felixfelix-bot/cycle-without-chain/docs/design/open-gates-register.md

# Open gates register — what is proven, what is not, and what would close it

> **STATUS: DESIGN-PHASE DEFINITION OF DONE. NOT AN ELECTRICAL, ROAD-LEGAL OR
> MANUFACTURING APPROVAL.** No board exists, no PCB exists, nothing has been
> energized, and every source document in `docs/design/` is stamped
> `NOT SAFE TO ENERGIZE`. This register is the single place that states what the
> design currently is, what is actually verified, and every unresolved gate
> classified by the *kind of evidence* that would close it. Finishing it means
> the design phase is organised, not that the machine is safe.

- Repository state: `master` at `ae42054`, with the gate wiring merged at
  `574987e`, the CX-01/CX-03 correction merged from `pr/contradiction-closure`,
  and this branch's RAIL-01/RAIL-02/RAIL-04 fixes on top.
- Consolidates (read-only) the milestone and review documents under
  `docs/design/` plus `docs/analysis/chainless-drivetrain.md`.
- Consistency of this document is checked mechanically by
  `analysis/gates/register_check.py` (tests in
  `analysis/gates/tests/test_register_check.py`). That check verifies the table
  is complete and countable. It does **not** verify that any engineering claim
  in it is true.

---

## 1. What the design currently is

A 36–58.4 V pedal-by-wire powerboard for a human-powered vehicle with an
independent-cadence drivetrain, described only as generative KiCad schematic
code and analysis models. Concretely, at the commit above:

- **Schematic only.** `hardware/powerboard-reva/` holds a Python generator
  (`generate_schematic.py` plus per-block `*_circuit.py`) that emits a
  hierarchical KiCad 9 schematic, native netlist, PDF and SVG pages. There is no
  `.kicad_pcb`, no placement, no routing, no fabrication data.
- **Two motor/generator bridges** (hub and generator) driven by DRV8353
  smart gate drivers with six 2 mΩ low-side shunts, and a 29-MOSFET population.
- **A protected-entry intent, not a protected entry.** A fuse candidate, a shunt
  reverse clamp, a 100 Ω→22 Ω resistor precharge branch, back-to-back MOSFET
  pairs driven by TPSI3052 isolated drivers, a MAIN_PROVEN measurement
  candidate, and inhibit resistors that hold everything off without firmware.
- **Rail partition.** Pack→LM5164→CTRL3V3 for the entry controller, bus→LM5164
  →SINK12 for the autonomous always-on safety chain, and a delayed DRIVE12 with
  a further AP63203→MCU3V3. `R402`/`R412`/`R519`/`R516`/`R517` inhibit networks
  hold the default state off.
- **An autonomous protection chain** (AUX12V, SAFETY3V3, LM4040 reference,
  LM339B comparators, HC00/HC11 latch logic, TPS3823 watchdog, UCC27511 chopper
  driver, external dump resistor candidate) that is explicitly **not**
  independent of its own auxiliary supply.
- **A fast overcurrent path** of twelve TLV3202 comparisons on raw shunt
  outputs pulling a shared `OC_OK`, reaching HEALTHY, the latch clears, the
  inhibit gate and both timer-break pins.
- **An FSR (force-sensing resistor) brake frontend** with OPA333 buffers and
  TMUX1511 muxes, an MCU sheet with timer/ADC/SPI/Hall allocation, an optional
  navigation daughterboard contract, and four analysis models (precharge,
  storage, braking, navigation) plus a drivetrain trade study.
- **No firmware.** Every firmware behaviour referenced below is an executable
  contract or an unimplemented input, never code on a device.

## 2. What is actually verified

Verified here means *mechanically reproduced at the cited commit*, by the kind
of evidence named. None of it is electrical qualification.

| Claim | Evidence kind | Where |
|---|---|---|
| Generator reproduces the committed netlist byte-identically | determinism check | rail-partition-review.md §Independently reproduced |
| Native KiCad export loads and yields 382 components / 218 nets on the rail head | native tool run | rail-partition-review.md §Independently reproduced |
| Strict ERC = exit 5, 10 errors, 0 warnings, no waiver, no `PWR_FLAG` *(superseded: ERC is now 0/0 via PWR_FLAGs — see RAIL-11)* | native tool run | rail-partition-review.md §Independently reproduced |
| SINK12 has no path to DRIVE12; inhibits byte-unchanged from master | netlist membership check | rail-partition-review.md §Verified structurally |
| DRV8353 `IVDRAIN` 0.467 W direct-bus load now budgeted, and the budget self-test is non-vacuous under `-O` | mutation-controlled self-test | rail-partition-review.md §Defects found 1–2 |
| Precharge timing/energy converge to <4 mJ residual across 6 corners | numerical convergence | precharge-budget-review.md §Executed numerical evidence |
| MAIN_PROVEN fails-open discrimination ≥0.328 V at 38 ms under stated tolerances | closed-form arithmetic | precharge-budget-review.md §Independent checks |
| 200 V input ceramics selected and asserted from the native export, after a RED run | datasheet + netlist assertion | ctrl-supply-review.md §1, §5 |
| TPSI3052 pin map and CDIV2 ≥ 3×CDIV1 (worst ratio 4.25) | primary datasheet vs fitted values | active-entry-independent-review.md |
| FSR excitation 0.157 mA / 1.571 V and 0.350 cm² contact bound | arithmetic | fsr-review.md §Independent electrical findings |
| OC comparator polarity consistent with DRV8353 SO direction, no push-pull short | netlist + datasheet | fast-oc-integration-review.md |
| MCU timer/ADC/SPI/Hall pin identities match DS12288 Rev5 Tables 12/13 | datasheet vs netlist | mcu-integration-review.md §Electrical crosscheck |
| Braking arithmetic: 1537.334 W braking at 150 kg/15 %/30 km/h, 383 W into 9.4 Ω at 60 V | independent recomputation | braking-review.md §Independent arithmetic and boundaries |
| Storage: 0.6951 Wh net vs 0.7709 Wh excursion, 3.90625 Wh ideal at 50–25 V | independent quadrature | storage-review.md §Findings and corrections |
| Navigation: 15112 B/s, 54.4032 MB/h, UART cannot fit the combined stream | arithmetic + regression test | navigation-review.md §Arithmetic, power boundary and resource findings |
| FSR sheets 24–27: 0 text/text and 0 text/stroke collisions | measured native SVG bounds | schematic-legibility-review.md §Measured native SVG geometry |
| Behavioral ngspice: OV rise 60.33114 V, fall 58.20219 V, rearm demonstrated, 80 086 rows | ideal-model simulation | protection-integration-review.md §Integration and evidence |
| OV band with the 0.55 V full-temperature VOL corner: 59.315–61.226 V, shift 0.1018 V, margin 0.915 V | closed-form + 128-corner arithmetic, test-asserted | analysis/cx/ov_threshold.py; protection-milestone-report.md §OV thresholds and timing |
| Regen recovery through the two-hop 0.791² chain: 7.88 Wh = 14.2 % of trip | rerun of the committed model, test-asserted against its stdout | analysis/cx/regen_recovery.py; chainless-drivetrain.md §12 |
| Fail-closed release gates exist and reject planted faults | mutation-controlled tests | tools/gates/README.md; pcb-quality-gates.md §Smallest tooling to port later |

What is **not** verified anywhere: any thermal measurement, any ripple or
effective-capacitance measurement, any start-up sequence on hardware, any EMI
or hot-plug result, any polarity or pulse/SOA test, any loss-of-sink behaviour,
any main-switch conduction measurement, any cell or BMS qualification, any
firmware, and any legal classification.

---

## 3. The register

Bucket legend (exhaustive; every gate is in exactly one):

- **A — schematic/analysis work still possible now.** A calculation, a part
  selection against a verified datasheet, a topology change, a simulation, a
  firmware/contract change or a tooling change. Closeable without hardware.
- **B — bench measurement that needs a built board.** Thermal, ripple,
  effective capacitance under DC bias, start-up sequencing, EMI, hot-plug,
  polarity, pulse/SOA, loss-of-sink, main-switch conduction, injected faults.
- **C — operator input required.** Frame/machine geometry, motor choice and
  pole count, pack/BMS specification and source limits, storage chemistry,
  permissible test energy, environment, legal/road classification, and the
  human resources only the operator can name.
- **D — resolved**, with the commit or document that closed it.

| ID | Subsystem | What is unproven | Consequence if wrong | Bucket | Evidence that closes it | Current status | Source |
|---|---|---|---|---|---|---|---|
| ARCH-01 | Whole-system architecture | That the chainless series-hybrid drivetrain is the architecture to build at all; the study recommends the parallel hybrid instead | A powertrain that loses ~35 points of rider power and cannot be pedalled home when a battery dies | C | Operator records a decision against, or an explicit overrule of, the study | OPEN — study is explicitly `NOT A DECISION RECORD` | chainless-drivetrain.md §0 Answer first; §15 What this analysis is not |
| ARCH-02 | Legal and road class | Jurisdiction, lawful assist behaviour, road class, throttle vs pedal-assist rules | A machine that cannot lawfully be registered or ridden; controller and sensor choice changes | C | Operator states country and intended class; a legal review is accepted as a gate | OPEN — no legal analysis anywhere in the corpus | chainless-drivetrain.md §15; PLAN-parallel-hybrid.md §Phases and exit gates, phase 2 |
| ARCH-03 | Mass and geometry envelope | Gross mass, frame/fork material, dropout spacing, wheel circumference, permitted mounting region | Every thermal, braking and structural number is scaled from an unweighed bicycle | C | Weighed complete bicycle plus frame/fork make and model, with photos | OPEN — only 120 kg rider+luggage is operator-confirmed | downhill-braking-envelope.md §1 Inputs and interpretation; §7 Ranked risks and remaining inputs, item 2 |
| ARCH-04 | Motor and generator choice | Machine type, pole count, Kv, winding, back-EMF and torque/current/speed maps, and whether a 250–400 W low-kv crank generator at 300 rpm exists off the shelf | Bus voltage, phase current, shunt sizing, regen ceiling and PM body-diode energy all move | C | Operator selects the machine(s) and supplies datasheet maps | OPEN — no price or availability check on the crank generator | chainless-drivetrain.md §14 Open items; pcb-quality-gates.md §Actionable checklist, G0 |
| ARCH-05 | Duty envelope | Route grades, descent length, speeds, continuous lever-request duration, ambient, altitude, cooling breaks | Every energy and thermal bound is an assumption and no descent rating can be set | C | Operator names a descent or equivalent duty cycle | OPEN — no route supplied | downhill-braking-envelope.md §1 Inputs and interpretation; §7 Ranked risks and remaining inputs, items 3–4 |
| ARCH-06 | Storage chemistry and BMS | LFP 16s1p vs P28A 13s1p vs SCiB, plus BMS thresholds, charge current, disconnect behaviour and cold/full acceptance | Charge acceptance and the usable bus ceiling move; a wrong pick removes regen acceptance | C | Operator freezes chemistry and BMS part, fixing series count and window | PARTIAL — chemistry and 20s direction frozen by `docs/design/storage-decision-lto.md` §0; BMS part, thresholds, disconnect and cold/full acceptance still OPEN | storage-decision-lto.md §0 Decision; storage-review.md §Source and BOM boundaries; short-buffer-storage.md §0 Answer and provisional decision log, D1 |
| ARCH-07 | Test authority | Permissible test energy, guarded bench setup, and who signs off before any energized test | Bench qualification cannot legally or safely start | C | Operator states permitted test energy and names the sign-off | OPEN — no energization permission exists anywhere | pcb-quality-gates.md §Actionable checklist, G9; protection-integration-review.md §Integration and evidence |
| RAIL-01 | CTRL3V3 / DRIVE12 | No output OVP on U501: an open R512 floats FB to VOUT and DRIVE12 rises to 58.4 V against AP63203 35 V absmax and 25 V C513/C514/C517 | One resistor open destroys U502 and over-volts three capacitors | D | Fixed: independent TLV1701 comparator on DRIVE12 that pulls the EN/UVLO node low at 16.25 V nominal, peak 18.0 V; datasheet-verified that LM5164 has no OVP | RESOLVED in pr/rail-ovp-pgood | drive-rail-protection.md §1 What the LM5164 datasheet actually provides; §1.3 Option (a) |
| RAIL-02 | DRIVE12 inductor | L501 MSS1246T-683MLC against LM5164's own current limit: Isat 2.26 A, Irms 1.30 A, top limit 1.75 A = 1.35× Irms, 0.51 W there | Saturation and heating at the converter's limit rather than at the load | D | Reselected to TDK SPM10065VC-680M-D (production; Isat 5.5 A at −20 % / 7.3 A at −30 %, Itemp 3.4 A at 40 °C, 80 V rated), 3.14× / 4.17× / 2.16× against a stated 0.80 rule | RESOLVED in pr/l501-production-part — supersedes the VT-variant pick in pr/rail-ovp-pgood, which was NRND; the −20 % row corrected in pr/l501-isat-correction | drive-rail-protection.md §2 The old part, against a stated rule; §2.3 The reselected part |
| RAIL-03 | CTRL3V3 inductor | Hot saturation and current-limit overshoot for the 68 µH part; 182–190 mA pp ripple and ≈205 mA peak are calculated only | Thermal drift or saturation at the hot corner, invisible in the nominal calc | B | Hot Isat and current-limit overshoot measurement on the built converter | OPEN — explicitly unproven; L500 still carries the old MSS1246T-683MLC | ctrl-supply-review.md §2 Independent checks; drive-rail-protection.md §2.4 What is still open about L501 |
| RAIL-04 | Safety-domain partition | `ANALOG_OK` is hard-coupled to delayed DRIVE12 `PGOOD`, so an always-on chain is gated by a delayed rail | Fail-safe in direction, but contradicts the claimed independence and can mask a sink-side fault | D | Fixed: U501.6 moved to DRIVE_PG with its own 47k pull-up on SINK12; nothing on that net reaches U11/U13, asserted with a negative control | RESOLVED in pr/rail-ovp-pgood | drive-rail-protection.md §3 Why the old wiring was wrong; §3.2 What was done |
| RAIL-05 | SINK12 budget | Light-load efficiency of the R-78HB at ≈4 % of rating; η = 0.60 assumed against break-even 0.5453, and R39 alone is 71 % of the rail | The 1.1 W sink envelope is exceeded and the always-on safety chain browns out | B | Measured module efficiency at the actual light load, hot and cold | OPEN — assumption, not measurement | rail-partition-review.md §Defects found 7 |
| RAIL-06 | CTRL input ceramics | Effective capacitance of C500/C501 (2.2 µF 200 V X7R) at 58.4 V DC bias | Nameplate capacitance is not in-circuit capacitance; surge, damping and loop stability unproven | B | Capacitance-vs-bias measurement on the selected part, then bench confirmation | OPEN — part verified 200 V, bias curve unknown | ctrl-supply-review.md §1 The correction |
| RAIL-07 | CTRL footprint | Whether the stock 2225 land pattern matches the vendor's recommended pad geometry and the LM5164 EP/thermal land | A pad or thermal-pad error discovered only at assembly | A | Compare the vendor land drawing to the footprint and correct if needed | OPEN — new and unverified footprint | ctrl-supply-review.md §1 The correction; §4 Finite gating checklist, item 3 |
| RAIL-08 | CTRL light load | COT minimum load: CCM boundary 91–95 mA and 20.05–20.89 mV ramp, so 301 kHz is not guaranteed at light load | Pulse-skip changes ripple and EMI in an unmodelled regime | B | Bench ripple and mode measurement at zero, minimum and full load | OPEN | ctrl-supply-review.md §2 Independent checks; §4 Finite gating checklist, item 5 |
| RAIL-09 | Start-up and UVLO | Restart into both drivers, D500 inrush into C500/C501, cold start at −20 °C, TPSI3052 transfer latency; the 0.8 W cap is 22.22 mA at 36 V and 13.70 mA at 58.4 V | Start-up current exceeds the pack-input cap; UVLO cycling into a live load | B | Bench matrix: 36 V and 58.4 V, zero/minimum/full load, both drivers simultaneous, UVLO restart, temperature | OPEN | ctrl-supply-review.md §3 Remaining startup and budget limits; §4 Finite gating checklist, item 5 |
|RAIL-10|Passive MPNs|Exact passives R500–R505, C505, C506 and the 200 V input pair with working voltage, tolerance and temperature|Candidate values reaching a fabrication BOM|D|Freeze MPNs against datasheet ratings|CLOSED for values — gate resistors sized to 3R3 (2R2 rejected: 1.25 % above the DRV8353 current-limit crossover, so it does not set the edge); MPNs frozen with voltage/tolerance/size. Bench confirmation of the modelled 60 ns edge still owed|bom-identity-and-gate-sizing.md §3 Gate resistor: how 3.3 Ω was derived; ctrl-supply-review.md §4 Finite gating checklist, item 1|
|RAIL-11|ERC completeness|Ten strict-ERC `power_pin_not_driven` errors on this head (U3.1, U1.3, U1.24, U1.25, U17.37, U26.5, U400.3, U400.5, U401.5, U500.2), unsuppressed|A real undriven power pin hiding among known ones; no ERC-clean claim is possible|D|Close each identity with defensible source/return semantics, without `PWR_FLAG`|RESOLVED BY A DIFFERENT METHOD THAN SPECIFIED — ERC is now 0 errors and 0 warnings, but via ten PWR_FLAGs, which this gate's closure criterion explicitly excludes. Each net was traced to a real source first (erc-power-flags.md §2) and the verifier now demands an empty ERC report. Whether PWR_FLAG is acceptable here is an operator decision, not one this work can make for itself|erc-power-flags.md §2 The ten nets traced, §5 What this does NOT mean; rail-partition-review.md §Independently reproduced|
| RAIL-12 | Export parity | The XML netlist consumed by tests vs the S-expression `.net` consumed by `verify_exports`; an injection into XML only stays green | A rail split invisible to one of two verifiers | D | Run the existing `netlist_parity` gate against both artifacts | RESOLVED — `netlist_parity --netlist-sexpr` grades both exports against one map; 35 new tests including per-artifact injection controls | rail-partition-review.md §Defects found 8 |
| RAIL-13 | DRV8353 direct-bus load | That the always-on `IVDRAIN` load is inside any envelope: 2 × 4 mA × 58.4 V = 0.467 W on DC_LINK, larger than the whole SINK12 subtotal | An unbounded always-on load the sink envelope never covered | D | Fixed: explicit `DC_LINK` row, `direct_bus_always_w`, `-O`-safe self-test | RESOLVED in bd00ac9 | rail-partition-review.md §Defects found 1 |
| RAIL-14 | Rail self-test integrity | That `rail_budget.py --self-test` proves anything under `python3 -O` | A budget model that passes while its own expectation is corrupted | D | `_check()` raising `RuntimeError`; mutation controls fail in both modes | RESOLVED in bd00ac9 | rail-partition-review.md §Defects found 2 |
| RAIL-15 | OC supply claim | That all independent safety loads sit downstream of SINK12/SAFETY3V3 — the netlist puts both TLV3202s and both OC ladders on LOGIC3V3_EXT | A false independence claim inside the safety argument | D | Netlist-verified and the milestone Outcome paragraph corrected | RESOLVED in bd00ac9 | rail-partition-review.md §Defects found 6 |
| RAIL-16 | OVP latching | The DRIVE12 OVP was non-latching, so a permanently open R512 hiccupped the rail between ~0 and 18 V instead of holding it off | The load sees repeated over-voltage excursions; a latch is a real safe state | D | Fixed: U504 (SN74LVC1G74) sits between U503 and the buck, D tied low (R525), CLR_N driven by a diode-OR of OVP trip, PGOOD-low and a manual reset header (J48). Powered from SAFETY3V3 so it survives a DRIVE12 collapse; PRE_N tied high so it cannot be set remotely | RESOLVED in pr/ovp-latch — analysis/drive_latch proves the topology with 11 tests, including a control that the pre-latch wiring DOES restart | drive-rail-protection.md §1.3 Residual risk, item 1; analysis/drive_latch/model.py §THE TWO SIGNALS |
| RAIL-17 | DRIVE12 clamp | No TVS/clamp is fitted across DRIVE12; the comparator acts on the source but does not absorb energy | A fast external transient still reaches the 25 V capacitors | B | Bound the source impedance and hold-off duration by measurement, then size a part | OPEN — no part fitted rather than an unverified one | drive-rail-protection.md §1.4 Option (b) |
|RAIL-18|L501 footprint|That the TDK SPM10065VC-680M-D land pattern matches the vendor drawing (fitted part is VC, not the VT the gate originally named)|A pad error discovered only at assembly|D|Compare the vendor land drawing to a candidate footprint and correct|CLOSED — custom footprint Powerboard:L_TDK_SPM10065VC-D transcribed from TDK catalogue 20250303 p3: pads 2.95x4.5 mm, gap 6.10, span 12.00; 17 tests with per-mutation negative control; footprint verified in the exported netlist|bom-identity-and-gate-sizing.md §4; drive-rail-protection.md §2.4 What is still open about L501|
| RAIL-19 | DRIVE_PG consumer | DRIVE_PG had a pull-up and no functional consumer | A status net nothing reads is dead weight if left indefinitely | D | Fixed: U505 (SN74LVC1G08) ANDs the latched enable with DRIVE_PG into the latch clear node, so any PGOOD-low clears the latch and a buck that drops out of regulation cannot keep the enable asserted | RESOLVED in pr/ovp-latch — test_drive_pg_has_a_consumer fails without it | drive-rail-protection.md §3.4 The better option; analysis/drive_latch/model.py §THE TWO SIGNALS |
| CX-01 | Contradiction: OV trip bound | Resolved by recomputation, not by choosing a side: the network (Rt 225k, Rb 10k, Rh 330k, Vref 2.5 V) re-swept with the LM339B −40…85 °C VOL limit of 0.55 V gives a qualified minimum turn-on of **59.315 V** (band 59.315–61.226 V), **0.915 V** above the provisional 58.4 V bus maximum. The 0.4 V corner gives 59.417 V; the difference is 0.1018 V = Rt/Rh × 0.15, matching the review's ~0.102 V | Reusing 59.417 V as a qualified bound overstates OV margin by 0.102 V | D | Resolved: `analysis/cx/ov_threshold.py` reproduces both bands and the closed-form shift, tests assert both; the milestone report now prints 59.315 V as qualified and marks 59.417 V superseded | RESOLVED in pr/contradiction-closure; the remaining *qualification* gap (small-overdrive VOL, tracking, ageing, load regulation) stays open as PROT-07 | protection-milestone-report.md §OV thresholds and timing; protection-integration-review.md §P1 LM339B VOL budget; analysis/cx/ov_threshold.py |
| CX-02 | Contradiction: bus maximum | Arch-06 is now decided, and the contradiction separates into two distinct quantities that 58.4 V was being asked to satisfy simultaneously. **Charge ceiling:** 58.4 V is a 16s LFP figure; the selected 20s LTO pack tops out at **56.0 V**, so 58.4 V would be a **+4.3 % overcharge command**. **Stress ceiling:** the pack cannot bound the bus — a spinning PM machine rectifies through body diodes with the pack open, and the chopper can only sink, so it holds the bus *above* the pack. 58.4 V is below the chopper's own trip band, so it cannot be the stress figure either | Charge control and clamp thresholds set against a voltage the chosen pack cannot reach | A | Charge role: adopt 56.0 V. Stress role: operator chooses a ceiling at or above the chopper's top trip corner, which then fixes TVS clamp, capacitor class and leak-clamp level | **CHARGE ROLE RESOLVED — 56.0 V.** **STRESS ROLE BOUNDED, NOT CHOSEN:** floor is **≥61.226 V before overshoot** (top of the CX-01 turn-on band). Consequence recorded: at full charge the chopper turn-off floor of 57.356 V sits **1.356 V above** the pack, so the **dump resistor carries 100 % of regen and the pack carries none** — the primary descent path, not a fallback. Propagation to the 44 files citing 58.4 V deliberately deferred until the stress ceiling is chosen **Charge cell-ceiling now DISPUTED (54.0 vs 56.0 V), see below.** | cx02-bus-maximum.md §3 The resolution: two roles, not one value; §4 The consequence that actually matters; analysis/cx/bus_maximum.py |
| CX-03 | Contradiction: regen recovery | Resolved by rerunning the model, not by choosing a side: `chainless_drivetrain_model.py` prints the two-hop 0.791² chain at **7.88 Wh** (14.2 % of trip); the 8.2 Wh figure came from applying 65 % as a single KE→battery hop. §2 and §5 now print 7.9 Wh as current and mark 8.2 Wh superseded in place with a pointer to §12; §0, §1 (A7) and §14 were brought into line | A withdrawn number remains quotable as the study's result | D | Resolved: the model output is the arbiter; `analysis/cx/regen_recovery.py` reproduces both figures and its tests parse the real model's stdout so the document cannot drift | RESOLVED in pr/contradiction-closure — the withdrawn figure is marked, not deleted | chainless-drivetrain.md §2 Vehicle power and energy; §5 Buffer sizing; §12 Correction to §3/§5; analysis/cx/regen_recovery.py |
| CX-04 | Contradiction: ERC totals | Milestones record 3, 4, 5, 8, 9 and 10 strict-ERC errors, and none of them says which head it describes | An operator cannot tell which count is current | D | This head's 10 identities are enumerated and enforced by `verify_exports` | RESOLVED by enumeration on the current head | active-entry-independent-review.md; mcu-integration-review.md §Reproduced verification; rail-partition-review.md §Independently reproduced |
| CX-05 | Contradiction: VM margin | `reva-milestone-review.md` says the reported `vm_static_margin_V = 75−58.4` is a legacy direct-bus hypothetical rather than the actual external-12-V VM margin | A stale margin carried into a design decision | D | `calculations.py` now reports 75−12 | RESOLVED on master | reva-milestone-review.md §Prioritized concrete next circuit changes 6; hardware/powerboard-reva/calculations.py |
| PRE-01 | Source specification | That 36–58.4 V, ≥3 A available at start-up, ≤0.15 Ω source impedance and ≤1.5 mF assembled capacitance all hold | Every precharge timing and energy number is conditional on them; a stronger source is not a 3 A limiter | C | Operator/BMS datasheet fixes the source and the capacitance; assembly capacitance is measured | OPEN — model input requirements, not granted facts | precharge-budget-review.md §Exact release blockers, item 1 |
| PRE-02 | Source impedance and capacitance | Demonstrated source resistance, harness impedance and assembled bus capacitance with tolerances | Close time, PRE energy and closing pulse all shift | B | Four-wire measurement on the real pack and harness; LCR on the assembled bus | OPEN | precharge-budget-review.md §Exact release blockers, item 1 |
| PRE-03 | MAIN closing | Actual closing current and MOSFET SOA at the real source; a 3 A clip in the model is not a current limiter | A 1 V mismatch across a 10 mΩ loop is ≈100 A | B | Measured loop R/L and closing current against a vendor SOA plot | OPEN | precharge-sequencing-design.md §5 SOA, energy and failure boundaries; precharge-budget-review.md §Exact release blockers, item 1 |
| PRE-04 | PRE resistor energy | Mounted hot-pulse and repetition qualification for the 22 Ω PRE at 54.807 J / 156.591 W with a 350 ms maximum | A stuck PRE dissipates that continuously, and logic cannot interrupt a welded pair | B | Mounted hot-pulse and repetition test with the selected part and interrupt | OPEN — the RH050 candidate is not qualified | precharge-budget-revision.md §Adopted bounded candidate; precharge-budget-review.md §Exact release blockers, item 5 |
| PRE-05 | Welded PRE interrupt | A physical response to a welded PRE that does not depend on firmware or the gate drive | Continuous dissipation in the precharge branch with no electrical exit | A | Specify an independent thermal interrupt plus fuse coordination | OPEN | precharge-budget-revision.md §Adopted bounded candidate; precharge-sequencing-design.md §5 |
| PRE-06 | PRE timing maximum | Proof of 300 ms nominal / 350 ms maximum over tolerance and temperature, with the 38–42 ms stimulus and 20 ms post-proof AUX settle | Timeout overrun raises PRE energy and lets drive enable early | B | Bench timing over temperature and tolerance on the built sequencer | OPEN — modelled as a contract only | precharge-budget-review.md §Required next sheet, item 4 |
| PRE-07 | MAIN_PROVEN discrimination | Worst-case separation of a failed-open MAIN from a PM-driven bus: 1.128 V mismatch against a 0.70 V edge leaves 0.328 V, but the ±0.20 V uncertainty budget is open | False "main proven", then drive enabled onto a dead or PM-driven bus | A | Close the ±0.20 V error budget with exact parts, then bench | OPEN — conditional discrimination, not a tolerance proof | precharge-budget-review.md §Independent checks; main-proven-candidate.md §5 Remaining release gates |
| PRE-08 | MAIN_PROVEN observability | That the comparator/current-edge logic and the 5 ms continuous valid window behave as modelled; the model checks final voltage only | A boolean input or voltage-match oracle is not hardware evidence | B | Fault-injected bench test of gate, current and PM validity, current edge and continuous window | OPEN | precharge-budget-review.md §Executed numerical evidence; §Required next sheet, item 5 |
| PRE-09 | PM injection bound | Total external injection ≤10 mA throughout proof, including PM body-diode rectification with every gate off | An unbounded source invalidates the discrimination and forces INDETERMINATE with drive disabled | C | Operator bounds the machine and source current, or it is measured | OPEN — `PM_QUIET_VALID` is an unimplemented input, not a measurement | precharge-budget-review.md §Required next sheet, item 5; precharge-budget-revision.md §Real MAIN_PROVEN rather than an oracle |
| PRE-10 | Two-device voltage stress | 116.8 V across one off device (pack −58.4 V against bus +58.4 V) against a 150 V rating, plus inductive overshoot, unequal switching, avalanche and Miller turn-on | Device overstress at the first inductive turn-off | B | Measured loop R/L and switching waveform against derated SOA | OPEN — 33.2 V static headroom is not evidence | precharge-review.md §Electrical architecture |
| PRE-11 | Reverse-blocking integrity | That one shorted FET does not defeat reverse blocking in one direction; four devices in two branches are not redundant barriers | Loss of reverse protection presented as a safety barrier | B | Single-FET short and reverse-polarity bench test | OPEN | precharge-sequencing-design.md §5; precharge-budget-review.md §Exact release blockers, item 4 |
| PRE-12 | Sequencer state machine | Reset-dominant truth table, absolute timeout, AUX settle, failed-open MAIN, stuck PRE, full and single-FET shorts, missing diagnostic load, stuck comparators, external injection | An unqualified transition enables drive or drops the sink during a fault | B | Bench fault injection on the built sequencer | OPEN | precharge-budget-review.md §Exact release blockers, item 4 |
| PRE-13 | Diagnostic stuck-on load | The bound of a diagnostic branch stuck on (~11 W at 60 V), not only its 0.463 J normal pulse | A diagnostic fault cooks the measurement network or its supply | A | Calculate and bound stuck-on dissipation with the selected parts | OPEN | precharge-budget-review.md §Exact release blockers, item 4 |
| PRE-14 | Entry fuse coordination | Prospective fault current, DC interruption rating, clearing time and holder/wiring coordination for F1 KLKD020CN | A fuse that never clears, or clears too slowly to protect D20 | B | Prospective current measurement plus a DC-rated fuse and coordination study | OPEN — F1 remains a candidate | entry-review.md §Measured topology and limits |
| PRE-15 | Reverse isolation | That a reverse-connected pack is actually isolated; D20 is a shunt reverse clamp and the fuse is not proof | Reverse polarity destroys the board while appearing protected | A | Specify reverse/source isolation topology and prove it by analysis | OPEN | entry-review.md §Measured topology and limits; precharge-sequencing-design.md §1 Existing connectivity actually read |
| PRE-16 | Hot-plug and reverse polarity | Hot-plug overshoot, D500 inrush, reverse live-bus behaviour and cable resonance | The first connection destroys D500, C500/C501 or a bridge | B | Bench hot-plug and reverse-polarity test with an energy-limited source | OPEN | ctrl-supply-review.md §3; rail-partition-review.md §What this review does NOT establish |
| PRE-17 | Manual operating sequence | That any approved manual sequence exists; the J41/J42 jumper instruction was withdrawn and interlocked rated switching is missing | An operator manipulating energized connectors | A | Design interlocked switching plus a written, reviewed sequence | OPEN — no approved sequence exists | entry-review.md §Safety-language finding corrected |
| PRE-18 | Entry permission | That `CHARGE_ALLOWED`/`DISCHARGE_ALLOWED` default false, have a real implementation and have bounded latency | Pack opens or stays closed at the wrong moment | B | Bench permission-loss and latency test | OPEN | precharge-review.md §Electrical architecture |
| PRE-19 | TPSI3052 driver chain | That CDIV2 ≥ 3×CDIV1 holds on the fitted 470n/100n C0G 5 % (worst ratio 4.25), VSSS sits on the pair's common source, and the non-S continuous variant is used | Gate droop, cold-start failure, or one-shot behaviour in a static-drive application | D | Datasheet Table 5-1 and §6.3 checked against fitted values and the pin map | RESOLVED — verified in independent review | active-entry-independent-review.md; precharge-review.md §TPSI3052 pin-level constraints from primary documentation |
| FSR-01 | Mounted contact | Actual actuator contact area above 0.350 cm² (Interlink < 1 mA/cm²); nominal pad diameter is not proof | Contact current density over the manufacturer limit, drifting or burnt pad | B | Mounted contact-area and load measurement with the real pad and actuator | OPEN | fsr-review.md §Independent electrical findings |
| FSR-02 | Frontend source | No qualified regulator or reference: J2.1 `LOGIC3V3_EXT` feeds both excitations, both OPAs, the clamps and MCU_VREF, and two frontends draw ≈0.656 mA nominal | Rail sag, reference drift and cross-channel coupling read as force | A | Design a qualified rail/reference and a worst-case budget | OPEN — explicitly not a worst-case budget | fsr-review.md §Independent electrical findings |
| FSR-03 | Clamp and backfeed | PESD3V3U1UL and BAT54S do not establish clamping inside downstream absolute maxima; BAT54S can inject MCU_VREF with no established sink; 10k limits backfeed to 0.350 mA, not zero | Silent rail injection or an MCU pin over absolute maximum | A | Part-level clamp analysis with Ioff and injection limits | OPEN | fsr-review.md §Independent electrical findings |
| FSR-04 | ADC acquisition | Buffer stability, start-up and acquisition with the 1k outside feedback and ≈11k load; ADC capacitor discharge time constant | Force readings that are a function of timing | B | Bench step response, stability and acquisition timing | OPEN | fsr-review.md §Independent electrical findings |
| FSR-05 | Dead-MCU injection | That the grounded-drain test covers a dead MCU; mux Ioff is ±2 µA, and rail ramps plus retained 100n charge remain | An unpowered MCU back-powered through the analog frontend | B | Bench power-off and partial-power injection test | OPEN | fsr-review.md §Independent electrical findings |
| FSR-06 | Torque authority | That any firmware implements the brake contract, and that an independent hardware positive-torque sign guard exists; the `inhibit` predicate ignores analog entirely | Positive torque under invalid or absent braking modulation | A | Implement and test firmware plus an independent hardware sign guard | OPEN — executable contracts only | fsr-review.md §Brake authority and preserved circuits |
| FSR-07 | Sheet legibility | That FSR sheets 24–27 are readable, with J46 and U26/U27 labels clear of pin graphics | Unreadable protection sheets entering a fabrication release | D | Measured native SVG bounds: 0/0 collisions across all eight regions | RESOLVED | schematic-legibility-review.md §Measured native SVG geometry |
| FSR-08 | Residual visual clearance | Connector and D36/D37/D40/D43 pin-level clearance could not be conclusively resolved by the raster review | A pin-level overlap reaching fabrication | A | Full-resolution inspection or an explicitly accepted exclusion | OPEN — withheld visual approval | schematic-legibility-review.md §Actual raster review and extent |
| OC-01 | Sink device drive | That 2N7002 is on at the actual gate drive: VGS(th) is not an on-state guarantee at 3.3 V worst-case VOL, with 0.702 mA nominal sink | `OC_OK` not pulled low, so a real overcurrent never latches | A | Select a device with a guaranteed on-state at the real drive, or budget the corner | OPEN | fast-oc-integration-review.md; fast-oc-milestone.md §Implemented circuit |
| OC-02 | Sink VOL and latency | Worst-temperature VOL, aggregate drain capacitance and propagation at the `OC_OK` node | Slow or incomplete inhibit after a trip | B | Bench VOL and propagation measurement | OPEN | fast-oc-integration-review.md; fast-oc-milestone.md §Timing / survival boundary |
| OC-03 | Threshold corners | ±19.93 A nominal trip against rail ±3 %, divider ±0.1 %, shunt ±1 %, gain 19.4–20.6, CSA offset ±3 mV, comparator ±6 mV, plus unbounded midpoint error and thermal drift | A trip that never fires inside the destructive current | A | Full worst-case tolerance budget, then one measured corner | OPEN — corner budget now computed and reproducible (oc_envelope.py): 16.92639…23.08413 A, matching the published figure to five decimals. Cannot close: CSA midpoint bias has no guaranteed tolerance, thermal drift uncharacterised, trip latency unbudgeted, shunt blind during high-side conduction, common reference faults uncovered. All five carried in code as unbounded_terms. Static envelope is not a qualified trip point. | oc-envelope.md §1-4; fast-oc-source-analysis.md §2 |
| OC-04 | Shunt blind interval | That low-side shunts observe phase current during high-side conduction and every freewheel, deadtime and short path | Destructive current with SO sitting at midpoint | A | Add a continuous observation path or a qualified DRV VDS OCP contract | OPEN | fast-oc-milestone.md §Threshold, polarity and coverage |
| OC-05 | DRV VDS OCP | Latched OCP mode, 1 µs deglitch, linked shutdown, write/readback after reset; the lowest SEN_OCP 0.25 V is ≈125 A at 2 mΩ, not 20 A | Short-circuit protection that exists only as a register name | A | Firmware configuration with readback lock, then bench proof | OPEN | fast-oc-milestone.md §Threshold, polarity and coverage |
| OC-06 | Minimum capture pulse | That a 1 µs ideal capture survives silicon timing over overdrive, temperature and load | A fast fault shorter than the real comparator response | B | Bench minimum-pulse and overdrive sweep | OPEN | fast-oc-milestone.md §Timing / survival boundary |
| OC-07 | Fault-loop SOA | Allowable MOSFET fault joules: hot pulsed SOA, clamp and commutation waveforms, transient thermal impedance, repetitive stress | The switch fails before the trip acts | B | Vendor SOA read against measured fault waveforms, then bench | OPEN — no fault joules invented | fast-oc-milestone.md §Timing / survival boundary |
| OC-08 | Nuisance latching | That noise and CSA settling do not nuisance-latch with no PWM blanking, given only 1.2 mV typical internal hysteresis | Nuisance trips at speed, or blanking added until the trip is too slow | A | Specify blanking and external hysteresis against a timing budget | NARROWED to a measurement — the question is now numeric: does measured noise plus CSA settling residue exceed 0.0291 A referred to the shunt (the binding minimum hysteresis band, at GAIN_MAX; the documented 0.030 A is the nominal-gain figure and is optimistic). Hysteresis is not a mitigation; the persistent latch prevents re-enable chatter but not a first nuisance trip. If exceeded, external hysteresis or blanking is required, and positive feedback shifts both thresholds. | oc-envelope.md §3-4; fast-oc-source-analysis.md §1 |
| MCU-01 | Break configuration | The TIMx_BDTR contract (AF2/AF4, BKE=1, BKP=0, BKINP=0, BKINE=1), input filter, lock, deadtime, idle states and MOE/auto-rearm policy | A break input that is wired but never armed | A | Firmware implementation plus a register-level test | OPEN — net continuity is not timer safety configuration | mcu-integration-review.md §Break polarity and inhibit contract |
| MCU-02 | VREFBUF | That VREFBUF stays in external/high-impedance mode and never drives the hard-fed 3V3 VREF+ rail | Two drivers on one reference pin | A | Firmware and option-byte setting with a readback test | OPEN | mcu-integration-review.md §Break polarity and inhibit contract |
| MCU-03 | Sampling schedule | That dedicated pins give simultaneous three-phase sampling; acquisition scheduling beside the phase-current ADCs is unimplemented and shared MISO rise is ≈1.204 RC | Wrong phase-current sample instant, or SPI that fails at speed | A | Specify and implement the trigger/sample/deadtime schedule; budget rise time | OPEN | mcu-integration-review.md §Electrical crosscheck; §Break polarity and inhibit contract |
| MCU-04 | Analog supply tracking | VDDA/VREF tracking, start-up/reset, back-power and partial-power states, physical decoupling placement and analog return | A reference that tracks nothing the design accounts for | B | Bench supply-sequencing and analog-return measurement | OPEN | mcu-integration-review.md §Electrical crosscheck |
| MCU-05 | Cable injection | That 3V3-only interfaces survive cable ESD and power-off injection | Field ESD or a dead rail injecting into live logic | B | Bench ESD and power-off injection test | OPEN | mcu-integration-review.md §Electrical crosscheck |
| MCU-06 | Source revision audit | That DS12288 Rev5 and RM0440 Rev7 are current, plus BOOT0/nSWBOOT0 option-byte defaults | A documented erratum or option-byte default that defeats the reset or break design | A | Retrieve current revisions and errata; audit option bytes | OPEN | mcu-integration-review.md §Isolation and provenance |
| MCU-07 | Independent reviewer | That any review in this corpus came from a model family other than the author's; the family was never established | A single-family blind spot presented as independent approval | C | Operator names a reviewer whose family can be verified | OPEN — separate contexts are not cross-family independence | mcu-integration-review.md §Reviewer qualification; fsr-review.md front matter |
| PROT-01 | Bus sink independence | That the only active bus sink survives auxiliary failure: U3→AUX12V→U4/U5/U6/U10, so losing U3, its input, ground or reference removes clamping while the PM machine keeps rectifying | Unclamped bus overvoltage with the pack open; mechanical brakes do not contain it | A | Choose an independently powered or energy-backed clamp with a common-cause analysis | OPEN — architecture change required | protection-integration-review.md §P0 Auxiliary-loss defeats the only active bus sink |
| PROT-02 | Reset and rearm | That a held-high RESET_REQUEST cannot rearm: it clears memory as soon as HEALTHY rises and drive resumes without a new deliberate action | Automatic rearm after a fault | A | Edge-qualified reset with release-before-rearm and a separate ARM sequence | OPEN | protection-integration-review.md §P0 Held-high RESET_REQUEST automatically rearms |
| PROT-03 | Logic margins | Per-path DC budget now computed at the cold corner. Two premises in the original evidence are stale: the fault bus has **no series diodes** (sheet `fault-interfaces` reads "LVC Schmitt fault inputs without series diode offsets"), so the 0.445 V / 0.72 V sums do not apply; and the logic is **LVC, not HC**, so the 2/4.5/6 V threshold complaint is moot. Limits from primary datasheets: LM339B 550 mV at 4 mA (the 700 mV row is the legacy LMx39 table, not this part), DRV8353 nFAULT 125 mV at 5 mA, TPS3823 0.4 V at 1.2 mA, LVC3G17 VT− min 0.84 V at 3 V | A low-level sum above the receiver threshold at a cold or low-supply corner | A | DC budget complete; remaining exposure is absent/ramping rail, edge rate and metastability, rail tolerance, and aging | **OPEN — DC arithmetic complete.** Five paths, all positive at SAFETY3V3 − 4 %: ANALOG_OK → U11 1A **290 mV** (tightest), GEN/HUB_nFAULT → U11 2A / U12 1A 715 mV, WD_RESET_N → U11 3A 440 mV, OV_CMD → U10 IN+ 450 mV. High level: 1298 mV and 768 mV. Not closed because the 4 % rail tolerance is assumed, no edge-rate or absent-rail case is examined, and 290 mV is a 25 °C DC number | prot03-logic-margins.md §2 Per-path low-level budget; §4 Datasheet limits used; analysis/cx/logic_margins.py |
| PROT-04 | Supply permutations | Every supply permutation and every externally driven pin: UCC27511 UVLO 3.70–4.65 V, LM339 common mode VCC−2 V, U4/U5 sequencing, and PWM/SPI/ARM/RESET/WDI injection | An arbitrary OV command or a back-powered dead rail during a ramp | A | Enumerate permutations and prove Ioff/series limits, then bench | OPEN — ideal PWL sources cannot close this | protection-integration-review.md §P1 Startup, brownout and backfeed are unproven |
| PROT-05 | Watchdog semantics | That TPS3823-33 services on negative transitions, floating WDI disables it, a running peripheral can mask a frozen application, and the documented stuck-reset mode is avoided | RESET stuck low after recovery, or a watchdog that never fires | A | Device/interface decision plus a firmware pulse policy | OPEN | protection-integration-review.md §P1 Watchdog edge semantics and reset interaction |
| PROT-06 | Sink energy and latency | That two 4.7 Ω in series (≈383 W at 60 V) hold an illustrative 500 W source, and that the 10 µs latency is real; no validated heatsink, pulse energy, cable clamp, branch fuse or resistor-open detection | A sink that cannot hold the source it is sized against, or acts too late | B | Bench energy, latency and thermal measurement on the built sink | OPEN | protection-integration-review.md §P1 Sink energy, latency and thermal qualification remain open |
| PROT-07 | OV threshold qualification | Three of the four named omissions are now closed, and two of them were worse than stated. **Excursion:** CX-01 used ±50 K, but the parts are rated −40…+85 °C from a 25 °C calibration, so the real worst case is **65 K** (1.30× understated) — the LM4040 datasheet itself defines its overtemperature tolerance at ΔT = 65 °C. **Reference:** the fitted LM4040AIM3 is **A grade**, whose published combined tolerance is **±0.75 %**, 1.25× the 0.60 % CX-01 budgeted. **Ageing:** 120 ppm long-term plus **0.08 % thermal hysteresis** were both absent. **Load regulation** is now bounded from the published ΔVR/ΔIR curve | A threshold that walks below the bus limit at end of life | A | Extend the corner analysis to rated temperature plus aging and load regulation, and get a VOL bound at small overdrive | **OPEN — 3 of 4 closed.** Band extends to turn-on **59.108–61.398 V**, turn-off 57.150–59.229 V, reproducing CX-01's 59.315 V exactly before each term is added. Against the real limit (56.0 V charge ceiling, CX-02) margin is **+3.108 V**; against the retired 58.4 V figure, +0.708 V. Hysteresis at matched corners 1.776–1.975 V, matching the closed form to 1 mV. **Remaining gap is only VOL at ~0 V overdrive**, which TI does not publish — quantified instead: 400 mV→+3.210 V, 550 mV→+3.108 V, 700 mV (wrong part)→+3.006 V, so the conclusion is robust to the assumption even though the number is unqualified | prot07-ov-qualification.md §2 Defect one; §5 The band, built up step by step; §8 The one item that cannot be closed; analysis/cx/ov_qualification.py |
| PROT-08 | Clamp versus switching | That a clamp holds the bus: 500 W into 100 µF reaches 60.828 V in 10 µs and 64.031 V in 50 µs, with ringing and cable energy excluded | 100 V MOSFET headroom presented as safety while the bus exceeds the clamp | B | Measured switching transient with the real cable and clamp | OPEN | protection-milestone-report.md §OV thresholds and timing |
| PROT-09 | Resistor derating | HSC3004R7J headroom: 419.8 W total and 209.9 W each at 61.226 V, 580.5 W at 72 V, a 300 W rating that needs the specified heatsink and is not free-air, and no pulse-overload energy rating claimed | A resistor pair run past its rating on the first real descent | B | Mounted thermal and pulse test with the specified heatsink | OPEN | protection-milestone-report.md §External sink selection and derating |
| PROT-10 | MOSFET land geometry | That CSD19532Q5B drain leads 5–8 plus the exposed pad are properly represented when they collapse to KiCad pad 5 with nine unnamed paste apertures | A drain connection that exists in CAD and not in copper | A | Compare the actual land geometry to datasheet pp. 8–9 | **OPEN — drain connectivity PROVEN, stencil UNPROVEN.** Land is byte-identical to KiCad's stock TDSON-8-1 (all 14 pads compare equal), and the native export resolves every CSD19532Q5B as source 1-3 / gate 4 / drain 5, so the nine-aperture collapse does not split a net. Tests: tests/test_mosfet_land.py, 5 cases, mutation-checked (gate shorted to drain and drain pad moved off its net both fail the right case). REMAINING, and it is the reason this is not D: the stock land puts four of the nine paste apertures OUTSIDE the F.Mask opening (drain apertures at x 2.53-3.28 vs a mask edge at 2.525). That is KiCad upstream's drawing, not a board error, but whether it is correct for this part's stencil is unproven without an assembly. Also unproven: thermal pad current density, via stitching, and paste-to-copper ratio (9.00 mm2 of paste inside the mask opening vs a 20.06 mm2 pad = 45 %, and 54 % of the 16.54 mm2 opening, both computed from the pad geometry in the file) | reva-milestone-review.md §Primary-source pin audit; protection-milestone-report.md §Circuit and primary-source identities |
| PROT-11 | Chopper gate charge | That active braking and chopper gate-charge demand fit the auxiliary budget | The sink's own driver load breaks the 1.1 W envelope | A | Choose and record f_chop, then re-check the envelope at the real duty cycle | **OPEN — bounded, analysis complete.** Q13/Qg computed: 0.744 mW per kHz plus 7.2 mW half-duty pulldown; the published 1.027108922 W becomes 1.040–1.089 W across 1–40 kHz. Envelope exhausted at **49.1 kHz half duty** (27.4 kHz all-OC, 39.4 kHz full duty), falling to 39–45 kHz once the 12 V-vs-10 V Qg direction is carried. Not closed because **f_chop is specified nowhere**, so fit is unproven; Q13 switching loss and dump thermal duty stay open under BRK-*/PROT-01/PROT-07 | prot-11-chopper-gate-charge.md §2 The omitted term, computed; §3 Break frequency; analysis/cx/chopper_gate_charge.py |
| BRK-01 | Installed heatsink | That the sink holds 80 °C at 300 W, which needs ≤0.1333 K/W before interface and local rises; the Fischer 0.3 K/W is a screening number with no installed curve, orientation or road-speed cooling | Resistor or sink overtemperature on a real descent | B | Installed thermal measurement inside the bench qualification | OPEN | braking-review.md §Independent arithmetic and boundaries; downhill-braking-envelope.md §4 Resistor reality check |
| BRK-02 | Datasheet revision | That the HSC300 evidence is current: literature 1773035 issued 11-05, the newer Rev E fetch failed with curl HTTP/2 error 92, and no pulse rating was found | Sizing against a withdrawn or superseded rating | A | Retrieve the current revision and confirm the exact part | OPEN | braking-review.md §Manufacturer evidence independently checked |
| BRK-03 | Staged bench protocol | That the 100 W then conditional 300 W / 600 s protocol with isolated source, independent interruption and temperature aborts works; it has never been executed | A rating asserted from a protocol that only exists on paper | B | Execute the staged protocol on the bench | OPEN — prerequisites, not proof that tests happened | braking-review.md §Scope and safety retained |
| STO-01 | Converter option | That the 25 V low end is compatible with a 36 V minimum direct bus without a converter, or that the converter's mass, efficiency and price are acceptable | Storage cannot deliver into the bus, or mass is added for nothing | A | Size or eliminate the converter against the chosen window and datasheets | OPEN | storage-review.md §Findings and corrections 4; short-buffer-storage.md §0 Answer and provisional decision log, D2 |
| STO-02 | Cell pulse and thermal maps | That per-cell DC pulse, thermal maps, reserve SOC and the per-cell series ceiling are known for the chosen chemistry | Series count or reserve chosen from nominal Wh alone | A | Datasheet pulse and thermal maps plus a written reserve policy | OPEN | short-buffer-storage.md §6 Risk ordering and next evidence |
| STO-03 | Cold and full-SOC acceptance | That a full or cold pack accepts or refuses charge safely; the LFP <250 mA subzero note does not qualify ordinary cold regen | Charging a full or cold pack, or regen dumped into a pack that refuses it | B | Bench charge-acceptance test at temperature | OPEN | storage-review.md §Source and BOM boundaries |
| STO-04 | Supplier revisions | That Eaton and Toshiba ratings are real: they rest on indexed primary text, one ESR unit rendered as "mW", and SCiB 10 s power is not continuous current | A chemistry rejected or selected on a misread table | A | Re-fetch the exact supplier revisions and correct the units | OPEN — lower-confidence status retained | storage-review.md §Source and BOM boundaries |
| STO-05 | Chronological transient model | Storage losses, SOC reserve, rejected charge, rotating inertia and actual efficiency maps, plus the fact that net energy is not capacity | Sizing a pack from a net integral it cannot deliver | A | Extend the model with the missing channels | OPEN | storage-review.md §Findings and corrections 2 |
| STO-06 | Recovery after refusal | That rejected regen recovers without pedal back-drive | The rider loses drive when the pack refuses charge | B | Bench test of the refusal and recovery path | OPEN | short-buffer-storage.md §6 Risk ordering and next evidence |
| NAV-01 | Inertial sensor data | That the LSM6DSOX noise, current, IO and DRDY support the interface; the detailed datasheet was never retrieved | A sensor whose behaviour is not what the estimator assumes | A | Retrieve the datasheet and qualify it against the interface | OPEN | navigation-review.md §Pending, explicitly not qualified |
| NAV-02 | GNSS and barometer sources | That MAX-M10S and BMP390 claims hold: they are the feature's recorded evidence, not re-fetched PDFs, and sourced GNSS current is at 1 Hz while logging assumes 10 Hz | Applying a 1 Hz current proxy to a 10 Hz design | A | Verify at the intended rate and constellation | OPEN | navigation-review.md §Arithmetic, power boundary and resource findings |
| NAV-03 | Storage device | That any device exists: 64 KiB is 4.3367 s at 15112 B/s and 512 KiB flash is ≈34.69 s, with no retention guarantee | A log that cannot hold a ride | A | Select a device with a retention datasheet | OPEN | navigation-review.md §Arithmetic, power boundary and resource findings |
| NAV-04 | Estimator | That any EKF exists; the approved error-state EKF is an implementation contract only | Navigation confidence reported without a filter | A | Implement and replay-test the estimator | OPEN — no EKF code was added | navigation-review.md §Actual execution |
| NAV-05 | RF, EMC and physical | RF/EMC, rail transients, connector isolation, memory and timing tests, physical storage | Interference or a connector fault on an optional subsystem | B | Bench RF/EMC and transient test | OPEN | navigation-review.md §Pending, explicitly not qualified |
| NAV-06 | Daughterboard BOM and routing | That the supervisor, antenna and support BOM exist and that reserved pins match firmware EXTI/DMA routing; only netlist reservation was validated | A pin conflict found after layout | A | Select the BOM, implement and test the routing | OPEN | navigation-review.md §Integration and disposition; §Independent pin/source audit |
| PCB-01 | Requirements freeze | Frozen bus minimum, 58.4 V maximum plus tolerance, transient envelope, motor speed/back-EMF, phase RMS and peak, duty, ambient and cooling, plus power-off/reset/fault/full-storage behaviour | Copper drawn against an envelope that later moves | C | Operator freezes the numbers | OPEN | pcb-quality-gates.md §Actionable checklist, G0 |
| PCB-02 | Pin and pad truth | That every power semiconductor, driver and current-sense package pin matches its datasheet at pad level; only DRV8353 and CSD19532Q5B were audited so far | A pad-level error found after fabrication | A | Datasheet pin and land check for every power part plus netlist parity | OPEN — all 16 logic/power/analog parts datasheet-read: 116 pins match via audit_pin_names.py (mutation-tested). Zero electrical pin errors found. Three gates (U24/U25/U510) carry the stock symbol with '~' pin names and are reported as unauditable, not passed. 4 parts unverified. The PAD half of this gate is barely started: only L501 has a vendor-transcribed land; QFN-40, HSOP-8, TO-247 and VSSOP-8 lands are KiCad library defaults | pad-audit-power-parts.md §2; pad-audit-housekeeping-parts.md §1, §4; pad-audit-lvc-family.md §1-4; pcb-quality-gates.md §Actionable checklist, G1  **PAD HALF EXTENDED: QFN-40 land pattern verified against vendor geometry.** `audit_qfn40_land.py` compares both DRV8353s (U1, U2) against the published WQFN-40-EP(6x6) drawing: pad 1 at (-2.9375, 2.2500) mm and 0.8250 x 0.2500 mm, 0.5 mm pitch, 10 pads per side, 4.6 x 4.6 mm exposed pad (modelled as pad 41, so 41 pads = 40 pins + EP). All quantities match exactly; KiCad's inverted Y is asserted rather than normalised away. **Negative control caught a real gap in the audit itself:** a mutant moving pad 2 by 0.15 mm (0.5 mm pitch -> 0.65/0.35) PASSED at first, because the pitch check only ran when the constant-Y list was longer -- and for a QFN the constant-X column holds the 10-pad side while constant-Y holds only the 2 mirrored pads, so the pitch code never executed. Fixed and mutation-verified (3 tests). Still open: HSOP-8, TO-247 and VSSOP-8 vendor land comparisons.  **HSOP-8 / TO-247 / VSSOP-8 LANDS NOW VERIFIED TOO.** `audit_power_lands.py` checks 11 footprints against vendor geometry: HSOP-8 DDA SO PowerPAD (U500, U501 — 8 pads 1.95x0.60 at 1.27 mm pitch, 2.30x2.30 mm EP on pad 9, 4 paste apertures of 0.93 mm; 13 pads total is correct), TO-247-3 (Q400-Q403 — 3 pads 2.5x4.5 at 5.45 mm pitch), VSSOP-8 P0.5 (U7, U8, U11, U12, U504 — 8 pads 1.25x0.35 at 0.50 mm pitch). **All four package families on the board now have pad-level vendor verification**, mutation-tested with six mutants (pad width and pitch per family) that must all fail. Remaining pad work is limited to parts whose vendor drawing has not been obtained. |
|PCB-03|BOM identity|That one approved MPN per populated reference exists with exact reference-set equality across schematic, PCB and variant; blank footprints are still permitted|A BOM that cannot be assembled as drawn|D|Exact reference-set equality and one MPN per populated reference|CLOSED — 0 blank footprints in the exported netlist, 387/387 references resolved (58 datasheet-sourced, 329 series-inferred), sets equal both ways. An earlier CLOSED claim rested on a gate that read the approved list rather than the netlist and was wrong; see §4.5|bom-identity-and-gate-sizing.md §2 Derived approved list, §4.5 check the artifact that ships; pcb-quality-gates.md §Actionable checklist, G2|
| PCB-04 | Placement, routing and power layout | That any placement, DRC or power-layout review exists. A real, routed board file now exists: powerboard-reva-board.kicad_pcb, 397/397 footprints, 160x130 mm, 4 layers, 8929 track segments, 406 vias, full pad parity | Loop inductance, Kelvin sense and thermal bottlenecks decided by accident | A | Routing, Gerbers and power-layout review on the real board file | **OPEN — routed, not reviewable.** Routing is finished as far as automation goes: 8929 segments / 406 vias, clearance 0, shorts 0, tracks_crossing 0, holes_co_located 0, hole_to_hole 0 (DRC, `.kicad_dru` loaded). The remaining disconnections are 12 nets, and **11 of the 12 have pads in a `reserved` power-stage block** — the precharge chain, the hub bridge phase/shunt and PGND where it meets them, all hand-layout nets by design. The twelfth (HUB_nSCS) is blocked by copper already occupying U17's 0.5 mm-pitch row and cannot be escaped without moving it. **Not done:** no Gerbers, and the power stages have never been laid out, so the board is not electrically complete. 160x130 mm envelope is still provisional: derived from measured footprint area, never checked against the bike. **Two measurement errors in this gate's own history were caught and withdrawn** — the `.kicad_dru` never loaded because it did not match the board filename (27 phantom clearance errors), and the 'unconnected' total was 61 % cross-net pairs, not a connectivity count; the real figure is same-net pairs only. | pcb04-board-generation.md §6-8; pcb04-board-sizing.md §2; audit_escape.py; real_unconnected.py |
| PCB-05 | Manufacturing packet and reproducibility | That a layer-complete packet exists and that two clean builds match | An incomplete or non-reproducible packet | A | Release manifest with hashes and a two-build comparison | OPEN | pcb-quality-gates.md §Actionable checklist, G7–G8 |
| PCB-06 | Bench validation | That any current-limited bring-up, gate waveform, deadtime, fault injection, regen or thermal load test has run | Everything in the A bucket above is still paper | B | Staged guarded bench validation | OPEN | pcb-quality-gates.md §Actionable checklist, G9 |
| PCB-07 | Generator reproducibility | That the schematic/PCB generator reproduces byte-identically; the audited upstream pipeline replaced placeholder UUIDs with UUID4 | A reproducibility claim that holds only within one run | A | Deterministic identifiers plus a two-build comparison | **CLOSED — both artifacts reproduce byte-identically.** `reproducibility_check.py` builds each generator twice in separate trees and compares bytes: schematic 17595 B identical, PCB 1658992 B identical. Both artifacts also load in pcbnew with 397 footprints and 1222 pad-net assignments, so determinism did not cost validity. The schematic already used `uuid5` on a stable namespace. The PCB did not: bisecting two builds gave four distinct sources — footprint order (pcbnew's writer reorders; 79225 of 83169 lines differed), all 7731 uuids freshly minted per run, the `${VALUE}`/`${REFERENCE}` fp_text pair swapping order, and top-level gr_line ordering. `canonicalise_pcb.py` rewrites the saved text: a paren-depth parser (not regex — a regex split miscounted 397 footprints as 385 on one run and 347 on the other), stable uuids derived from object identity, footprints sorted by reference, and header forms (`version`, `generator`, `general`, `layers`, `setup`) held in their schema-required order. Recorded failure along the way: sorting ALL top-level forms put `(version 20241229)` at the end and produced a byte-identical file that pcbnew refused to open — reproducible but unloadable, which is worse than the bug it fixed. | reproducibility_check.py; canonicalise_pcb.py; gen_pcb.py §PCB-07 |
| PCB-08 | Fail-closed release gates | That release gates fail closed instead of reporting success for work not done | A gate that passes on a missing report | D | Three fail-closed checkers plus a runner, exercised by planted-fault tests | RESOLVED in 4d18b7c and c8c4d5f | tooling-audit-report.md §What the actual code provides; pcb-quality-gates.md §Smallest tooling to port later |
| TOOL-01 | Gate runner wiring | That the release gates run at all without a human remembering: there was no workflow file and no runner invocation on the board directory | A gate that is only ever run by the person who wrote it | D | Add a CI job or a documented runner invocation | RESOLVED — `tools/gates/run_release_gates.py` is the one command and `.github/workflows/release-gates.yml` calls it on push and pull request, surfacing every gate it cannot grade as `NOT RUN` with a reason. Locally exercised; no CI run observed yet | pcb-quality-gates.md §Evidence contract; tooling-audit-report.md §What the actual code provides |
| DRV-01 | Regen capture efficiency | That 65 % (A7) is right; it is an ESTIMATE | Buffer and regen benefit sized from an unmeasured number | B | Bench measurement with a Phaserunner and All-Axle at 5–25 km/h | OPEN | chainless-drivetrain.md §14 Open items |
| DRV-02 | Off-cadence penalty | That 4 % (A8) applies to this rider; it is read off literature | The 8.7× gearing-benefit trade shifts | C | Operator or rider measurement, or a written accepted bound | OPEN | chainless-drivetrain.md §14 Open items |
| DRV-03 | Housekeeping draw | That 3 W is right for a dual-controller build; it is an ESTIMATE | The bootstrap and standby budget | B | Measure Phaserunner plus CA3 idle draw | OPEN | chainless-drivetrain.md §14 Open items |
| GYRO-01 | Contained control-moment gyro | That any bicycle-scale contained CMG exists; Seakeeper 1 is 166 kg and a vacuum enclosure is not verified burst containment | A spinning rotor next to a rider without containment | A | Sourcing and containment study, or a recorded HOLD | OPEN — educational candidate remains HOLD | gyro-review.md §Verdict; §Source cross-check and corrections |
| GYRO-02 | Control law | That direction, finite travel, singularities, desaturation, power loss and start-up/shutdown are handled; `2H` is an upper bound, not available torque | A stabiliser that cannot recover and was never shown to | A | Control design and simulation against a stated envelope | OPEN | gyro-review.md §Direction, finite travel and safety |

## 4. Bucket summary

Counts are recomputed by `analysis/gates/register_check.py`, which fails if they
disagree with the table above.

| Bucket | Meaning | Gates |
|---|---|---|
| A | Schematic/analysis work still possible now, closeable without hardware | 44 |
| B | Bench measurement that needs a built board | 36 |
| C | Operator input required | 12 |
| D | Resolved, with the commit or document that closed it | 21 |

---

## 5. What a design-phase completion actually means here

The design phase is complete when **every A-bucket gate is closed and every B and
C gate is explicitly deferred to a named phase with a named owner**. It is not
complete when the board works, because the board has never existed.

Concretely, "design phase complete" means:

1. Every A row above is either closed with its evidence recorded, or converted
   into a B or C row with a stated reason. No A row may be closed by assertion.
2. Every B row names the phase that will measure it (bench bring-up, staged
   isolated-source qualification, dyno, guarded road trial) and the owner of
   that measurement.
3. Every C row is answered in writing by the operator, because no amount of
   engineering closes a question about which machine, pack, route or
   jurisdiction is intended.
4. The register's own consistency check passes, so the counts and citations can
   be trusted as a description of the document even though they say nothing
   about the engineering.

Finishing this register makes **no claim of electrical safety, no claim of road
legality, and no claim of manufacturing readiness**. It is a statement that the
design phase knows what it does not know. Energizing anything still requires the
B-bucket evidence plus the C-bucket authority plus an independent reviewer;
fabrication additionally requires the PCB gates G1–G8 with real reports; riding
additionally requires a legal classification and mechanical brakes that this
project does not design.

## 6. Open operator decisions

Each question below is a C-bucket row, phrased so it can be asked directly. The
consequence of each answer is why it is a gate rather than a preference.

1. **Architecture (ARCH-01).** Do we build the chainless series hybrid, or the
   parallel hybrid the trade study recommends? *If series:* accept a ~35-point
   rider-power loss and no pedal-home fallback. *If parallel:* most of this
   powerboard's precharge, entry and dual-bridge rationale collapses to a
   conventional e-bike drivetrain.
2. **Road class and jurisdiction (ARCH-02).** Which country, which vehicle
   class, and is this pedal-assist or throttle? *Consequence:* the lawful power,
   speed and control topology limits, and possibly the whole controller choice.
3. **Machine (ARCH-04).** Which motor/generator, how many poles, what Kv and
   winding? *Consequence:* bus voltage, shunt value, trip thresholds, phase
   current, regen ceiling and PM body-diode energy all follow, and the
   low-kv crank generator may not exist off the shelf.
4. **Pack and BMS (ARCH-06, PRE-01).** Which chemistry, how many series cells,
   which BMS, what charge and discharge current limits, what is the source
   impedance? *Consequence:* the precharge timing, the 1.5 mF ceiling, the
   58.4 V bus maximum and the charge-acceptance envelope all move with it.
5. **Mass and frame (ARCH-03).** What is the weighed complete bicycle mass,
   which frame and fork, and where may anything be mounted? *Consequence:*
   every braking, thermal and structural number, and whether the frame may be
   used as a heat path at all.
6. **Duty and route (ARCH-05).** Which descent or route, what grades, what
   duration, what ambient? *Consequence:* the sink rating, the resistor
   qualification energy and whether 300 W for 600 s is even relevant.
7. **Test authority (ARCH-07).** What energy may be tested, in what guarded
   setup, and who signs before anything is energized? *Consequence:* every B
   gate is blocked until this exists.
8. **Independent reviewer (MCU-07).** Who reviews this electrically, with a
   model family that can be verified? *Consequence:* no review in this corpus
   can claim cross-family independence, so the strongest available approval is
   currently single-family.
