felixfelix-bot/cycle-without-chain/docs/design/storage-review.md

# Storage study review — 2026-11-10

> **Provisional analysis accepted with corrections, not chemistry selection or hardware release.**
> Reviewed source `1927fbcfca3ba9dc1aeb753d6b43ab500df0272c` on latest fetched
> GitHub master `30560f6`. No schematic changes, purchases or pack qualification.

## Findings and corrections

1. **Launch arithmetic agrees.** Independent 100,000-step midpoint integration of
   `Pwheel=(ma+mg*Crr+rho*CdA*v²/2)*v`, followed by division by drive efficiency
   and subtraction of **250*0.9=225 W electrical generation**, confirms
   150 kg/25 km/h/10 s: net 0.6951 Wh and ramp-end deficit 778.1615 W.
   Multiplying the complete wheel demand by the 80% combined efficiency would
   wrongly apply generator losses to stored energy. Neither 10 s nor 778 W is an
   operator requirement; no power increase follows from this scenario.
2. **Net energy is not capacity.** Existing prose warned correctly, but the model
   only emitted clipped net `buffer_wh`. Added signed `net_bus_wh`, cumulative
   `excursion_wh`, initial energy and charge headroom. For the same case they are
   0.6951, 0.7709, 0.6951 and 0.0758 Wh respectively. Storage losses, SOC reserve,
   rejected charge, rotating inertia and actual efficiency maps remain unmodelled.
   The nonnegative-resistance domain is now explicit and invalid time/efficiency
   inputs fail with ValueError. A 30 s ramp has **negative net** -0.1753 Wh yet
   needs 0.5592 Wh ideal excursion: regression protects this distinction.
3. **Screen slower launch, not larger hardware.** Under the same assumptions,
   30 s to25 km/h gives 235.63 W residual storage peak, 455.63 W traction-bus
   demand and 460.63 W including auxiliaries. Thus this illustrative case is below
   500 W even when comparing total traction demand, not merely residual storage.
   This is not a selected launch profile or torque/thermal feasibility proof.
4. **Cap energy and voltage checks agree.** 20s means 20 series cells, not20 seconds:
   300 F/20=15 F; 20*4.5 mΩ=0.09 Ω; 50–25 V yields3.90625 Wh ideal.
   25 V is not compatible with a36 V minimum direct bus; DC/DC is required for
   that window. Direct500 W needs ≥37.25 V open circuit to deliver36 V, reducing
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
