felixfelix-bot/cycle-without-chain/docs/analysis/parallel-vs-series.png

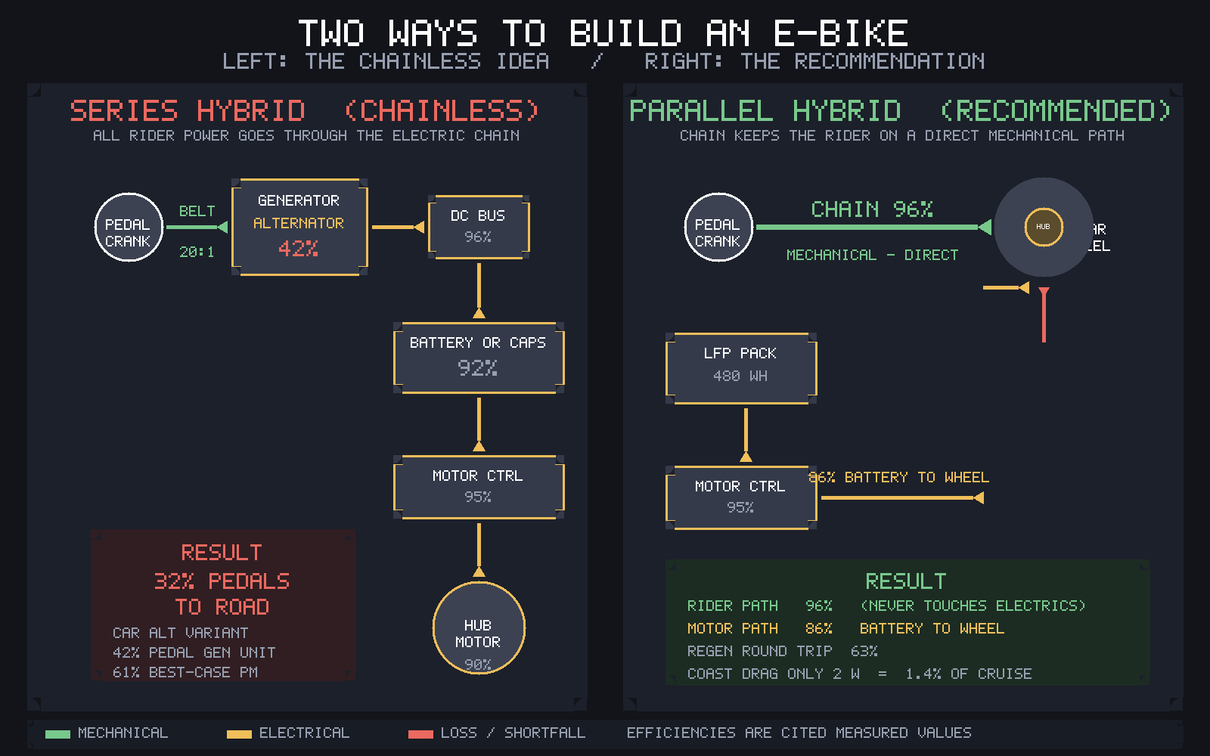
docs/analysis/parallel-vs-series.png
