felixfelix-bot/cycle-without-chain/hardware/powerboard-reva/exports/ctrl-supply-preview.png

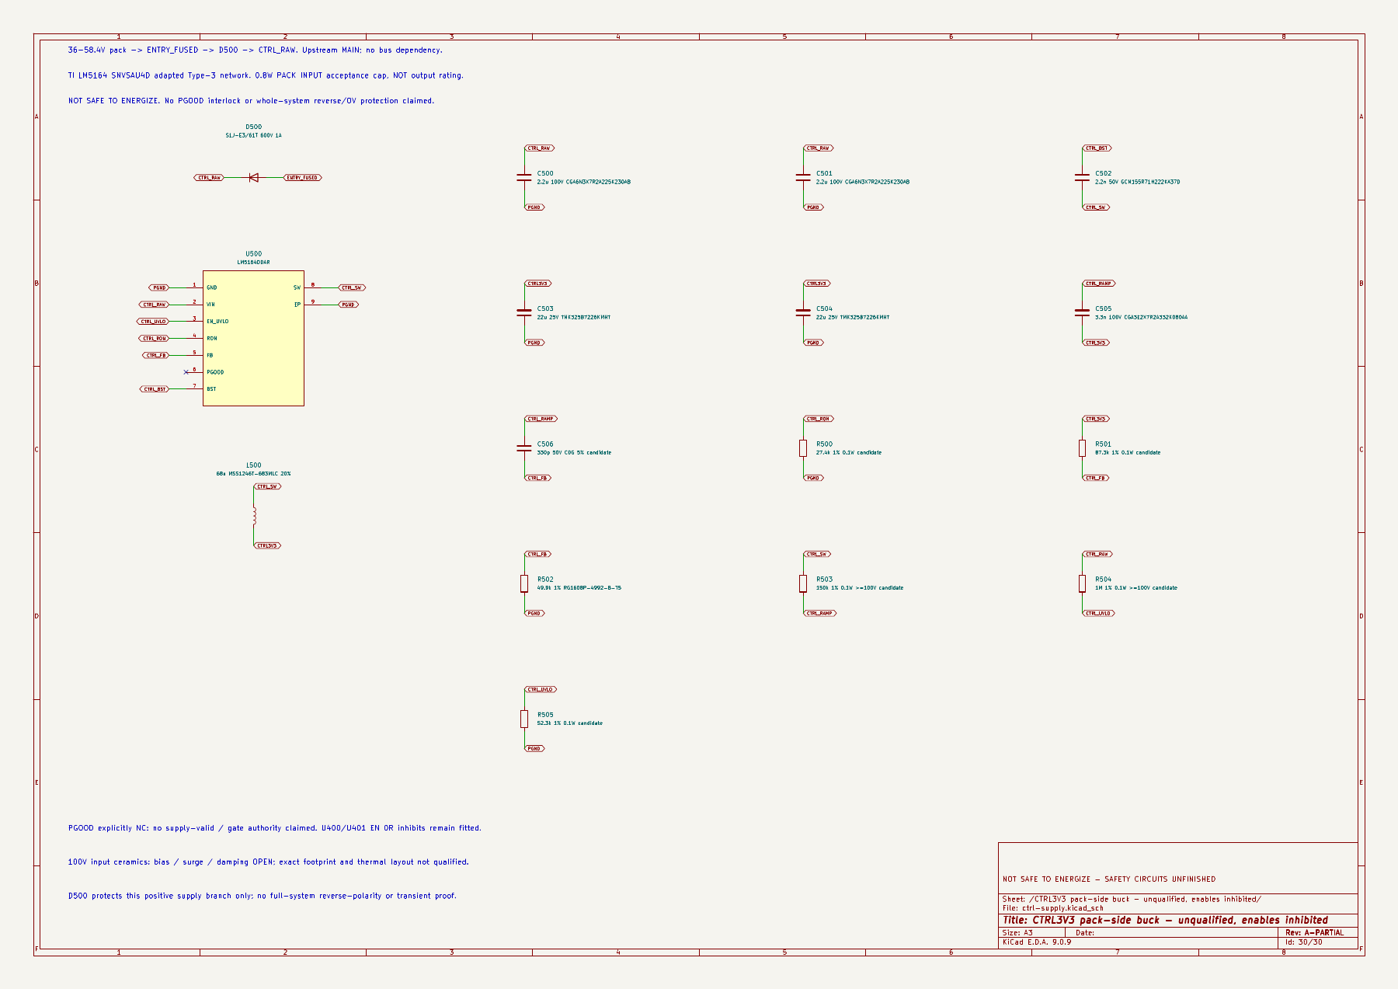
hardware/powerboard-reva/exports/ctrl-supply-preview.png
