felixfelix-bot/cycle-without-chain/docs/design/navigation-bom-candidates.csv

role | manufacturer | mpn | qty_per_addon | population | interface | supply_v | current_typ_ma | current_max_ma | current_conditions | unit_price | currency | price_qty | price_url | source_url | evidence_status | notes
GNSS | u-blox | MAX-M10S-00B | 1 | candidate | UART + TIMEPULSE PPS | VCC 1.76-3.6; V_IO 2.7-VCC with VIO_SEL open | 11.8 |  | Sum VCC+V_IO; 3.0 V typical; default constellations; tracking 1 Hz |  |  |  |  | https://content.u-blox.com/sites/default/files/MAX-M10S_DataSheet_UBX-20035208.pdf | CONFIRMED datasheet R08 table 15 | 100 mA startup supply requirement is not continuous max; needs antenna; 3.3 V current not measured
IMU high-range alternative | STMicroelectronics | LSM6DSO32TR | 1 | one-of IMU | SPI + intended DRDY | VDD 1.71-3.6; full VDDIO range unverified | 0.55 |  | Combo high-performance manufacturer HTML claim; conditions unverified |  |  |  |  | https://www.st.com/en/mems-and-sensors/lsm6dso32.html | PARTIAL primary HTML; PDF unavailable | 32 g candidate; exact DRDY IO and timing release gate
IMU primary | STMicroelectronics | LSM6DSOXTR | 1 | one-of IMU | SPI + intended DRDY | VDD 1.71-3.6; full VDDIO range unverified | 0.55 |  | Combo high-performance manufacturer HTML claim; conditions unverified | 6.11 | USD (confirm checkout) | 1-4 | https://estore.st.com/en/lsm6dsoxtr-cpn.html | https://www.st.com/en/mems-and-sensors/lsm6dsox.html | PARTIAL primary HTML; PDF unavailable | Quantity-table price; page also displays 5.99; tax freight DE delivery unverified; 16 g maximum
Barometer | Bosch Sensortec | BMP390 | 1 | optional DNP | SPI or I2C | VDD 1.65-3.6; VDDIO 1.2-3.6 | 0.0032 | 0.0074 | 1 Hz forced pressure x1 temperature x1; table 22 |  |  |  |  | https://www.bosch-sensortec.com/media/boschsensortec/downloads/datasheets/bst-bmp390-ds002.pdf | CONFIRMED datasheet rev1.7 | Peak pressure conversion 0.660 typ 0.730 max mA; requires ambient vent
GNSS passive antenna |  |  | 1 | required unresolved | L1 RF 50 ohm |  |  |  | Passive preferred; no amplifier current |  |  |  |  | https://content.u-blox.com/sites/default/files/MAX-M10S_DataSheet_UBX-20035208.pdf | TODO(unverified) exact MPN | Ground plane enclosure matching and RF connector unresolved
Decoupling and rail support |  |  |  | required unresolved |  | 3.3 |  |  |  |  |  |  |  |  | TODO(unverified) | Values quantities packages and optional power gating require schematic
Addon connector and protection |  |  |  | required unresolved | UART PPS SPI CS DRDY power ground | 3.3 |  |  |  |  |  |  |  |  | TODO(unverified) | Pin count depends on bus sharing; RF/ESD selection unresolved
