felixfelix-bot/cycle-without-chain/docs/design/gyro-candidate-bom.csv

id | role | vendor | model | disposition | voltage | speed | torque | angular_momentum | mass | containment_or_guard | availability | price | primary_urls | unknown_gaps | checked_date
G1 | Marine gyro comparator | Seakeeper | Seakeeper 1 | REJECT bicycle scale; commercial marine reference | 12 VDC | 9750 rpm maximum rated | Not verified | 1000 N m s at maximum rated rpm | 166 kg | Vendor describes vacuum encapsulation; rotor-burst containment rating not verified | Commercial product with dealer channel; stock and delivery unverified | Not evaluated | https://www.seakeeper.com/seakeeper-products/seakeeper-1/ | https://www.seakeeper.com/technology/ | Bicycle qualification; failure containment; gimbal authority and limits; external control interface; installed mass and cooling | 2026-11-10
G2 | Vehicle gyro technology lead | Lit Motors | AEV CMG system | UNQUALIFIED vehicle preorder lead; not a module selection | Unknown | Unknown | Unknown | Unknown | Unknown for CMG subsystem | No subsystem containment specification verified | Vehicle preorder advertised; standalone module ordering or delivery not established | Not evaluated | https://www.litmotors.com/ | All module specifications; standalone sale; production availability; bicycle applicability | 2026-11-10
S1 | Orientation sensor | Adafruit | BNO085 breakout product 4754 | Study shortlist; not a balance actuator | 3-5 VDC VIN | Mechanical speed N/A; report rates not verified | N/A | N/A | 2.5 g | No rotating mechanical energy store | Vendor page says In stock and Add to Cart at access; delivery unverified | Not evaluated | https://www.adafruit.com/product/4754 | https://learn.adafruit.com/adafruit-9-dof-orientation-imu-fusion-breakout-bno085/pinouts | Dynamic attitude errors; latency; timestamping; vibration and magnetic interference; host compatibility | 2026-11-10
C1 | Controller | PJRC | Teensy 4.1 | Study shortlist; not safety-rated balance controller | 5 V VIN or USB; 3.3 V GPIO not 5 V tolerant | 600 MHz CPU; mechanical speed N/A | N/A | N/A | Unknown | No rotating mechanical energy store | Manufacturer catalogue page accessible; current stock and delivery unverified | Not evaluated | https://www.pjrc.com/store/teensy41.html | Board mass; deterministic loop timing; watchdog architecture; interface electronics; fault handling | 2026-11-10
A1 | Low-speed study actuator | ROBOTIS | DYNAMIXEL XM430-W350-T/R | Study shortlist only; NOT qualified full bicycle or gyro gimbal actuator | 10.0-14.8 V; recommended 12 V | 46 rpm no-load at 12 V | 4.1 N m STALL at 12 V and 2.3 A; NOT continuous torque | N/A | 82 g | Actuator case is not a gyro rotor guard | Manufacturer documentation accessible; stock and delivery unverified | Not evaluated | https://emanual.robotis.com/docs/en/dxl/x/xm430-w350/ | Continuous torque and thermal duty; loaded speed; backlash; reaction loads; T versus R interface selection; loss-of-power behavior | 2026-11-10
E1 | Educational gyro lead | TEDCO | Gravitron Space Gyro PVC Box SKU 00020 | HOLD pending guarded LOW ENERGY qualification; educational only | N/A manual zip starter | Unknown | Unknown | Unknown | Unknown | Vendor calls gyro internal; guard coverage and energy containment rating not verified; PVC box is packaging not a containment claim | Manufacturer retail listing with quantity selector; stock count and delivery unverified | Not evaluated | https://tedcotoys.com/products/gravitron-space-gyro-pvc-box.html | Rotor inertia; maximum rated speed; stored energy; mass; guard integrity and access; supervision and manufacturer instructions | 2026-11-10
