felixfelix-bot/cycle-without-chain/docs/design/short-buffer-storage-bom.csv

variant | item | qty | unit_mass_kg | cell_subtotal_kg | unit_price | currency | price_status | source | qualification
cap20 | Eaton XV3550-2R7307-R | 20 | 0.062 | 1.24 |  |  | unverified quote required | https://www.eaton.com/us/en-us/skuPage.XV3550-2R7307-R.html | catalogued; stock not verified
cap22_direct | Eaton XV3550-2R7307-R | 22 | 0.062 | 1.364 |  |  | unverified quote required | https://www.eaton.com/us/en-us/skuPage.XV3550-2R7307-R.html | alternative not additive
cap_large | Eaton XL60-2R7308T-R | 20 | 0.515 | 10.3 |  |  | unverified quote required | https://www.eaton.com/us/en-us/skuPage.XL60-2R7308T-R.html | alternative not additive
liion | Molicel INR18650P28A | 13 | 0.046 | 0.598 |  |  | unverified quote required | https://www.molicel.com/wp-content/uploads/INR18650P28A-V2-80093.pdf | 13s1p; V2; no assembled pack
lfp | Lithium Werks ANR26650M1B 300832-001 | 16 | 0.076 | 1.216 |  |  | unverified quote required | https://lithiumwerksbatteries.com/content/26650%20Power%20Cell%20080625.pdf | 16s1p; rev3 Aug2025; no assembled pack
lto | Toshiba SCiB 2.9Ah high power | 20 | 0.15 | 3.0 |  |  | unverified quote required | https://global.toshiba/ww/products-solutions/battery/scib/product-next/product/cell/high-power.html | limits and exact order code required
battery | BMS with separate charge/discharge permissions | 1 |  |  |  |  | unverified quote required |  | unselected; mass unknown; not included in cell subtotal
cap | Per-cell monitoring and balancing | 1 |  |  |  |  | unverified quote required |  | unselected; mass unknown; not included in cell subtotal
converted or hybrid | Bidirectional DC/DC with cooling and control | 1 |  |  |  |  | unverified quote required |  | unselected; mass unknown; not included in cell subtotal
all | Fuse and DC-rated disconnect | 1 |  |  |  |  | unverified quote required |  | unselected; mass unknown; not included in cell subtotal
all | Precharge and reverse polarity protection | 1 |  |  |  |  | unverified quote required |  | unselected; mass unknown; not included in cell subtotal
all | Harness connectors busbars insulation | 1 |  |  |  |  | unverified quote required |  | unselected; mass unknown; not included in cell subtotal
all | Enclosure mount and thermal protection | 1 |  |  |  |  | unverified quote required |  | unselected; mass unknown; not included in cell subtotal
