felixfelix-bot/cycle-without-chain/docs/evaluation/custom-powerboard-bom.csv

role | candidate_mpn | quantity | rating_or_basis | source_url | availability_evidence | indicative_price | uncertainty
generator baseline | 500267 | 1 | 48 V; 0.964 Nm nominal continuous; 41.3 rpm/V | https://www.maxongroup.it/maxon/view/product/motor/ecmotor/ecflat/ecflat90/500267 | Manufacturer indexed shop add-to-cart; live stock unknown | EUR276.73 qty1-4 excl VAT/shipping; indexed manufacturer listing | Generator map and shaft loads unqualified
generator alternative | 500268 | 1 alternative not additive | 60 V; 33.4 rpm/V; 0.963 Nm nominal continuous | https://www.maxongroup.com/maxon/view/content/service_search?query=EC+90+flat | Manufacturer catalog listing; stock unknown |  | Full datasheet and maps pending
hub alternative | M-M2706RD | 1 | 135 mm OLD; 10.7 rpm/V; 36 holes | https://ebikes.ca/m2706rd.html | Clearance listing remaining hubs; quantity unverified |  | Fit and torque-speed operating map pending
hub preferred research family | UNSELECTED All-Axle winding+adapter | 1 alternative not additive | Original 4 kg direct drive; front 100 mm QR available | https://ebikes.ca/product-info/grin-products/all-axle-hub-motor.html | Manufacturer family currently listed; stock unverified |  | Exact winding/adapter SKU required; not orderable BOM row
three-phase driver | DRV8353SRTAT | 2 | VM recommended 9-75 V; VDrain up to100 V; integrated 3 shunt amplifiers | https://www.ti.com/lit/gpn/DRV8353 | Manufacturer product listing; stock not checked |  | Exact orderable/package and voltage pin audit at schematic review
bridge MOSFET | CSD19532Q5B | 12 | 100 V VDS; 4.9 mOhm max at10 V room conditions | https://www.ti.com/lit/gpn/CSD19532Q5B | Manufacturer active listing; stock unverified |  | Thermal and switching model pending; not100 A board rating
phase and bus shunts | WSLP25122L000FEB | 7 | 2 mOhm 1% 3 W; six phase plus one bus | https://www.vishay.com/docs/30122/wslp.pdf | Distributor listing https://digikey.in/en/products/detail/vishay-dale/WSLP25122L000FEB/9755524 indicates48-week lead time; primary PDF not fetched |  | Exact ordering suffix/derating needs primary PDF confirmation
bus current amplifier | INA240A1PWR | 1 | gain20; common mode -4 to80 V | https://www.ti.com/lit/gpn/INA240 | Manufacturer family listing; exact stock not checked |  | Inline phase alternatives would add6 and replace integrated sensing choice
MCU | STM32G474RET6 | 1 | 170 MHz; 3.3 V nominal logic; LQFP64 candidate | https://www.st.com/resource/en/datasheet/stm32g474re.pdf | Manufacturer production datasheet; stock unverified |  | Two-motor pin mux/ADC/timer allocation pending
auxiliary buck | LM5164DDAR | 1 | 6-100 V input;1 A family rating | https://www.ti.com/product/LM5164 | Manufacturer listing; stock unverified |  | Package suffix and full datasheet application review pending
chopper switch | CSD19532Q5B | 1 additional | 100 V; resistor energy not transistor headline governs | https://www.ti.com/lit/gpn/CSD19532Q5B | Manufacturer listing; stock unverified |  | Gate drive and independent comparator/latch unsized
mandatory release blockers | UNSELECTED | TBD | Fuse; contactor; precharge; TVS; DC-link capacitors; chopper resistor; comparators; latch; watchdog;3.3 V regulator; connectors; sensors; passives; enclosure |  | No parts selected |  | Incomplete engineering BOM intentionally not procurement-ready
optional storage converter | UNSELECTED | TBD optional | Bidirectional four-switch buck-boost;4 extra switches2 drivers+inductor+sensing |  | No parts selected |  | Only after storage voltage and power requirements frozen
