felixfelix-bot/cycle-without-chain/hardware/powerboard-reva/pin-net-map.csv

ref | pin | pin_name | net | sheet
U1 | 1 | CPL | GEN_CPL | gen-driver
U1 | 2 | CPH | GEN_CPH | gen-driver
U1 | 3 | VM | DRIVE12 | gen-driver
U1 | 4 | VDRAIN | DC_LINK | gen-driver
U1 | 5 | VCP | GEN_VCP | gen-driver
U1 | 6 | GHA | GEN_GHA | gen-driver
U1 | 7 | SHA | GEN_PHASE_A | gen-driver
U1 | 8 | GLA | GEN_GLA | gen-driver
U1 | 9 | SPA | GEN_SHUNT_A | gen-driver
U1 | 10 | SNA | PGND | gen-driver
U1 | 11 | SNB | PGND | gen-driver
U1 | 12 | SPB | GEN_SHUNT_B | gen-driver
U1 | 13 | GLB | GEN_GLB | gen-driver
U1 | 14 | SHB | GEN_PHASE_B | gen-driver
U1 | 15 | GHB | GEN_GHB | gen-driver
U1 | 16 | GHC | GEN_GHC | gen-driver
U1 | 17 | SHC | GEN_PHASE_C | gen-driver
U1 | 18 | GLC | GEN_GLC | gen-driver
U1 | 19 | SPC | GEN_SHUNT_C | gen-driver
U1 | 20 | SNC | PGND | gen-driver
U1 | 21 | SOC | GEN_SOC | gen-driver
U1 | 22 | SOB | GEN_SOB | gen-driver
U1 | 23 | SOA | GEN_SOA | gen-driver
U1 | 24 | VREF | LOGIC3V3_EXT | gen-driver
U1 | 25 | AGND | PGND | gen-driver
U1 | 26 | nFAULT | GEN_nFAULT | gen-driver
U1 | 27 | SDO | DRV_MISO | gen-driver
U1 | 28 | SDI | DRV_MOSI | gen-driver
U1 | 29 | SCLK | DRV_SCK | gen-driver
U1 | 30 | nSCS | GEN_nSCS | gen-driver
U1 | 31 | ENABLE | GEN_ENABLE | gen-driver
U1 | 32 | INHA | GEN_INHA | gen-driver
U1 | 33 | INLA | GEN_INLA | gen-driver
U1 | 34 | INHB | GEN_INHB | gen-driver
U1 | 35 | INLB | GEN_INLB | gen-driver
U1 | 36 | INHC | GEN_INHC | gen-driver
U1 | 37 | INLC | GEN_INLC | gen-driver
U1 | 38 | DVDD | GEN_DVDD | gen-driver
U1 | 39 | GND | PGND | gen-driver
U1 | 40 | VGLS | GEN_VGLS | gen-driver
U1 | 41 | EP | PGND | gen-driver
C1 | 1 | ~ | GEN_CPH | gen-driver
C1 | 2 | ~ | GEN_CPL | gen-driver
C2 | 1 | ~ | GEN_VCP | gen-driver
C2 | 2 | ~ | DC_LINK | gen-driver
C3 | 1 | ~ | GEN_VGLS | gen-driver
C3 | 2 | ~ | PGND | gen-driver
C4 | 1 | ~ | GEN_DVDD | gen-driver
C4 | 2 | ~ | PGND | gen-driver
C5 | 1 | ~ | DRIVE12 | gen-driver
C5 | 2 | ~ | PGND | gen-driver
C6 | 1 | ~ | DRIVE12 | gen-driver
C6 | 2 | ~ | PGND | gen-driver
C7 | 1 | ~ | LOGIC3V3_EXT | gen-driver
C7 | 2 | ~ | PGND | gen-driver
R1 | 1 | ~ | GEN_ENABLE | gen-driver
R1 | 2 | ~ | PGND | gen-driver
R2 | 1 | ~ | GEN_nFAULT | gen-driver
R2 | 2 | ~ | LOGIC3V3_EXT | gen-driver
R3 | 1 | ~ | DRV_MISO | gen-driver
R3 | 2 | ~ | LOGIC3V3_EXT | gen-driver
R4 | 1 | ~ | GEN_nSCS | gen-driver
R4 | 2 | ~ | LOGIC3V3_EXT | gen-driver
Q1 | 4 | G | GEN_GHA_FET | gen-bridge
Q1 | 5 | D | DC_LINK | gen-bridge
Q1 | 1 | S | GEN_PHASE_A | gen-bridge
Q1 | 2 | S | GEN_PHASE_A | gen-bridge
Q1 | 3 | S | GEN_PHASE_A | gen-bridge
R5 | 1 | ~ | GEN_GHA | gen-bridge
R5 | 2 | ~ | GEN_GHA_FET | gen-bridge
R6 | 1 | ~ | GEN_GHA_FET | gen-bridge
R6 | 2 | ~ | GEN_PHASE_A | gen-bridge
Q2 | 4 | G | GEN_GLA_FET | gen-bridge
Q2 | 5 | D | GEN_PHASE_A | gen-bridge
Q2 | 1 | S | GEN_SHUNT_A | gen-bridge
Q2 | 2 | S | GEN_SHUNT_A | gen-bridge
Q2 | 3 | S | GEN_SHUNT_A | gen-bridge
R7 | 1 | ~ | GEN_GLA | gen-bridge
R7 | 2 | ~ | GEN_GLA_FET | gen-bridge
R8 | 1 | ~ | GEN_GLA_FET | gen-bridge
R8 | 2 | ~ | GEN_SHUNT_A | gen-bridge
R9 | 1 | ~ | GEN_SHUNT_A | gen-bridge
R9 | 2 | ~ | PGND | gen-bridge
C8 | 1 | ~ | DC_LINK | gen-bridge
C8 | 2 | ~ | PGND | gen-bridge
Q3 | 4 | G | GEN_GHB_FET | gen-bridge
Q3 | 5 | D | DC_LINK | gen-bridge
Q3 | 1 | S | GEN_PHASE_B | gen-bridge
Q3 | 2 | S | GEN_PHASE_B | gen-bridge
Q3 | 3 | S | GEN_PHASE_B | gen-bridge
R10 | 1 | ~ | GEN_GHB | gen-bridge
R10 | 2 | ~ | GEN_GHB_FET | gen-bridge
R11 | 1 | ~ | GEN_GHB_FET | gen-bridge
R11 | 2 | ~ | GEN_PHASE_B | gen-bridge
Q4 | 4 | G | GEN_GLB_FET | gen-bridge
Q4 | 5 | D | GEN_PHASE_B | gen-bridge
Q4 | 1 | S | GEN_SHUNT_B | gen-bridge
Q4 | 2 | S | GEN_SHUNT_B | gen-bridge
Q4 | 3 | S | GEN_SHUNT_B | gen-bridge
R12 | 1 | ~ | GEN_GLB | gen-bridge
R12 | 2 | ~ | GEN_GLB_FET | gen-bridge
R13 | 1 | ~ | GEN_GLB_FET | gen-bridge
R13 | 2 | ~ | GEN_SHUNT_B | gen-bridge
R14 | 1 | ~ | GEN_SHUNT_B | gen-bridge
R14 | 2 | ~ | PGND | gen-bridge
C9 | 1 | ~ | DC_LINK | gen-bridge
C9 | 2 | ~ | PGND | gen-bridge
Q5 | 4 | G | GEN_GHC_FET | gen-bridge
Q5 | 5 | D | DC_LINK | gen-bridge
Q5 | 1 | S | GEN_PHASE_C | gen-bridge
Q5 | 2 | S | GEN_PHASE_C | gen-bridge
Q5 | 3 | S | GEN_PHASE_C | gen-bridge
R15 | 1 | ~ | GEN_GHC | gen-bridge
R15 | 2 | ~ | GEN_GHC_FET | gen-bridge
R16 | 1 | ~ | GEN_GHC_FET | gen-bridge
R16 | 2 | ~ | GEN_PHASE_C | gen-bridge
Q6 | 4 | G | GEN_GLC_FET | gen-bridge
Q6 | 5 | D | GEN_PHASE_C | gen-bridge
Q6 | 1 | S | GEN_SHUNT_C | gen-bridge
Q6 | 2 | S | GEN_SHUNT_C | gen-bridge
Q6 | 3 | S | GEN_SHUNT_C | gen-bridge
R17 | 1 | ~ | GEN_GLC | gen-bridge
R17 | 2 | ~ | GEN_GLC_FET | gen-bridge
R18 | 1 | ~ | GEN_GLC_FET | gen-bridge
R18 | 2 | ~ | GEN_SHUNT_C | gen-bridge
R19 | 1 | ~ | GEN_SHUNT_C | gen-bridge
R19 | 2 | ~ | PGND | gen-bridge
C10 | 1 | ~ | DC_LINK | gen-bridge
C10 | 2 | ~ | PGND | gen-bridge
U2 | 1 | CPL | HUB_CPL | hub-driver
U2 | 2 | CPH | HUB_CPH | hub-driver
U2 | 3 | VM | DRIVE12 | hub-driver
U2 | 4 | VDRAIN | DC_LINK | hub-driver
U2 | 5 | VCP | HUB_VCP | hub-driver
U2 | 6 | GHA | HUB_GHA | hub-driver
U2 | 7 | SHA | HUB_PHASE_A | hub-driver
U2 | 8 | GLA | HUB_GLA | hub-driver
U2 | 9 | SPA | HUB_SHUNT_A | hub-driver
U2 | 10 | SNA | PGND | hub-driver
U2 | 11 | SNB | PGND | hub-driver
U2 | 12 | SPB | HUB_SHUNT_B | hub-driver
U2 | 13 | GLB | HUB_GLB | hub-driver
U2 | 14 | SHB | HUB_PHASE_B | hub-driver
U2 | 15 | GHB | HUB_GHB | hub-driver
U2 | 16 | GHC | HUB_GHC | hub-driver
U2 | 17 | SHC | HUB_PHASE_C | hub-driver
U2 | 18 | GLC | HUB_GLC | hub-driver
U2 | 19 | SPC | HUB_SHUNT_C | hub-driver
U2 | 20 | SNC | PGND | hub-driver
U2 | 21 | SOC | HUB_SOC | hub-driver
U2 | 22 | SOB | HUB_SOB | hub-driver
U2 | 23 | SOA | HUB_SOA | hub-driver
U2 | 24 | VREF | LOGIC3V3_EXT | hub-driver
U2 | 25 | AGND | PGND | hub-driver
U2 | 26 | nFAULT | HUB_nFAULT | hub-driver
U2 | 27 | SDO | DRV_MISO | hub-driver
U2 | 28 | SDI | DRV_MOSI | hub-driver
U2 | 29 | SCLK | DRV_SCK | hub-driver
U2 | 30 | nSCS | HUB_nSCS | hub-driver
U2 | 31 | ENABLE | HUB_ENABLE | hub-driver
U2 | 32 | INHA | HUB_INHA | hub-driver
U2 | 33 | INLA | HUB_INLA | hub-driver
U2 | 34 | INHB | HUB_INHB | hub-driver
U2 | 35 | INLB | HUB_INLB | hub-driver
U2 | 36 | INHC | HUB_INHC | hub-driver
U2 | 37 | INLC | HUB_INLC | hub-driver
U2 | 38 | DVDD | HUB_DVDD | hub-driver
U2 | 39 | GND | PGND | hub-driver
U2 | 40 | VGLS | HUB_VGLS | hub-driver
U2 | 41 | EP | PGND | hub-driver
C11 | 1 | ~ | HUB_CPH | hub-driver
C11 | 2 | ~ | HUB_CPL | hub-driver
C12 | 1 | ~ | HUB_VCP | hub-driver
C12 | 2 | ~ | DC_LINK | hub-driver
C13 | 1 | ~ | HUB_VGLS | hub-driver
C13 | 2 | ~ | PGND | hub-driver
C14 | 1 | ~ | HUB_DVDD | hub-driver
C14 | 2 | ~ | PGND | hub-driver
C15 | 1 | ~ | DRIVE12 | hub-driver
C15 | 2 | ~ | PGND | hub-driver
C16 | 1 | ~ | DRIVE12 | hub-driver
C16 | 2 | ~ | PGND | hub-driver
C17 | 1 | ~ | LOGIC3V3_EXT | hub-driver
C17 | 2 | ~ | PGND | hub-driver
R20 | 1 | ~ | HUB_ENABLE | hub-driver
R20 | 2 | ~ | PGND | hub-driver
R21 | 1 | ~ | HUB_nFAULT | hub-driver
R21 | 2 | ~ | LOGIC3V3_EXT | hub-driver
R22 | 1 | ~ | DRV_MISO | hub-driver
R22 | 2 | ~ | LOGIC3V3_EXT | hub-driver
R23 | 1 | ~ | HUB_nSCS | hub-driver
R23 | 2 | ~ | LOGIC3V3_EXT | hub-driver
Q7 | 4 | G | HUB_GHA_FET | hub-bridge
Q7 | 5 | D | DC_LINK | hub-bridge
Q7 | 1 | S | HUB_PHASE_A | hub-bridge
Q7 | 2 | S | HUB_PHASE_A | hub-bridge
Q7 | 3 | S | HUB_PHASE_A | hub-bridge
R24 | 1 | ~ | HUB_GHA | hub-bridge
R24 | 2 | ~ | HUB_GHA_FET | hub-bridge
R25 | 1 | ~ | HUB_GHA_FET | hub-bridge
R25 | 2 | ~ | HUB_PHASE_A | hub-bridge
Q8 | 4 | G | HUB_GLA_FET | hub-bridge
Q8 | 5 | D | HUB_PHASE_A | hub-bridge
Q8 | 1 | S | HUB_SHUNT_A | hub-bridge
Q8 | 2 | S | HUB_SHUNT_A | hub-bridge
Q8 | 3 | S | HUB_SHUNT_A | hub-bridge
R26 | 1 | ~ | HUB_GLA | hub-bridge
R26 | 2 | ~ | HUB_GLA_FET | hub-bridge
R27 | 1 | ~ | HUB_GLA_FET | hub-bridge
R27 | 2 | ~ | HUB_SHUNT_A | hub-bridge
R28 | 1 | ~ | HUB_SHUNT_A | hub-bridge
R28 | 2 | ~ | PGND | hub-bridge
C18 | 1 | ~ | DC_LINK | hub-bridge
C18 | 2 | ~ | PGND | hub-bridge
Q9 | 4 | G | HUB_GHB_FET | hub-bridge
Q9 | 5 | D | DC_LINK | hub-bridge
Q9 | 1 | S | HUB_PHASE_B | hub-bridge
Q9 | 2 | S | HUB_PHASE_B | hub-bridge
Q9 | 3 | S | HUB_PHASE_B | hub-bridge
R29 | 1 | ~ | HUB_GHB | hub-bridge
R29 | 2 | ~ | HUB_GHB_FET | hub-bridge
R30 | 1 | ~ | HUB_GHB_FET | hub-bridge
R30 | 2 | ~ | HUB_PHASE_B | hub-bridge
Q10 | 4 | G | HUB_GLB_FET | hub-bridge
Q10 | 5 | D | HUB_PHASE_B | hub-bridge
Q10 | 1 | S | HUB_SHUNT_B | hub-bridge
Q10 | 2 | S | HUB_SHUNT_B | hub-bridge
Q10 | 3 | S | HUB_SHUNT_B | hub-bridge
R31 | 1 | ~ | HUB_GLB | hub-bridge
R31 | 2 | ~ | HUB_GLB_FET | hub-bridge
R32 | 1 | ~ | HUB_GLB_FET | hub-bridge
R32 | 2 | ~ | HUB_SHUNT_B | hub-bridge
R33 | 1 | ~ | HUB_SHUNT_B | hub-bridge
R33 | 2 | ~ | PGND | hub-bridge
C19 | 1 | ~ | DC_LINK | hub-bridge
C19 | 2 | ~ | PGND | hub-bridge
Q11 | 4 | G | HUB_GHC_FET | hub-bridge
Q11 | 5 | D | DC_LINK | hub-bridge
Q11 | 1 | S | HUB_PHASE_C | hub-bridge
Q11 | 2 | S | HUB_PHASE_C | hub-bridge
Q11 | 3 | S | HUB_PHASE_C | hub-bridge
R34 | 1 | ~ | HUB_GHC | hub-bridge
R34 | 2 | ~ | HUB_GHC_FET | hub-bridge
R35 | 1 | ~ | HUB_GHC_FET | hub-bridge
R35 | 2 | ~ | HUB_PHASE_C | hub-bridge
Q12 | 4 | G | HUB_GLC_FET | hub-bridge
Q12 | 5 | D | HUB_PHASE_C | hub-bridge
Q12 | 1 | S | HUB_SHUNT_C | hub-bridge
Q12 | 2 | S | HUB_SHUNT_C | hub-bridge
Q12 | 3 | S | HUB_SHUNT_C | hub-bridge
R36 | 1 | ~ | HUB_GLC | hub-bridge
R36 | 2 | ~ | HUB_GLC_FET | hub-bridge
R37 | 1 | ~ | HUB_GLC_FET | hub-bridge
R37 | 2 | ~ | HUB_SHUNT_C | hub-bridge
R38 | 1 | ~ | HUB_SHUNT_C | hub-bridge
R38 | 2 | ~ | PGND | hub-bridge
C20 | 1 | ~ | DC_LINK | hub-bridge
C20 | 2 | ~ | PGND | hub-bridge
J1 | 1 | Pin_1 | DC_LINK | external-boundaries
J1 | 2 | Pin_2 | PGND | external-boundaries
J2 | 1 | Pin_1 | LOGIC3V3_EXT | external-boundaries
J2 | 2 | Pin_2 | PGND | external-boundaries
J3 | 1 | Pin_1 | GEN_PHASE_A | external-boundaries
J3 | 2 | Pin_2 | GEN_PHASE_B | external-boundaries
J3 | 3 | Pin_3 | GEN_PHASE_C | external-boundaries
J4 | 1 | Pin_1 | HUB_PHASE_A | external-boundaries
J4 | 2 | Pin_2 | HUB_PHASE_B | external-boundaries
J4 | 3 | Pin_3 | HUB_PHASE_C | external-boundaries
J5 | 1 | Pin_1 | SAFETY3V3 | external-boundaries
J5 | 2 | Pin_2 | FAULT_CHAIN | external-boundaries
C21 | 1 | ~ | DC_LINK | external-boundaries
C21 | 2 | ~ | PGND | external-boundaries
U3 | 1 | IN | DC_LINK | aux-supply
U3 | 2 | GND | PGND | aux-supply
U3 | 3 | OUT | SINK12 | aux-supply
U4 | 1 | OUT | SAFETY3V3 | aux-supply
U4 | 2 | IN | SINK12 | aux-supply
U4 | 3 | GND | PGND | aux-supply
C22 | 1 | ~ | DC_LINK | aux-supply
C22 | 2 | ~ | PGND | aux-supply
C23 | 1 | ~ | SINK12 | aux-supply
C23 | 2 | ~ | PGND | aux-supply
C24 | 1 | ~ | SAFETY3V3 | aux-supply
C24 | 2 | ~ | PGND | aux-supply
R39 | 1 | ~ | SINK12 | aux-supply
R39 | 2 | ~ | PGND | aux-supply
U5 | 1 | K | REF2V5 | aux-supply
U5 | 2 | A | PGND | aux-supply
U5 | 3 | NC | PGND | aux-supply
R40 | 1 | ~ | SINK12 | aux-supply
R40 | 2 | ~ | REF2V5 | aux-supply
C25 | 1 | ~ | REF2V5 | aux-supply
C25 | 2 | ~ | PGND | aux-supply
U6 | 1 | OUT1 | ANALOG_OK | protection-comparators
U6 | 2 | OUT2 | OV_CMD | protection-comparators
U6 | 3 | VCC | SINK12 | protection-comparators
U6 | 4 | IN2- | REF2V5 | protection-comparators
U6 | 5 | IN2+ | OV_SENSE | protection-comparators
U6 | 6 | IN1- | REF2V5 | protection-comparators
U6 | 7 | IN1+ | AUX_SENSE | protection-comparators
U6 | 8 | IN3- | REF2V5 | protection-comparators
U6 | 9 | IN3+ | MCU_SENSE | protection-comparators
U6 | 10 | IN4- | REF2V5 | protection-comparators
U6 | 11 | IN4+ | FAULT_CHAIN | protection-comparators
U6 | 12 | GND | PGND | protection-comparators
U6 | 13 | OUT4 | ANALOG_OK | protection-comparators
U6 | 14 | OUT3 | ANALOG_OK | protection-comparators
R41 | 1 | ~ | DC_LINK | protection-comparators
R41 | 2 | ~ | OV_MID | protection-comparators
R42 | 1 | ~ | OV_MID | protection-comparators
R42 | 2 | ~ | OV_SENSE | protection-comparators
R43 | 1 | ~ | OV_SENSE | protection-comparators
R43 | 2 | ~ | PGND | protection-comparators
R44 | 1 | ~ | OV_CMD | protection-comparators
R44 | 2 | ~ | OV_SENSE | protection-comparators
R45 | 1 | ~ | SAFETY3V3 | protection-comparators
R45 | 2 | ~ | OV_CMD | protection-comparators
R46 | 1 | ~ | SINK12 | protection-comparators
R46 | 2 | ~ | AUX_SENSE | protection-comparators
R47 | 1 | ~ | AUX_SENSE | protection-comparators
R47 | 2 | ~ | PGND | protection-comparators
R48 | 1 | ~ | LOGIC3V3_EXT | protection-comparators
R48 | 2 | ~ | MCU_SENSE | protection-comparators
R49 | 1 | ~ | MCU_SENSE | protection-comparators
R49 | 2 | ~ | PGND | protection-comparators
R50 | 1 | ~ | FAULT_CHAIN | protection-comparators
R50 | 2 | ~ | PGND | protection-comparators
R51 | 1 | ~ | SAFETY3V3 | protection-comparators
R51 | 2 | ~ | ANALOG_OK | protection-comparators
C26 | 1 | ~ | OV_SENSE | protection-comparators
C26 | 2 | ~ | PGND | protection-comparators
C27 | 1 | ~ | SINK12 | protection-comparators
C27 | 2 | ~ | PGND | protection-comparators
U7 | 1 | CLK | RESET_INV | fault-latch
U7 | 2 | D | SAFETY3V3 | fault-latch
U7 | 3 | Q_N | RELEASE_N | fault-latch
U7 | 4 | GND | PGND | fault-latch
U7 | 5 | Q | RELEASE_SEEN | fault-latch
U7 | 6 | CLR_N | HEALTHY | fault-latch
U7 | 7 | PRE_N | SAFETY3V3 | fault-latch
U7 | 8 | VCC | SAFETY3V3 | fault-latch
U8 | 1 | CLK | RESET_CLEAN | fault-latch
U8 | 2 | D | RELEASE_SEEN | fault-latch
U8 | 3 | Q_N | FAULT_LATCH | fault-latch
U8 | 4 | GND | PGND | fault-latch
U8 | 5 | Q | PERMIT | fault-latch
U8 | 6 | CLR_N | HEALTHY | fault-latch
U8 | 7 | PRE_N | SAFETY3V3 | fault-latch
U8 | 8 | VCC | SAFETY3V3 | fault-latch
U9 | 1 | RESET_N | WD_RESET_N | fault-latch
U9 | 2 | GND | PGND | fault-latch
U9 | 3 | MR_N | SAFETY3V3 | fault-latch
U9 | 4 | WDI | WDI | fault-latch
U9 | 5 | VDD | SAFETY3V3 | fault-latch
R52 | 1 | ~ | RESET_REQUEST | fault-latch
R52 | 2 | ~ | PGND | fault-latch
R53 | 1 | ~ | MCU_ARM | fault-latch
R53 | 2 | ~ | PGND | fault-latch
R54 | 1 | ~ | WDI | fault-latch
R54 | 2 | ~ | PGND | fault-latch
R55 | 1 | ~ | RESET_REQUEST | fault-latch
R55 | 2 | ~ | RESET_RC | fault-latch
C28 | 1 | ~ | RESET_RC | fault-latch
C28 | 2 | ~ | PGND | fault-latch
R56 | 1 | ~ | SAFETY3V3 | fault-latch
R56 | 2 | ~ | GEN_nFAULT | fault-latch
R57 | 1 | ~ | SAFETY3V3 | fault-latch
R57 | 2 | ~ | HUB_nFAULT | fault-latch
R58 | 1 | ~ | RELEASE_N | fault-latch
R58 | 2 | ~ | PGND | fault-latch
R59 | 1 | ~ | FAULT_LATCH | fault-latch
R59 | 2 | ~ | PGND | fault-latch
R60 | 1 | ~ | TIMER_BREAK_OK | fault-latch
R60 | 2 | ~ | GEN_ENABLE | fault-latch
R61 | 1 | ~ | TIMER_BREAK_OK | fault-latch
R61 | 2 | ~ | HUB_ENABLE | fault-latch
C29 | 1 | ~ | SAFETY3V3 | fault-latch
C29 | 2 | ~ | PGND | fault-latch
C30 | 1 | ~ | SAFETY3V3 | fault-latch
C30 | 2 | ~ | PGND | fault-latch
C31 | 1 | ~ | SAFETY3V3 | fault-latch
C31 | 2 | ~ | PGND | fault-latch
U11 | 1 | 1A | ANALOG_OK | fault-interfaces
U11 | 2 | 3Y | WD_OK | fault-interfaces
U11 | 3 | 2A | GEN_nFAULT | fault-interfaces
U11 | 4 | GND | PGND | fault-interfaces
U11 | 5 | 2Y | GEN_OK | fault-interfaces
U11 | 6 | 3A | WD_RESET_N | fault-interfaces
U11 | 7 | 1Y | ANALOG_CLEAN | fault-interfaces
U11 | 8 | VCC | SAFETY3V3 | fault-interfaces
U12 | 1 | 1A | HUB_nFAULT | fault-interfaces
U12 | 2 | 3Y | ARM_CLEAN | fault-interfaces
U12 | 3 | 2A | RESET_RC | fault-interfaces
U12 | 4 | GND | PGND | fault-interfaces
U12 | 5 | 2Y | RESET_CLEAN | fault-interfaces
U12 | 6 | 3A | MCU_ARM | fault-interfaces
U12 | 7 | 1Y | HUB_OK | fault-interfaces
U12 | 8 | VCC | SAFETY3V3 | fault-interfaces
U13 | 1 | A | ANALOG_CLEAN | fault-interfaces
U13 | 2 | GND | PGND | fault-interfaces
U13 | 3 | B | GEN_OK | fault-interfaces
U13 | 4 | Y | FAULTS_OK | fault-interfaces
U13 | 5 | VCC | SAFETY3V3 | fault-interfaces
U13 | 6 | C | HUB_OK | fault-interfaces
U14 | 1 | A | FAULTS_OK | fault-interfaces
U14 | 2 | GND | PGND | fault-interfaces
U14 | 3 | B | WD_OK | fault-interfaces
U14 | 4 | Y | HEALTHY | fault-interfaces
U14 | 5 | VCC | SAFETY3V3 | fault-interfaces
U14 | 6 | C | OC_OK | fault-interfaces
U15 | 1 | NC | PGND | fault-interfaces
U15 | 2 | A | RESET_CLEAN | fault-interfaces
U15 | 3 | GND | PGND | fault-interfaces
U15 | 4 | Y | RESET_INV | fault-interfaces
U15 | 5 | VCC | SAFETY3V3 | fault-interfaces
U16 | 1 | A | HEALTHY | fault-interfaces
U16 | 2 | GND | PGND | fault-interfaces
U16 | 3 | B | PERMIT | fault-interfaces
U16 | 4 | Y | TIMER_BREAK_OK | fault-interfaces
U16 | 5 | VCC | SAFETY3V3 | fault-interfaces
U16 | 6 | C | ARM_CLEAN | fault-interfaces
C32 | 1 | ~ | SAFETY3V3 | fault-interfaces
C32 | 2 | ~ | PGND | fault-interfaces
C33 | 1 | ~ | SAFETY3V3 | fault-interfaces
C33 | 2 | ~ | PGND | fault-interfaces
C34 | 1 | ~ | SAFETY3V3 | fault-interfaces
C34 | 2 | ~ | PGND | fault-interfaces
C35 | 1 | ~ | SAFETY3V3 | fault-interfaces
C35 | 2 | ~ | PGND | fault-interfaces
C36 | 1 | ~ | SAFETY3V3 | fault-interfaces
C36 | 2 | ~ | PGND | fault-interfaces
C37 | 1 | ~ | SAFETY3V3 | fault-interfaces
C37 | 2 | ~ | PGND | fault-interfaces
U10 | 1 | VDD | SINK12 | brake-chopper
U10 | 2 | OUTH | CHOP_SOURCE | brake-chopper
U10 | 3 | OUTL | CHOP_SINK | brake-chopper
U10 | 4 | GND | PGND | brake-chopper
U10 | 5 | IN- | PGND | brake-chopper
U10 | 6 | IN+ | CHOP_CMD | brake-chopper
Q13 | 4 | G | CHOP_GATE | brake-chopper
Q13 | 5 | D | DUMP_LOW | brake-chopper
Q13 | 1 | S | PGND | brake-chopper
Q13 | 2 | S | PGND | brake-chopper
Q13 | 3 | S | PGND | brake-chopper
R62 | 1 | ~ | CHOP_SOURCE | brake-chopper
R62 | 2 | ~ | CHOP_GATE | brake-chopper
R63 | 1 | ~ | CHOP_SINK | brake-chopper
R63 | 2 | ~ | CHOP_GATE | brake-chopper
R64 | 1 | ~ | CHOP_GATE | brake-chopper
R64 | 2 | ~ | PGND | brake-chopper
C38 | 1 | ~ | SINK12 | brake-chopper
C38 | 2 | ~ | PGND | brake-chopper
C39 | 1 | ~ | SINK12 | brake-chopper
C39 | 2 | ~ | PGND | brake-chopper
J6 | 1 | Pin_1 | DC_LINK | brake-chopper
J6 | 2 | Pin_2 | DUMP_LOW | brake-chopper
U17 | 36 | VREF+ | MCU_VREF | mcu-core
U17 | 14 | PG10 | MCU_NRST | mcu-core
U17 | 1 | PE2 | MCU_ARM | mcu-core
U17 | 2 | PE3 | WDI | mcu-core
U17 | 3 | PE4 | RESET_REQUEST | mcu-core
U17 | 4 | PE5 | FSR_SAMPLE_ENABLE | mcu-core
U17 | 39 | PE8 | GEN_INLA | mcu-core
U17 | 40 | PE9 | GEN_INHA | mcu-core
U17 | 41 | PE10 | GEN_INLB | mcu-core
U17 | 42 | PE11 | GEN_INHB | mcu-core
U17 | 43 | PE12 | GEN_INLC | mcu-core
U17 | 44 | PE13 | GEN_INHC | mcu-core
U17 | 45 | PE14 | HUB_nSCS | mcu-core
U17 | 46 | PE15 | TIMER_BREAK_OK | mcu-core
U17 | 84 | PD2 | TIMER_BREAK_OK | mcu-core
U17 | 55 | PD8 | GEN_HALL_1 | mcu-core
U17 | 56 | PD9 | GEN_HALL_2 | mcu-core
U17 | 57 | PD10 | GEN_HALL_3 | mcu-core
U17 | 58 | PD11 | HUB_HALL_1 | mcu-core
U17 | 59 | PD12 | HUB_HALL_2 | mcu-core
U17 | 60 | PD13 | HUB_HALL_3 | mcu-core
U17 | 61 | PD14 | FAULT_CHAIN_SENSE | mcu-core
U17 | 62 | PD15 | GEN_nSCS | mcu-core
U17 | 6 | VBAT | LOGIC3V3_EXT | mcu-core
U17 | 24 | VDD | LOGIC3V3_EXT | mcu-core
U17 | 49 | VDD | LOGIC3V3_EXT | mcu-core
U17 | 64 | VDD | LOGIC3V3_EXT | mcu-core
U17 | 23 | VSS | PGND | mcu-core
U17 | 48 | VSS | PGND | mcu-core
U17 | 63 | VSS | PGND | mcu-core
U17 | 74 | VSS | PGND | mcu-core
U17 | 99 | VSS | PGND | mcu-core
U17 | 75 | VDD | LOGIC3V3_EXT | mcu-core
U17 | 35 | VSSA | PGND | mcu-core
U17 | 100 | VDD | LOGIC3V3_EXT | mcu-core
U17 | 37 | VDDA | MCU_VDDA | mcu-core
U17 | 20 | PA0 | GEN_SOA_ADC | mcu-core
U17 | 21 | PA1 | GEN_SOB_ADC | mcu-core
U17 | 22 | PA2 | GEN_SOC_ADC | mcu-core
U17 | 25 | PA3 | RIGHT_FSR_ADC | mcu-core
U17 | 26 | PA4 | LEFT_SWITCH_ADC | mcu-core
U17 | 27 | PA5 | DRV_SCK | mcu-core
U17 | 28 | PA6 | DRV_MISO | mcu-core
U17 | 29 | PA7 | HUB_INLA | mcu-core
U17 | 76 | PA13 | SWDIO | mcu-core
U17 | 77 | PA14 | SWCLK | mcu-core
U17 | 32 | PB0 | HUB_INLB | mcu-core
U17 | 33 | PB1 | HUB_INLC | mcu-core
U17 | 34 | PB2 | RIGHT_SWITCH_ADC | mcu-core
U17 | 92 | PB5 | DRV_MOSI | mcu-core
U17 | 93 | PB6 | ENC_A | mcu-core
U17 | 94 | PB7 | ENC_B | mcu-core
U17 | 95 | PB8 | MCU_BOOT0 | mcu-core
U17 | 50 | PB11 | BRAKE_DUMP_PWM | mcu-core
U17 | 15 | PC0 | HUB_SOA_ADC | mcu-core
U17 | 16 | PC1 | HUB_SOB_ADC | mcu-core
U17 | 17 | PC2 | HUB_SOC_ADC | mcu-core
U17 | 18 | PC3 | LEFT_FSR_ADC | mcu-core
U17 | 65 | PC6 | HUB_INHA | mcu-core
U17 | 66 | PC7 | HUB_INHB | mcu-core
U17 | 67 | PC8 | HUB_INHC | mcu-core
J7 | 1 | Pin_1 | LOGIC3V3_EXT | mcu-core
J7 | 2 | Pin_2 | SWDIO | mcu-core
J7 | 3 | Pin_3 | SWCLK | mcu-core
J7 | 4 | Pin_4 | MCU_NRST | mcu-core
J7 | 5 | Pin_5 | PGND | mcu-core
R65 | 1 | ~ | MCU_NRST | mcu-core
R65 | 2 | ~ | LOGIC3V3_EXT | mcu-core
C40 | 1 | ~ | MCU_NRST | mcu-core
C40 | 2 | ~ | PGND | mcu-core
R66 | 1 | ~ | MCU_BOOT0 | mcu-core
R66 | 2 | ~ | PGND | mcu-core
J8 | 1 | Pin_1 | MCU_NRST | mcu-core
J8 | 2 | Pin_2 | PGND | mcu-core
C41 | 1 | ~ | LOGIC3V3_EXT | mcu-power
C41 | 2 | ~ | PGND | mcu-power
C42 | 1 | ~ | LOGIC3V3_EXT | mcu-power
C42 | 2 | ~ | PGND | mcu-power
C43 | 1 | ~ | LOGIC3V3_EXT | mcu-power
C43 | 2 | ~ | PGND | mcu-power
C44 | 1 | ~ | LOGIC3V3_EXT | mcu-power
C44 | 2 | ~ | PGND | mcu-power
C45 | 1 | ~ | LOGIC3V3_EXT | mcu-power
C45 | 2 | ~ | PGND | mcu-power
C46 | 1 | ~ | LOGIC3V3_EXT | mcu-power
C46 | 2 | ~ | PGND | mcu-power
C47 | 1 | ~ | LOGIC3V3_EXT | mcu-power
C47 | 2 | ~ | PGND | mcu-power
R67 | 1 | ~ | LOGIC3V3_EXT | mcu-power
R67 | 2 | ~ | MCU_VDDA | mcu-power
C48 | 1 | ~ | MCU_VDDA | mcu-power
C48 | 2 | ~ | PGND | mcu-power
C49 | 1 | ~ | MCU_VDDA | mcu-power
C49 | 2 | ~ | PGND | mcu-power
R68 | 1 | ~ | LOGIC3V3_EXT | mcu-power
R68 | 2 | ~ | MCU_VREF | mcu-power
C50 | 1 | ~ | MCU_VREF | mcu-power
C50 | 2 | ~ | PGND | mcu-power
C51 | 1 | ~ | MCU_VREF | mcu-power
C51 | 2 | ~ | PGND | mcu-power
R69 | 1 | ~ | GEN_SOA | mcu-analog
R69 | 2 | ~ | GEN_SOA_ADC | mcu-analog
C52 | 1 | ~ | GEN_SOA_ADC | mcu-analog
C52 | 2 | ~ | PGND | mcu-analog
R70 | 1 | ~ | GEN_SOB | mcu-analog
R70 | 2 | ~ | GEN_SOB_ADC | mcu-analog
C53 | 1 | ~ | GEN_SOB_ADC | mcu-analog
C53 | 2 | ~ | PGND | mcu-analog
R71 | 1 | ~ | GEN_SOC | mcu-analog
R71 | 2 | ~ | GEN_SOC_ADC | mcu-analog
C54 | 1 | ~ | GEN_SOC_ADC | mcu-analog
C54 | 2 | ~ | PGND | mcu-analog
R72 | 1 | ~ | HUB_SOA | mcu-analog
R72 | 2 | ~ | HUB_SOA_ADC | mcu-analog
C55 | 1 | ~ | HUB_SOA_ADC | mcu-analog
C55 | 2 | ~ | PGND | mcu-analog
R73 | 1 | ~ | HUB_SOB | mcu-analog
R73 | 2 | ~ | HUB_SOB_ADC | mcu-analog
C56 | 1 | ~ | HUB_SOB_ADC | mcu-analog
C56 | 2 | ~ | PGND | mcu-analog
R74 | 1 | ~ | HUB_SOC | mcu-analog
R74 | 2 | ~ | HUB_SOC_ADC | mcu-analog
C57 | 1 | ~ | HUB_SOC_ADC | mcu-analog
C57 | 2 | ~ | PGND | mcu-analog
R75 | 1 | ~ | FAULT_CHAIN | mcu-analog
R75 | 2 | ~ | FAULT_CHAIN_SENSE | mcu-analog
R76 | 1 | ~ | FAULT_CHAIN_SENSE | mcu-analog
R76 | 2 | ~ | PGND | mcu-analog
C58 | 1 | ~ | FAULT_CHAIN_SENSE | mcu-analog
C58 | 2 | ~ | PGND | mcu-analog
J9 | 1 | Pin_1 | LOGIC3V3_EXT | mcu-sensors
J9 | 2 | Pin_2 | PGND | mcu-sensors
J9 | 3 | Pin_3 | GEN_HALL_1_EXT | mcu-sensors
J9 | 4 | Pin_4 | GEN_HALL_2_EXT | mcu-sensors
J9 | 5 | Pin_5 | GEN_HALL_3_EXT | mcu-sensors
R77 | 1 | ~ | GEN_HALL_1_EXT | mcu-sensors
R77 | 2 | ~ | LOGIC3V3_EXT | mcu-sensors
R78 | 1 | ~ | GEN_HALL_1_EXT | mcu-sensors
R78 | 2 | ~ | GEN_HALL_1 | mcu-sensors
C59 | 1 | ~ | GEN_HALL_1 | mcu-sensors
C59 | 2 | ~ | PGND | mcu-sensors
R79 | 1 | ~ | GEN_HALL_2_EXT | mcu-sensors
R79 | 2 | ~ | LOGIC3V3_EXT | mcu-sensors
R80 | 1 | ~ | GEN_HALL_2_EXT | mcu-sensors
R80 | 2 | ~ | GEN_HALL_2 | mcu-sensors
C60 | 1 | ~ | GEN_HALL_2 | mcu-sensors
C60 | 2 | ~ | PGND | mcu-sensors
R81 | 1 | ~ | GEN_HALL_3_EXT | mcu-sensors
R81 | 2 | ~ | LOGIC3V3_EXT | mcu-sensors
R82 | 1 | ~ | GEN_HALL_3_EXT | mcu-sensors
R82 | 2 | ~ | GEN_HALL_3 | mcu-sensors
C61 | 1 | ~ | GEN_HALL_3 | mcu-sensors
C61 | 2 | ~ | PGND | mcu-sensors
J10 | 1 | Pin_1 | LOGIC3V3_EXT | mcu-sensors
J10 | 2 | Pin_2 | PGND | mcu-sensors
J10 | 3 | Pin_3 | HUB_HALL_1_EXT | mcu-sensors
J10 | 4 | Pin_4 | HUB_HALL_2_EXT | mcu-sensors
J10 | 5 | Pin_5 | HUB_HALL_3_EXT | mcu-sensors
R83 | 1 | ~ | HUB_HALL_1_EXT | mcu-sensors
R83 | 2 | ~ | LOGIC3V3_EXT | mcu-sensors
R84 | 1 | ~ | HUB_HALL_1_EXT | mcu-sensors
R84 | 2 | ~ | HUB_HALL_1 | mcu-sensors
C62 | 1 | ~ | HUB_HALL_1 | mcu-sensors
C62 | 2 | ~ | PGND | mcu-sensors
R85 | 1 | ~ | HUB_HALL_2_EXT | mcu-sensors
R85 | 2 | ~ | LOGIC3V3_EXT | mcu-sensors
R86 | 1 | ~ | HUB_HALL_2_EXT | mcu-sensors
R86 | 2 | ~ | HUB_HALL_2 | mcu-sensors
C63 | 1 | ~ | HUB_HALL_2 | mcu-sensors
C63 | 2 | ~ | PGND | mcu-sensors
R87 | 1 | ~ | HUB_HALL_3_EXT | mcu-sensors
R87 | 2 | ~ | LOGIC3V3_EXT | mcu-sensors
R88 | 1 | ~ | HUB_HALL_3_EXT | mcu-sensors
R88 | 2 | ~ | HUB_HALL_3 | mcu-sensors
C64 | 1 | ~ | HUB_HALL_3 | mcu-sensors
C64 | 2 | ~ | PGND | mcu-sensors
J11 | 1 | Pin_1 | LOGIC3V3_EXT | mcu-sensors
J11 | 2 | Pin_2 | PGND | mcu-sensors
J11 | 3 | Pin_3 | ENC_A_EXT | mcu-sensors
J11 | 4 | Pin_4 | ENC_B_EXT | mcu-sensors
R89 | 1 | ~ | ENC_A_EXT | mcu-sensors
R89 | 2 | ~ | LOGIC3V3_EXT | mcu-sensors
R90 | 1 | ~ | ENC_A_EXT | mcu-sensors
R90 | 2 | ~ | ENC_A | mcu-sensors
C65 | 1 | ~ | ENC_A | mcu-sensors
C65 | 2 | ~ | PGND | mcu-sensors
R91 | 1 | ~ | ENC_B_EXT | mcu-sensors
R91 | 2 | ~ | LOGIC3V3_EXT | mcu-sensors
R92 | 1 | ~ | ENC_B_EXT | mcu-sensors
R92 | 2 | ~ | ENC_B | mcu-sensors
C66 | 1 | ~ | ENC_B | mcu-sensors
C66 | 2 | ~ | PGND | mcu-sensors
U18 | 1 | OUT1 | GEN_SOA_LO | gen-fast-oc
U18 | 2 | IN1- | GEN_SOA | gen-fast-oc
U18 | 3 | IN1+ | OC_LOW_REF | gen-fast-oc
U18 | 4 | GND | PGND | gen-fast-oc
U18 | 5 | IN2+ | GEN_SOA | gen-fast-oc
U18 | 6 | IN2- | OC_HIGH_REF | gen-fast-oc
U18 | 7 | OUT2 | GEN_SOA_HI | gen-fast-oc
U18 | 8 | VCC | LOGIC3V3_EXT | gen-fast-oc
C67 | 1 | ~ | LOGIC3V3_EXT | gen-fast-oc
C67 | 2 | ~ | PGND | gen-fast-oc
R93 | 1 | ~ | GEN_SOA | gen-fast-oc
R93 | 2 | ~ | PGND | gen-fast-oc
Q14 | 1 | G | GEN_SOA_LO | gen-fast-oc
Q14 | 3 | D | OC_OK | gen-fast-oc
Q14 | 2 | S | PGND | gen-fast-oc
R94 | 1 | ~ | GEN_SOA_LO | gen-fast-oc
R94 | 2 | ~ | PGND | gen-fast-oc
Q15 | 1 | G | GEN_SOA_HI | gen-fast-oc
Q15 | 3 | D | OC_OK | gen-fast-oc
Q15 | 2 | S | PGND | gen-fast-oc
R95 | 1 | ~ | GEN_SOA_HI | gen-fast-oc
R95 | 2 | ~ | PGND | gen-fast-oc
U19 | 1 | OUT1 | GEN_SOB_LO | gen-fast-oc
U19 | 2 | IN1- | GEN_SOB | gen-fast-oc
U19 | 3 | IN1+ | OC_LOW_REF | gen-fast-oc
U19 | 4 | GND | PGND | gen-fast-oc
U19 | 5 | IN2+ | GEN_SOB | gen-fast-oc
U19 | 6 | IN2- | OC_HIGH_REF | gen-fast-oc
U19 | 7 | OUT2 | GEN_SOB_HI | gen-fast-oc
U19 | 8 | VCC | LOGIC3V3_EXT | gen-fast-oc
C68 | 1 | ~ | LOGIC3V3_EXT | gen-fast-oc
C68 | 2 | ~ | PGND | gen-fast-oc
R96 | 1 | ~ | GEN_SOB | gen-fast-oc
R96 | 2 | ~ | PGND | gen-fast-oc
Q16 | 1 | G | GEN_SOB_LO | gen-fast-oc
Q16 | 3 | D | OC_OK | gen-fast-oc
Q16 | 2 | S | PGND | gen-fast-oc
R97 | 1 | ~ | GEN_SOB_LO | gen-fast-oc
R97 | 2 | ~ | PGND | gen-fast-oc
Q17 | 1 | G | GEN_SOB_HI | gen-fast-oc
Q17 | 3 | D | OC_OK | gen-fast-oc
Q17 | 2 | S | PGND | gen-fast-oc
R98 | 1 | ~ | GEN_SOB_HI | gen-fast-oc
R98 | 2 | ~ | PGND | gen-fast-oc
U20 | 1 | OUT1 | GEN_SOC_LO | gen-fast-oc
U20 | 2 | IN1- | GEN_SOC | gen-fast-oc
U20 | 3 | IN1+ | OC_LOW_REF | gen-fast-oc
U20 | 4 | GND | PGND | gen-fast-oc
U20 | 5 | IN2+ | GEN_SOC | gen-fast-oc
U20 | 6 | IN2- | OC_HIGH_REF | gen-fast-oc
U20 | 7 | OUT2 | GEN_SOC_HI | gen-fast-oc
U20 | 8 | VCC | LOGIC3V3_EXT | gen-fast-oc
C69 | 1 | ~ | LOGIC3V3_EXT | gen-fast-oc
C69 | 2 | ~ | PGND | gen-fast-oc
R99 | 1 | ~ | GEN_SOC | gen-fast-oc
R99 | 2 | ~ | PGND | gen-fast-oc
Q18 | 1 | G | GEN_SOC_LO | gen-fast-oc
Q18 | 3 | D | OC_OK | gen-fast-oc
Q18 | 2 | S | PGND | gen-fast-oc
R100 | 1 | ~ | GEN_SOC_LO | gen-fast-oc
R100 | 2 | ~ | PGND | gen-fast-oc
Q19 | 1 | G | GEN_SOC_HI | gen-fast-oc
Q19 | 3 | D | OC_OK | gen-fast-oc
Q19 | 2 | S | PGND | gen-fast-oc
R101 | 1 | ~ | GEN_SOC_HI | gen-fast-oc
R101 | 2 | ~ | PGND | gen-fast-oc
U21 | 1 | OUT1 | HUB_SOA_LO | hub-fast-oc
U21 | 2 | IN1- | HUB_SOA | hub-fast-oc
U21 | 3 | IN1+ | OC_LOW_REF | hub-fast-oc
U21 | 4 | GND | PGND | hub-fast-oc
U21 | 5 | IN2+ | HUB_SOA | hub-fast-oc
U21 | 6 | IN2- | OC_HIGH_REF | hub-fast-oc
U21 | 7 | OUT2 | HUB_SOA_HI | hub-fast-oc
U21 | 8 | VCC | LOGIC3V3_EXT | hub-fast-oc
C70 | 1 | ~ | LOGIC3V3_EXT | hub-fast-oc
C70 | 2 | ~ | PGND | hub-fast-oc
R102 | 1 | ~ | HUB_SOA | hub-fast-oc
R102 | 2 | ~ | PGND | hub-fast-oc
Q20 | 1 | G | HUB_SOA_LO | hub-fast-oc
Q20 | 3 | D | OC_OK | hub-fast-oc
Q20 | 2 | S | PGND | hub-fast-oc
R103 | 1 | ~ | HUB_SOA_LO | hub-fast-oc
R103 | 2 | ~ | PGND | hub-fast-oc
Q21 | 1 | G | HUB_SOA_HI | hub-fast-oc
Q21 | 3 | D | OC_OK | hub-fast-oc
Q21 | 2 | S | PGND | hub-fast-oc
R104 | 1 | ~ | HUB_SOA_HI | hub-fast-oc
R104 | 2 | ~ | PGND | hub-fast-oc
U22 | 1 | OUT1 | HUB_SOB_LO | hub-fast-oc
U22 | 2 | IN1- | HUB_SOB | hub-fast-oc
U22 | 3 | IN1+ | OC_LOW_REF | hub-fast-oc
U22 | 4 | GND | PGND | hub-fast-oc
U22 | 5 | IN2+ | HUB_SOB | hub-fast-oc
U22 | 6 | IN2- | OC_HIGH_REF | hub-fast-oc
U22 | 7 | OUT2 | HUB_SOB_HI | hub-fast-oc
U22 | 8 | VCC | LOGIC3V3_EXT | hub-fast-oc
C71 | 1 | ~ | LOGIC3V3_EXT | hub-fast-oc
C71 | 2 | ~ | PGND | hub-fast-oc
R105 | 1 | ~ | HUB_SOB | hub-fast-oc
R105 | 2 | ~ | PGND | hub-fast-oc
Q22 | 1 | G | HUB_SOB_LO | hub-fast-oc
Q22 | 3 | D | OC_OK | hub-fast-oc
Q22 | 2 | S | PGND | hub-fast-oc
R106 | 1 | ~ | HUB_SOB_LO | hub-fast-oc
R106 | 2 | ~ | PGND | hub-fast-oc
Q23 | 1 | G | HUB_SOB_HI | hub-fast-oc
Q23 | 3 | D | OC_OK | hub-fast-oc
Q23 | 2 | S | PGND | hub-fast-oc
R107 | 1 | ~ | HUB_SOB_HI | hub-fast-oc
R107 | 2 | ~ | PGND | hub-fast-oc
U23 | 1 | OUT1 | HUB_SOC_LO | hub-fast-oc
U23 | 2 | IN1- | HUB_SOC | hub-fast-oc
U23 | 3 | IN1+ | OC_LOW_REF | hub-fast-oc
U23 | 4 | GND | PGND | hub-fast-oc
U23 | 5 | IN2+ | HUB_SOC | hub-fast-oc
U23 | 6 | IN2- | OC_HIGH_REF | hub-fast-oc
U23 | 7 | OUT2 | HUB_SOC_HI | hub-fast-oc
U23 | 8 | VCC | LOGIC3V3_EXT | hub-fast-oc
C72 | 1 | ~ | LOGIC3V3_EXT | hub-fast-oc
C72 | 2 | ~ | PGND | hub-fast-oc
R108 | 1 | ~ | HUB_SOC | hub-fast-oc
R108 | 2 | ~ | PGND | hub-fast-oc
Q24 | 1 | G | HUB_SOC_LO | hub-fast-oc
Q24 | 3 | D | OC_OK | hub-fast-oc
Q24 | 2 | S | PGND | hub-fast-oc
R109 | 1 | ~ | HUB_SOC_LO | hub-fast-oc
R109 | 2 | ~ | PGND | hub-fast-oc
Q25 | 1 | G | HUB_SOC_HI | hub-fast-oc
Q25 | 3 | D | OC_OK | hub-fast-oc
Q25 | 2 | S | PGND | hub-fast-oc
R110 | 1 | ~ | HUB_SOC_HI | hub-fast-oc
R110 | 2 | ~ | PGND | hub-fast-oc
R111 | 1 | ~ | LOGIC3V3_EXT | fast-oc-reference
R111 | 2 | ~ | OC_LOW_REF | fast-oc-reference
R112 | 1 | ~ | OC_LOW_REF | fast-oc-reference
R112 | 2 | ~ | PGND | fast-oc-reference
R113 | 1 | ~ | LOGIC3V3_EXT | fast-oc-reference
R113 | 2 | ~ | OC_HIGH_REF | fast-oc-reference
R114 | 1 | ~ | OC_HIGH_REF | fast-oc-reference
R114 | 2 | ~ | PGND | fast-oc-reference
R115 | 1 | ~ | SAFETY3V3 | fast-oc-reference
R115 | 2 | ~ | OC_OK | fast-oc-reference
J40 | 1 | Pin_1 | SOURCE_POS | dc-entry
J40 | 2 | Pin_2 | PGND | dc-entry
F1 | 1 | ~ | SOURCE_POS | dc-entry
F1 | 2 | ~ | ENTRY_FUSED | dc-entry
R116 | 1 | ~ | PRECHARGE_R | dc-entry
R116 | 2 | ~ | BUS_SHUNT_HI | dc-entry
R117 | 1 | ~ | BUS_SHUNT_HI | dc-entry
R117 | 2 | ~ | DC_LINK | dc-entry
D20 | 1 | K | DC_LINK | dc-entry
D20 | 2 | A | PGND | dc-entry
C73 | 1 | ~ | DC_LINK | dc-entry
C73 | 2 | ~ | PGND | dc-entry
C74 | 1 | ~ | DC_LINK | dc-entry
C74 | 2 | ~ | PGND | dc-entry
R118 | 1 | ~ | DC_LINK | dc-entry
R118 | 2 | ~ | PGND | dc-entry
J43 | 1 | Pin_1 | BUS_SHUNT_HI | dc-entry
J43 | 2 | Pin_2 | DC_LINK | dc-entry
J43 | 3 | Pin_3 | DC_LINK | dc-entry
J43 | 4 | Pin_4 | PGND | dc-entry
J44 | 1 | Pin_1 | PGND | brake-intent-left
J44 | 2 | Pin_2 | LEFT_SWITCH_EXT | brake-intent-left
R119 | 1 | ~ | LEFT_SWITCH_EXT | brake-intent-left
R119 | 2 | ~ | LEFT_SWITCH_ADC | brake-intent-left
R120 | 1 | ~ | LEFT_SWITCH_EXT | brake-intent-left
R120 | 2 | ~ | LOGIC3V3_EXT | brake-intent-left
C75 | 1 | ~ | LEFT_SWITCH_ADC | brake-intent-left
C75 | 2 | ~ | PGND | brake-intent-left
D32 | 1 | A1 | LEFT_SWITCH_EXT | brake-intent-left
D32 | 2 | A2 | PGND | brake-intent-left
D36 | 1 | A | PGND | brake-intent-left
D36 | 3 | COM | LEFT_SWITCH_ADC | brake-intent-left
D36 | 2 | K | LOGIC3V3_EXT | brake-intent-left
J45 | 1 | Pin_1 | PGND | brake-intent-right
J45 | 2 | Pin_2 | RIGHT_SWITCH_EXT | brake-intent-right
R121 | 1 | ~ | RIGHT_SWITCH_EXT | brake-intent-right
R121 | 2 | ~ | RIGHT_SWITCH_ADC | brake-intent-right
R122 | 1 | ~ | RIGHT_SWITCH_EXT | brake-intent-right
R122 | 2 | ~ | LOGIC3V3_EXT | brake-intent-right
C76 | 1 | ~ | RIGHT_SWITCH_ADC | brake-intent-right
C76 | 2 | ~ | PGND | brake-intent-right
D33 | 1 | A1 | RIGHT_SWITCH_EXT | brake-intent-right
D33 | 2 | A2 | PGND | brake-intent-right
D37 | 1 | A | PGND | brake-intent-right
D37 | 3 | COM | RIGHT_SWITCH_ADC | brake-intent-right
D37 | 2 | K | LOGIC3V3_EXT | brake-intent-right
U24 | 1 | ~ | OV_CMD | brake-dump-command
U24 | 2 | ~ | BRAKE_DUMP_PERMITTED | brake-dump-command
U24 | 5 | VCC | SAFETY3V3 | brake-dump-command
U24 | 3 | GND | PGND | brake-dump-command
U24 | 4 | ~ | CHOP_CMD | brake-dump-command
U25 | 1 | ~ | BRAKE_DUMP_PWM | brake-dump-command
U25 | 2 | ~ | TIMER_BREAK_OK | brake-dump-command
U25 | 5 | VCC | SAFETY3V3 | brake-dump-command
U25 | 3 | GND | PGND | brake-dump-command
U25 | 4 | ~ | BRAKE_DUMP_PERMITTED | brake-dump-command
C77 | 1 | ~ | SAFETY3V3 | brake-dump-command
C77 | 2 | ~ | PGND | brake-dump-command
R123 | 1 | ~ | BRAKE_DUMP_PWM | brake-dump-command
R123 | 2 | ~ | PGND | brake-dump-command
C78 | 1 | ~ | SAFETY3V3 | brake-dump-command
C78 | 2 | ~ | PGND | brake-dump-command
R124 | 1 | ~ | LEFT_SWITCH_EXT | brake-switch-harness
R124 | 2 | ~ | LEFT_SWITCH_EOL | brake-switch-harness
R125 | 1 | ~ | LEFT_SWITCH_EOL | brake-switch-harness
R125 | 2 | ~ | PGND | brake-switch-harness
SW1 | 1 | A | LEFT_SWITCH_EOL | brake-switch-harness
SW1 | 2 | B | PGND | brake-switch-harness
R126 | 1 | ~ | RIGHT_SWITCH_EXT | brake-switch-harness
R126 | 2 | ~ | RIGHT_SWITCH_EOL | brake-switch-harness
R127 | 1 | ~ | RIGHT_SWITCH_EOL | brake-switch-harness
R127 | 2 | ~ | PGND | brake-switch-harness
SW2 | 1 | A | RIGHT_SWITCH_EOL | brake-switch-harness
SW2 | 2 | B | PGND | brake-switch-harness
J46 | 1 | Pin_1 | LEFT_FSR_EXC_CABLE | fsr-left
J46 | 2 | Pin_2 | LEFT_FSR_RETURN_CABLE | fsr-left
R128 | 1 | ~ | MCU_VREF | fsr-left
R128 | 2 | ~ | LEFT_FSR_EXC_CABLE | fsr-left
R129 | 1 | ~ | LEFT_FSR_RETURN_CABLE | fsr-left
R129 | 2 | ~ | LEFT_FSR_SENSE | fsr-left
R130 | 1 | ~ | LEFT_FSR_SENSE | fsr-left
R130 | 2 | ~ | PGND | fsr-left
C79 | 1 | ~ | LEFT_FSR_SENSE | fsr-left
C79 | 2 | ~ | PGND | fsr-left
R131 | 1 | ~ | LEFT_FSR_SENSE | fsr-left
R131 | 2 | ~ | LEFT_FSR_OP_IN | fsr-left
C80 | 1 | ~ | MCU_VREF | fsr-left
C80 | 2 | ~ | PGND | fsr-left
U26 | 1 | OUT | LEFT_FSR_BUF | fsr-left
U26 | 2 | V- | PGND | fsr-left
U26 | 3 | +IN | LEFT_FSR_OP_IN | fsr-left
U26 | 4 | -IN | LEFT_FSR_BUF | fsr-left
U26 | 5 | V+ | MCU_VREF | fsr-left
U27 | 1 | SEL1 | FSR_SAMPLE_ENABLE | fsr-left
U27 | 2 | S1 | LEFT_FSR_BUF | fsr-left
U27 | 3 | D1 | LEFT_FSR_ISO_OUT | fsr-left
U27 | 4 | SEL2 | PGND | fsr-left
U27 | 7 | GND | PGND | fsr-left
U27 | 10 | SEL3 | PGND | fsr-left
U27 | 13 | SEL4 | PGND | fsr-left
U27 | 14 | VDD | LOGIC3V3_EXT | fsr-left
R132 | 1 | ~ | LEFT_FSR_ISO_OUT | fsr-left
R132 | 2 | ~ | LEFT_FSR_ADC | fsr-left
R133 | 1 | ~ | LEFT_FSR_ADC | fsr-left
R133 | 2 | ~ | PGND | fsr-left
C81 | 1 | ~ | LEFT_FSR_ADC | fsr-left
C81 | 2 | ~ | PGND | fsr-left
R134 | 1 | ~ | FSR_SAMPLE_ENABLE | fsr-left
R134 | 2 | ~ | PGND | fsr-left
C82 | 1 | ~ | LOGIC3V3_EXT | fsr-left
C82 | 2 | ~ | PGND | fsr-left
D38 | 1 | A1 | LEFT_FSR_EXC_CABLE | fsr-protection-left
D38 | 2 | A2 | PGND | fsr-protection-left
D39 | 1 | A1 | LEFT_FSR_RETURN_CABLE | fsr-protection-left
D39 | 2 | A2 | PGND | fsr-protection-left
D40 | 1 | A | PGND | fsr-protection-left
D40 | 3 | COM | LEFT_FSR_SENSE | fsr-protection-left
D40 | 2 | K | MCU_VREF | fsr-protection-left
J47 | 1 | Pin_1 | RIGHT_FSR_EXC_CABLE | fsr-right
J47 | 2 | Pin_2 | RIGHT_FSR_RETURN_CABLE | fsr-right
R135 | 1 | ~ | MCU_VREF | fsr-right
R135 | 2 | ~ | RIGHT_FSR_EXC_CABLE | fsr-right
R136 | 1 | ~ | RIGHT_FSR_RETURN_CABLE | fsr-right
R136 | 2 | ~ | RIGHT_FSR_SENSE | fsr-right
R137 | 1 | ~ | RIGHT_FSR_SENSE | fsr-right
R137 | 2 | ~ | PGND | fsr-right
C83 | 1 | ~ | RIGHT_FSR_SENSE | fsr-right
C83 | 2 | ~ | PGND | fsr-right
R138 | 1 | ~ | RIGHT_FSR_SENSE | fsr-right
R138 | 2 | ~ | RIGHT_FSR_OP_IN | fsr-right
C84 | 1 | ~ | MCU_VREF | fsr-right
C84 | 2 | ~ | PGND | fsr-right
U28 | 1 | OUT | RIGHT_FSR_BUF | fsr-right
U28 | 2 | V- | PGND | fsr-right
U28 | 3 | +IN | RIGHT_FSR_OP_IN | fsr-right
U28 | 4 | -IN | RIGHT_FSR_BUF | fsr-right
U28 | 5 | V+ | MCU_VREF | fsr-right
U29 | 1 | SEL1 | FSR_SAMPLE_ENABLE | fsr-right
U29 | 2 | S1 | RIGHT_FSR_BUF | fsr-right
U29 | 3 | D1 | RIGHT_FSR_ISO_OUT | fsr-right
U29 | 4 | SEL2 | PGND | fsr-right
U29 | 7 | GND | PGND | fsr-right
U29 | 10 | SEL3 | PGND | fsr-right
U29 | 13 | SEL4 | PGND | fsr-right
U29 | 14 | VDD | LOGIC3V3_EXT | fsr-right
R139 | 1 | ~ | RIGHT_FSR_ISO_OUT | fsr-right
R139 | 2 | ~ | RIGHT_FSR_ADC | fsr-right
R140 | 1 | ~ | RIGHT_FSR_ADC | fsr-right
R140 | 2 | ~ | PGND | fsr-right
C85 | 1 | ~ | RIGHT_FSR_ADC | fsr-right
C85 | 2 | ~ | PGND | fsr-right
R141 | 1 | ~ | FSR_SAMPLE_ENABLE | fsr-right
R141 | 2 | ~ | PGND | fsr-right
C86 | 1 | ~ | LOGIC3V3_EXT | fsr-right
C86 | 2 | ~ | PGND | fsr-right
D41 | 1 | A1 | RIGHT_FSR_EXC_CABLE | fsr-protection-right
D41 | 2 | A2 | PGND | fsr-protection-right
D42 | 1 | A1 | RIGHT_FSR_RETURN_CABLE | fsr-protection-right
D42 | 2 | A2 | PGND | fsr-protection-right
D43 | 1 | A | PGND | fsr-protection-right
D43 | 3 | COM | RIGHT_FSR_SENSE | fsr-protection-right
D43 | 2 | K | MCU_VREF | fsr-protection-right
U400 | 1 | EN | MAIN_EN | entry-main
U400 | 2 | PXFR | MAIN_PXFR | entry-main
U400 | 3 | VDDP | CTRL3V3 | entry-main
U400 | 4 | VSSP | PGND | entry-main
U400 | 5 | VSSS | MAIN_SOURCE | entry-main
U400 | 6 | VDDM | MAIN_VDDM | entry-main
U400 | 7 | VDDH | MAIN_VDDH | entry-main
U400 | 8 | VDRV | MAIN_VDRV | entry-main
R400 | 1 | ~ | MAIN_PXFR | entry-main
R400 | 2 | ~ | PGND | entry-main
R401 | 1 | ~ | MAIN_EN | entry-main
R401 | 2 | ~ | PGND | entry-main
R402 | 1 | ~ | MAIN_EN | entry-main
R402 | 2 | ~ | PGND | entry-main
C400 | 1 | ~ | CTRL3V3 | entry-main
C400 | 2 | ~ | PGND | entry-main
C401 | 1 | ~ | MAIN_VDDH | entry-main
C401 | 2 | ~ | MAIN_VDDM | entry-main
C402 | 1 | ~ | MAIN_VDDM | entry-main
C402 | 2 | ~ | MAIN_SOURCE | entry-main
Q400 | 1 | G | Q400_GATE | entry-main
Q400 | 2 | D | ENTRY_FUSED | entry-main
Q400 | 3 | S | MAIN_SOURCE | entry-main
R403 | 1 | ~ | MAIN_VDRV | entry-main
R403 | 2 | ~ | Q400_GATE | entry-main
R404 | 1 | ~ | Q400_GATE | entry-main
R404 | 2 | ~ | MAIN_SOURCE | entry-main
Q401 | 1 | G | Q401_GATE | entry-main
Q401 | 2 | D | BUS_SHUNT_HI | entry-main
Q401 | 3 | S | MAIN_SOURCE | entry-main
R405 | 1 | ~ | MAIN_VDRV | entry-main
R405 | 2 | ~ | Q401_GATE | entry-main
R406 | 1 | ~ | Q401_GATE | entry-main
R406 | 2 | ~ | MAIN_SOURCE | entry-main
U401 | 1 | EN | PRE_EN | entry-pre
U401 | 2 | PXFR | PRE_PXFR | entry-pre
U401 | 3 | VDDP | CTRL3V3 | entry-pre
U401 | 4 | VSSP | PGND | entry-pre
U401 | 5 | VSSS | PRE_SOURCE | entry-pre
U401 | 6 | VDDM | PRE_VDDM | entry-pre
U401 | 7 | VDDH | PRE_VDDH | entry-pre
U401 | 8 | VDRV | PRE_VDRV | entry-pre
R410 | 1 | ~ | PRE_PXFR | entry-pre
R410 | 2 | ~ | PGND | entry-pre
R411 | 1 | ~ | PRE_EN | entry-pre
R411 | 2 | ~ | PGND | entry-pre
R412 | 1 | ~ | PRE_EN | entry-pre
R412 | 2 | ~ | PGND | entry-pre
C410 | 1 | ~ | CTRL3V3 | entry-pre
C410 | 2 | ~ | PGND | entry-pre
C411 | 1 | ~ | PRE_VDDH | entry-pre
C411 | 2 | ~ | PRE_VDDM | entry-pre
C412 | 1 | ~ | PRE_VDDM | entry-pre
C412 | 2 | ~ | PRE_SOURCE | entry-pre
Q402 | 1 | G | Q402_GATE | entry-pre
Q402 | 2 | D | ENTRY_FUSED | entry-pre
Q402 | 3 | S | PRE_SOURCE | entry-pre
R413 | 1 | ~ | PRE_VDRV | entry-pre
R413 | 2 | ~ | Q402_GATE | entry-pre
R414 | 1 | ~ | Q402_GATE | entry-pre
R414 | 2 | ~ | PRE_SOURCE | entry-pre
Q403 | 1 | G | Q403_GATE | entry-pre
Q403 | 2 | D | PRECHARGE_R | entry-pre
Q403 | 3 | S | PRE_SOURCE | entry-pre
R415 | 1 | ~ | PRE_VDRV | entry-pre
R415 | 2 | ~ | Q403_GATE | entry-pre
R416 | 1 | ~ | Q403_GATE | entry-pre
R416 | 2 | ~ | PRE_SOURCE | entry-pre
U500 | 1 | GND | PGND | ctrl-supply
U500 | 2 | VIN | CTRL_RAW | ctrl-supply
U500 | 3 | EN_UVLO | CTRL_UVLO | ctrl-supply
U500 | 4 | RON | CTRL_RON | ctrl-supply
U500 | 5 | FB | CTRL_FB | ctrl-supply
U500 | 6 | PGOOD | CTRL_PG | ctrl-supply
U500 | 7 | BST | CTRL_BST | ctrl-supply
U500 | 8 | SW | CTRL_SW | ctrl-supply
U500 | 9 | EP | PGND | ctrl-supply
D500 | 1 | K | CTRL_RAW | ctrl-supply
D500 | 2 | A | ENTRY_FUSED | ctrl-supply
L500 | 1 | 1 | CTRL_SW | ctrl-supply
L500 | 2 | 2 | CTRL3V3 | ctrl-supply
C500 | 1 | ~ | CTRL_RAW | ctrl-supply
C500 | 2 | ~ | PGND | ctrl-supply
C501 | 1 | ~ | CTRL_RAW | ctrl-supply
C501 | 2 | ~ | PGND | ctrl-supply
C502 | 1 | ~ | CTRL_BST | ctrl-supply
C502 | 2 | ~ | CTRL_SW | ctrl-supply
C503 | 1 | ~ | CTRL3V3 | ctrl-supply
C503 | 2 | ~ | PGND | ctrl-supply
C504 | 1 | ~ | CTRL3V3 | ctrl-supply
C504 | 2 | ~ | PGND | ctrl-supply
C505 | 1 | ~ | CTRL_RAMP | ctrl-supply
C505 | 2 | ~ | CTRL3V3 | ctrl-supply
C506 | 1 | ~ | CTRL_RAMP | ctrl-supply
C506 | 2 | ~ | CTRL_FB | ctrl-supply
R500 | 1 | ~ | CTRL_RON | ctrl-supply
R500 | 2 | ~ | PGND | ctrl-supply
R501 | 1 | ~ | CTRL3V3 | ctrl-supply
R501 | 2 | ~ | CTRL_FB | ctrl-supply
R502 | 1 | ~ | CTRL_FB | ctrl-supply
R502 | 2 | ~ | PGND | ctrl-supply
R503 | 1 | ~ | CTRL_SW | ctrl-supply
R503 | 2 | ~ | CTRL_RAMP | ctrl-supply
R504 | 1 | ~ | CTRL_RAW | ctrl-supply
R504 | 2 | ~ | CTRL_UVLO | ctrl-supply
R505 | 1 | ~ | CTRL_UVLO | ctrl-supply
R505 | 2 | ~ | PGND | ctrl-supply
U510 | 1 | ~ | CTRL_PG | rail-partition
U510 | 2 | ~ | MAIN_PROVEN_IN | rail-partition
U510 | 5 | VCC | SAFETY3V3 | rail-partition
U510 | 3 | GND | PGND | rail-partition
U510 | 4 | ~ | DRIVE_EN | rail-partition
U501 | 1 | GND | PGND | rail-partition
U501 | 2 | VIN | DC_LINK | rail-partition
U501 | 3 | EN_UVLO | DRIVE_UVLO | rail-partition
U501 | 4 | RON | DRIVE_RON | rail-partition
U501 | 5 | FB | DRIVE_FB | rail-partition
U501 | 6 | PGOOD | DRIVE_PG | rail-partition
U501 | 7 | BST | DRIVE_BST | rail-partition
U501 | 8 | SW | DRIVE_SW | rail-partition
U501 | 9 | EP | PGND | rail-partition
U503 | 1 | IN+ | REF2V5 | rail-partition
U503 | 2 | V- | PGND | rail-partition
U503 | 3 | IN- | DRIVE_OV_SENSE | rail-partition
U503 | 4 | OUT | DRIVE_OV_TRIP | rail-partition
U503 | 5 | V+ | SINK12 | rail-partition
U504 | 1 | CLK | DRIVE_EN | rail-partition
U504 | 2 | D | DRIVE_LATCH_D | rail-partition
U504 | 3 | Q_N | DRIVE_NQ | rail-partition
U504 | 4 | GND | PGND | rail-partition
U504 | 5 | Q | DRIVE_EN_GATED | rail-partition
U504 | 6 | CLR_N | DRIVE_FAULT | rail-partition
U504 | 7 | PRE_N | SAFETY3V3 | rail-partition
U504 | 8 | VCC | SAFETY3V3 | rail-partition
U505 | 1 | ~ | DRIVE_EN_GATED | rail-partition
U505 | 2 | ~ | DRIVE_PG | rail-partition
U505 | 5 | VCC | SAFETY3V3 | rail-partition
U505 | 3 | GND | PGND | rail-partition
U505 | 4 | ~ | DRIVE_FAULT | rail-partition
U502 | 1 | FB | LOGIC3V3_EXT | rail-partition
U502 | 2 | EN | MCU3V3_EN | rail-partition
U502 | 3 | VIN | DRIVE12 | rail-partition
U502 | 4 | GND | PGND | rail-partition
U502 | 5 | SW | MCU_SW | rail-partition
U502 | 6 | BST | MCU_BST | rail-partition
L501 | 1 | 1 | DRIVE_SW | rail-passives
L501 | 2 | 2 | DRIVE12 | rail-passives
L502 | 1 | 1 | MCU_SW | rail-passives
L502 | 2 | 2 | LOGIC3V3_EXT | rail-passives
C510 | 1 | ~ | DC_LINK | rail-passives
C510 | 2 | ~ | PGND | rail-passives
C511 | 1 | ~ | DC_LINK | rail-passives
C511 | 2 | ~ | PGND | rail-passives
C512 | 1 | ~ | DRIVE_BST | rail-passives
C512 | 2 | ~ | DRIVE_SW | rail-passives
C513 | 1 | ~ | DRIVE12 | rail-passives
C513 | 2 | ~ | PGND | rail-passives
C514 | 1 | ~ | DRIVE12 | rail-passives
C514 | 2 | ~ | PGND | rail-passives
C515 | 1 | ~ | DRIVE_RAMP | rail-passives
C515 | 2 | ~ | DRIVE12 | rail-passives
C516 | 1 | ~ | DRIVE_RAMP | rail-passives
C516 | 2 | ~ | DRIVE_FB | rail-passives
C517 | 1 | ~ | DRIVE12 | rail-passives
C517 | 2 | ~ | PGND | rail-passives
C518 | 1 | ~ | LOGIC3V3_EXT | rail-passives
C518 | 2 | ~ | PGND | rail-passives
C519 | 1 | ~ | LOGIC3V3_EXT | rail-passives
C519 | 2 | ~ | PGND | rail-passives
C520 | 1 | ~ | MCU_BST | rail-passives
C520 | 2 | ~ | MCU_SW | rail-passives
C521 | 1 | ~ | SAFETY3V3 | rail-passives
C521 | 2 | ~ | PGND | rail-passives
R510 | 1 | ~ | DRIVE_RON | rail-passives
R510 | 2 | ~ | PGND | rail-passives
R511 | 1 | ~ | DRIVE12 | rail-passives
R511 | 2 | ~ | DRIVE_FB | rail-passives
R512 | 1 | ~ | DRIVE_FB | rail-passives
R512 | 2 | ~ | PGND | rail-passives
R513 | 1 | ~ | DRIVE_SW | rail-passives
R513 | 2 | ~ | DRIVE_RAMP | rail-passives
R514 | 1 | ~ | DRIVE_EN_GATED | rail-passives
R514 | 2 | ~ | DRIVE_UVLO | rail-passives
R515 | 1 | ~ | DRIVE_UVLO | rail-passives
R515 | 2 | ~ | PGND | rail-passives
R516 | 1 | ~ | DRIVE_EN | rail-passives
R516 | 2 | ~ | MCU3V3_EN | rail-passives
R517 | 1 | ~ | MCU3V3_EN | rail-passives
R517 | 2 | ~ | PGND | rail-passives
R518 | 1 | ~ | MAIN_PROVEN_IN | rail-passives
R518 | 2 | ~ | PGND | rail-passives
R519 | 1 | ~ | MAIN_PROVEN_IN | rail-passives
R519 | 2 | ~ | PGND | rail-passives
R520 | 1 | ~ | CTRL3V3 | rail-passives
R520 | 2 | ~ | CTRL_PG | rail-passives
R521 | 1 | ~ | SINK12 | rail-passives
R521 | 2 | ~ | DRIVE_PG | rail-passives
R523 | 1 | ~ | DRIVE12 | rail-passives
R523 | 2 | ~ | DRIVE_OV_SENSE | rail-passives
R524 | 1 | ~ | DRIVE_OV_SENSE | rail-passives
R524 | 2 | ~ | PGND | rail-passives
C523 | 1 | ~ | DRIVE_OV_SENSE | rail-passives
C523 | 2 | ~ | PGND | rail-passives
R525 | 1 | ~ | DRIVE_LATCH_D | rail-passives
R525 | 2 | ~ | PGND | rail-passives
R526 | 1 | ~ | SAFETY3V3 | rail-passives
R526 | 2 | ~ | DRIVE_FAULT | rail-passives
R527 | 1 | ~ | DRIVE_FAULT | rail-passives
R527 | 2 | ~ | DRIVE_RESET_SW | rail-passives
R528 | 1 | ~ | DRIVE_NQ | rail-passives
R528 | 2 | ~ | PGND | rail-passives
D520 | 1 | K | DRIVE_OV_TRIP | rail-passives
D520 | 2 | A | DRIVE_FAULT | rail-passives
D521 | 1 | K | DRIVE_PG | rail-passives
D521 | 2 | A | DRIVE_FAULT | rail-passives
D522 | 1 | K | DRIVE_RESET_SW | rail-passives
D522 | 2 | A | DRIVE_FAULT | rail-passives
J48 | 1 | Pin_1 | DRIVE_RESET_SW | rail-passives
J48 | 2 | Pin_2 | PGND | rail-passives
