felixfelix-bot/cycle-without-chain/hardware/powerboard-reva/exports/powerboard-reva.pdf

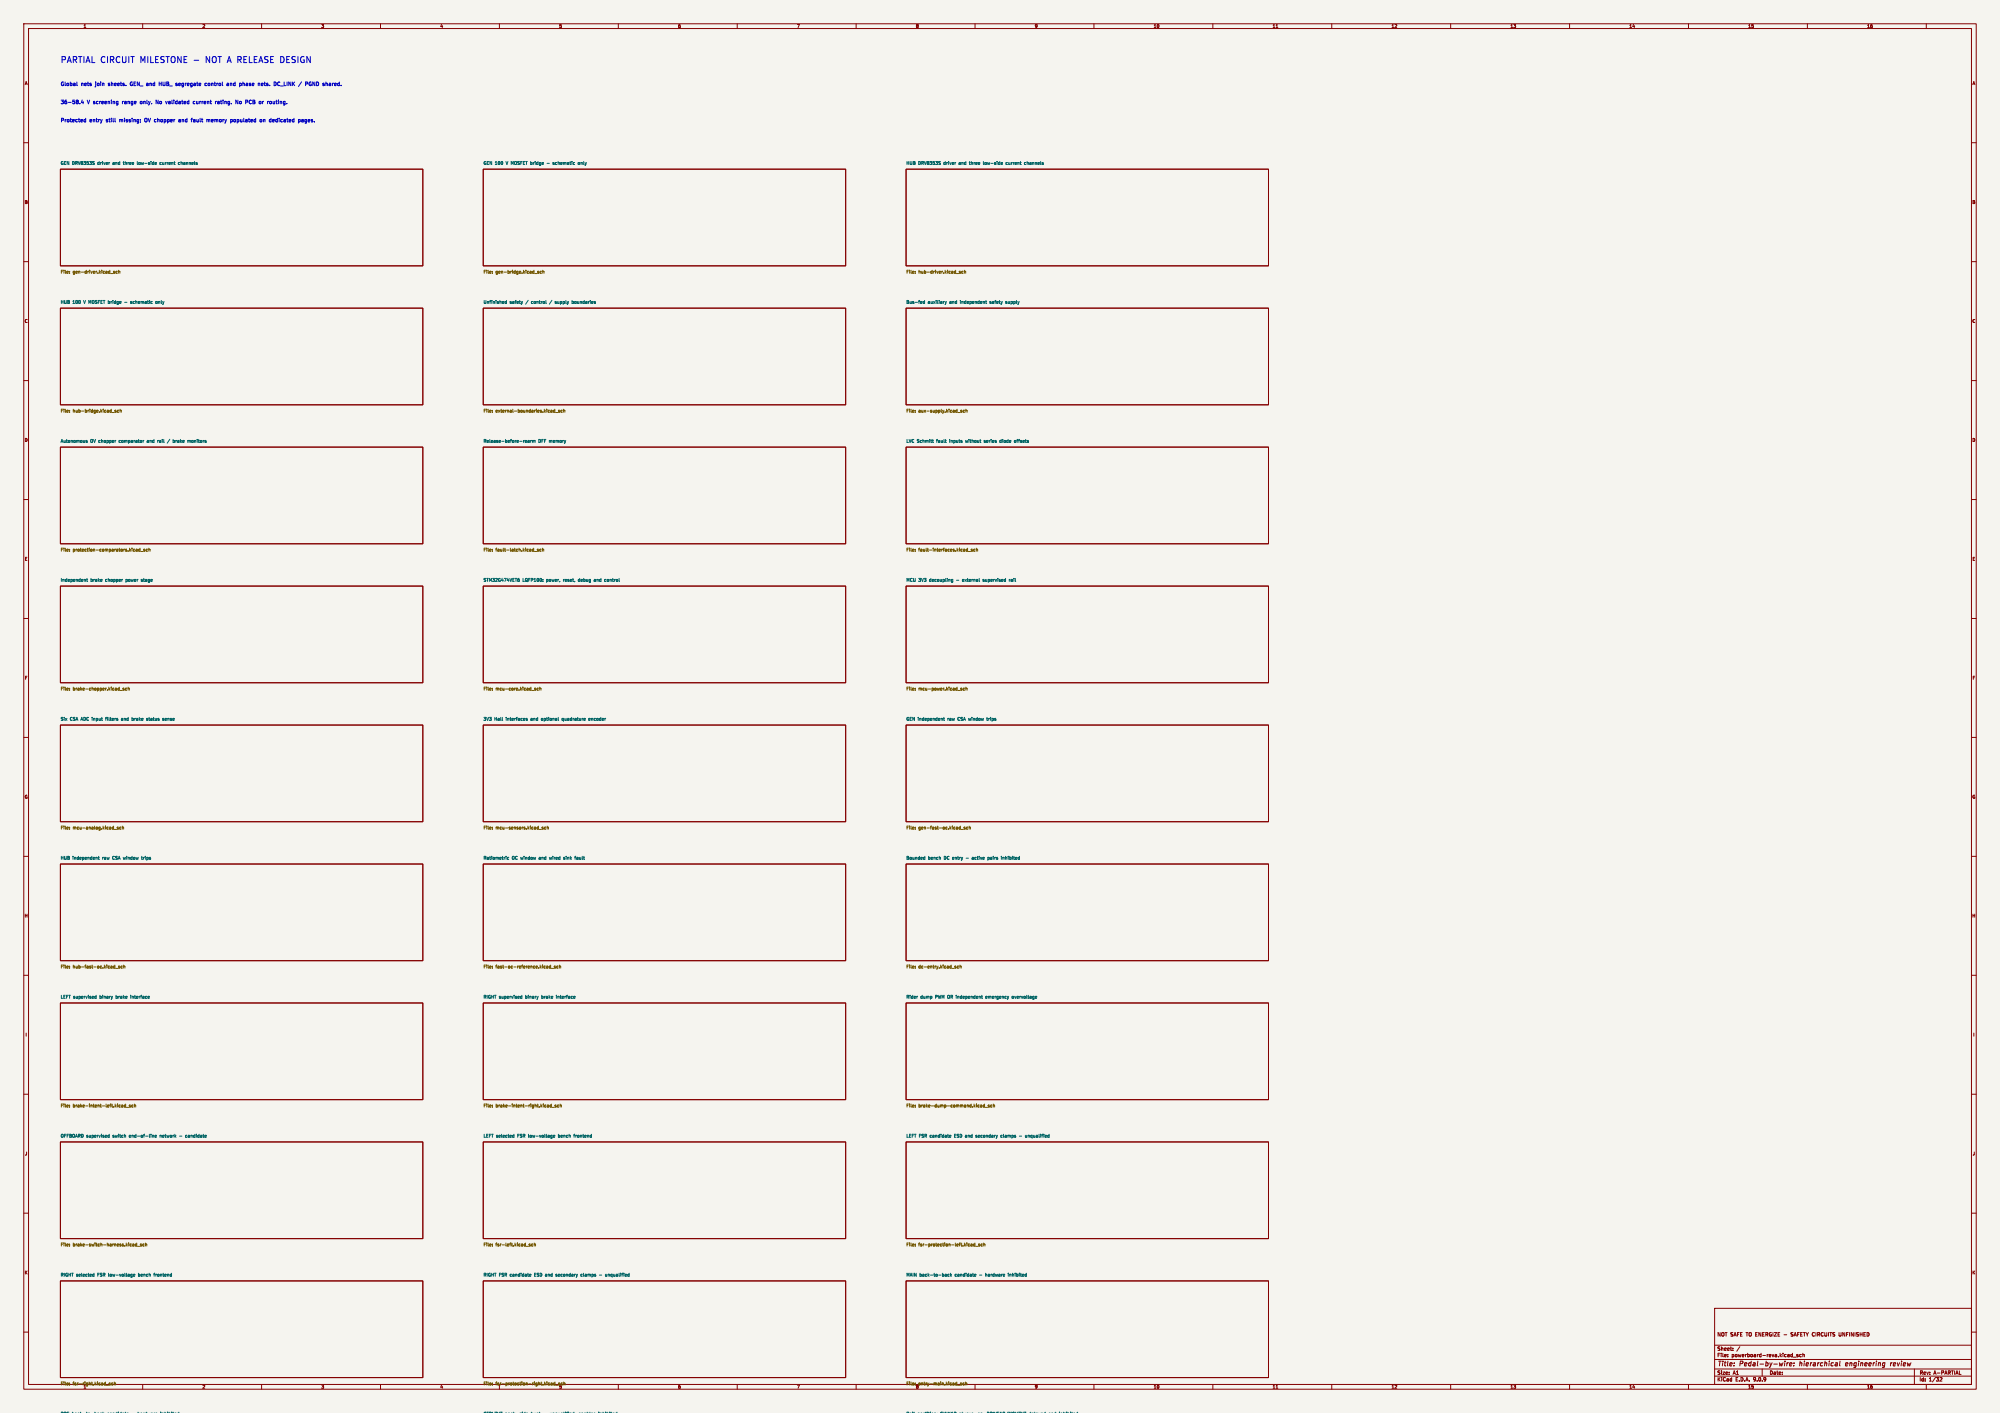
[picture p5: page 1]

PARTIAL CIRCUIT MILESTONE - NOT A RELEASE DESIGN

STM32G474VET6 LQFP100: power, reset, debug and control File: mcu-core.kicad_sch

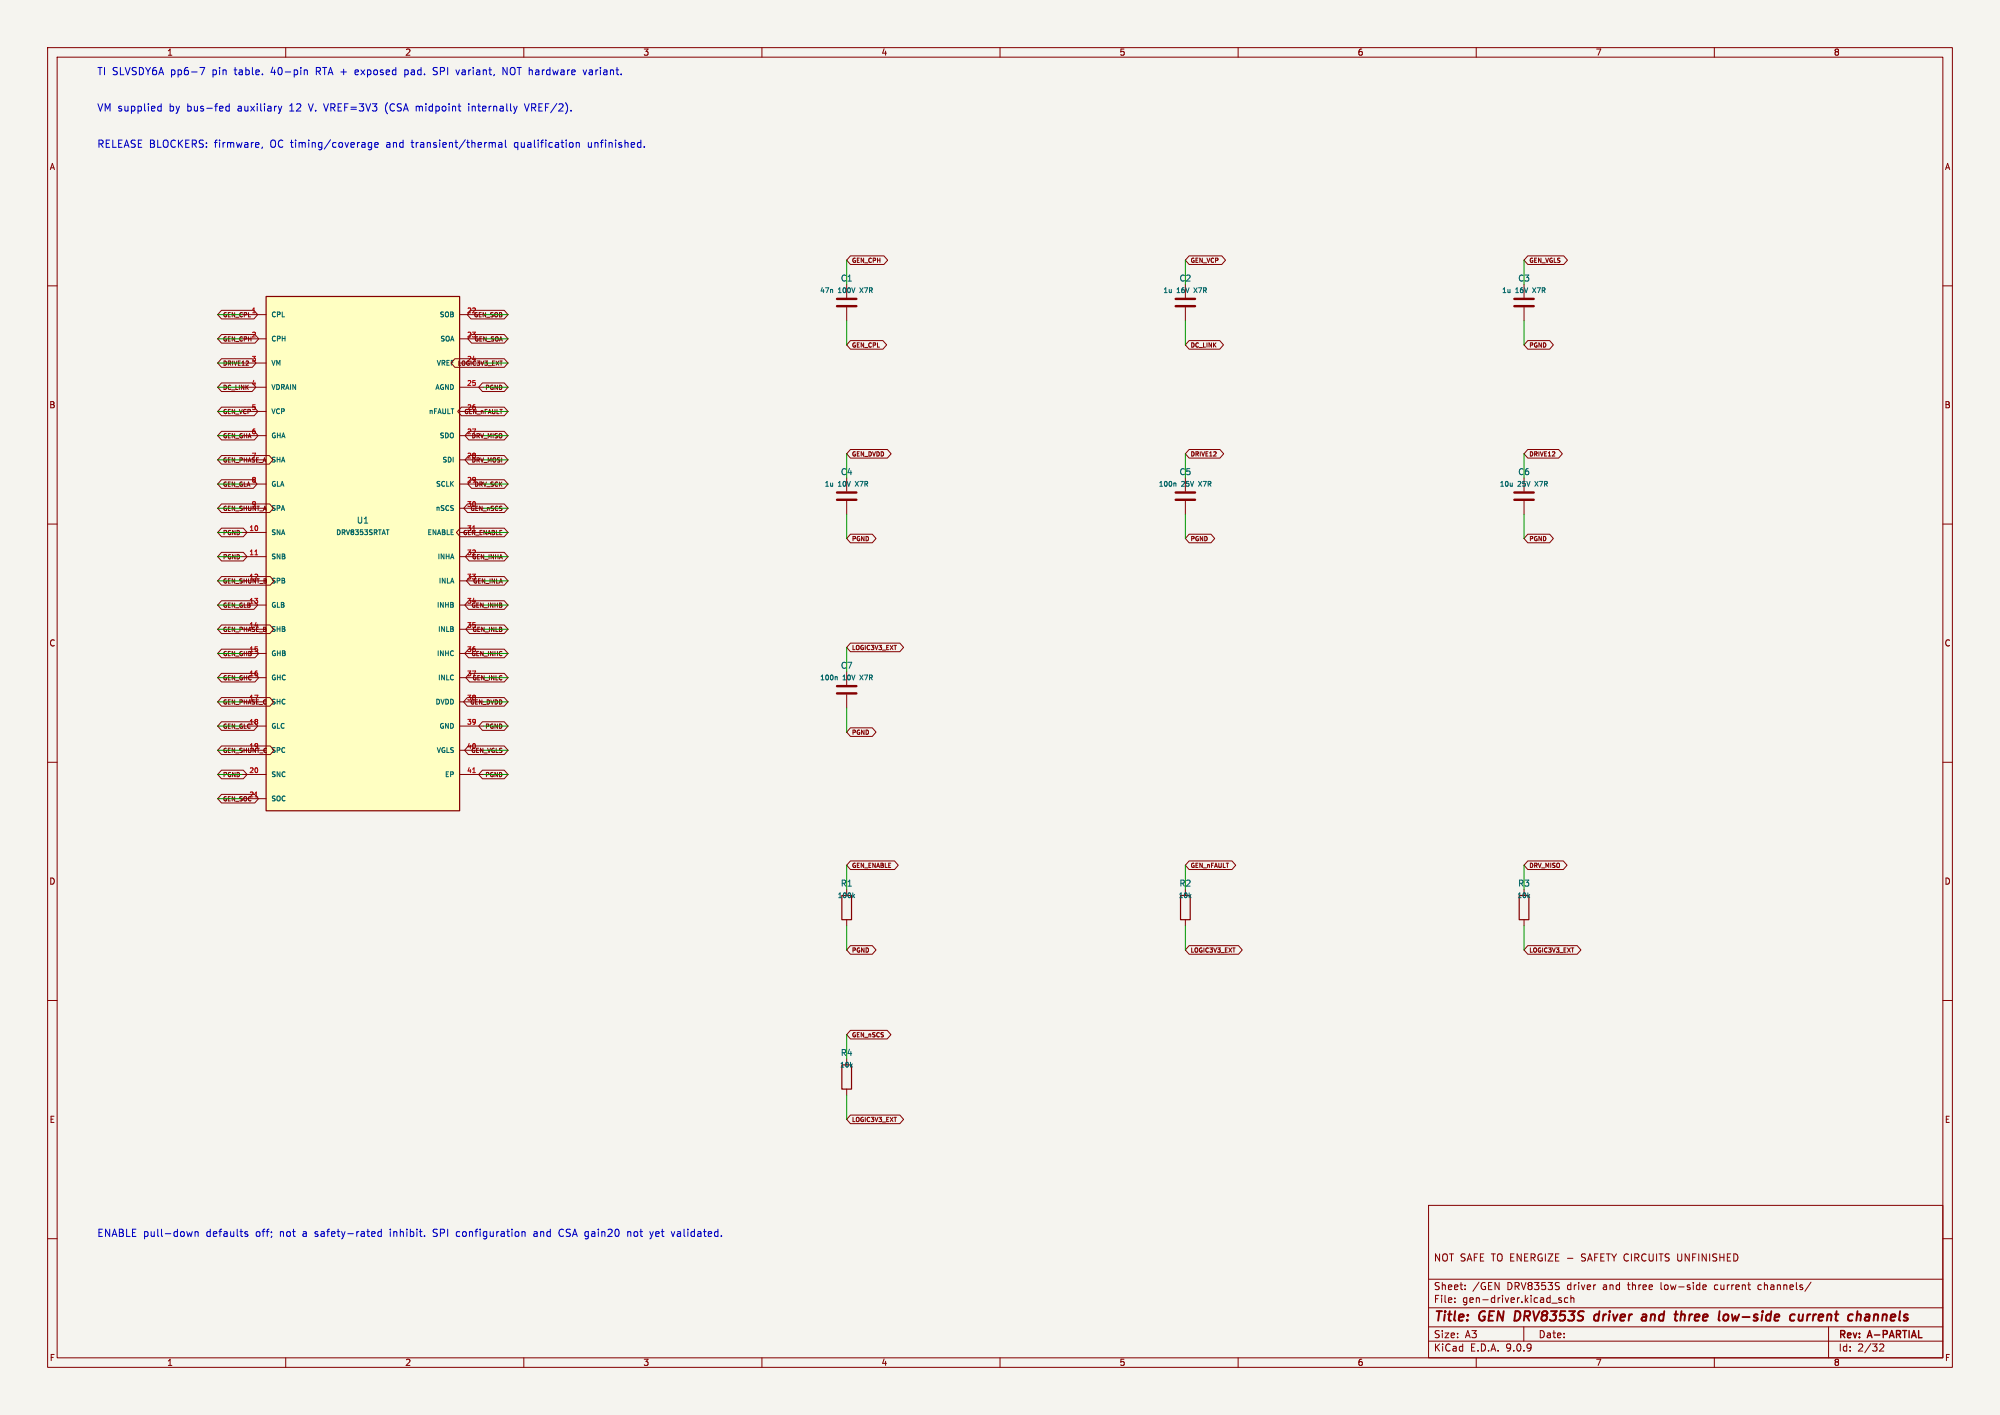
[picture p6: page 2]

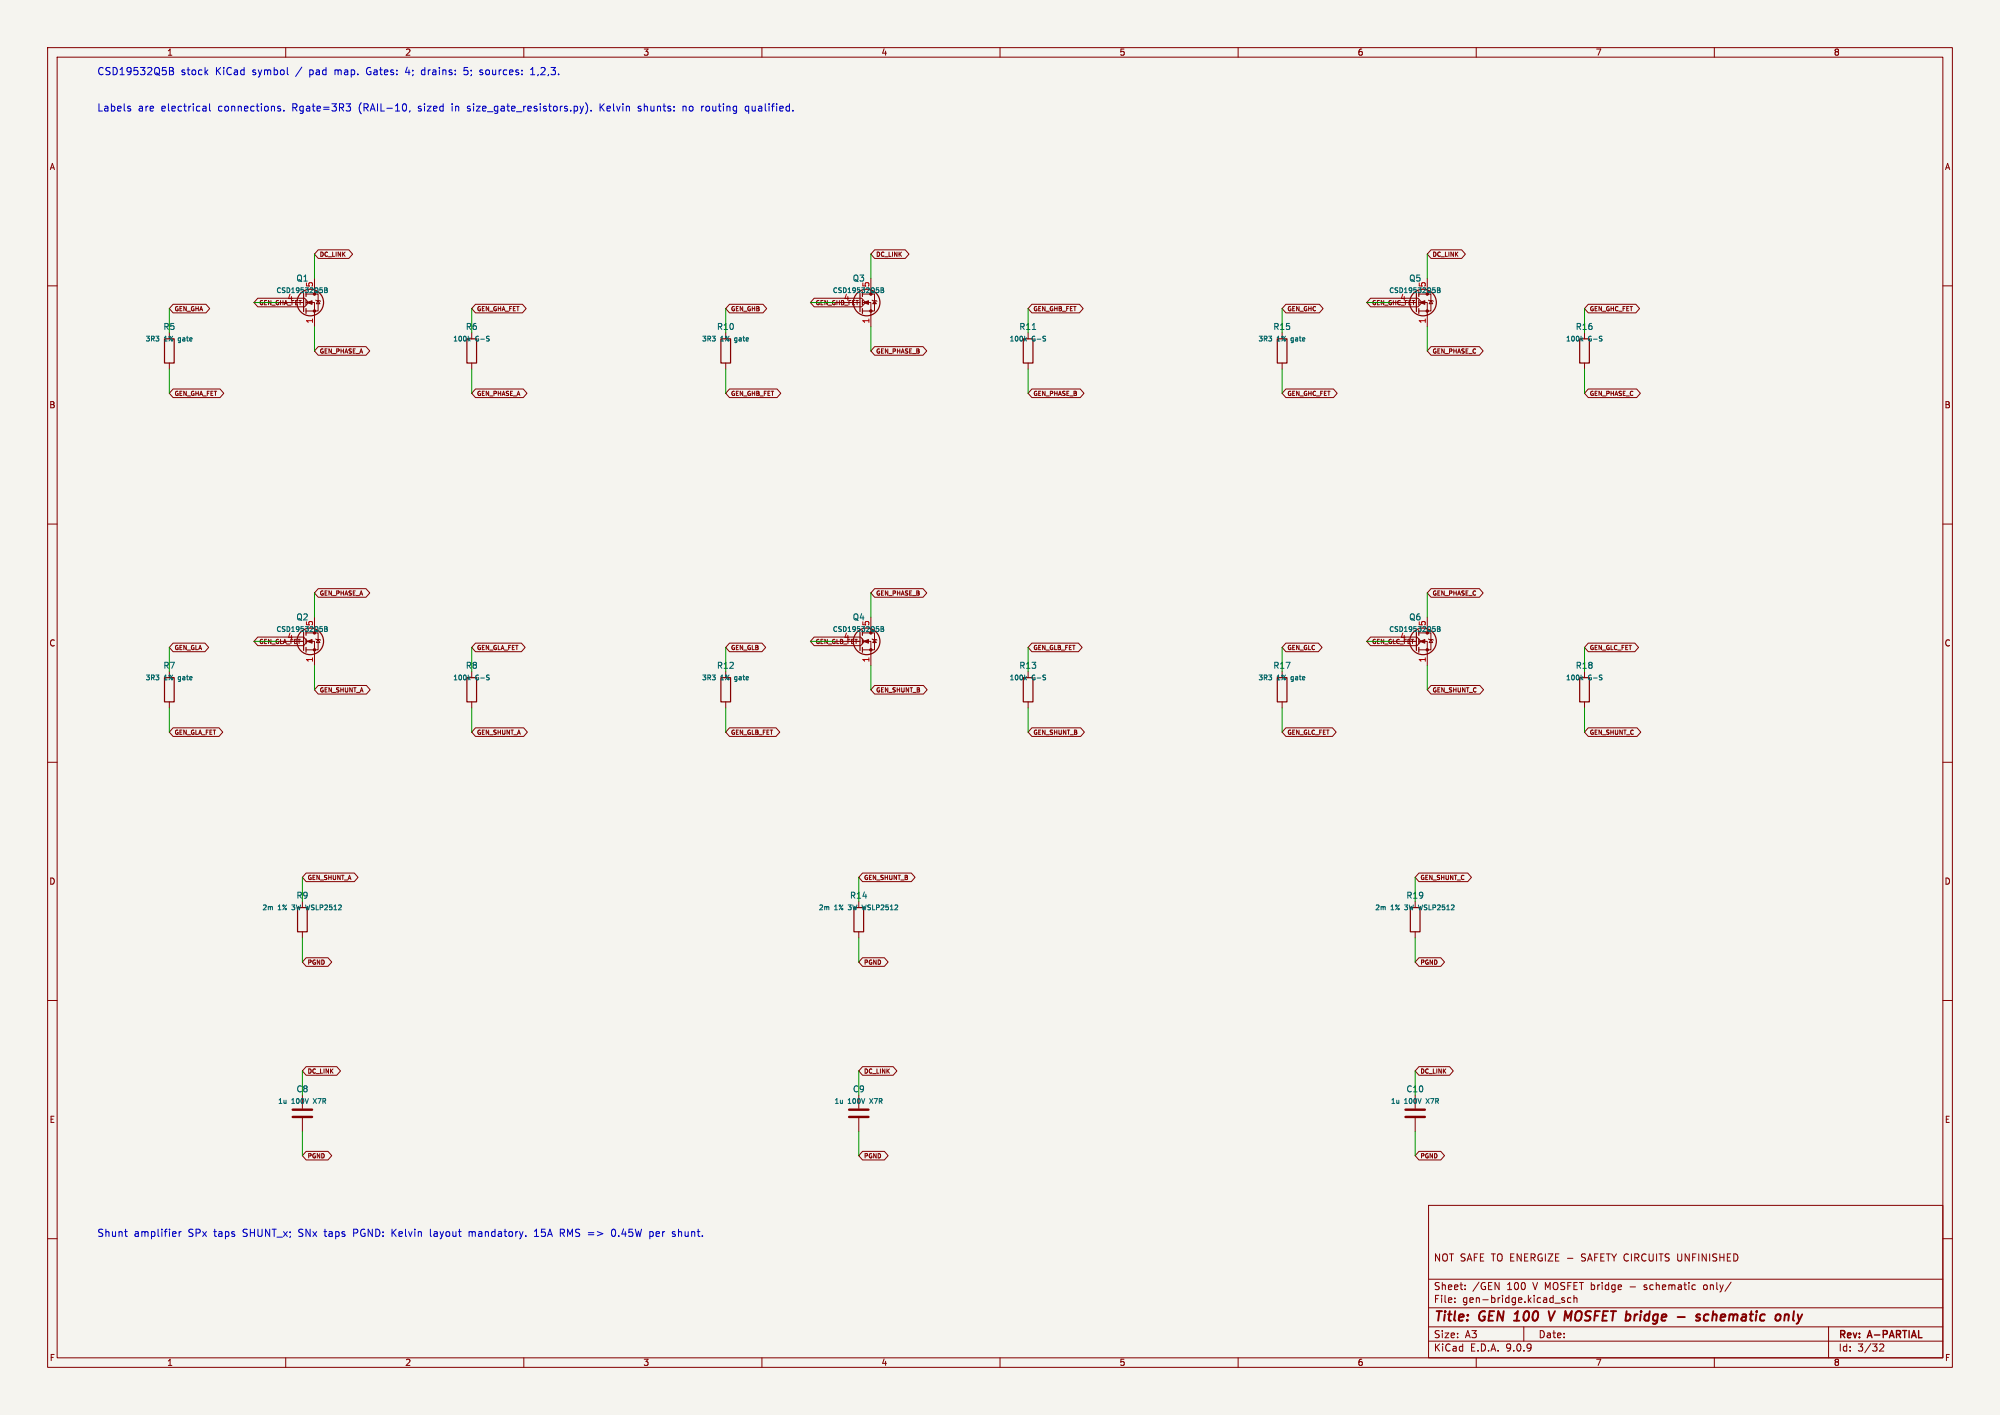
[picture p7: page 3]

Id: 3/32 Title: GEN 100 V MOSFET bridge - schematic only

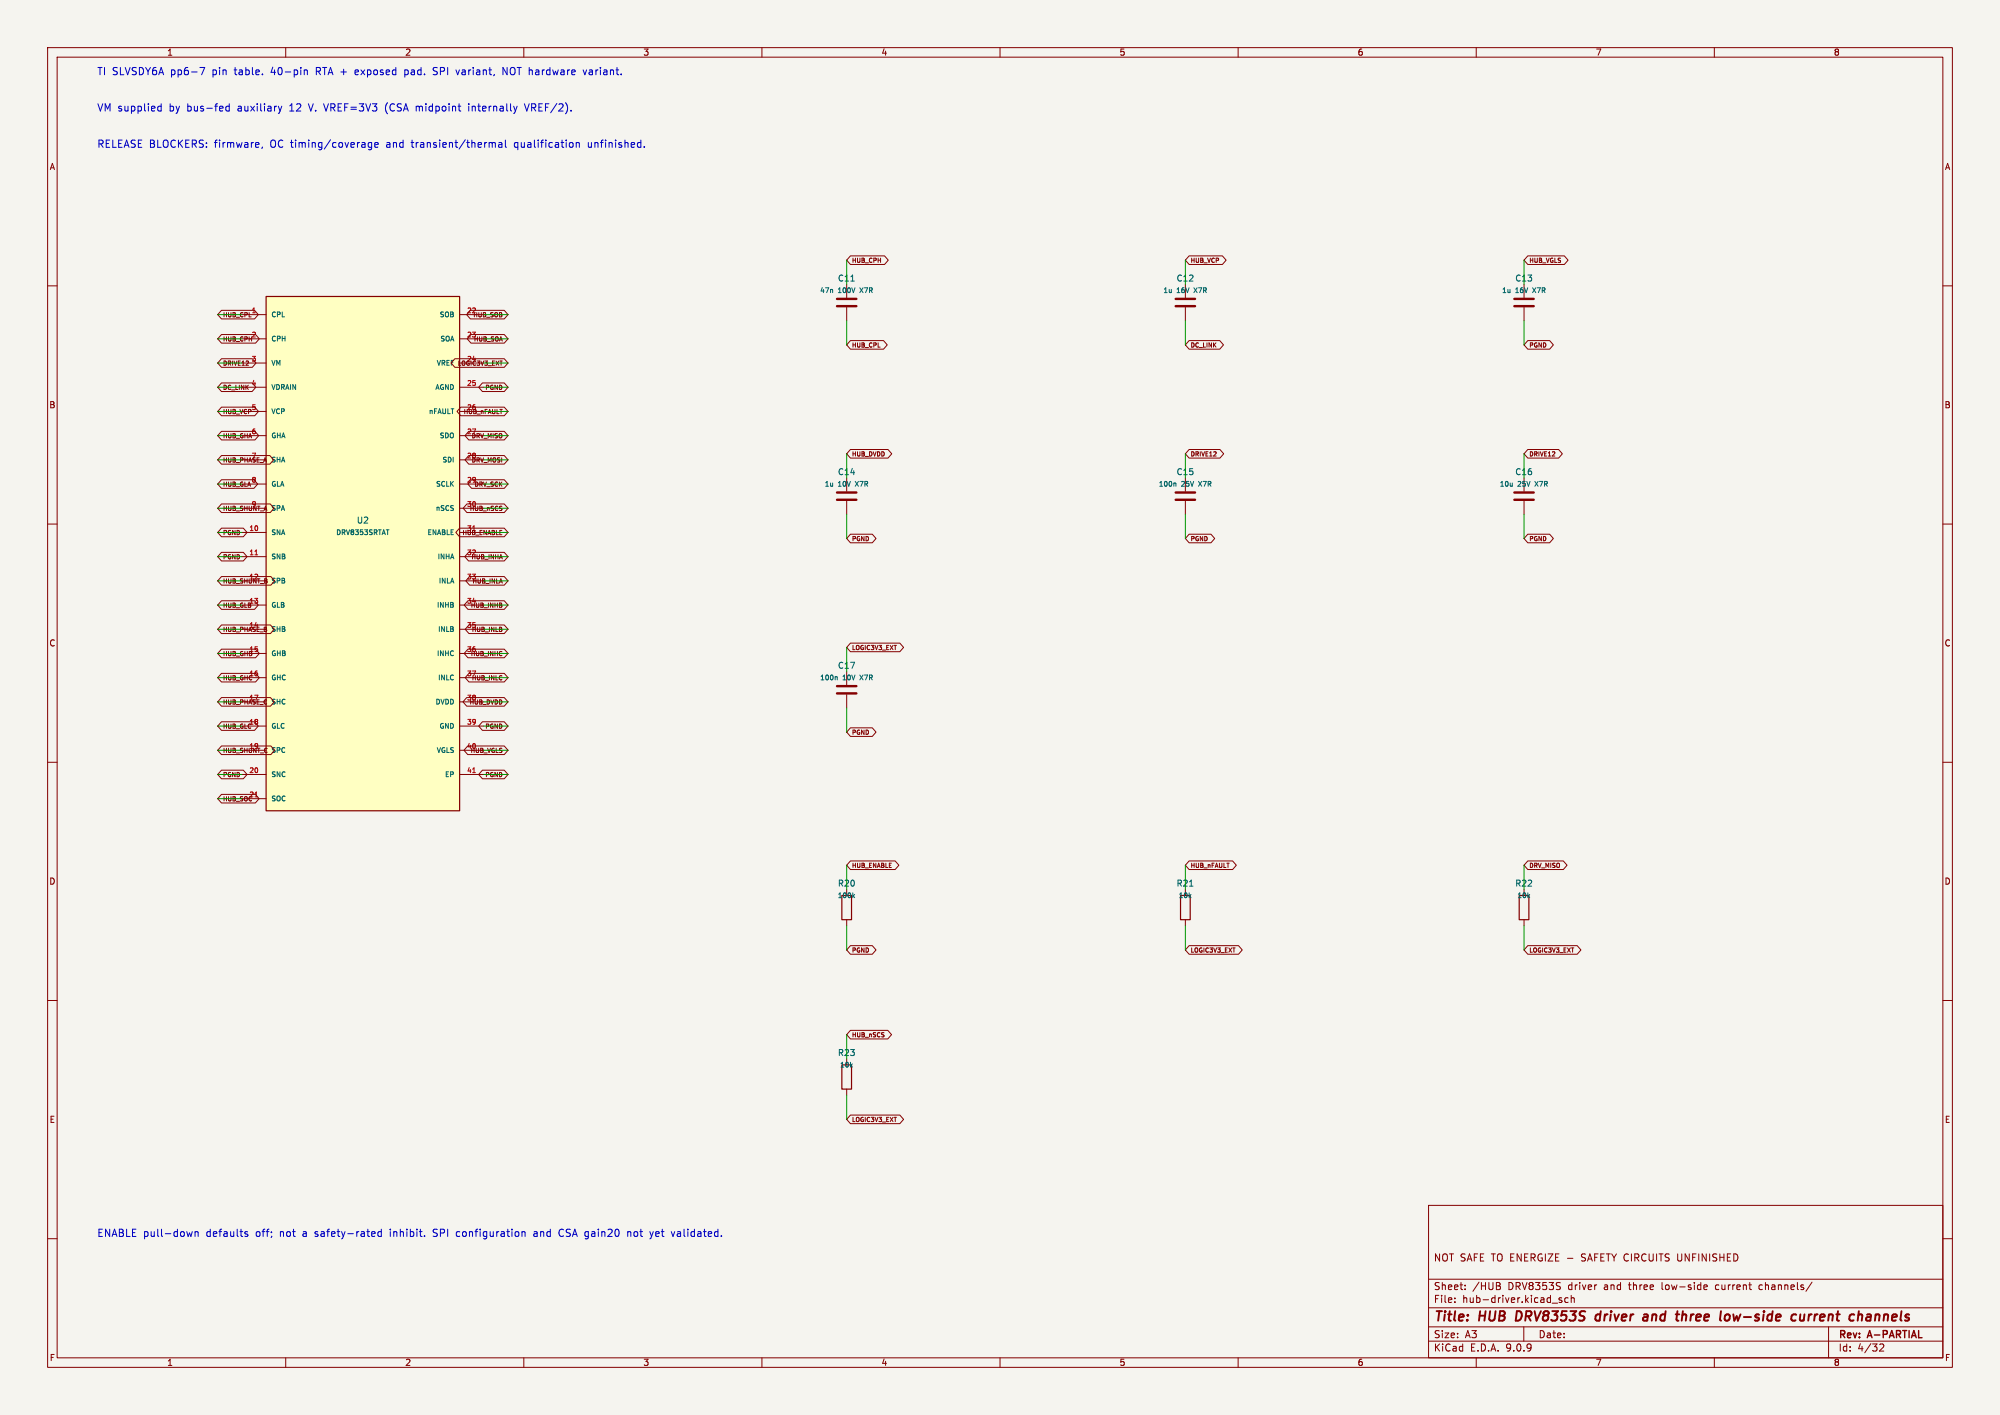
[picture p8: page 4]

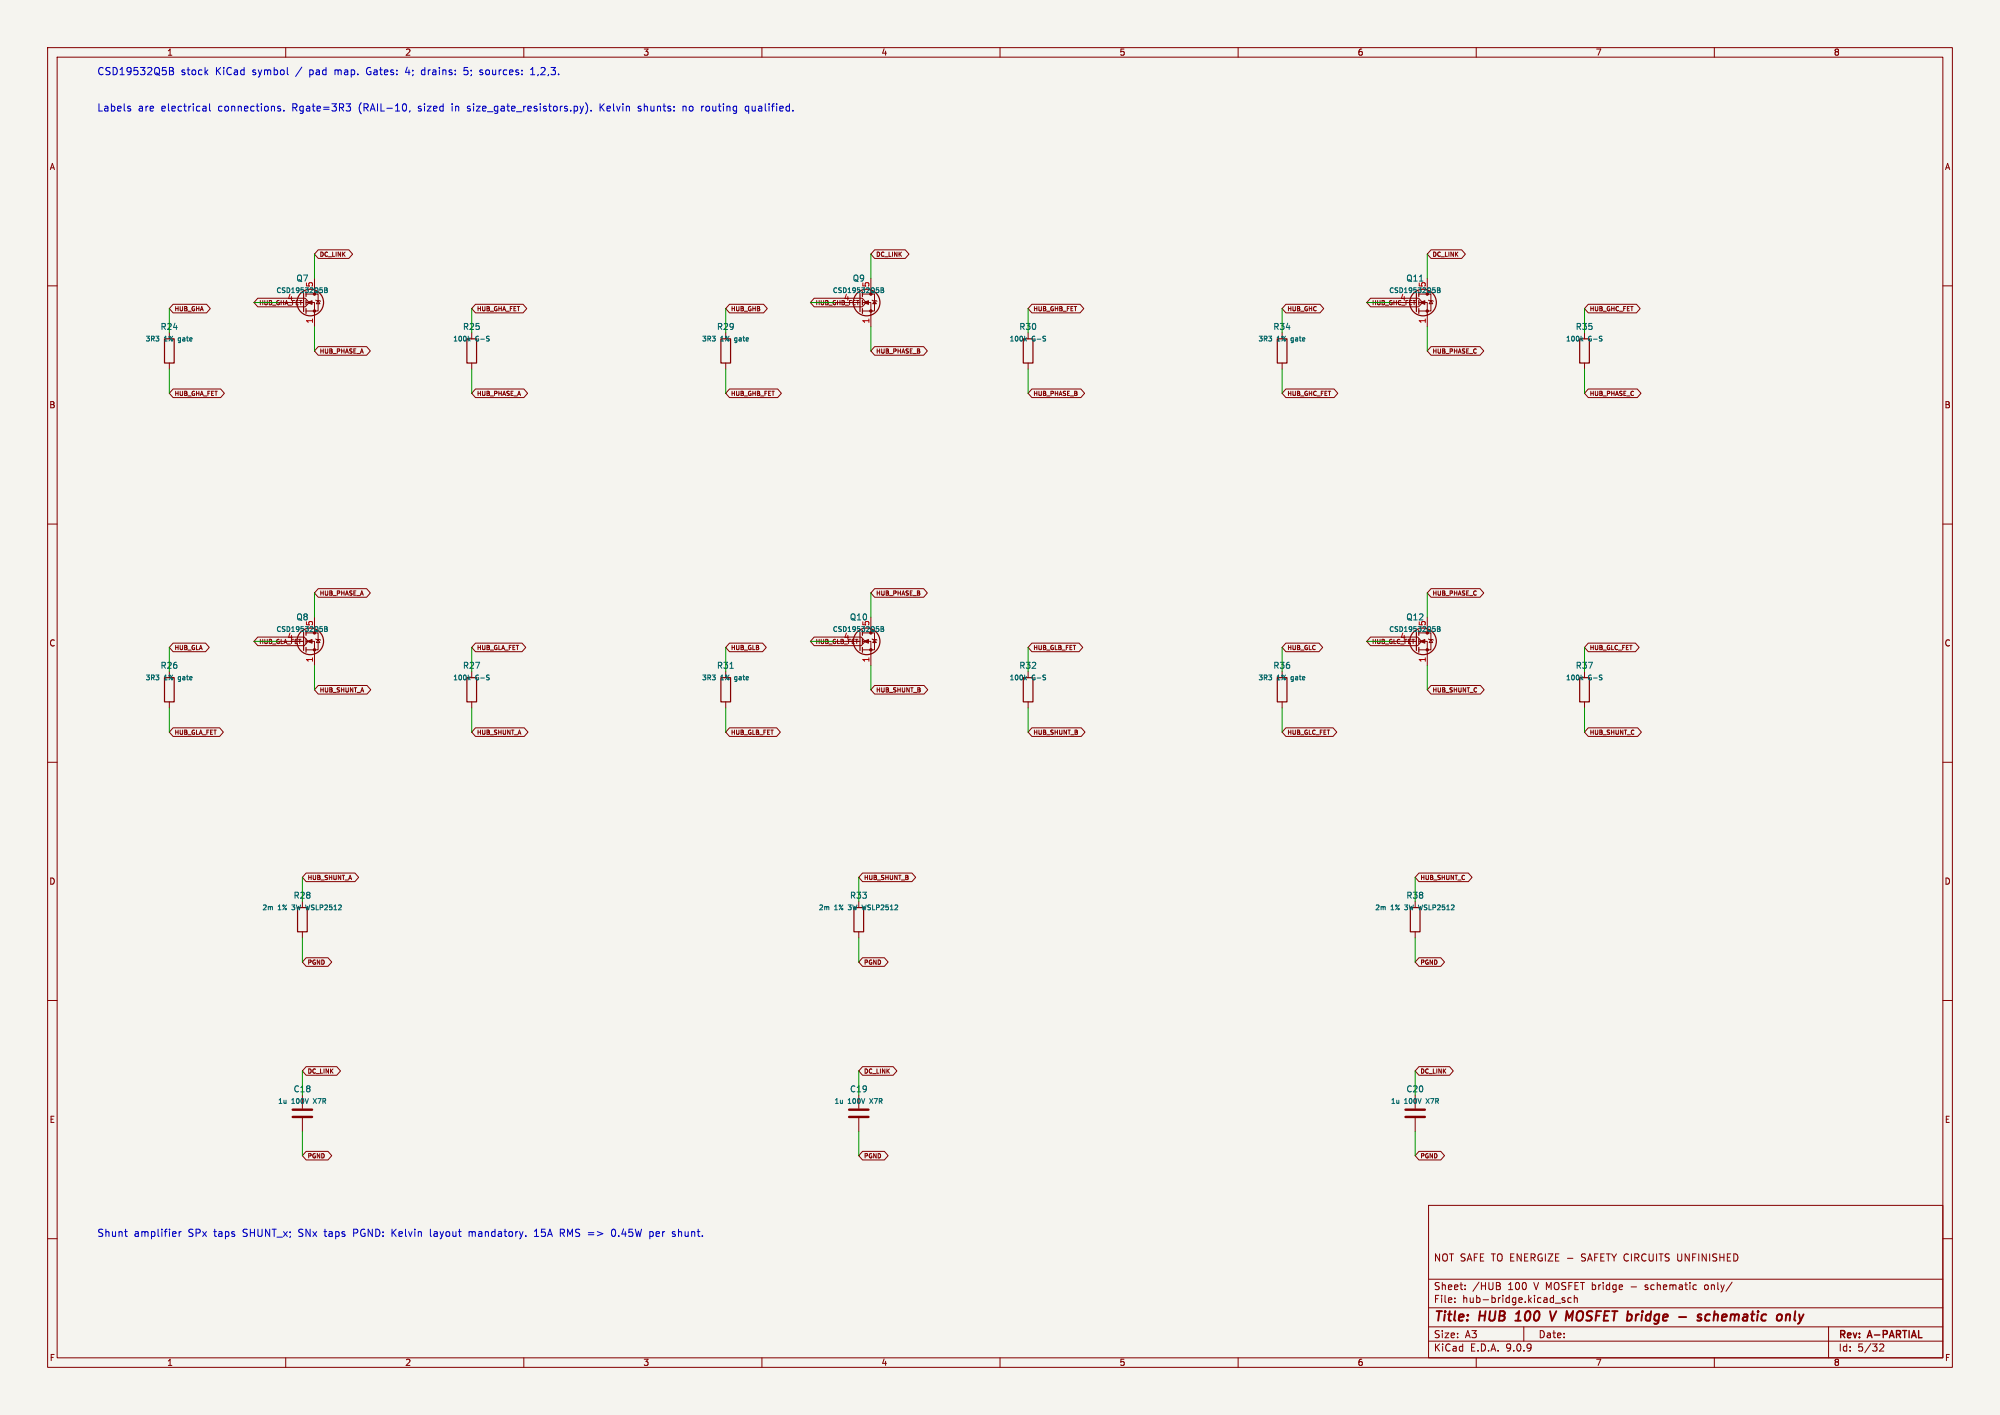
[picture p9: page 5]

Id: 5/32 Title: HUB 100 V MOSFET bridge - schematic only

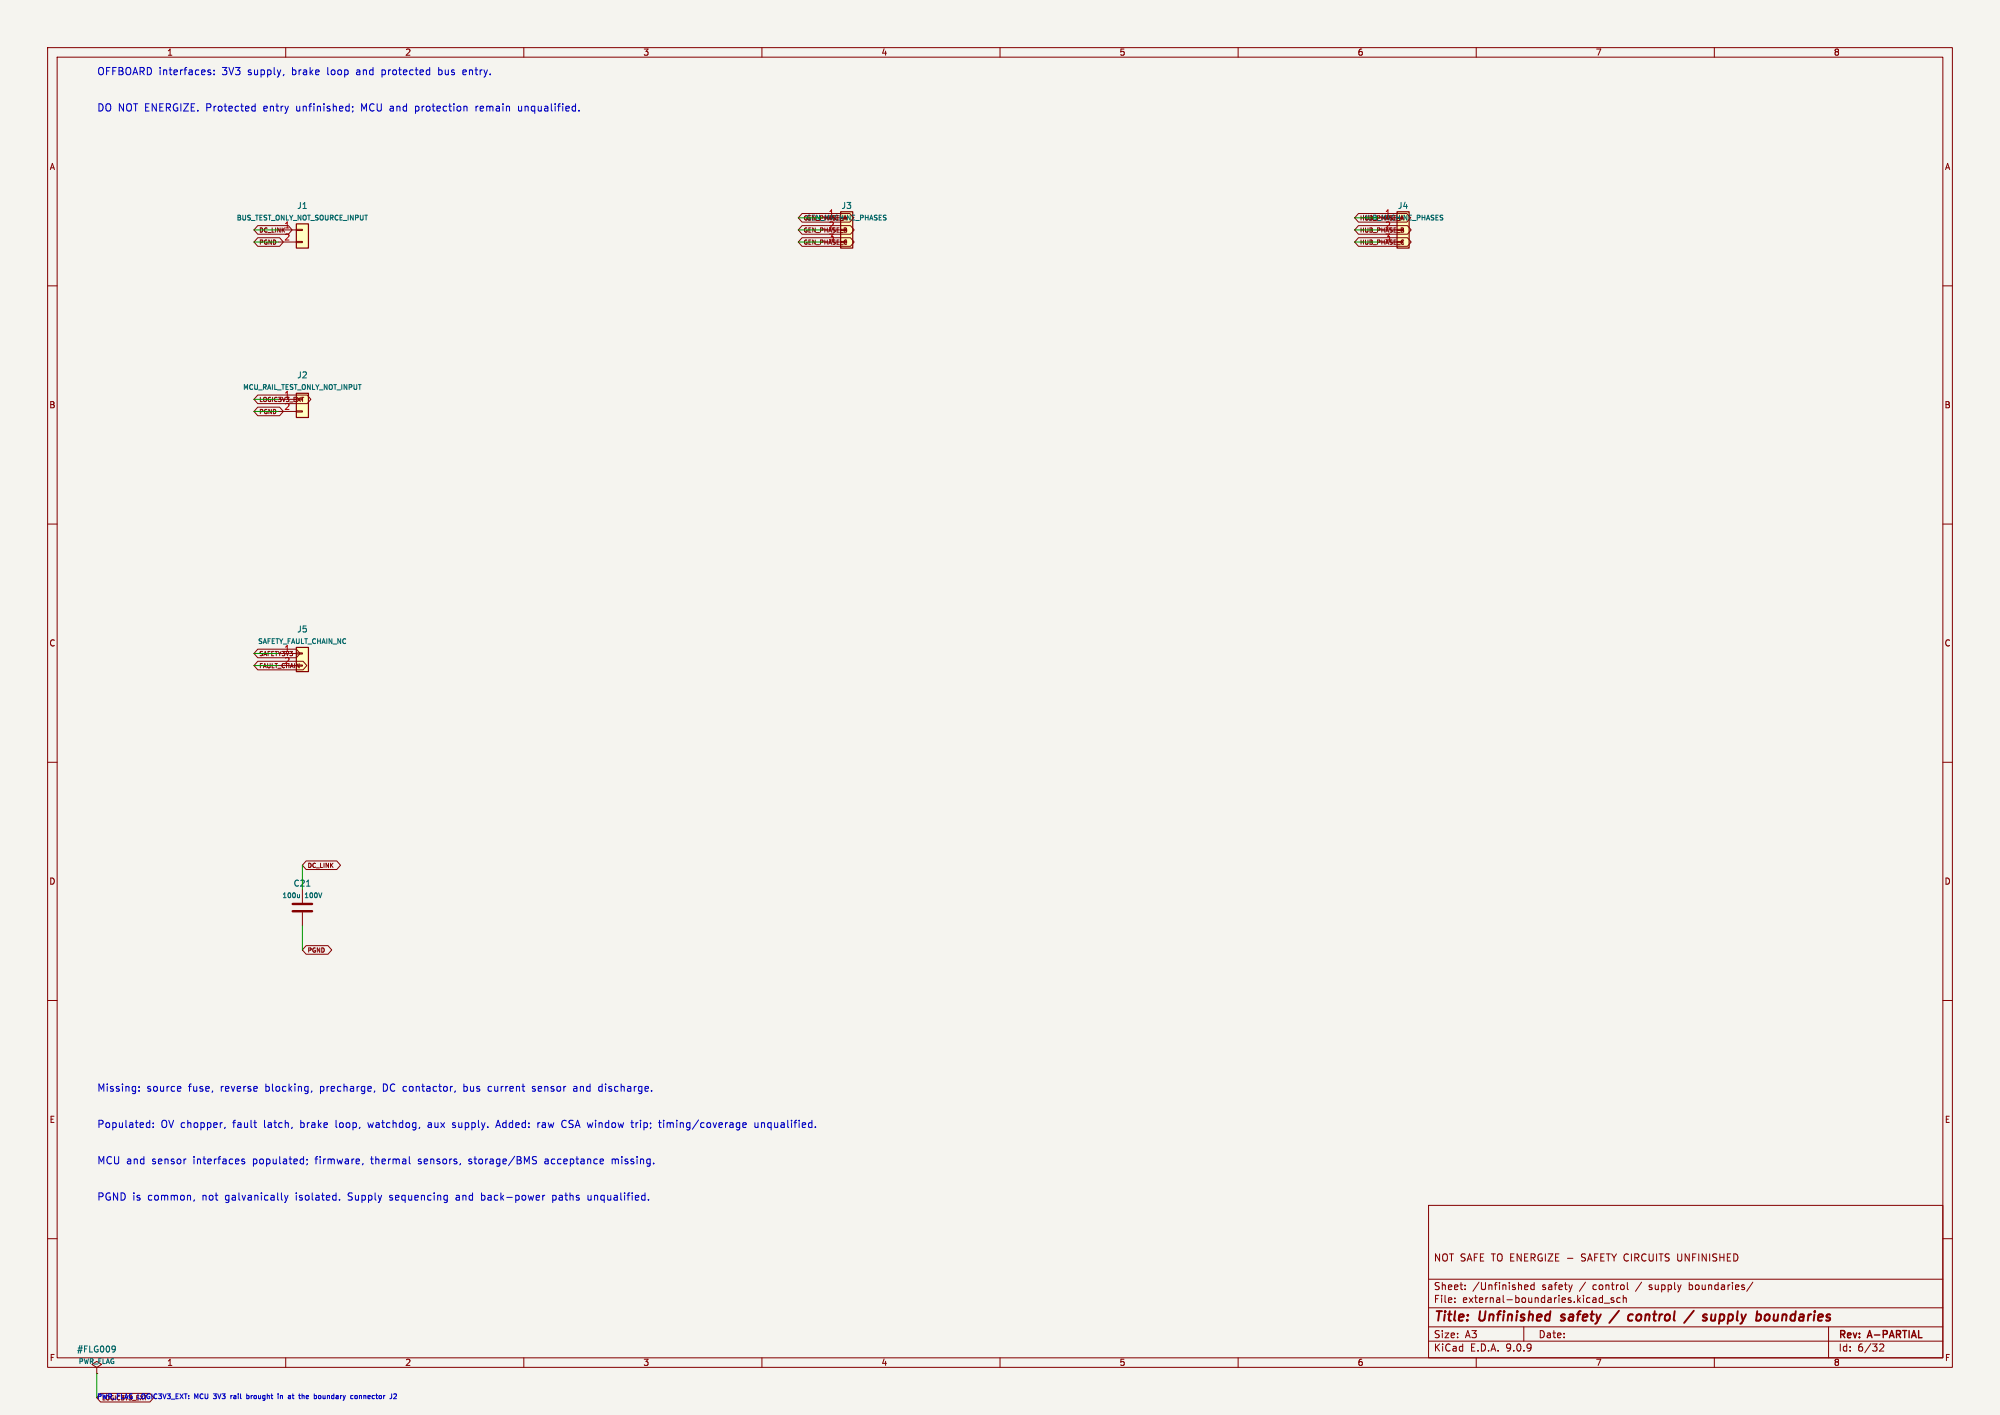
[picture p10: page 6]

Id: 6/32 Title: Unfinished safety / control / supply boundaries

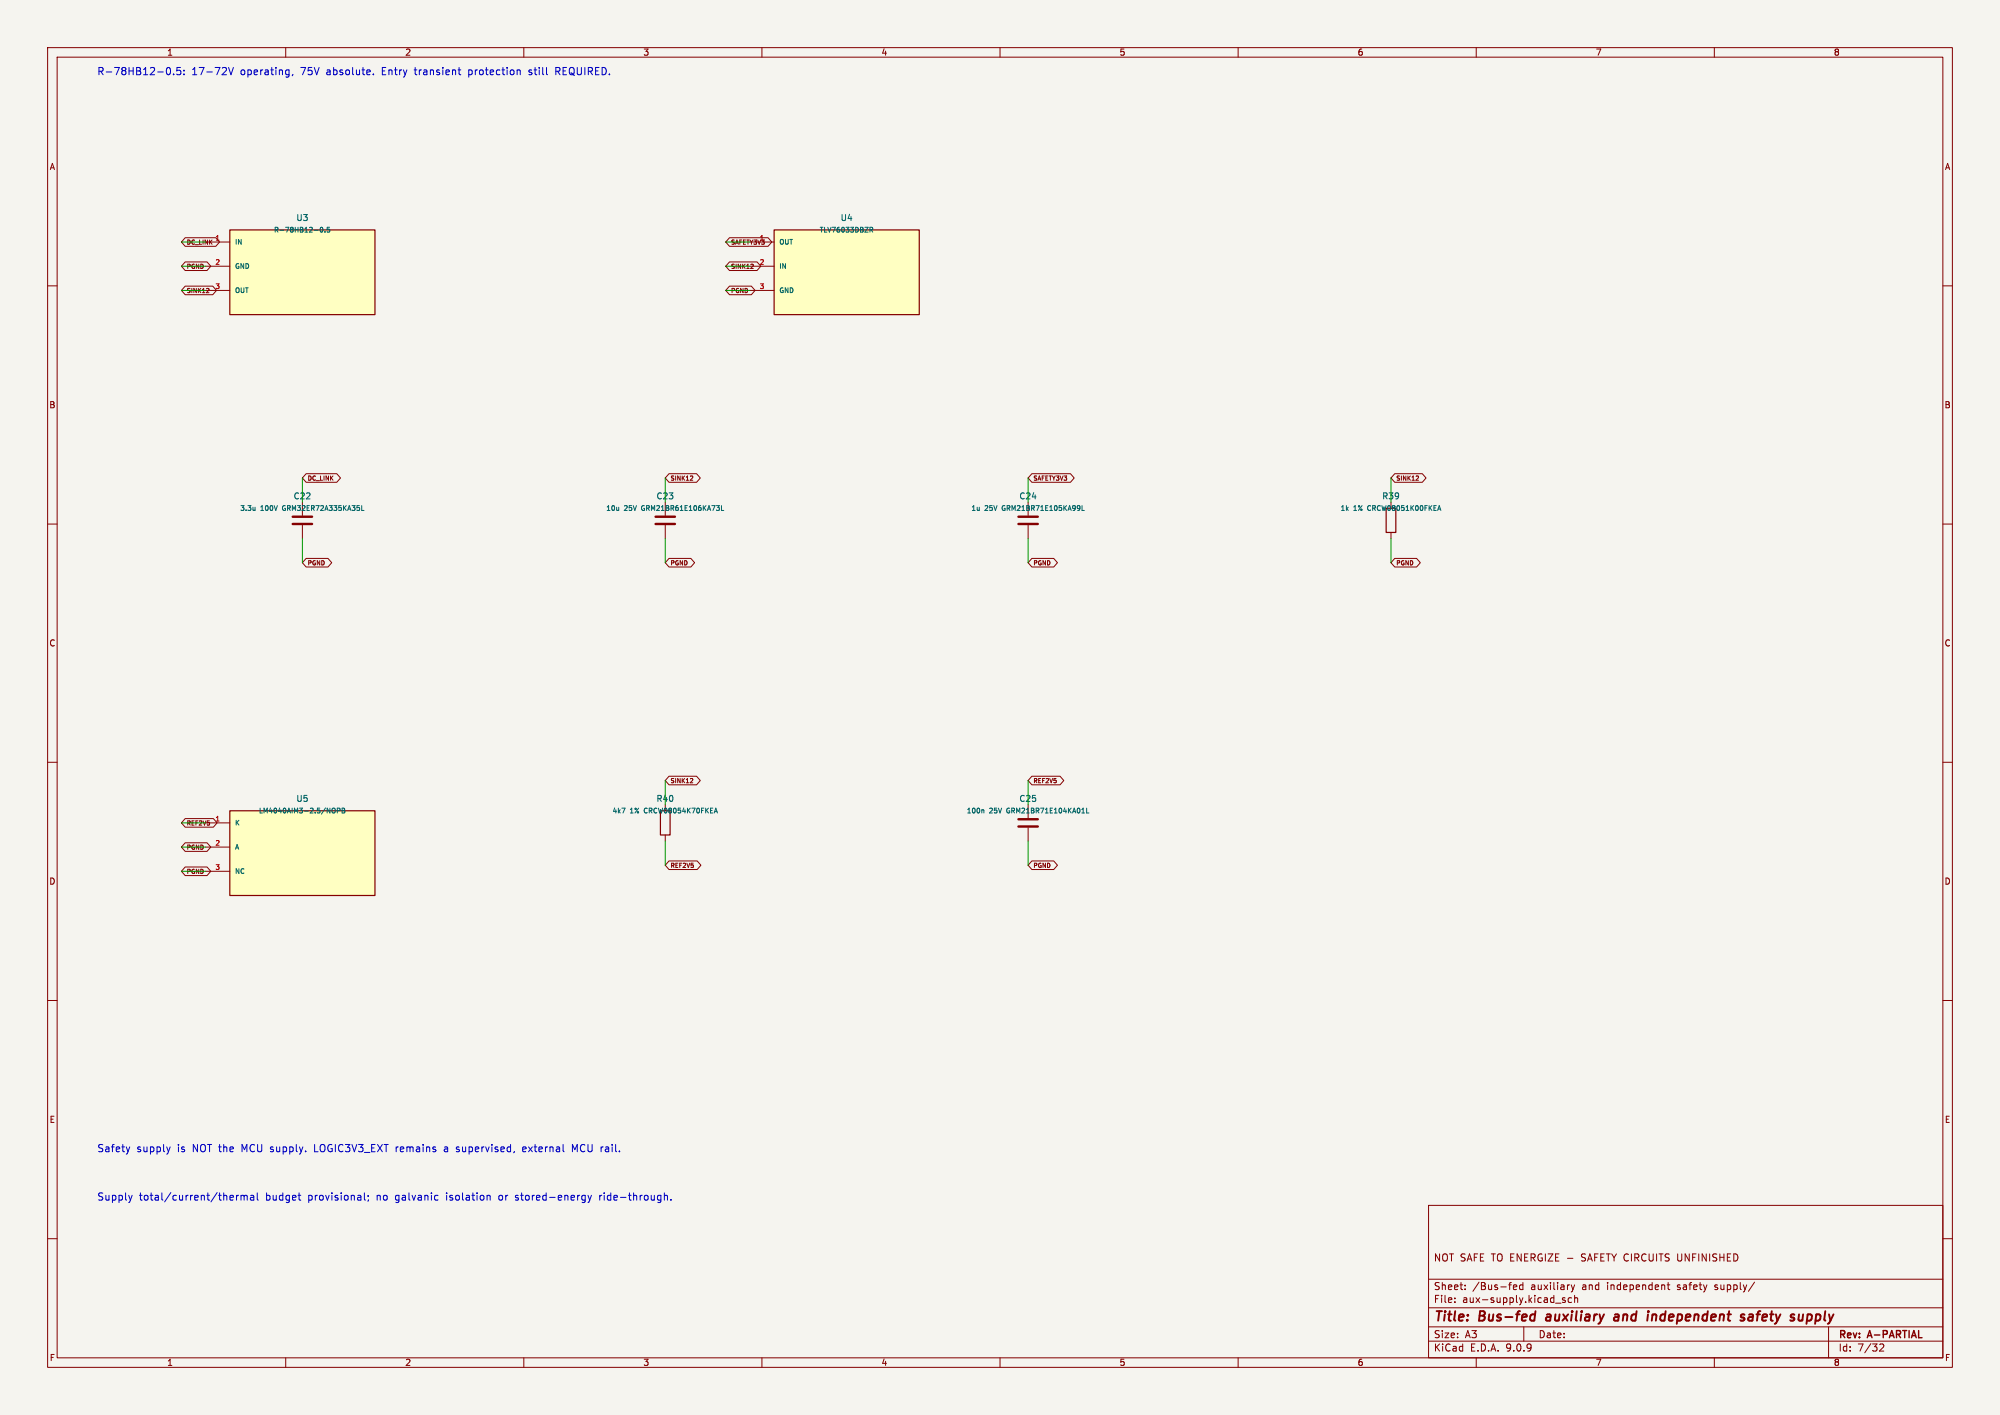
[picture p11: page 7]

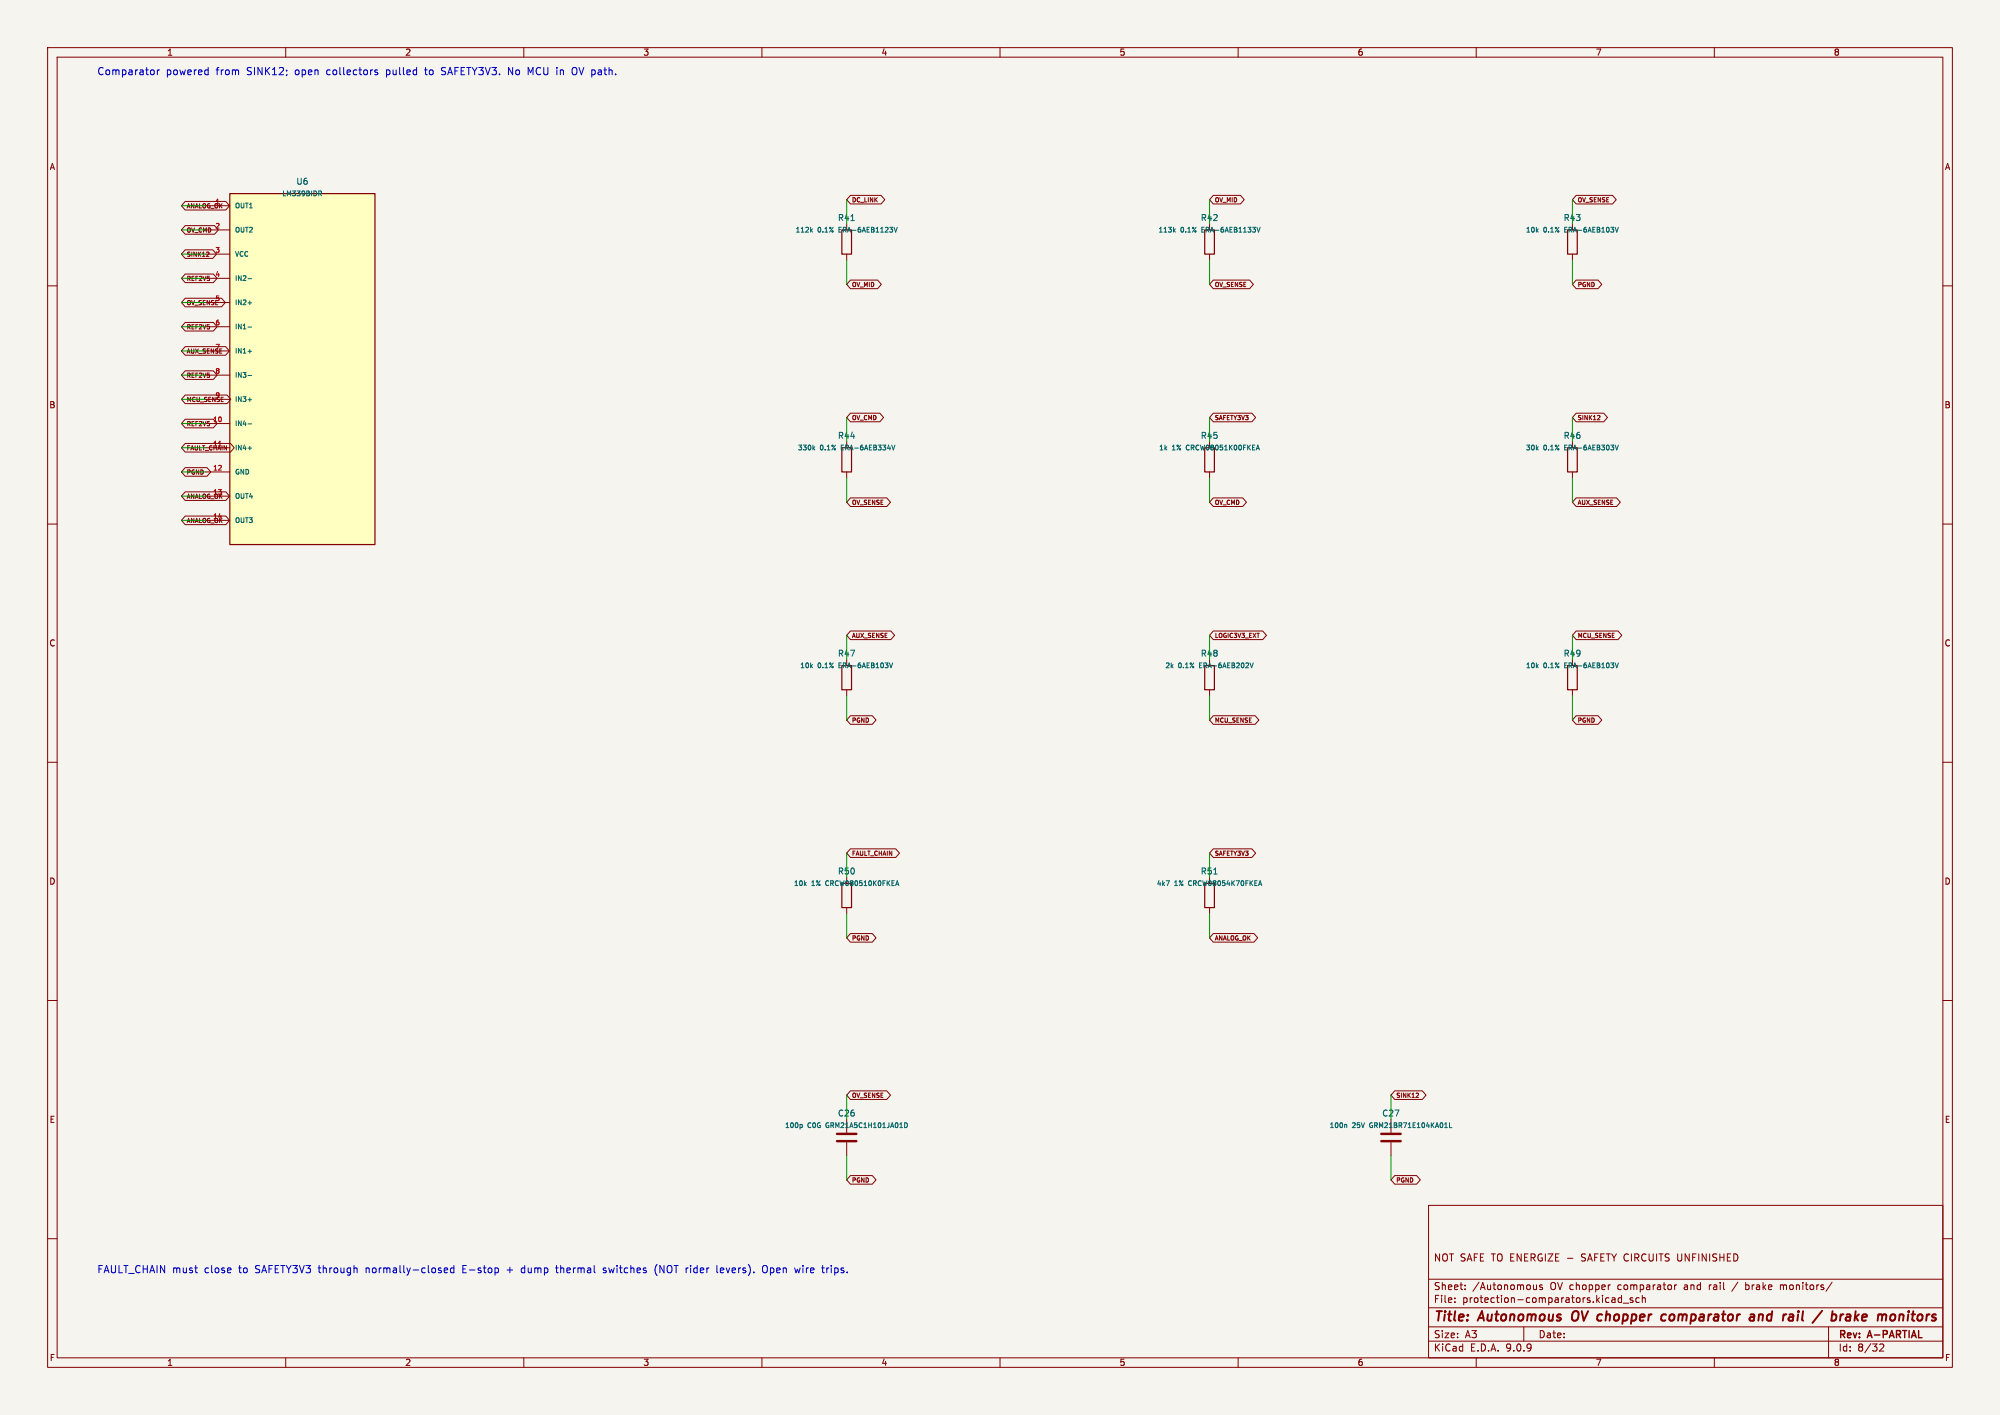
[picture p12: page 8]

Id: 8/32 Title: Autonomous OV chopper comparator and rail / brake monitors

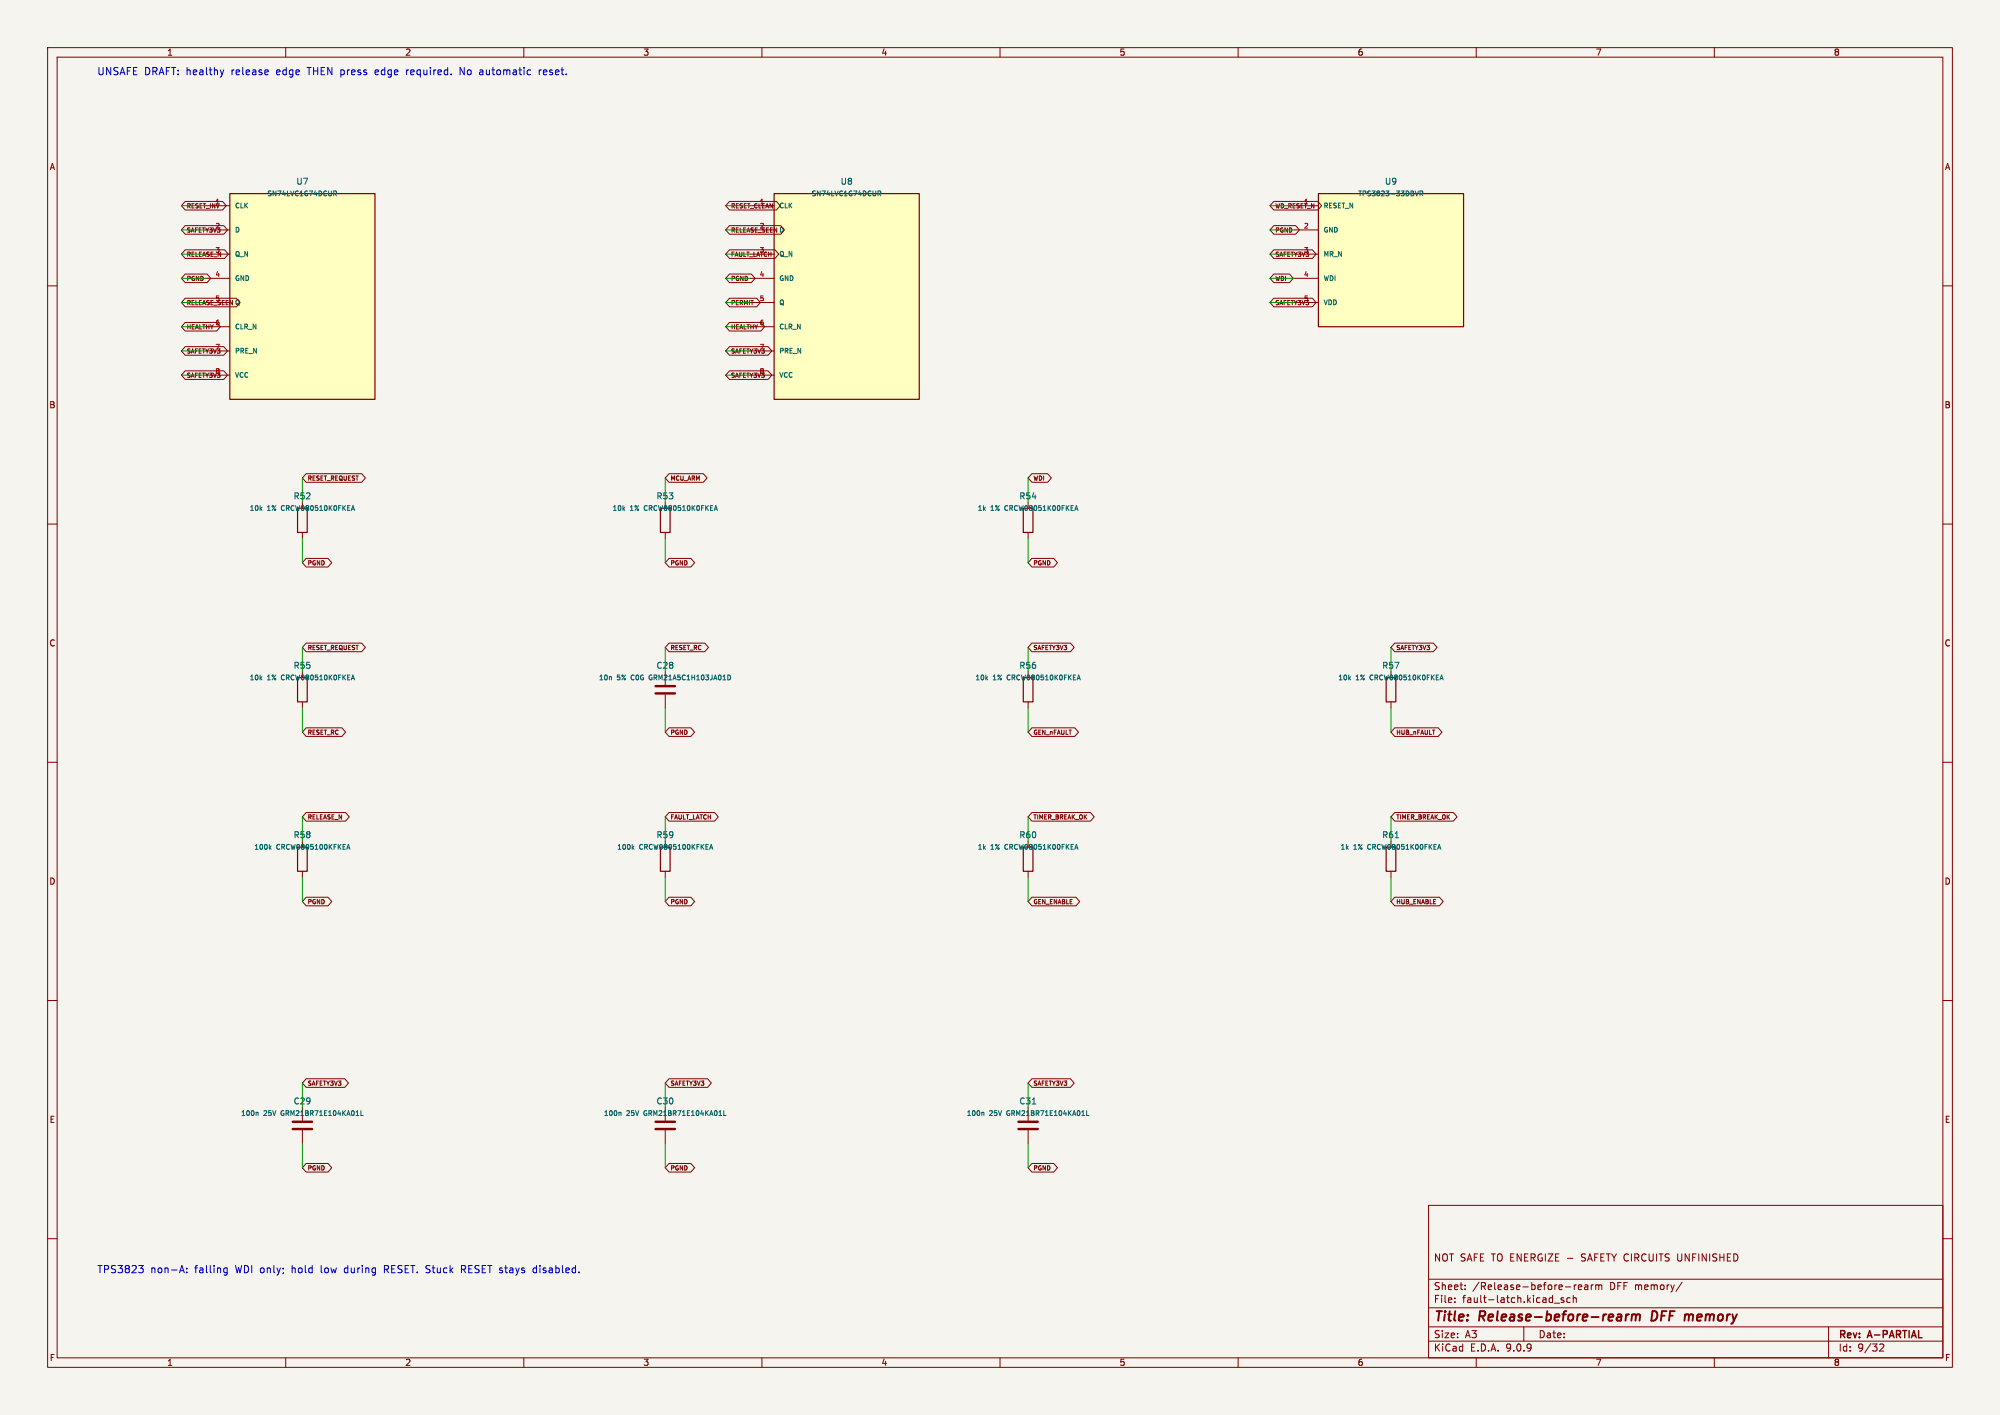
[picture p13: page 9]

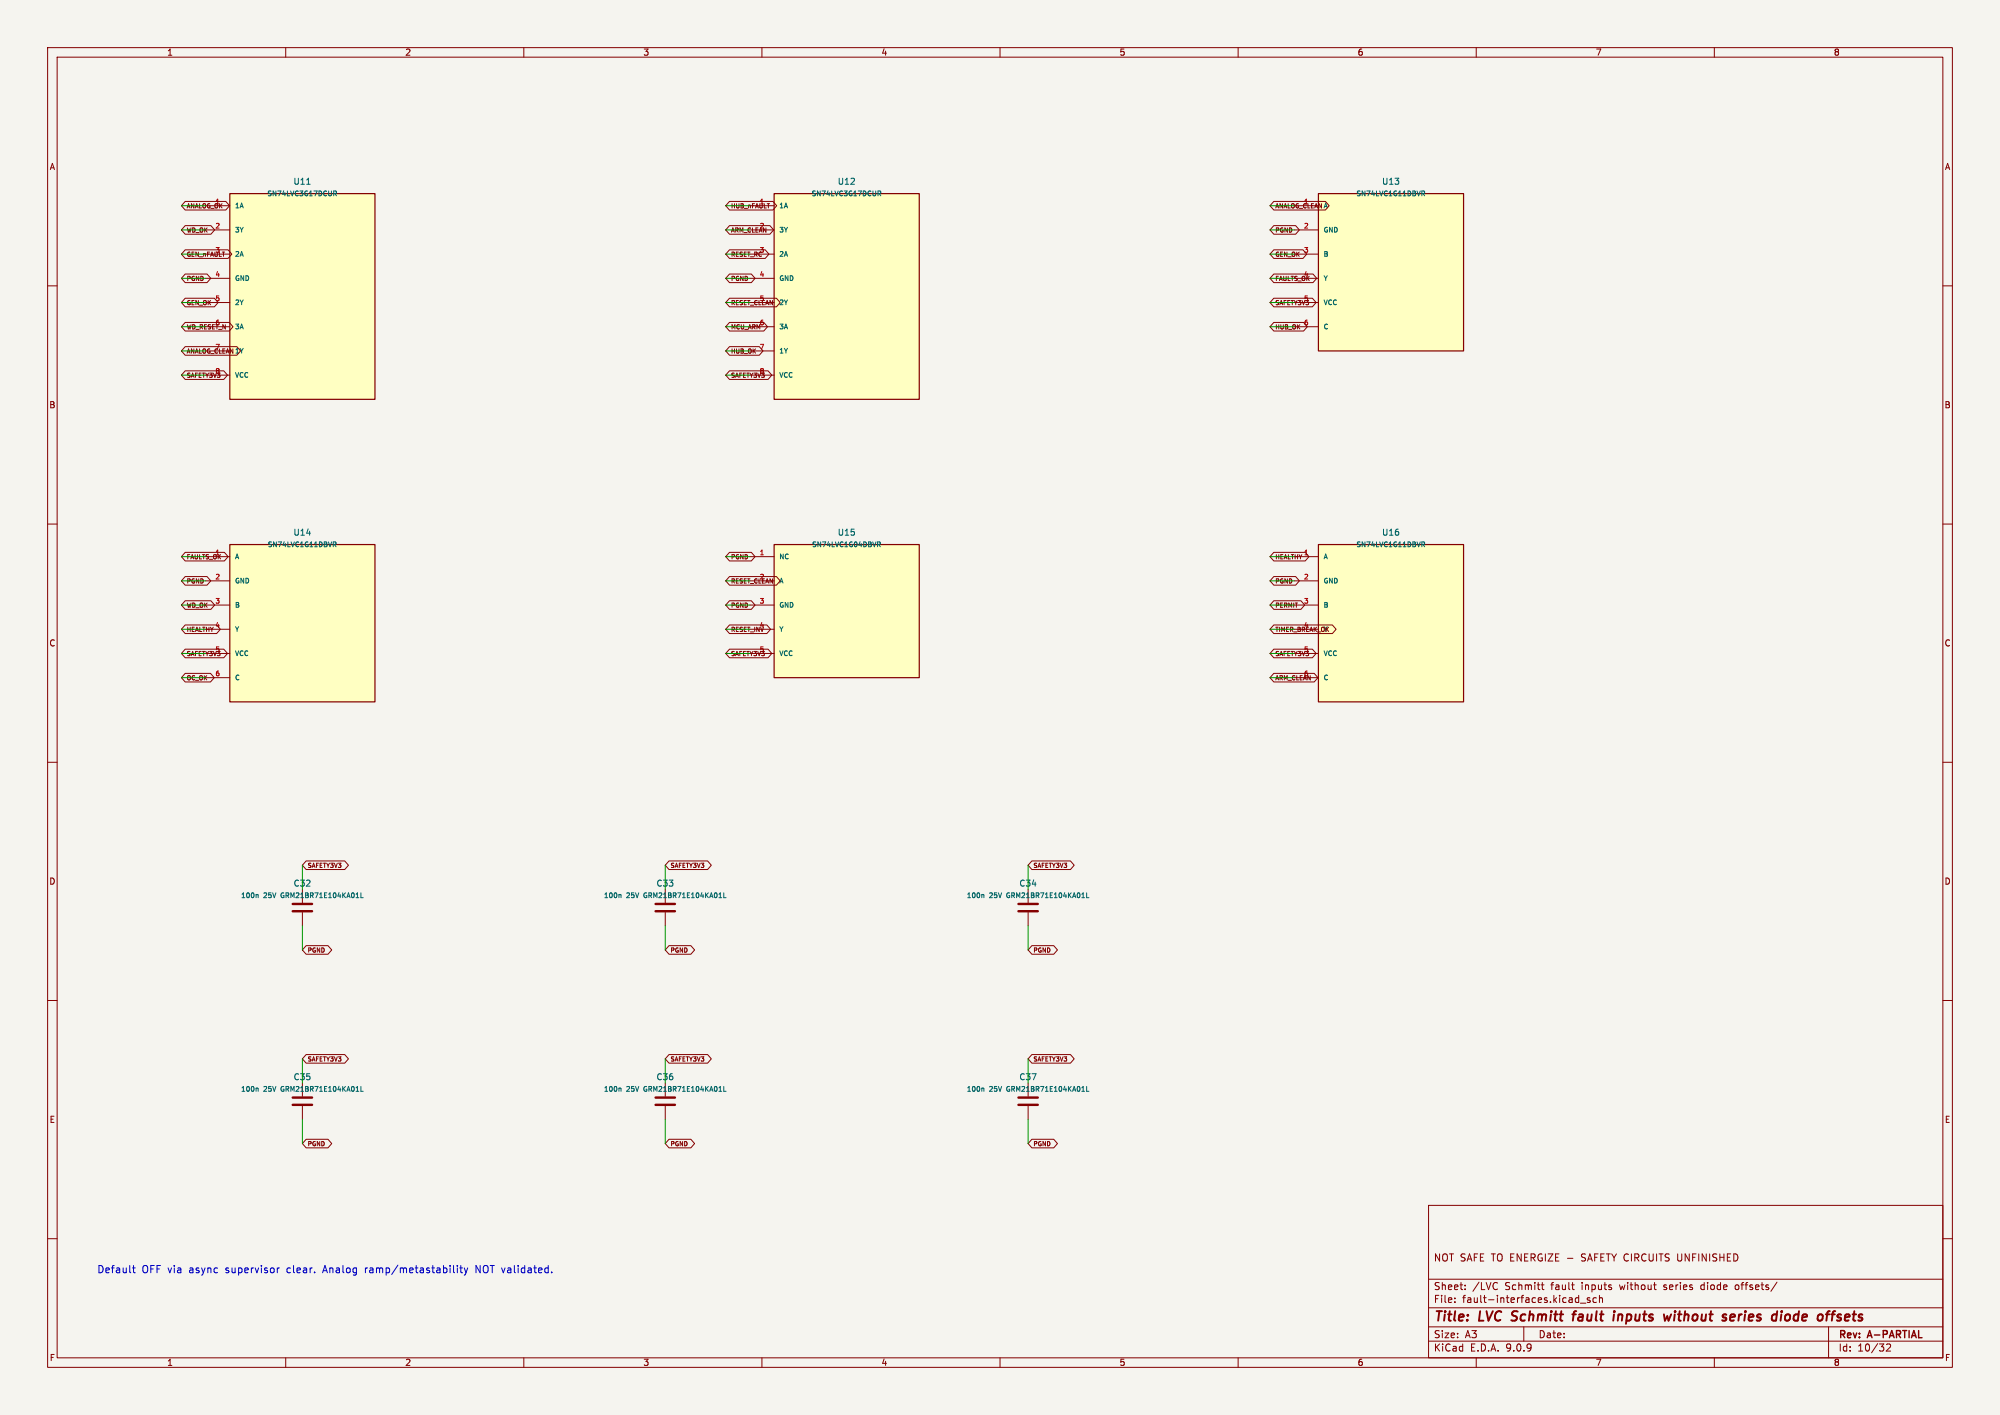
[picture p14: page 10]

Id: 10/32 Title: LVC Schmitt fault inputs without series diode offsets

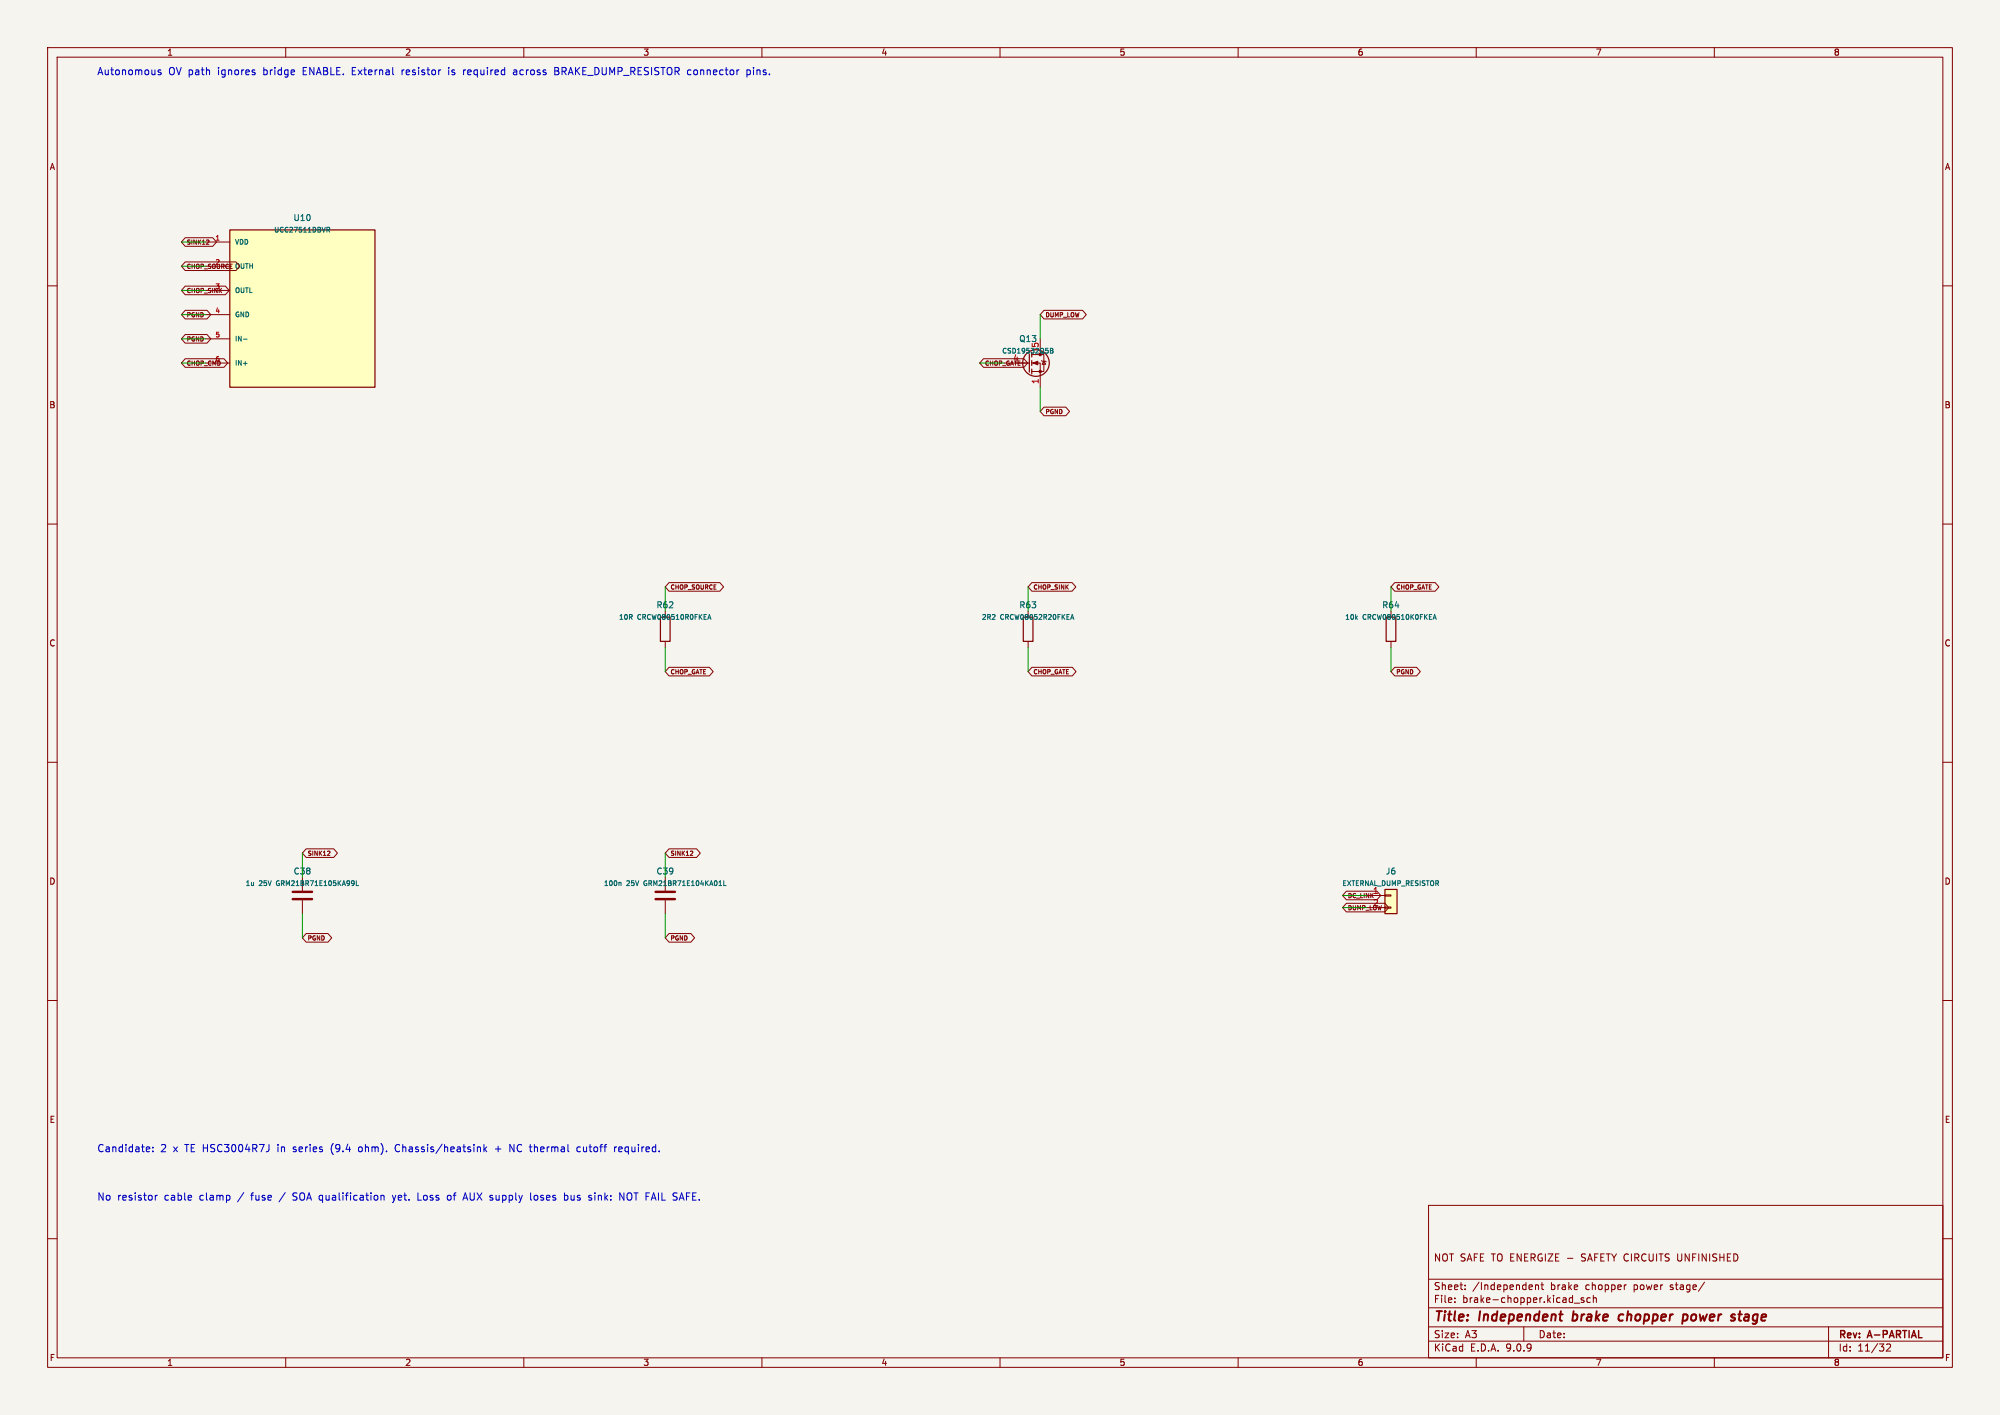
[picture p15: page 11]

Id: 11/32 Title: Independent brake chopper power stage

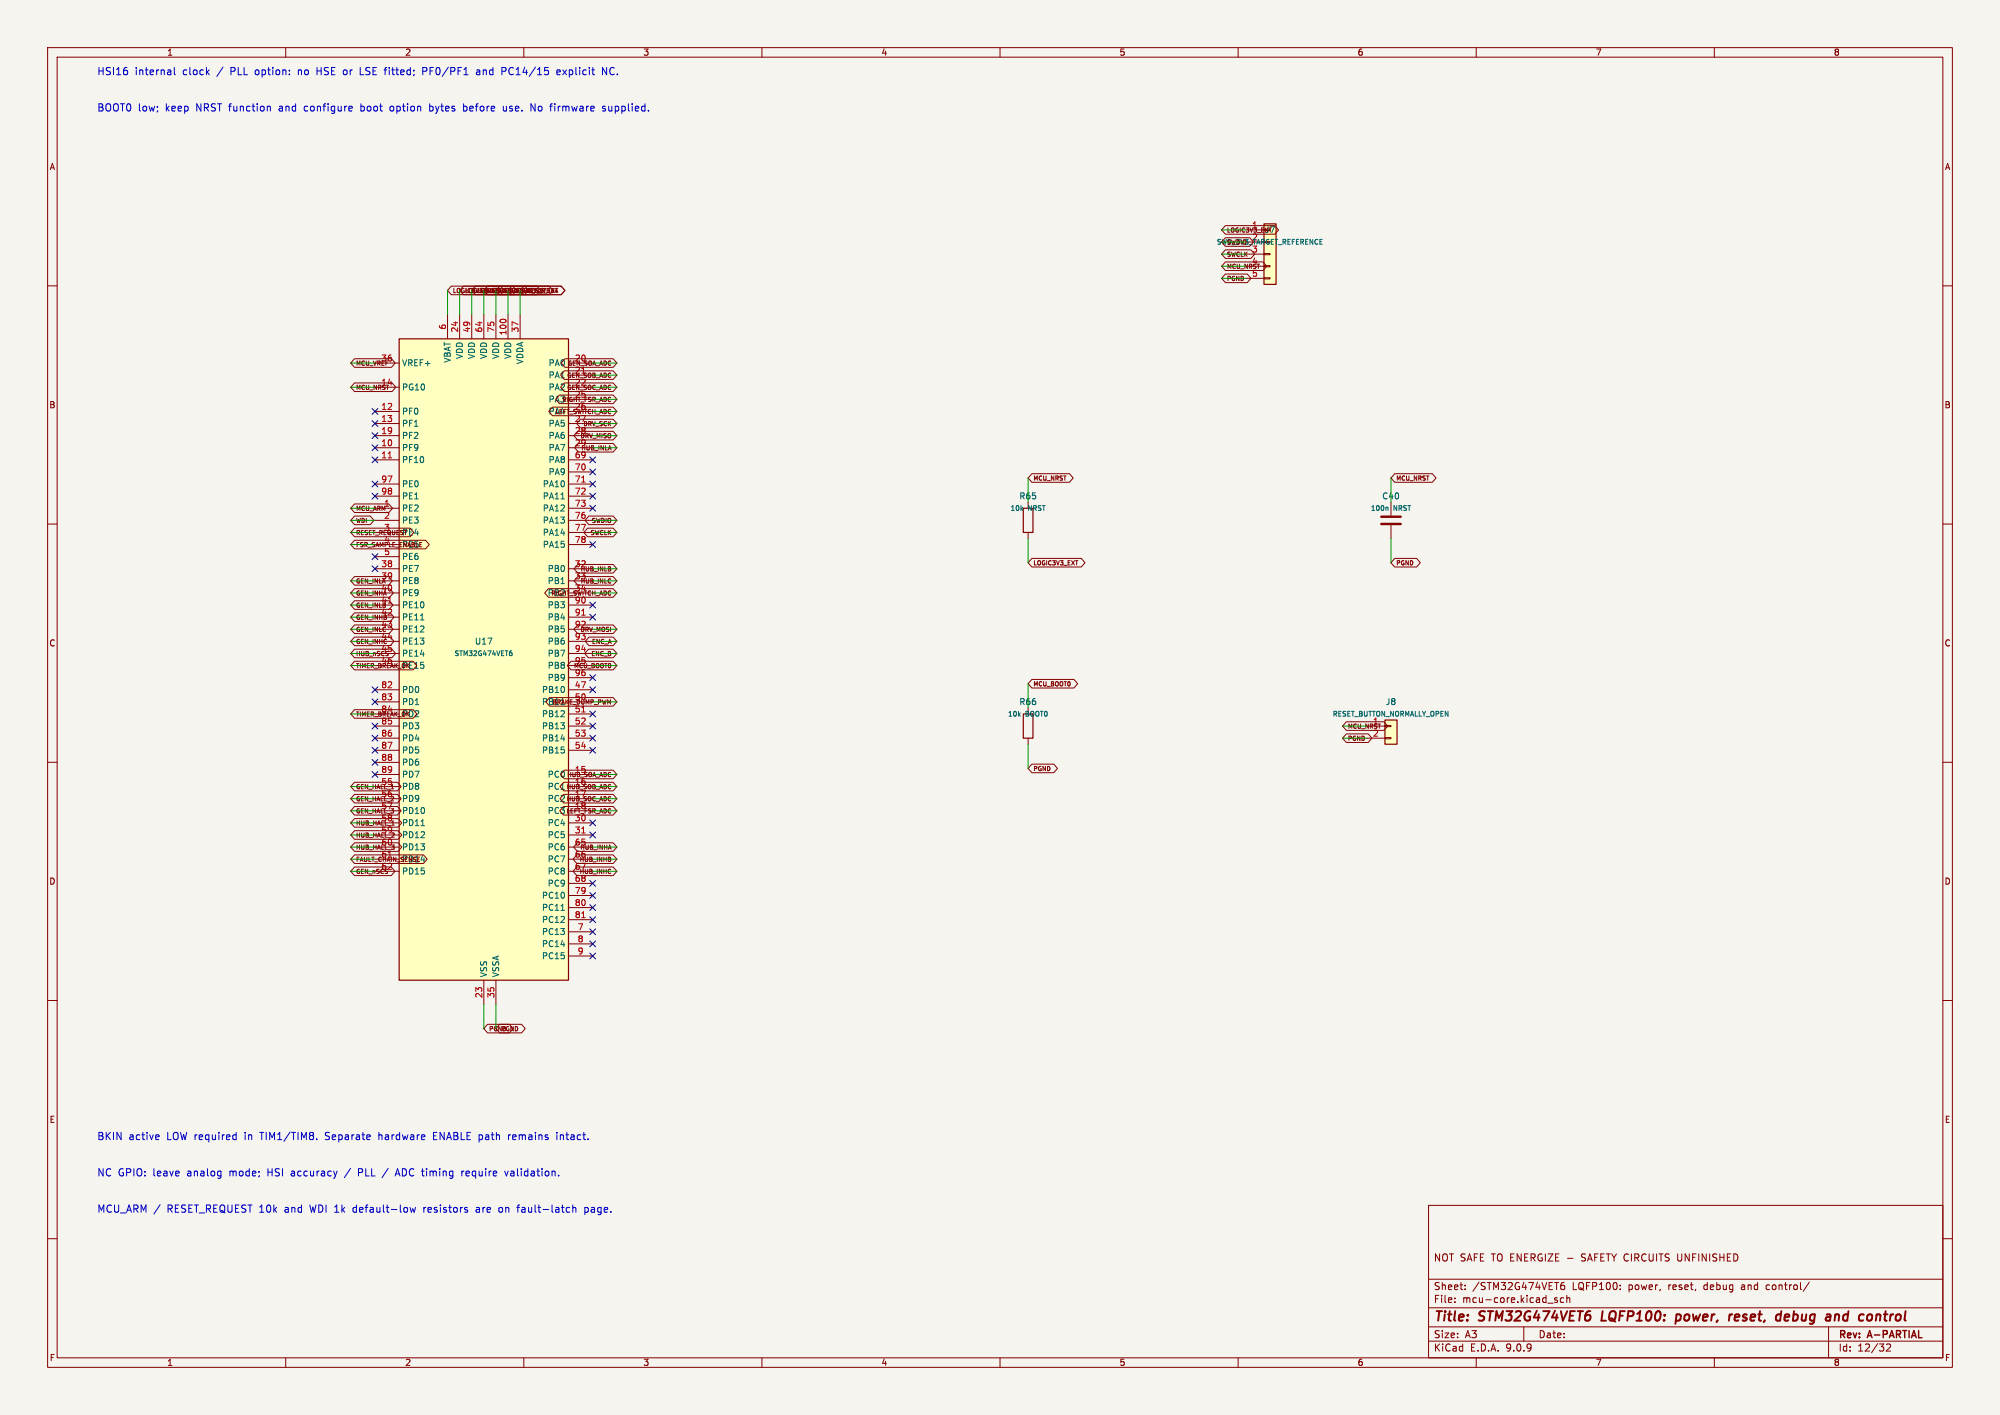
[picture p16: page 12]

6 VDD 24 VDD 49 VDD 64 VSS 23 VDD 75 VSSA 35 VDD 100 VDDA 37 PA0 20 PA1 21 PA2 22 PA3 25 PA4 26 PA5 27 PA6 28 PA7 29 PA8 69 PA9 70 PA10 71 PA11 72 PA12 73 PA13 76 PA14 77 PA15 78 PB0 32 PB1 33 PB2 34 PB3 90 PB4 91 PB5 92 PB6 93 PB7 94 PB8 95 PB9 96 PB10 47 PB11 50 PB12 51 PB13 52 PB14 53 PB15 54 PC0 15 PC1 16 PC2 17 PC3 18 PC4 30 PC5 31 PC6 65 PC7 66 PC8 67 PC9 68 PC10 79 PC11 80 PC12 81 PC13 7 PC14 8 PC15 9 U17

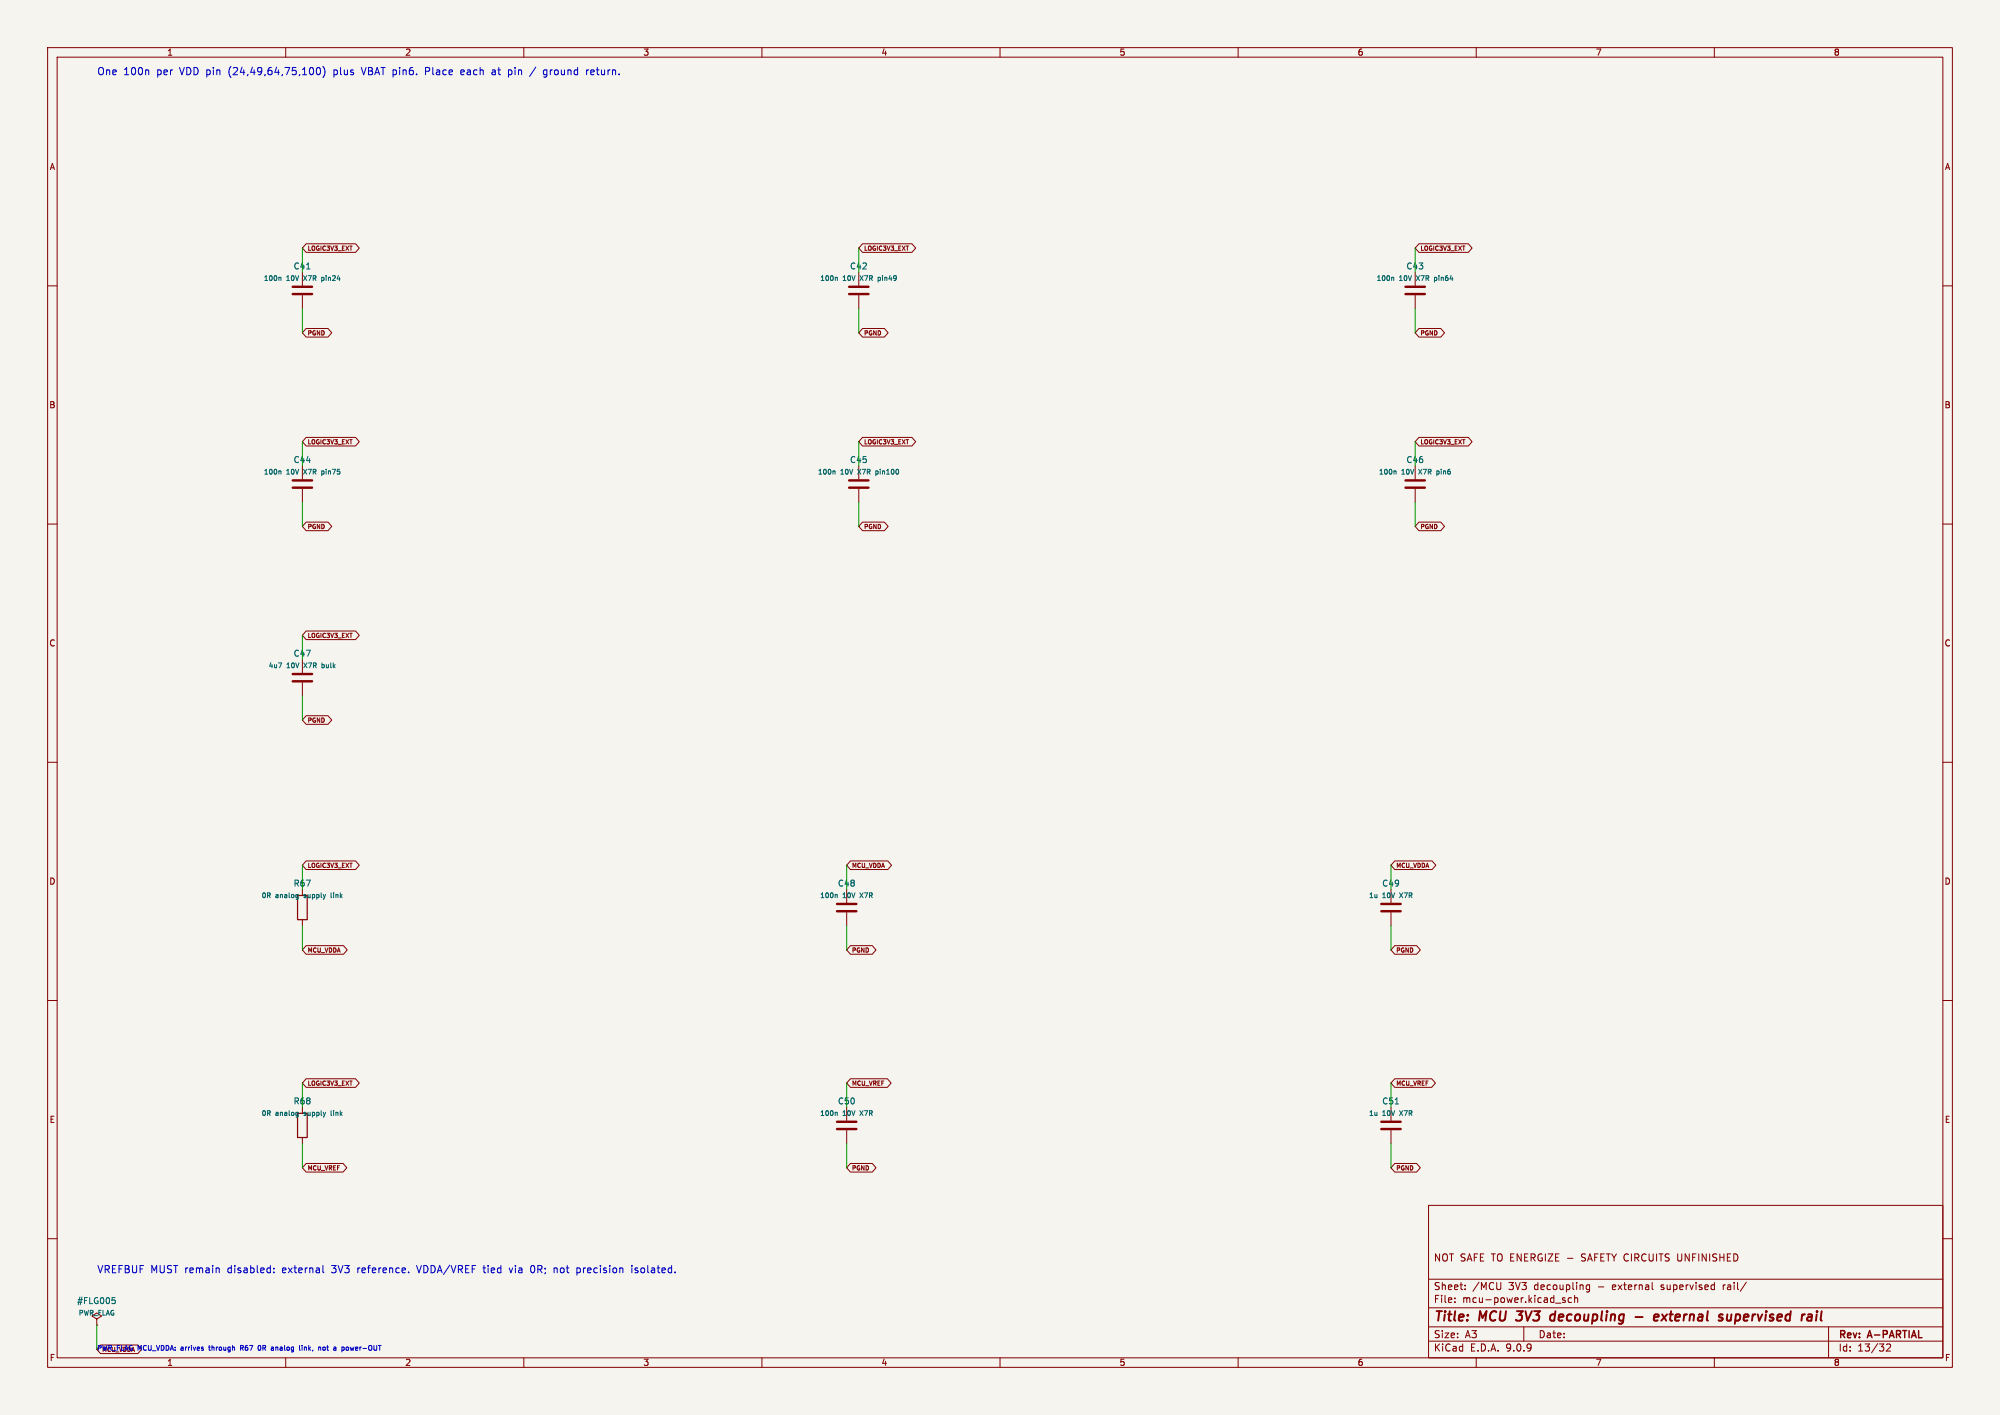
[picture p17: page 13]

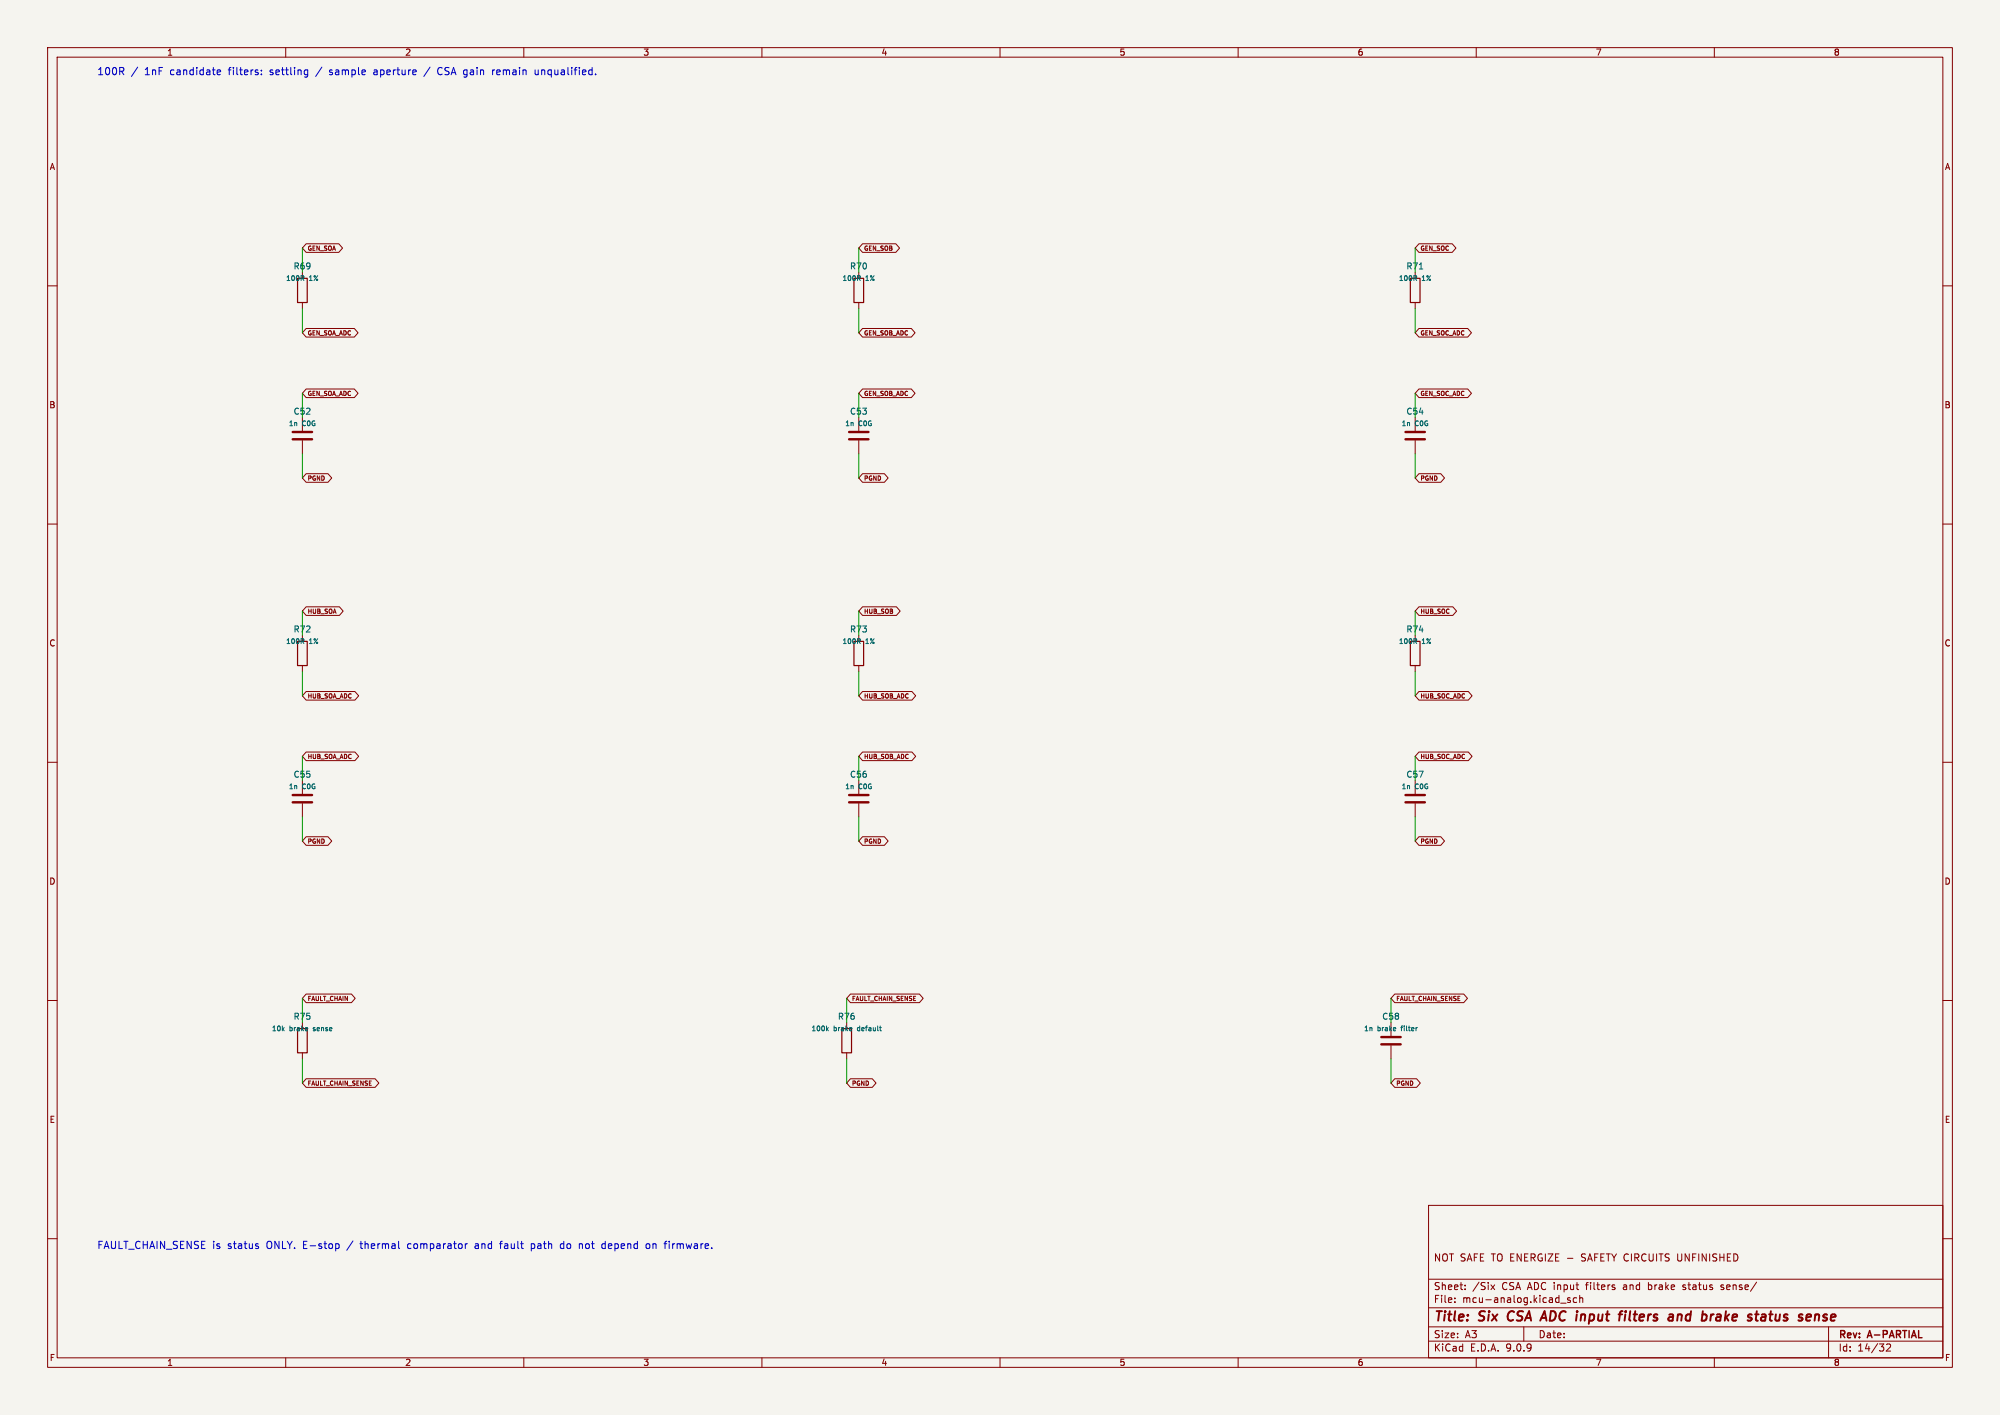
[picture p18: page 14]

Id: 14/32 Title: Six CSA ADC input filters and brake status sense

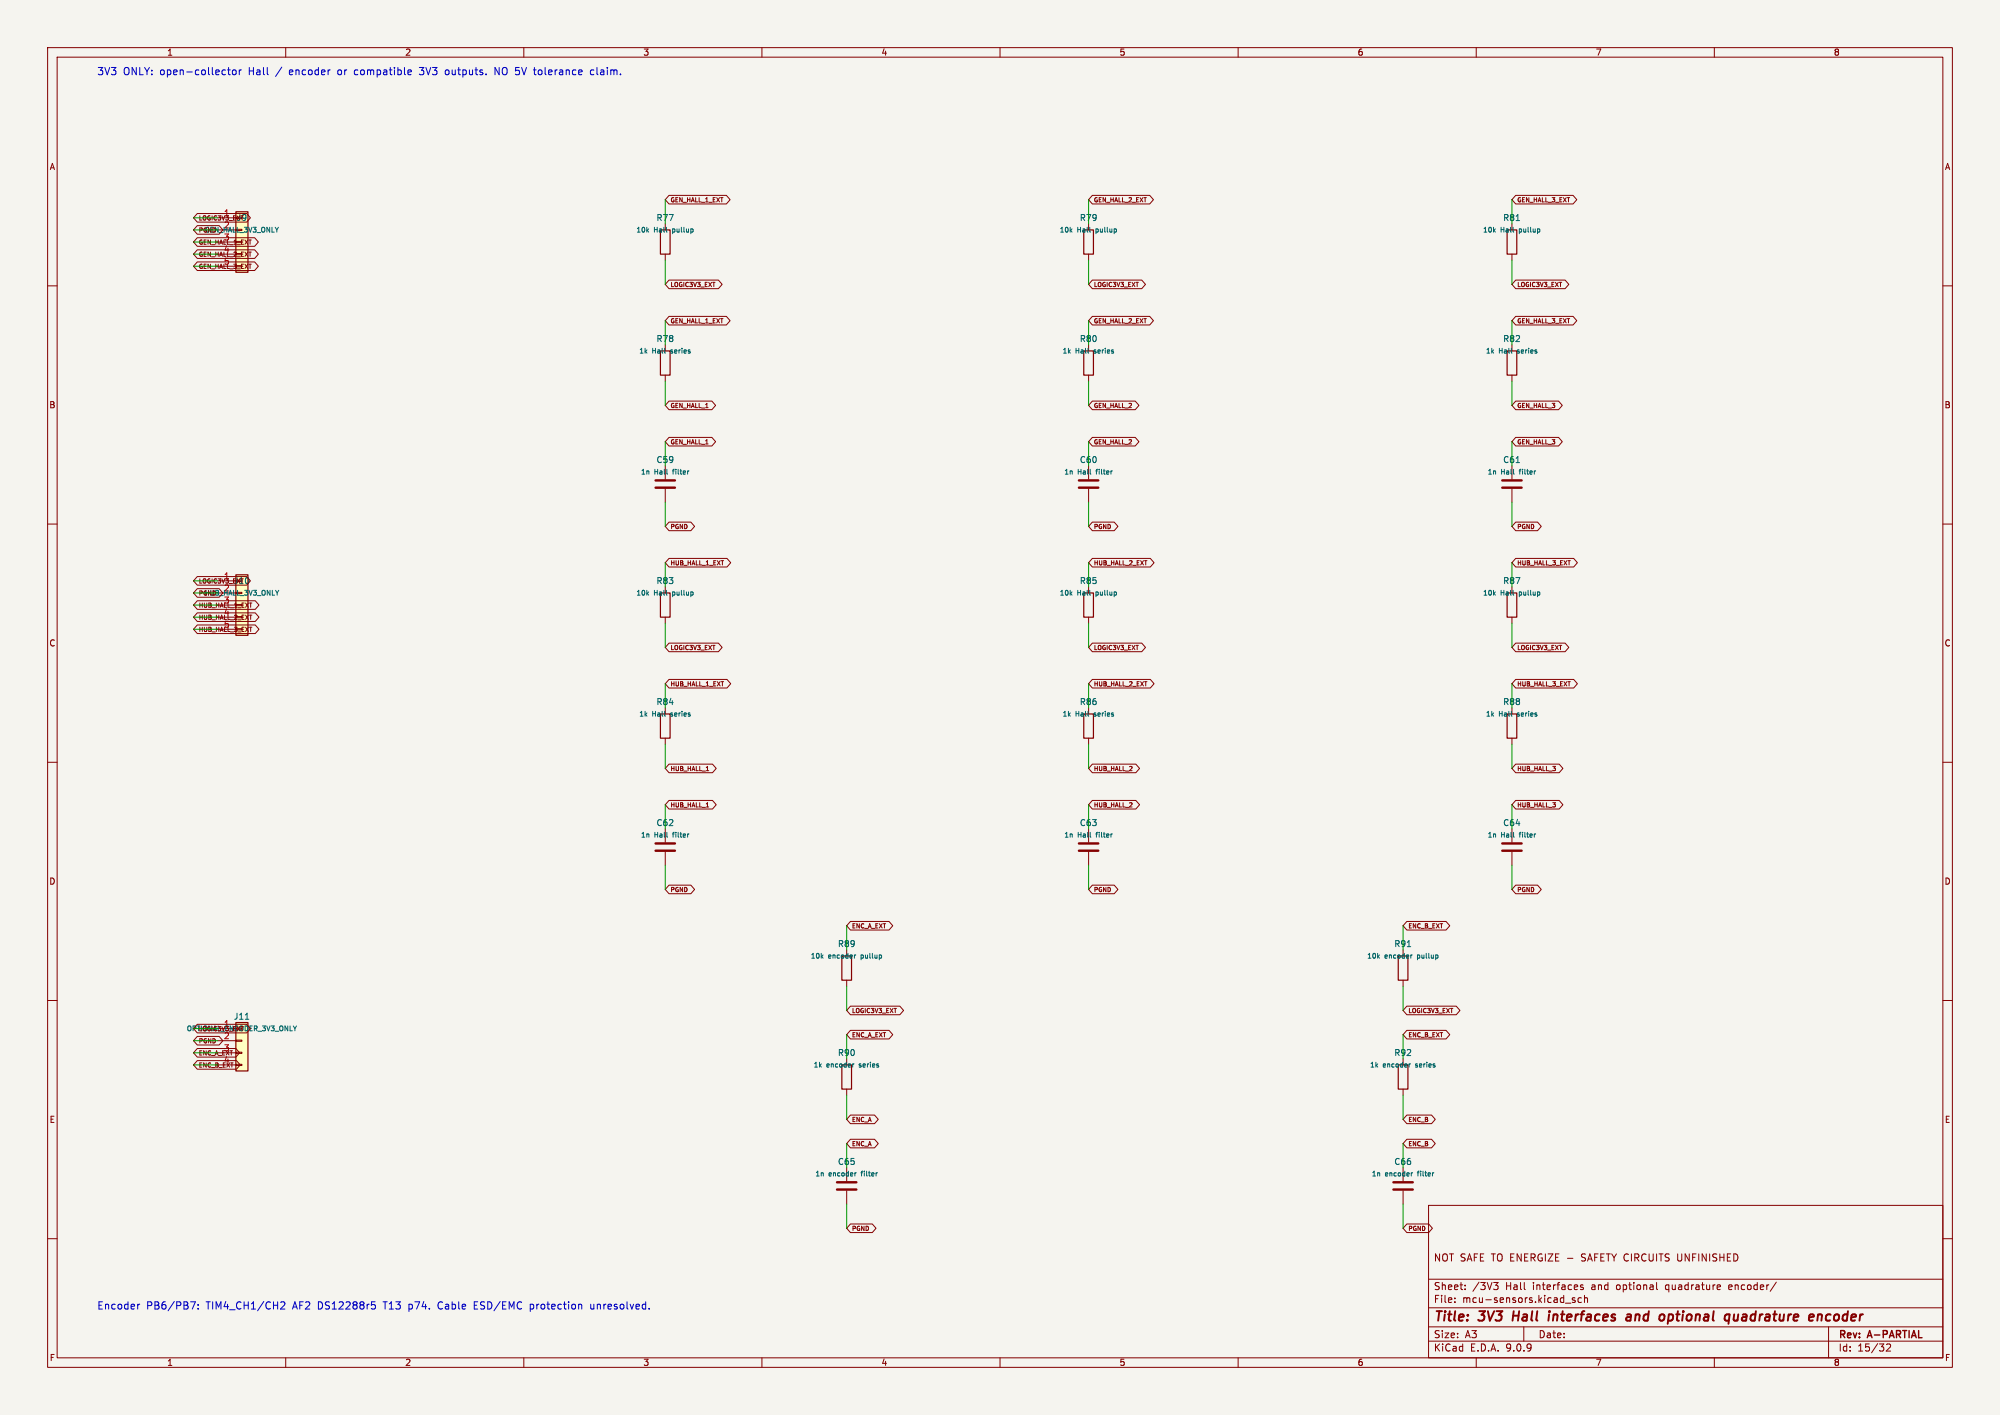
[picture p19: page 15]

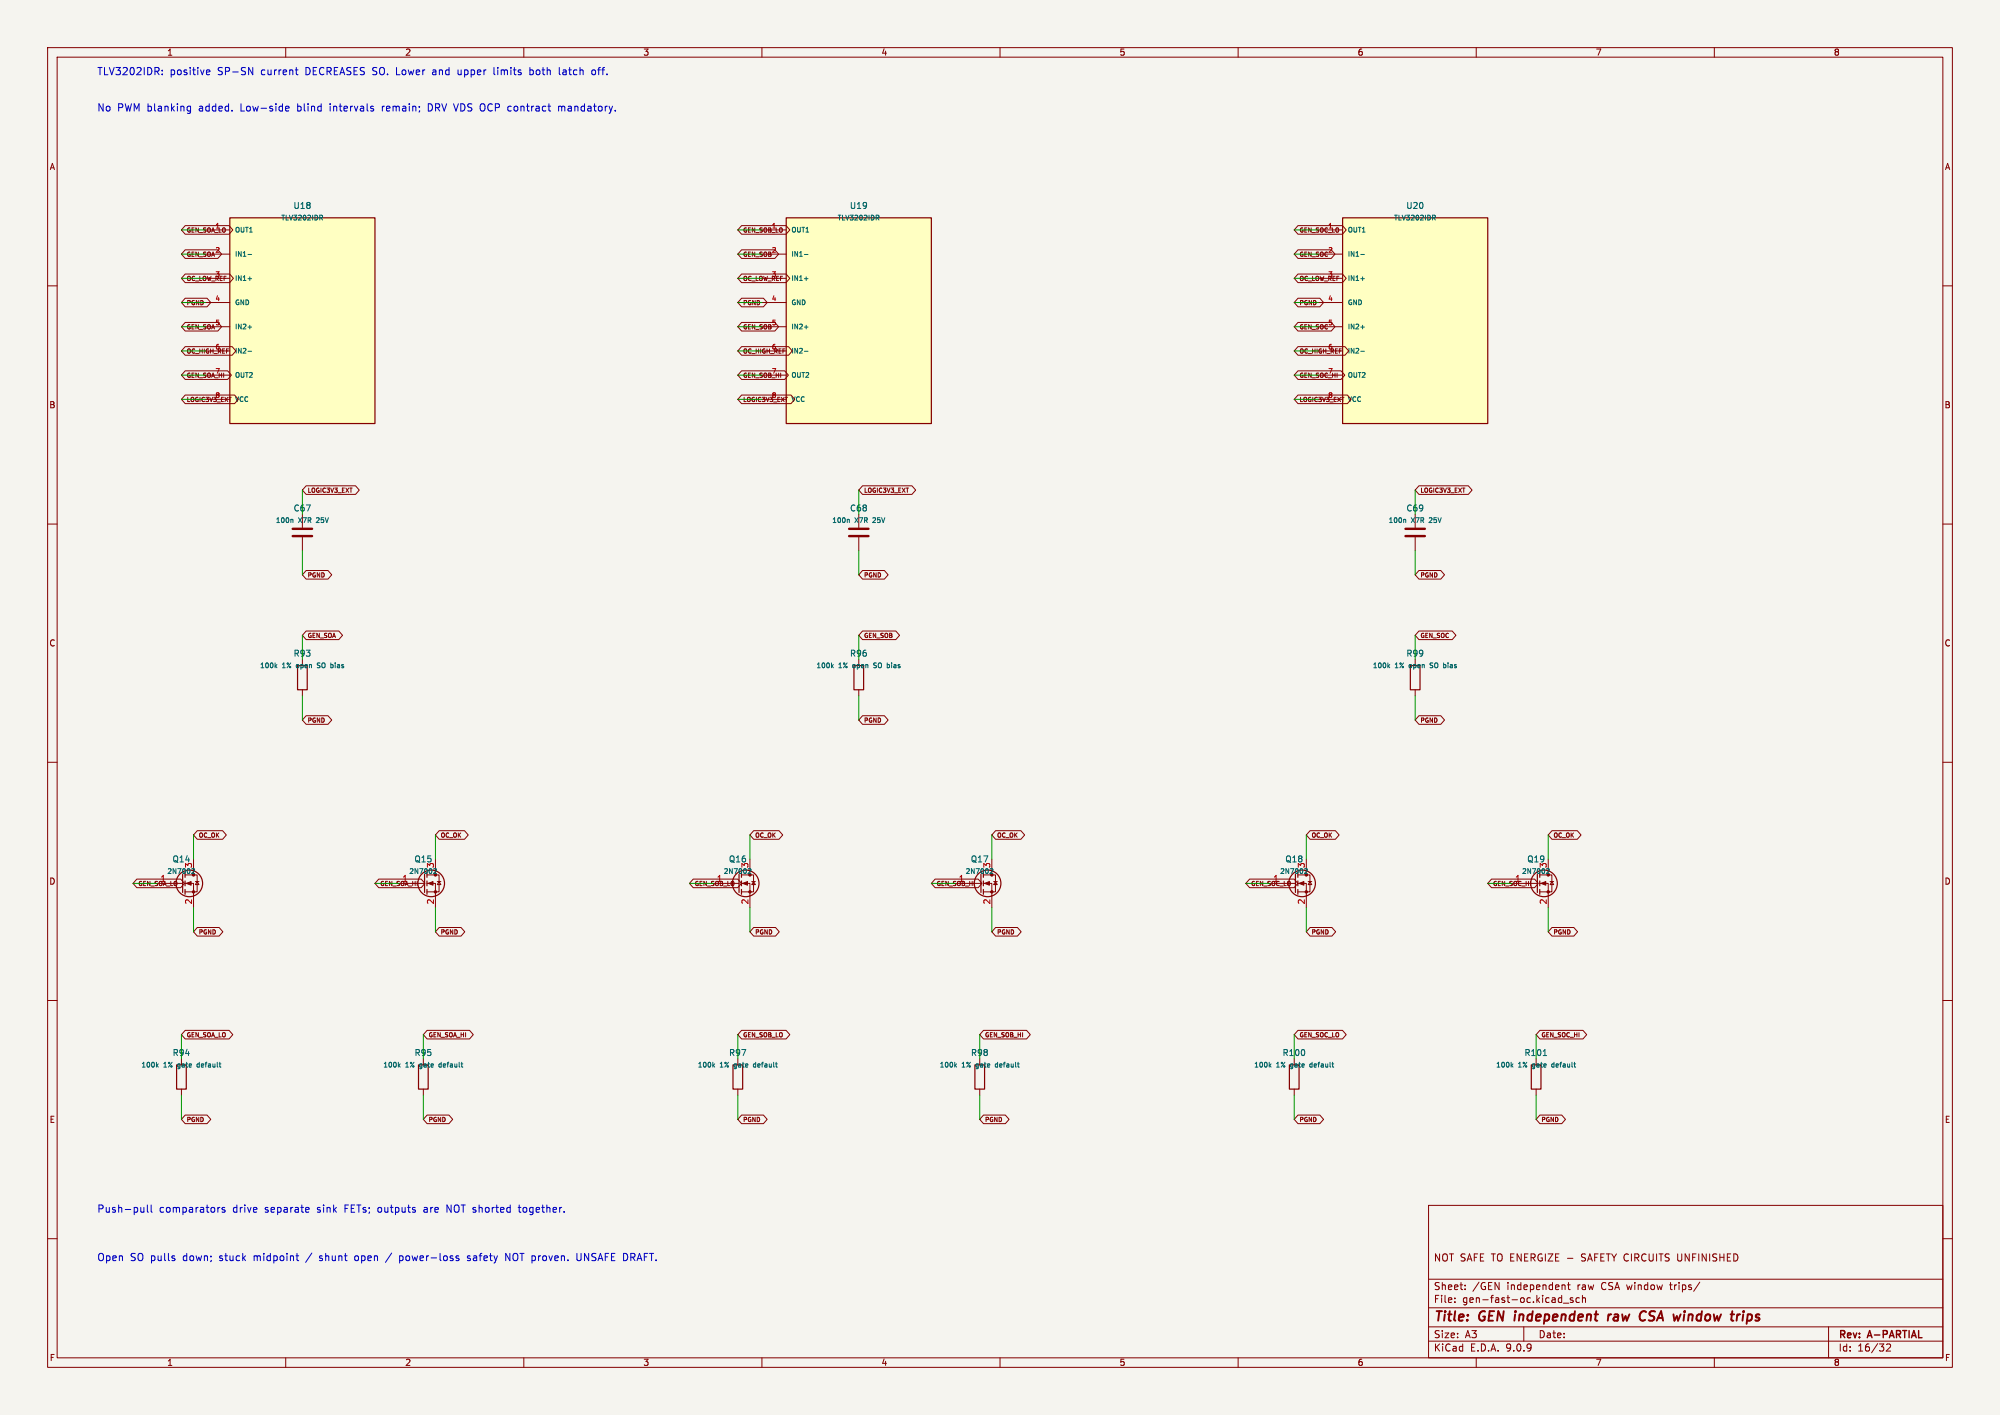
[picture p20: page 16]

TLV3202IDR: positive SP-SN current DECREASES SO. Lower and upper limits both latch off.
PGND OC_LOW_REF GEN_SOA

Id: 16/32 Title: GEN independent raw CSA window trips

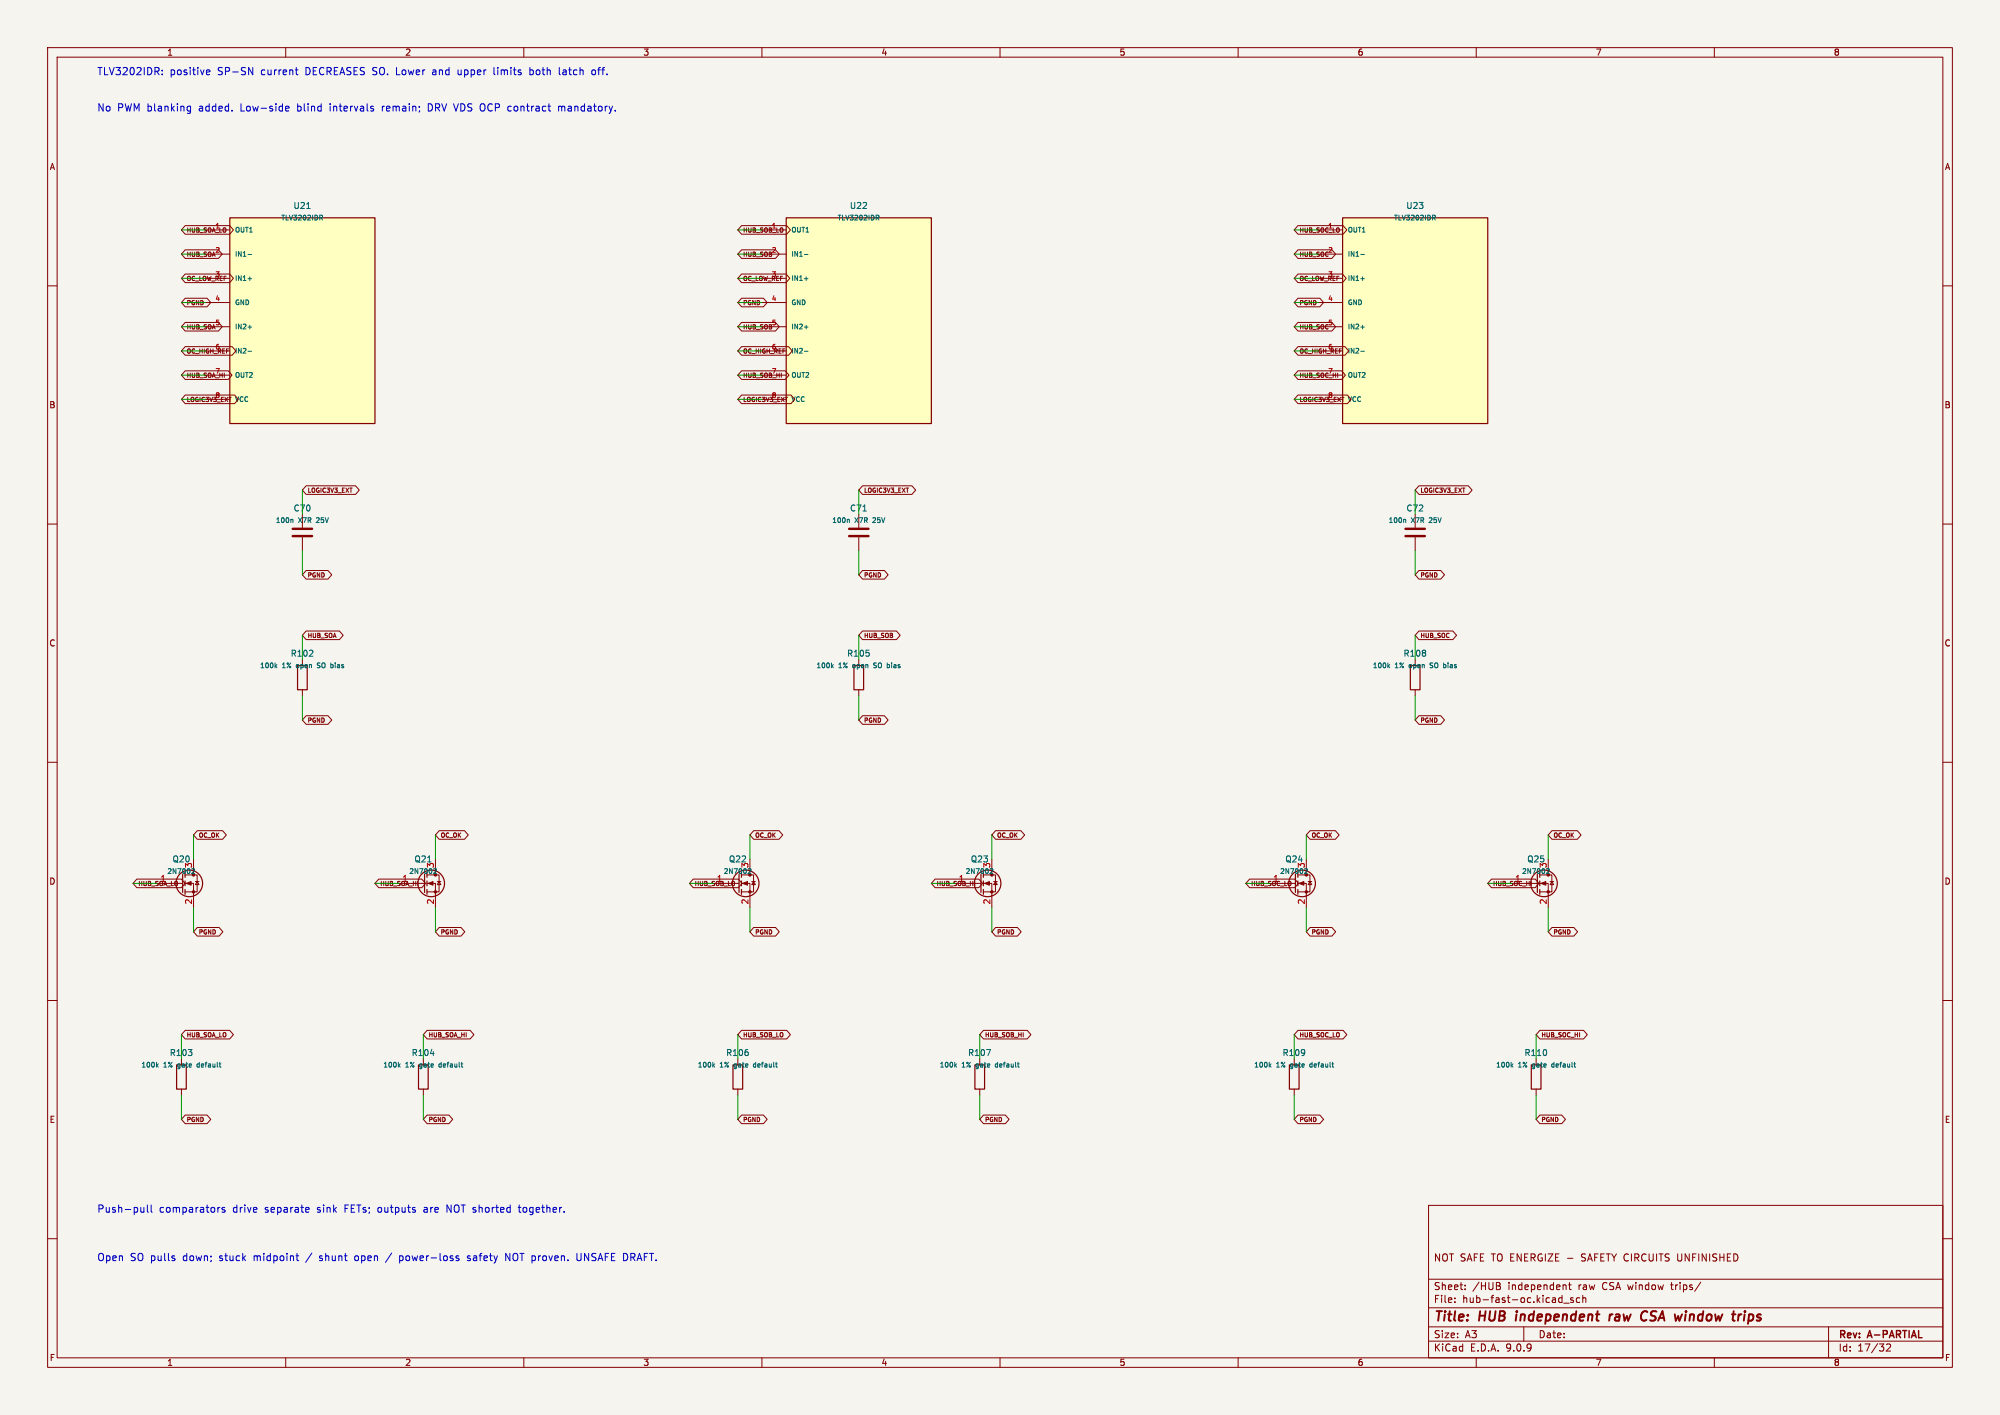
[picture p21: page 17]

TLV3202IDR: positive SP-SN current DECREASES SO. Lower and upper limits both latch off.
PGND OC_LOW_REF HUB_SOA

Id: 17/32 Title: HUB independent raw CSA window trips

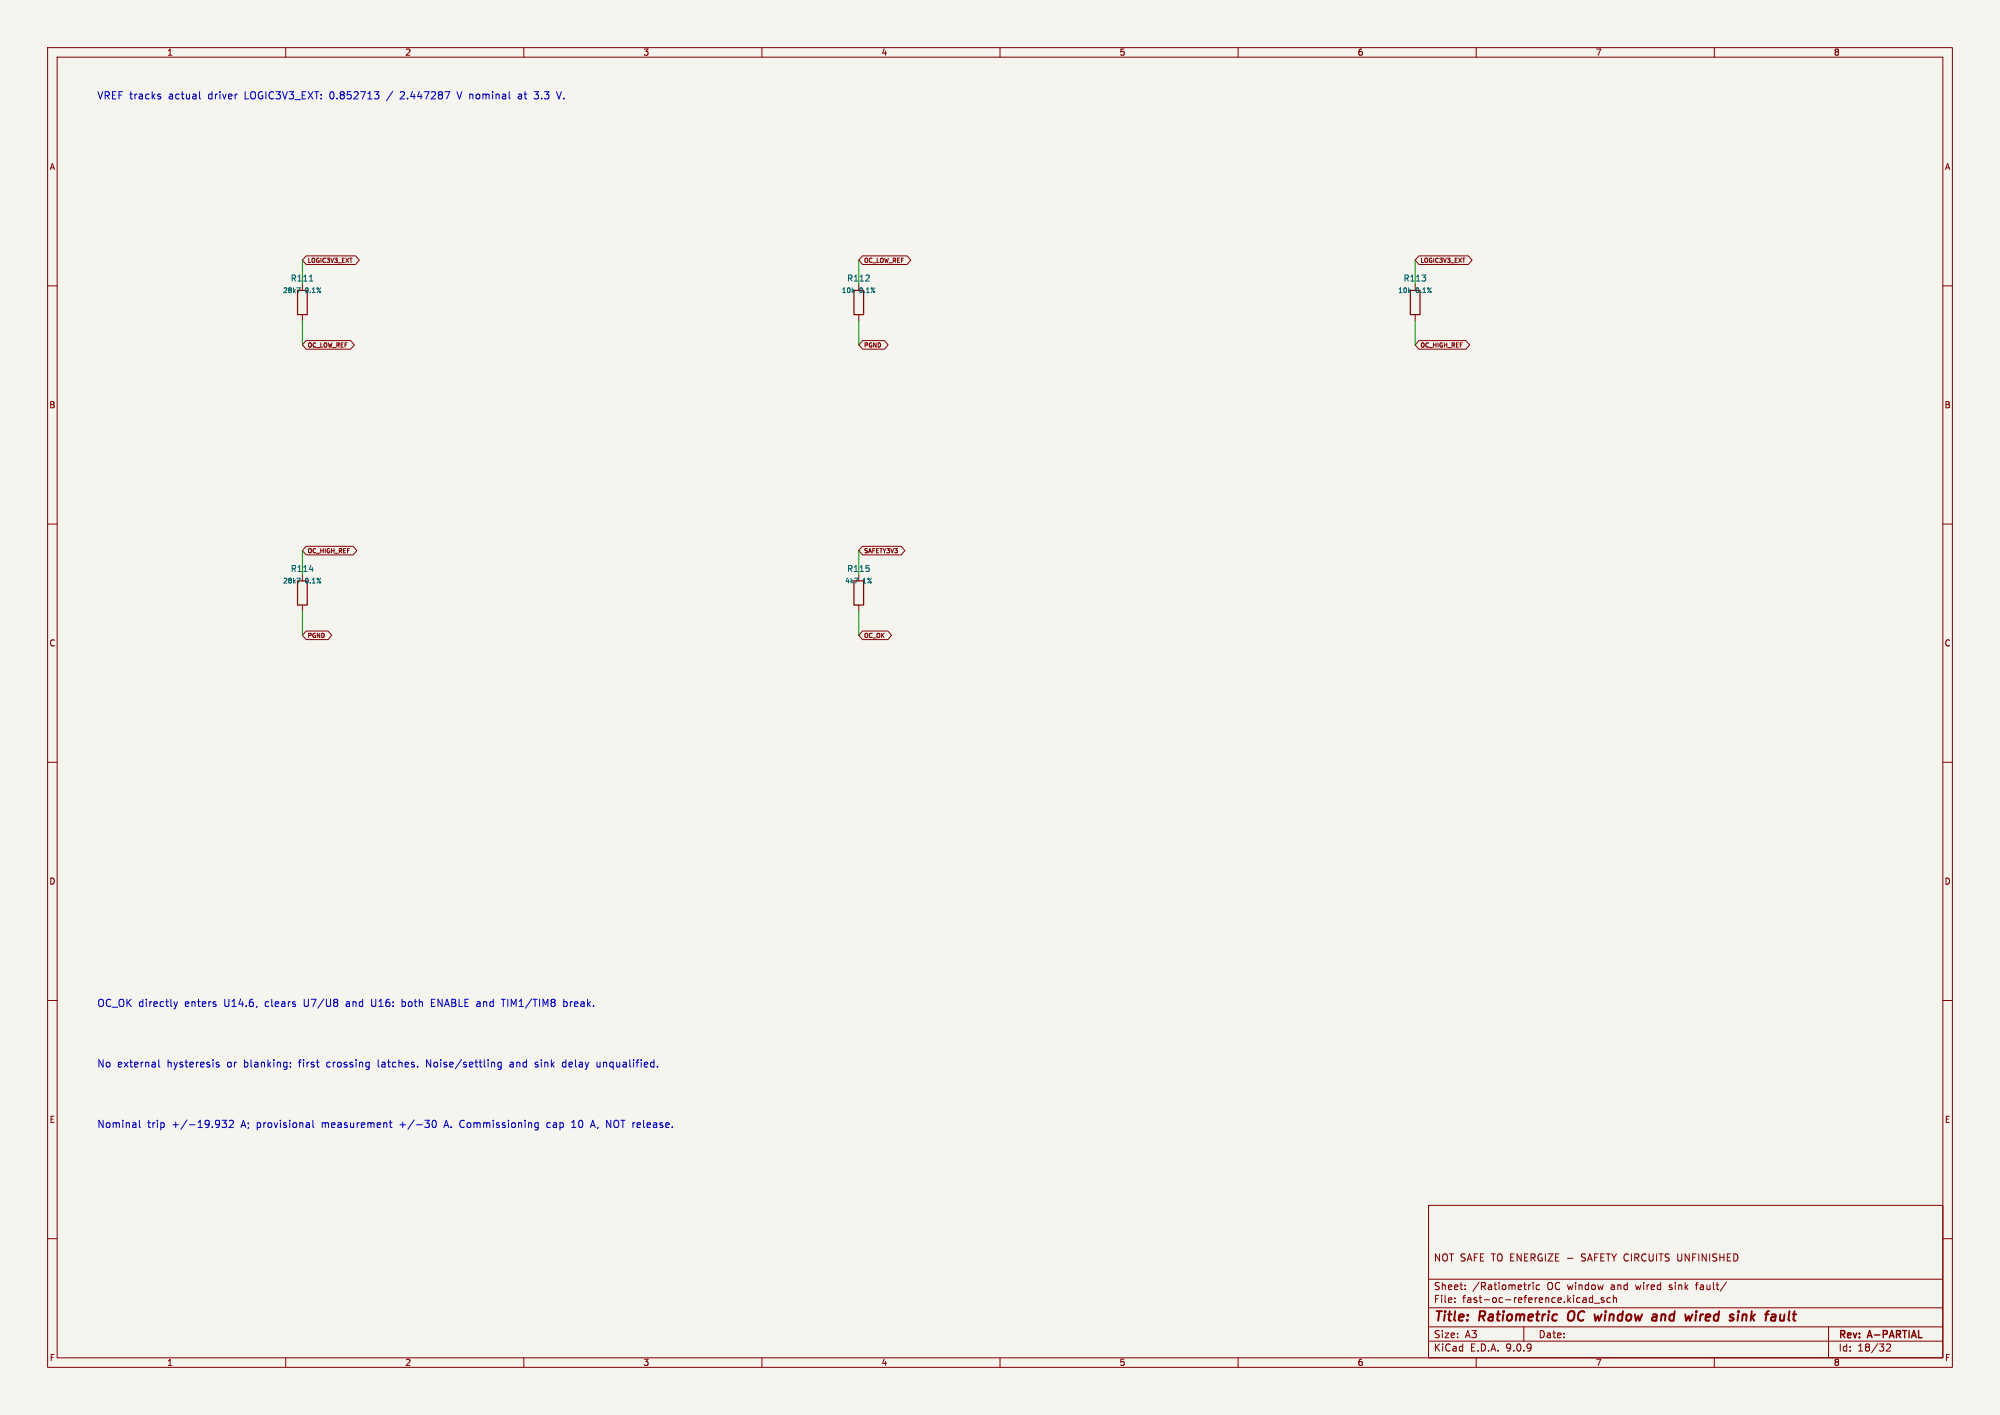
[picture p22: page 18]

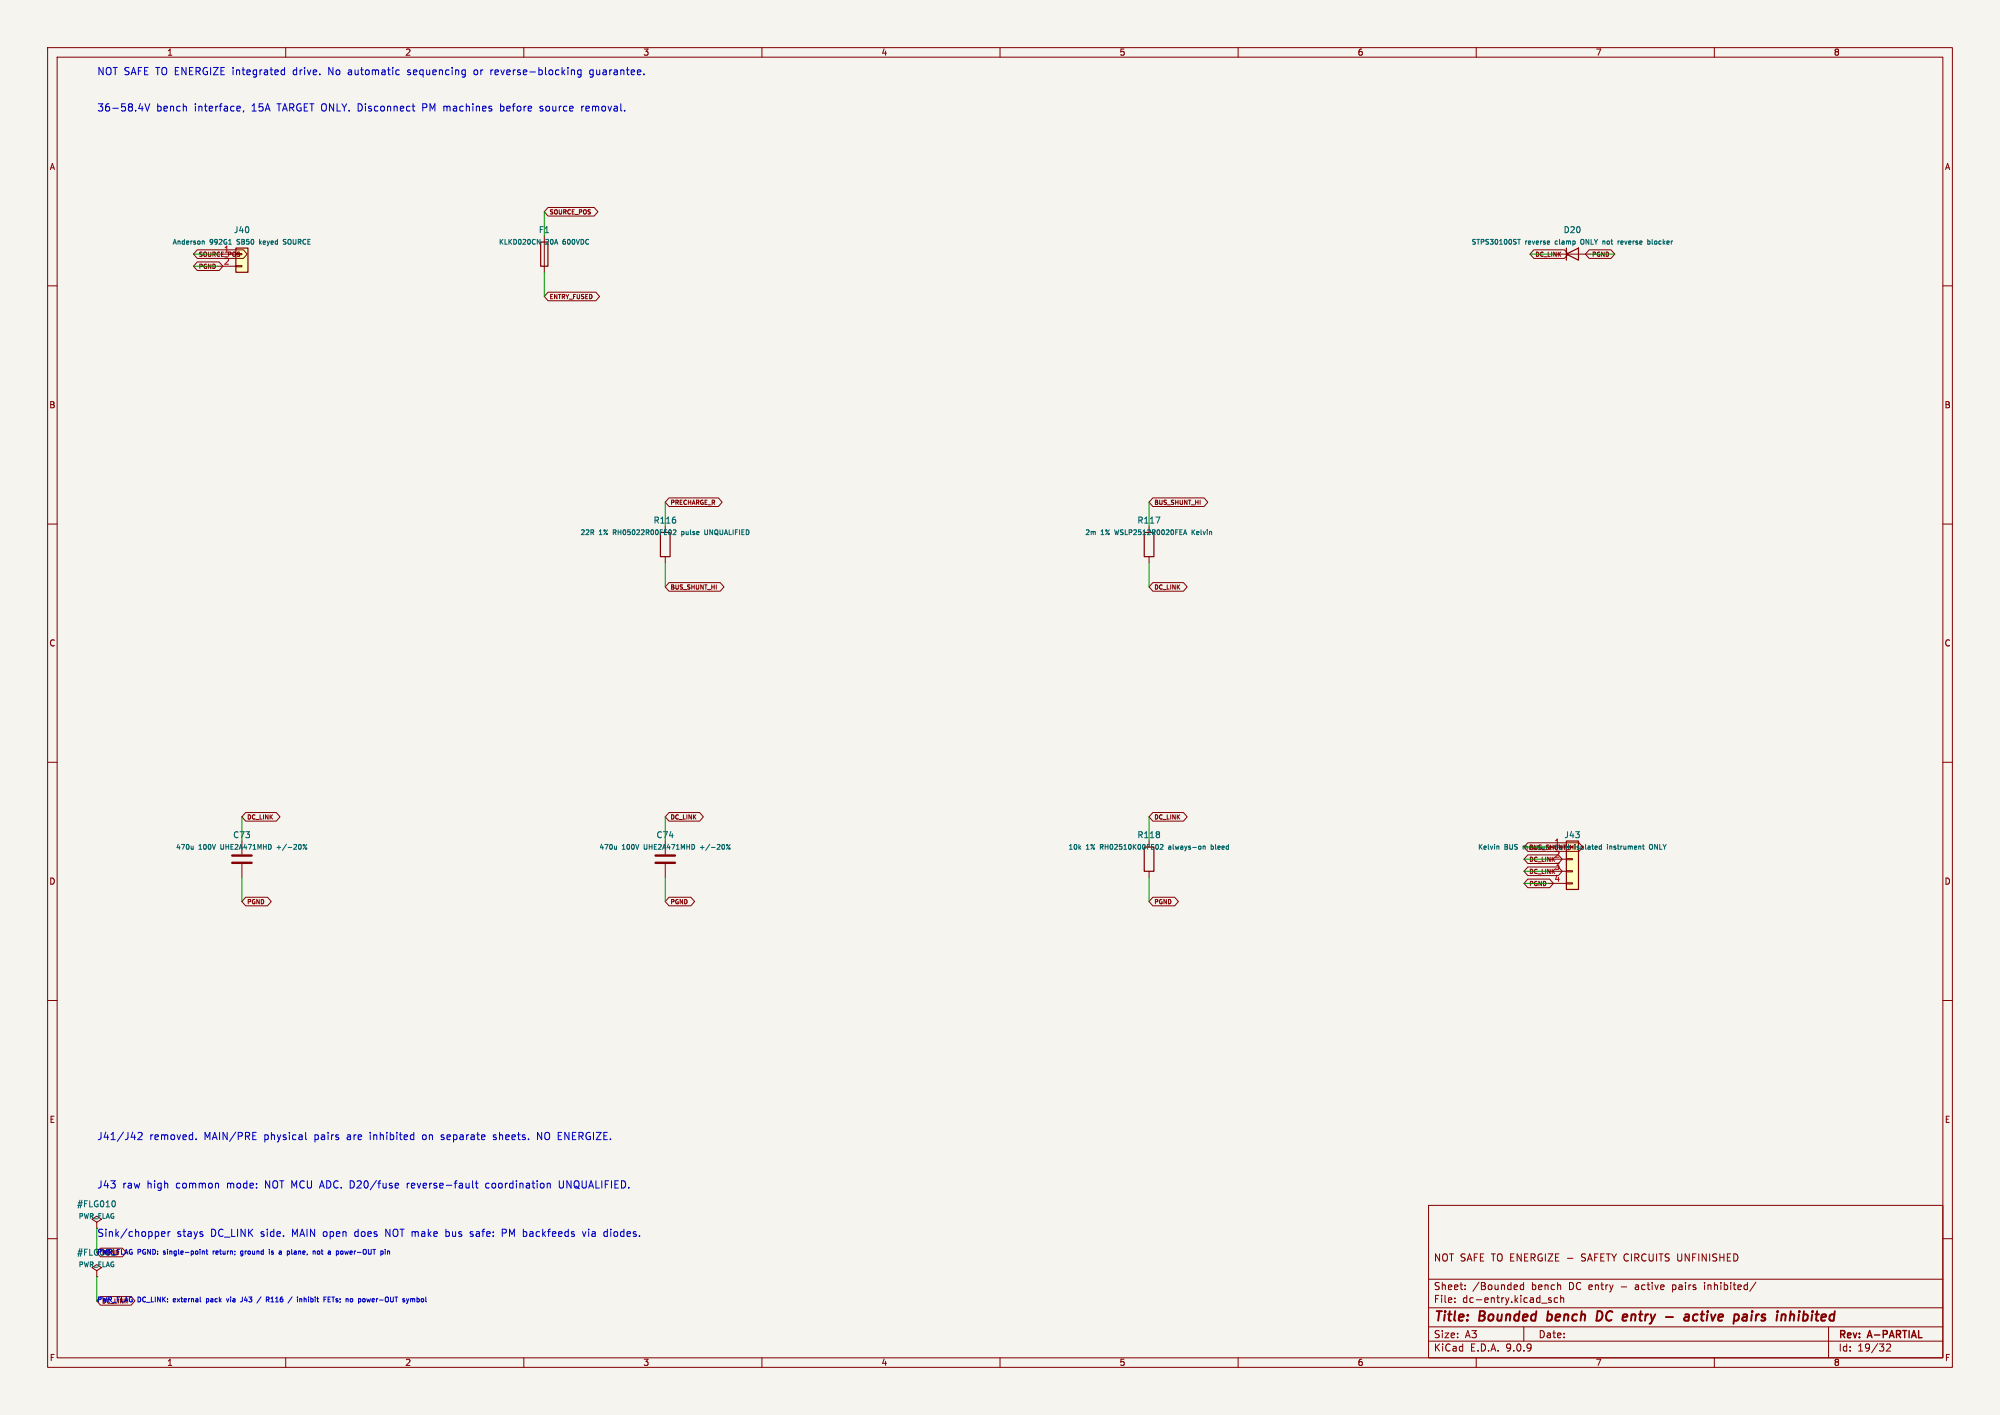
[picture p23: page 19]

STPS30100ST reverse clamp ONLY not reverse blocker C74

Id: 19/32 Title: Bounded bench DC entry - active pairs inhibited

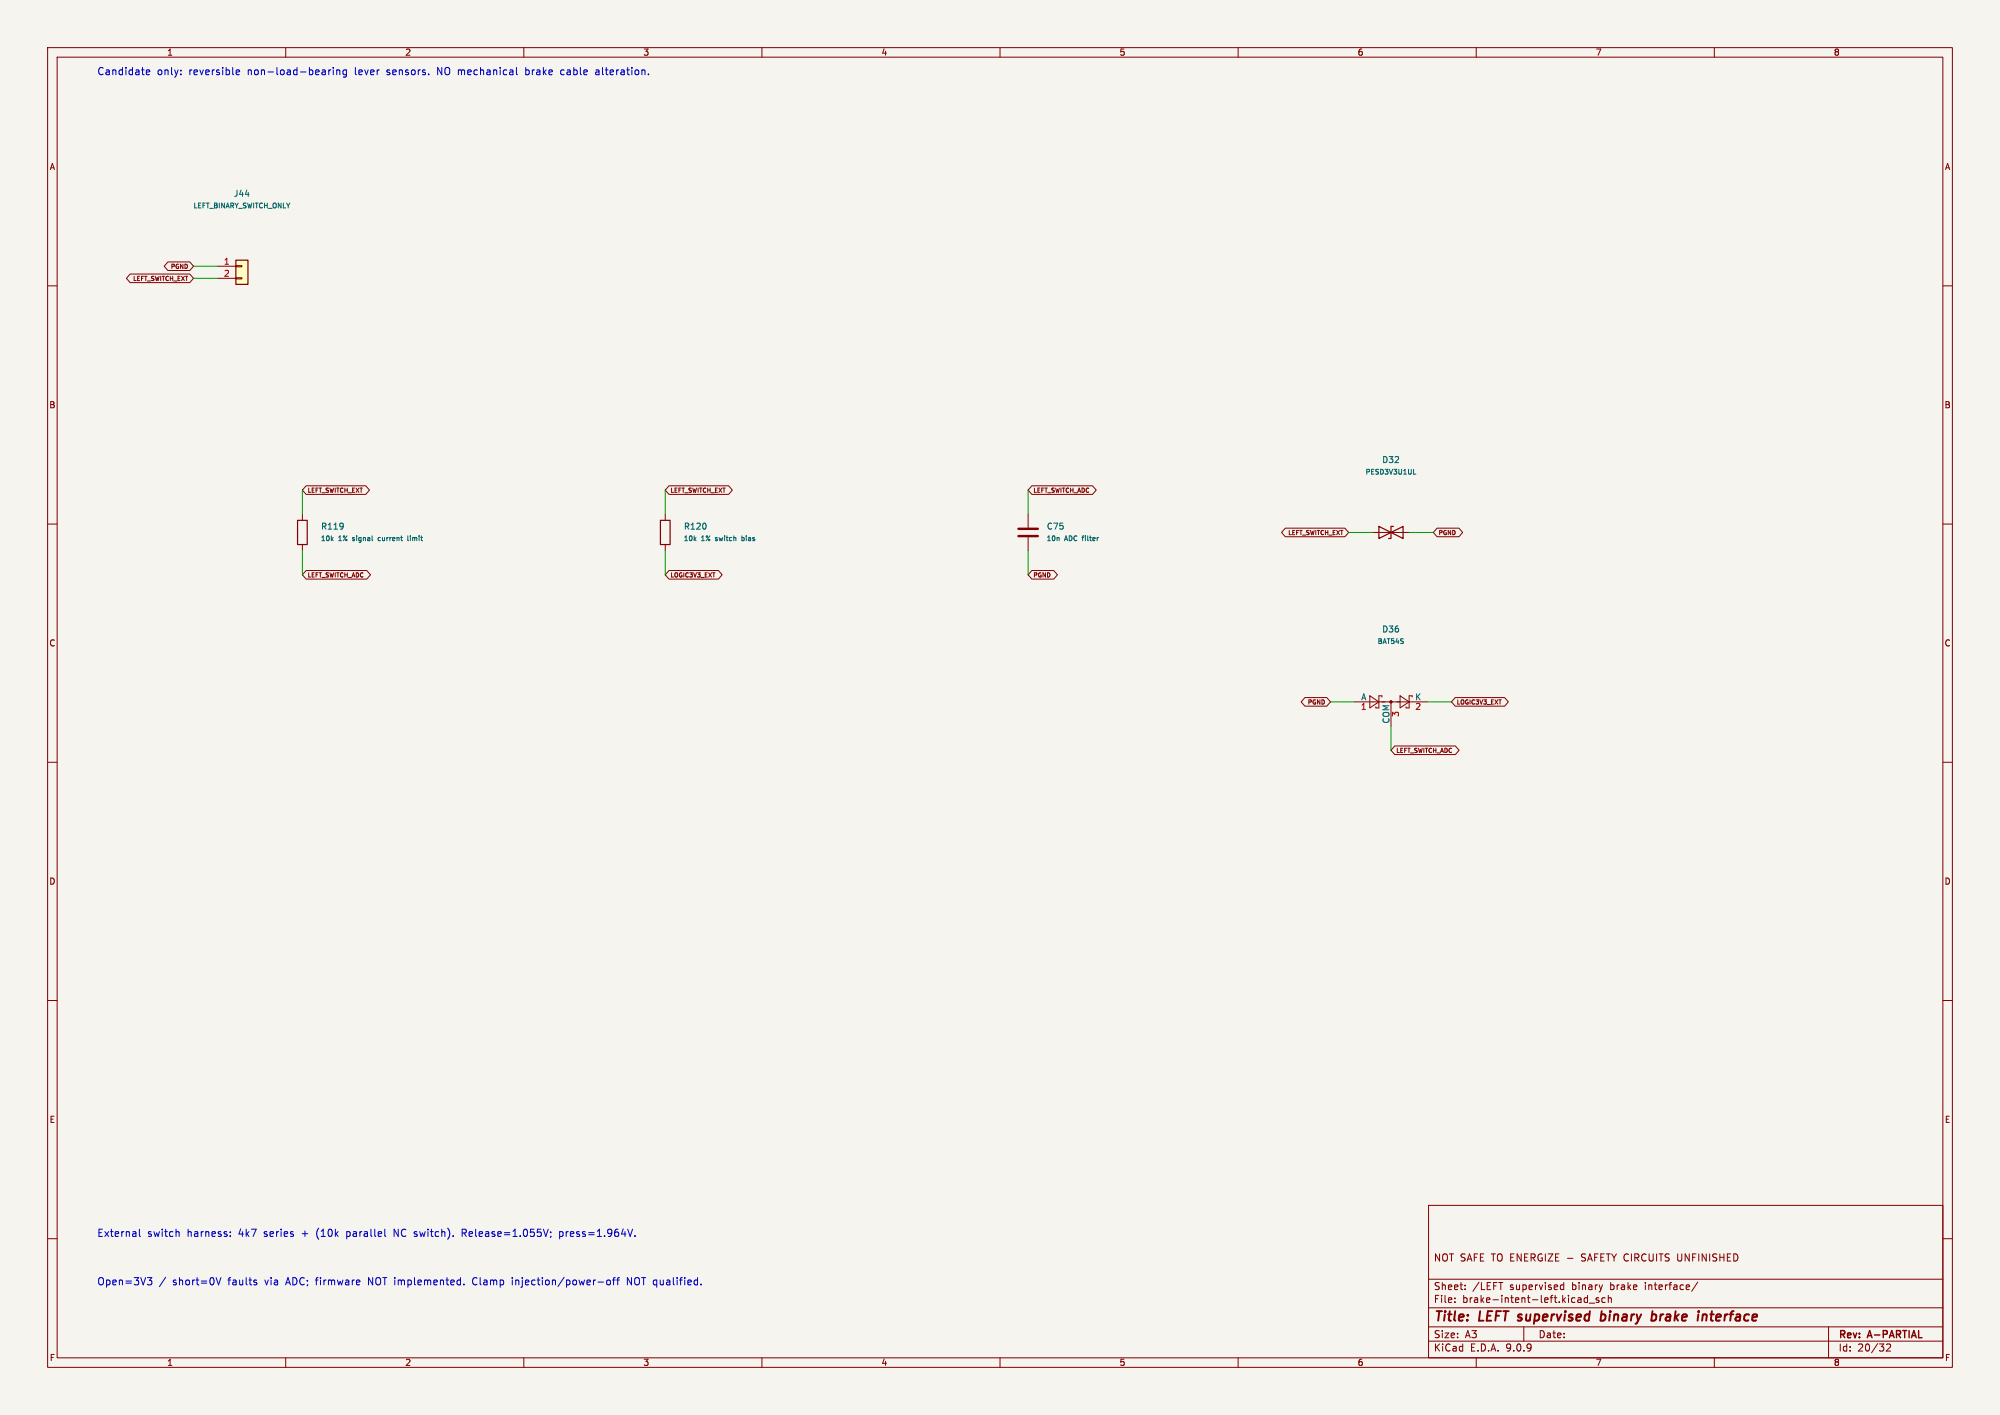
[picture p24: page 20]

Id: 20/32 Title: LEFT supervised binary brake interface

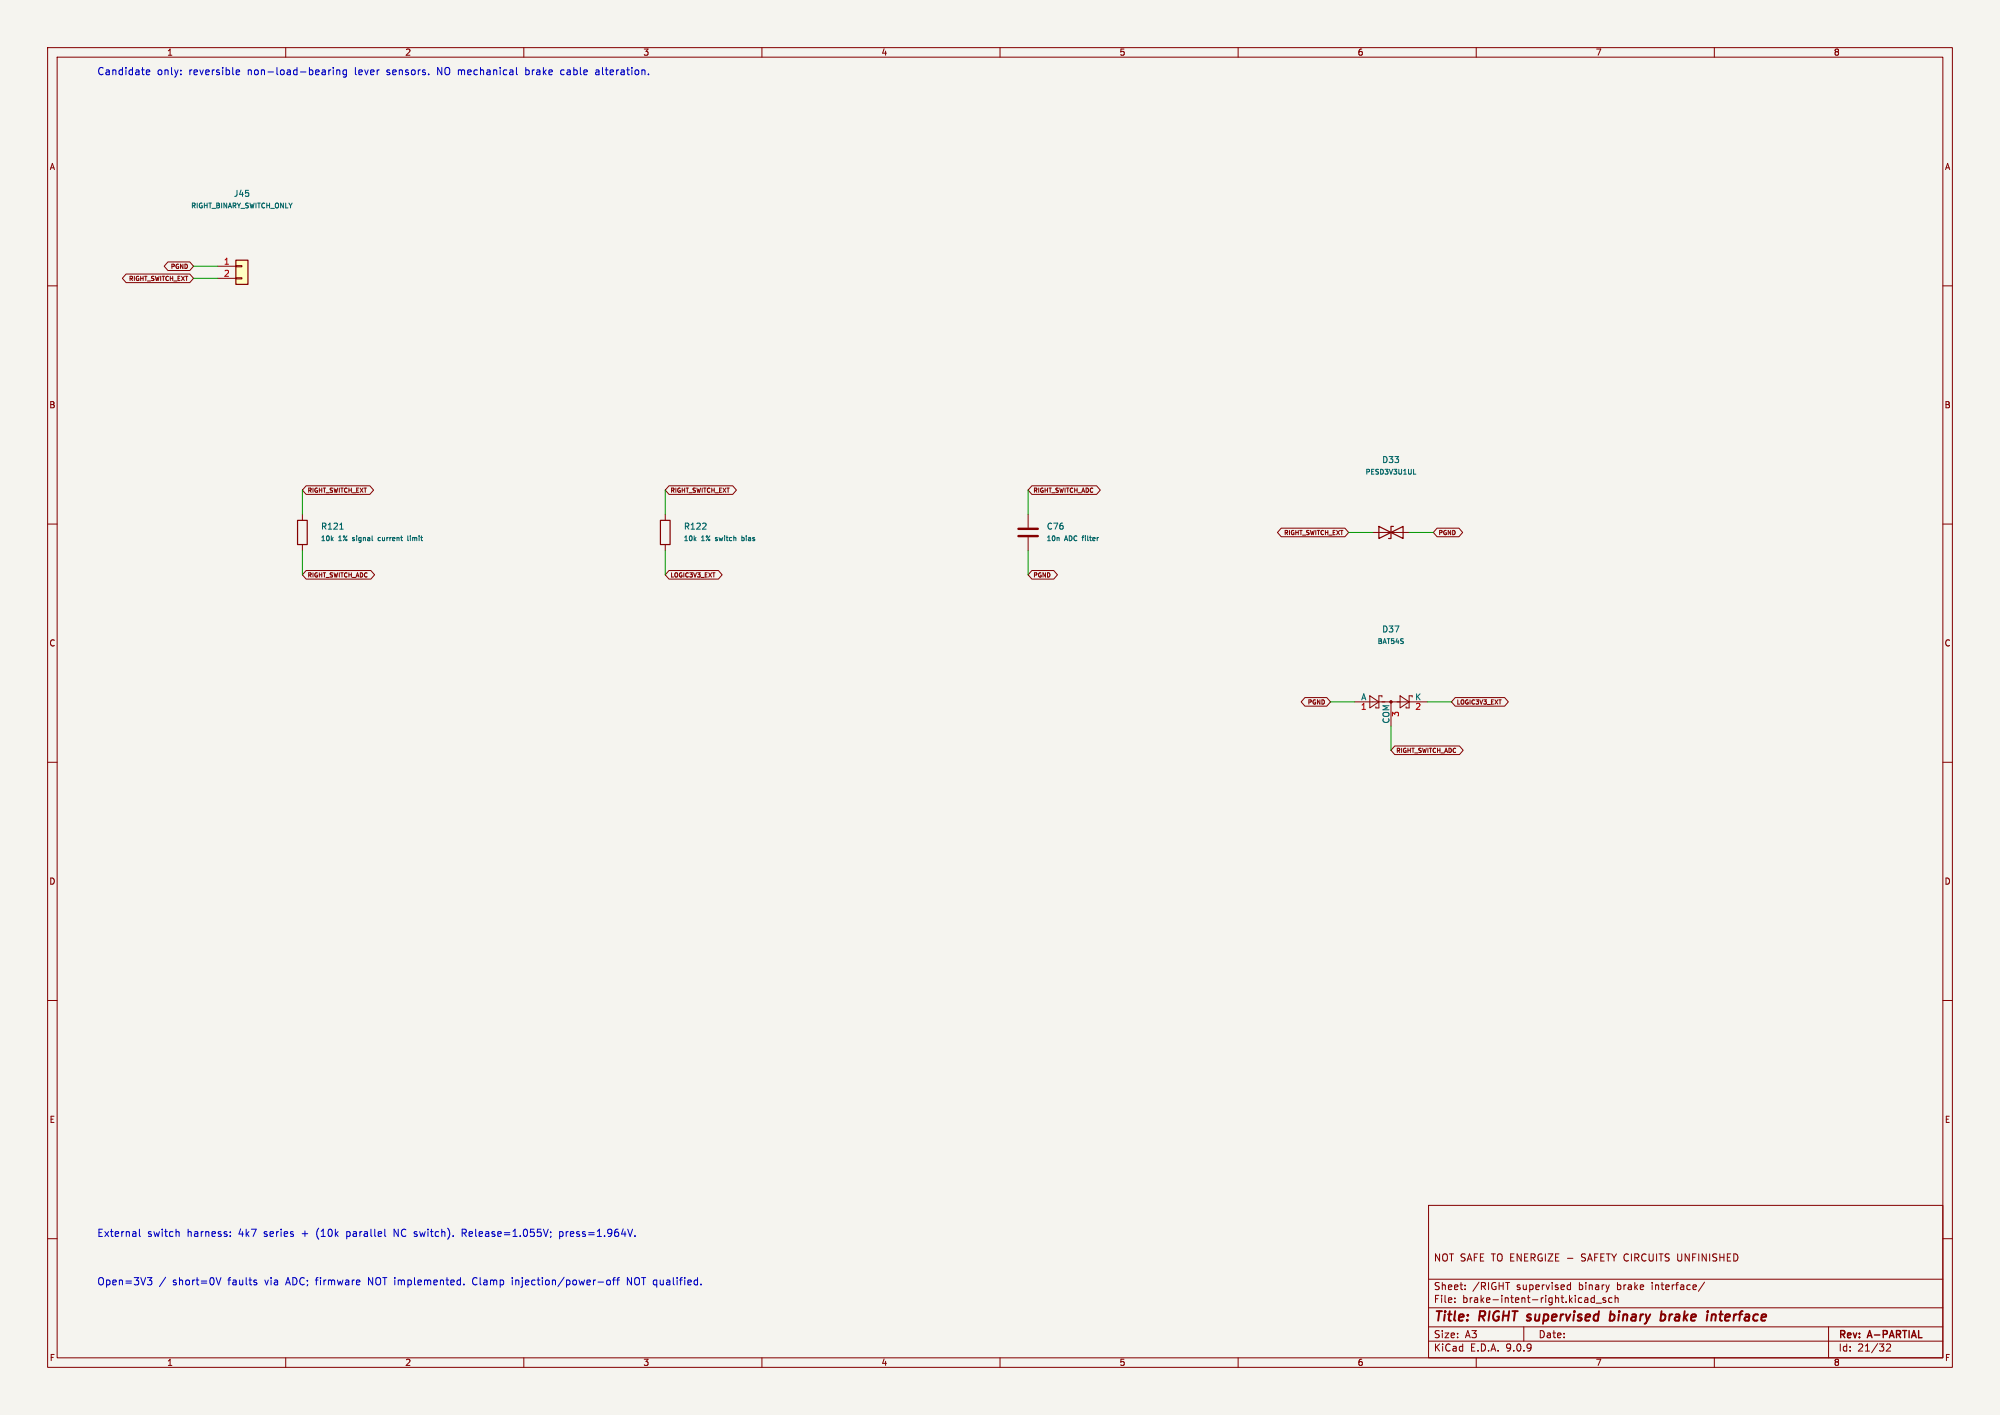
[picture p25: page 21]

Id: 21/32 Title: RIGHT supervised binary brake interface

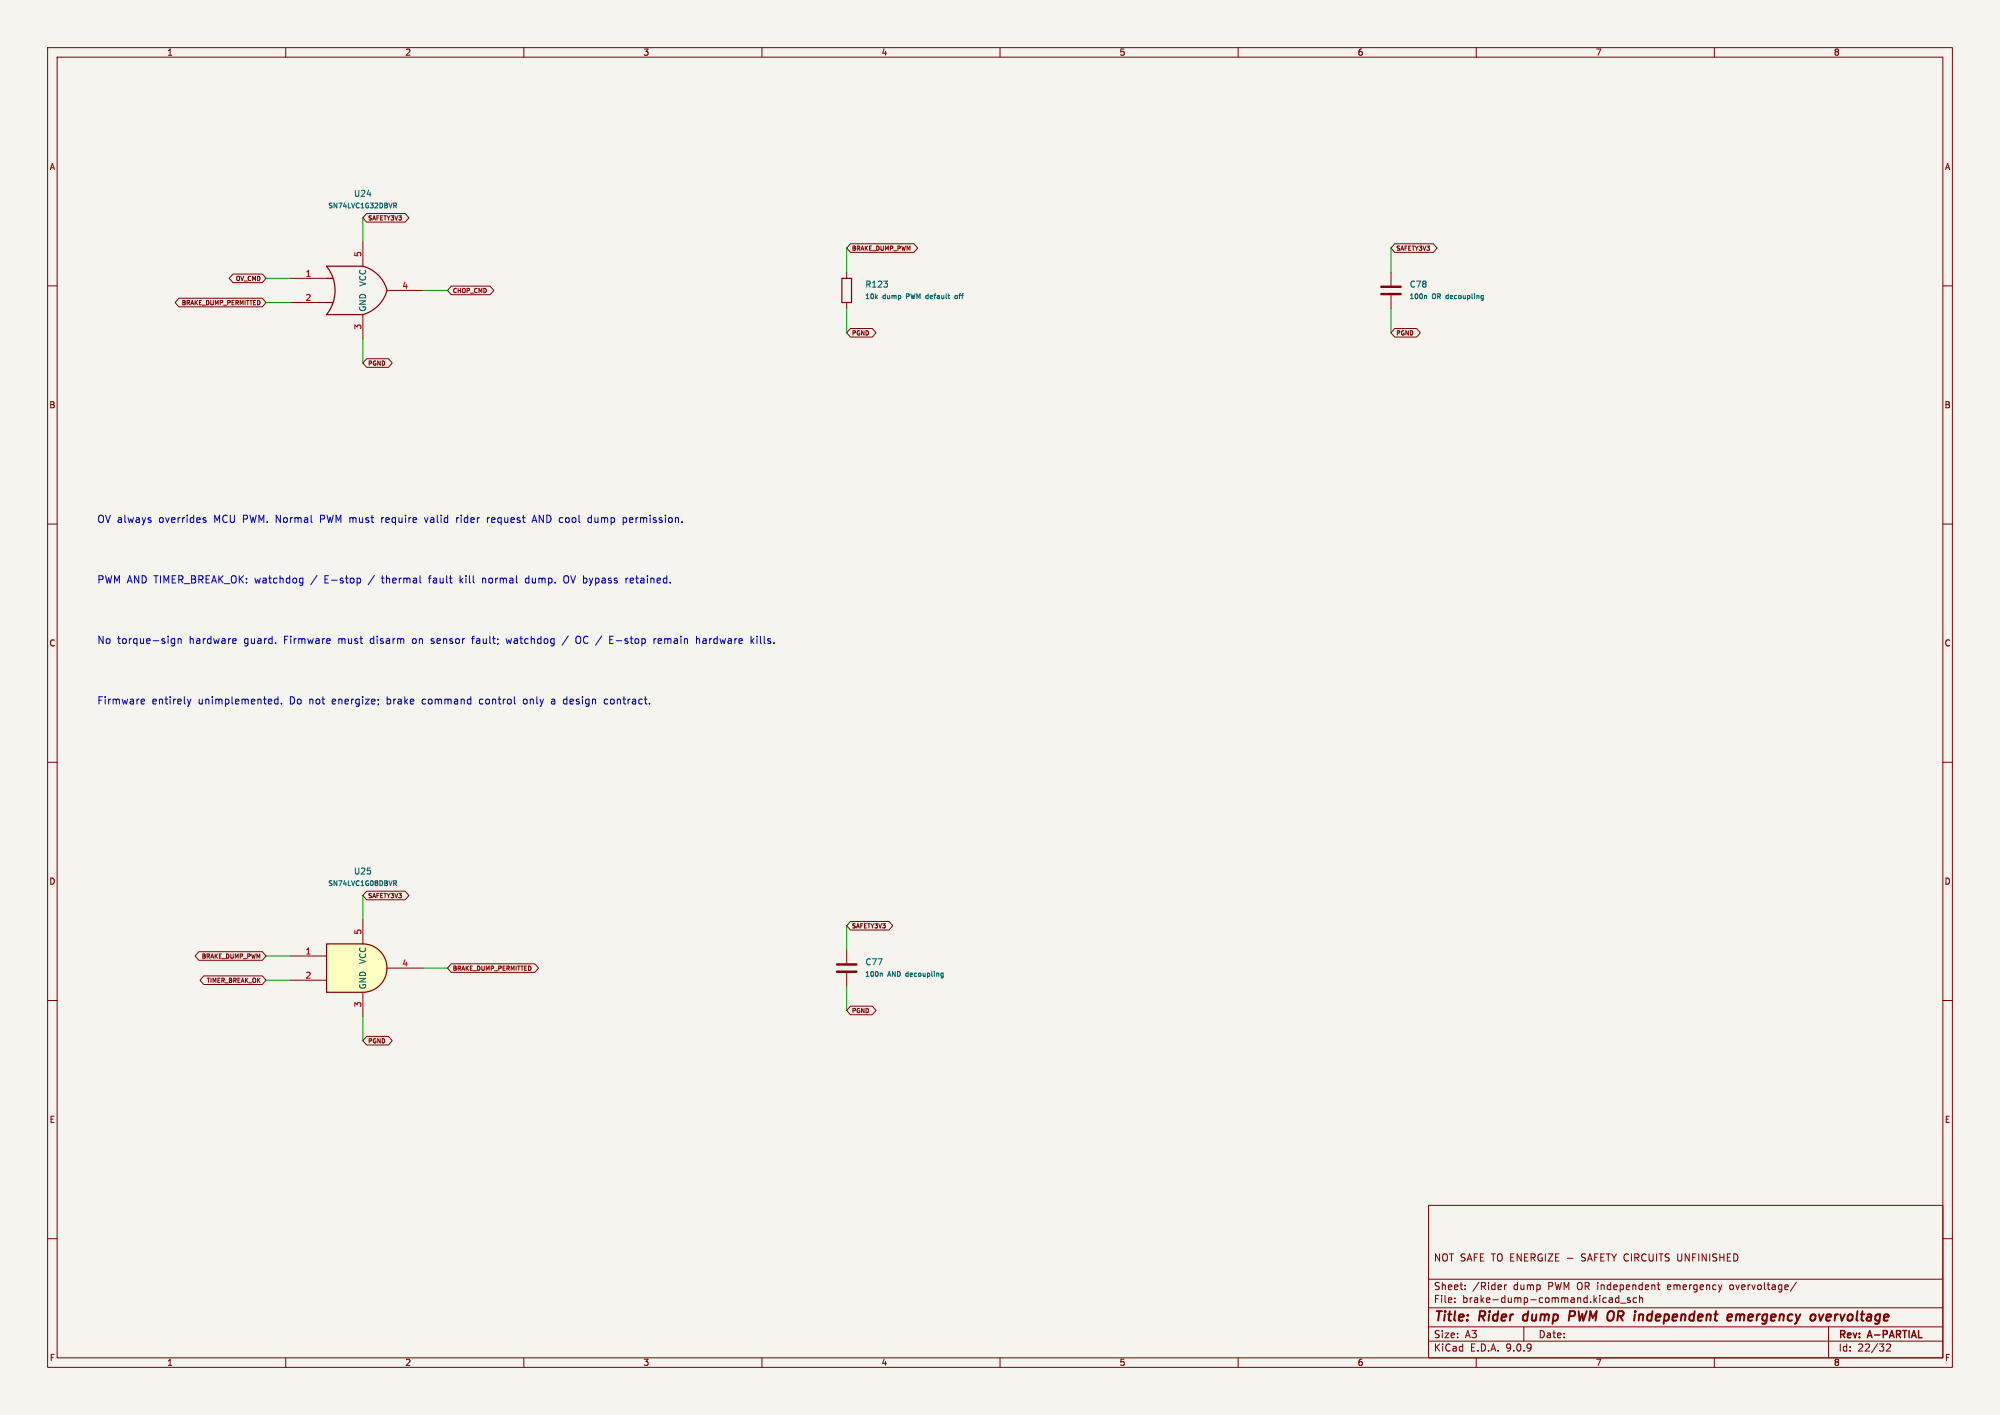
[picture p26: page 22]

Id: 22/32 Title: Rider dump PWM OR independent emergency overvoltage

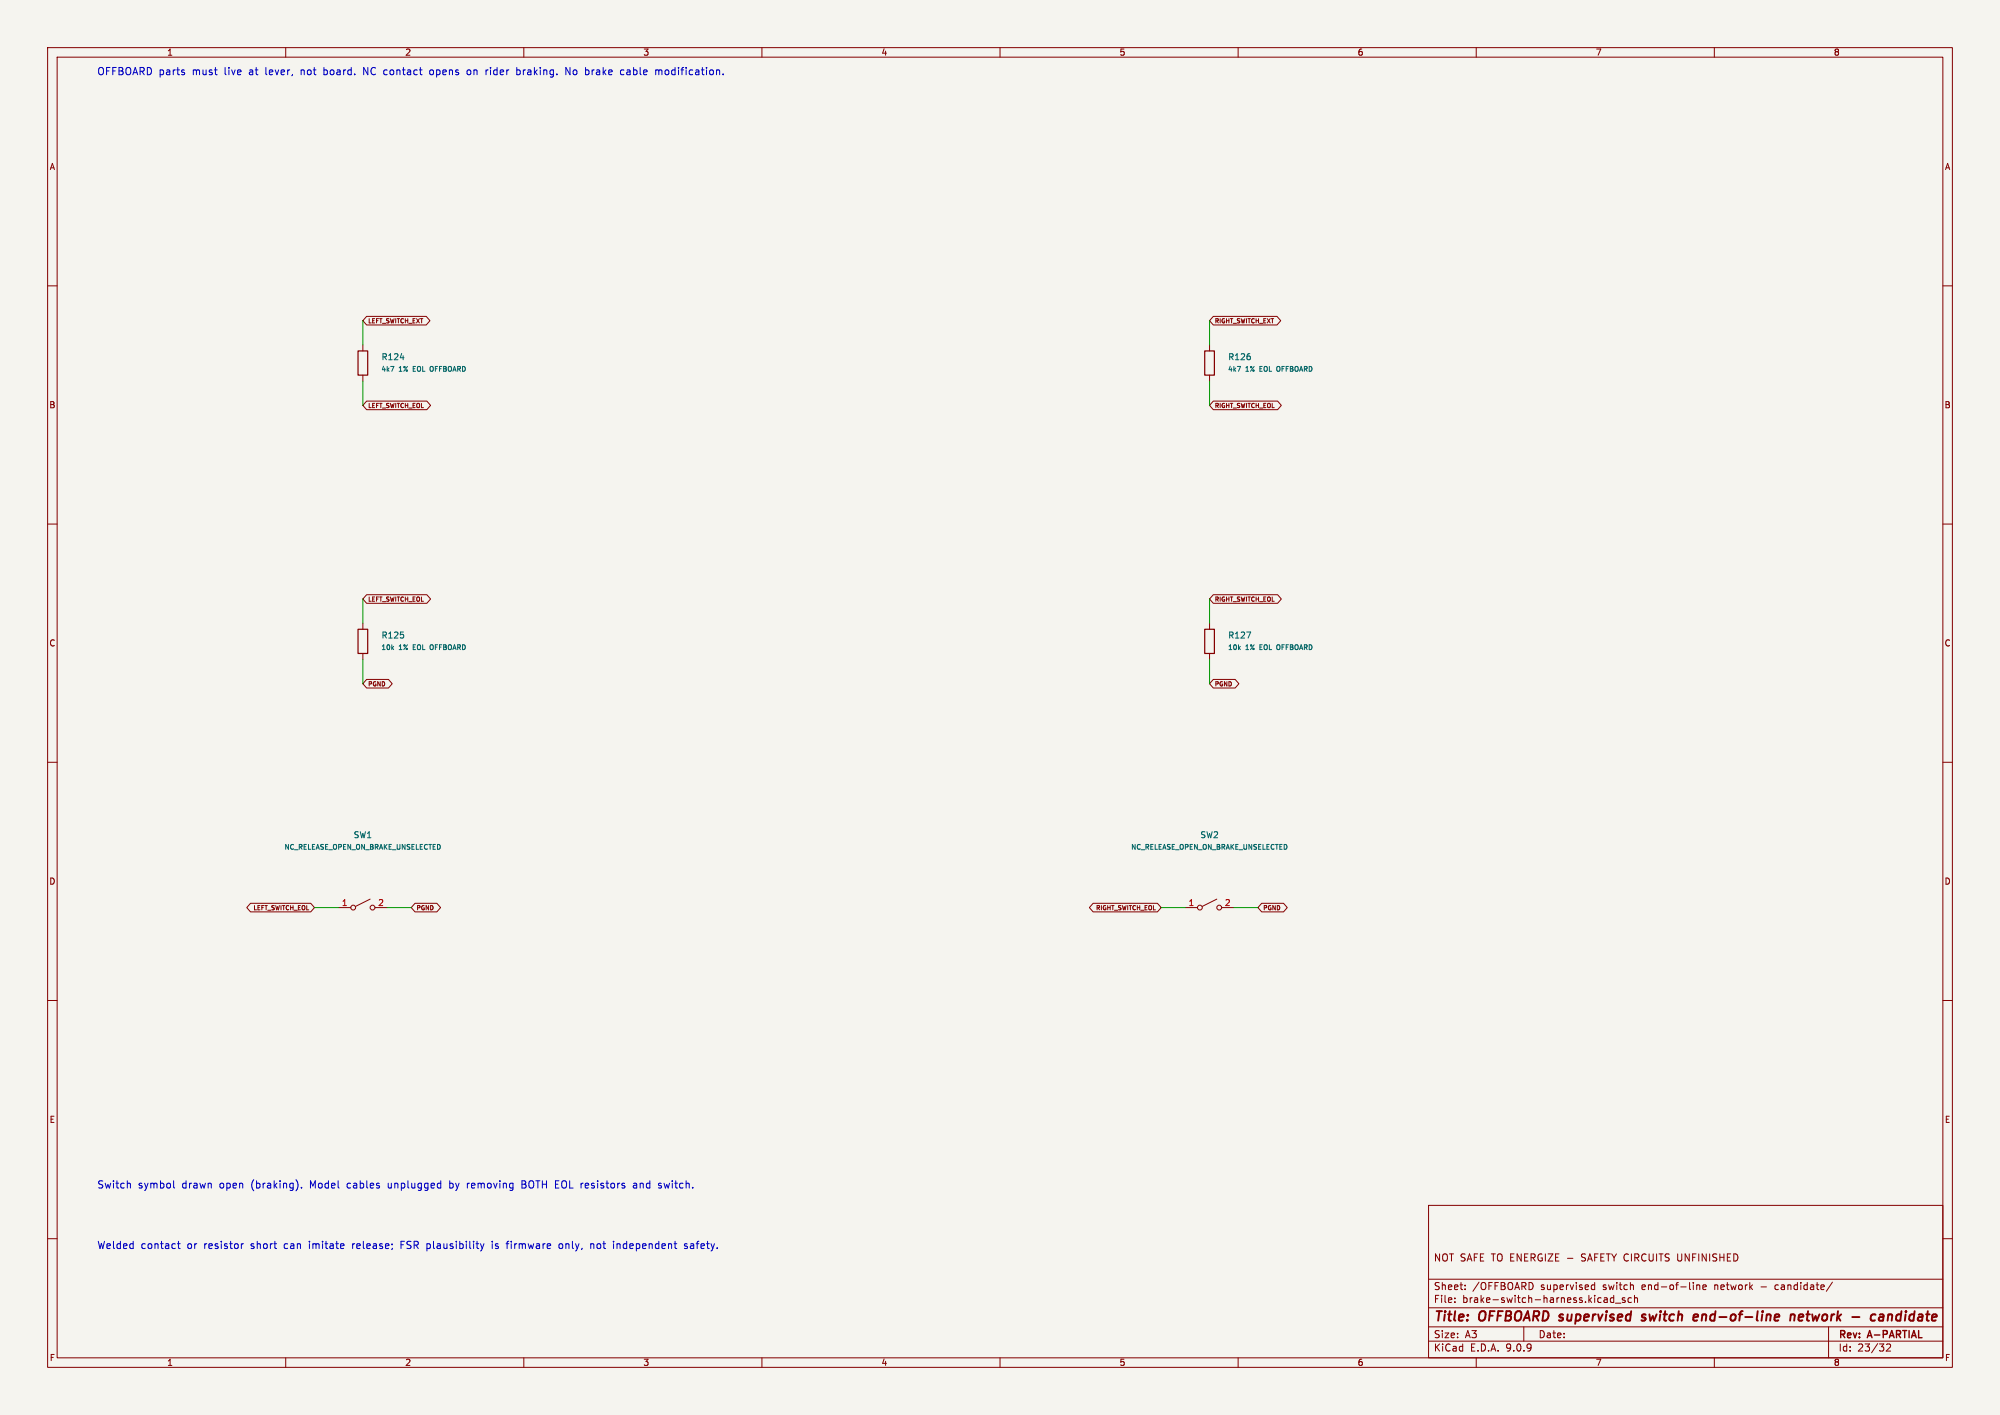
[picture p27: page 23]

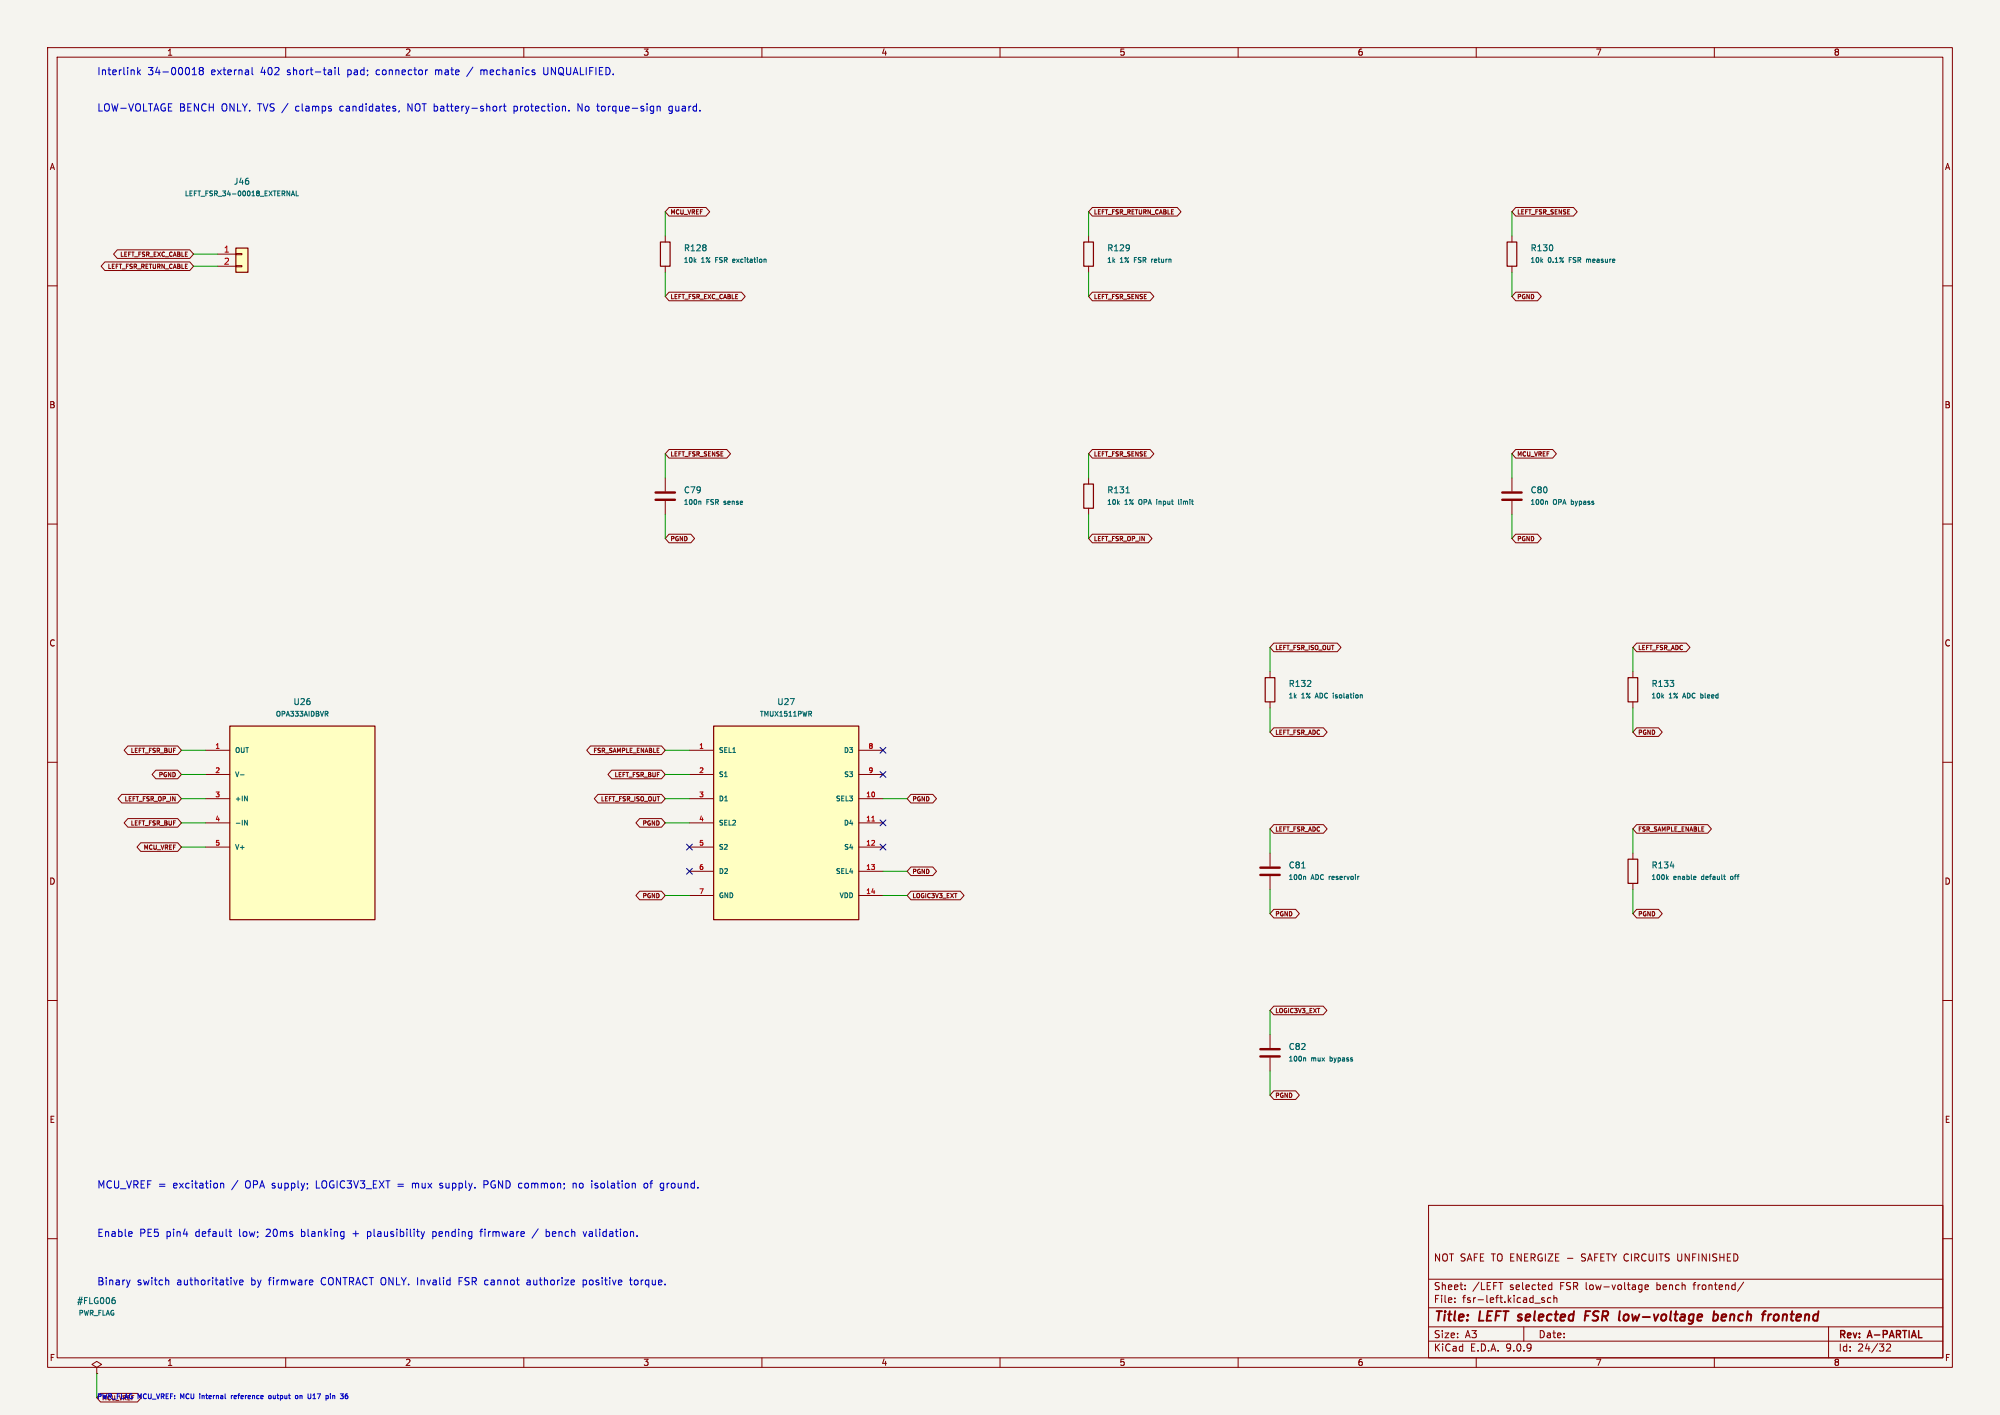
[picture p28: page 24]

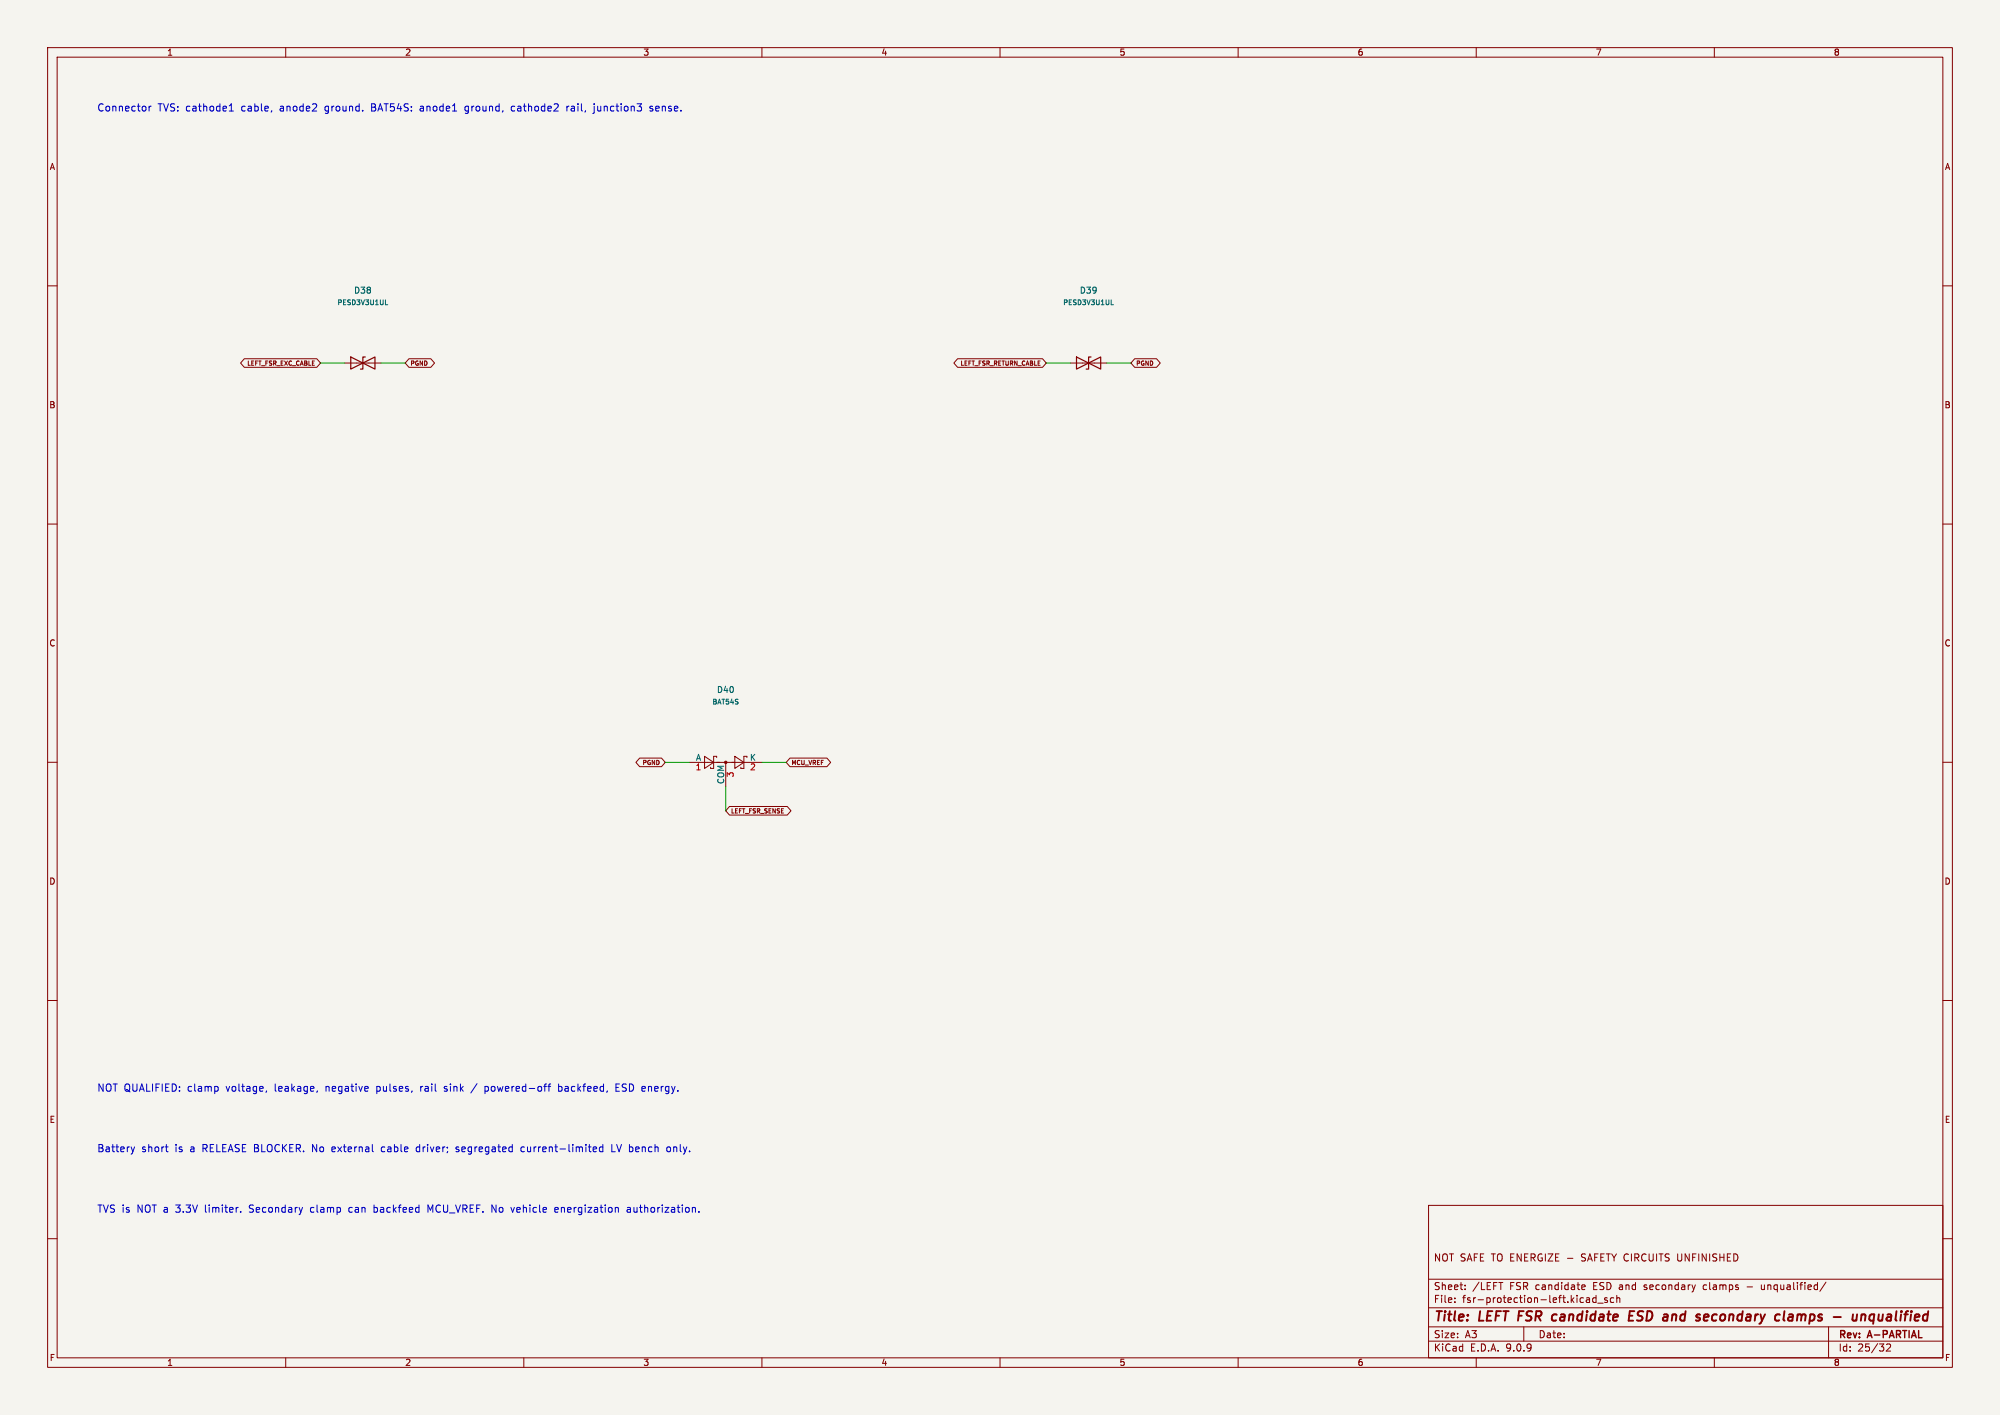
[picture p29: page 25]

Id: 25/32 Title: LEFT FSR candidate ESD and secondary clamps - unqualified

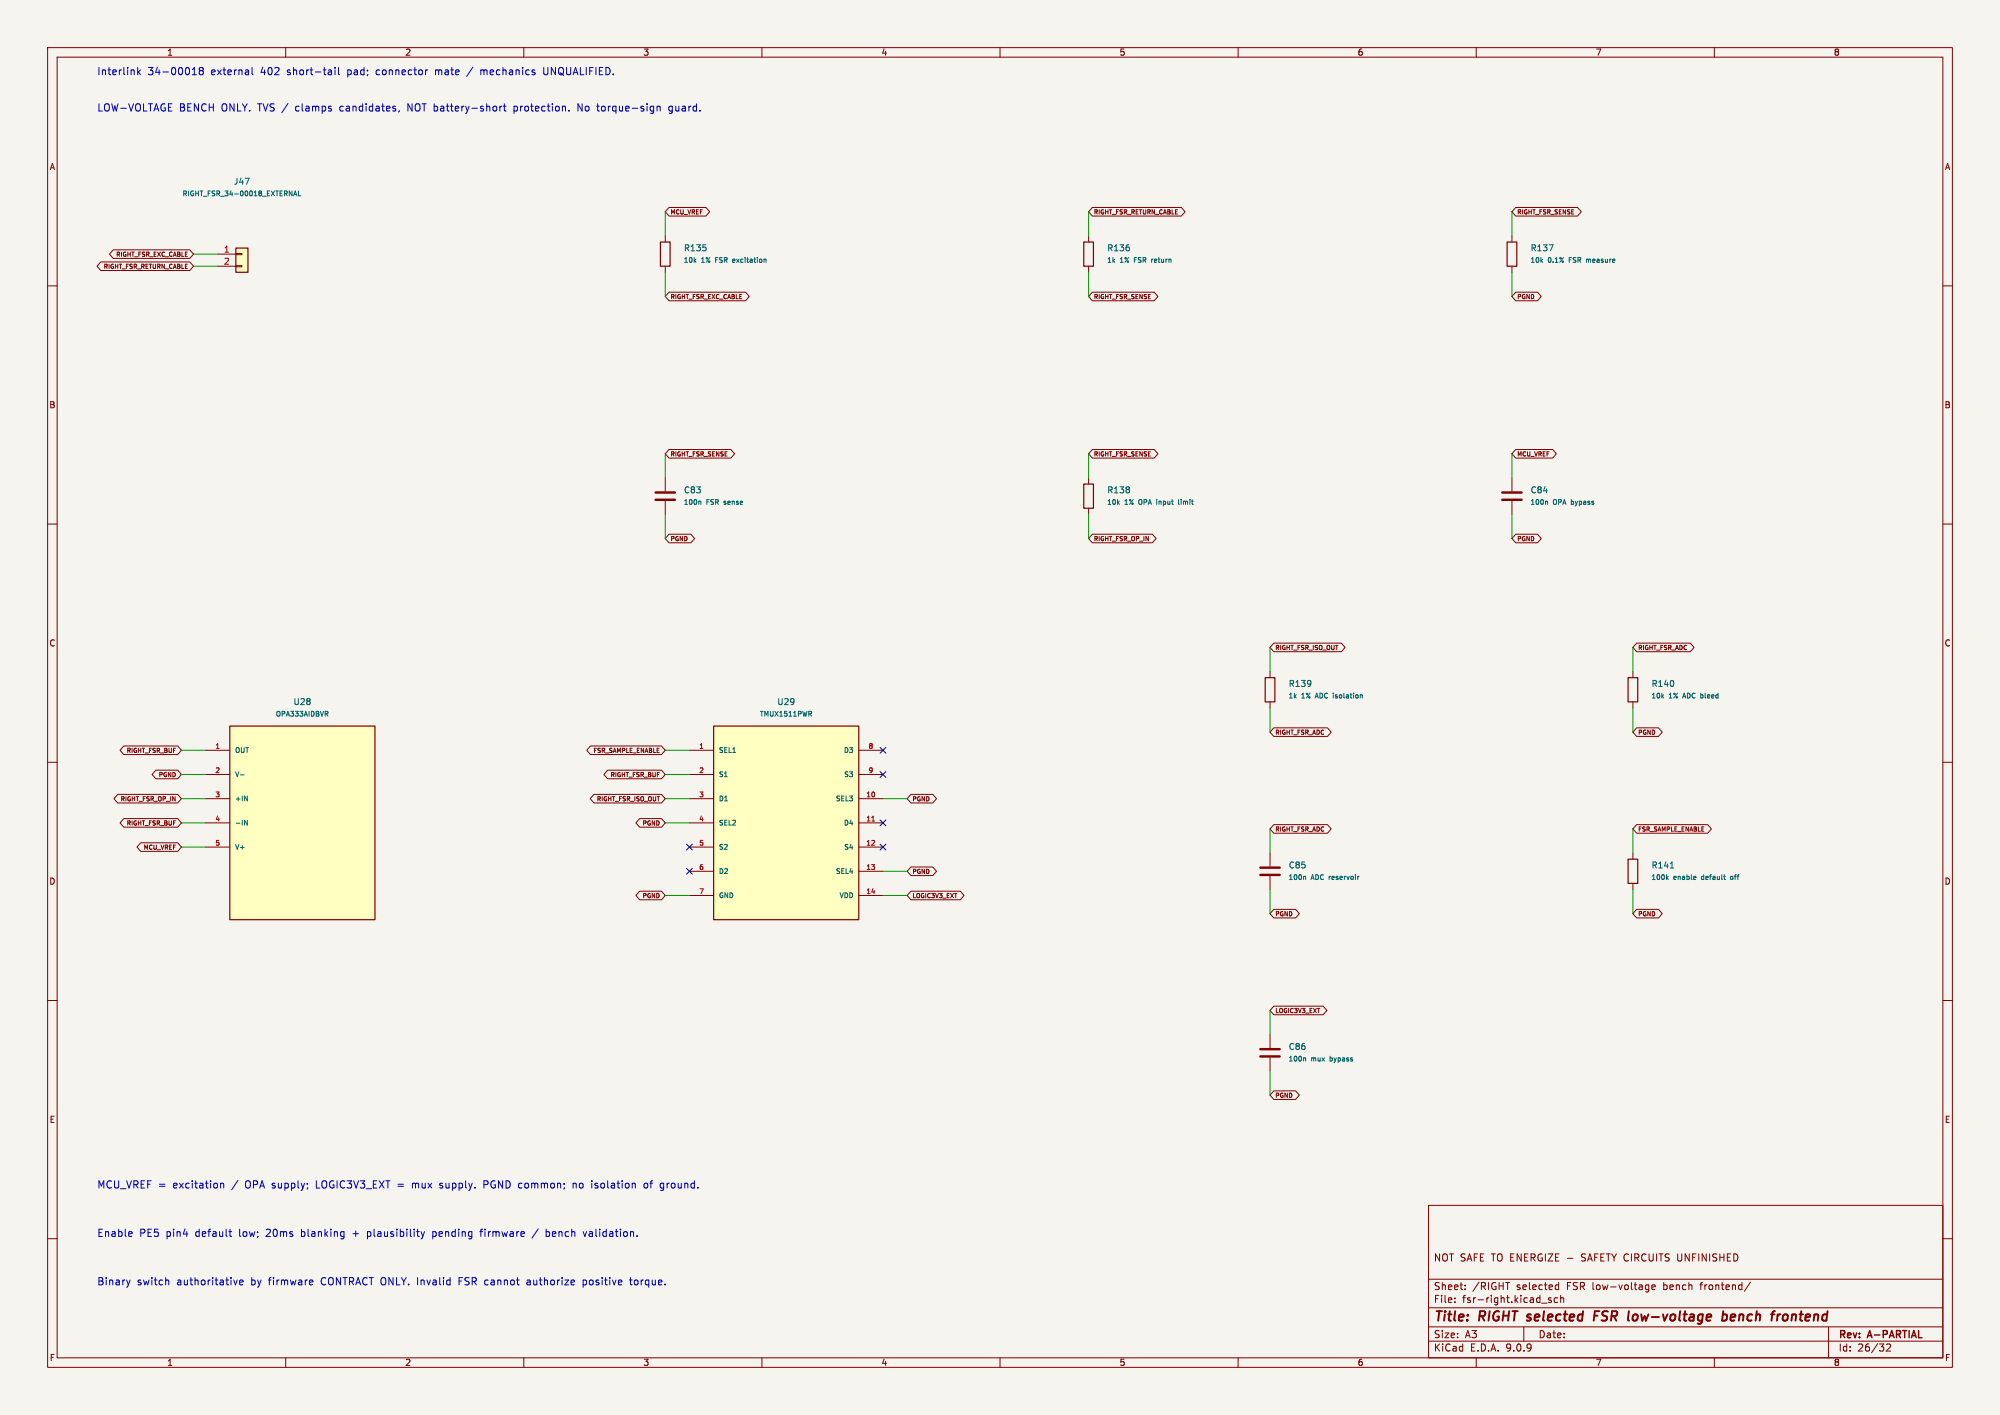
[picture p30: page 26]

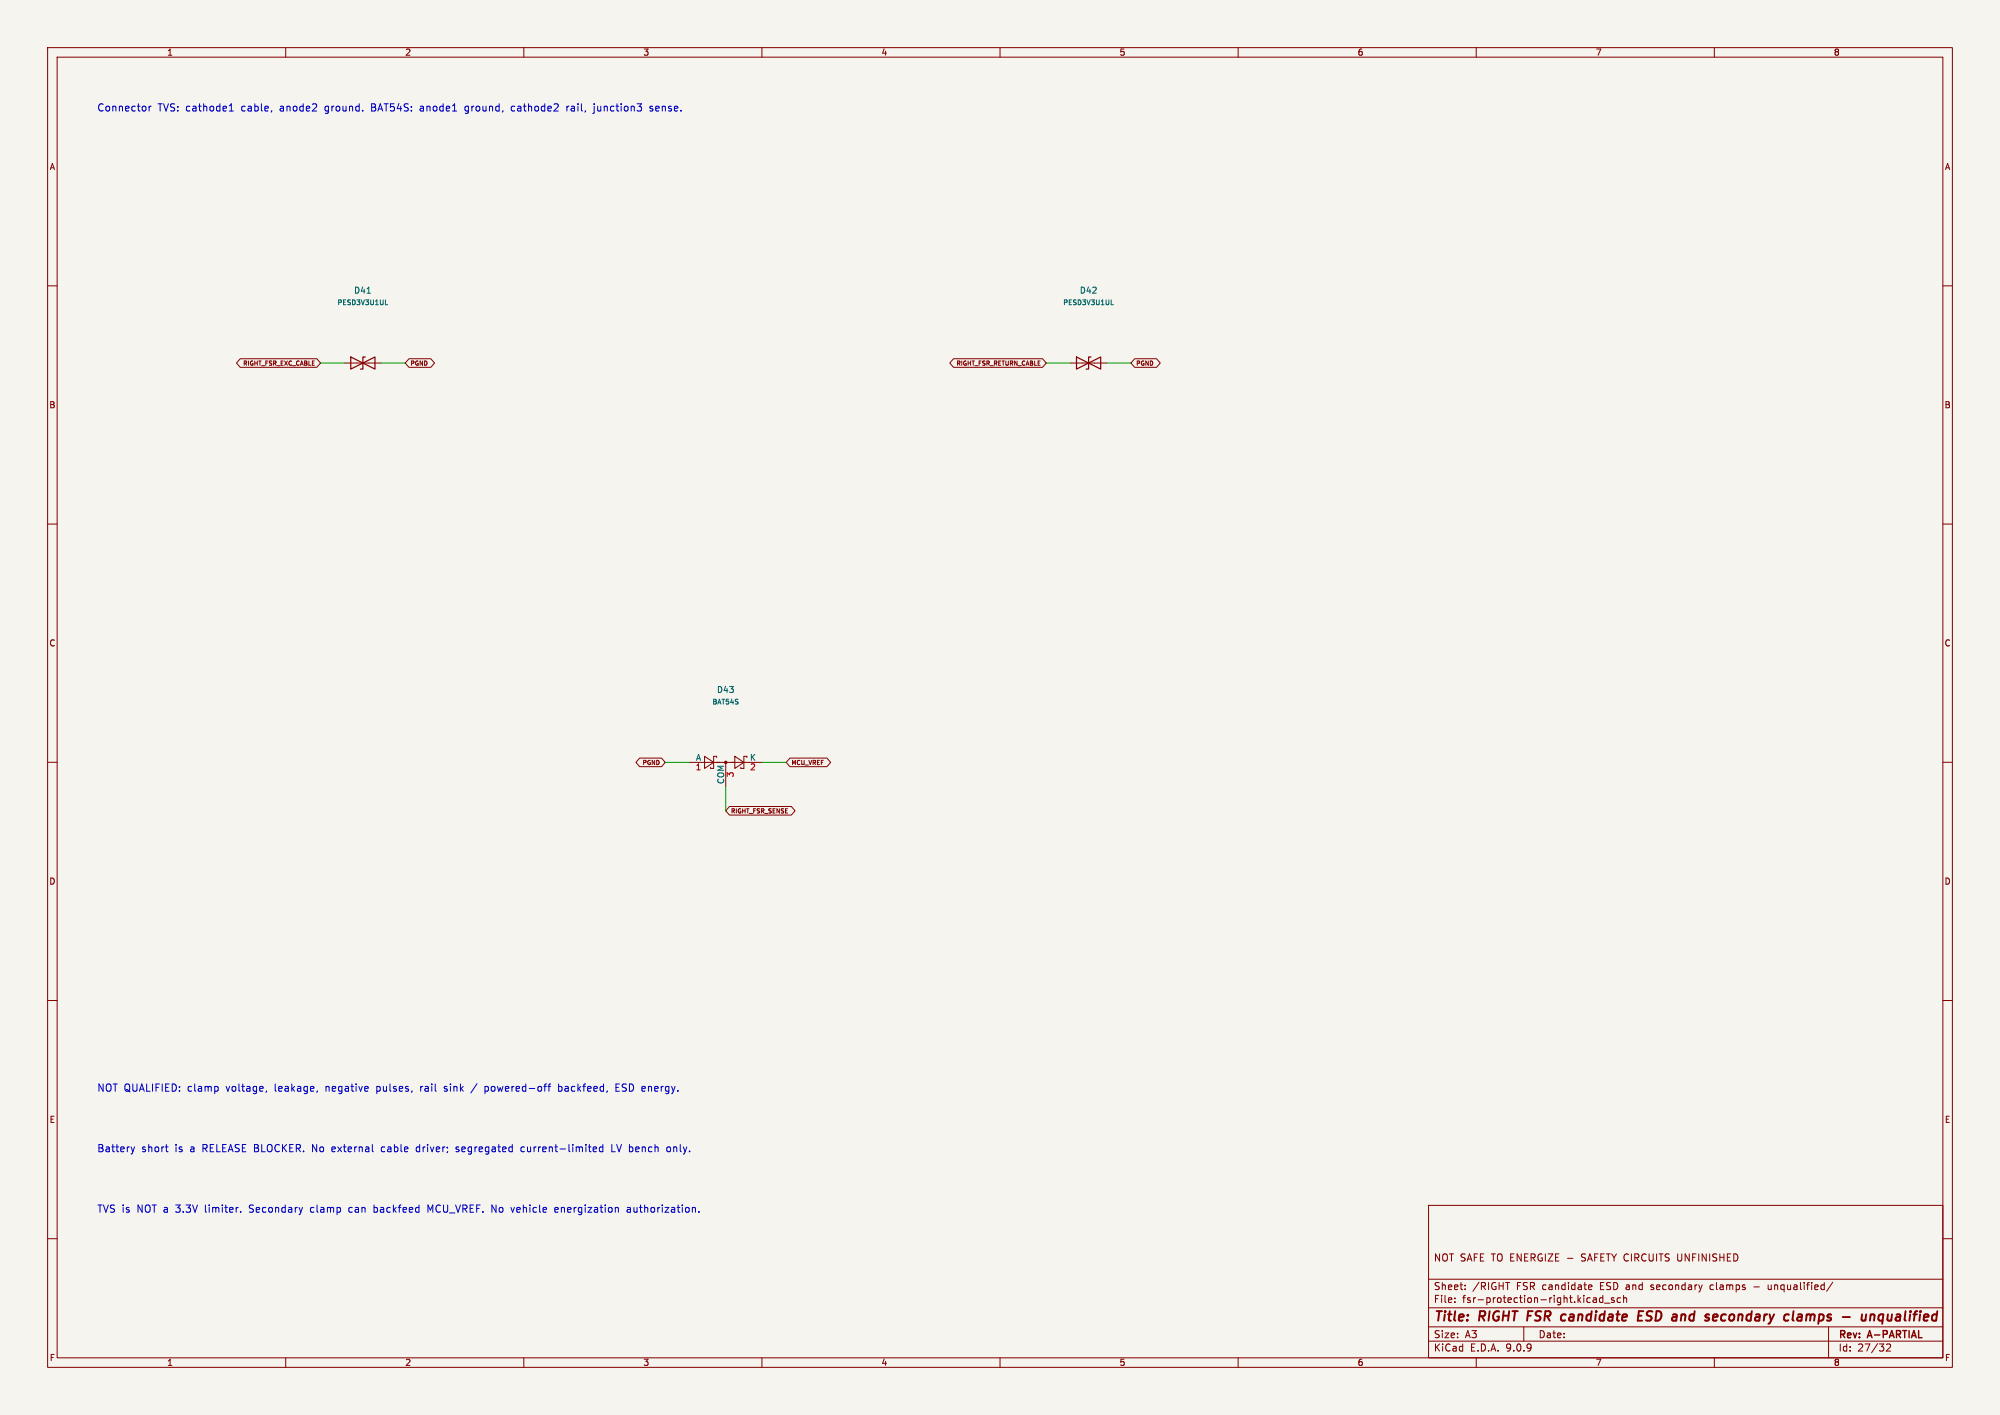
[picture p31: page 27]

Id: 27/32 Title: RIGHT FSR candidate ESD and secondary clamps - unqualified

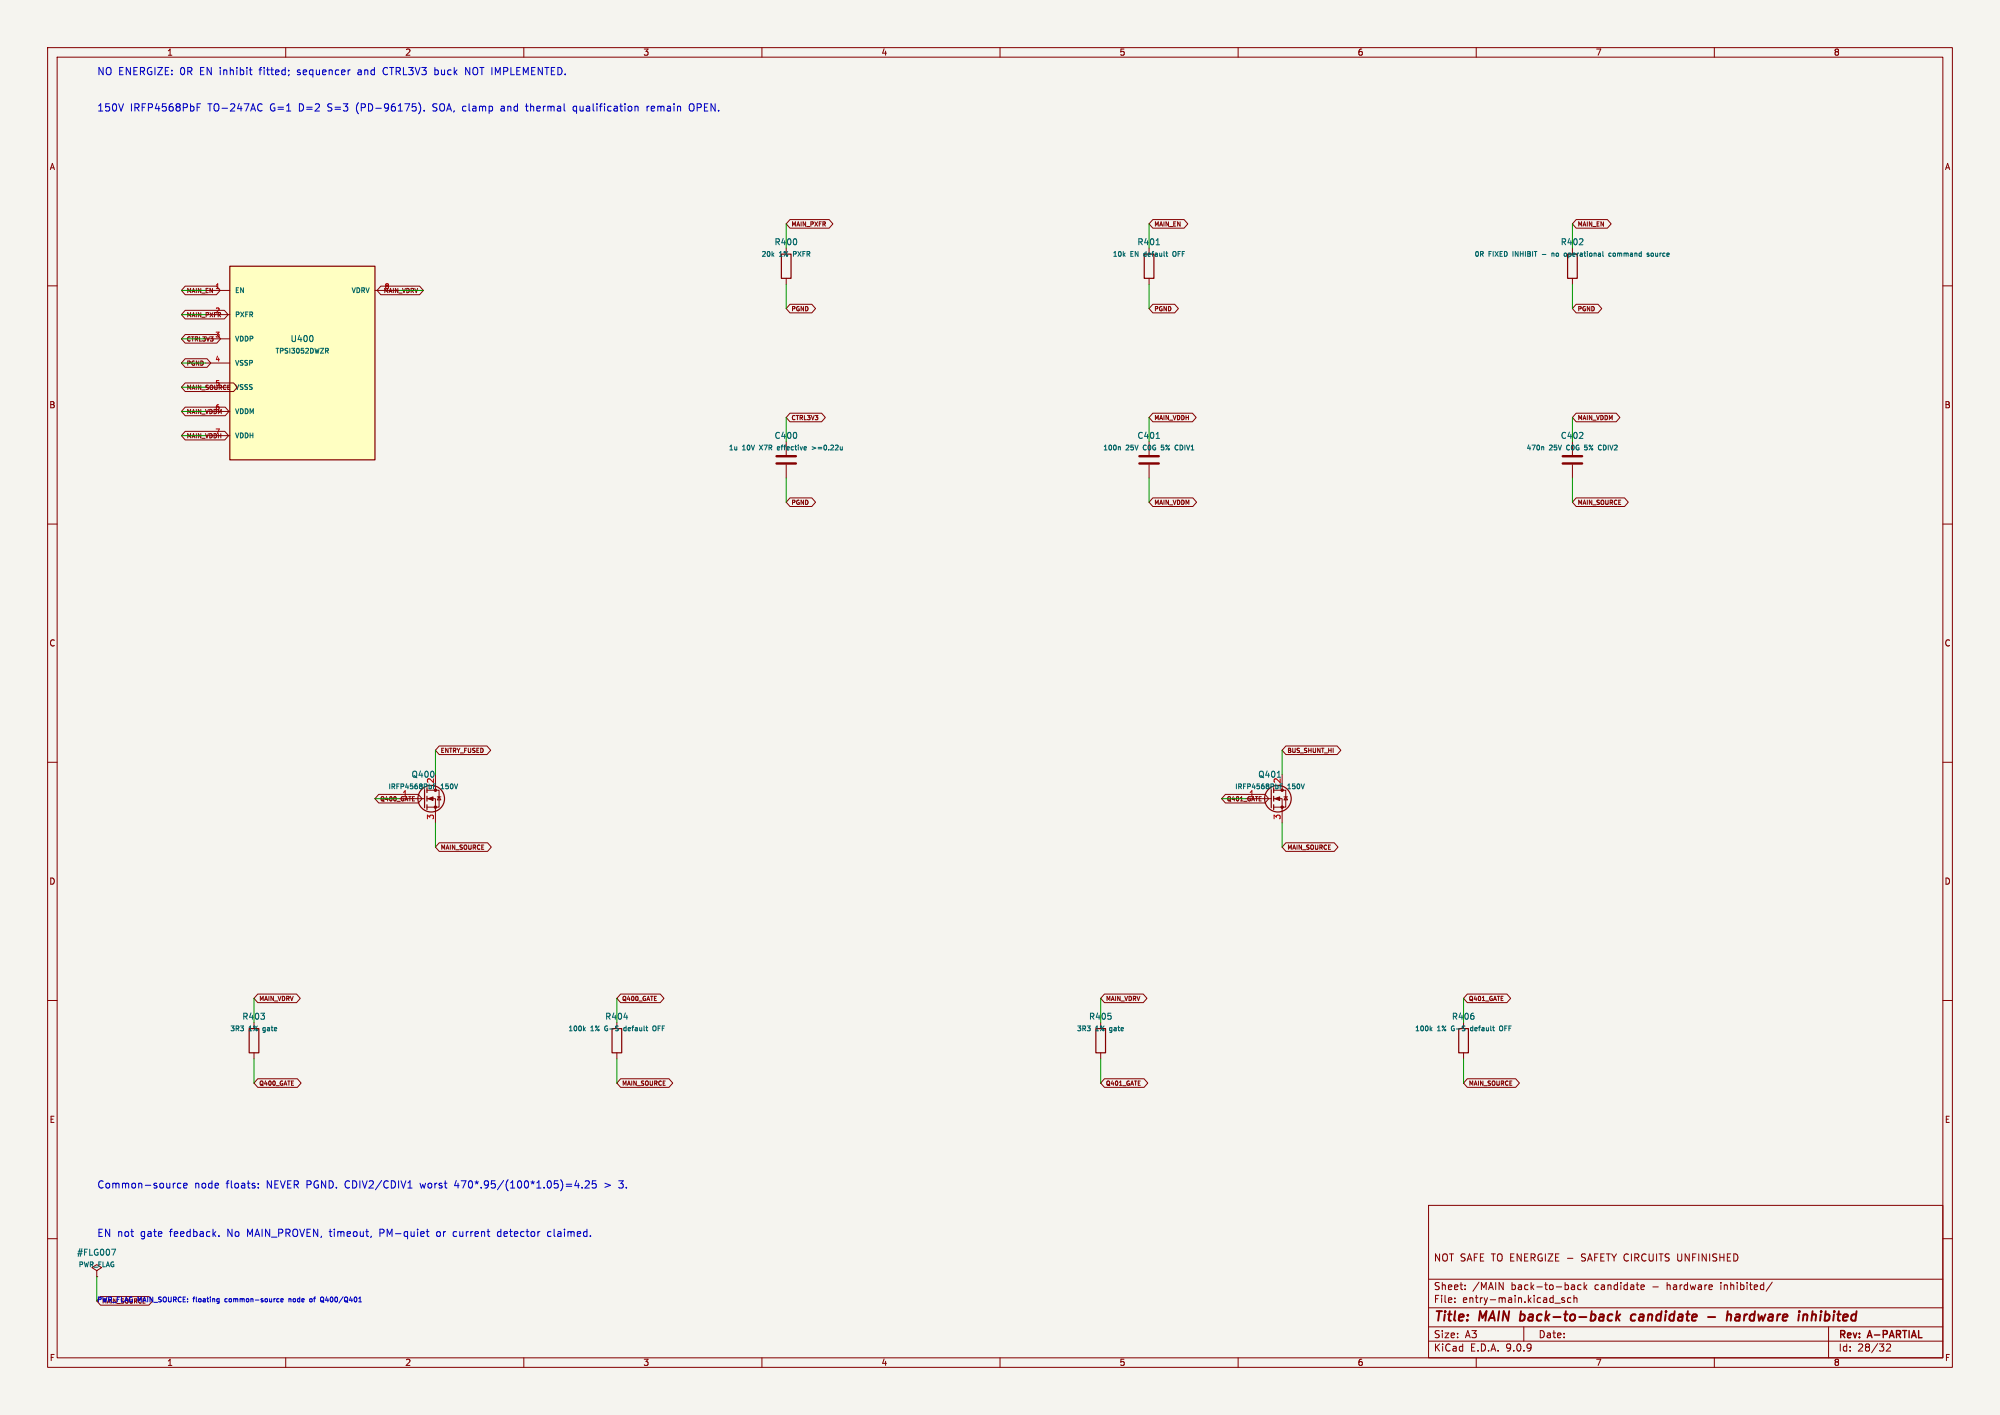
[picture p32: page 28]

NO ENERGIZE: 0R EN inhibit fitted; sequencer and CTRL3V3 buck NOT IMPLEMENTED.

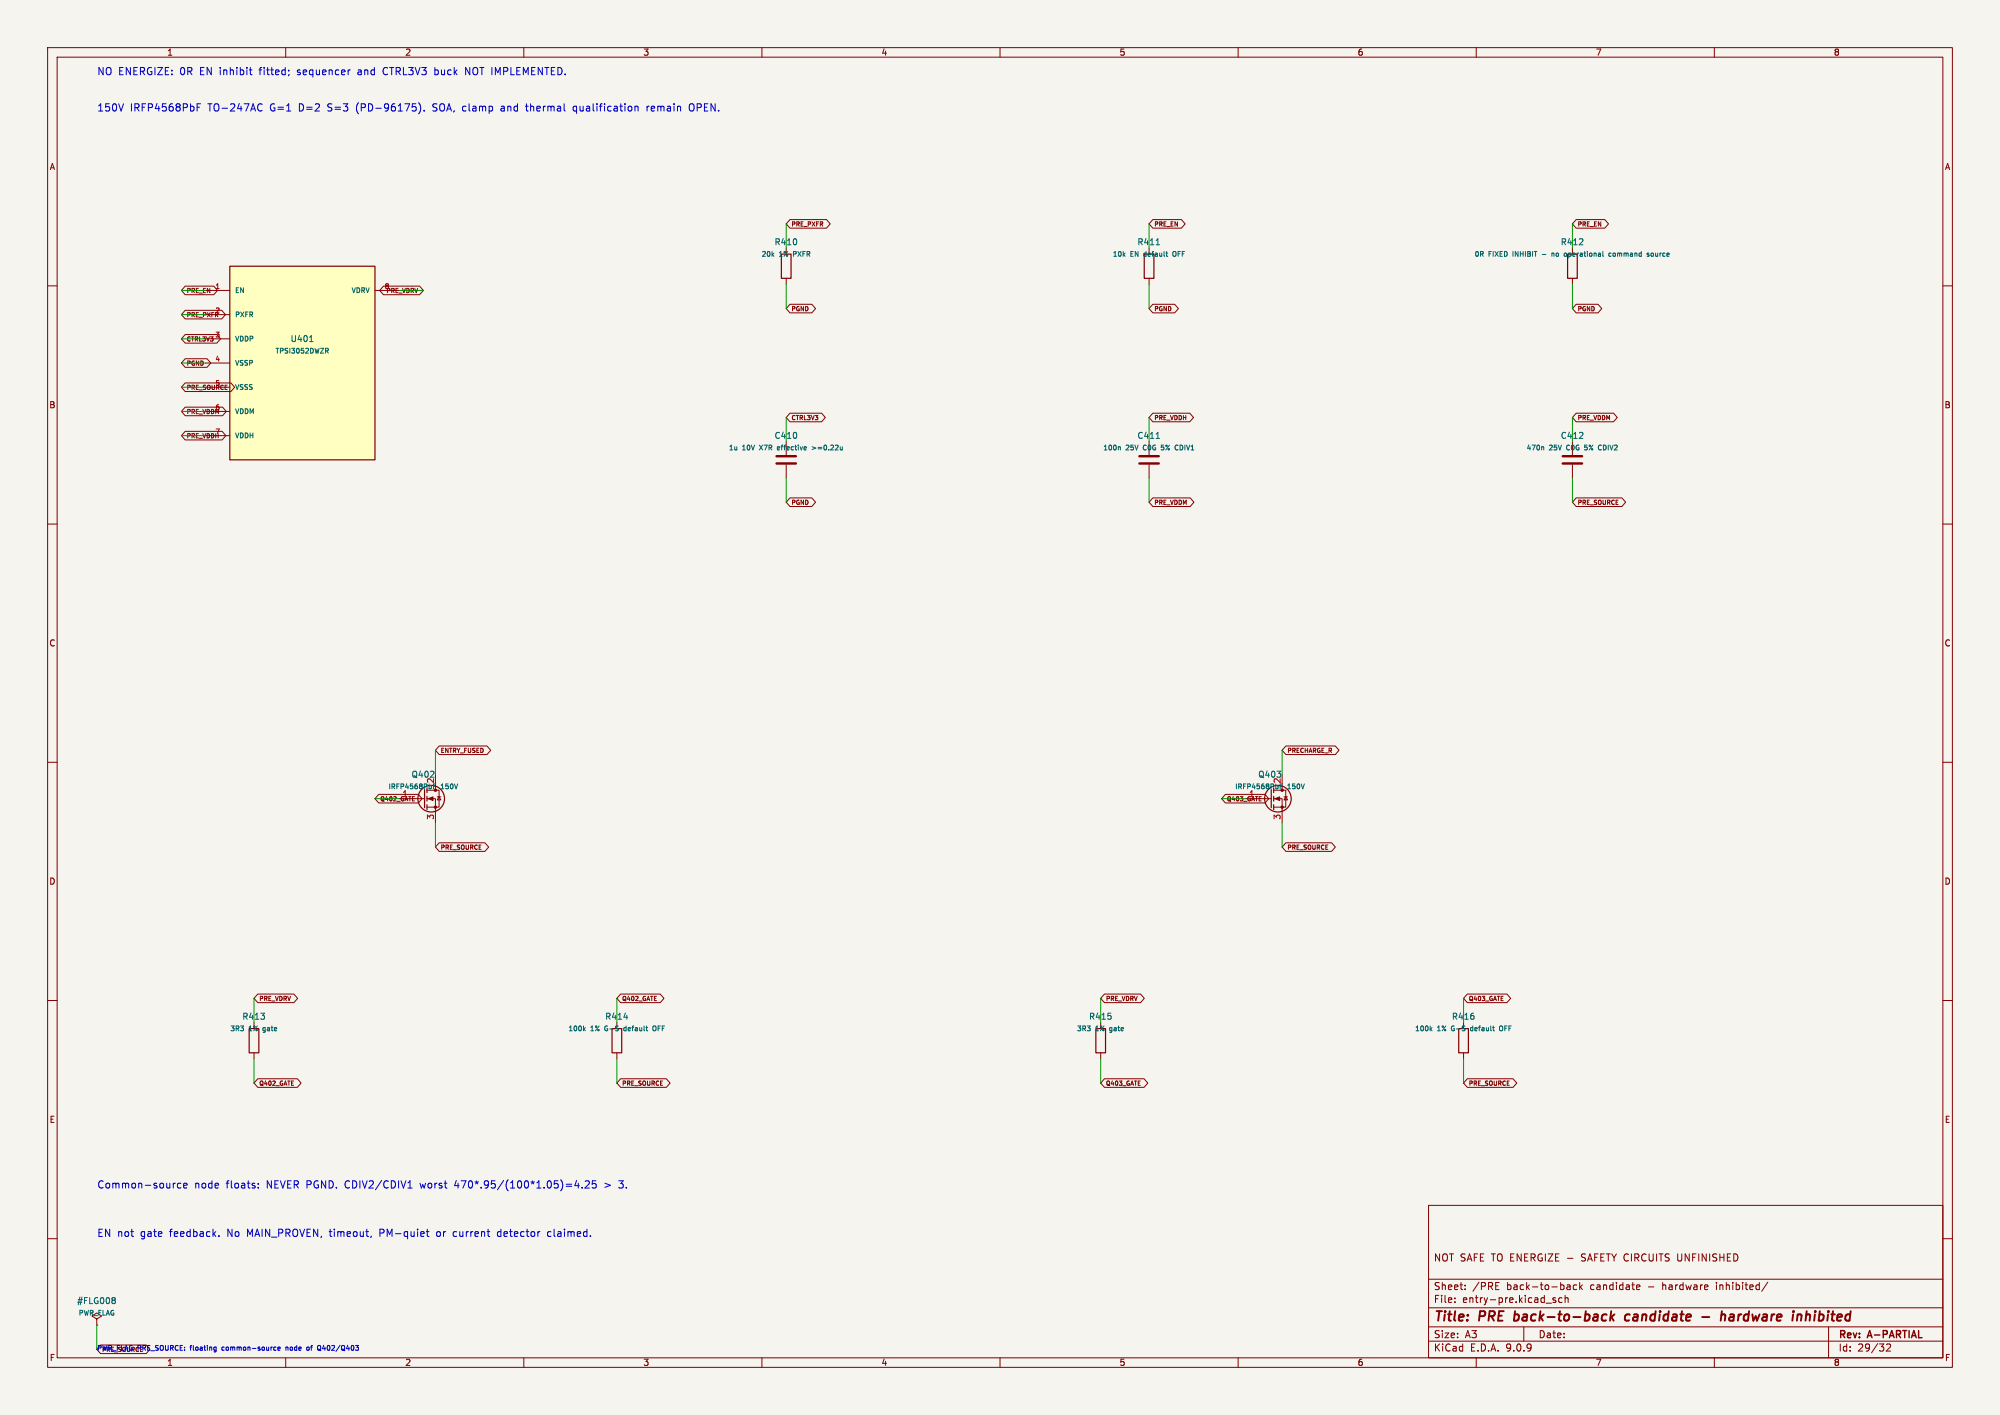
[picture p33: page 29]

NO ENERGIZE: 0R EN inhibit fitted; sequencer and CTRL3V3 buck NOT IMPLEMENTED.

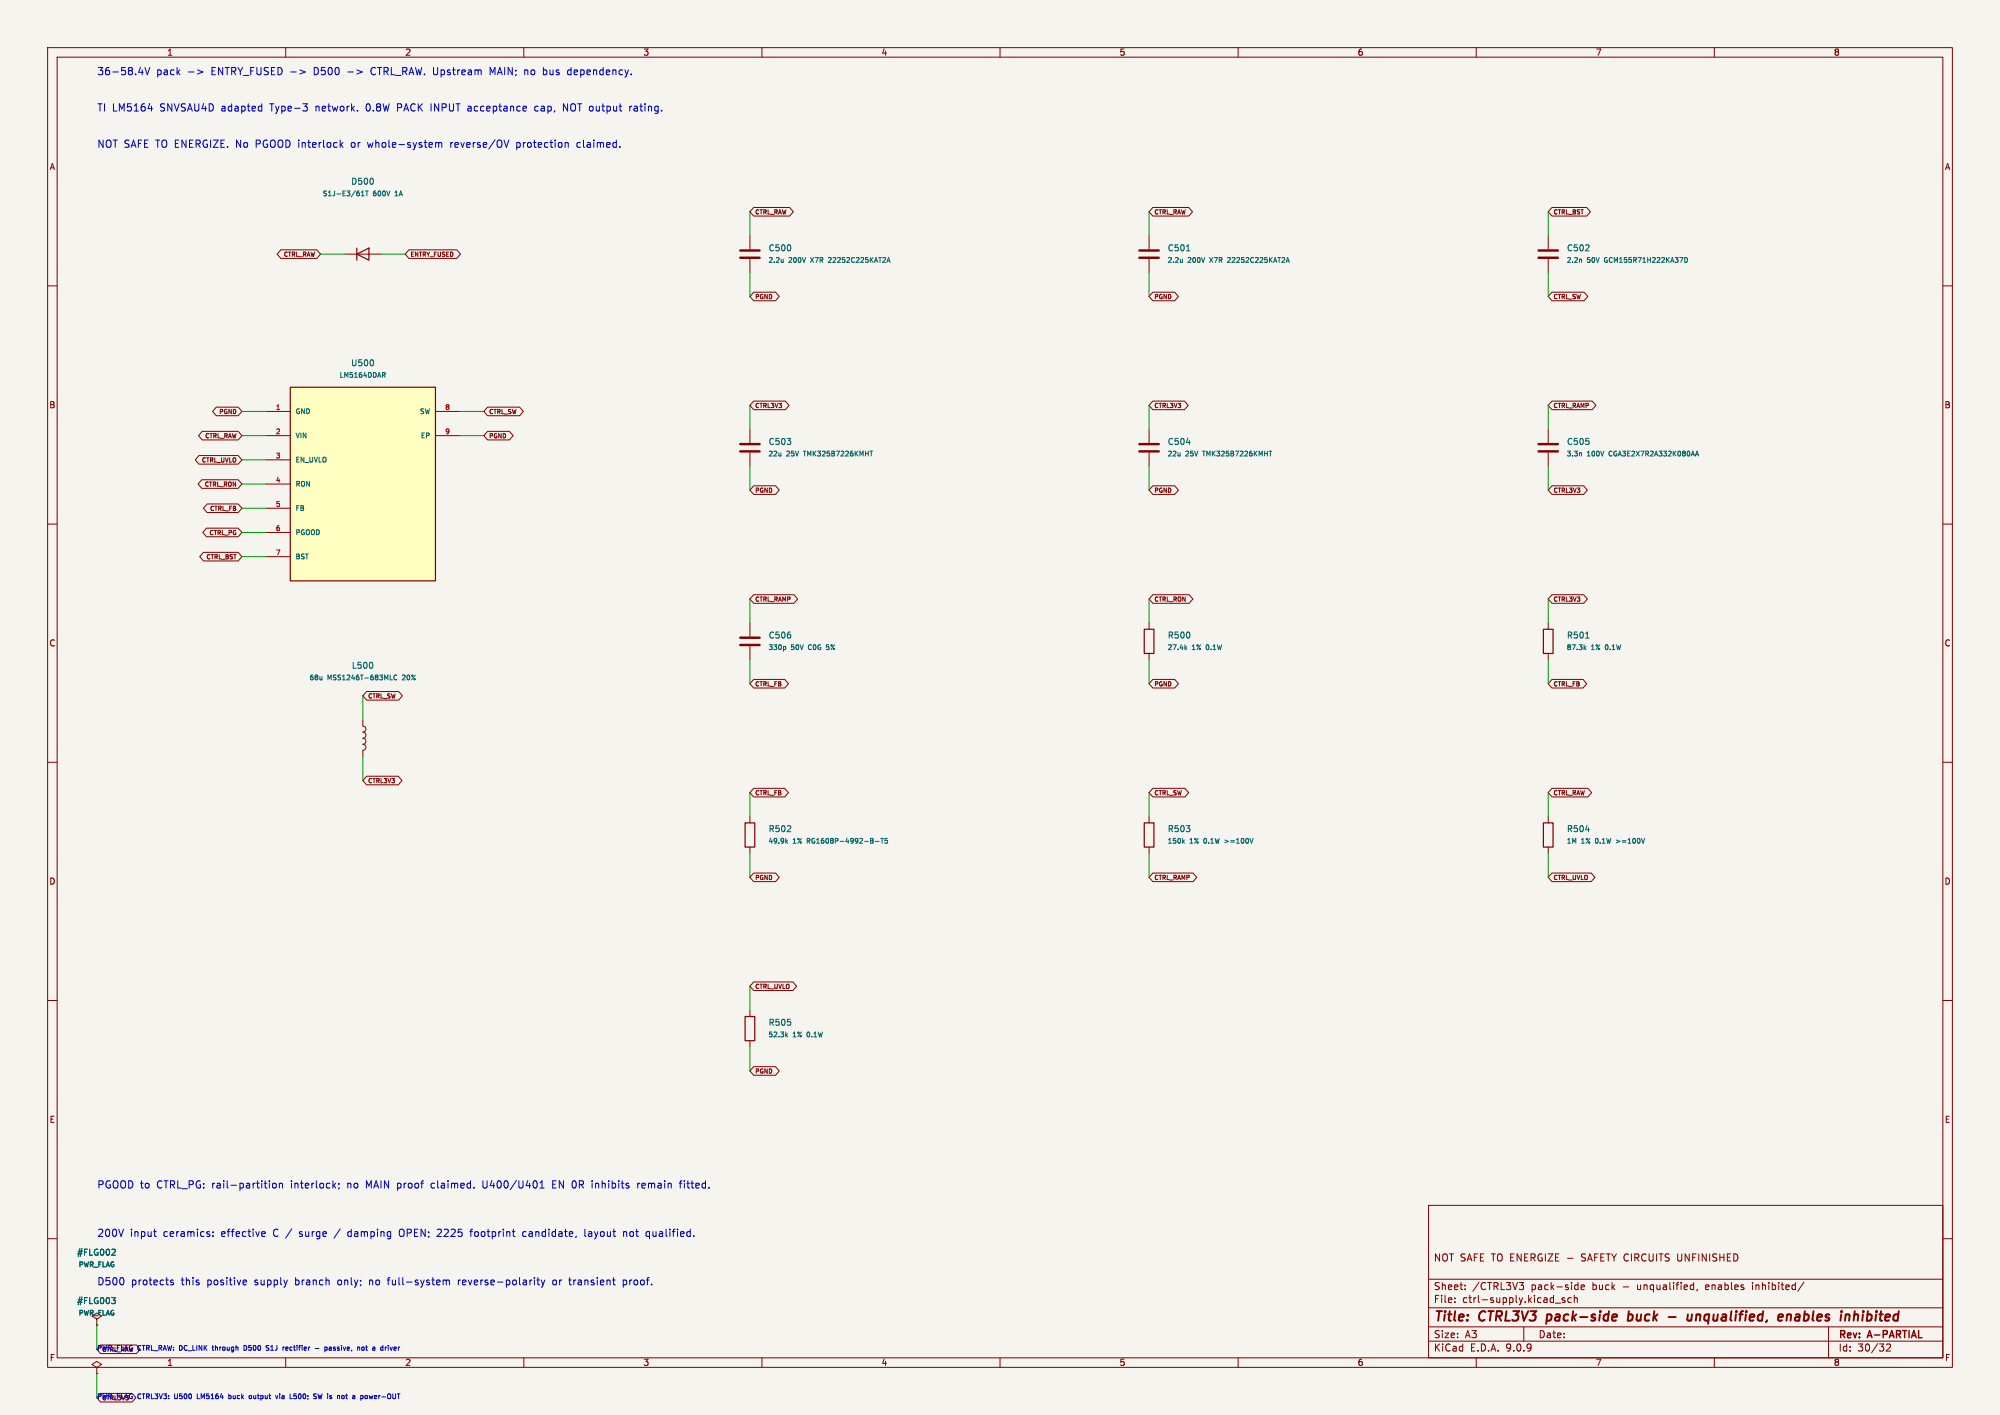
[picture p34: page 30]

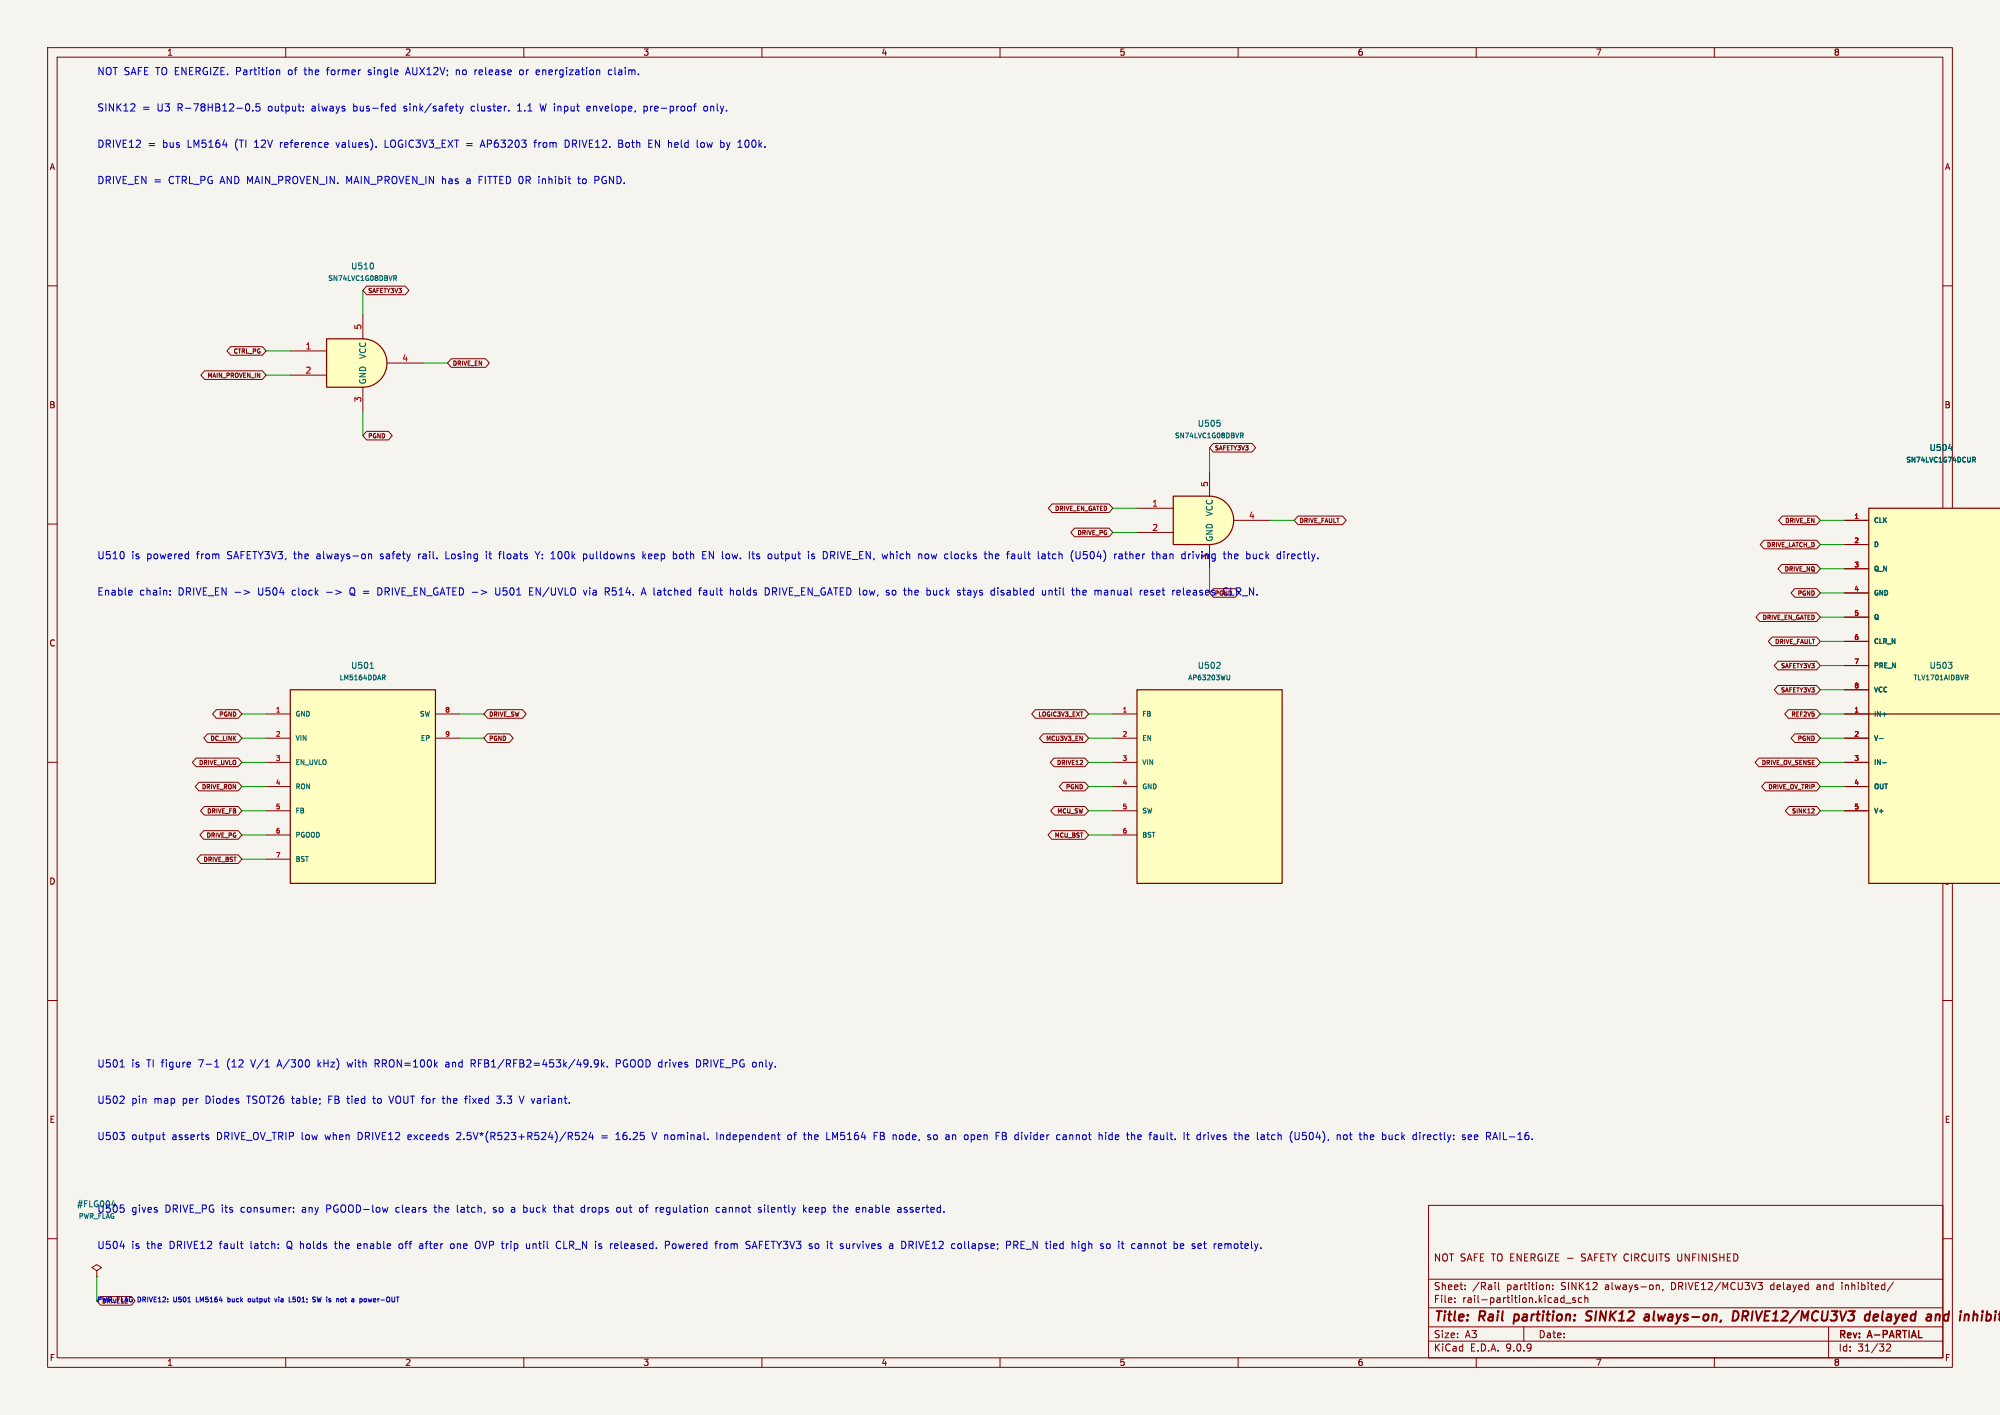
[picture p35: page 31]

DRIVE_EN = CTRL_PG AND MAIN_PROVEN_IN. MAIN_PROVEN_IN has a FITTED 0R inhibit to PGND.

PWR_FLAG DRIVE12: U501 LM5164 buck output via L501; SW is not a power-OUT U502 pin map per Diodes TSOT26 table; FB tied to VOUT for the fixed 3.3 V variant.

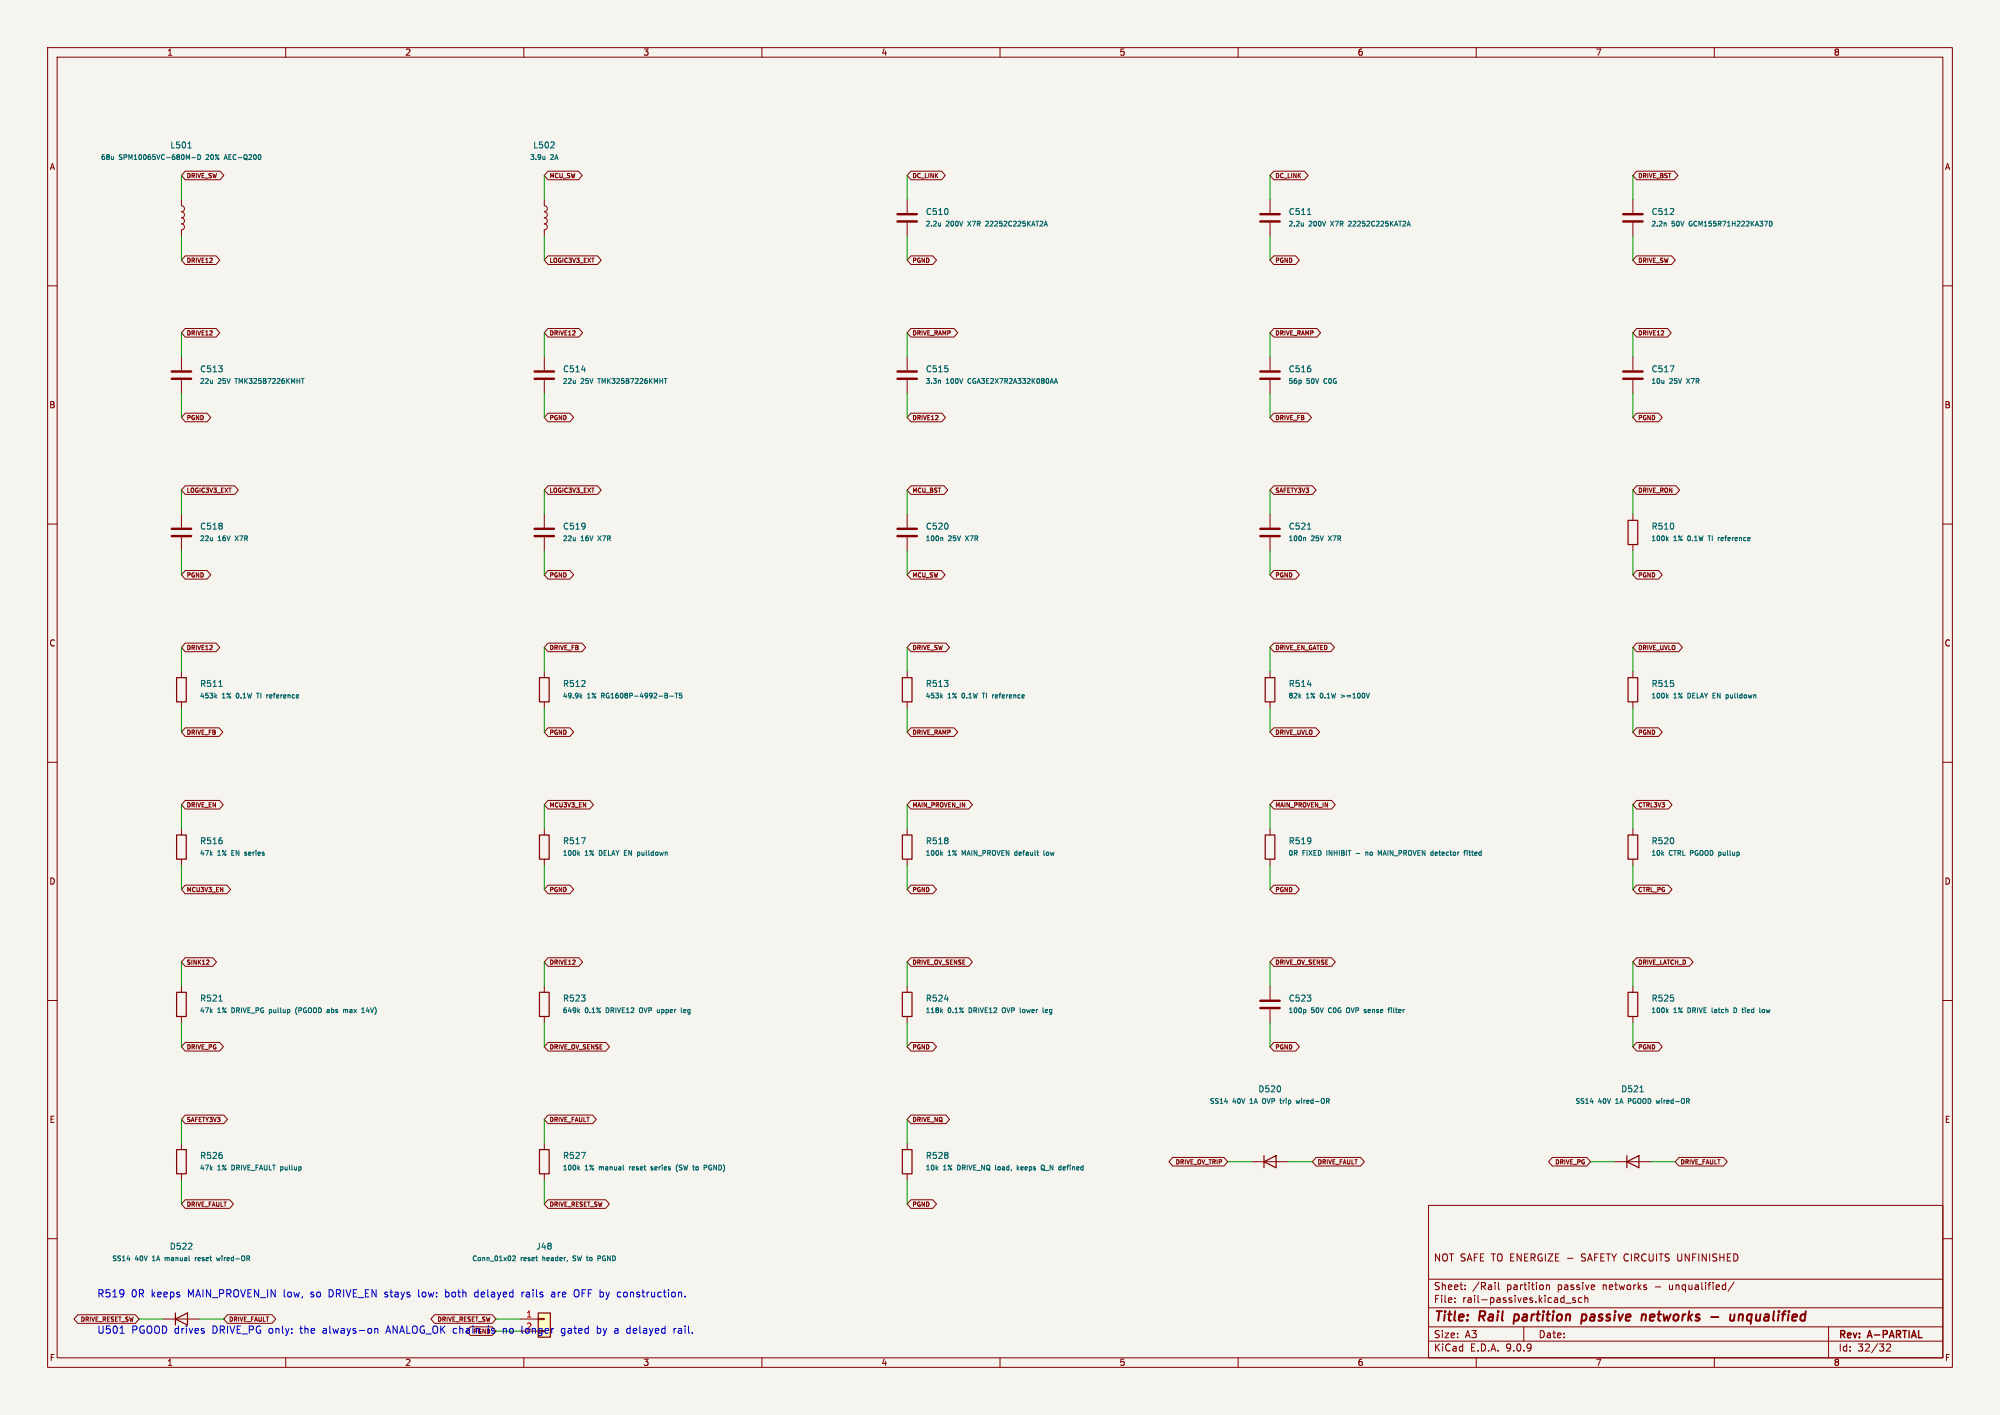
[picture p36: page 32]

SS14 40V 1A OVP trip wired-OR R524
118k 0.1% DRIVE12 OVP lower leg R528

100k 1% DRIVE latch D tied low C523
100p 50V C0G OVP sense filter

100k 1% manual reset series (SW to PGND)

Id: 32/32 Title: Rail partition passive networks - unqualified
