felixfelix-bot/cycle-without-chain/hardware/powerboard-reva/powerboard-reva.kicad_pcb

## KiCad design hardware/powerboard-reva/powerboard-reva.kicad_pcb (2026-11-14)

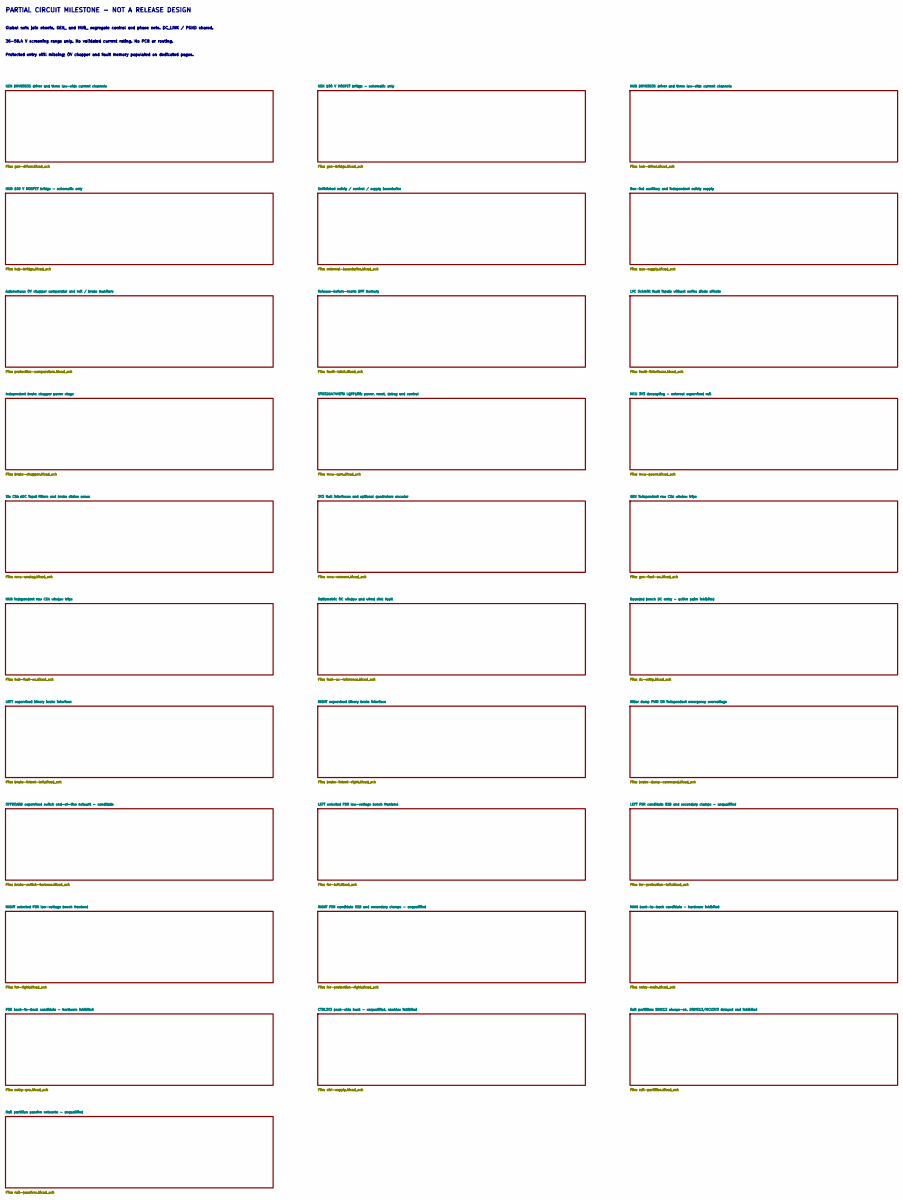
[picture p37: schematic powerboard-reva.kicad_sch, Pedal-by-wire: hierarchical engineering review]

Notes on the sheet:
PARTIAL CIRCUIT MILESTONE - NOT A RELEASE DESIGN
Global nets join sheets. GEN_ and HUB_ segregate control and phase nets. DC_LINK / PGND shared.
36-58.4 V screening range only. No validated current rating. No PCB or routing.
Protected entry still missing; OV chopper and fault memory populated on dedicated pages.

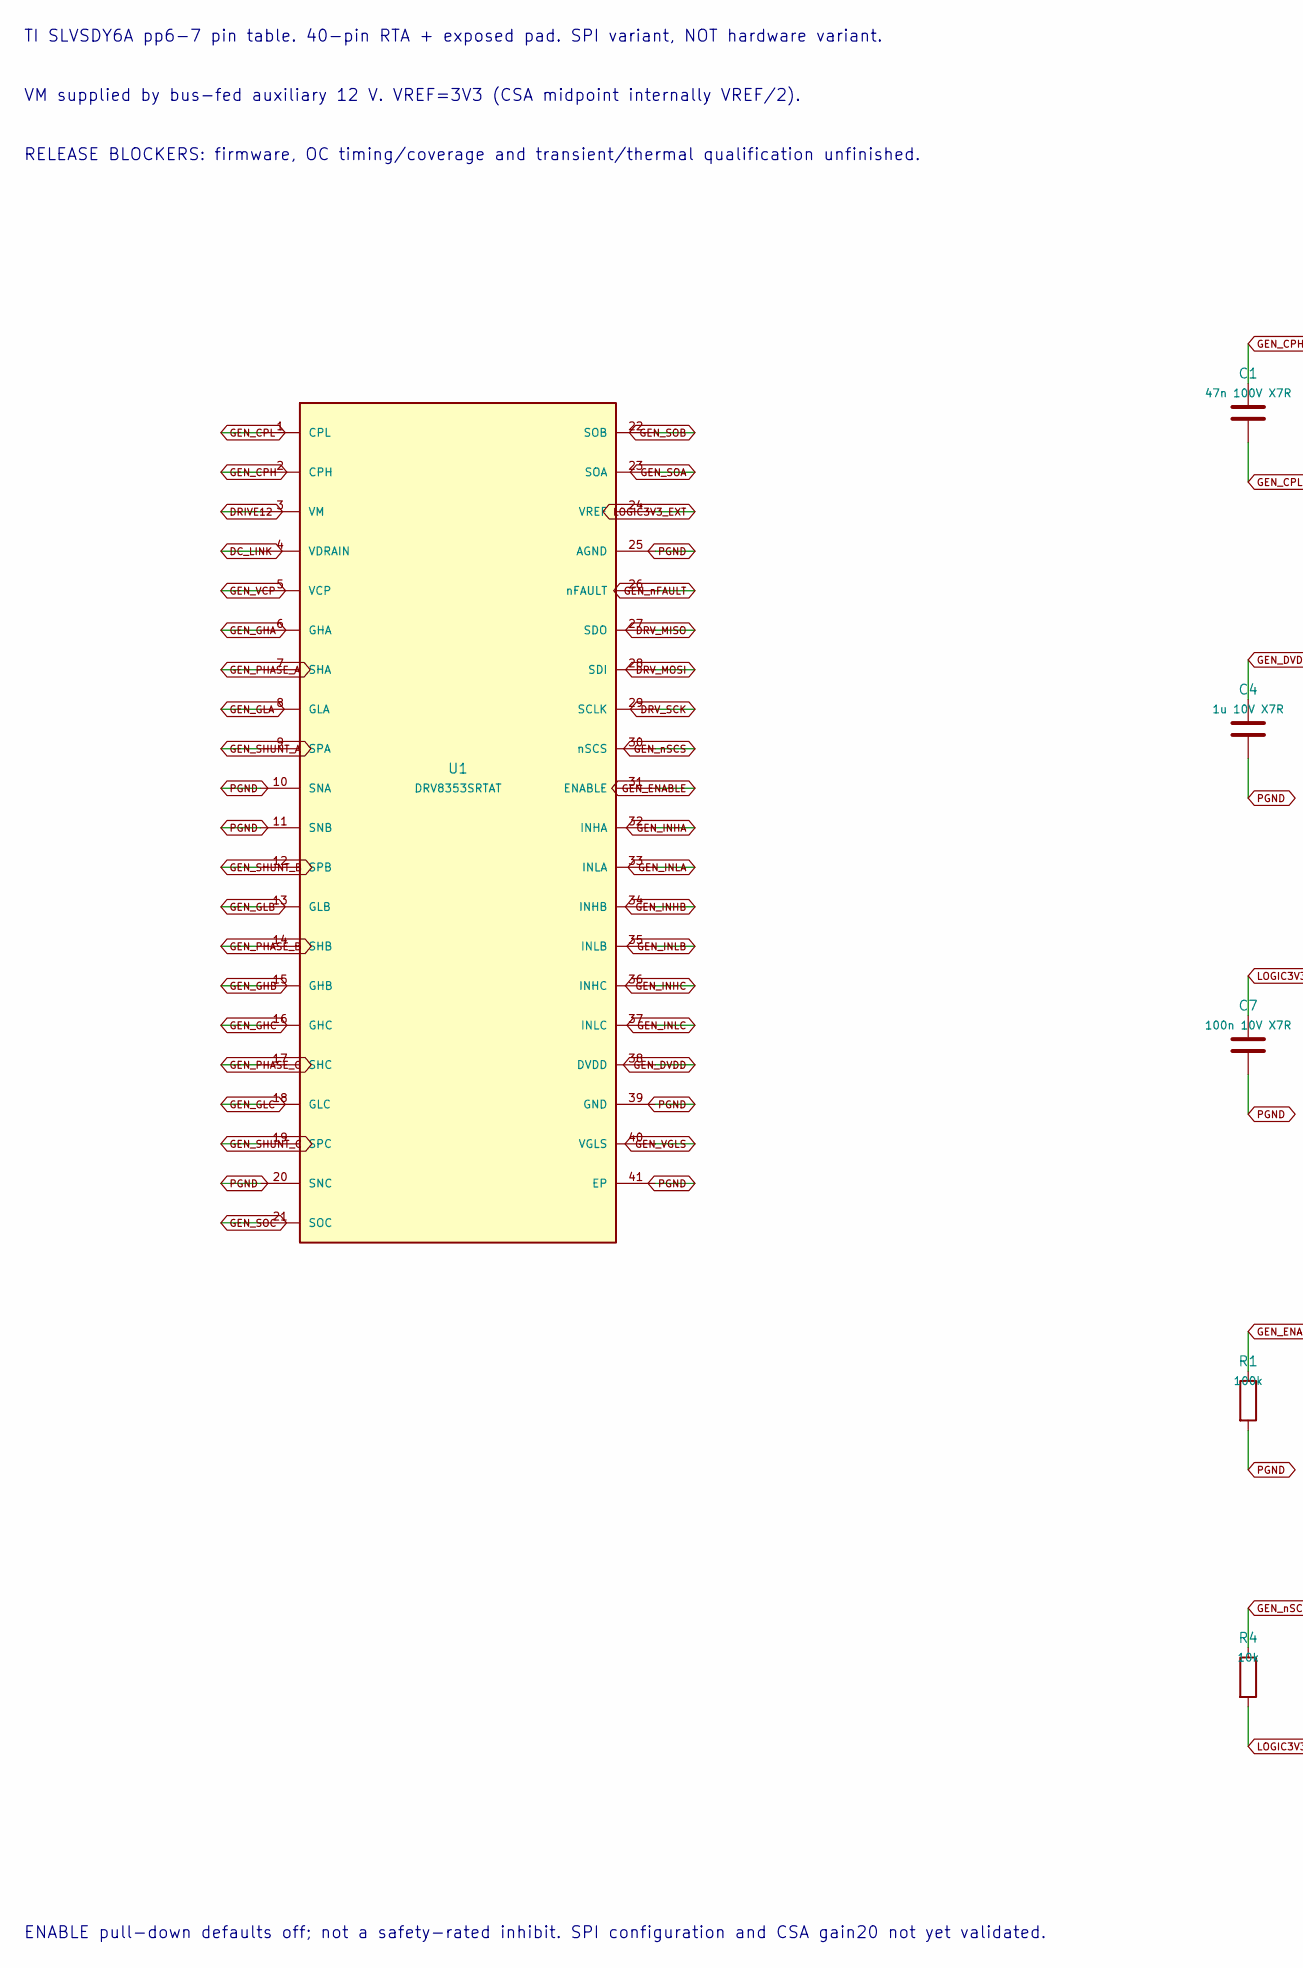
[picture p38: schematic gen-driver.kicad_sch, GEN DRV8353S driver and three low-side current channels, part in row 1, column 1]

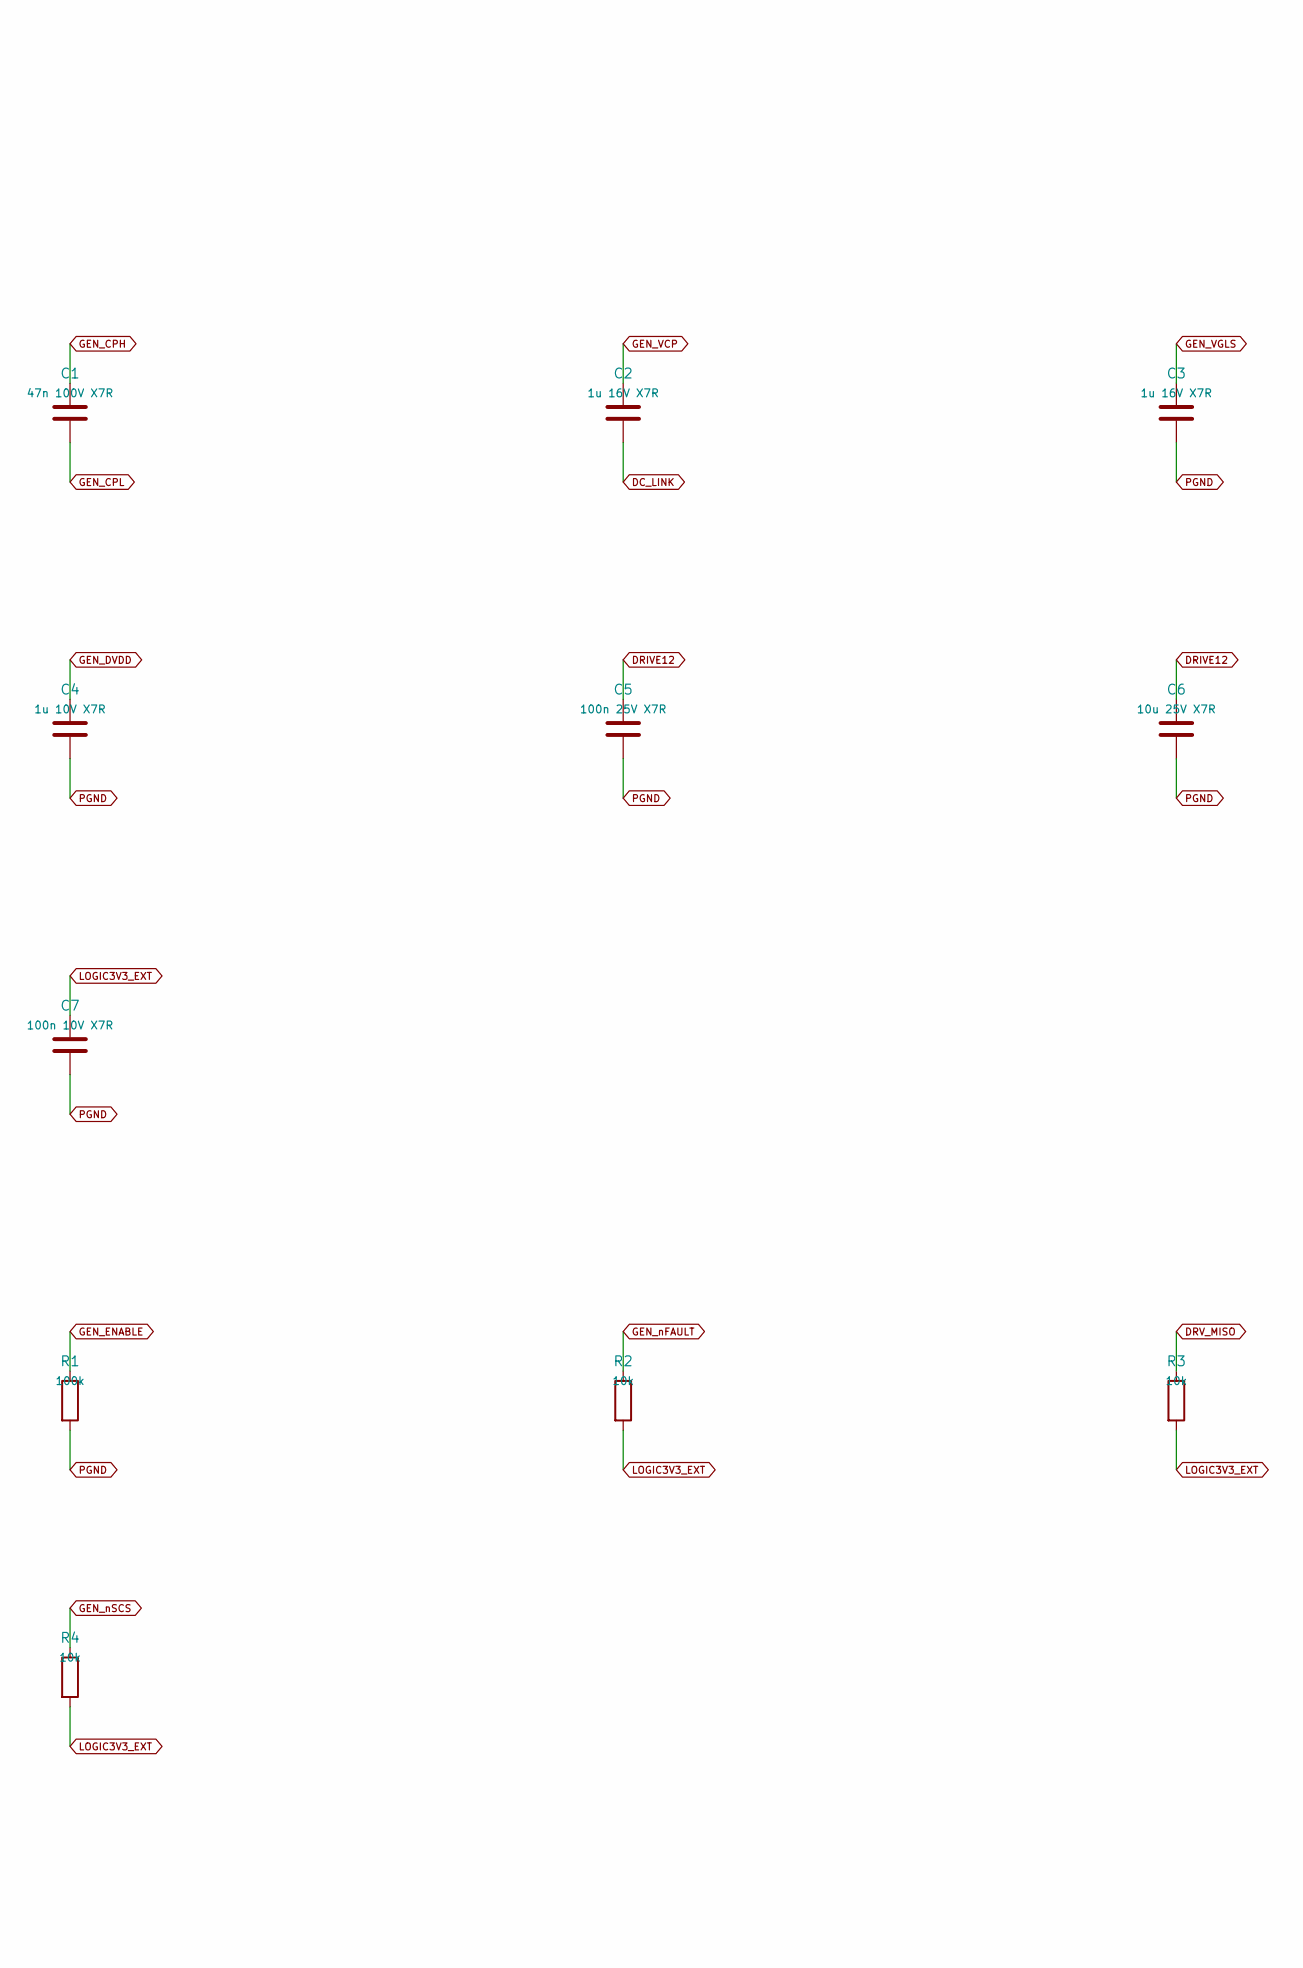
[picture p39: schematic gen-driver.kicad_sch, GEN DRV8353S driver and three low-side current channels, part in row 1, column 2]

Parts:
C1: 47n 100V X7R; C_0805_2012Metric
C2, C3: 1u 16V X7R; C_0805_2012Metric
C4: 1u 10V X7R; C_0603_1608Metric
C5: 100n 25V X7R; C_0805_2012Metric
C6: 10u 25V X7R; C_0805_2012Metric
C7: 100n 10V X7R; C_0603_1608Metric
R1: 100k; R_0805_2012Metric
R2, R3, R4: 10k; R_0805_2012Metric
U1: DRV8353SRTAT; QFN-40-1EP_6x6mm_P0.5mm_EP4.6x4.6mm

Connections:
DC_LINK: C2.2, U1.4 (VDRAIN); also elsewhere on the board
DRIVE12: C5.1, C6.1, U1.3 (VM); also elsewhere on the board
DRV_MISO: R3.1, U1.27 (SDO); also elsewhere on the board
DRV_MOSI: U1.28 (SDI); also elsewhere on the board
DRV_SCK: U1.29 (SCLK); also elsewhere on the board
GEN_CPH: C1.1, U1.2 (CPH)
GEN_CPL: C1.2, U1.1 (CPL)
GEN_DVDD: C4.1, U1.38 (DVDD)
GEN_ENABLE: R1.1, U1.31 (ENABLE); also elsewhere on the board
GEN_GHA: U1.6 (GHA); also elsewhere on the board
GEN_GHB: U1.15 (GHB); also elsewhere on the board
GEN_GHC: U1.16 (GHC); also elsewhere on the board
GEN_GLA: U1.8 (GLA); also elsewhere on the board
GEN_GLB: U1.13 (GLB); also elsewhere on the board
GEN_GLC: U1.18 (GLC); also elsewhere on the board
GEN_INHA: U1.32 (INHA); also elsewhere on the board
GEN_INHB: U1.34 (INHB); also elsewhere on the board
GEN_INHC: U1.36 (INHC); also elsewhere on the board
GEN_INLA: U1.33 (INLA); also elsewhere on the board
GEN_INLB: U1.35 (INLB); also elsewhere on the board
GEN_INLC: U1.37 (INLC); also elsewhere on the board
GEN_PHASE_A: U1.7 (SHA); also elsewhere on the board
GEN_PHASE_B: U1.14 (SHB); also elsewhere on the board
GEN_PHASE_C: U1.17 (SHC); also elsewhere on the board
GEN_SHUNT_A: U1.9 (SPA); also elsewhere on the board
GEN_SHUNT_B: U1.12 (SPB); also elsewhere on the board
GEN_SHUNT_C: U1.19 (SPC); also elsewhere on the board
GEN_SOA: U1.23 (SOA); also elsewhere on the board
GEN_SOB: U1.22 (SOB); also elsewhere on the board
GEN_SOC: U1.21 (SOC); also elsewhere on the board
GEN_VCP: C2.1, U1.5 (VCP)
GEN_VGLS: C3.1, U1.40 (VGLS)
GEN_nFAULT: R2.1, U1.26 (nFAULT); also elsewhere on the board
GEN_nSCS: R4.1, U1.30 (nSCS); also elsewhere on the board
LOGIC3V3_EXT: C7.1, R2.2, R3.2, R4.2, U1.24 (VREF); also elsewhere on the board
PGND: C3.2, C4.2, C5.2, C6.2, C7.2, R1.2, U1.10 (SNA), U1.11 (SNB), U1.20 (SNC), U1.25 (AGND), U1.39 (GND), U1.41 (EP); also elsewhere on the board

Notes on the sheet:
TI SLVSDY6A pp6-7 pin table. 40-pin RTA + exposed pad. SPI variant, NOT hardware variant.
VM supplied by bus-fed auxiliary 12 V. VREF=3V3 (CSA midpoint internally VREF/2).
RELEASE BLOCKERS: firmware, OC timing/coverage and transient/thermal qualification unfinished.
ENABLE pull-down defaults off; not a safety-rated inhibit. SPI configuration and CSA gain20 not yet validated.

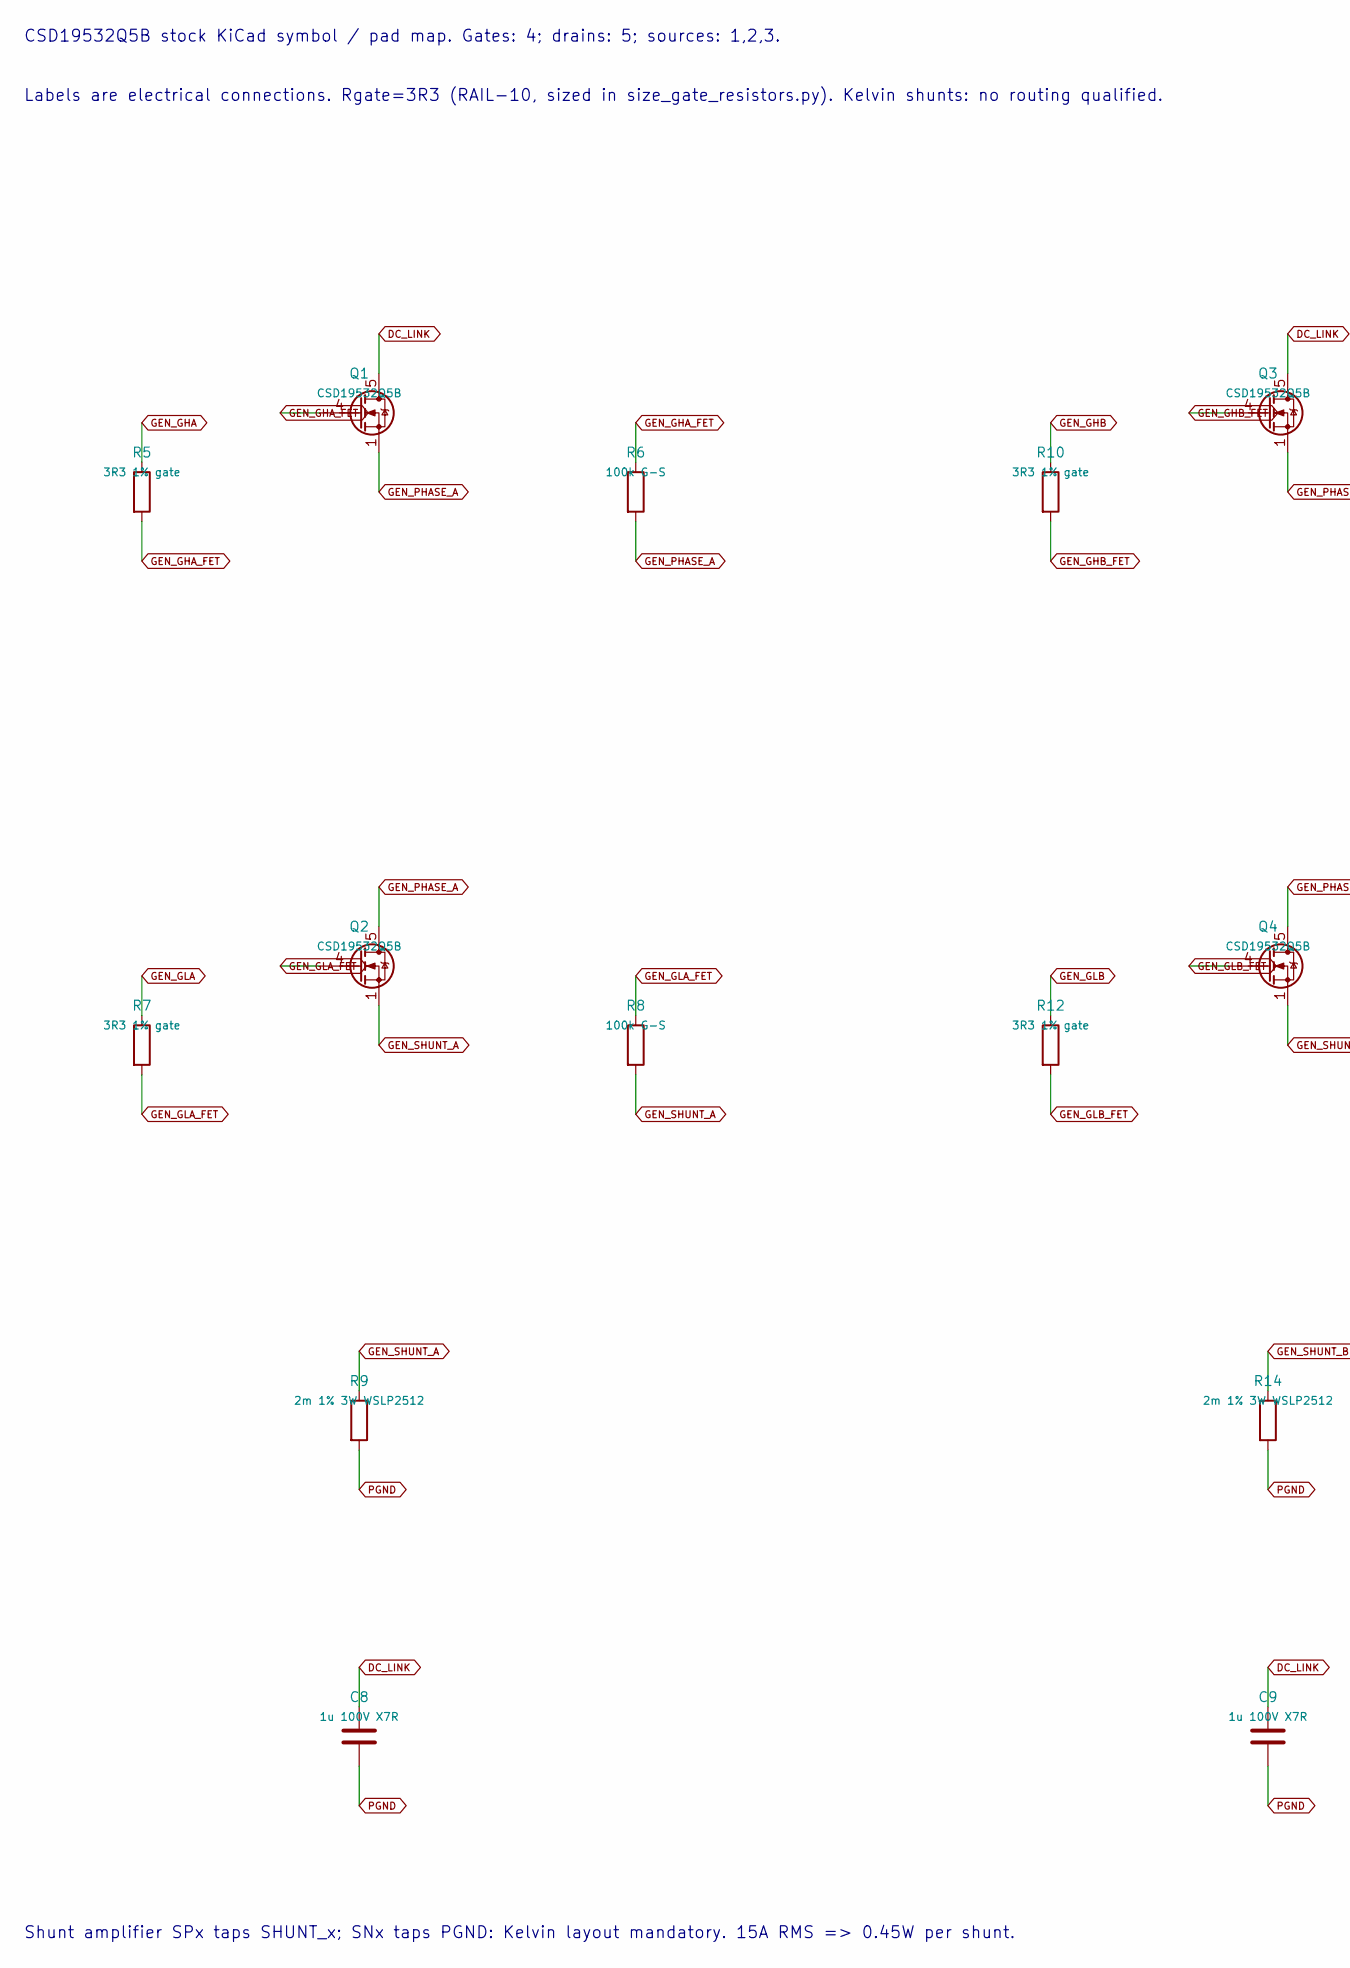
[picture p40: schematic gen-bridge.kicad_sch, GEN 100 V MOSFET bridge - schematic only, part in row 1, column 1]

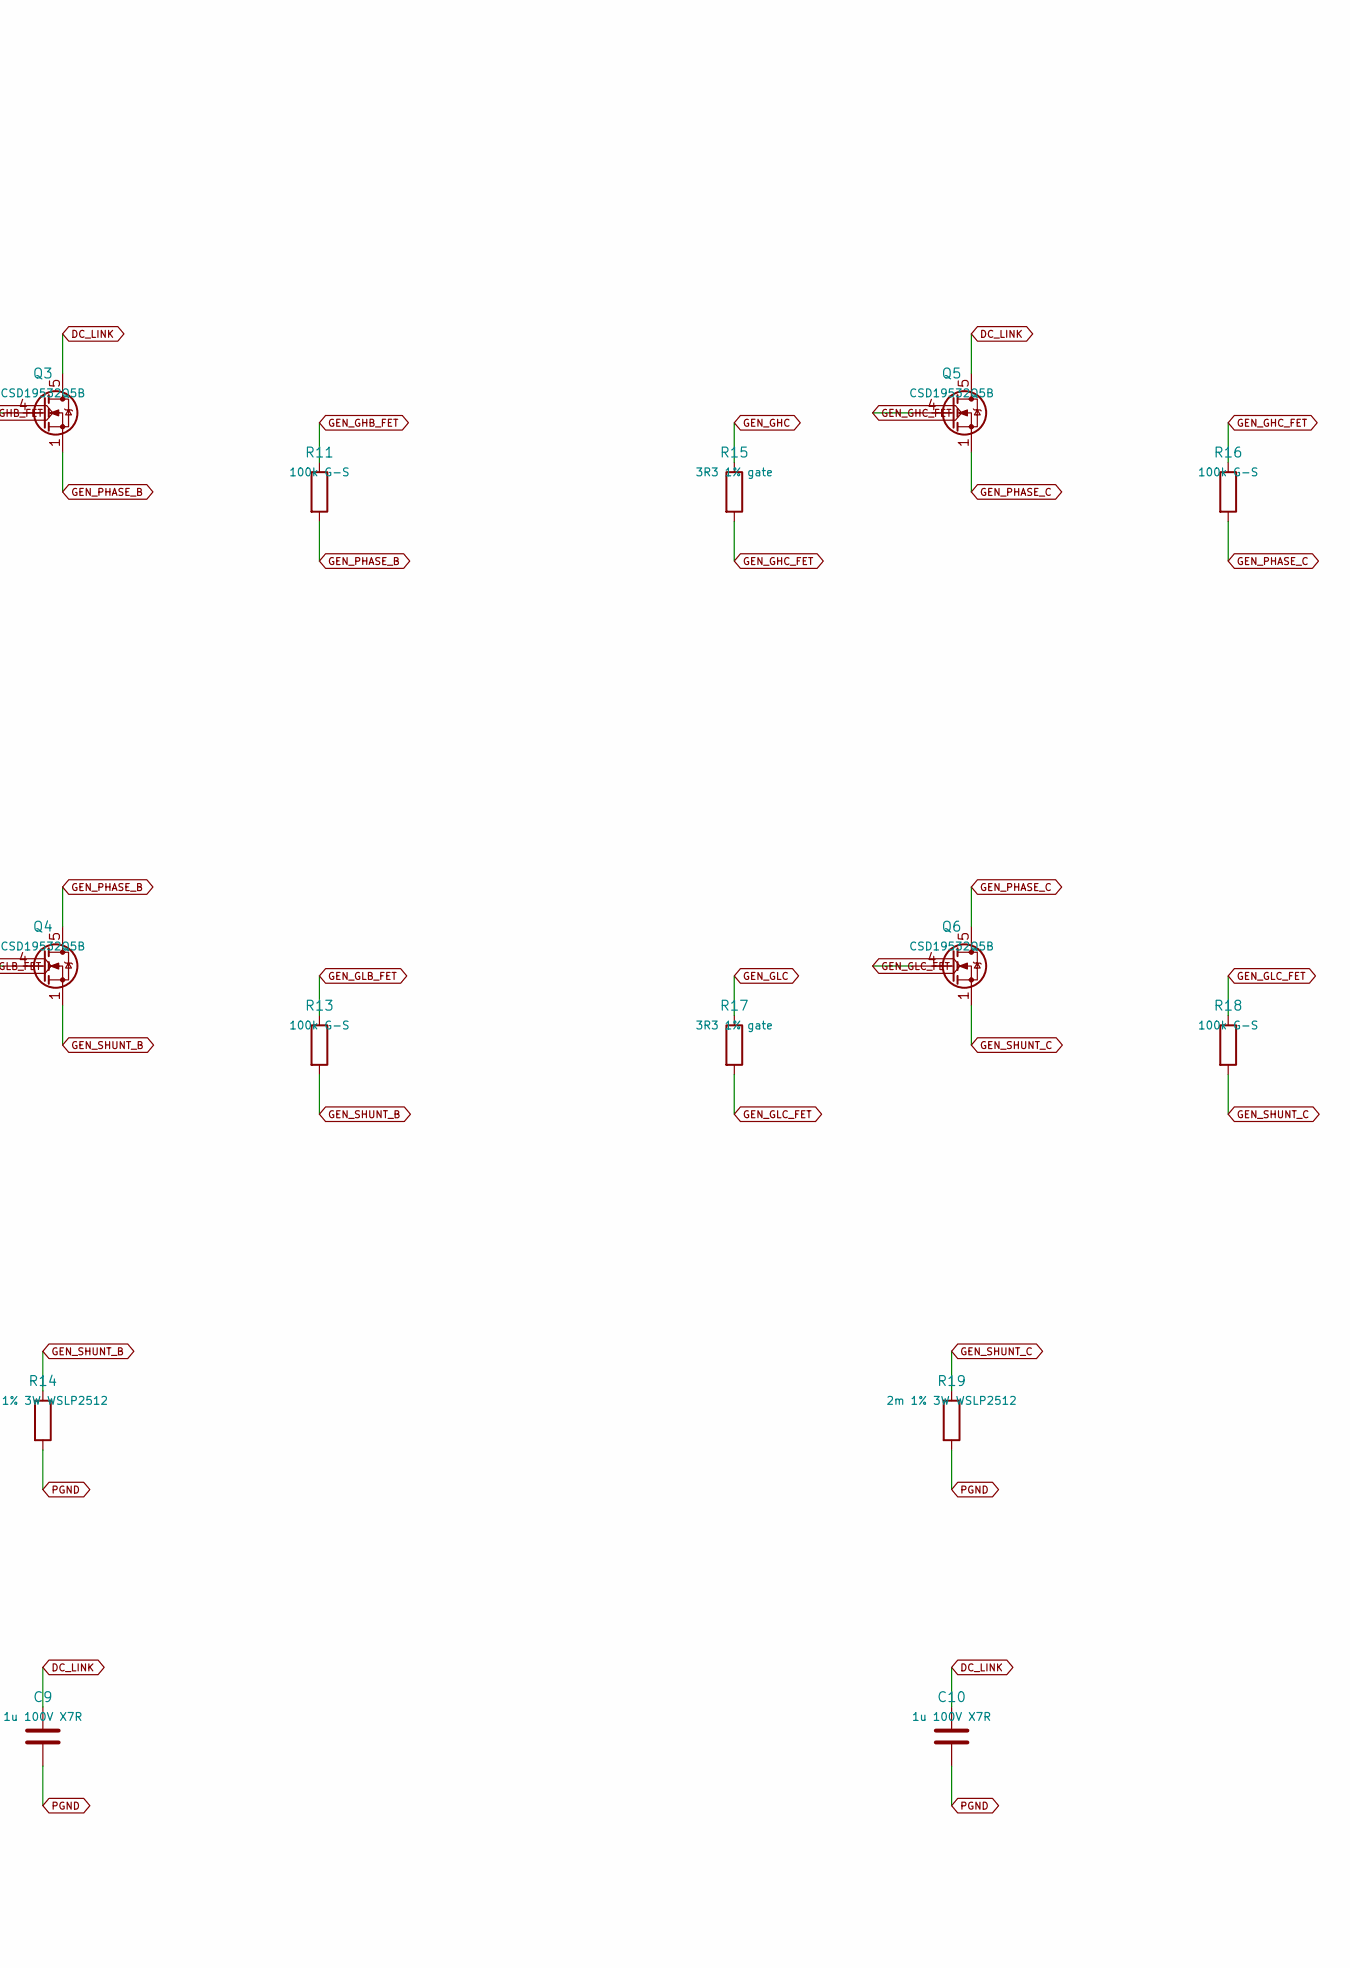
[picture p41: schematic gen-bridge.kicad_sch, GEN 100 V MOSFET bridge - schematic only, part in row 1, column 2]

Parts:
C8, C9, C10: 1u 100V X7R; C_0805_2012Metric
Q1, Q2, Q3, Q4, Q5, Q6: CSD19532Q5B; TDSON-8-1
R5, R7, R10, R12, R15, R17: 3R3 1% gate; R_0805_2012Metric
R6, R8, R11, R13, R16, R18: 100k G-S; R_0805_2012Metric
R9, R14, R19: 2m 1% 3W WSLP2512; R_2512_6332Metric

Connections:
DC_LINK: C8.1, C9.1, C10.1, Q1.5 (D), Q3.5 (D), Q5.5 (D); also elsewhere on the board
GEN_GHA: R5.1; also elsewhere on the board
GEN_GHA_FET: Q1.4 (G), R5.2, R6.1
GEN_GHB: R10.1; also elsewhere on the board
GEN_GHB_FET: Q3.4 (G), R10.2, R11.1
GEN_GHC: R15.1; also elsewhere on the board
GEN_GHC_FET: Q5.4 (G), R15.2, R16.1
GEN_GLA: R7.1; also elsewhere on the board
GEN_GLA_FET: Q2.4 (G), R7.2, R8.1
GEN_GLB: R12.1; also elsewhere on the board
GEN_GLB_FET: Q4.4 (G), R12.2, R13.1
GEN_GLC: R17.1; also elsewhere on the board
GEN_GLC_FET: Q6.4 (G), R17.2, R18.1
GEN_PHASE_A: Q1.1 (S), Q1.2 (S), Q1.3 (S), Q2.5 (D), R6.2; also elsewhere on the board
GEN_PHASE_B: Q3.1 (S), Q3.2 (S), Q3.3 (S), Q4.5 (D), R11.2; also elsewhere on the board
GEN_PHASE_C: Q5.1 (S), Q5.2 (S), Q5.3 (S), Q6.5 (D), R16.2; also elsewhere on the board
GEN_SHUNT_A: Q2.1 (S), Q2.2 (S), Q2.3 (S), R8.2, R9.1; also elsewhere on the board
GEN_SHUNT_B: Q4.1 (S), Q4.2 (S), Q4.3 (S), R13.2, R14.1; also elsewhere on the board
GEN_SHUNT_C: Q6.1 (S), Q6.2 (S), Q6.3 (S), R18.2, R19.1; also elsewhere on the board
PGND: C8.2, C9.2, C10.2, R9.2, R14.2, R19.2; also elsewhere on the board

Notes on the sheet:
CSD19532Q5B stock KiCad symbol / pad map. Gates: 4; drains: 5; sources: 1,2,3.
Labels are electrical connections. Rgate=3R3 (RAIL-10, sized in size_gate_resistors.py). Kelvin shunts: no routing qualified.
Shunt amplifier SPx taps SHUNT_x; SNx taps PGND: Kelvin layout mandatory. 15A RMS => 0.45W per shunt.

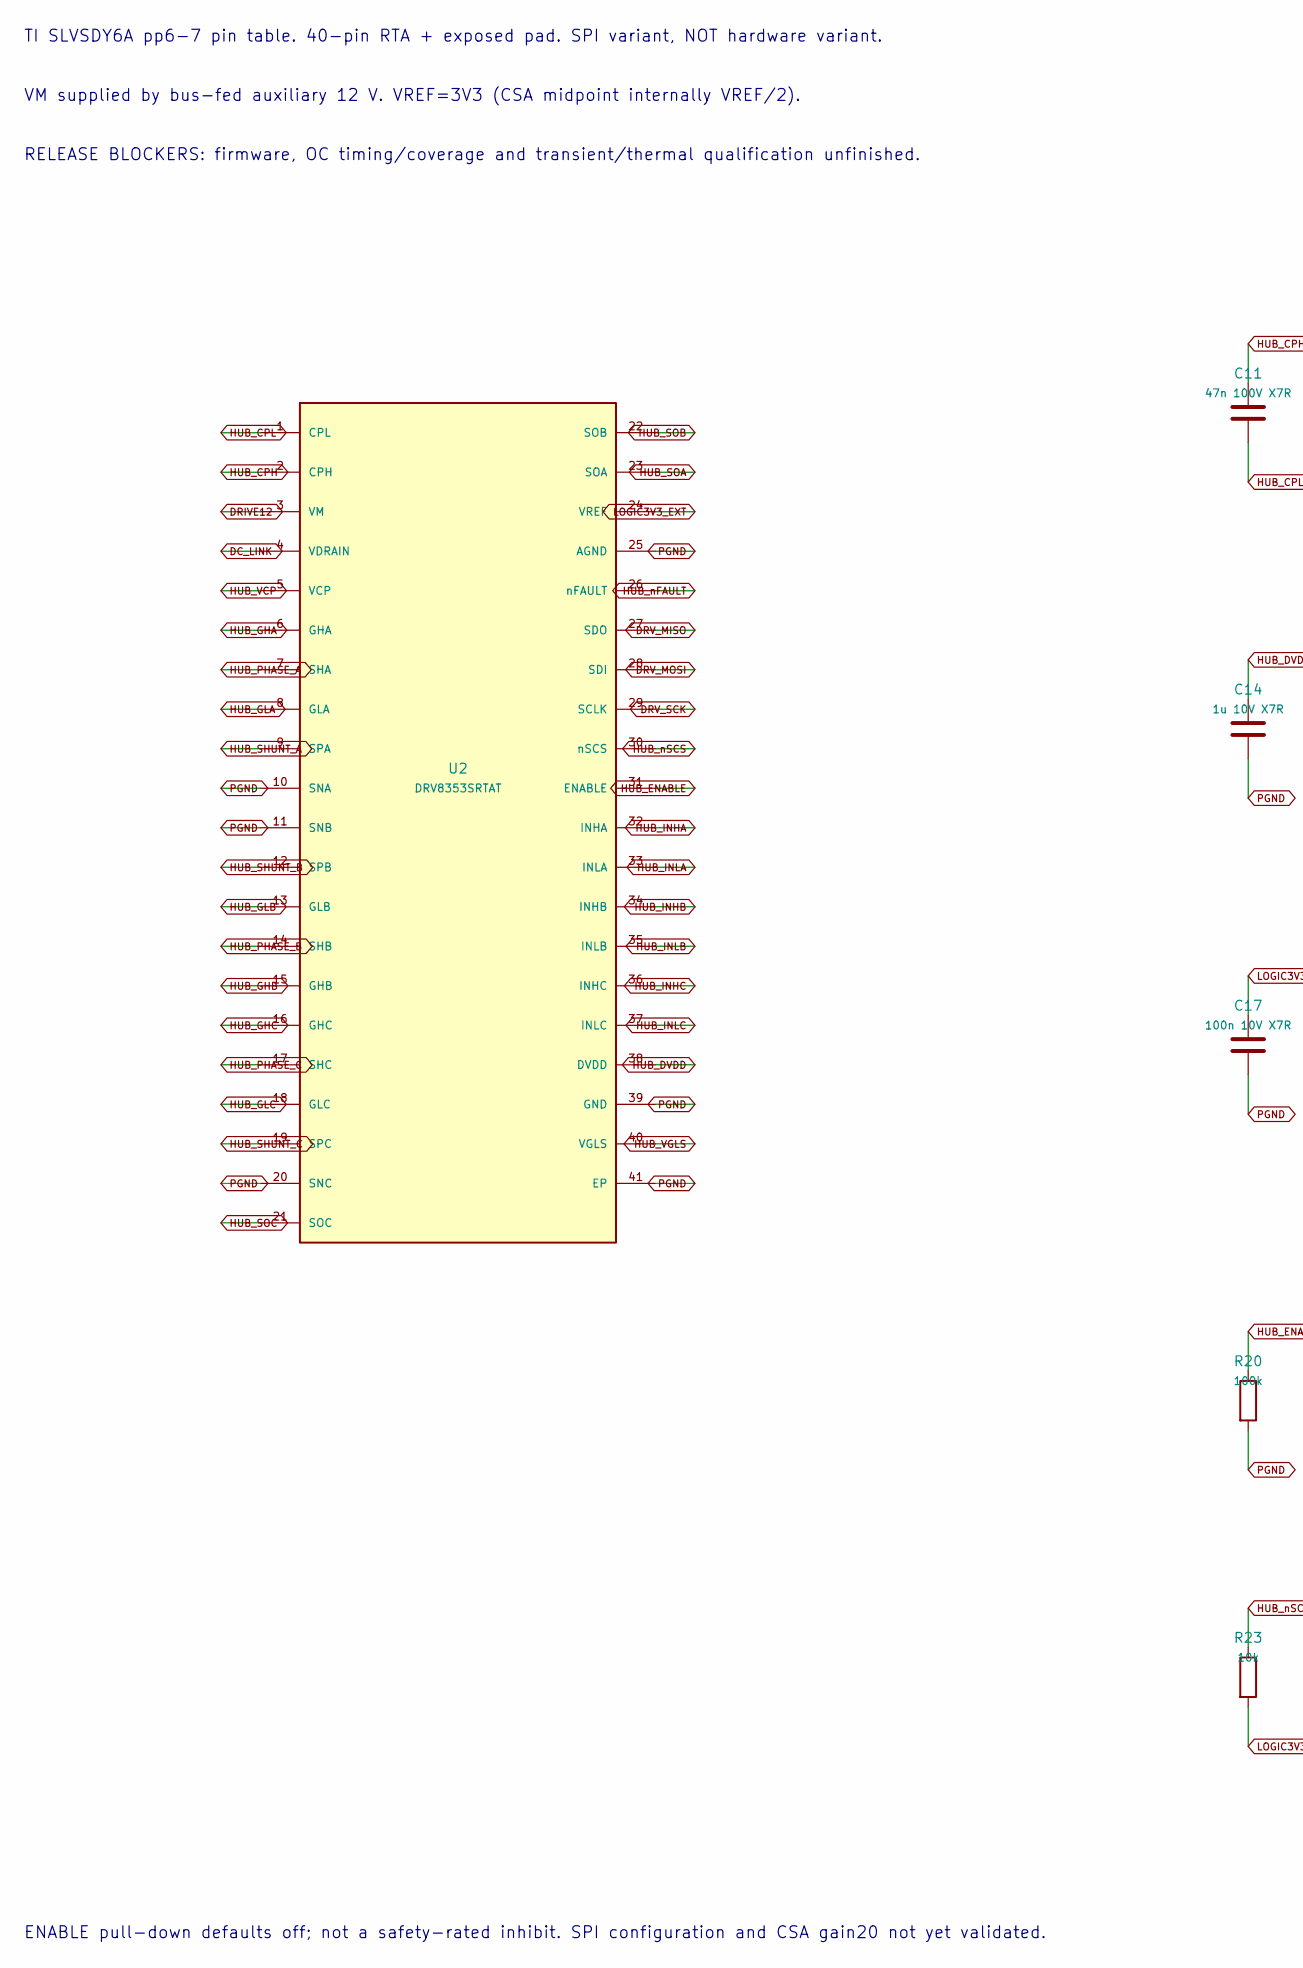
[picture p42: schematic hub-driver.kicad_sch, HUB DRV8353S driver and three low-side current channels, part in row 1, column 1]

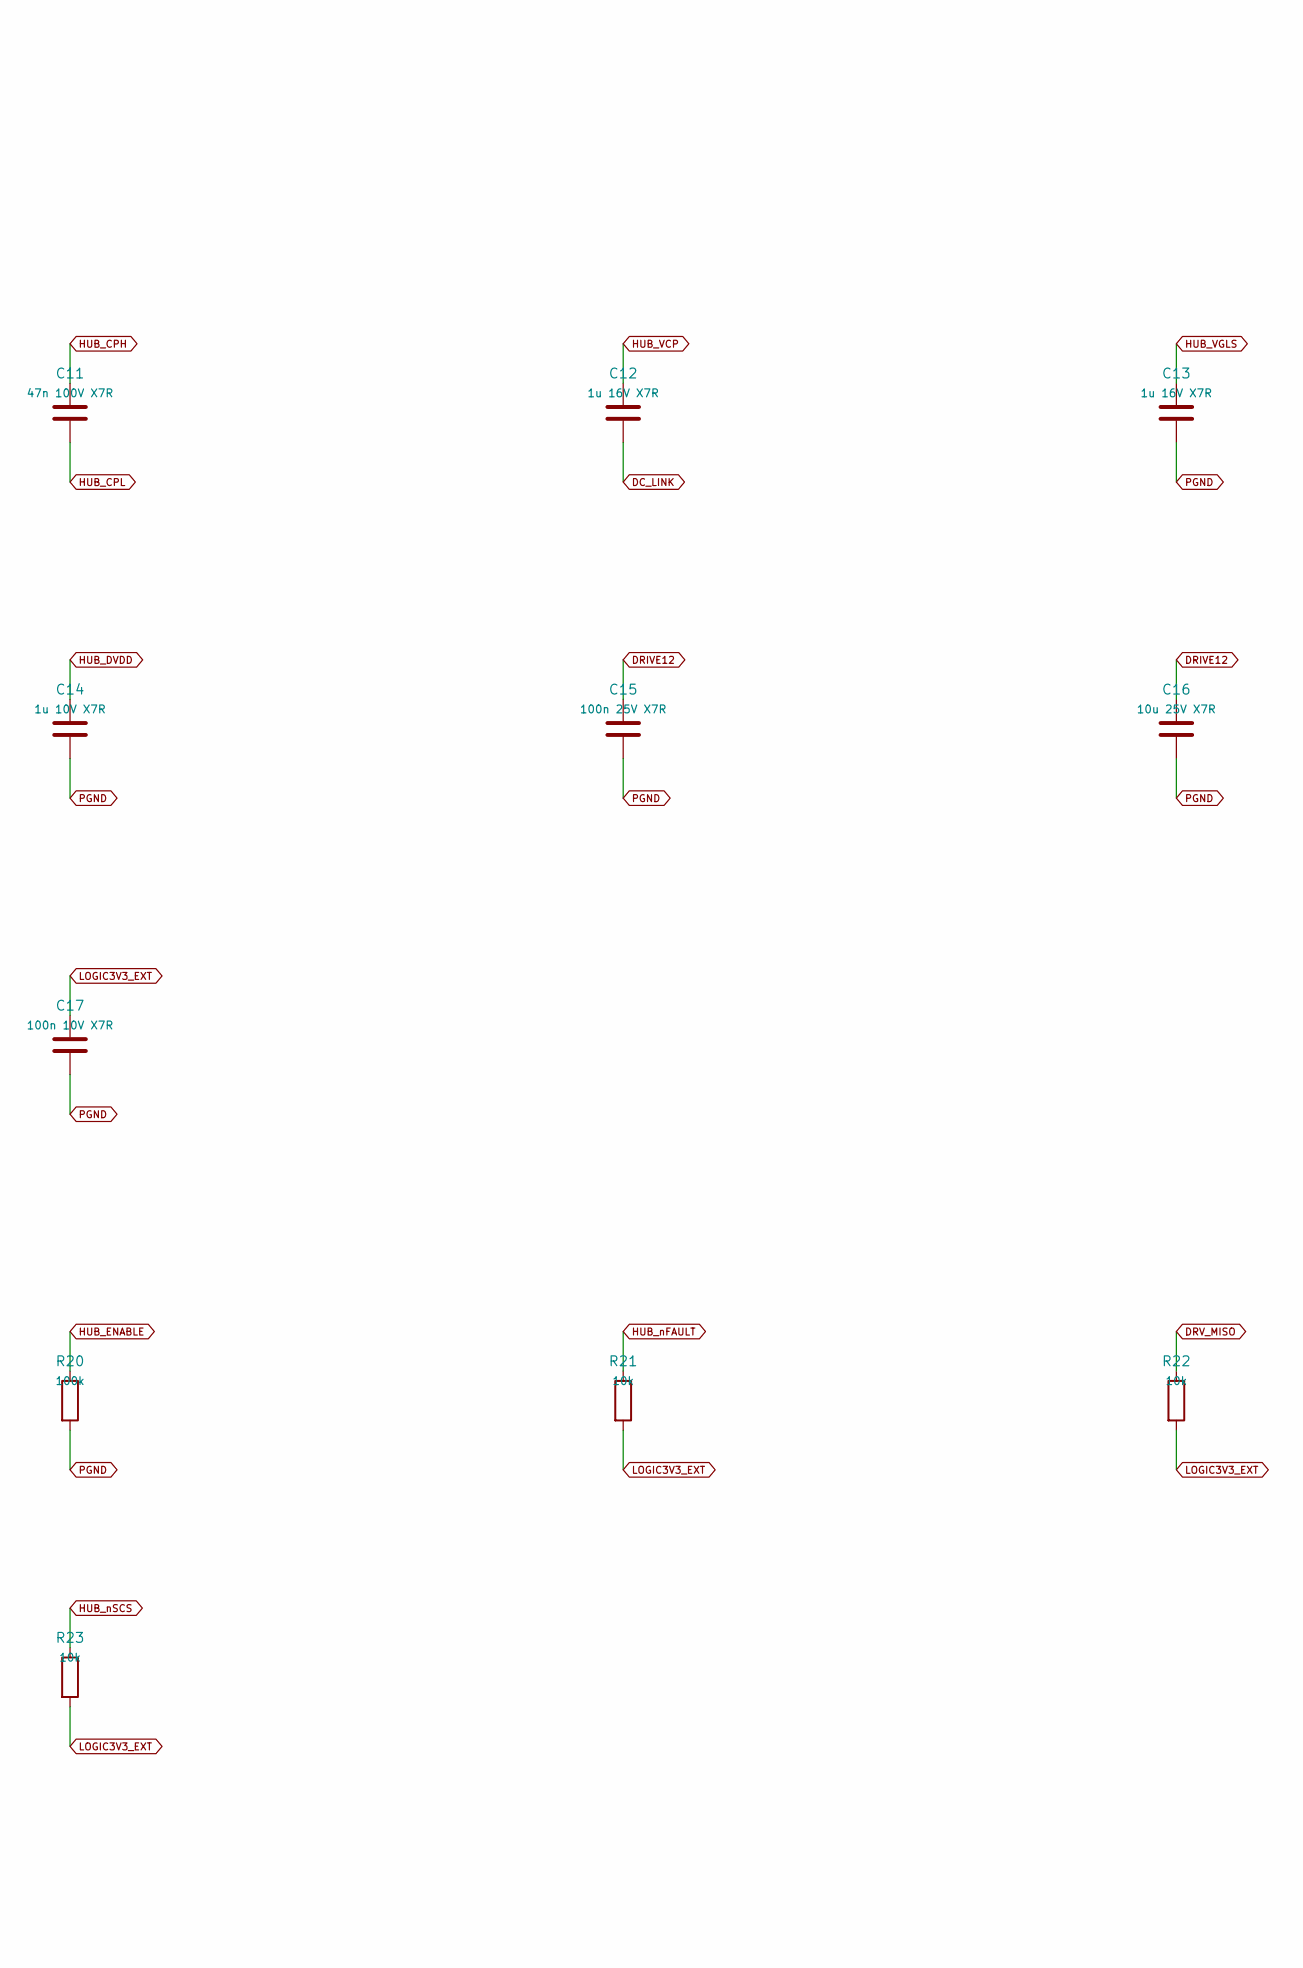
[picture p43: schematic hub-driver.kicad_sch, HUB DRV8353S driver and three low-side current channels, part in row 1, column 2]

Parts:
C11: 47n 100V X7R; C_0805_2012Metric
C12, C13: 1u 16V X7R; C_0805_2012Metric
C14: 1u 10V X7R; C_0603_1608Metric
C15: 100n 25V X7R; C_0805_2012Metric
C16: 10u 25V X7R; C_0805_2012Metric
C17: 100n 10V X7R; C_0603_1608Metric
R20: 100k; R_0805_2012Metric
R21, R22, R23: 10k; R_0805_2012Metric
U2: DRV8353SRTAT; QFN-40-1EP_6x6mm_P0.5mm_EP4.6x4.6mm

Connections:
DC_LINK: C12.2, U2.4 (VDRAIN); also elsewhere on the board
DRIVE12: C15.1, C16.1, U2.3 (VM); also elsewhere on the board
DRV_MISO: R22.1, U2.27 (SDO); also elsewhere on the board
DRV_MOSI: U2.28 (SDI); also elsewhere on the board
DRV_SCK: U2.29 (SCLK); also elsewhere on the board
HUB_CPH: C11.1, U2.2 (CPH)
HUB_CPL: C11.2, U2.1 (CPL)
HUB_DVDD: C14.1, U2.38 (DVDD)
HUB_ENABLE: R20.1, U2.31 (ENABLE); also elsewhere on the board
HUB_GHA: U2.6 (GHA); also elsewhere on the board
HUB_GHB: U2.15 (GHB); also elsewhere on the board
HUB_GHC: U2.16 (GHC); also elsewhere on the board
HUB_GLA: U2.8 (GLA); also elsewhere on the board
HUB_GLB: U2.13 (GLB); also elsewhere on the board
HUB_GLC: U2.18 (GLC); also elsewhere on the board
HUB_INHA: U2.32 (INHA); also elsewhere on the board
HUB_INHB: U2.34 (INHB); also elsewhere on the board
HUB_INHC: U2.36 (INHC); also elsewhere on the board
HUB_INLA: U2.33 (INLA); also elsewhere on the board
HUB_INLB: U2.35 (INLB); also elsewhere on the board
HUB_INLC: U2.37 (INLC); also elsewhere on the board
HUB_PHASE_A: U2.7 (SHA); also elsewhere on the board
HUB_PHASE_B: U2.14 (SHB); also elsewhere on the board
HUB_PHASE_C: U2.17 (SHC); also elsewhere on the board
HUB_SHUNT_A: U2.9 (SPA); also elsewhere on the board
HUB_SHUNT_B: U2.12 (SPB); also elsewhere on the board
HUB_SHUNT_C: U2.19 (SPC); also elsewhere on the board
HUB_SOA: U2.23 (SOA); also elsewhere on the board
HUB_SOB: U2.22 (SOB); also elsewhere on the board
HUB_SOC: U2.21 (SOC); also elsewhere on the board
HUB_VCP: C12.1, U2.5 (VCP)
HUB_VGLS: C13.1, U2.40 (VGLS)
HUB_nFAULT: R21.1, U2.26 (nFAULT); also elsewhere on the board
HUB_nSCS: R23.1, U2.30 (nSCS); also elsewhere on the board
LOGIC3V3_EXT: C17.1, R21.2, R22.2, R23.2, U2.24 (VREF); also elsewhere on the board
PGND: C13.2, C14.2, C15.2, C16.2, C17.2, R20.2, U2.10 (SNA), U2.11 (SNB), U2.20 (SNC), U2.25 (AGND), U2.39 (GND), U2.41 (EP); also elsewhere on the board

Notes on the sheet:
TI SLVSDY6A pp6-7 pin table. 40-pin RTA + exposed pad. SPI variant, NOT hardware variant.
VM supplied by bus-fed auxiliary 12 V. VREF=3V3 (CSA midpoint internally VREF/2).
RELEASE BLOCKERS: firmware, OC timing/coverage and transient/thermal qualification unfinished.
ENABLE pull-down defaults off; not a safety-rated inhibit. SPI configuration and CSA gain20 not yet validated.
