felixfelix-bot/cycle-without-chain/hardware/powerboard-reva/powerboard-reva.kicad_pcb

## KiCad design hardware/powerboard-reva/powerboard-reva.kicad_pcb (continued)

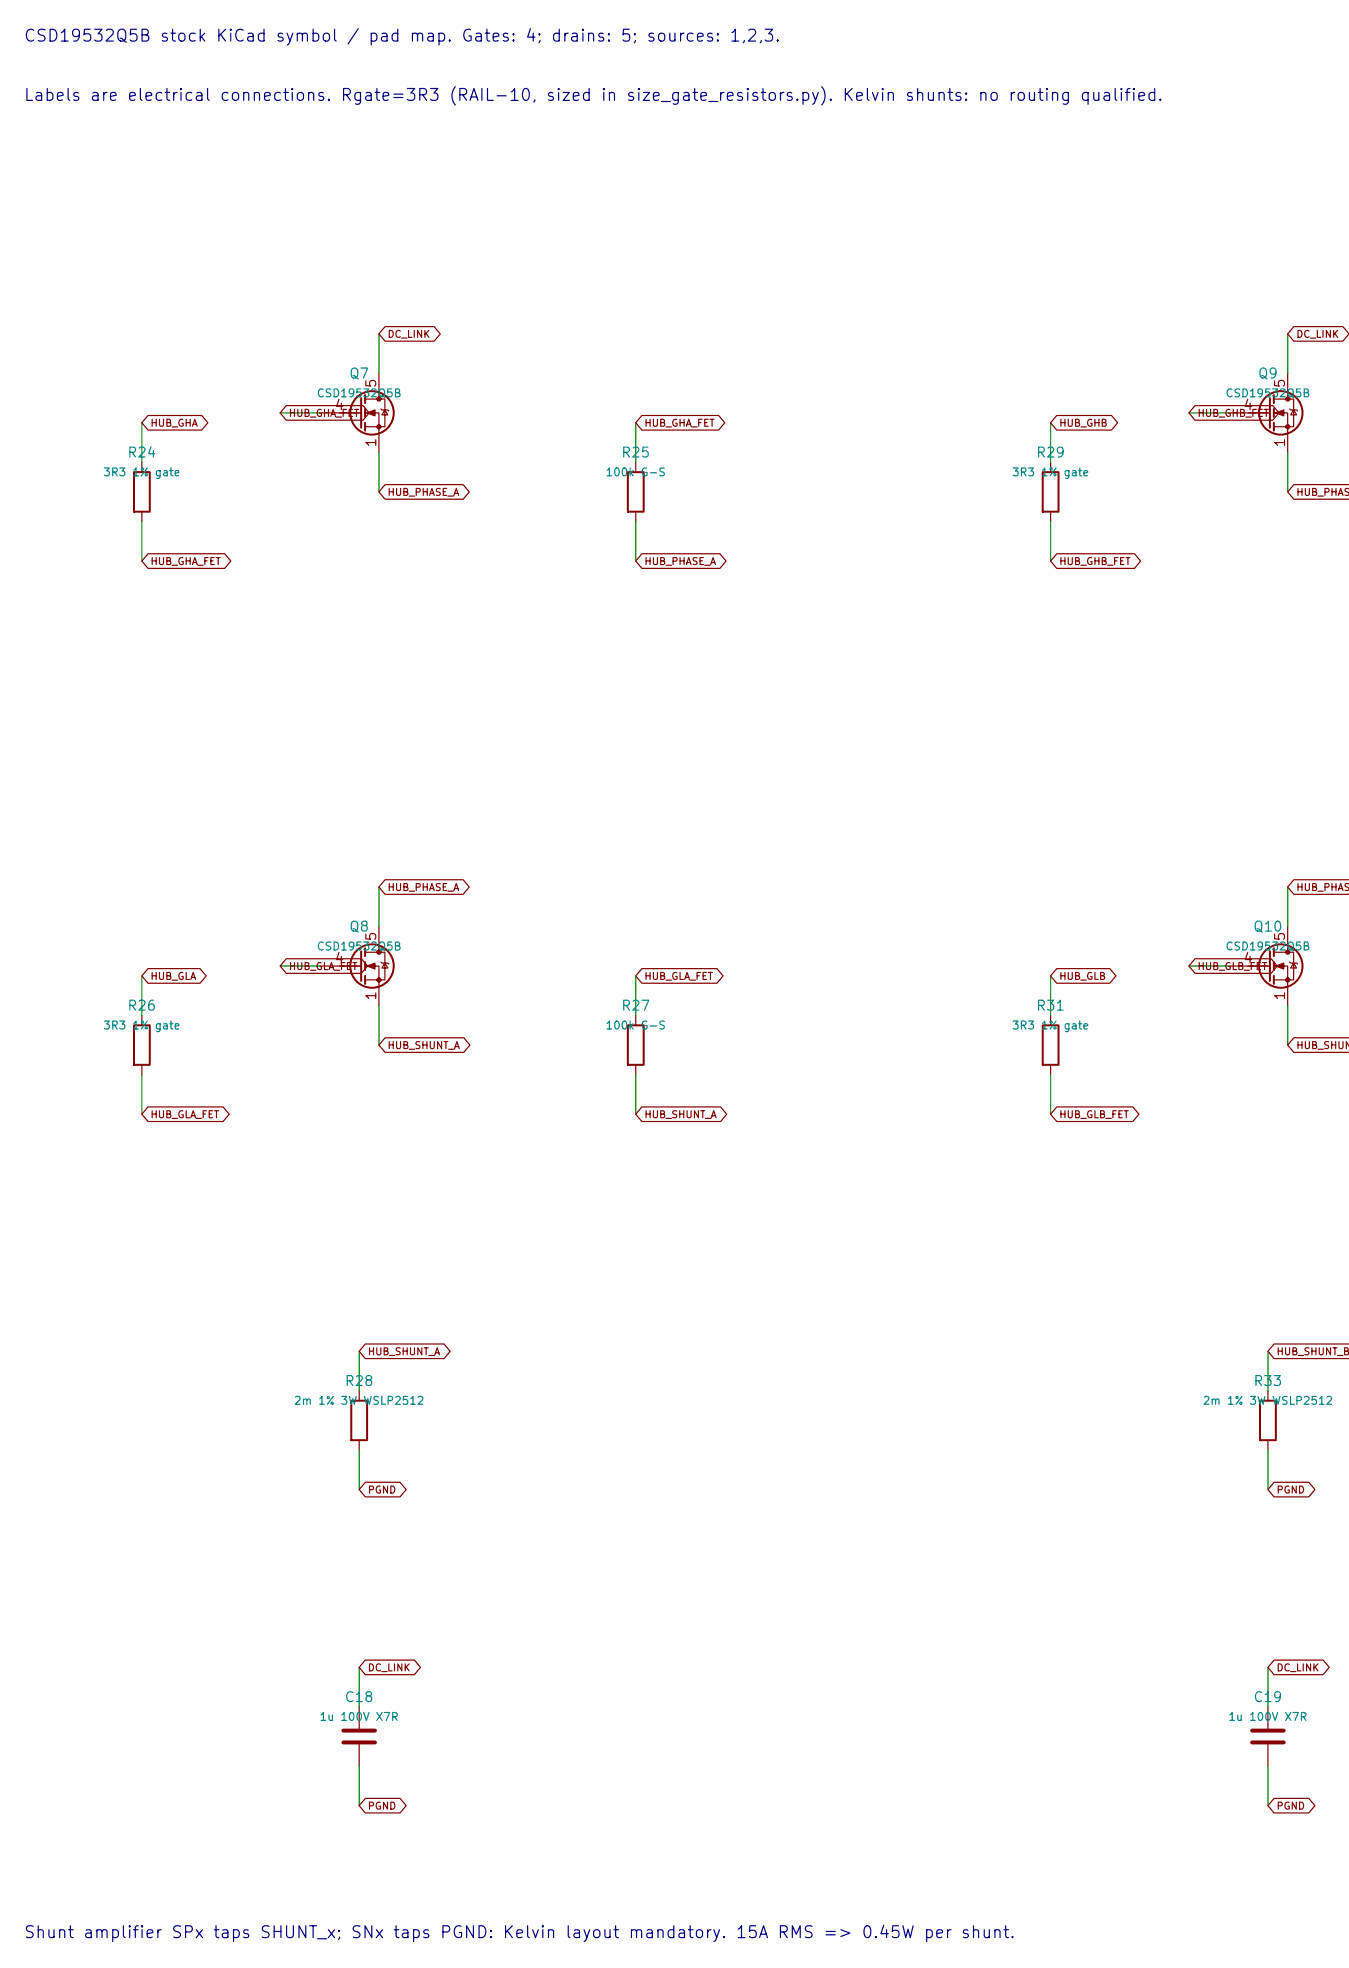
[picture p44: schematic hub-bridge.kicad_sch, HUB 100 V MOSFET bridge - schematic only, part in row 1, column 1]

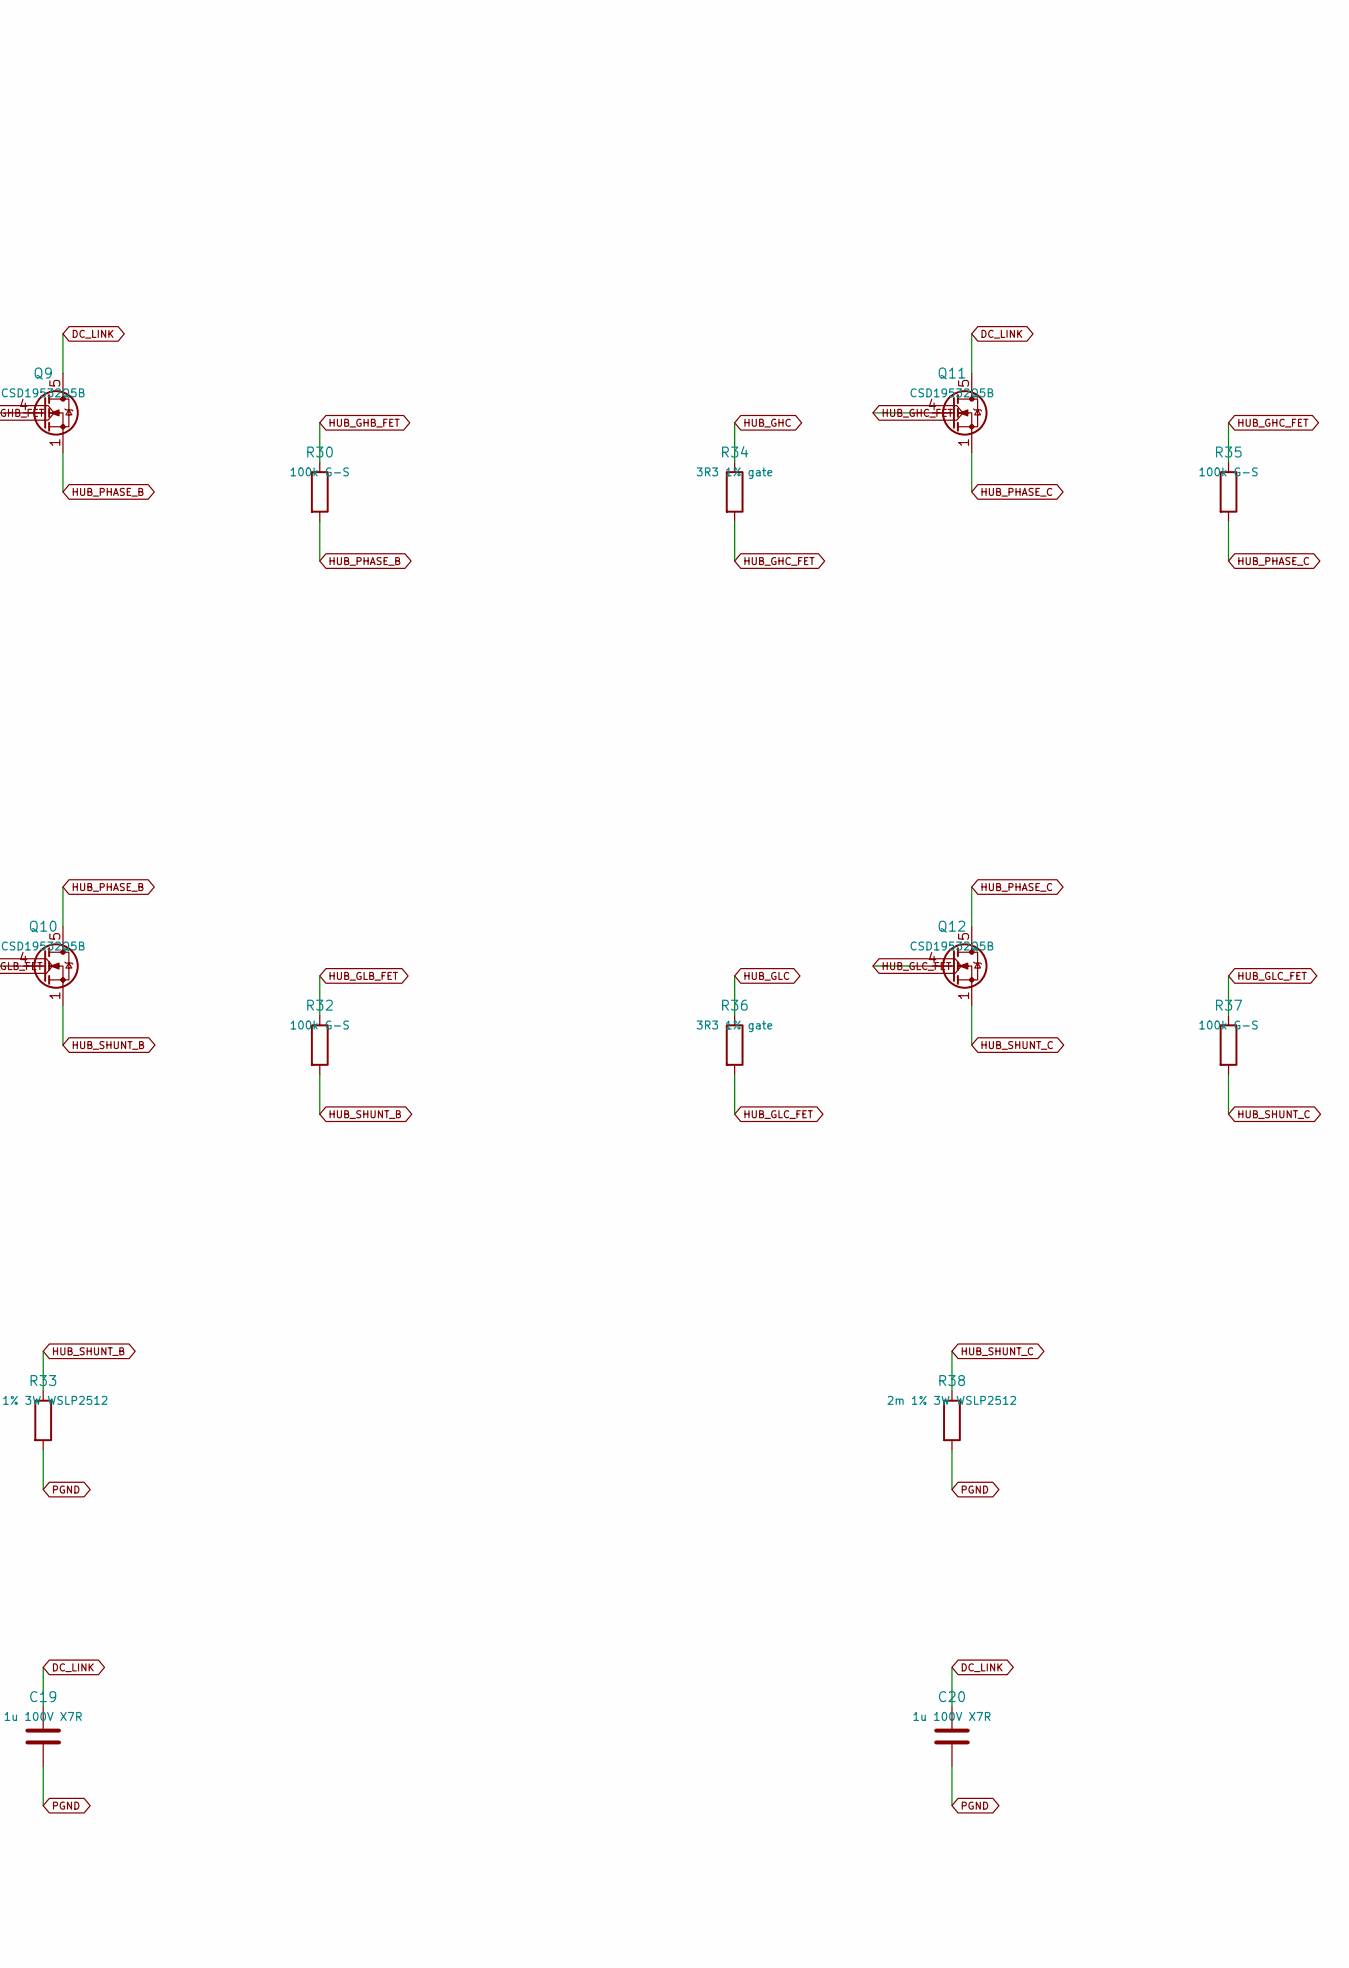
[picture p45: schematic hub-bridge.kicad_sch, HUB 100 V MOSFET bridge - schematic only, part in row 1, column 2]

Parts:
C18, C19, C20: 1u 100V X7R; C_0805_2012Metric
Q7, Q8, Q9, Q10, Q11, Q12: CSD19532Q5B; TDSON-8-1
R24, R26, R29, R31, R34, R36: 3R3 1% gate; R_0805_2012Metric
R25, R27, R30, R32, R35, R37: 100k G-S; R_0805_2012Metric
R28, R33, R38: 2m 1% 3W WSLP2512; R_2512_6332Metric

Connections:
DC_LINK: C18.1, C19.1, C20.1, Q7.5 (D), Q9.5 (D), Q11.5 (D); also elsewhere on the board
HUB_GHA: R24.1; also elsewhere on the board
HUB_GHA_FET: Q7.4 (G), R24.2, R25.1
HUB_GHB: R29.1; also elsewhere on the board
HUB_GHB_FET: Q9.4 (G), R29.2, R30.1
HUB_GHC: R34.1; also elsewhere on the board
HUB_GHC_FET: Q11.4 (G), R34.2, R35.1
HUB_GLA: R26.1; also elsewhere on the board
HUB_GLA_FET: Q8.4 (G), R26.2, R27.1
HUB_GLB: R31.1; also elsewhere on the board
HUB_GLB_FET: Q10.4 (G), R31.2, R32.1
HUB_GLC: R36.1; also elsewhere on the board
HUB_GLC_FET: Q12.4 (G), R36.2, R37.1
HUB_PHASE_A: Q7.1 (S), Q7.2 (S), Q7.3 (S), Q8.5 (D), R25.2; also elsewhere on the board
HUB_PHASE_B: Q9.1 (S), Q9.2 (S), Q9.3 (S), Q10.5 (D), R30.2; also elsewhere on the board
HUB_PHASE_C: Q11.1 (S), Q11.2 (S), Q11.3 (S), Q12.5 (D), R35.2; also elsewhere on the board
HUB_SHUNT_A: Q8.1 (S), Q8.2 (S), Q8.3 (S), R27.2, R28.1; also elsewhere on the board
HUB_SHUNT_B: Q10.1 (S), Q10.2 (S), Q10.3 (S), R32.2, R33.1; also elsewhere on the board
HUB_SHUNT_C: Q12.1 (S), Q12.2 (S), Q12.3 (S), R37.2, R38.1; also elsewhere on the board
PGND: C18.2, C19.2, C20.2, R28.2, R33.2, R38.2; also elsewhere on the board

Notes on the sheet:
CSD19532Q5B stock KiCad symbol / pad map. Gates: 4; drains: 5; sources: 1,2,3.
Labels are electrical connections. Rgate=3R3 (RAIL-10, sized in size_gate_resistors.py). Kelvin shunts: no routing qualified.
Shunt amplifier SPx taps SHUNT_x; SNx taps PGND: Kelvin layout mandatory. 15A RMS => 0.45W per shunt.

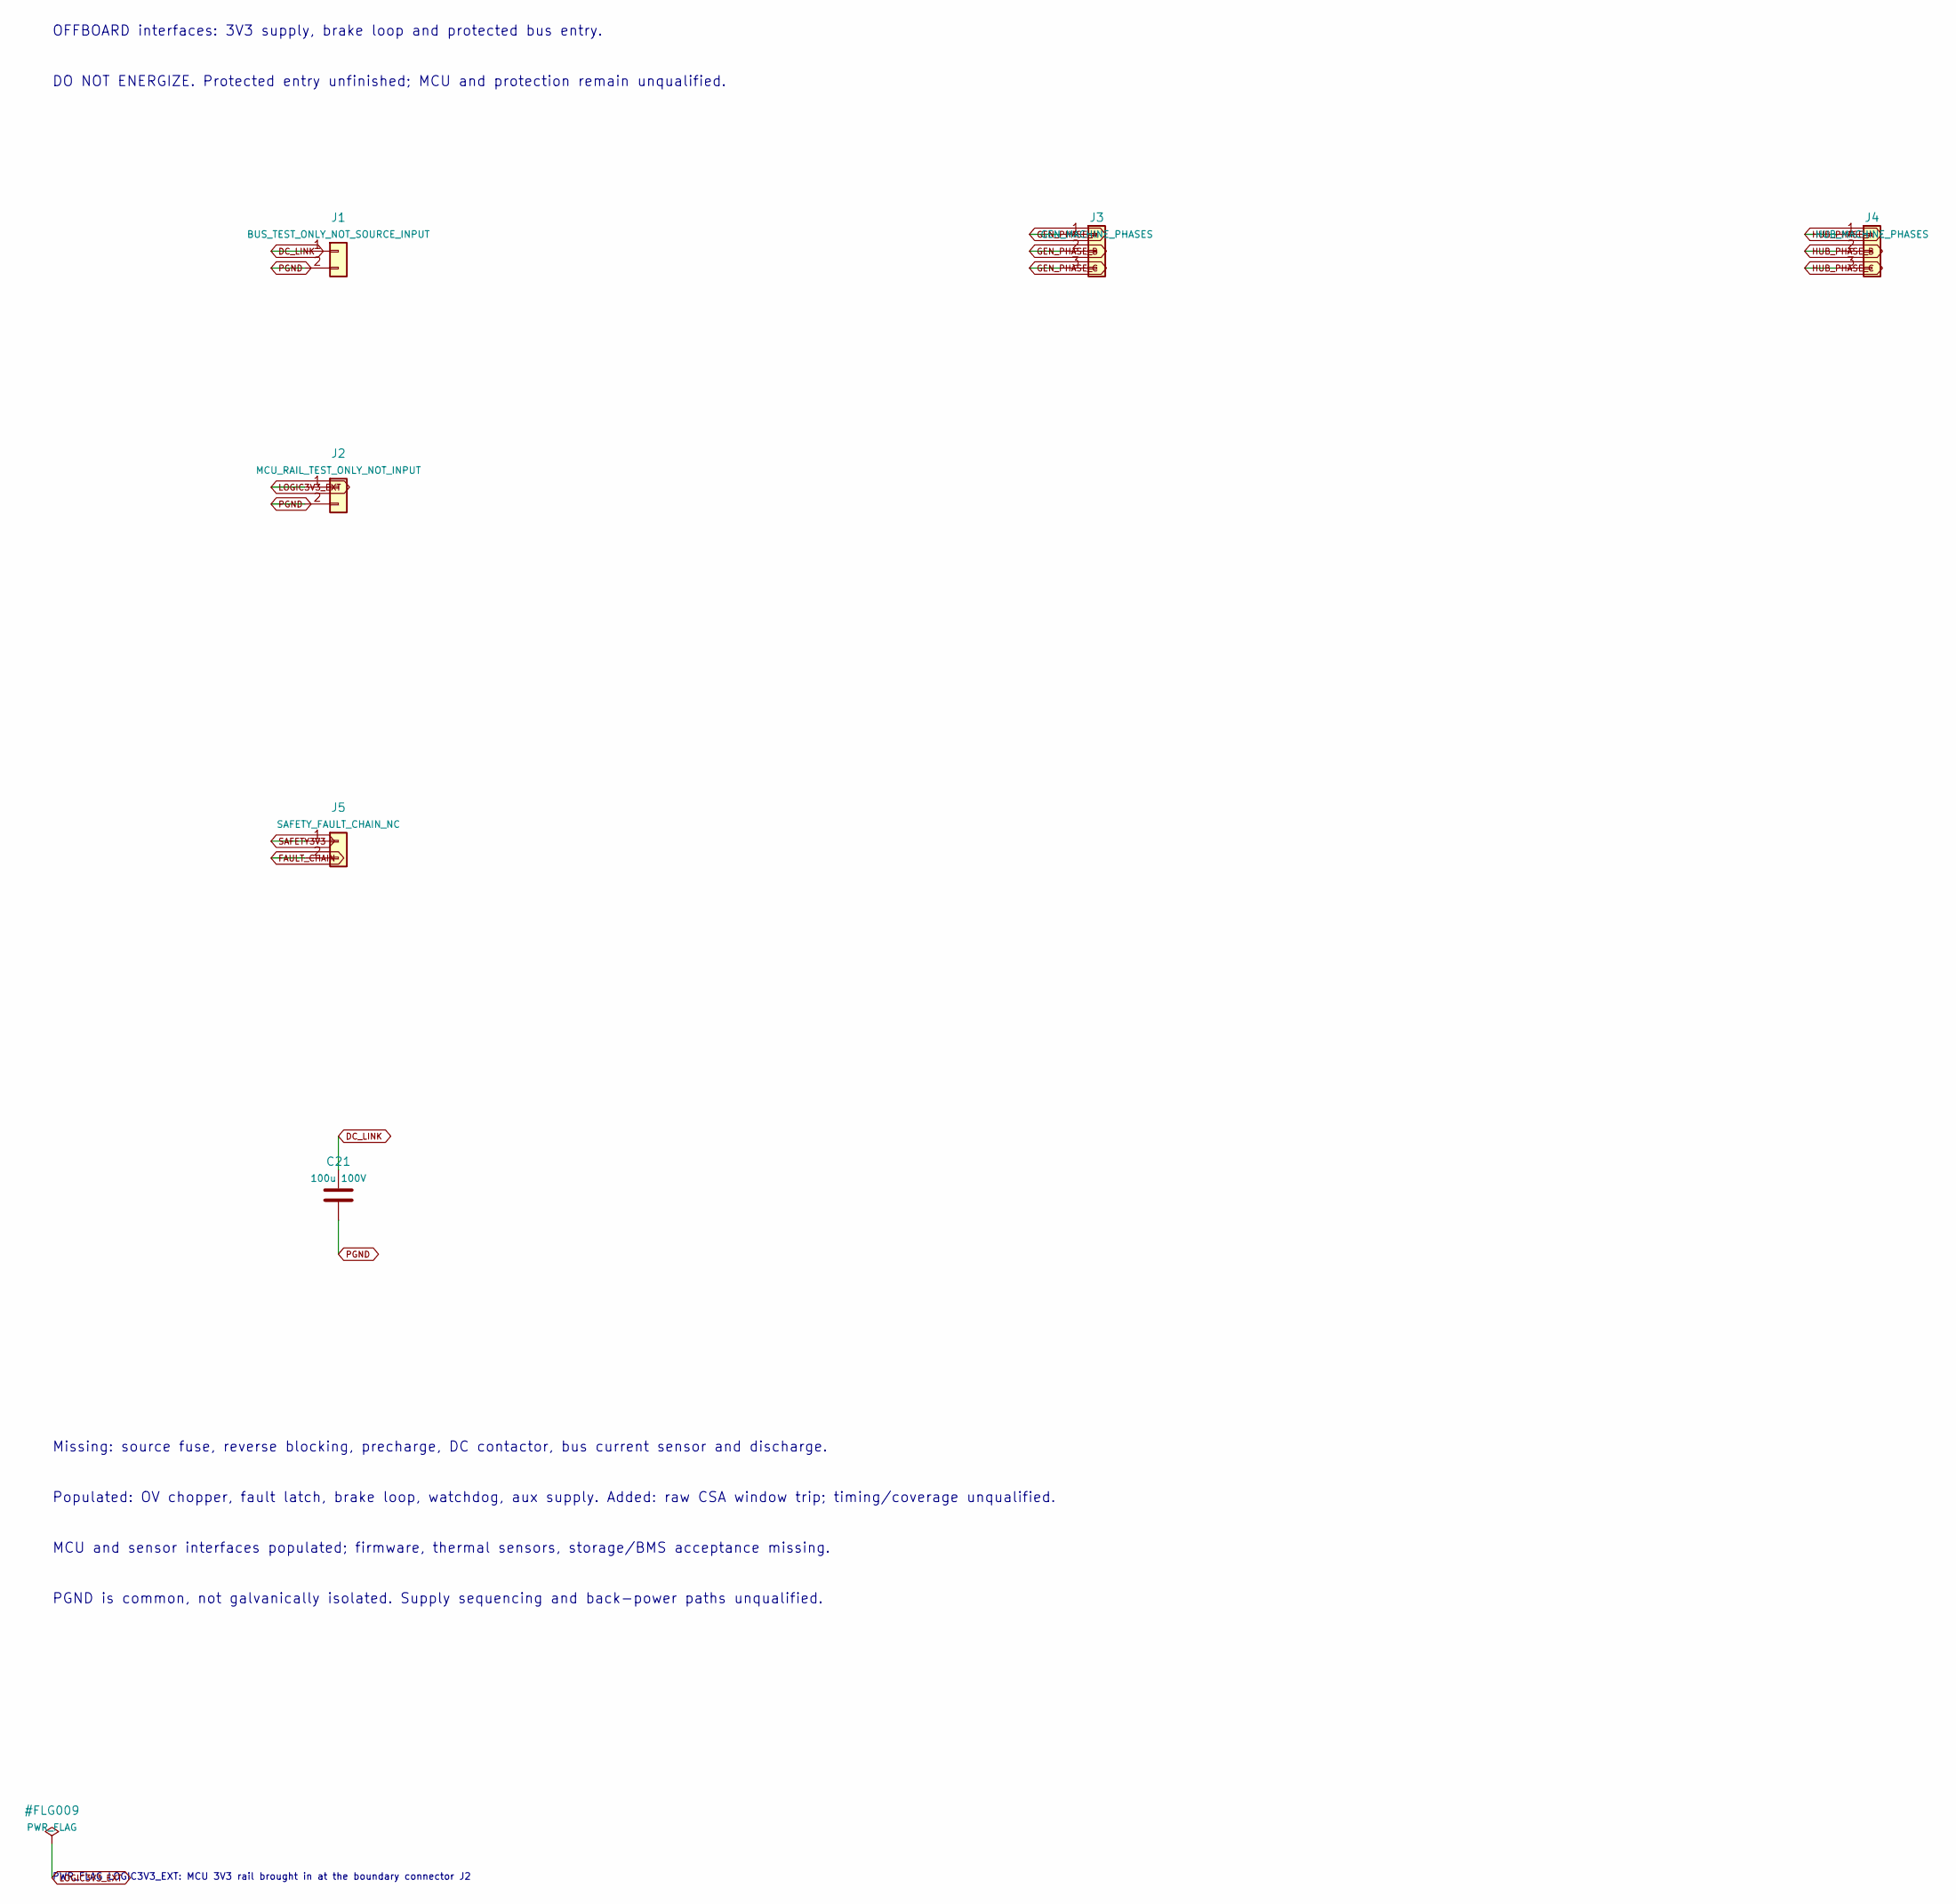
[picture p46: schematic external-boundaries.kicad_sch, Unfinished safety / control / supply boundaries]

Parts:
C21: 100u 100V; CP_Radial_D10.0mm_P5.00mm
J1: BUS_TEST_ONLY_NOT_SOURCE_INPUT; PinHeader_1x02_P2.54mm_Vertical
J2: MCU_RAIL_TEST_ONLY_NOT_INPUT; PinHeader_1x02_P2.54mm_Vertical
J3: GEN_MACHINE_PHASES; PinHeader_1x03_P2.54mm_Vertical
J4: HUB_MACHINE_PHASES; PinHeader_1x03_P2.54mm_Vertical
J5: SAFETY_FAULT_CHAIN_NC; PinHeader_1x02_P2.54mm_Vertical

Connections:
DC_LINK: C21.1, J1.1; also elsewhere on the board
FAULT_CHAIN: J5.2; also elsewhere on the board
GEN_PHASE_A: J3.1; also elsewhere on the board
GEN_PHASE_B: J3.2; also elsewhere on the board
GEN_PHASE_C: J3.3; also elsewhere on the board
HUB_PHASE_A: J4.1; also elsewhere on the board
HUB_PHASE_B: J4.2; also elsewhere on the board
HUB_PHASE_C: J4.3; also elsewhere on the board
LOGIC3V3_EXT: J2.1; also elsewhere on the board
PGND: C21.2, J1.2, J2.2; also elsewhere on the board
SAFETY3V3: J5.1; also elsewhere on the board

Notes on the sheet:
OFFBOARD interfaces: 3V3 supply, brake loop and protected bus entry.
DO NOT ENERGIZE. Protected entry unfinished; MCU and protection remain unqualified.
Missing: source fuse, reverse blocking, precharge, DC contactor, bus current sensor and discharge.
Populated: OV chopper, fault latch, brake loop, watchdog, aux supply. Added: raw CSA window trip; timing/coverage unqualified.
MCU and sensor interfaces populated; firmware, thermal sensors, storage/BMS acceptance missing.
PGND is common, not galvanically isolated. Supply sequencing and back-power paths unqualified.
PWR_FLAG LOGIC3V3_EXT: MCU 3V3 rail brought in at the boundary connector J2

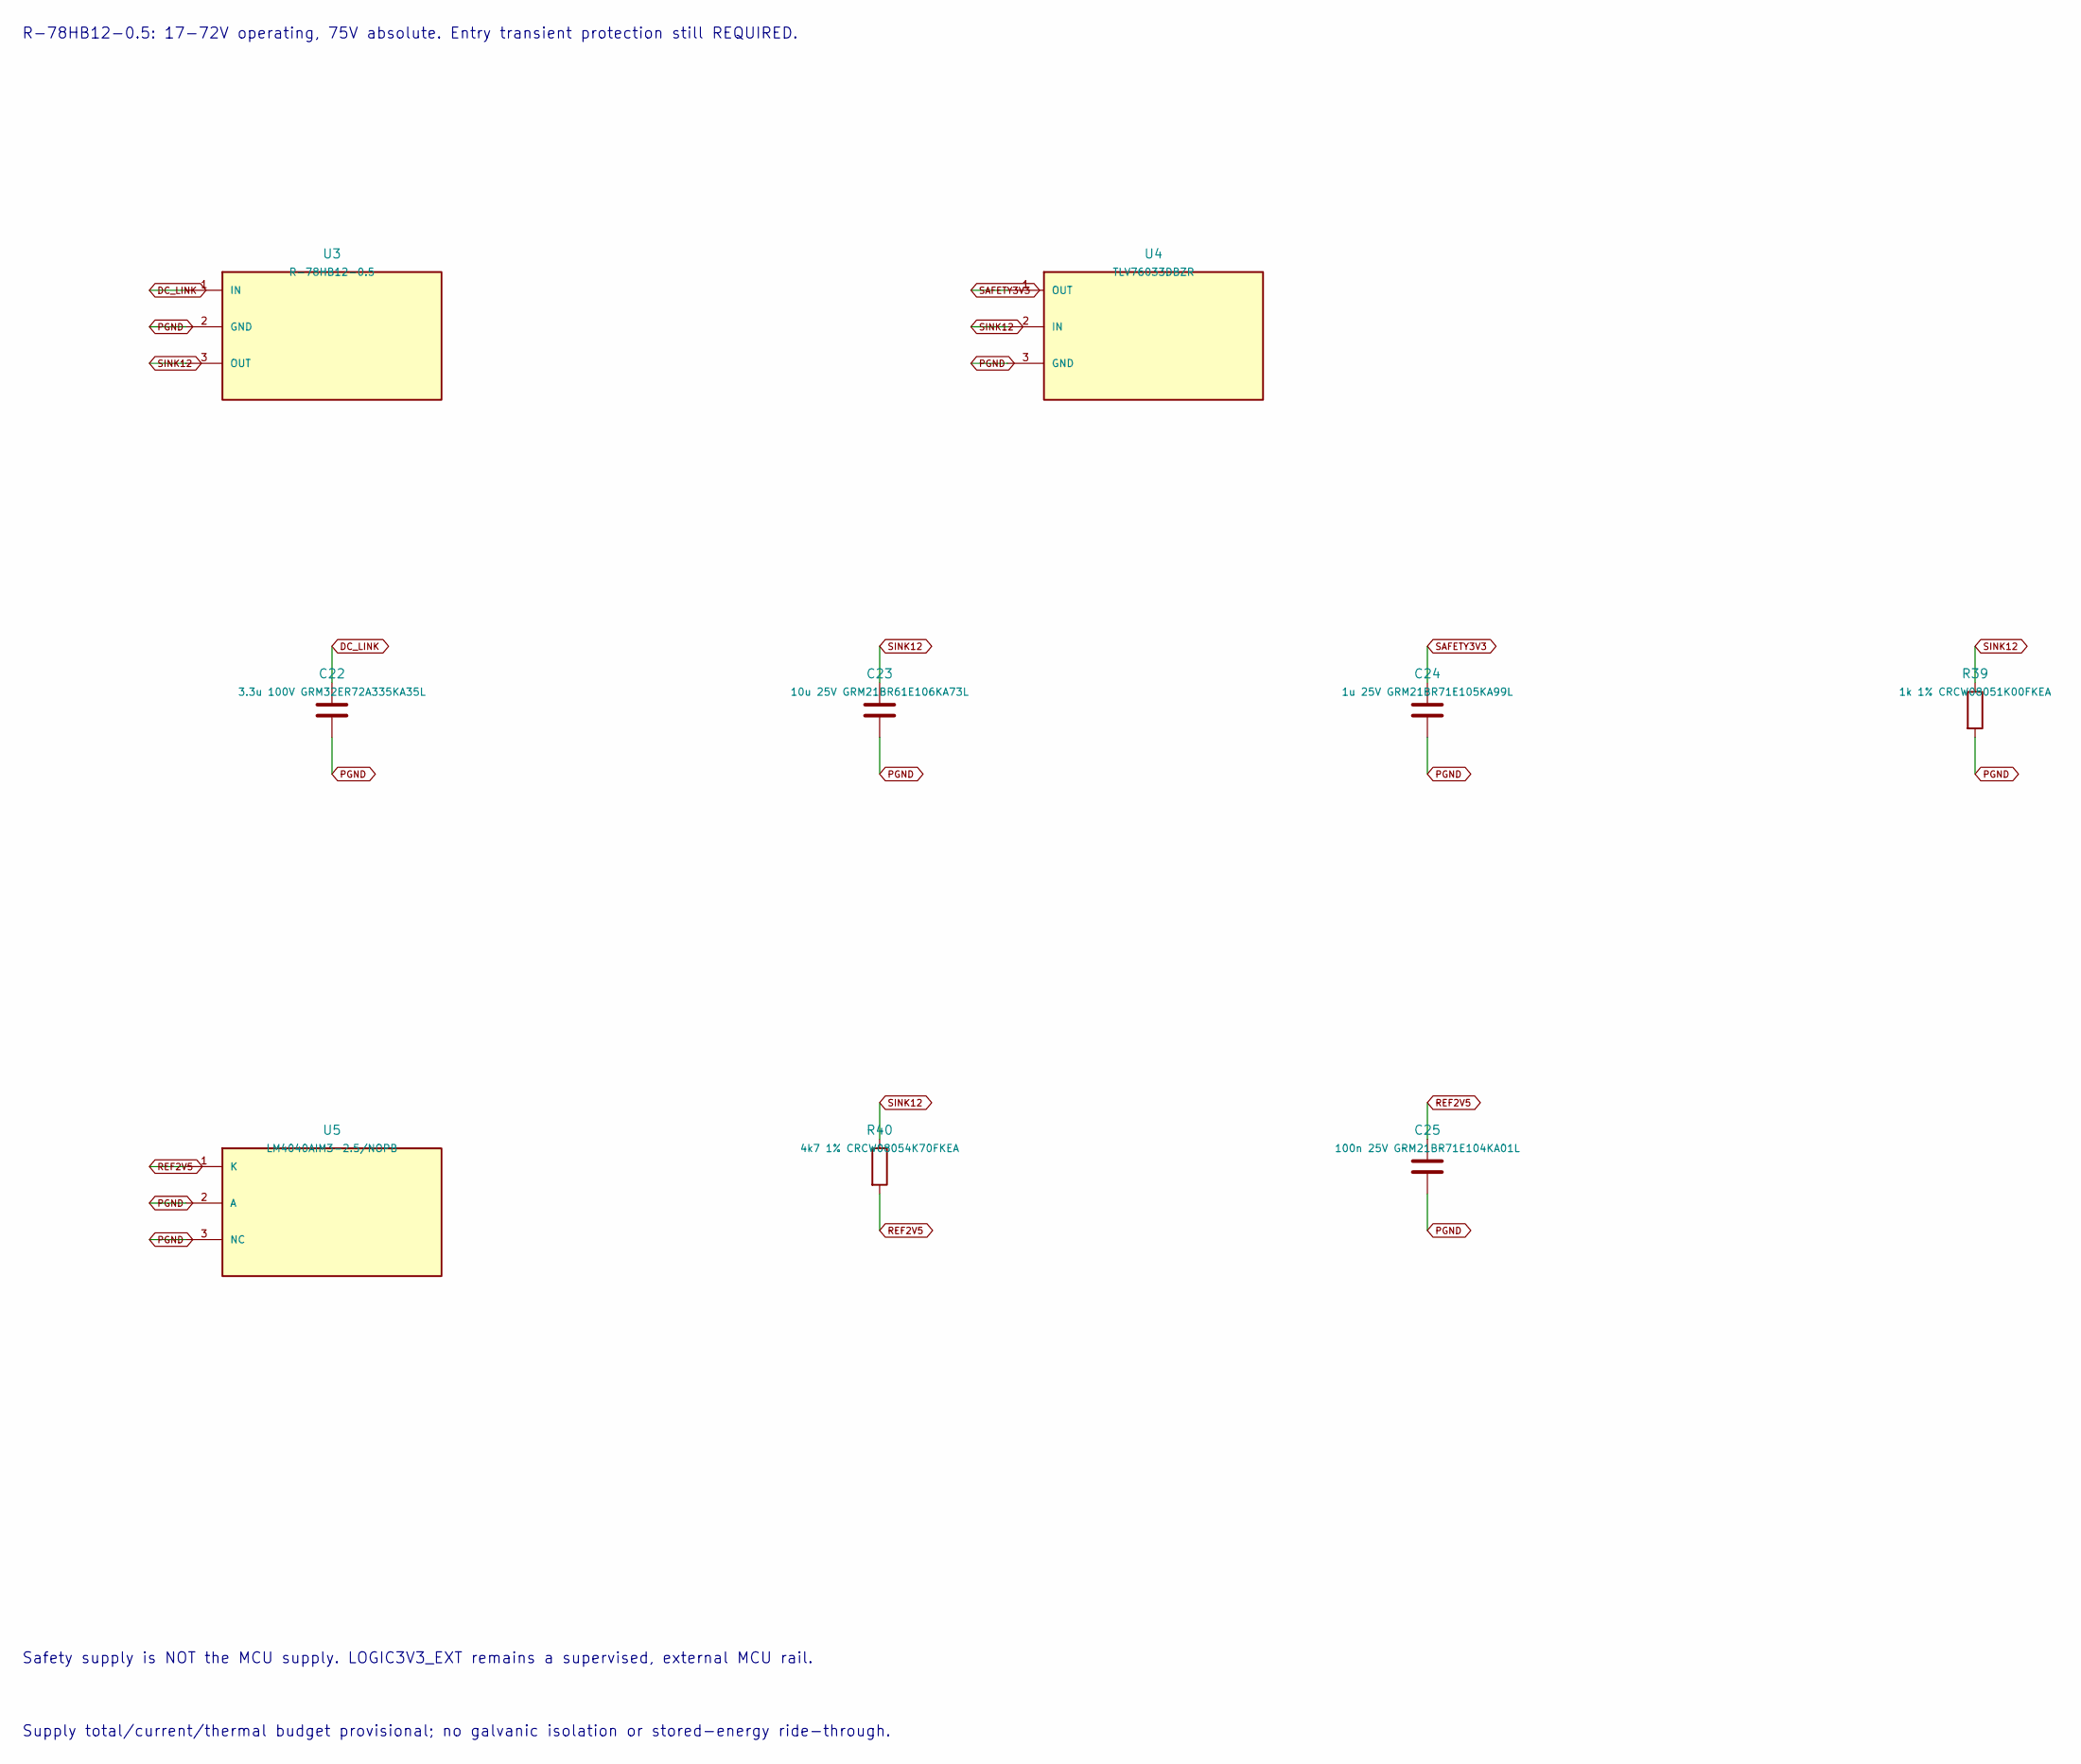
[picture p47: schematic aux-supply.kicad_sch, Bus-fed auxiliary and independent safety supply]

Parts:
C22: 3.3u 100V GRM32ER72A335KA35L; C_1210_3225Metric
C23: 10u 25V GRM21BR61E106KA73L; C_0805_2012Metric
C24: 1u 25V GRM21BR71E105KA99L; C_0805_2012Metric
C25: 100n 25V GRM21BR71E104KA01L; C_0805_2012Metric
R39: 1k 1% CRCW08051K00FKEA; R_0805_2012Metric
R40: 4k7 1% CRCW08054K70FKEA; R_0805_2012Metric
U3: R-78HB12-0.5; Converter_DCDC_RECOM_R-78HB-0.5_THT
U4: TLV76033DBZR; SOT-23
U5: LM4040AIM3-2.5/NOPB; SOT-23

Connections:
DC_LINK: C22.1, U3.1 (IN); also elsewhere on the board
PGND: C22.2, C23.2, C24.2, C25.2, R39.2, U3.2 (GND), U4.3 (GND), U5.2 (A), U5.3 (NC); also elsewhere on the board
REF2V5: C25.1, R40.2, U5.1 (K); also elsewhere on the board
SAFETY3V3: C24.1, U4.1 (OUT); also elsewhere on the board
SINK12: C23.1, R39.1, R40.1, U3.3 (OUT), U4.2 (IN); also elsewhere on the board

Notes on the sheet:
R-78HB12-0.5: 17-72V operating, 75V absolute. Entry transient protection still REQUIRED.
Safety supply is NOT the MCU supply. LOGIC3V3_EXT remains a supervised, external MCU rail.
Supply total/current/thermal budget provisional; no galvanic isolation or stored-energy ride-through.

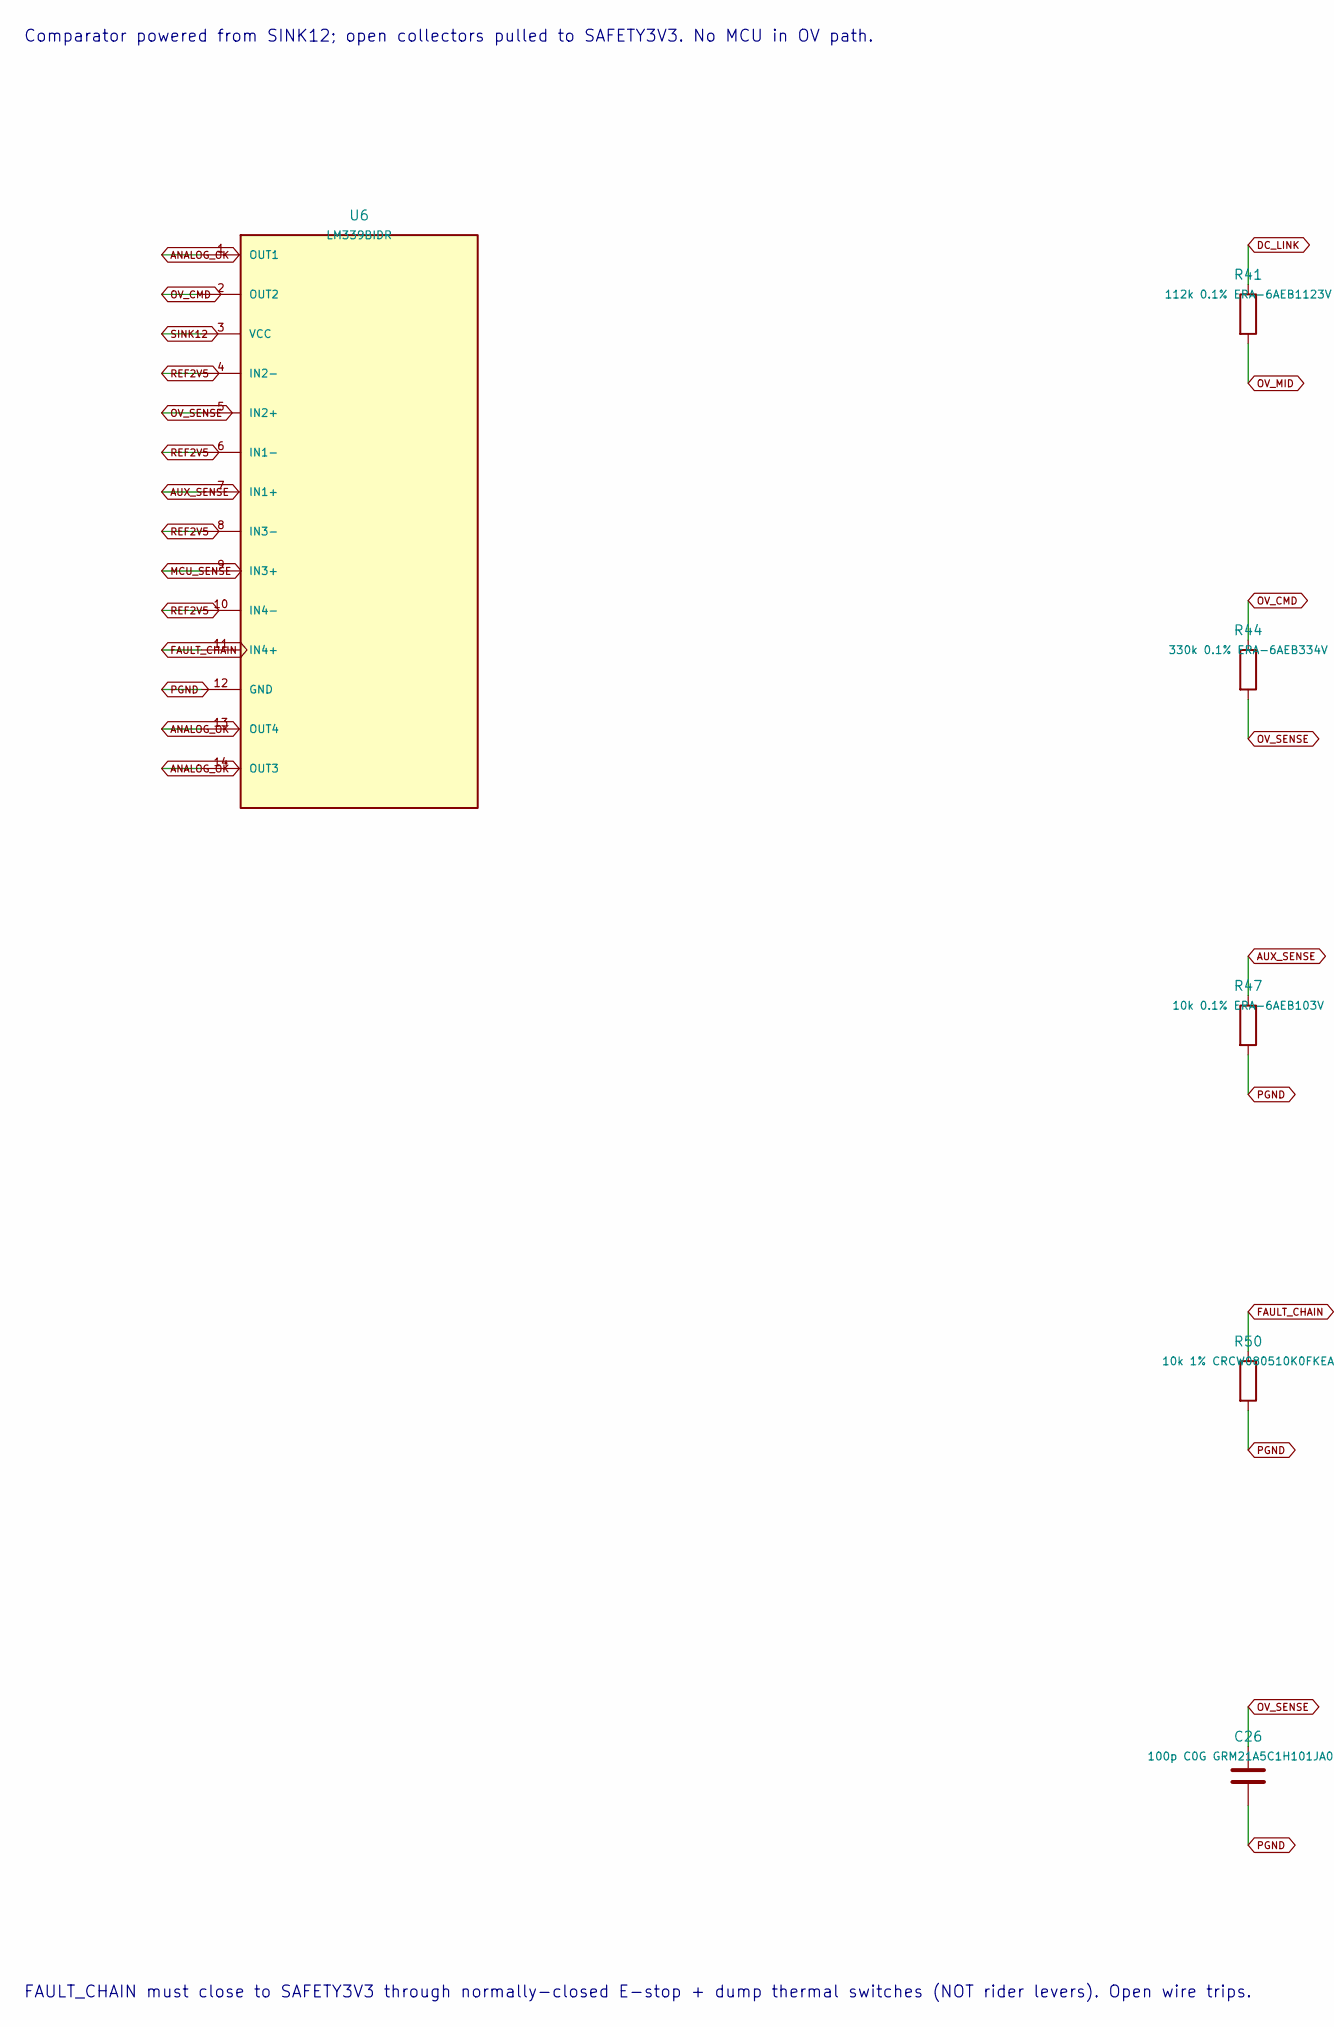
[picture p48: schematic protection-comparators.kicad_sch, Autonomous OV chopper comparator and rail / brake monitors, part in row 1, column 1]

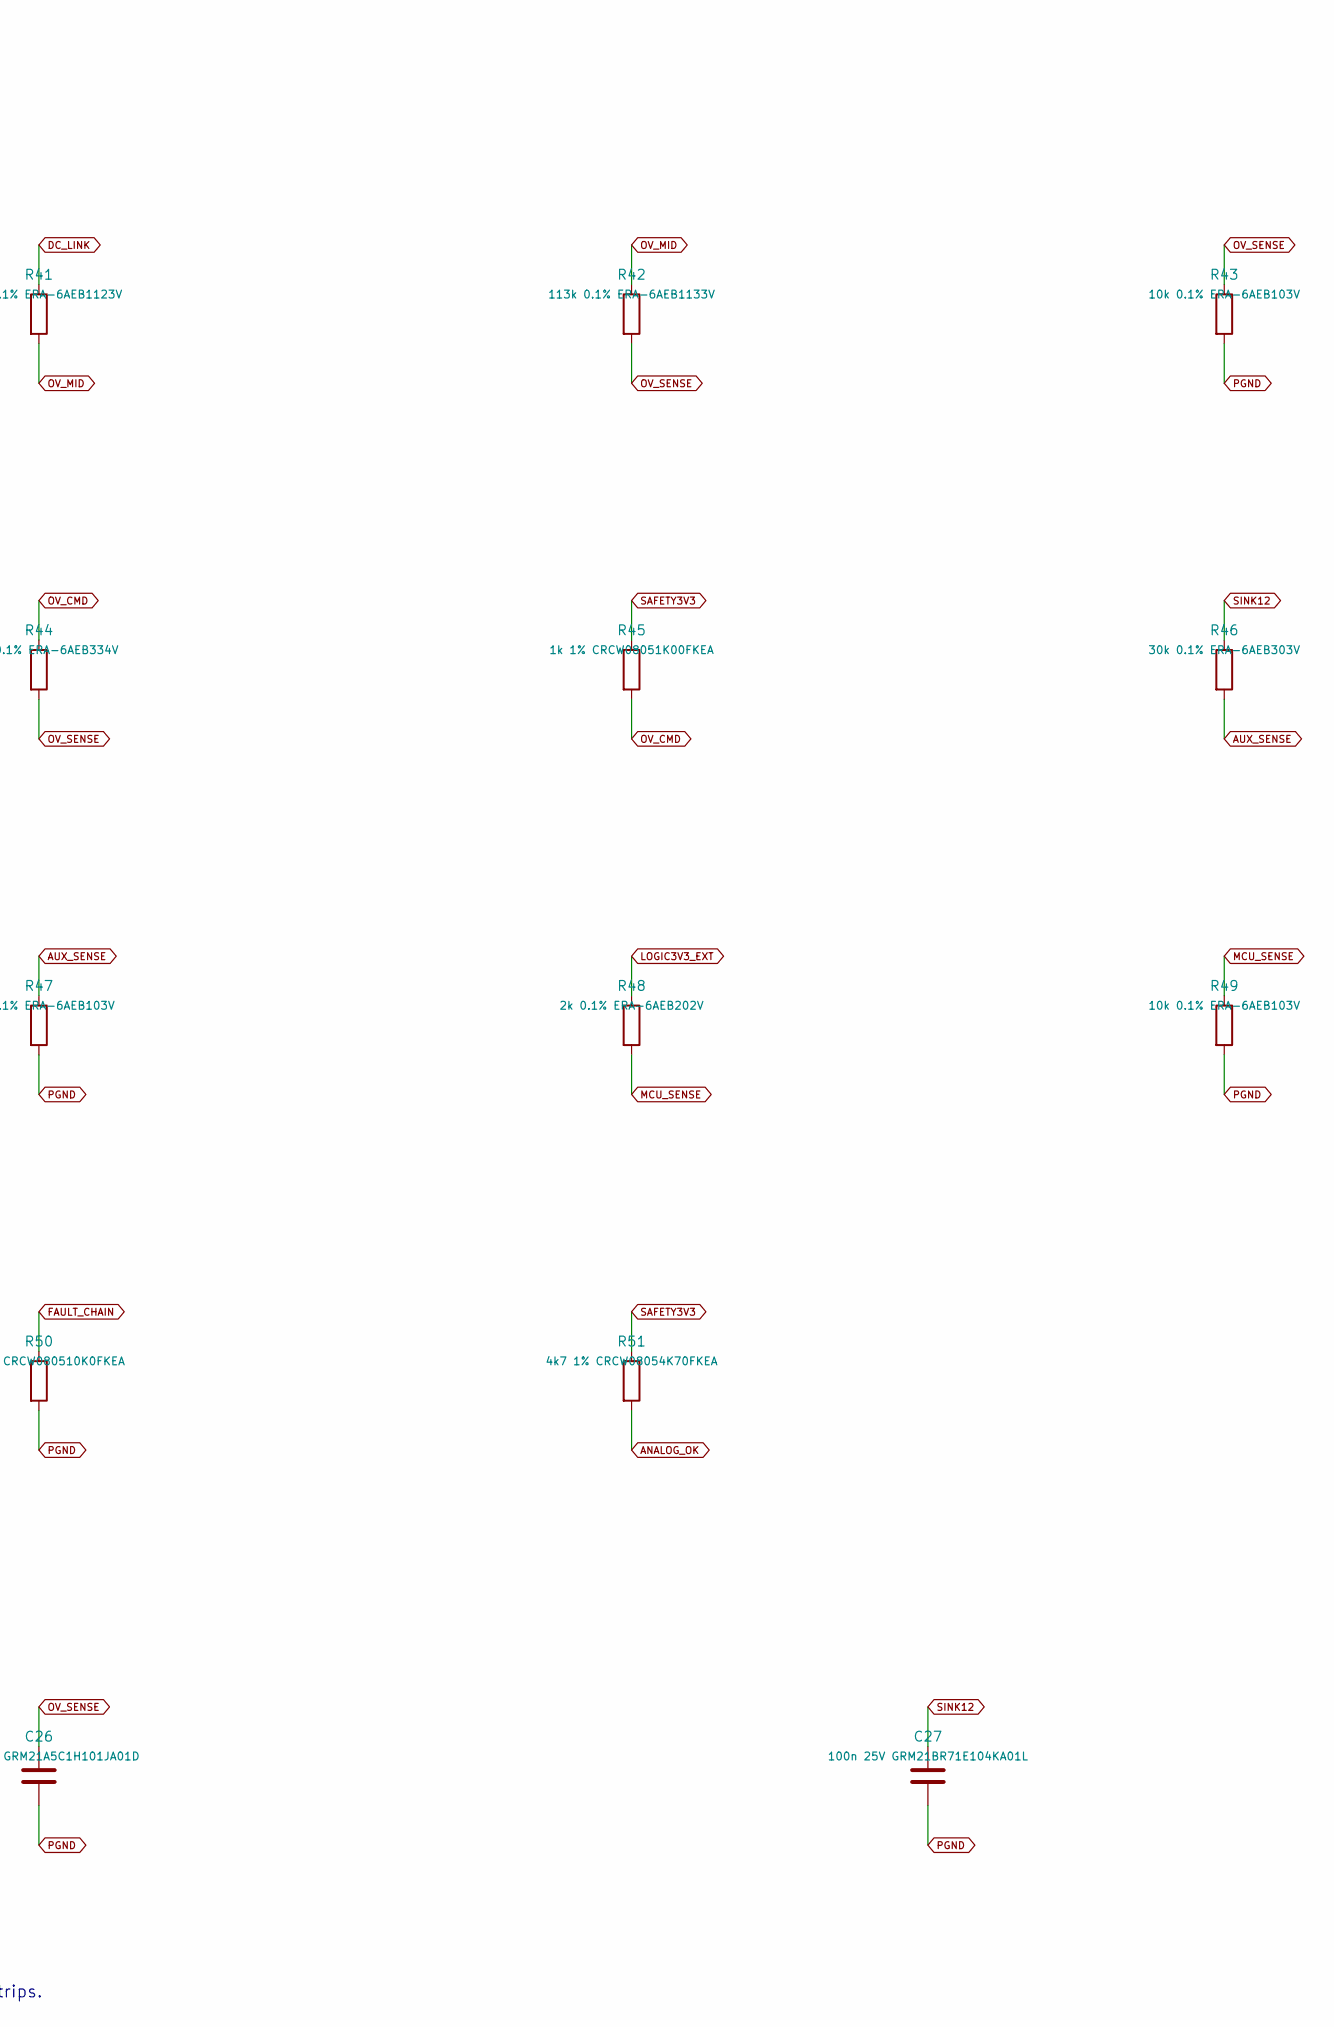
[picture p49: schematic protection-comparators.kicad_sch, Autonomous OV chopper comparator and rail / brake monitors, part in row 1, column 2]

Parts:
C26: 100p C0G GRM21A5C1H101JA01D; C_0805_2012Metric
C27: 100n 25V GRM21BR71E104KA01L; C_0805_2012Metric
R41: 112k 0.1% ERA-6AEB1123V; R_0805_2012Metric
R42: 113k 0.1% ERA-6AEB1133V; R_0805_2012Metric
R43, R47, R49: 10k 0.1% ERA-6AEB103V; R_0805_2012Metric
R44: 330k 0.1% ERA-6AEB334V; R_0805_2012Metric
R45: 1k 1% CRCW08051K00FKEA; R_0805_2012Metric
R46: 30k 0.1% ERA-6AEB303V; R_0805_2012Metric
R48: 2k 0.1% ERA-6AEB202V; R_0805_2012Metric
R50: 10k 1% CRCW080510K0FKEA; R_0805_2012Metric
R51: 4k7 1% CRCW08054K70FKEA; R_0805_2012Metric
U6: LM339BIDR; SOIC-14_3.9x8.7mm_P1.27mm

Connections:
ANALOG_OK: R51.2, U6.1 (OUT1), U6.13 (OUT4), U6.14 (OUT3); also elsewhere on the board
AUX_SENSE: R46.2, R47.1, U6.7 (IN1+)
DC_LINK: R41.1; also elsewhere on the board
FAULT_CHAIN: R50.1, U6.11 (IN4+); also elsewhere on the board
LOGIC3V3_EXT: R48.1; also elsewhere on the board
MCU_SENSE: R48.2, R49.1, U6.9 (IN3+)
OV_CMD: R44.1, R45.2, U6.2 (OUT2); also elsewhere on the board
OV_MID: R41.2, R42.1
OV_SENSE: C26.1, R42.2, R43.1, R44.2, U6.5 (IN2+)
PGND: C26.2, C27.2, R43.2, R47.2, R49.2, R50.2, U6.12 (GND); also elsewhere on the board
REF2V5: U6.4 (IN2-), U6.6 (IN1-), U6.8 (IN3-), U6.10 (IN4-); also elsewhere on the board
SAFETY3V3: R45.1, R51.1; also elsewhere on the board
SINK12: C27.1, R46.1, U6.3 (VCC); also elsewhere on the board

Notes on the sheet:
Comparator powered from SINK12; open collectors pulled to SAFETY3V3. No MCU in OV path.
FAULT_CHAIN must close to SAFETY3V3 through normally-closed E-stop + dump thermal switches (NOT rider levers). Open wire trips.
