felixfelix-bot/cycle-without-chain/hardware/powerboard-reva/powerboard-reva.kicad_pcb

## KiCad design hardware/powerboard-reva/powerboard-reva.kicad_pcb (continued)

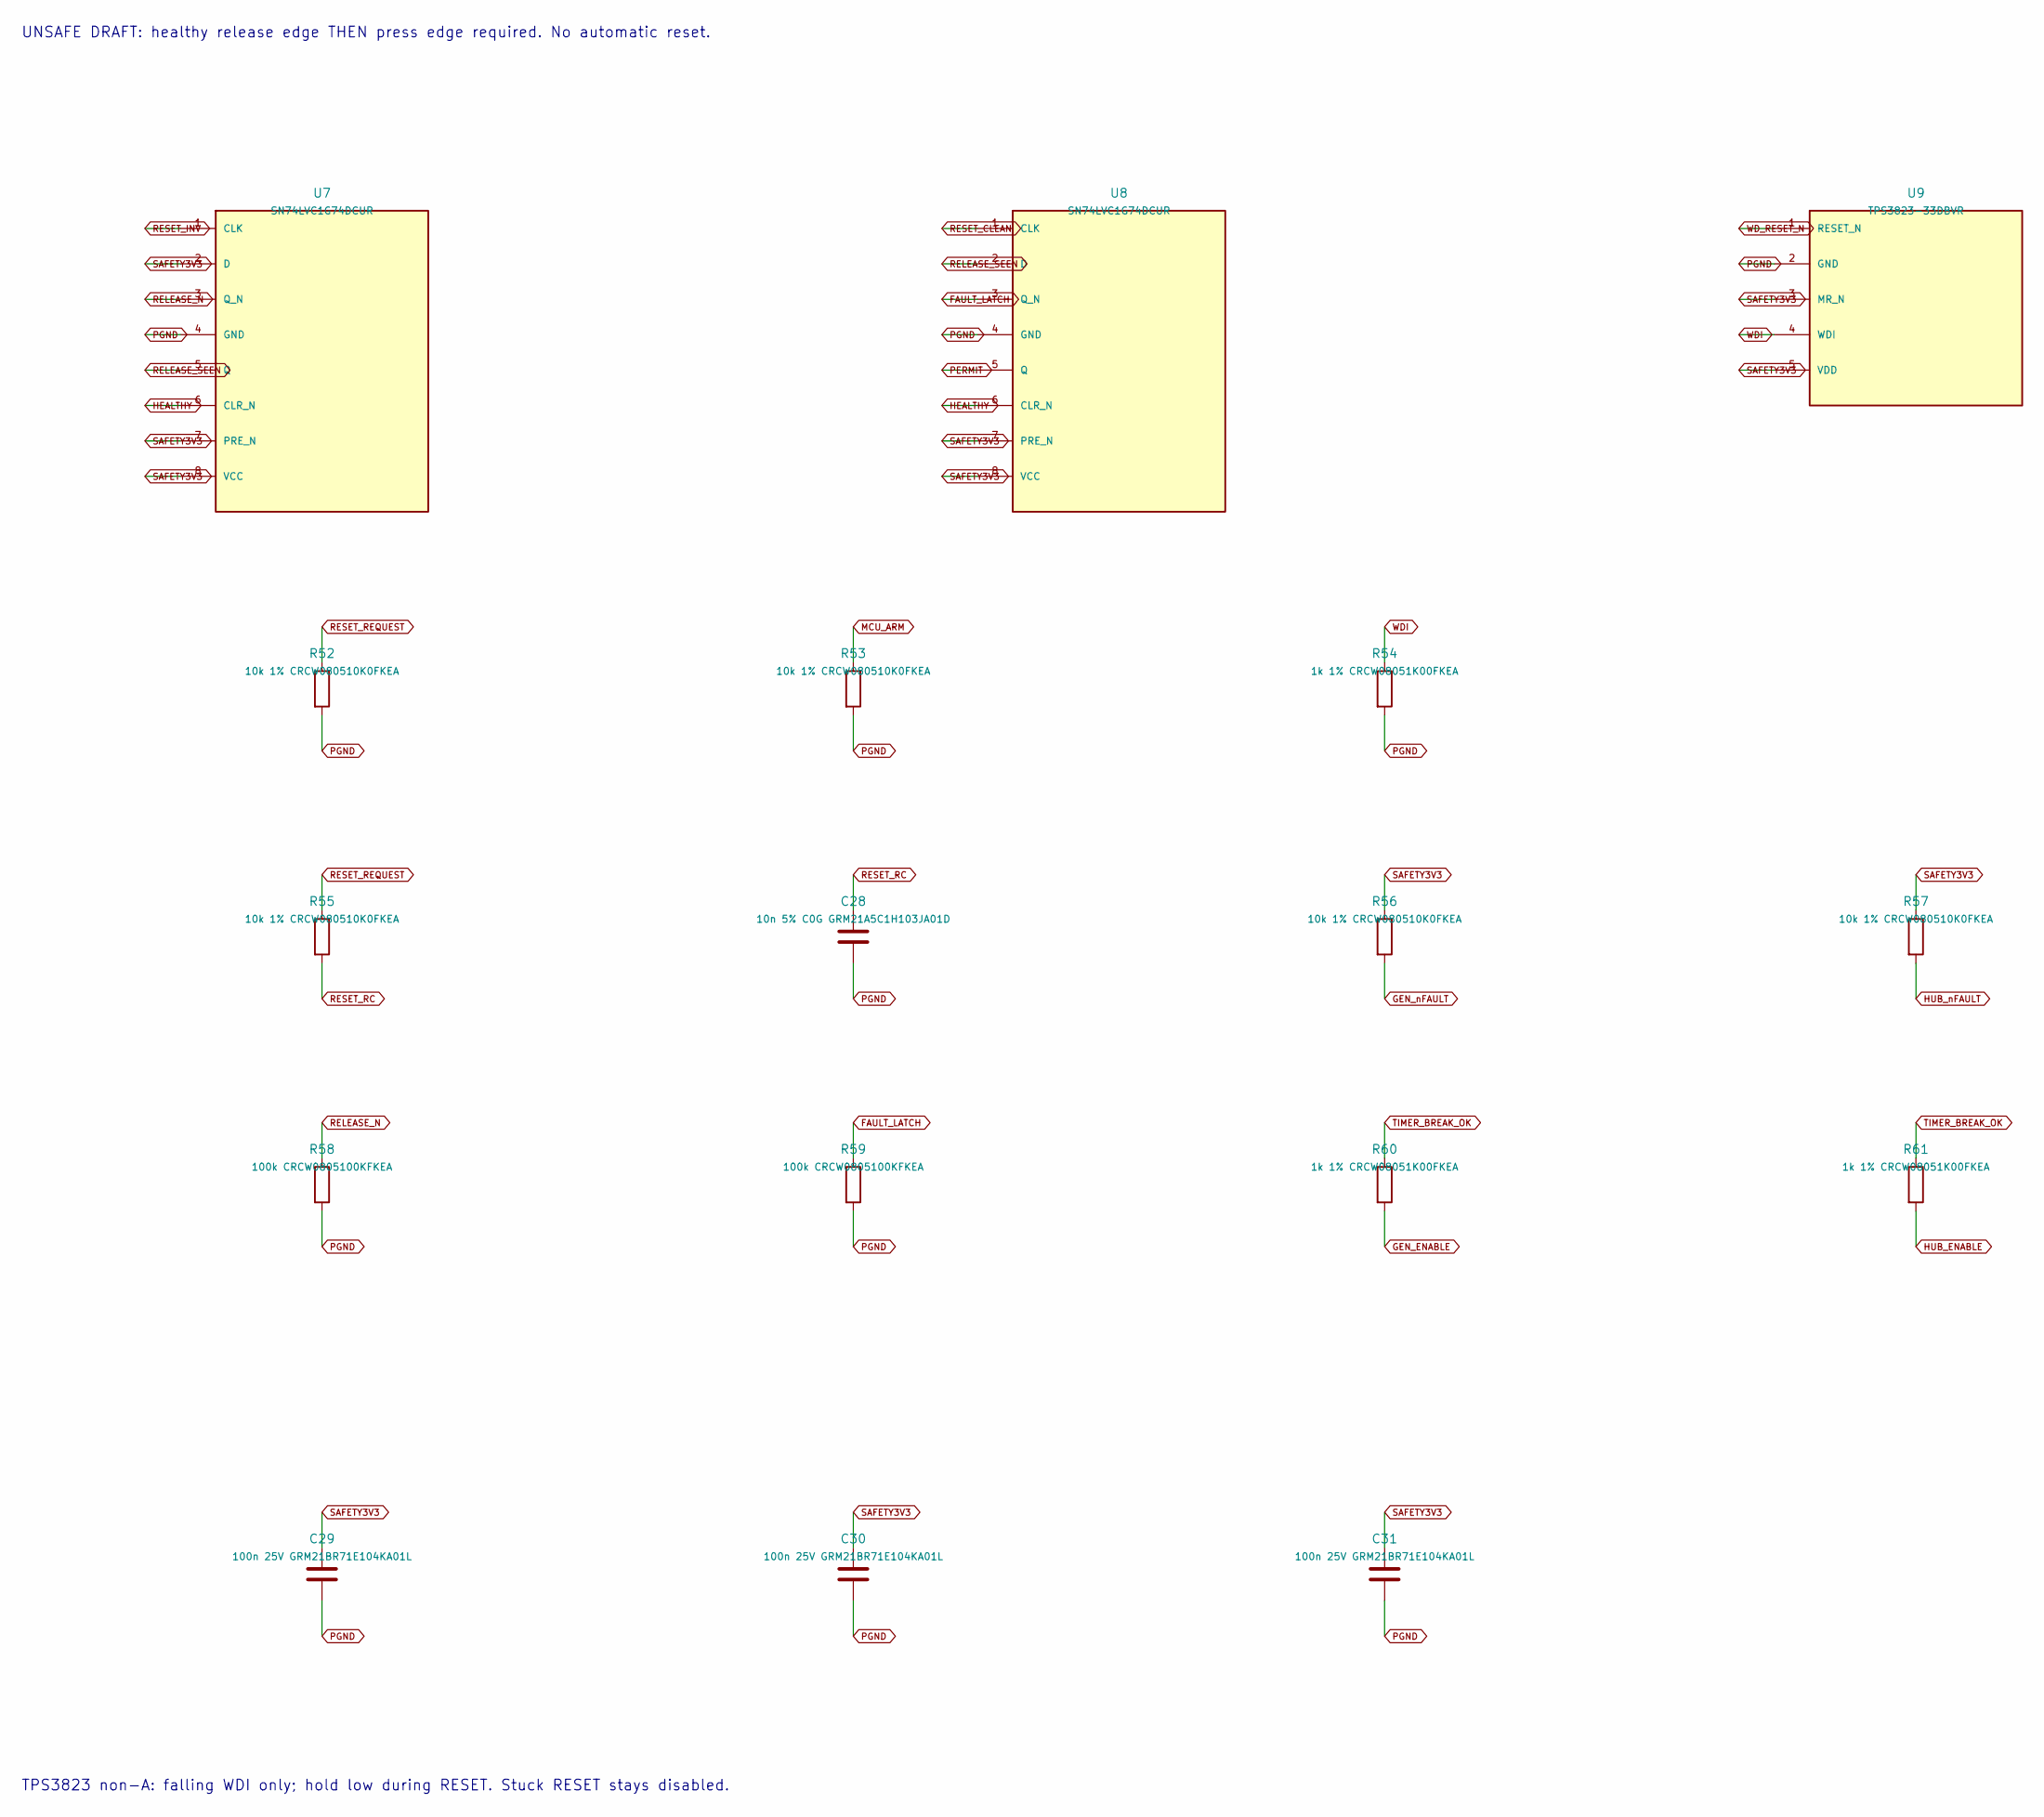
[picture p50: schematic fault-latch.kicad_sch, Release-before-rearm DFF memory]

Parts:
C28: 10n 5% C0G GRM21A5C1H103JA01D; C_0805_2012Metric
C29, C30, C31: 100n 25V GRM21BR71E104KA01L; C_0805_2012Metric
R52, R53, R55, R56, R57: 10k 1% CRCW080510K0FKEA; R_0805_2012Metric
R54, R60, R61: 1k 1% CRCW08051K00FKEA; R_0805_2012Metric
R58, R59: 100k CRCW0805100KFKEA; R_0805_2012Metric
U7, U8: SN74LVC1G74DCUR; VSSOP-8_2.3x2mm_P0.5mm
U9: TPS3823-33DBVR; SOT-23-5

Connections:
FAULT_LATCH: R59.1, U8.3 (Q_N)
GEN_ENABLE: R60.2; also elsewhere on the board
GEN_nFAULT: R56.2; also elsewhere on the board
HEALTHY: U7.6 (CLR_N), U8.6 (CLR_N); also elsewhere on the board
HUB_ENABLE: R61.2; also elsewhere on the board
HUB_nFAULT: R57.2; also elsewhere on the board
MCU_ARM: R53.1; also elsewhere on the board
PERMIT: U8.5 (Q); also elsewhere on the board
PGND: C28.2, C29.2, C30.2, C31.2, R52.2, R53.2, R54.2, R58.2, R59.2, U7.4 (GND), U8.4 (GND), U9.2 (GND); also elsewhere on the board
RELEASE_N: R58.1, U7.3 (Q_N)
RELEASE_SEEN: U7.5 (Q), U8.2 (D)
RESET_CLEAN: U8.1 (CLK); also elsewhere on the board
RESET_INV: U7.1 (CLK); also elsewhere on the board
RESET_RC: C28.1, R55.2; also elsewhere on the board
RESET_REQUEST: R52.1, R55.1; also elsewhere on the board
SAFETY3V3: C29.1, C30.1, C31.1, R56.1, R57.1, U7.2 (D), U7.7 (PRE_N), U7.8 (VCC), U8.7 (PRE_N), U8.8 (VCC), U9.3 (MR_N), U9.5 (VDD); also elsewhere on the board
TIMER_BREAK_OK: R60.1, R61.1; also elsewhere on the board
WDI: R54.1, U9.4 (WDI); also elsewhere on the board
WD_RESET_N: U9.1 (RESET_N); also elsewhere on the board

Notes on the sheet:
UNSAFE DRAFT: healthy release edge THEN press edge required. No automatic reset.
TPS3823 non-A: falling WDI only; hold low during RESET. Stuck RESET stays disabled.

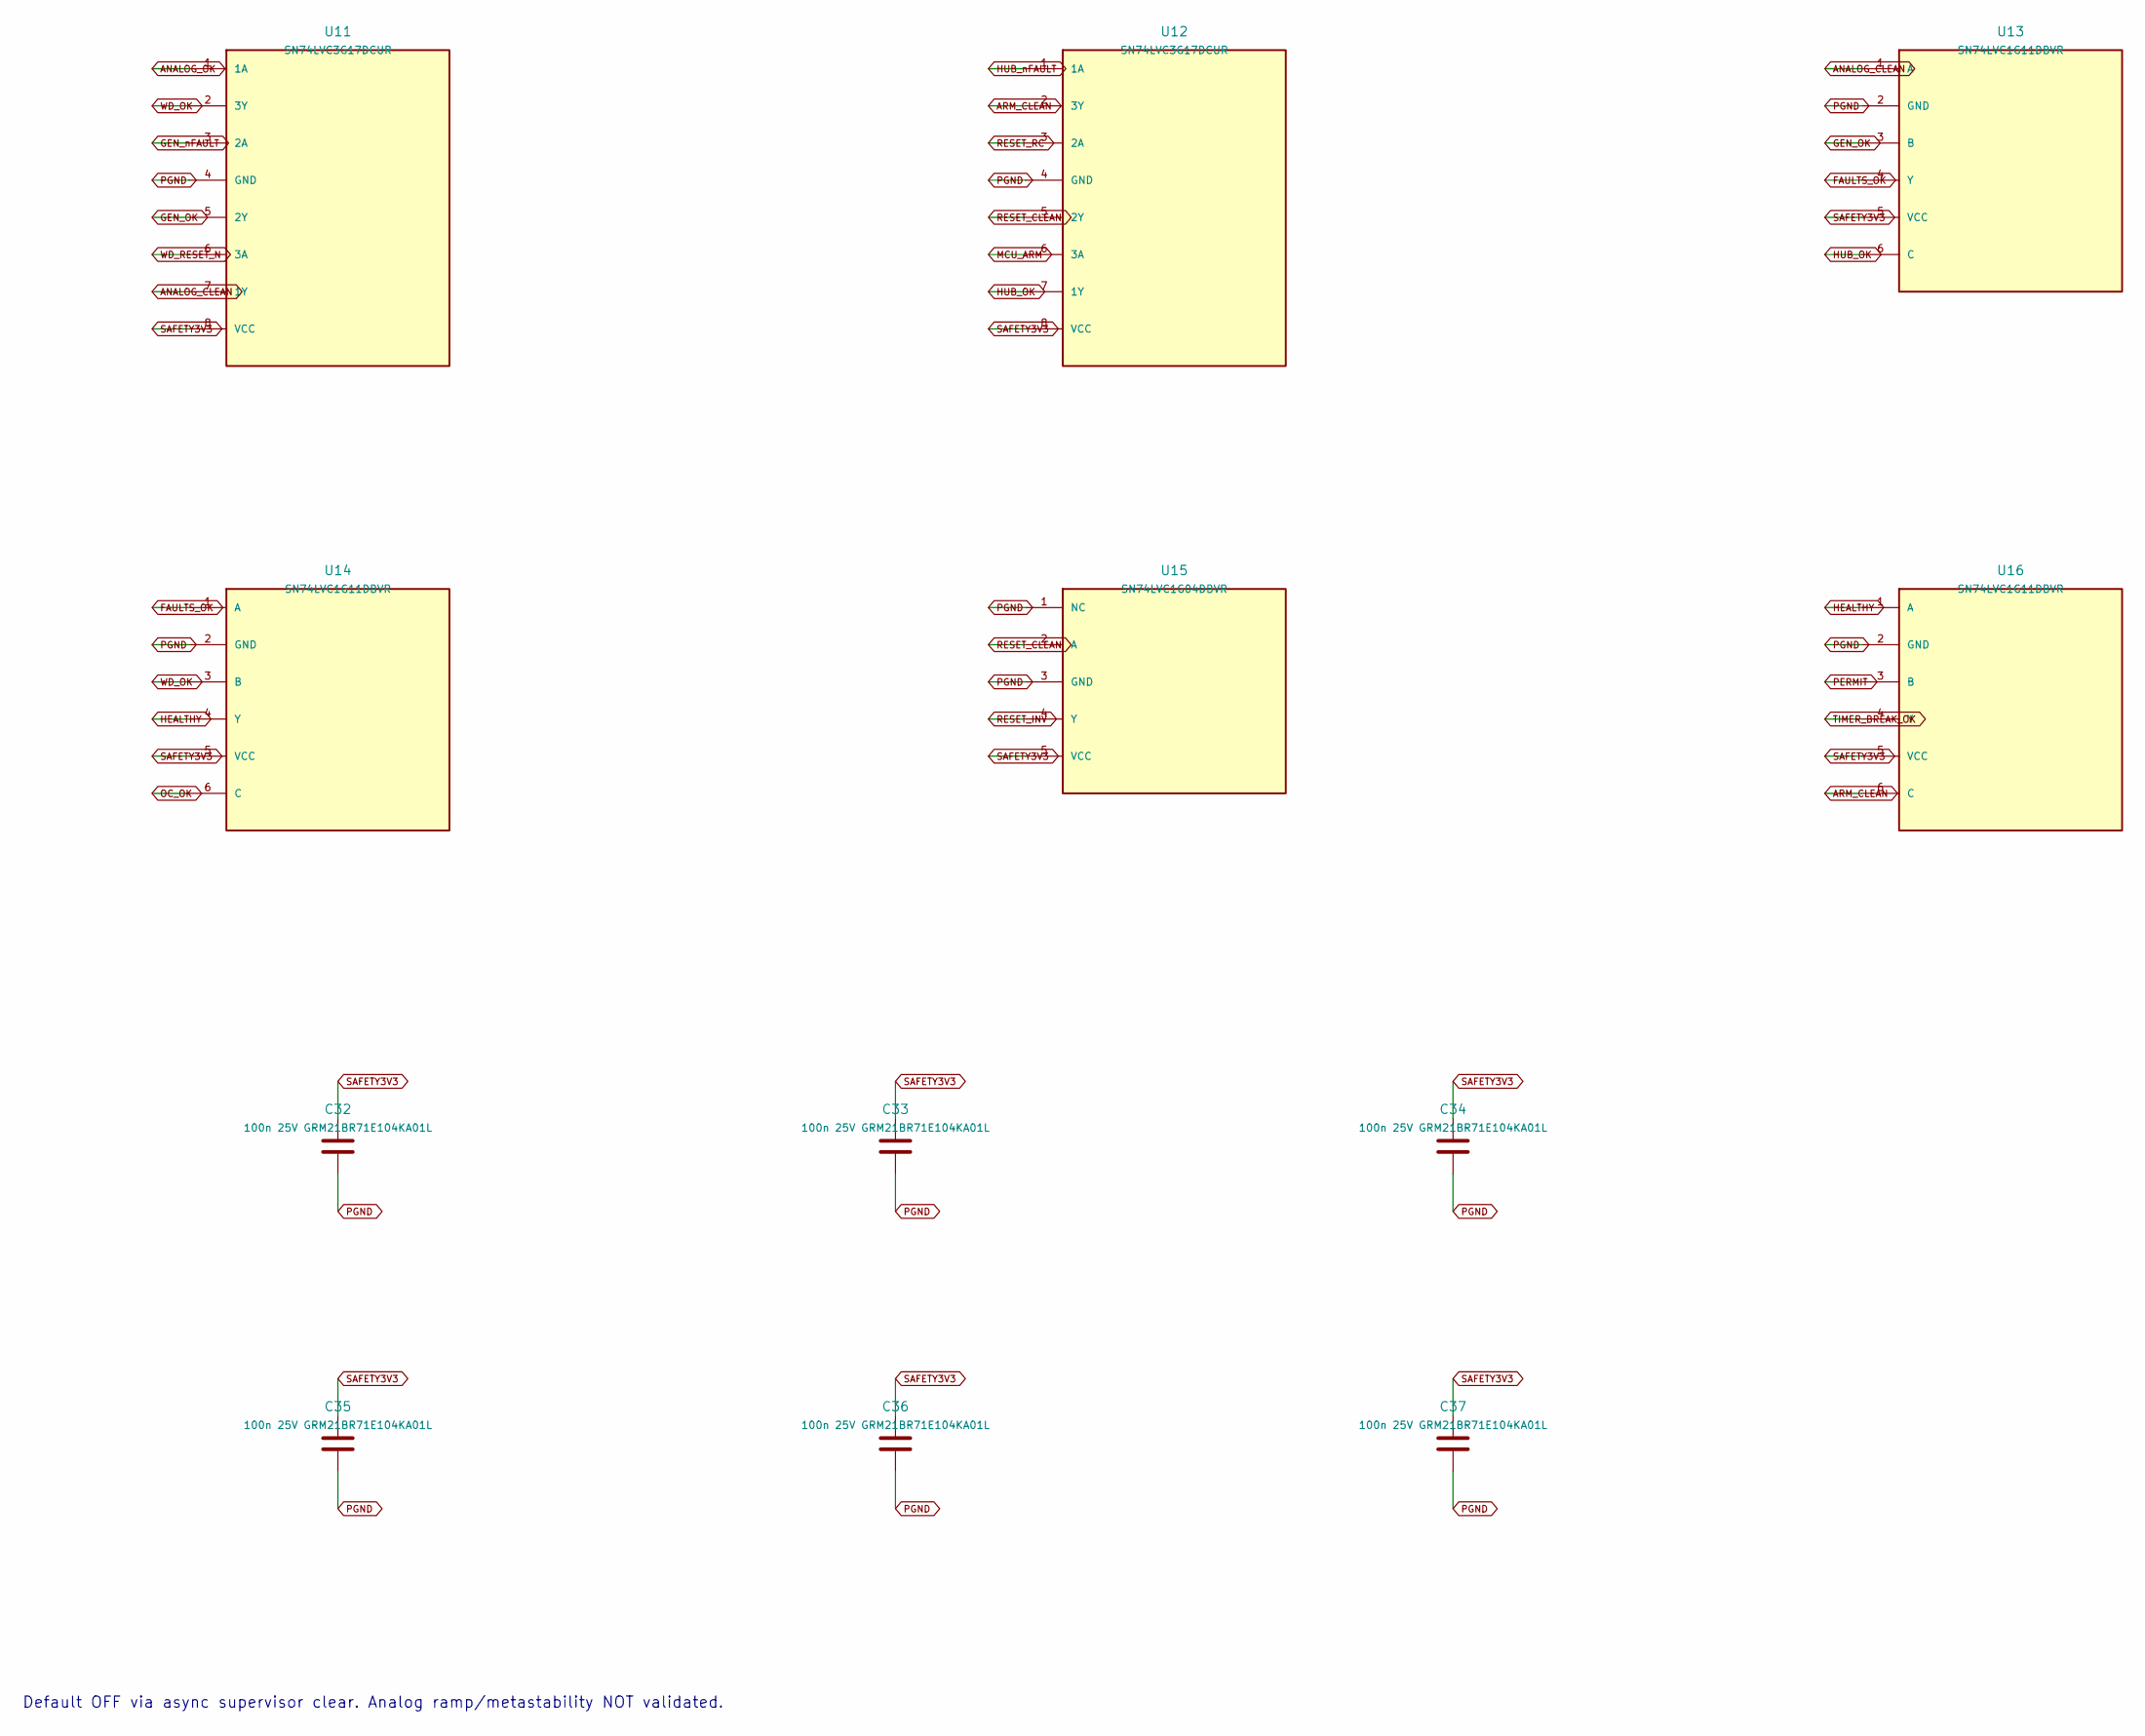
[picture p51: schematic fault-interfaces.kicad_sch, LVC Schmitt fault inputs without series diode offsets]

Parts:
C32, C33, C34, C35, C36, C37: 100n 25V GRM21BR71E104KA01L; C_0805_2012Metric
U11, U12: SN74LVC3G17DCUR; VSSOP-8_2.3x2mm_P0.5mm
U13, U14, U16: SN74LVC1G11DBVR; SOT-23-6
U15: SN74LVC1G04DBVR; SOT-23-5

Connections:
ANALOG_CLEAN: U11.7 (1Y), U13.1 (A)
ANALOG_OK: U11.1 (1A); also elsewhere on the board
ARM_CLEAN: U12.2 (3Y), U16.6 (C)
FAULTS_OK: U13.4 (Y), U14.1 (A)
GEN_OK: U11.5 (2Y), U13.3 (B)
GEN_nFAULT: U11.3 (2A); also elsewhere on the board
HEALTHY: U14.4 (Y), U16.1 (A); also elsewhere on the board
HUB_OK: U12.7 (1Y), U13.6 (C)
HUB_nFAULT: U12.1 (1A); also elsewhere on the board
MCU_ARM: U12.6 (3A); also elsewhere on the board
OC_OK: U14.6 (C); also elsewhere on the board
PERMIT: U16.3 (B); also elsewhere on the board
PGND: C32.2, C33.2, C34.2, C35.2, C36.2, C37.2, U11.4 (GND), U12.4 (GND), U13.2 (GND), U14.2 (GND), U15.1 (NC), U15.3 (GND), U16.2 (GND); also elsewhere on the board
RESET_CLEAN: U12.5 (2Y), U15.2 (A); also elsewhere on the board
RESET_INV: U15.4 (Y); also elsewhere on the board
RESET_RC: U12.3 (2A); also elsewhere on the board
SAFETY3V3: C32.1, C33.1, C34.1, C35.1, C36.1, C37.1, U11.8 (VCC), U12.8 (VCC), U13.5 (VCC), U14.5 (VCC), U15.5 (VCC), U16.5 (VCC); also elsewhere on the board
TIMER_BREAK_OK: U16.4 (Y); also elsewhere on the board
WD_OK: U11.2 (3Y), U14.3 (B)
WD_RESET_N: U11.6 (3A); also elsewhere on the board

Notes on the sheet:
Default OFF via async supervisor clear. Analog ramp/metastability NOT validated.

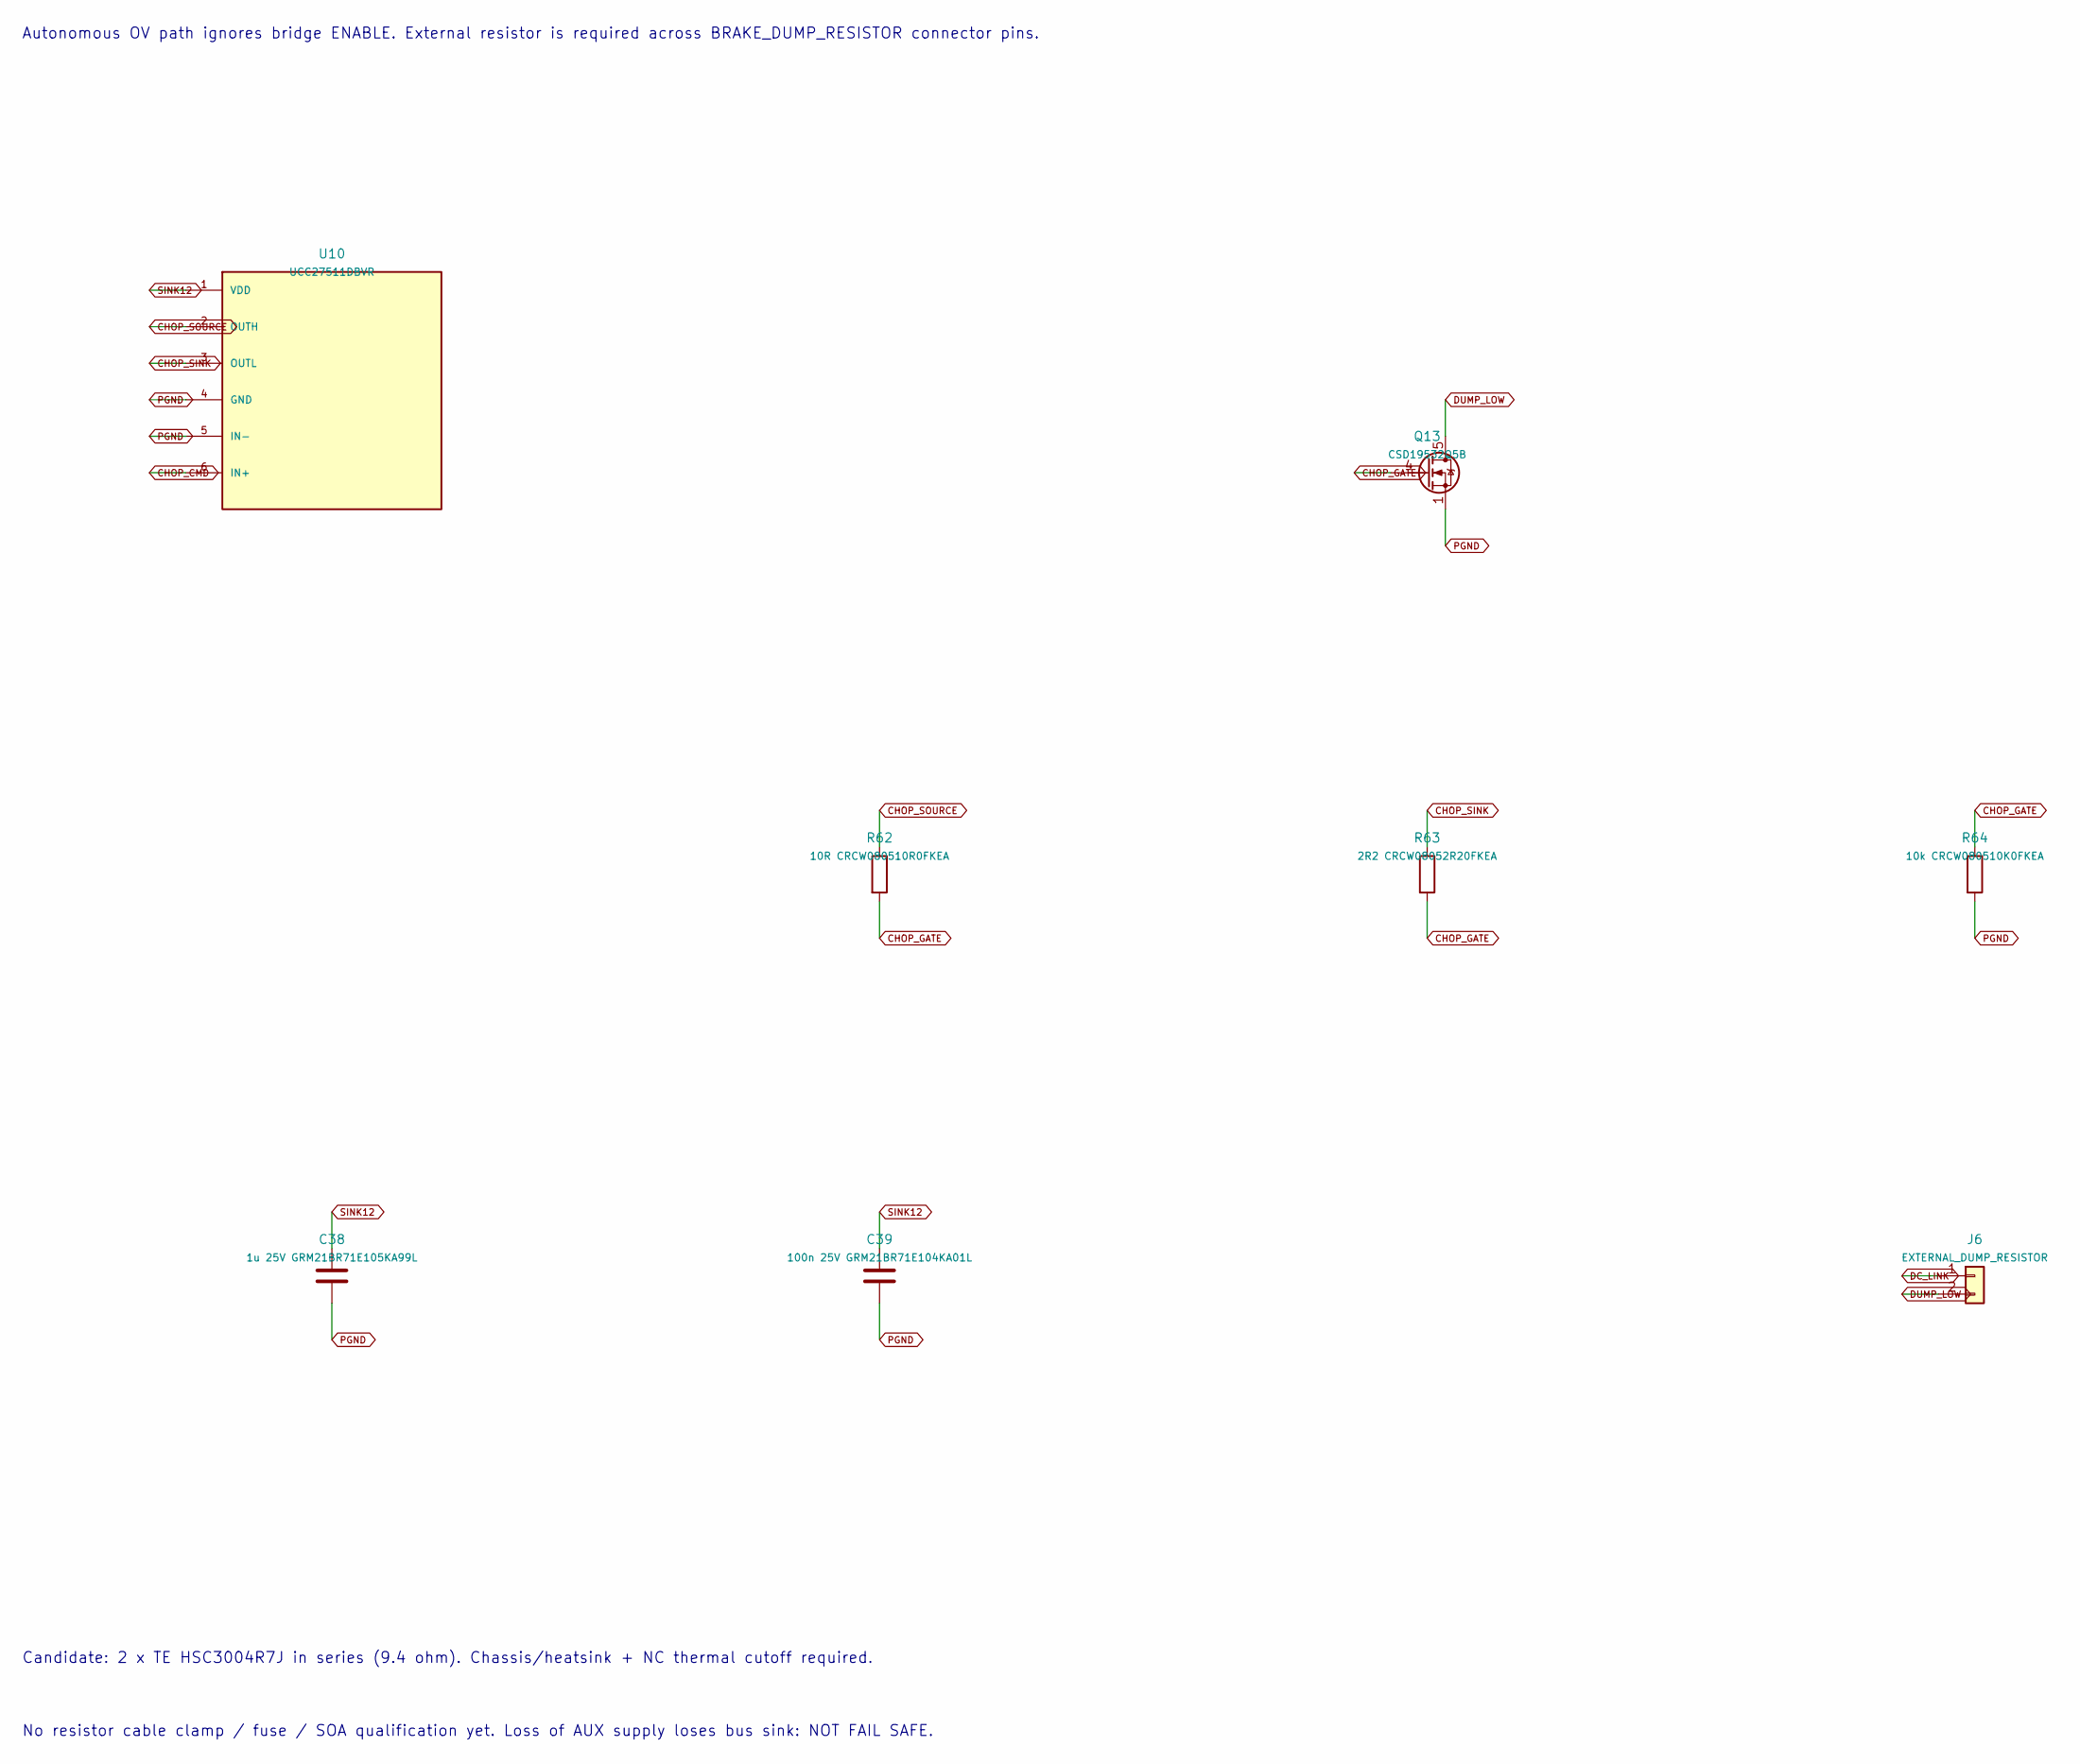
[picture p52: schematic brake-chopper.kicad_sch, Independent brake chopper power stage]

Parts:
C38: 1u 25V GRM21BR71E105KA99L; C_0805_2012Metric
C39: 100n 25V GRM21BR71E104KA01L; C_0805_2012Metric
J6: EXTERNAL_DUMP_RESISTOR; R_Axial_DIN0207_L6.3mm_D2.5mm_P7.62mm_Horizontal
Q13: CSD19532Q5B; TDSON-8-1
R62: 10R CRCW080510R0FKEA; R_0805_2012Metric
R63: 2R2 CRCW08052R20FKEA; R_0805_2012Metric
R64: 10k CRCW080510K0FKEA; R_0805_2012Metric
U10: UCC27511DBVR; SOT-23-6

Connections:
CHOP_CMD: U10.6 (IN+); also elsewhere on the board
CHOP_GATE: Q13.4 (G), R62.2, R63.2, R64.1
CHOP_SINK: R63.1, U10.3 (OUTL)
CHOP_SOURCE: R62.1, U10.2 (OUTH)
DC_LINK: J6.1; also elsewhere on the board
DUMP_LOW: J6.2, Q13.5 (D)
PGND: C38.2, C39.2, Q13.1 (S), Q13.2 (S), Q13.3 (S), R64.2, U10.4 (GND), U10.5 (IN-); also elsewhere on the board
SINK12: C38.1, C39.1, U10.1 (VDD); also elsewhere on the board

Notes on the sheet:
Autonomous OV path ignores bridge ENABLE. External resistor is required across BRAKE_DUMP_RESISTOR connector pins.
Candidate: 2 x TE HSC3004R7J in series (9.4 ohm). Chassis/heatsink + NC thermal cutoff required.
No resistor cable clamp / fuse / SOA qualification yet. Loss of AUX supply loses bus sink: NOT FAIL SAFE.

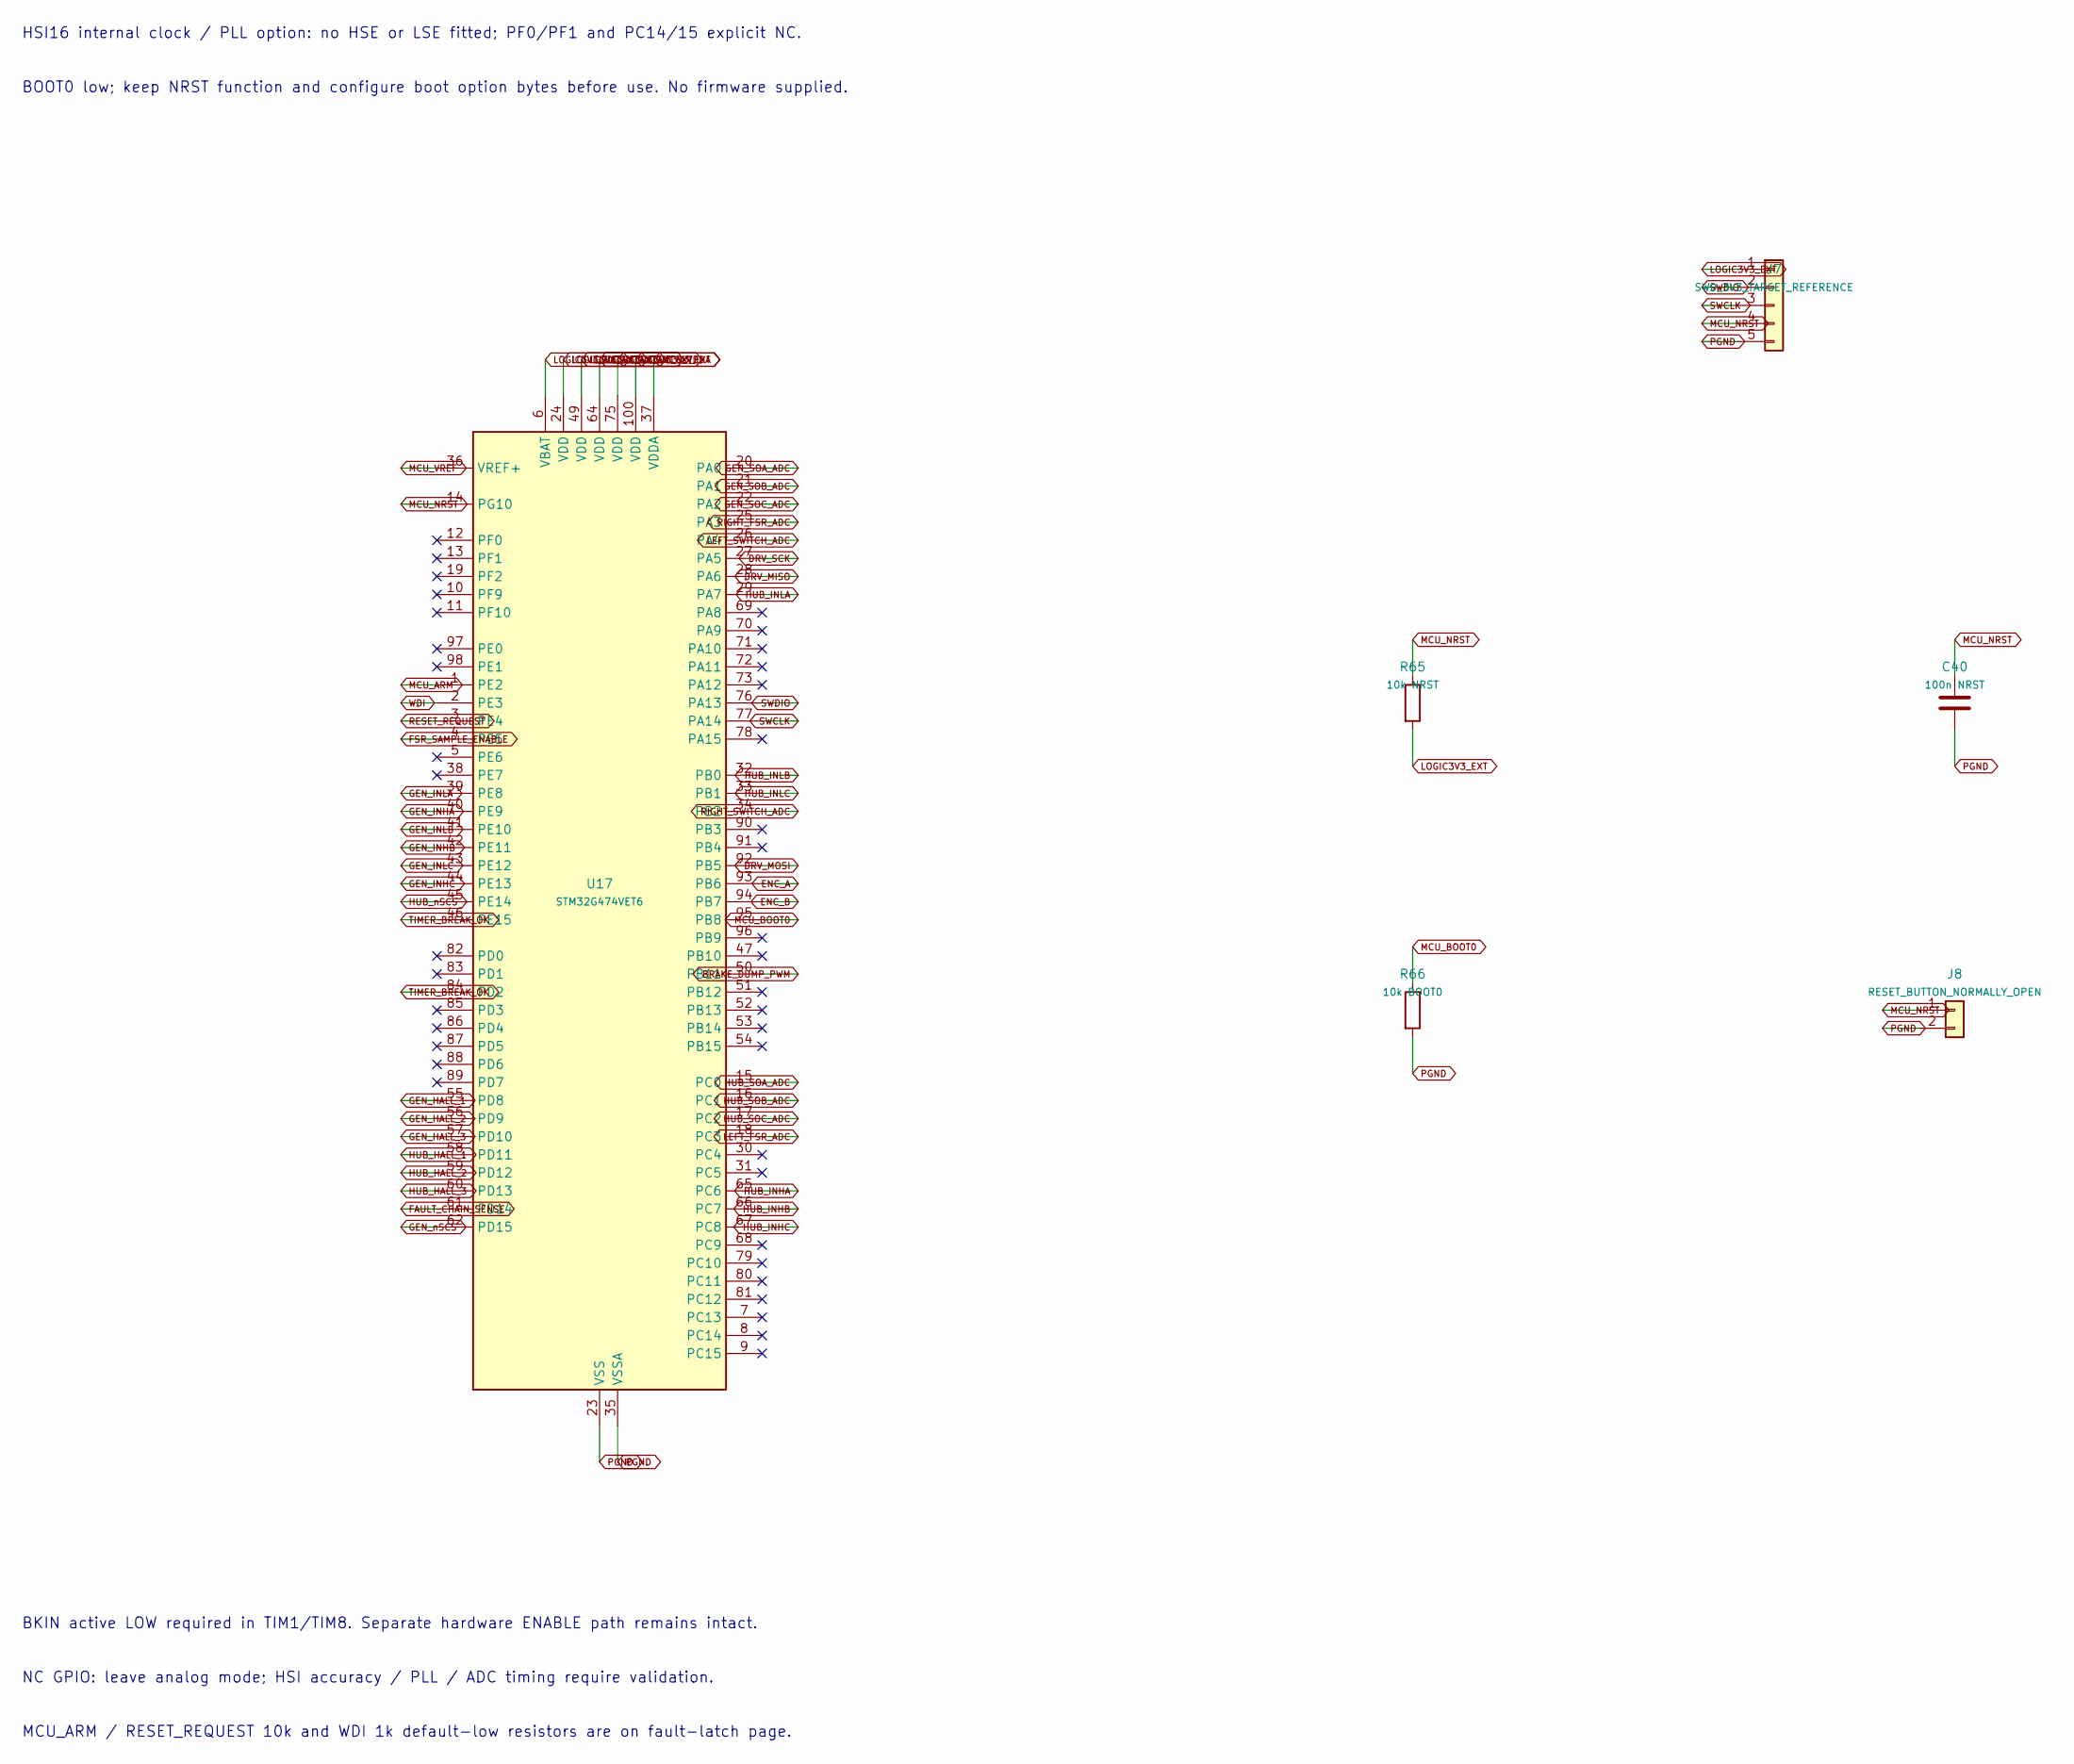
[picture p53: schematic mcu-core.kicad_sch, STM32G474VET6 LQFP100: power, reset, debug and control]

Parts:
C40: 100n NRST; C_0603_1608Metric
J7: SWD_3V3_TARGET_REFERENCE; PinHeader_1x06_P2.54mm_Vertical
J8: RESET_BUTTON_NORMALLY_OPEN; SW_SPST_TL3305A
R65: 10k NRST; R_0603_1608Metric
R66: 10k BOOT0; R_0603_1608Metric
U17: STM32G474VET6; LQFP-100_14x14mm_P0.5mm

Connections:
BRAKE_DUMP_PWM: U17.50 (PB11); also elsewhere on the board
DRV_MISO: U17.28 (PA6); also elsewhere on the board
DRV_MOSI: U17.92 (PB5); also elsewhere on the board
DRV_SCK: U17.27 (PA5); also elsewhere on the board
ENC_A: U17.93 (PB6); also elsewhere on the board
ENC_B: U17.94 (PB7); also elsewhere on the board
FAULT_CHAIN_SENSE: U17.61 (PD14); also elsewhere on the board
FSR_SAMPLE_ENABLE: U17.4 (PE5); also elsewhere on the board
GEN_HALL_1: U17.55 (PD8); also elsewhere on the board
GEN_HALL_2: U17.56 (PD9); also elsewhere on the board
GEN_HALL_3: U17.57 (PD10); also elsewhere on the board
GEN_INHA: U17.40 (PE9); also elsewhere on the board
GEN_INHB: U17.42 (PE11); also elsewhere on the board
GEN_INHC: U17.44 (PE13); also elsewhere on the board
GEN_INLA: U17.39 (PE8); also elsewhere on the board
GEN_INLB: U17.41 (PE10); also elsewhere on the board
GEN_INLC: U17.43 (PE12); also elsewhere on the board
GEN_SOA_ADC: U17.20 (PA0); also elsewhere on the board
GEN_SOB_ADC: U17.21 (PA1); also elsewhere on the board
GEN_SOC_ADC: U17.22 (PA2); also elsewhere on the board
GEN_nSCS: U17.62 (PD15); also elsewhere on the board
HUB_HALL_1: U17.58 (PD11); also elsewhere on the board
HUB_HALL_2: U17.59 (PD12); also elsewhere on the board
HUB_HALL_3: U17.60 (PD13); also elsewhere on the board
HUB_INHA: U17.65 (PC6); also elsewhere on the board
HUB_INHB: U17.66 (PC7); also elsewhere on the board
HUB_INHC: U17.67 (PC8); also elsewhere on the board
HUB_INLA: U17.29 (PA7); also elsewhere on the board
HUB_INLB: U17.32 (PB0); also elsewhere on the board
HUB_INLC: U17.33 (PB1); also elsewhere on the board
HUB_SOA_ADC: U17.15 (PC0); also elsewhere on the board
HUB_SOB_ADC: U17.16 (PC1); also elsewhere on the board
HUB_SOC_ADC: U17.17 (PC2); also elsewhere on the board
HUB_nSCS: U17.45 (PE14); also elsewhere on the board
LEFT_FSR_ADC: U17.18 (PC3); also elsewhere on the board
LEFT_SWITCH_ADC: U17.26 (PA4); also elsewhere on the board
LOGIC3V3_EXT: J7.1, R65.2, U17.6 (VBAT), U17.24 (VDD), U17.49 (VDD), U17.64 (VDD), U17.75 (VDD), U17.100 (VDD); also elsewhere on the board
MCU_ARM: U17.1 (PE2); also elsewhere on the board
MCU_BOOT0: R66.1, U17.95 (PB8)
MCU_NRST: C40.1, J7.4, J8.1, R65.1, U17.14 (PG10)
MCU_VDDA: U17.37 (VDDA); also elsewhere on the board
MCU_VREF: U17.36 (VREF+); also elsewhere on the board
PGND: C40.2, J7.5, J8.2, R66.2, U17.23 (VSS), U17.35 (VSSA), U17.48 (VSS), U17.63 (VSS), U17.74 (VSS), U17.99 (VSS); also elsewhere on the board
RESET_REQUEST: U17.3 (PE4); also elsewhere on the board
RIGHT_FSR_ADC: U17.25 (PA3); also elsewhere on the board
RIGHT_SWITCH_ADC: U17.34 (PB2); also elsewhere on the board
SWCLK: J7.3, U17.77 (PA14)
SWDIO: J7.2, U17.76 (PA13)
TIMER_BREAK_OK: U17.46 (PE15), U17.84 (PD2); also elsewhere on the board
WDI: U17.2 (PE3); also elsewhere on the board

Notes on the sheet:
HSI16 internal clock / PLL option: no HSE or LSE fitted; PF0/PF1 and PC14/15 explicit NC.
BOOT0 low; keep NRST function and configure boot option bytes before use. No firmware supplied.
BKIN active LOW required in TIM1/TIM8. Separate hardware ENABLE path remains intact.
NC GPIO: leave analog mode; HSI accuracy / PLL / ADC timing require validation.
MCU_ARM / RESET_REQUEST 10k and WDI 1k default-low resistors are on fault-latch page.
