felixfelix-bot/cycle-without-chain/hardware/powerboard-reva/powerboard-reva.kicad_pcb

## KiCad design hardware/powerboard-reva/powerboard-reva.kicad_pcb (continued)

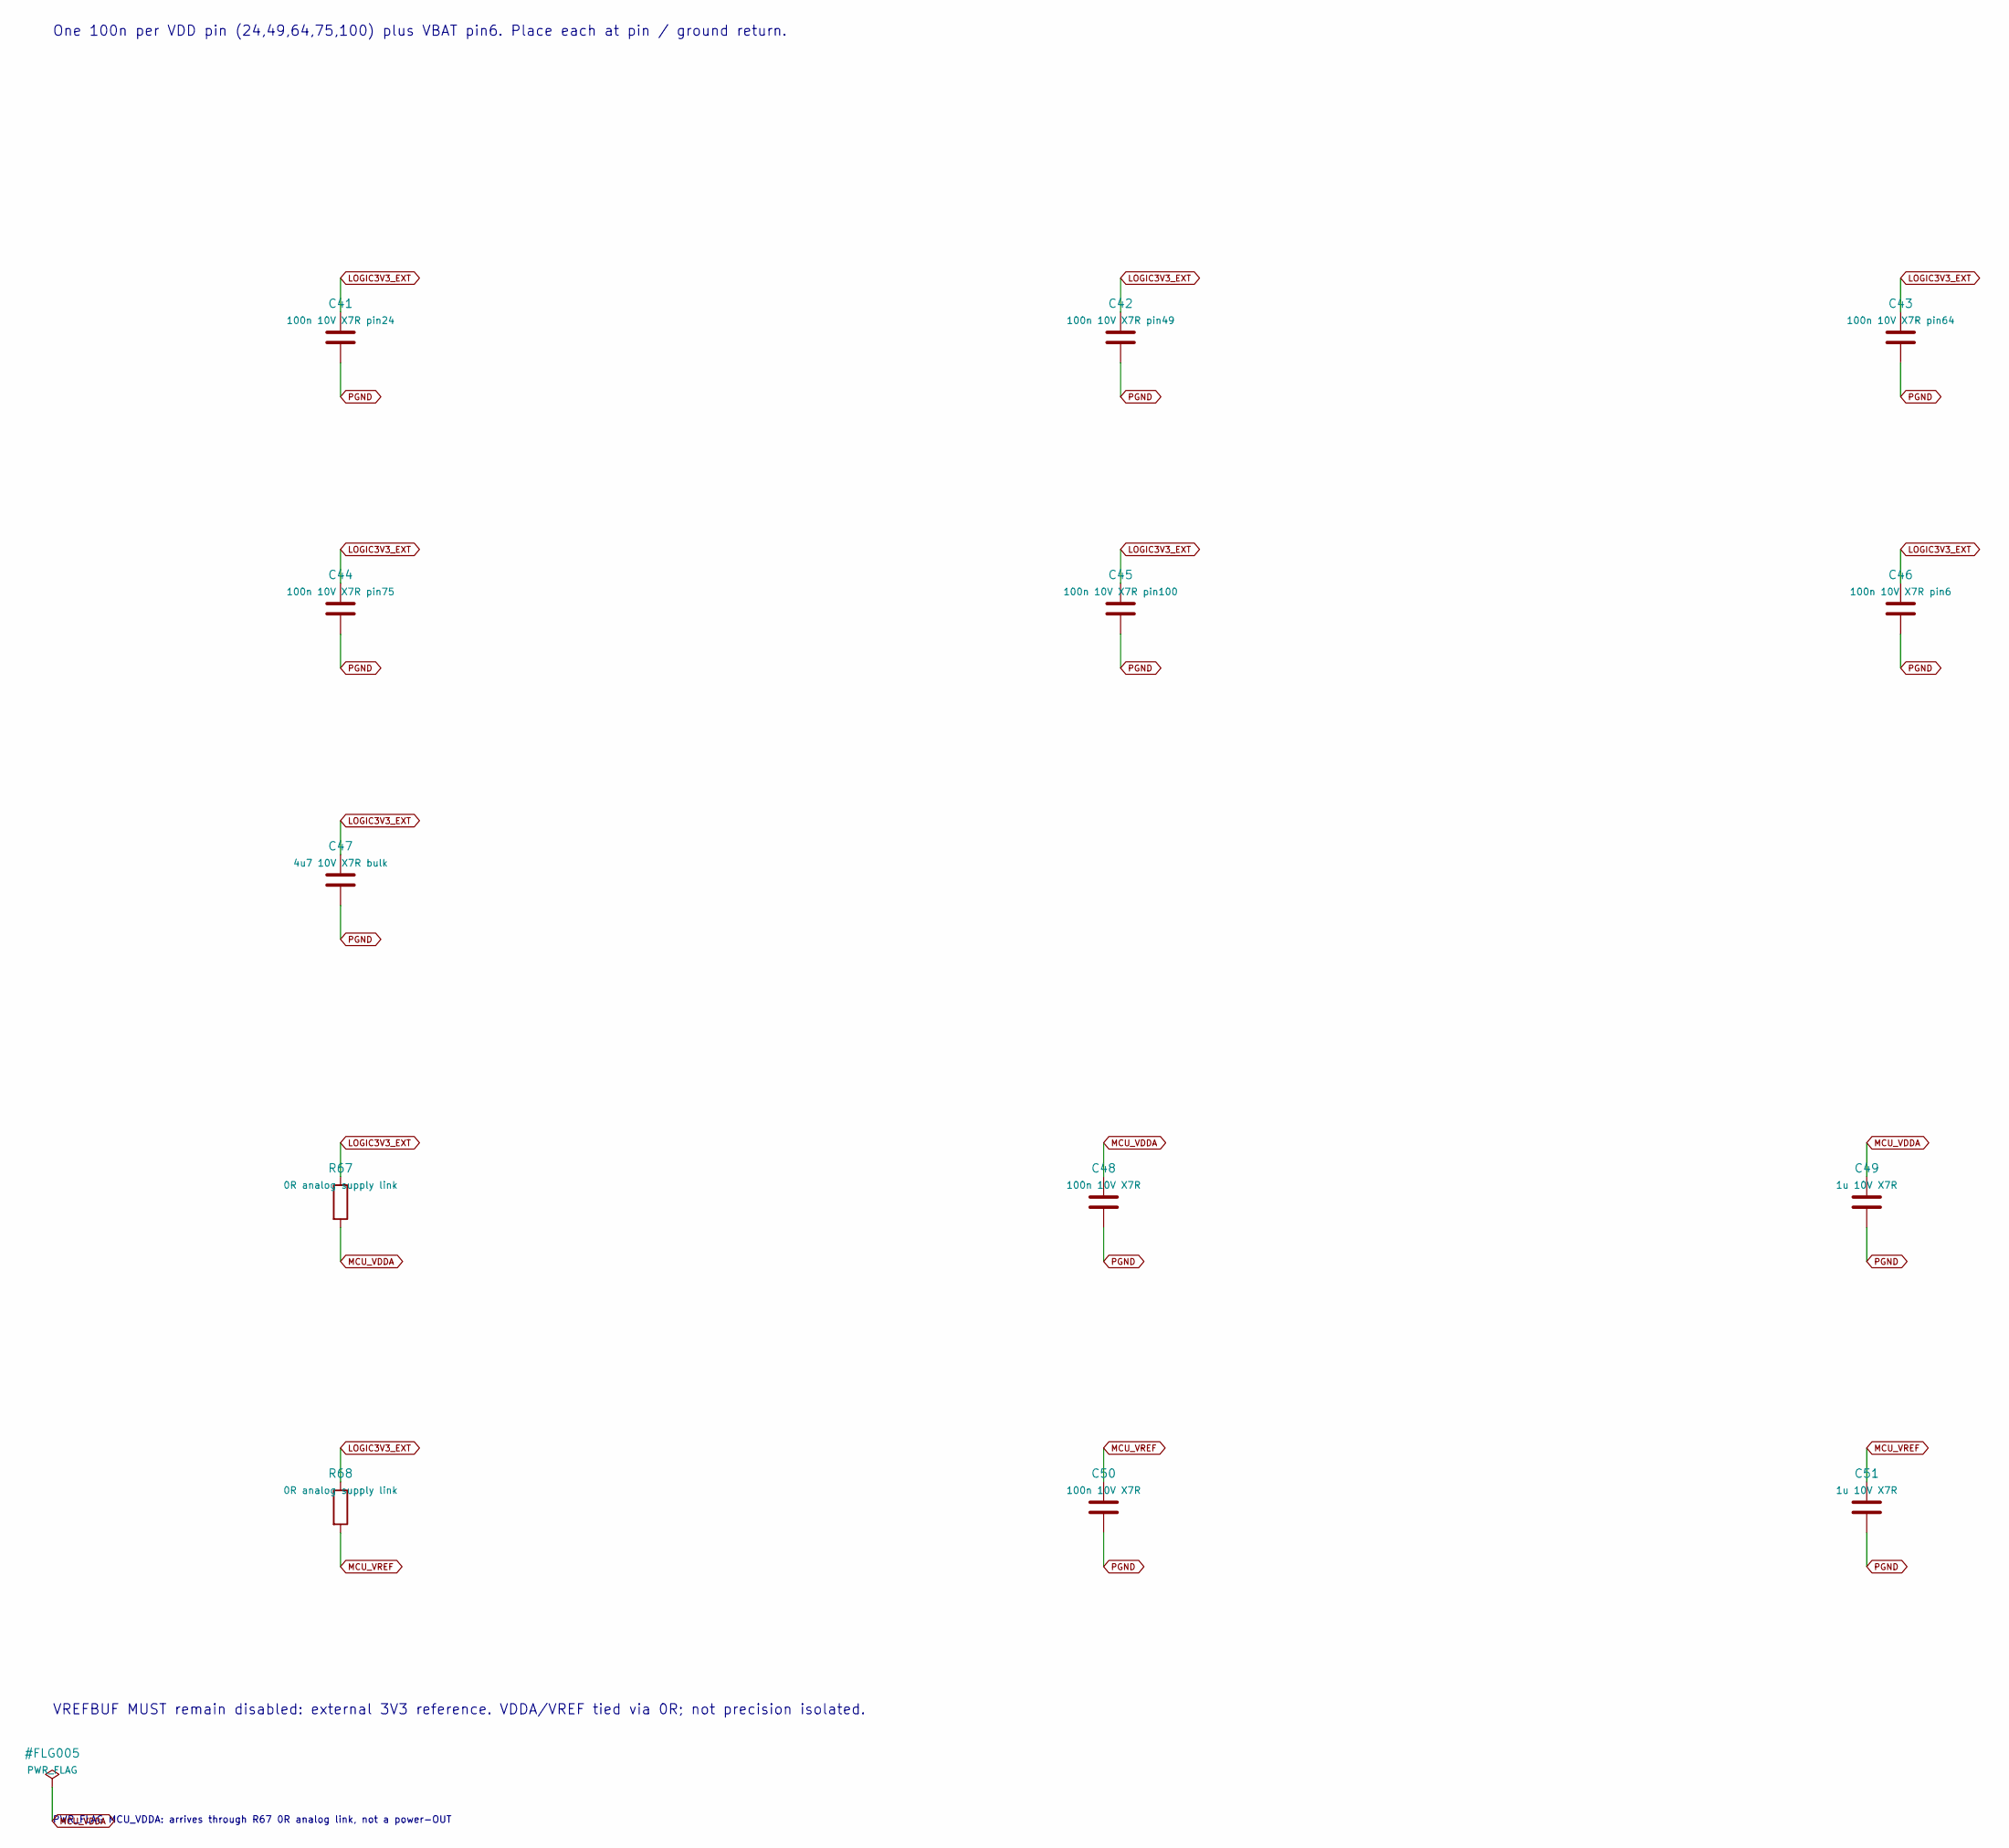
[picture p54: schematic mcu-power.kicad_sch, MCU 3V3 decoupling - external supervised rail]

Parts:
C41: 100n 10V X7R pin24; C_0603_1608Metric
C42: 100n 10V X7R pin49; C_0603_1608Metric
C43: 100n 10V X7R pin64; C_0603_1608Metric
C44: 100n 10V X7R pin75; C_0603_1608Metric
C45: 100n 10V X7R pin100; C_0603_1608Metric
C46: 100n 10V X7R pin6; C_0603_1608Metric
C47: 4u7 10V X7R bulk; C_0603_1608Metric
C48, C50: 100n 10V X7R; C_0603_1608Metric
C49, C51: 1u 10V X7R; C_0603_1608Metric
R67, R68: 0R analog supply link; R_0603_1608Metric

Connections:
LOGIC3V3_EXT: C41.1, C42.1, C43.1, C44.1, C45.1, C46.1, C47.1, R67.1, R68.1; also elsewhere on the board
MCU_VDDA: C48.1, C49.1, R67.2; also elsewhere on the board
MCU_VREF: C50.1, C51.1, R68.2; also elsewhere on the board
PGND: C41.2, C42.2, C43.2, C44.2, C45.2, C46.2, C47.2, C48.2, C49.2, C50.2, C51.2; also elsewhere on the board

Notes on the sheet:
One 100n per VDD pin (24,49,64,75,100) plus VBAT pin6. Place each at pin / ground return.
VREFBUF MUST remain disabled: external 3V3 reference. VDDA/VREF tied via 0R; not precision isolated.
PWR_FLAG MCU_VDDA: arrives through R67 0R analog link, not a power-OUT

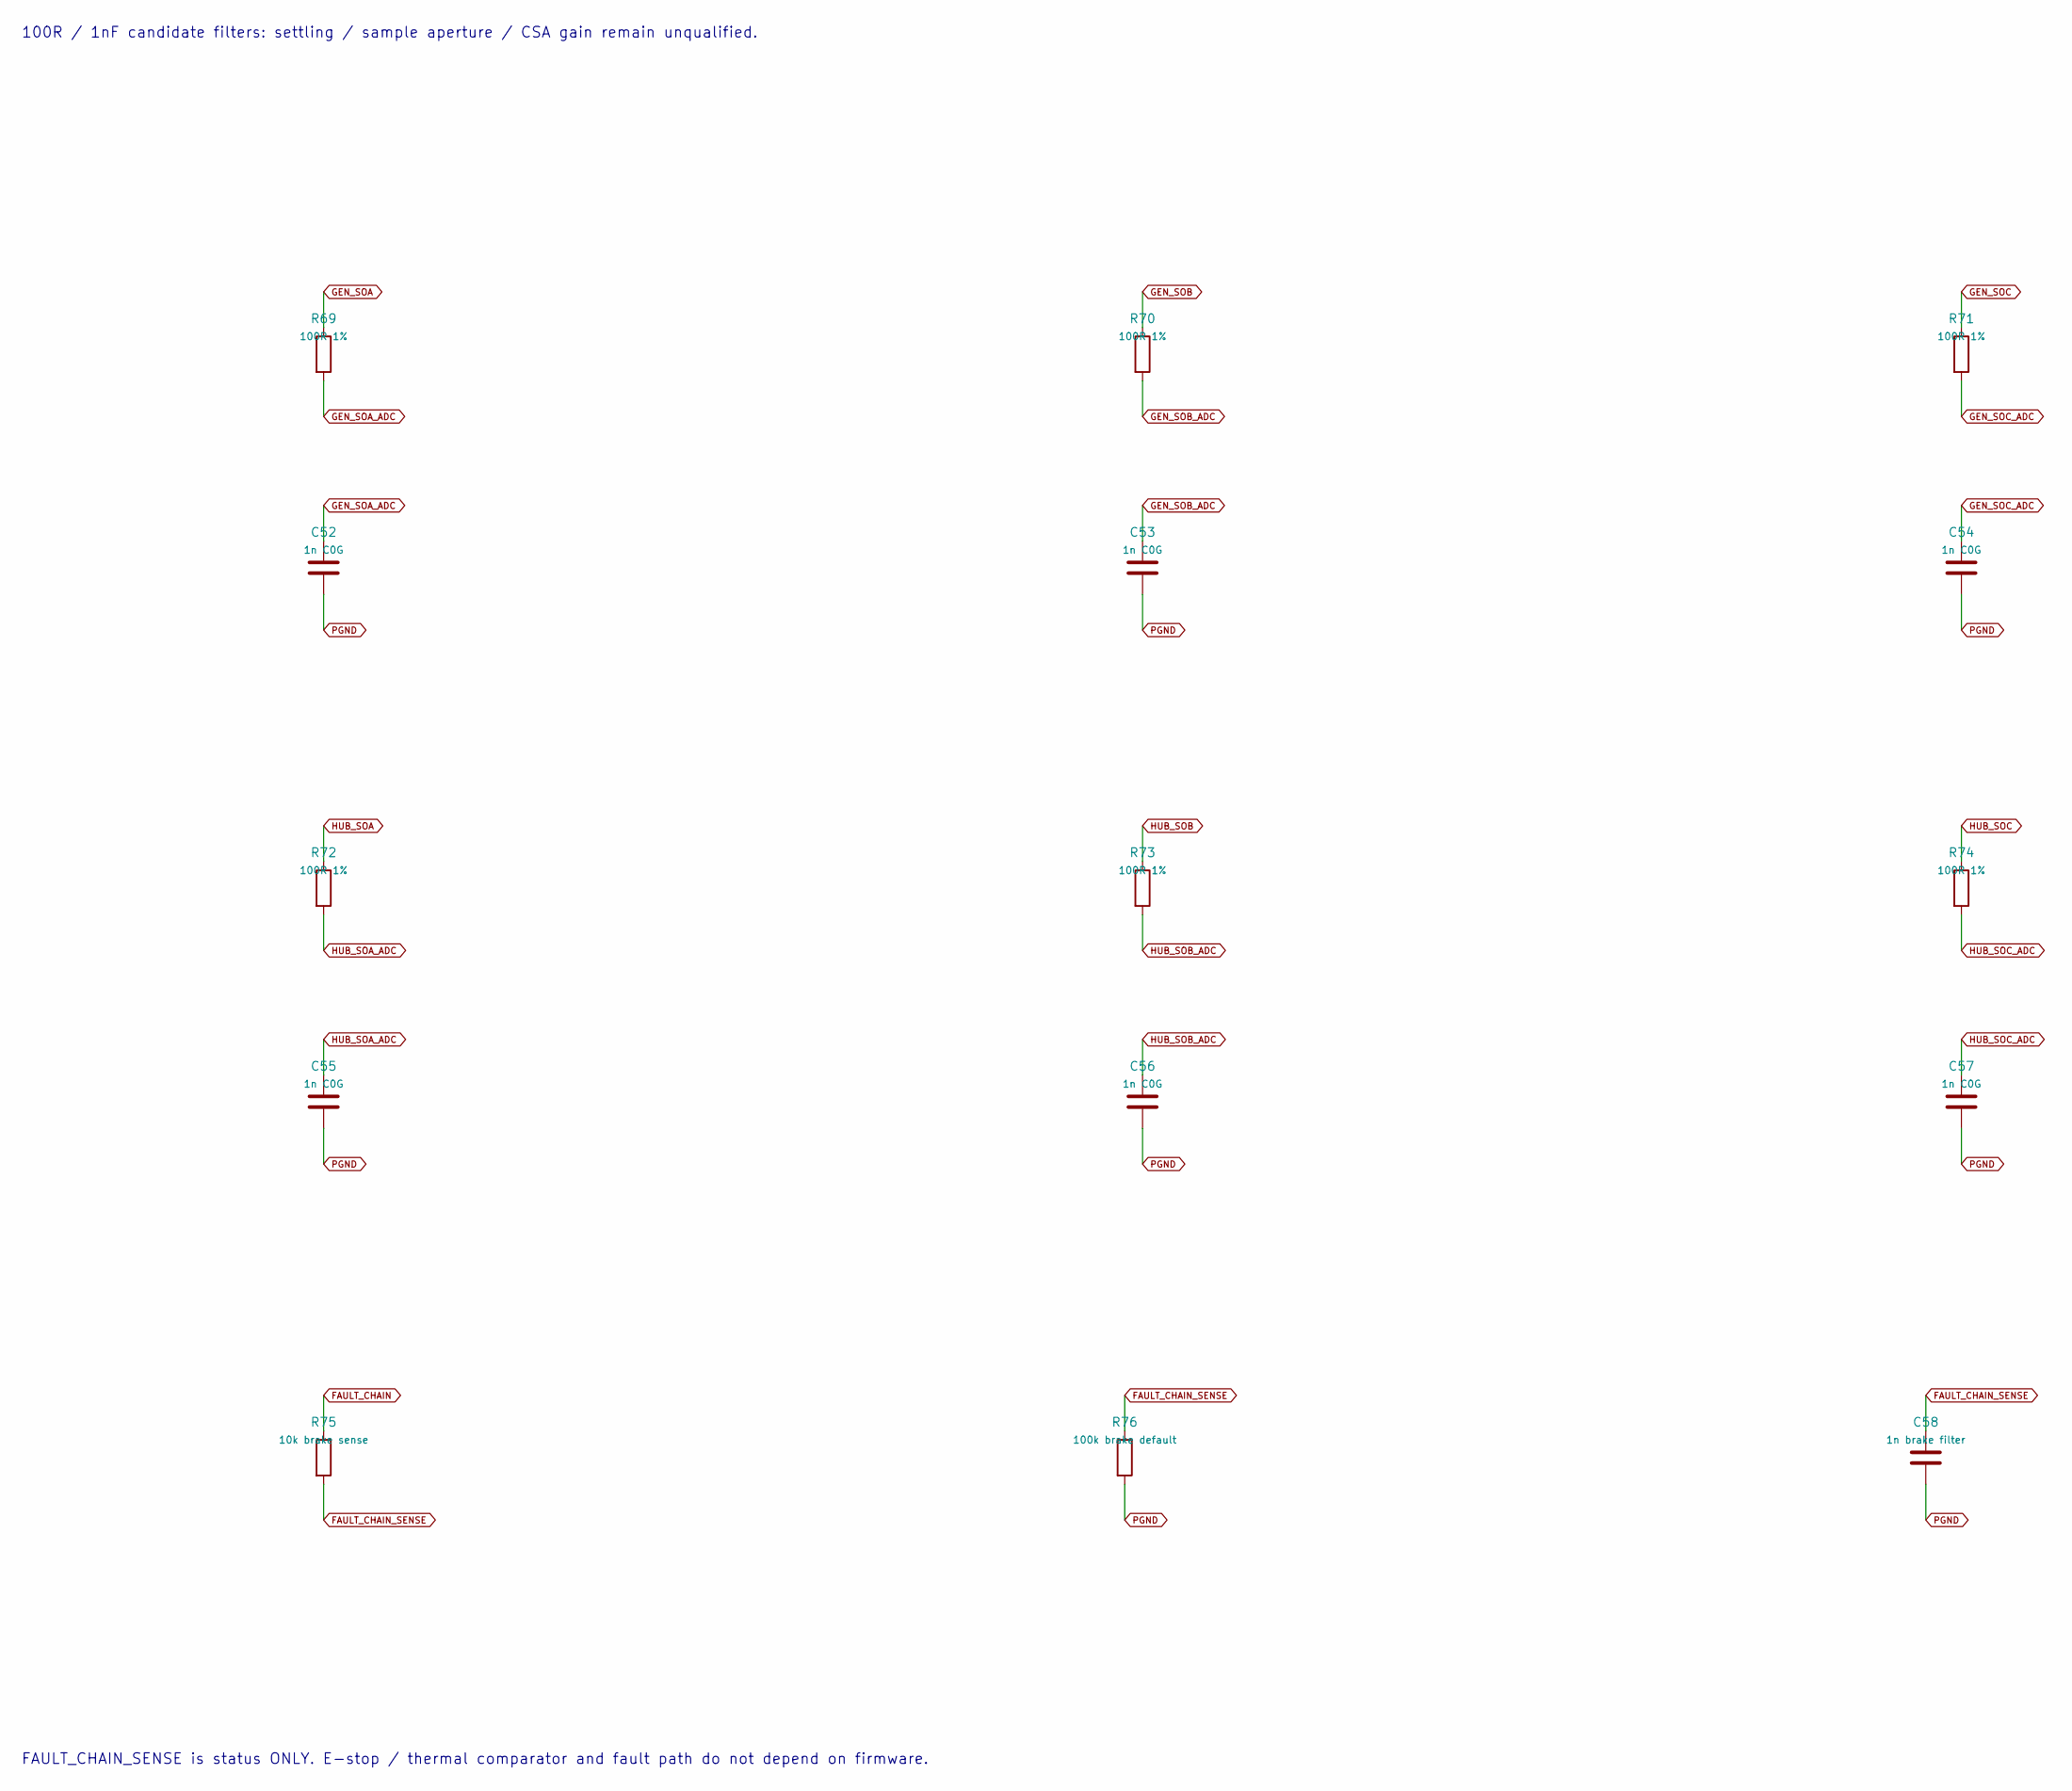
[picture p55: schematic mcu-analog.kicad_sch, Six CSA ADC input filters and brake status sense]

Parts:
C52, C53, C54, C55, C56, C57: 1n C0G; C_0603_1608Metric
C58: 1n brake filter; C_0603_1608Metric
R69, R70, R71, R72, R73, R74: 100R 1%; R_0603_1608Metric
R75: 10k brake sense; R_0603_1608Metric
R76: 100k brake default; R_0603_1608Metric

Connections:
FAULT_CHAIN: R75.1; also elsewhere on the board
FAULT_CHAIN_SENSE: C58.1, R75.2, R76.1; also elsewhere on the board
GEN_SOA: R69.1; also elsewhere on the board
GEN_SOA_ADC: C52.1, R69.2; also elsewhere on the board
GEN_SOB: R70.1; also elsewhere on the board
GEN_SOB_ADC: C53.1, R70.2; also elsewhere on the board
GEN_SOC: R71.1; also elsewhere on the board
GEN_SOC_ADC: C54.1, R71.2; also elsewhere on the board
HUB_SOA: R72.1; also elsewhere on the board
HUB_SOA_ADC: C55.1, R72.2; also elsewhere on the board
HUB_SOB: R73.1; also elsewhere on the board
HUB_SOB_ADC: C56.1, R73.2; also elsewhere on the board
HUB_SOC: R74.1; also elsewhere on the board
HUB_SOC_ADC: C57.1, R74.2; also elsewhere on the board
PGND: C52.2, C53.2, C54.2, C55.2, C56.2, C57.2, C58.2, R76.2; also elsewhere on the board

Notes on the sheet:
100R / 1nF candidate filters: settling / sample aperture / CSA gain remain unqualified.
FAULT_CHAIN_SENSE is status ONLY. E-stop / thermal comparator and fault path do not depend on firmware.

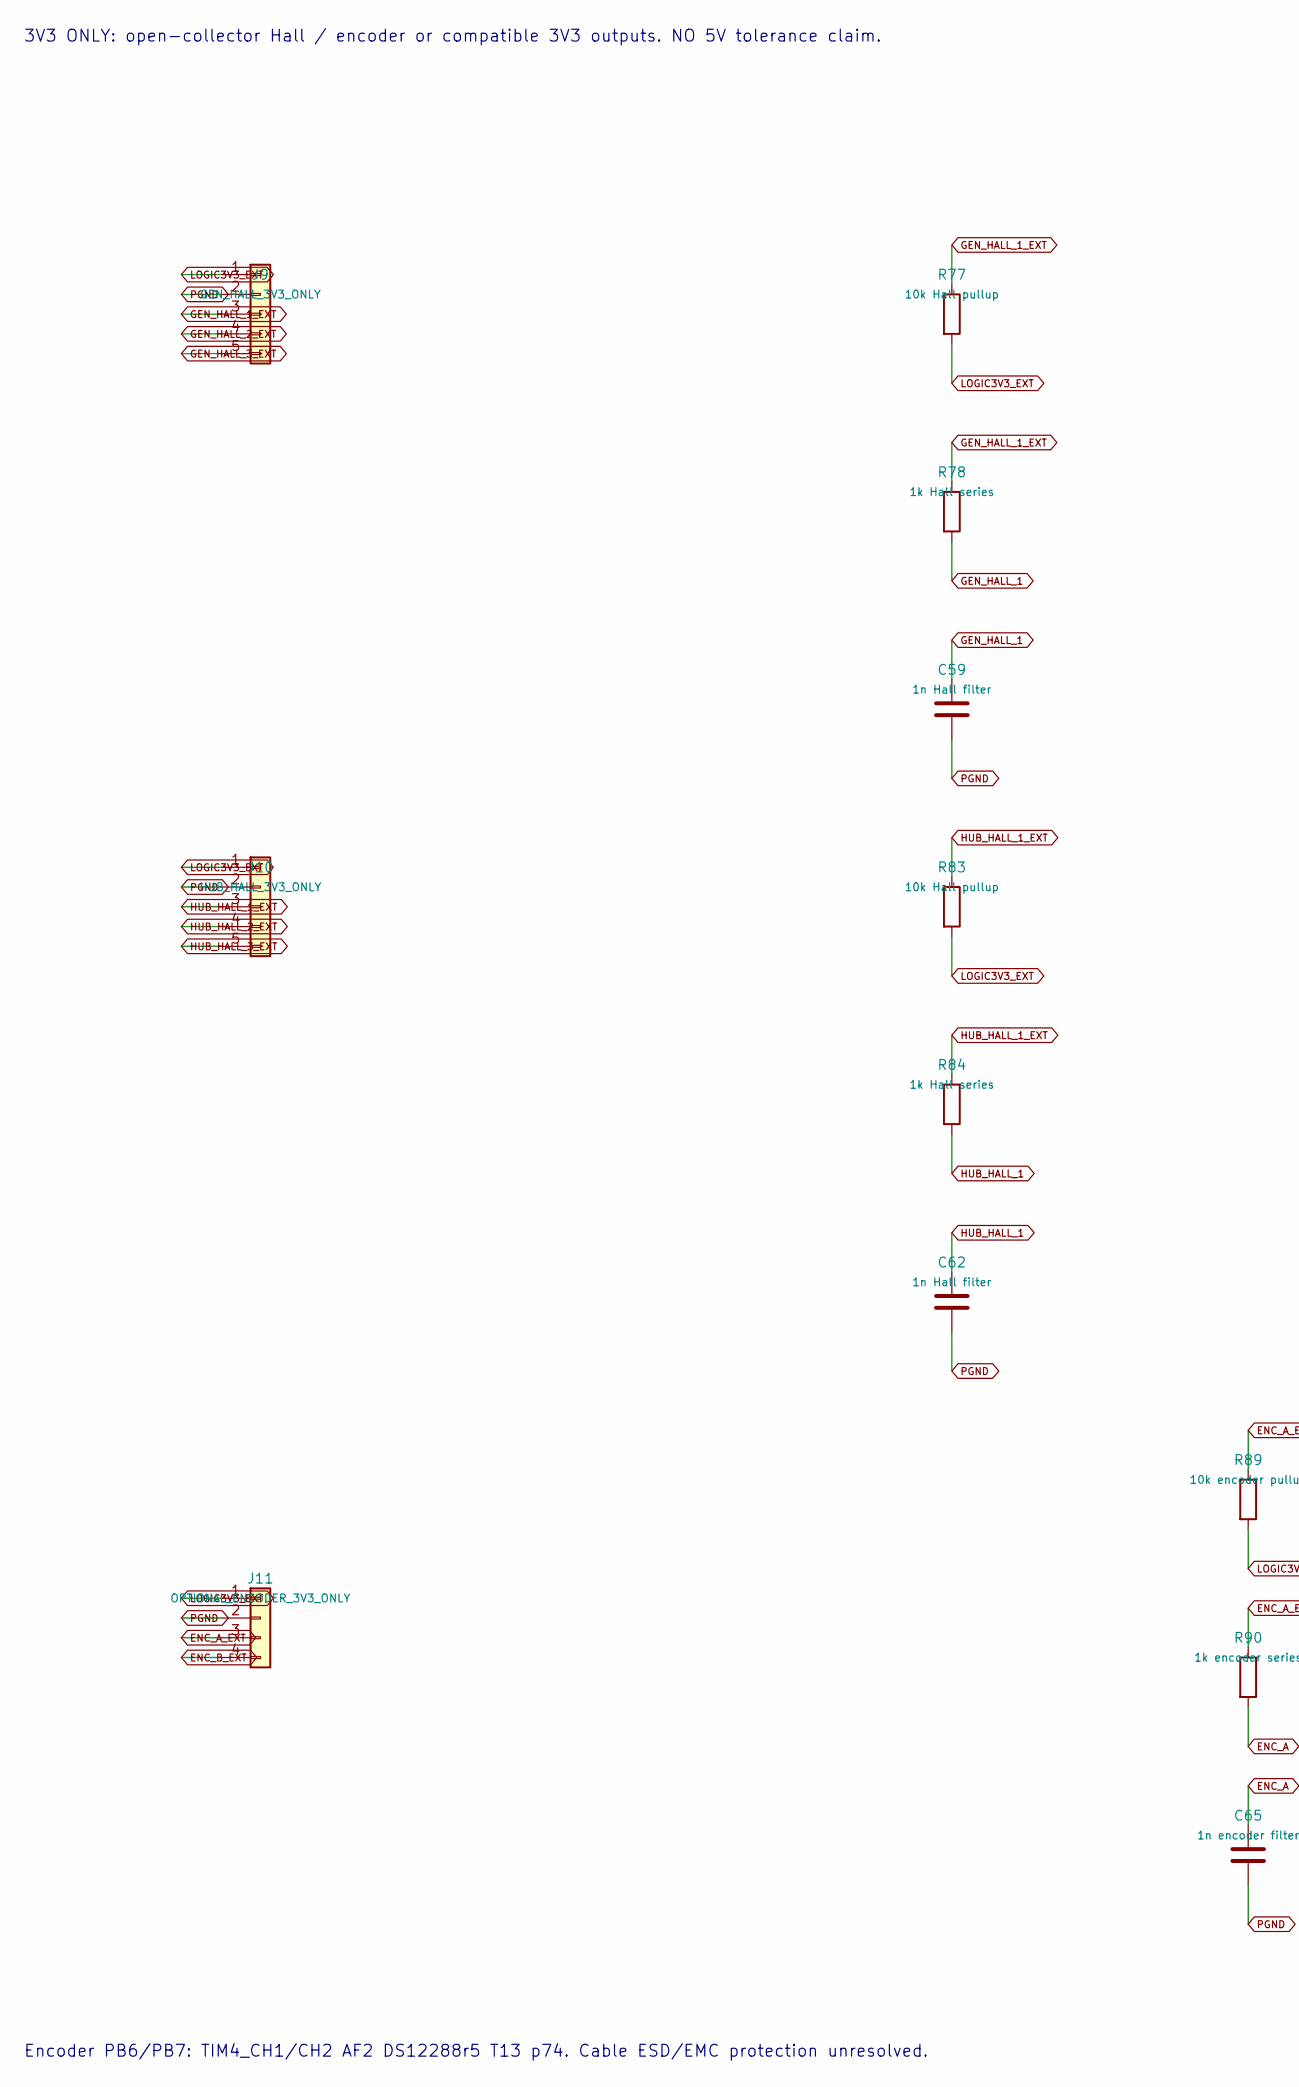
[picture p56: schematic mcu-sensors.kicad_sch, 3V3 Hall interfaces and optional quadrature encoder, part in row 1, column 1]

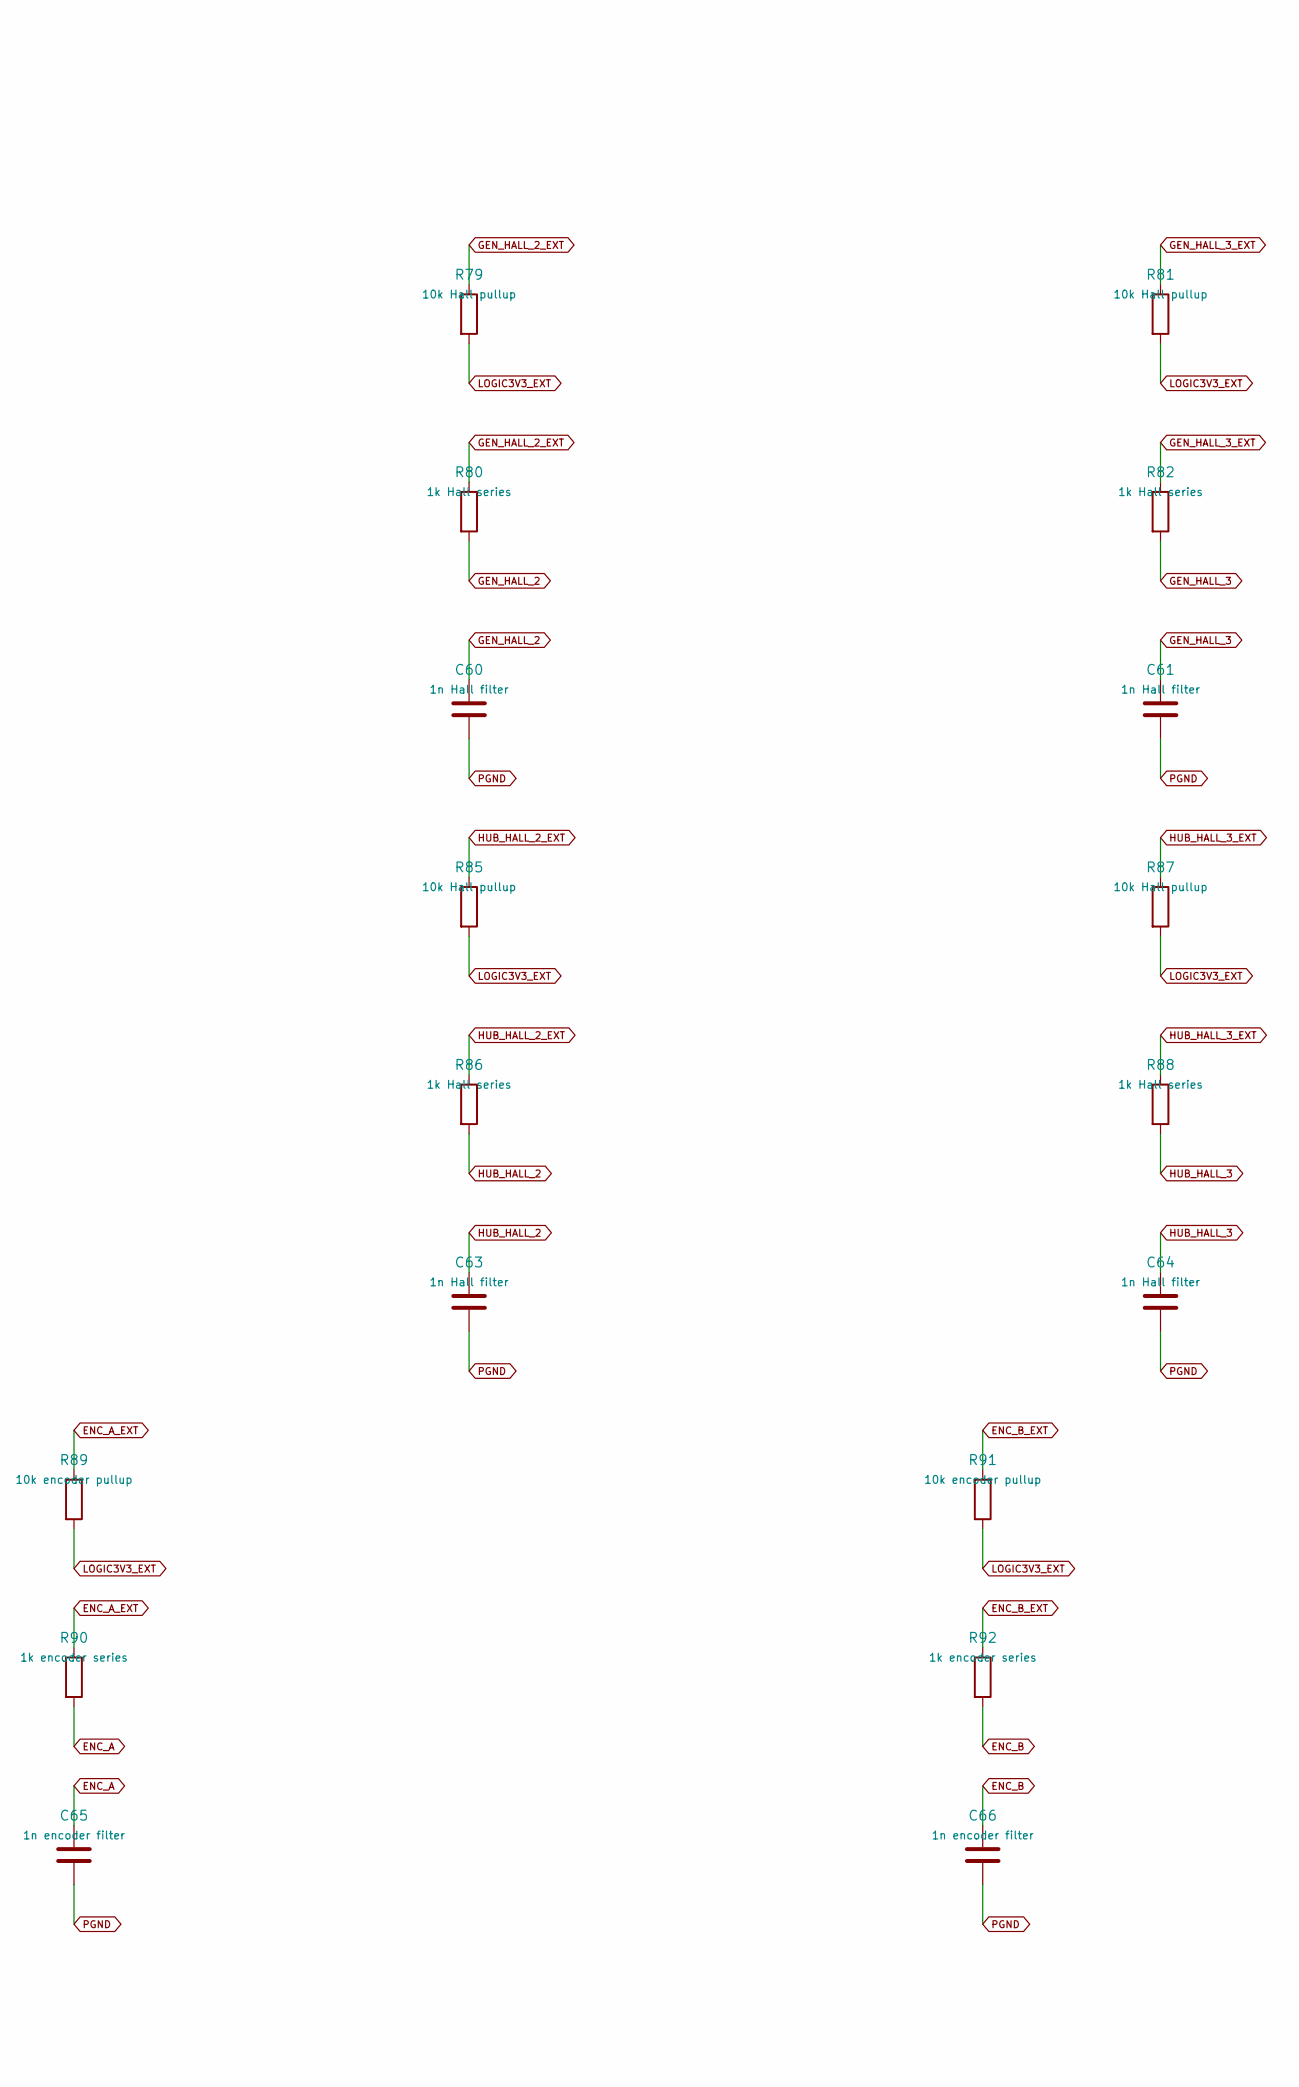
[picture p57: schematic mcu-sensors.kicad_sch, 3V3 Hall interfaces and optional quadrature encoder, part in row 1, column 2]

Parts:
C59, C60, C61, C62, C63, C64: 1n Hall filter; C_0603_1608Metric
C65, C66: 1n encoder filter; C_0603_1608Metric
J9: GEN_HALL_3V3_ONLY; PinHeader_1x05_P2.54mm_Vertical
J10: HUB_HALL_3V3_ONLY; PinHeader_1x05_P2.54mm_Vertical
J11: OPTIONAL_ENCODER_3V3_ONLY; PinHeader_1x05_P2.54mm_Vertical
R77, R79, R81, R83, R85, R87: 10k Hall pullup; R_0603_1608Metric
R78, R80, R82, R84, R86, R88: 1k Hall series; R_0603_1608Metric
R89, R91: 10k encoder pullup; R_0603_1608Metric
R90, R92: 1k encoder series; R_0603_1608Metric

Connections:
ENC_A: C65.1, R90.2; also elsewhere on the board
ENC_A_EXT: J11.3, R89.1, R90.1
ENC_B: C66.1, R92.2; also elsewhere on the board
ENC_B_EXT: J11.4, R91.1, R92.1
GEN_HALL_1: C59.1, R78.2; also elsewhere on the board
GEN_HALL_1_EXT: J9.3, R77.1, R78.1
GEN_HALL_2: C60.1, R80.2; also elsewhere on the board
GEN_HALL_2_EXT: J9.4, R79.1, R80.1
GEN_HALL_3: C61.1, R82.2; also elsewhere on the board
GEN_HALL_3_EXT: J9.5, R81.1, R82.1
HUB_HALL_1: C62.1, R84.2; also elsewhere on the board
HUB_HALL_1_EXT: J10.3, R83.1, R84.1
HUB_HALL_2: C63.1, R86.2; also elsewhere on the board
HUB_HALL_2_EXT: J10.4, R85.1, R86.1
HUB_HALL_3: C64.1, R88.2; also elsewhere on the board
HUB_HALL_3_EXT: J10.5, R87.1, R88.1
LOGIC3V3_EXT: J9.1, J10.1, J11.1, R77.2, R79.2, R81.2, R83.2, R85.2, R87.2, R89.2, R91.2; also elsewhere on the board
PGND: C59.2, C60.2, C61.2, C62.2, C63.2, C64.2, C65.2, C66.2, J9.2, J10.2, J11.2; also elsewhere on the board

Notes on the sheet:
3V3 ONLY: open-collector Hall / encoder or compatible 3V3 outputs. NO 5V tolerance claim.
Encoder PB6/PB7: TIM4_CH1/CH2 AF2 DS12288r5 T13 p74. Cable ESD/EMC protection unresolved.

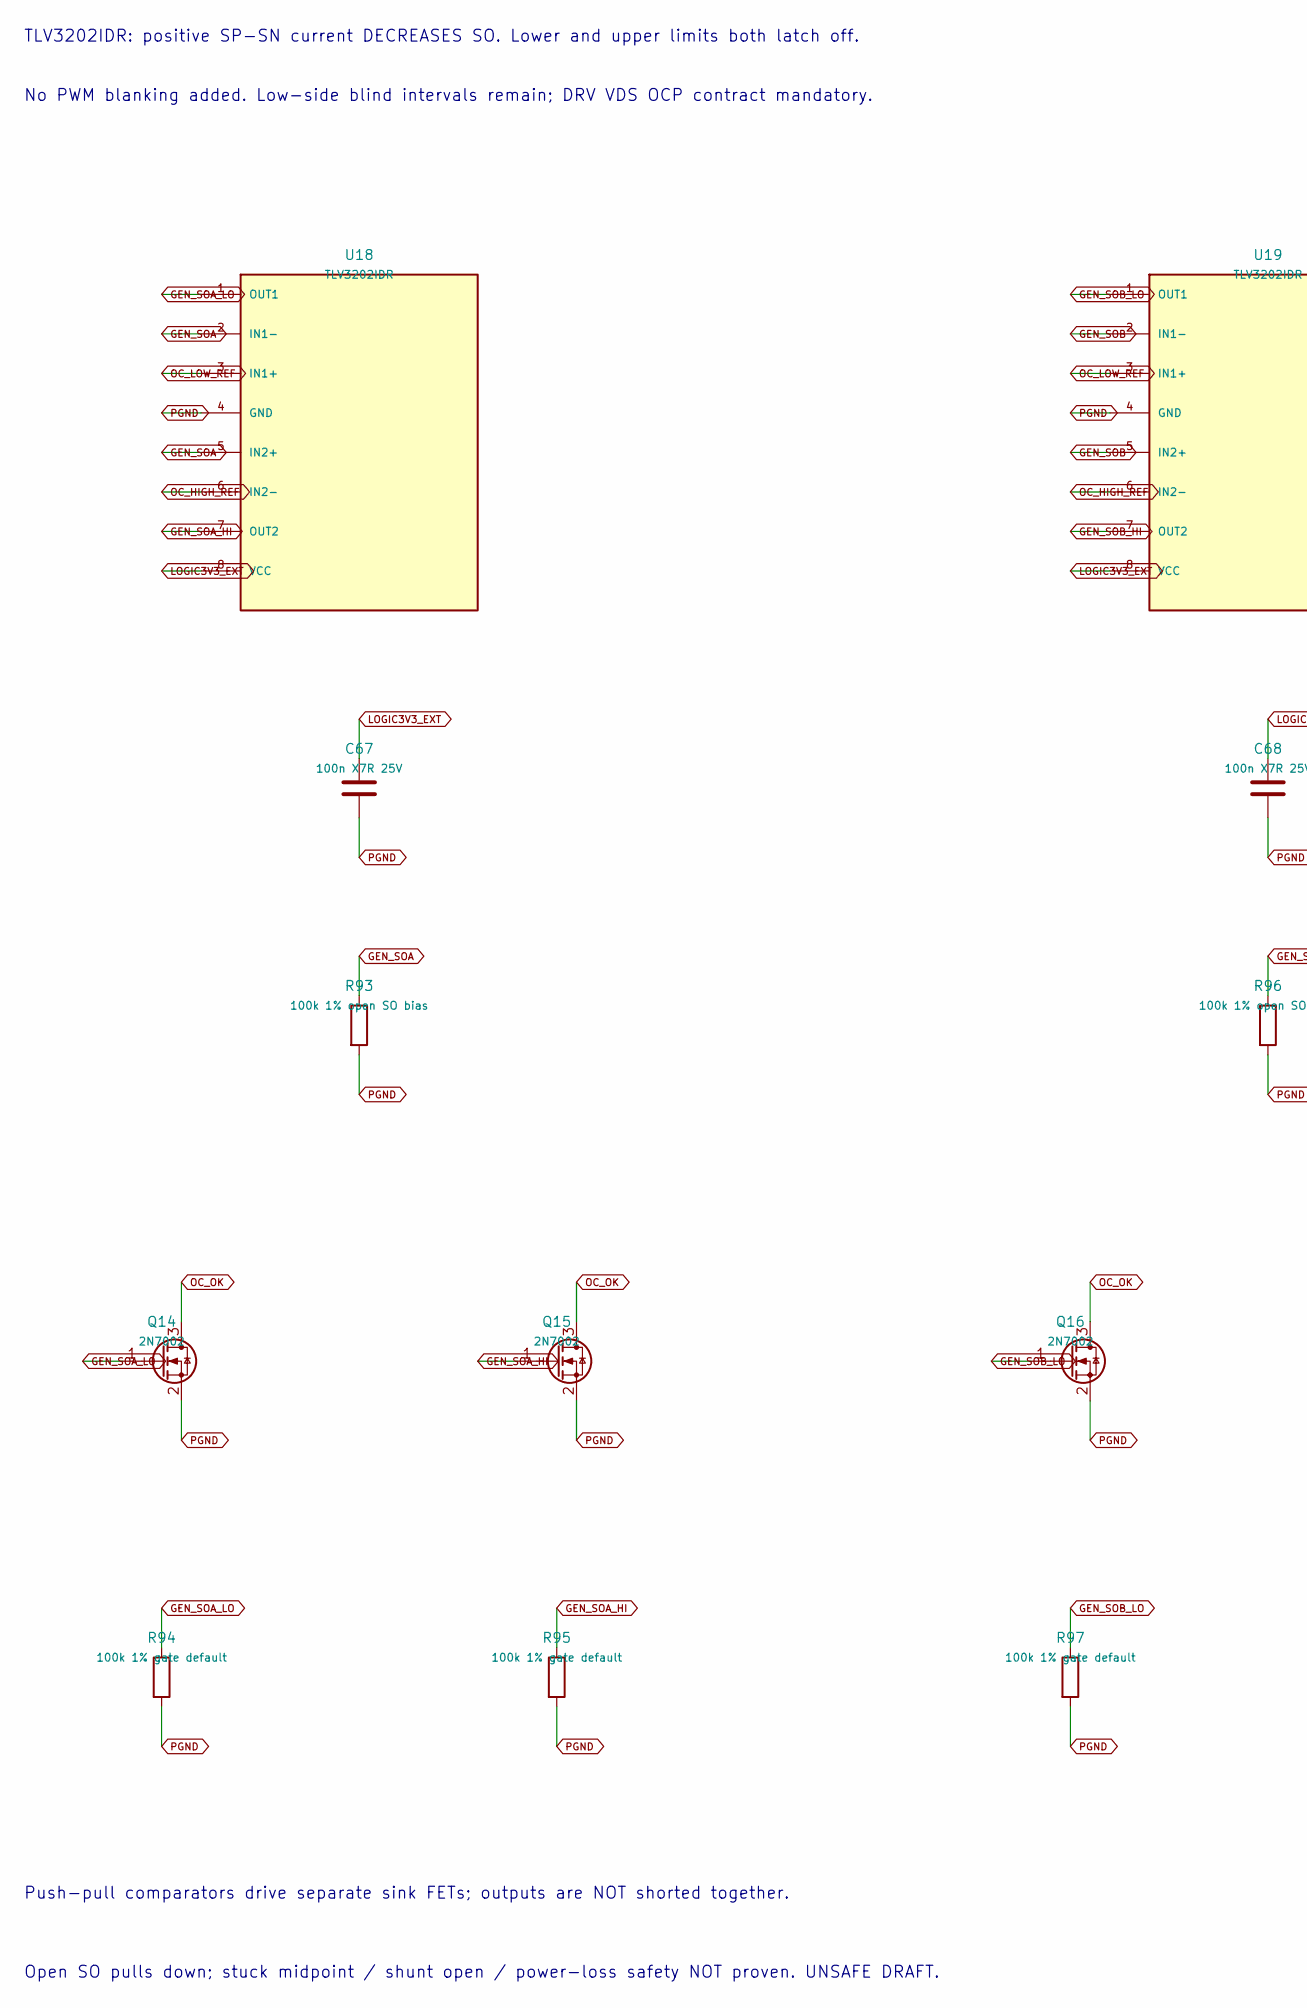
[picture p58: schematic gen-fast-oc.kicad_sch, GEN independent raw CSA window trips, part in row 1, column 1]

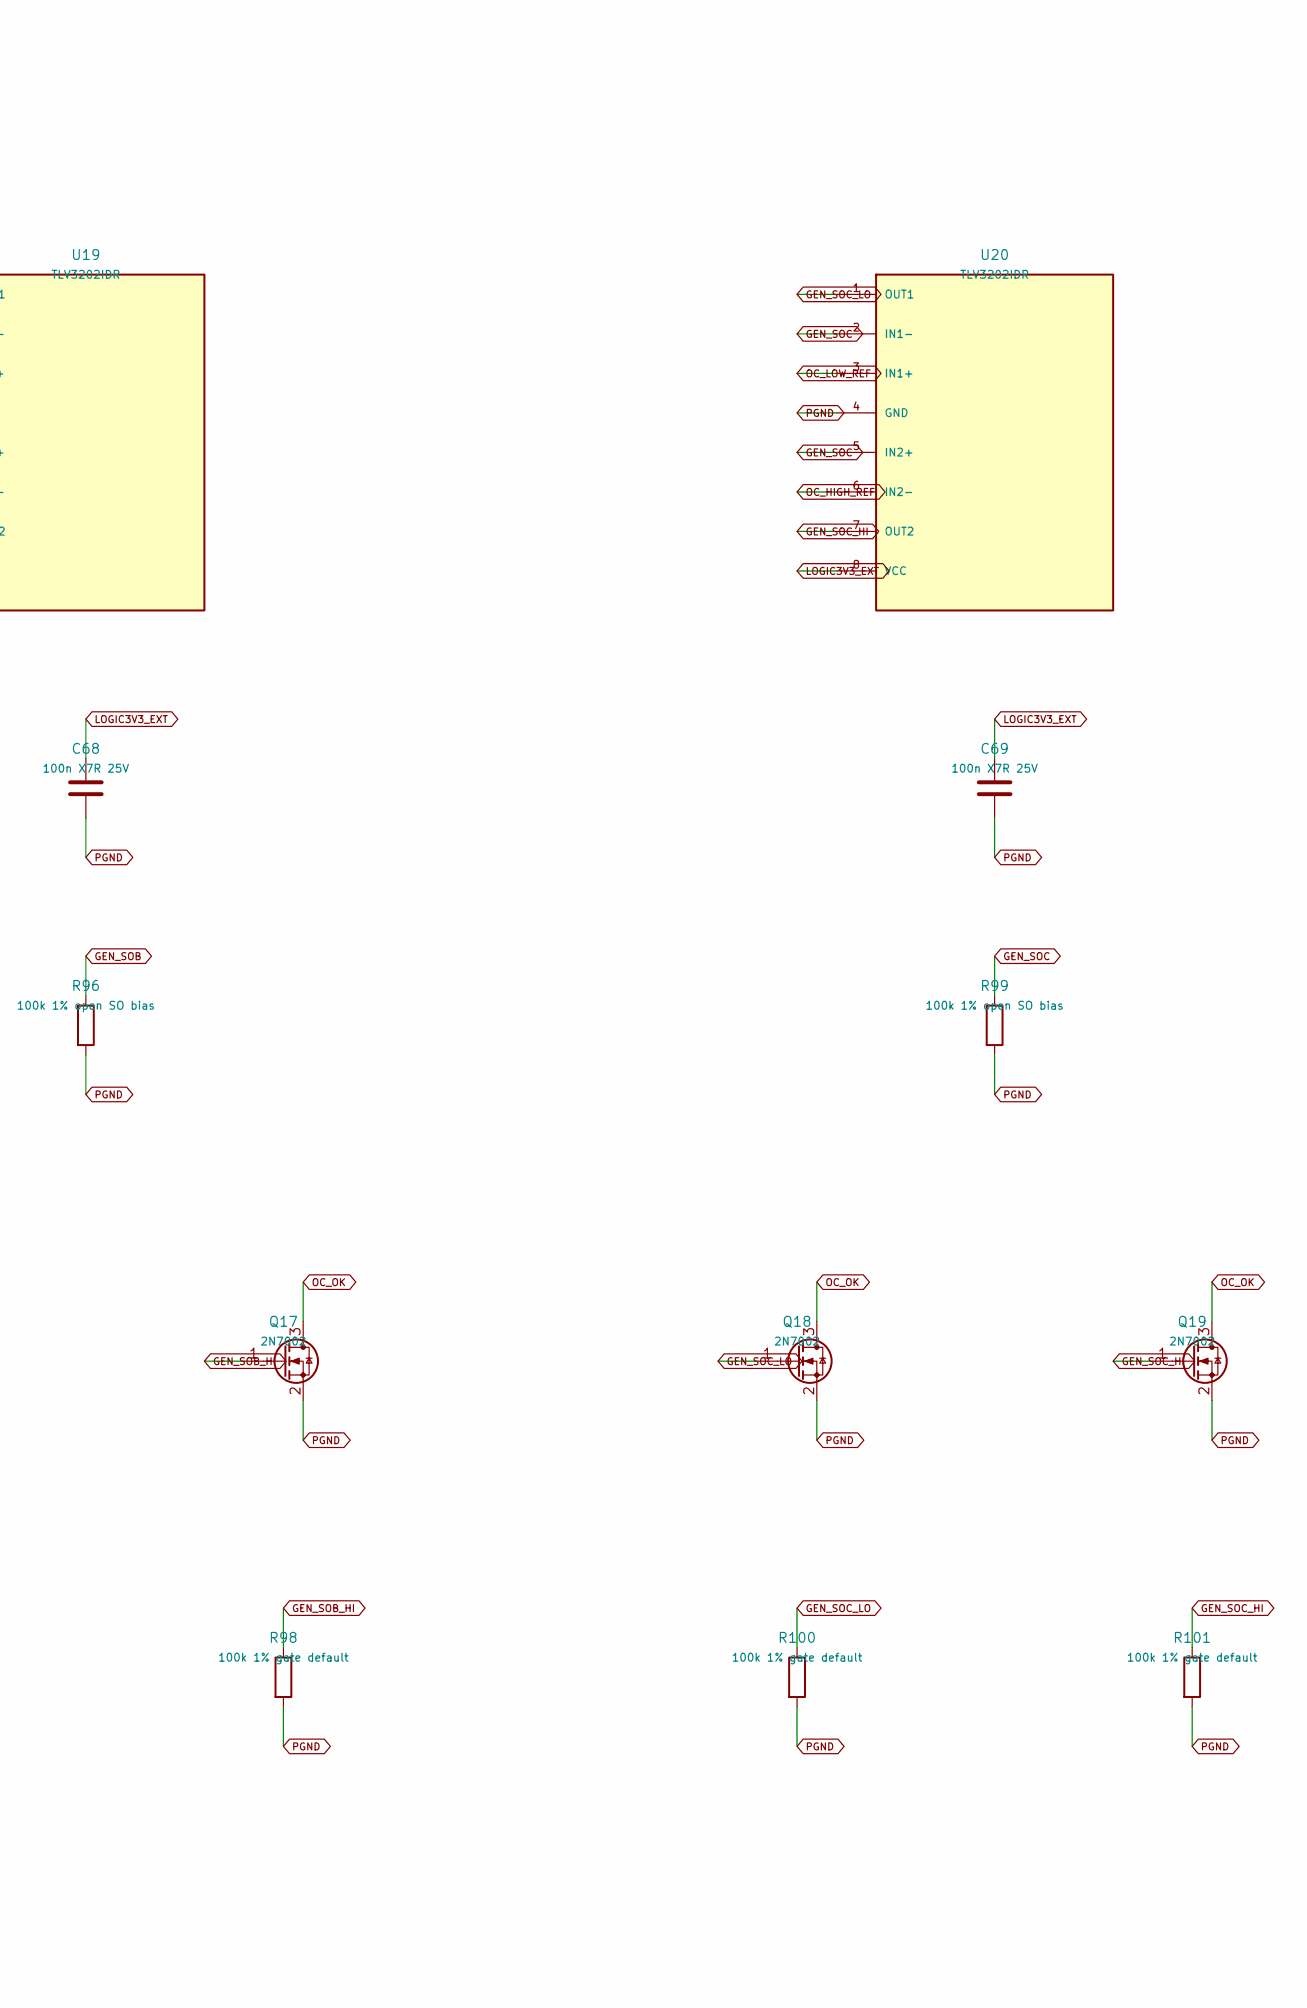
[picture p59: schematic gen-fast-oc.kicad_sch, GEN independent raw CSA window trips, part in row 1, column 2]

Parts:
C67, C68, C69: 100n X7R 25V; C_0805_2012Metric
Q14, Q15, Q16, Q17, Q18, Q19: 2N7002; SOT-23
R93, R96, R99: 100k 1% open SO bias; R_0805_2012Metric
R94, R95, R97, R98, R100, R101: 100k 1% gate default; R_0805_2012Metric
U18, U19, U20: TLV3202IDR; SOIC-8_3.9x4.9mm_P1.27mm

Connections:
GEN_SOA: R93.1, U18.2 (IN1-), U18.5 (IN2+); also elsewhere on the board
GEN_SOA_HI: Q15.1 (G), R95.1, U18.7 (OUT2)
GEN_SOA_LO: Q14.1 (G), R94.1, U18.1 (OUT1)
GEN_SOB: R96.1, U19.2 (IN1-), U19.5 (IN2+); also elsewhere on the board
GEN_SOB_HI: Q17.1 (G), R98.1, U19.7 (OUT2)
GEN_SOB_LO: Q16.1 (G), R97.1, U19.1 (OUT1)
GEN_SOC: R99.1, U20.2 (IN1-), U20.5 (IN2+); also elsewhere on the board
GEN_SOC_HI: Q19.1 (G), R101.1, U20.7 (OUT2)
GEN_SOC_LO: Q18.1 (G), R100.1, U20.1 (OUT1)
LOGIC3V3_EXT: C67.1, C68.1, C69.1, U18.8 (VCC), U19.8 (VCC), U20.8 (VCC); also elsewhere on the board
OC_HIGH_REF: U18.6 (IN2-), U19.6 (IN2-), U20.6 (IN2-); also elsewhere on the board
OC_LOW_REF: U18.3 (IN1+), U19.3 (IN1+), U20.3 (IN1+); also elsewhere on the board
OC_OK: Q14.3 (D), Q15.3 (D), Q16.3 (D), Q17.3 (D), Q18.3 (D), Q19.3 (D); also elsewhere on the board
PGND: C67.2, C68.2, C69.2, Q14.2 (S), Q15.2 (S), Q16.2 (S), Q17.2 (S), Q18.2 (S), Q19.2 (S), R93.2, R94.2, R95.2, R96.2, R97.2, R98.2, R99.2, R100.2, R101.2, U18.4 (GND), U19.4 (GND), U20.4 (GND); also elsewhere on the board

Notes on the sheet:
TLV3202IDR: positive SP-SN current DECREASES SO. Lower and upper limits both latch off.
No PWM blanking added. Low-side blind intervals remain; DRV VDS OCP contract mandatory.
Push-pull comparators drive separate sink FETs; outputs are NOT shorted together.
Open SO pulls down; stuck midpoint / shunt open / power-loss safety NOT proven. UNSAFE DRAFT.
