felixfelix-bot/cycle-without-chain/hardware/powerboard-reva/powerboard-reva.kicad_pcb

## KiCad design hardware/powerboard-reva/powerboard-reva.kicad_pcb (continued)

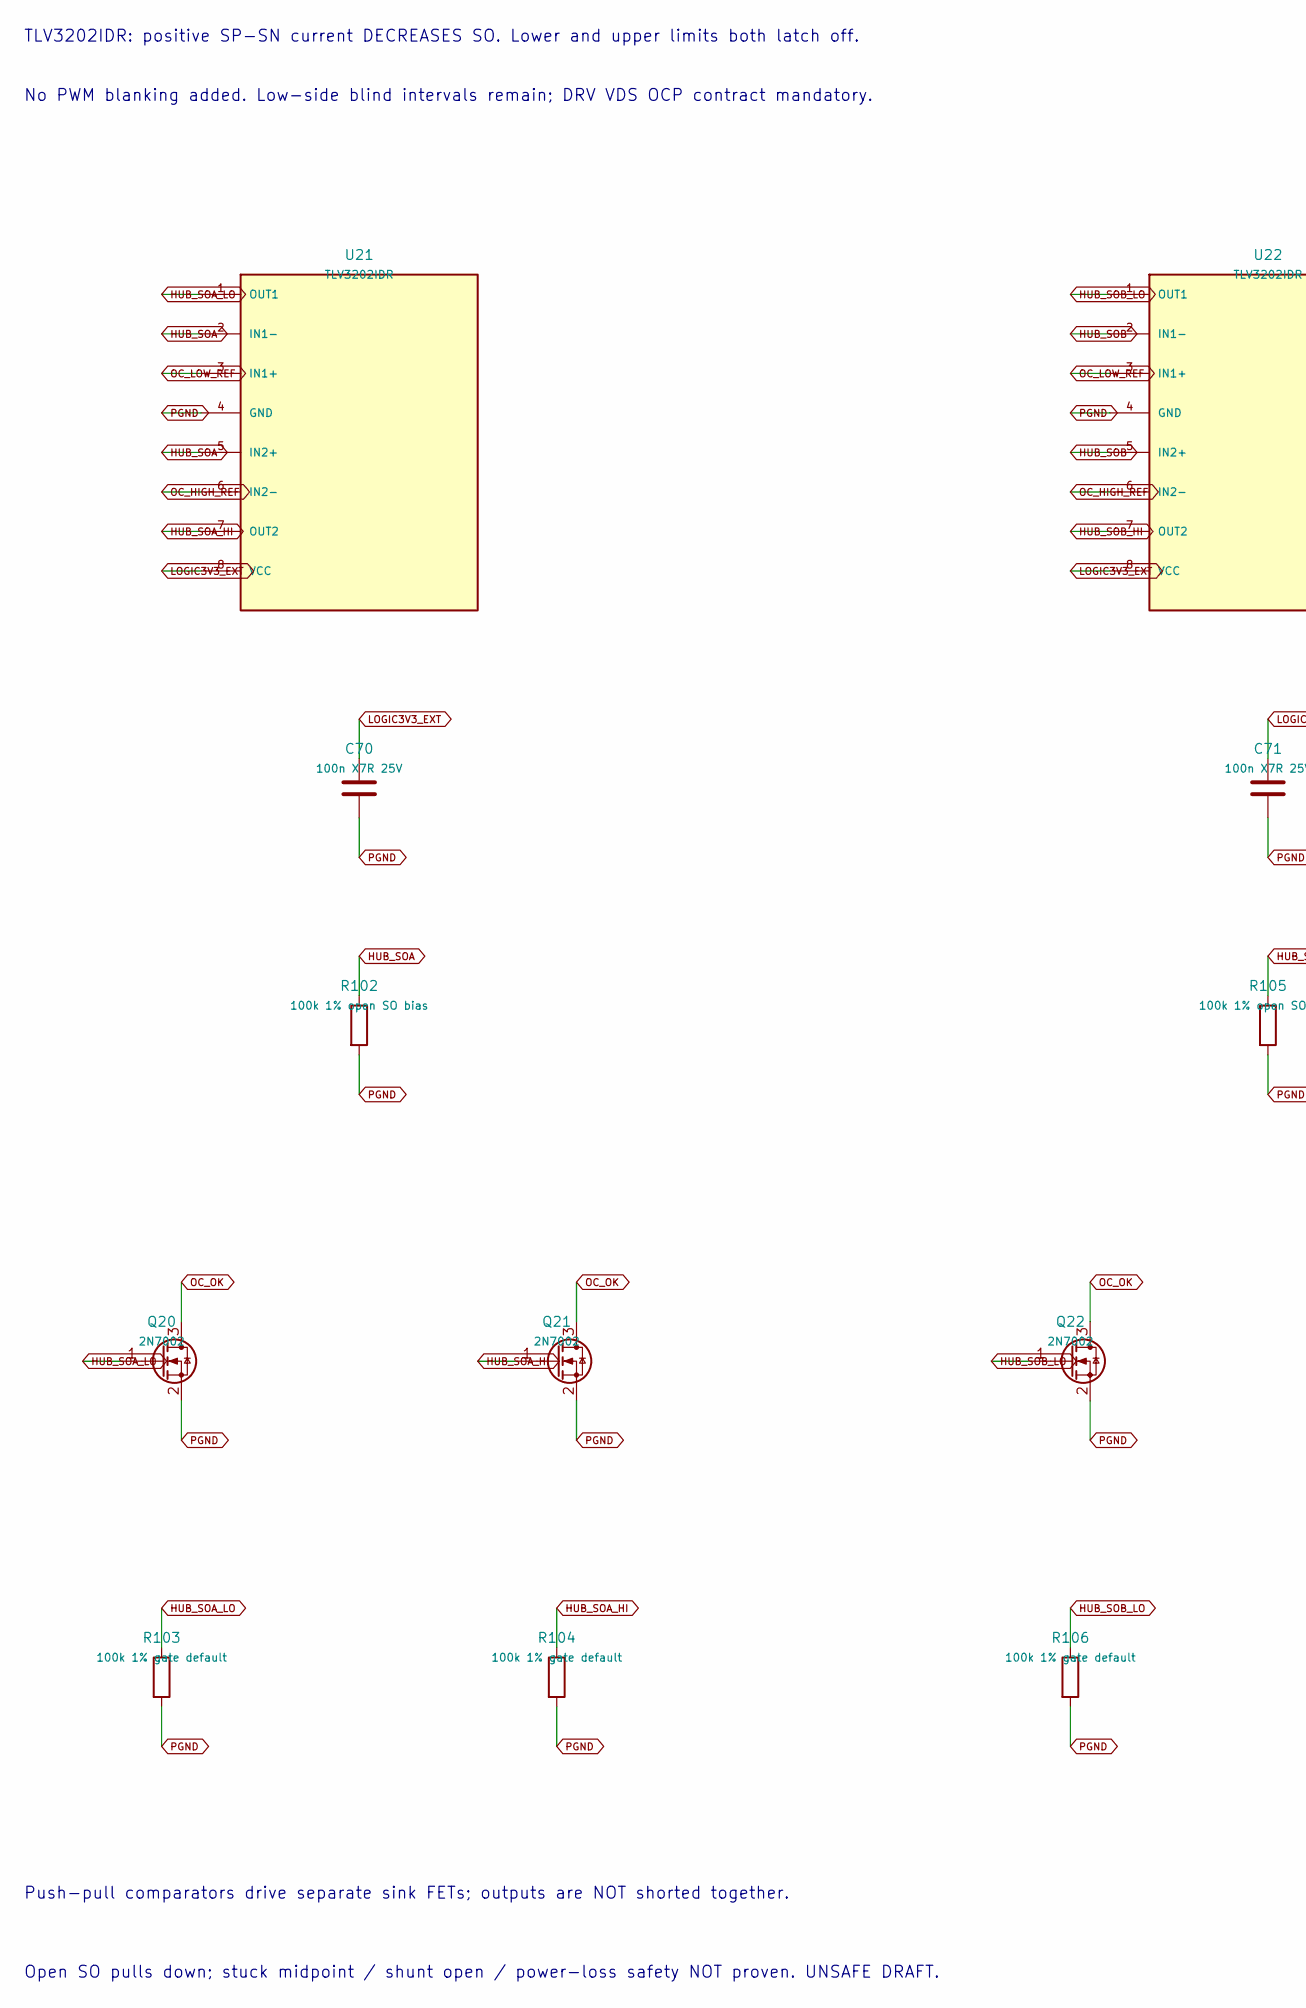
[picture p60: schematic hub-fast-oc.kicad_sch, HUB independent raw CSA window trips, part in row 1, column 1]

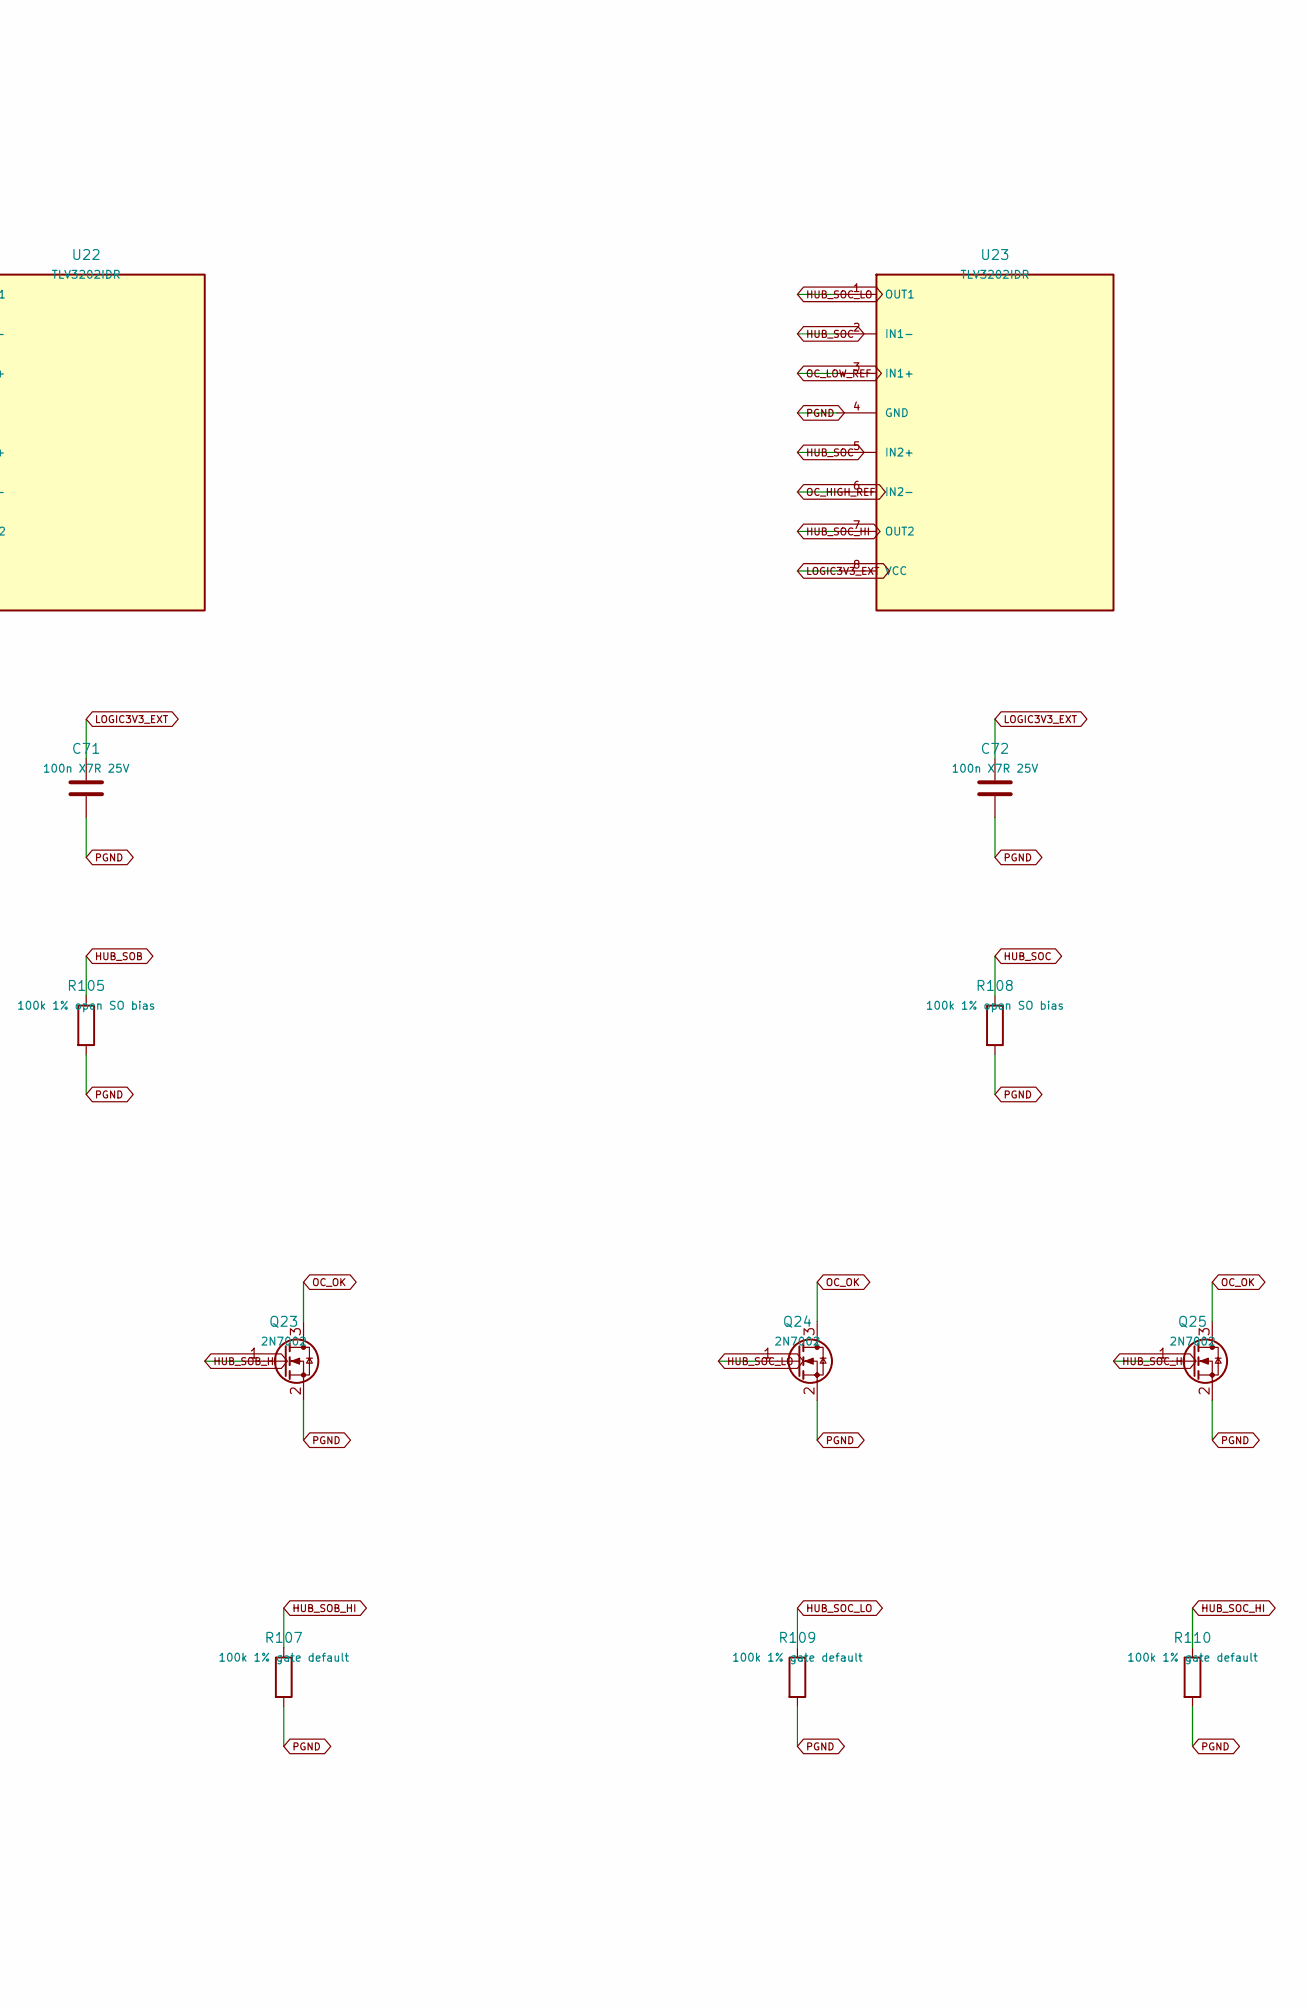
[picture p61: schematic hub-fast-oc.kicad_sch, HUB independent raw CSA window trips, part in row 1, column 2]

Parts:
C70, C71, C72: 100n X7R 25V; C_0805_2012Metric
Q20, Q21, Q22, Q23, Q24, Q25: 2N7002; SOT-23
R102, R105, R108: 100k 1% open SO bias; R_0805_2012Metric
R103, R104, R106, R107, R109, R110: 100k 1% gate default; R_0805_2012Metric
U21, U22, U23: TLV3202IDR; SOIC-8_3.9x4.9mm_P1.27mm

Connections:
HUB_SOA: R102.1, U21.2 (IN1-), U21.5 (IN2+); also elsewhere on the board
HUB_SOA_HI: Q21.1 (G), R104.1, U21.7 (OUT2)
HUB_SOA_LO: Q20.1 (G), R103.1, U21.1 (OUT1)
HUB_SOB: R105.1, U22.2 (IN1-), U22.5 (IN2+); also elsewhere on the board
HUB_SOB_HI: Q23.1 (G), R107.1, U22.7 (OUT2)
HUB_SOB_LO: Q22.1 (G), R106.1, U22.1 (OUT1)
HUB_SOC: R108.1, U23.2 (IN1-), U23.5 (IN2+); also elsewhere on the board
HUB_SOC_HI: Q25.1 (G), R110.1, U23.7 (OUT2)
HUB_SOC_LO: Q24.1 (G), R109.1, U23.1 (OUT1)
LOGIC3V3_EXT: C70.1, C71.1, C72.1, U21.8 (VCC), U22.8 (VCC), U23.8 (VCC); also elsewhere on the board
OC_HIGH_REF: U21.6 (IN2-), U22.6 (IN2-), U23.6 (IN2-); also elsewhere on the board
OC_LOW_REF: U21.3 (IN1+), U22.3 (IN1+), U23.3 (IN1+); also elsewhere on the board
OC_OK: Q20.3 (D), Q21.3 (D), Q22.3 (D), Q23.3 (D), Q24.3 (D), Q25.3 (D); also elsewhere on the board
PGND: C70.2, C71.2, C72.2, Q20.2 (S), Q21.2 (S), Q22.2 (S), Q23.2 (S), Q24.2 (S), Q25.2 (S), R102.2, R103.2, R104.2, R105.2, R106.2, R107.2, R108.2, R109.2, R110.2, U21.4 (GND), U22.4 (GND), U23.4 (GND); also elsewhere on the board

Notes on the sheet:
TLV3202IDR: positive SP-SN current DECREASES SO. Lower and upper limits both latch off.
No PWM blanking added. Low-side blind intervals remain; DRV VDS OCP contract mandatory.
Push-pull comparators drive separate sink FETs; outputs are NOT shorted together.
Open SO pulls down; stuck midpoint / shunt open / power-loss safety NOT proven. UNSAFE DRAFT.

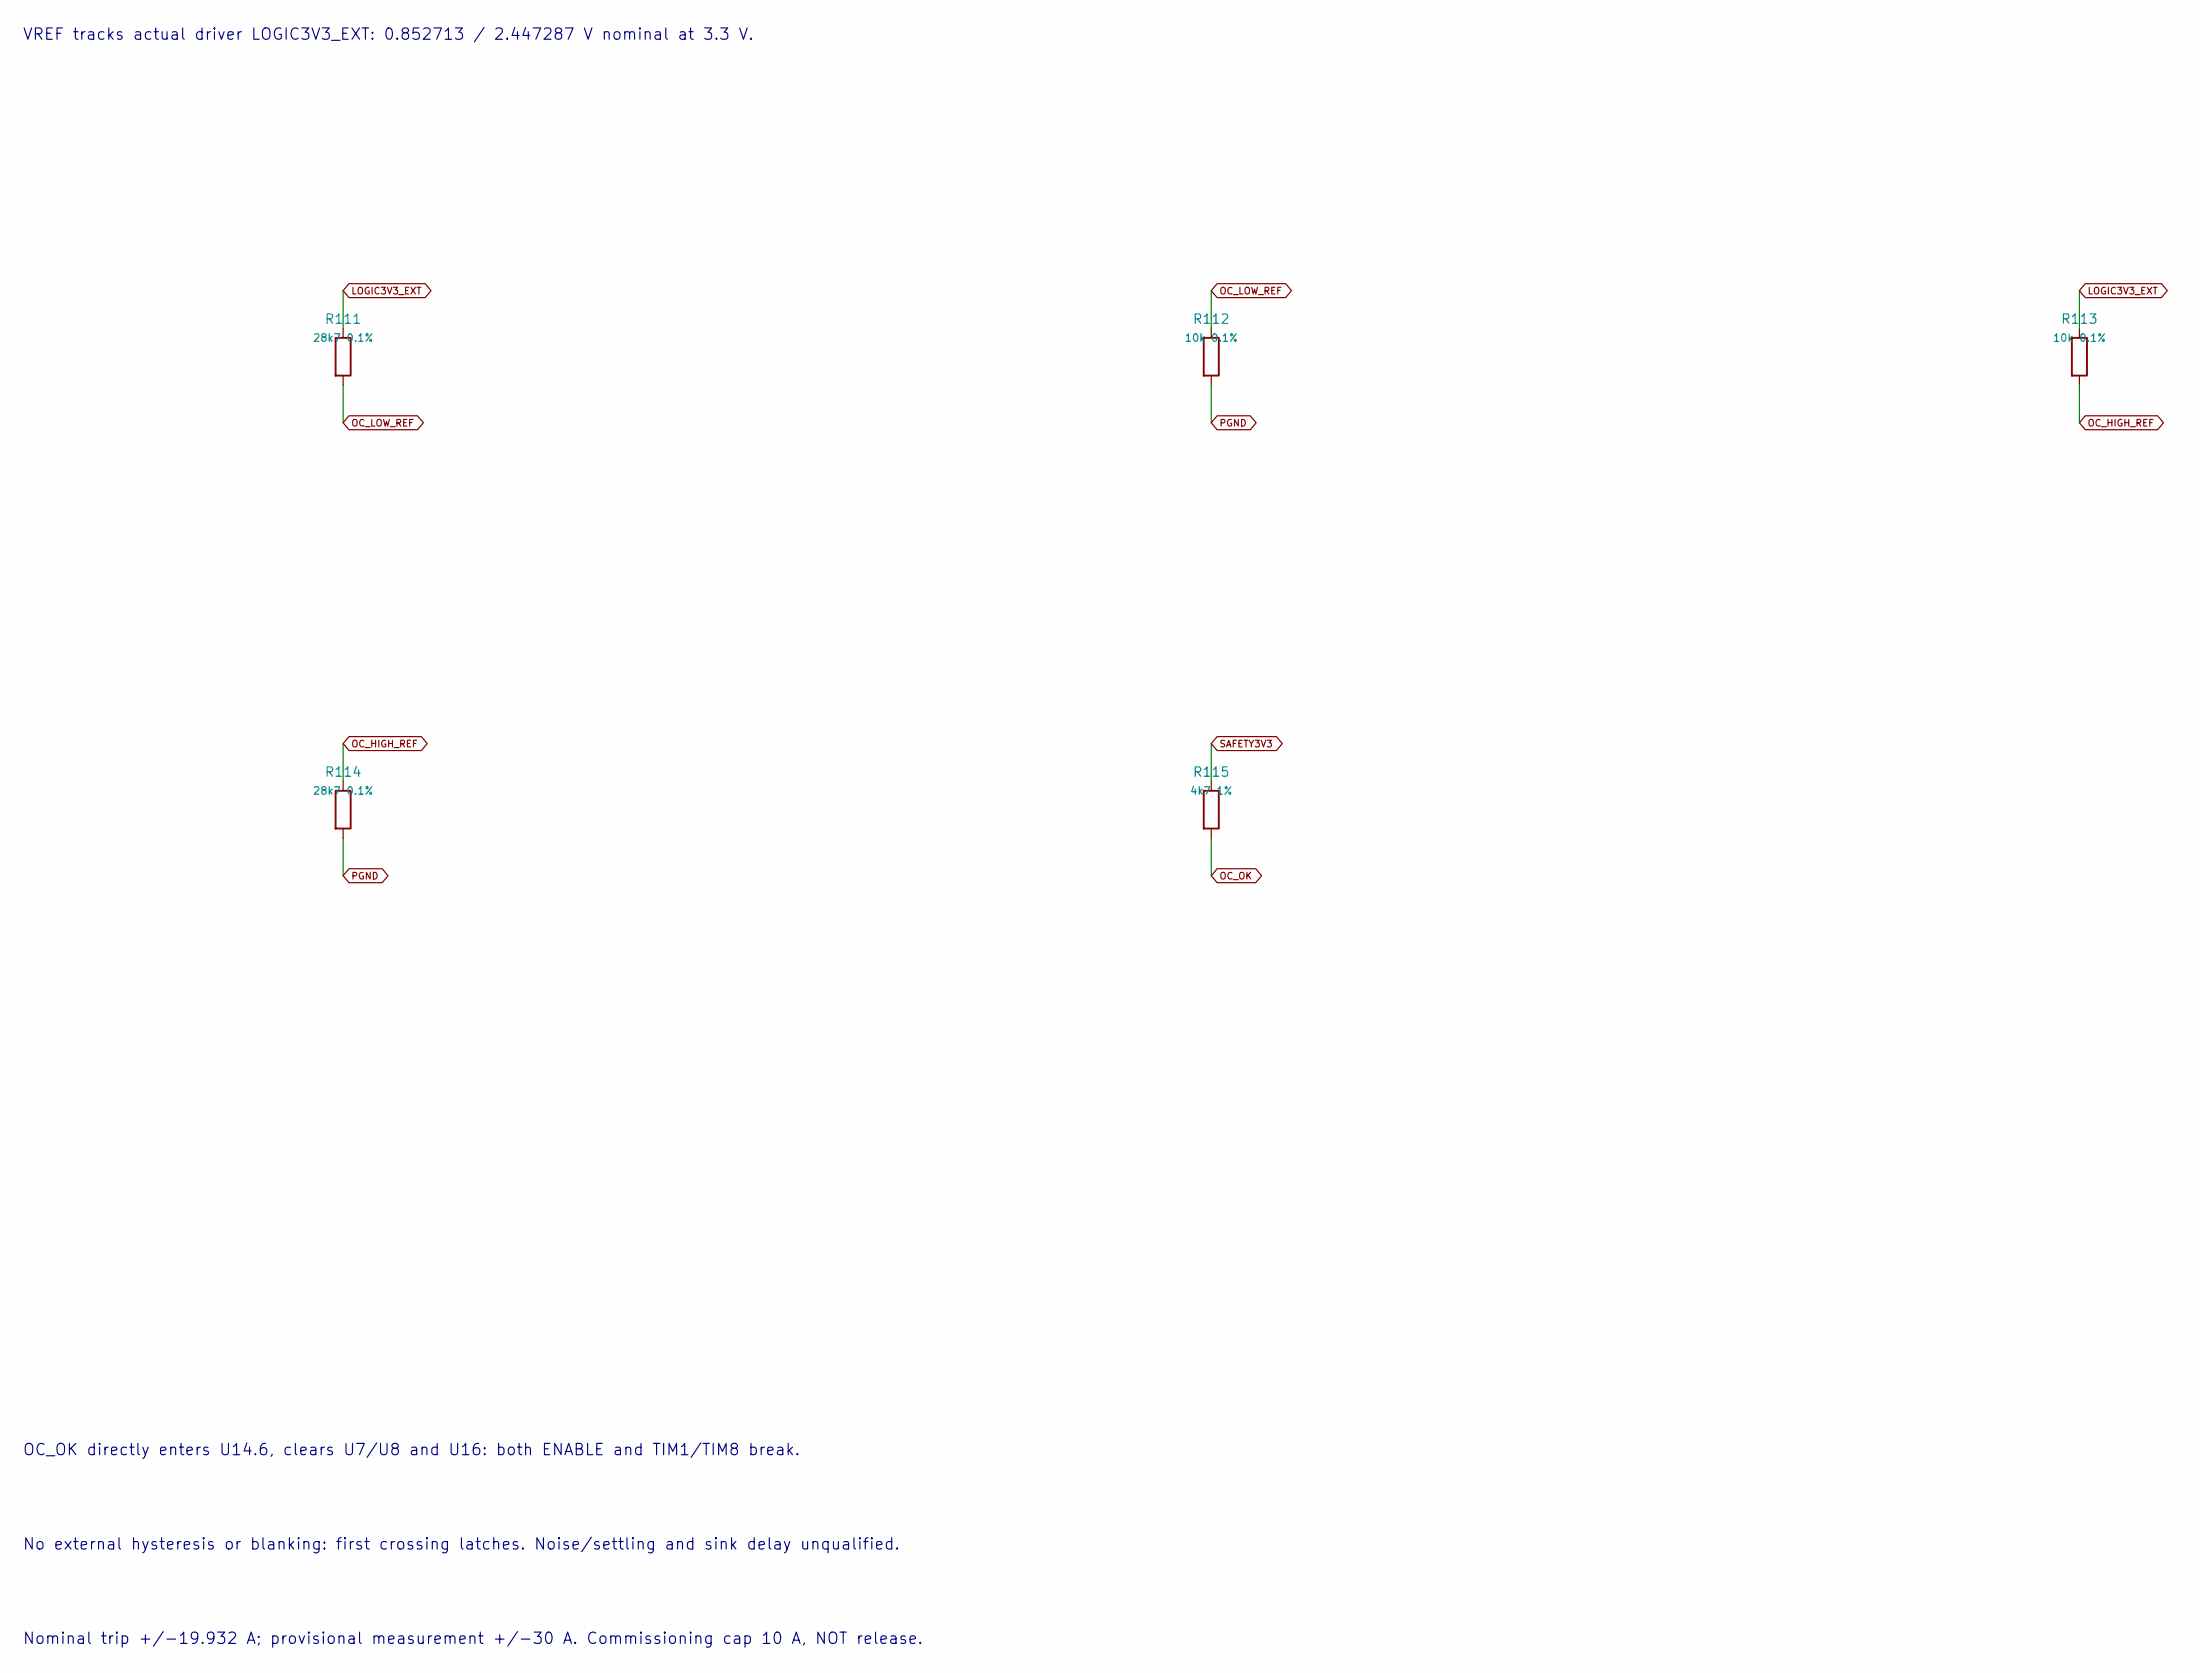
[picture p62: schematic fast-oc-reference.kicad_sch, Ratiometric OC window and wired sink fault]

Parts:
R111, R114: 28k7 0.1%; R_0805_2012Metric
R112, R113: 10k 0.1%; R_0805_2012Metric
R115: 4k7 1%; R_0805_2012Metric

Connections:
LOGIC3V3_EXT: R111.1, R113.1; also elsewhere on the board
OC_HIGH_REF: R113.2, R114.1; also elsewhere on the board
OC_LOW_REF: R111.2, R112.1; also elsewhere on the board
OC_OK: R115.2; also elsewhere on the board
PGND: R112.2, R114.2; also elsewhere on the board
SAFETY3V3: R115.1; also elsewhere on the board

Notes on the sheet:
VREF tracks actual driver LOGIC3V3_EXT: 0.852713 / 2.447287 V nominal at 3.3 V.
OC_OK directly enters U14.6, clears U7/U8 and U16: both ENABLE and TIM1/TIM8 break.
No external hysteresis or blanking: first crossing latches. Noise/settling and sink delay unqualified.
Nominal trip +/-19.932 A; provisional measurement +/-30 A. Commissioning cap 10 A, NOT release.

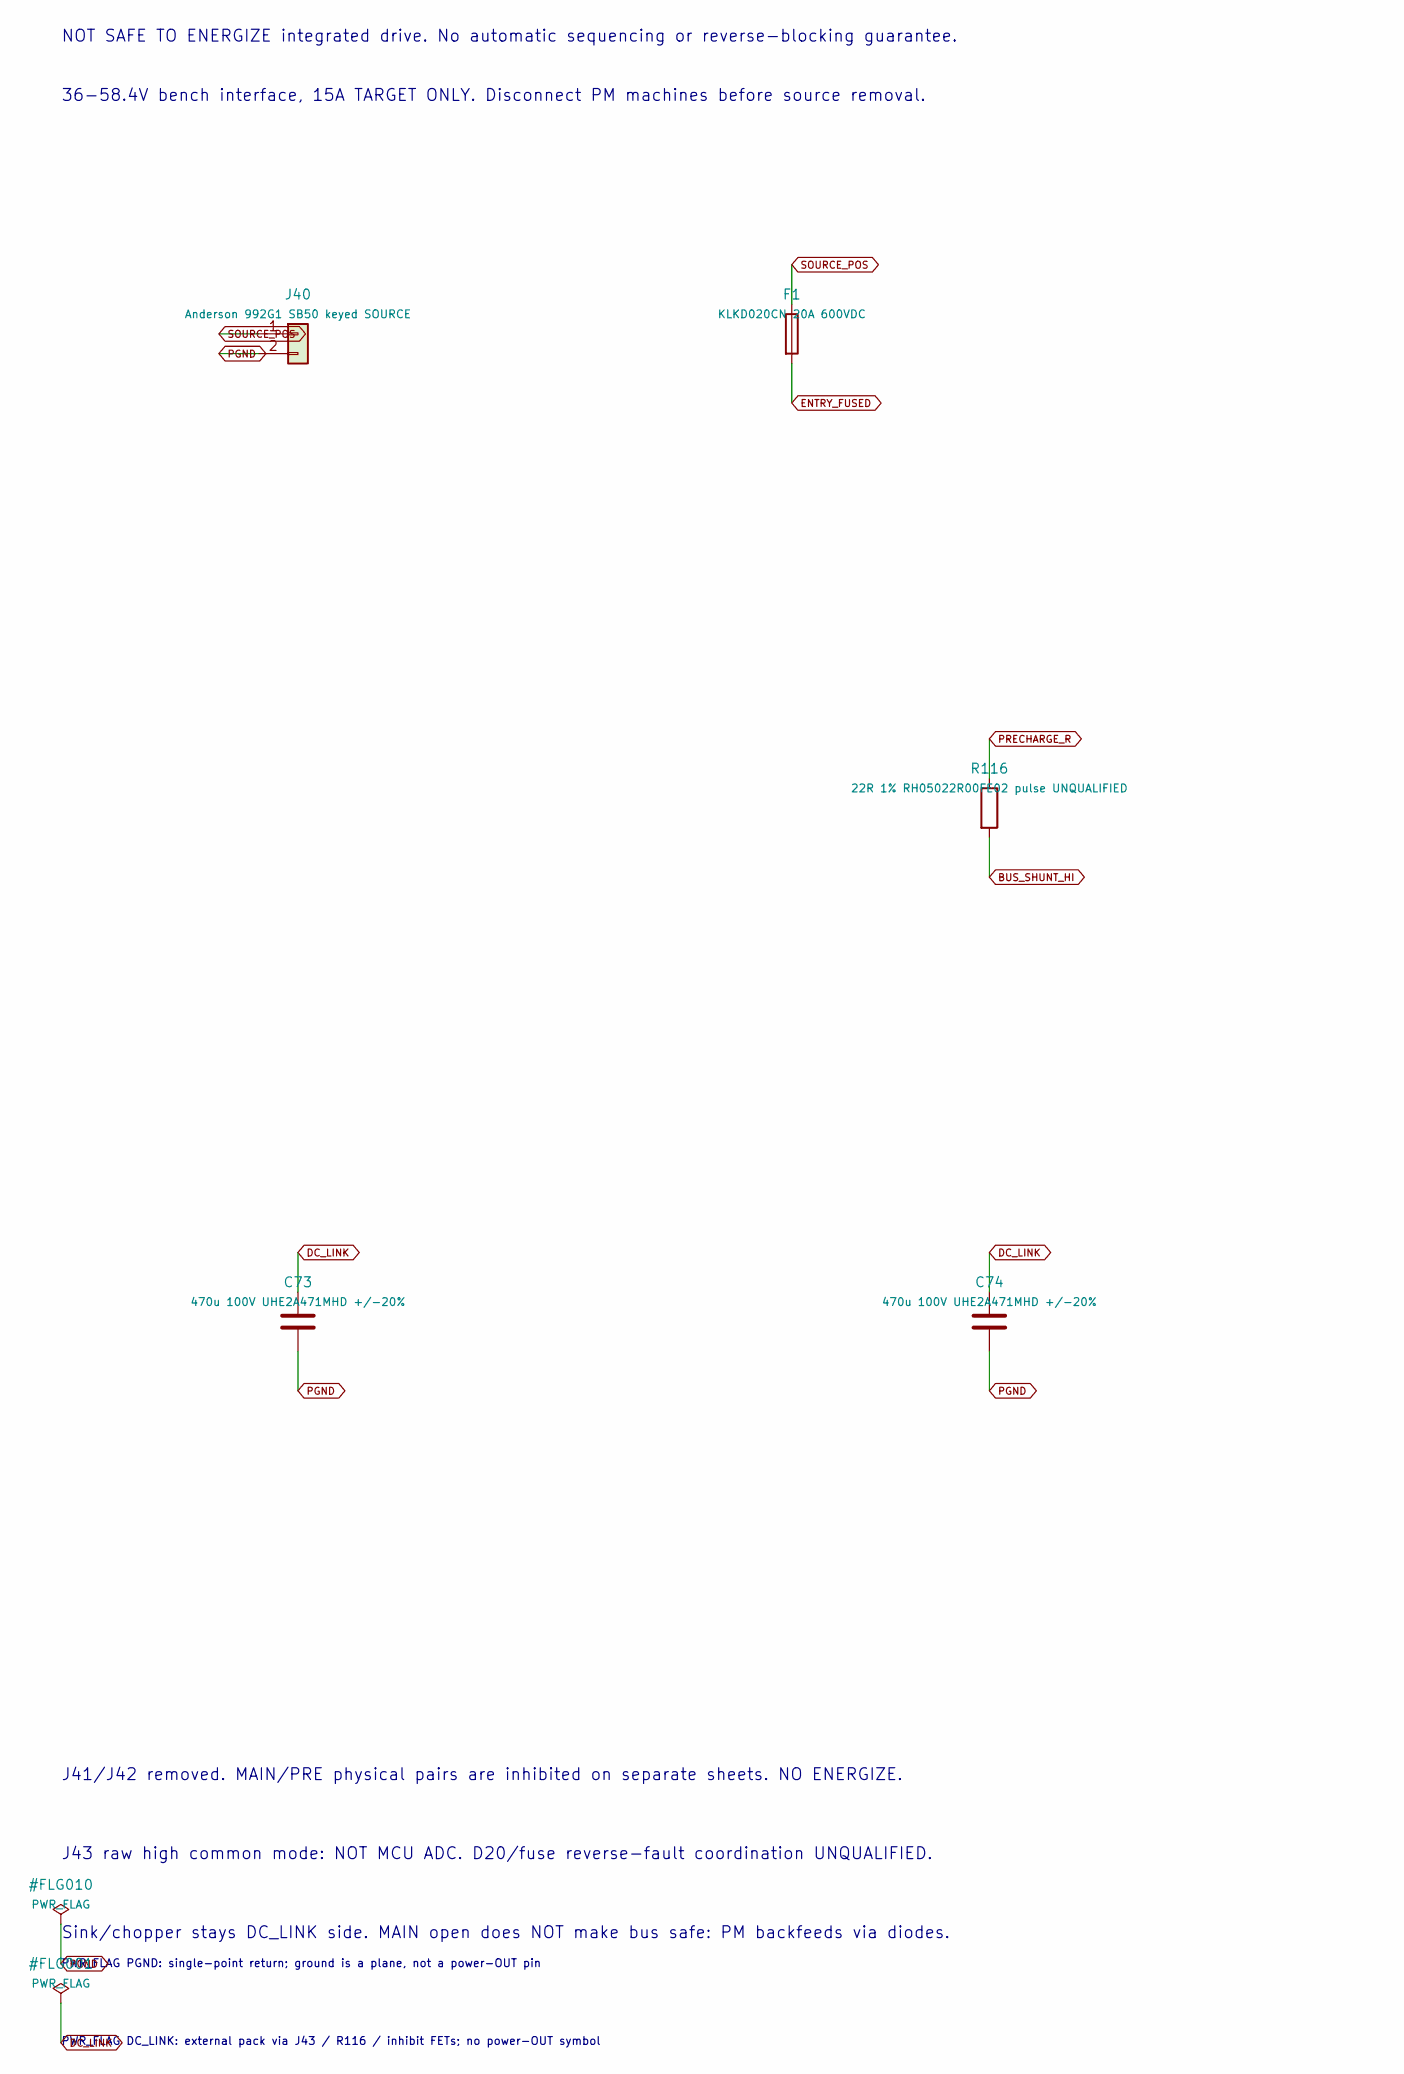
[picture p63: schematic dc-entry.kicad_sch, Bounded bench DC entry - active pairs inhibited, part in row 1, column 1]

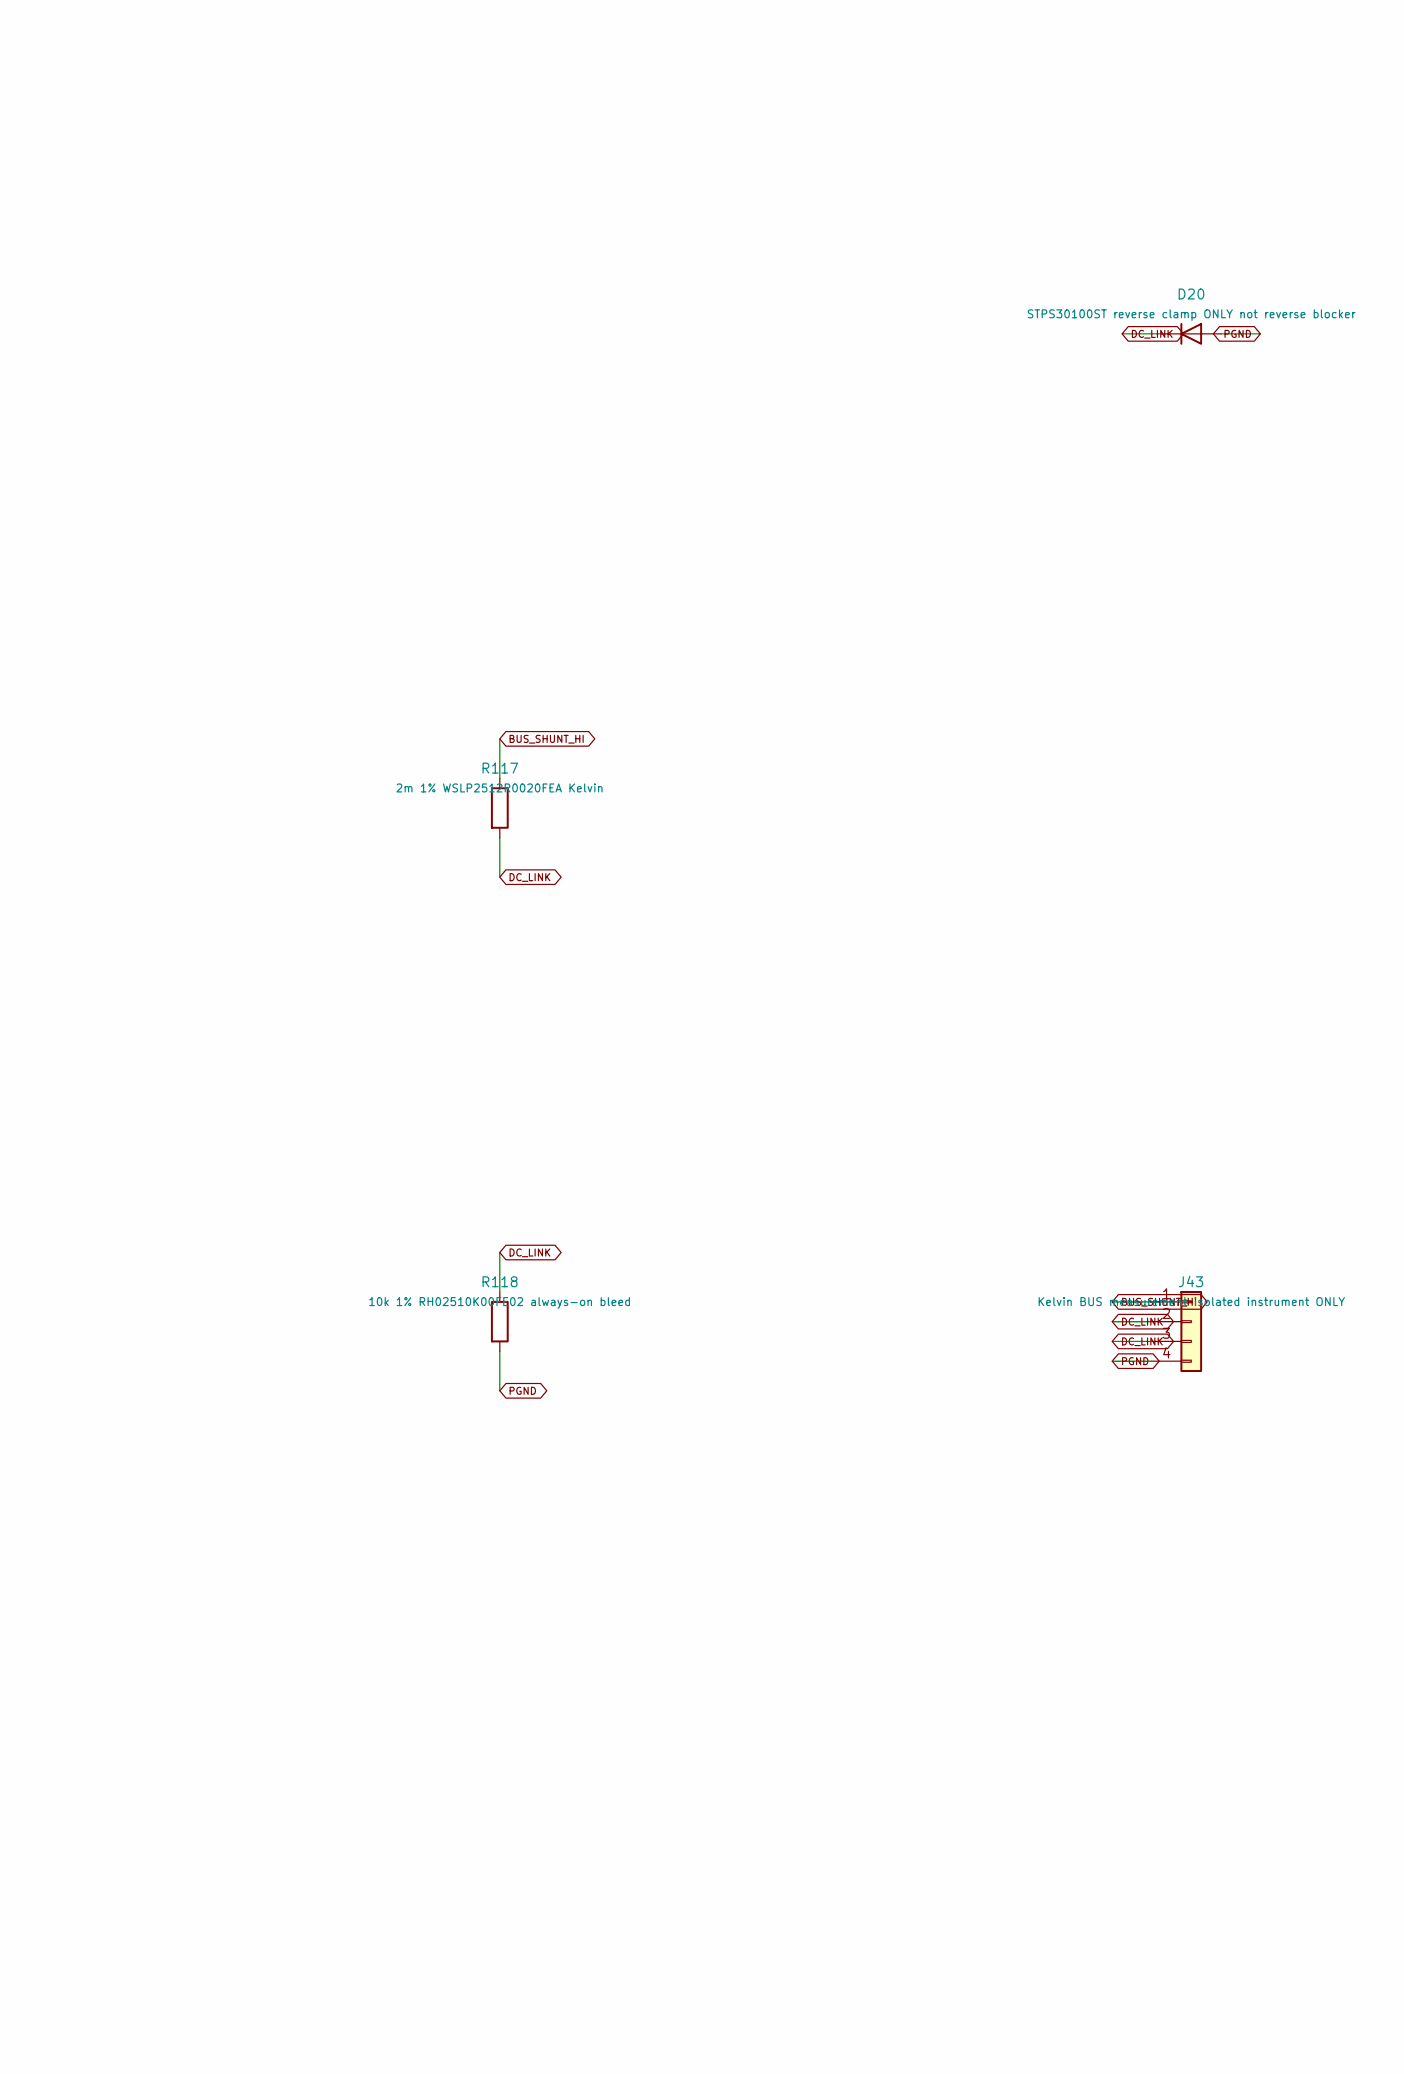
[picture p64: schematic dc-entry.kicad_sch, Bounded bench DC entry - active pairs inhibited, part in row 1, column 2]

Parts:
C73, C74: 470u 100V UHE2A471MHD +/-20%; CP_Radial_D16.0mm_P7.50mm
D20: STPS30100ST reverse clamp ONLY not reverse blocker; TO-277A
F1: KLKD020CN 20A 600VDC; Fuseholder_Littelfuse_100_series_5x20mm
J40: Anderson 992G1 SB50 keyed SOURCE; AMASS_XT60-F_1x02_P7.20mm_Vertical
J43: Kelvin BUS measurement isolated instrument ONLY; PinHeader_1x04_P2.54mm_Vertical
R116: 22R 1% RH05022R00FE02 pulse UNQUALIFIED; R_Axial_DIN0207_L6.3mm_D2.5mm_P7.62mm_Horizontal
R117: 2m 1% WSLP2512R0020FEA Kelvin; R_2512_6332Metric
R118: 10k 1% RH02510K00FE02 always-on bleed; R_0805_2012Metric

Connections:
BUS_SHUNT_HI: J43.1, R116.2, R117.1; also elsewhere on the board
DC_LINK: C73.1, C74.1, D20.1 (K), J43.2, J43.3, R117.2, R118.1; also elsewhere on the board
ENTRY_FUSED: F1.2; also elsewhere on the board
PGND: C73.2, C74.2, D20.2 (A), J40.2, J43.4, R118.2; also elsewhere on the board
PRECHARGE_R: R116.1; also elsewhere on the board
SOURCE_POS: F1.1, J40.1

Notes on the sheet:
NOT SAFE TO ENERGIZE integrated drive. No automatic sequencing or reverse-blocking guarantee.
36-58.4V bench interface, 15A TARGET ONLY. Disconnect PM machines before source removal.
J41/J42 removed. MAIN/PRE physical pairs are inhibited on separate sheets. NO ENERGIZE.
J43 raw high common mode: NOT MCU ADC. D20/fuse reverse-fault coordination UNQUALIFIED.
Sink/chopper stays DC_LINK side. MAIN open does NOT make bus safe: PM backfeeds via diodes.
PWR_FLAG DC_LINK: external pack via J43 / R116 / inhibit FETs; no power-OUT symbol
PWR_FLAG PGND: single-point return; ground is a plane, not a power-OUT pin

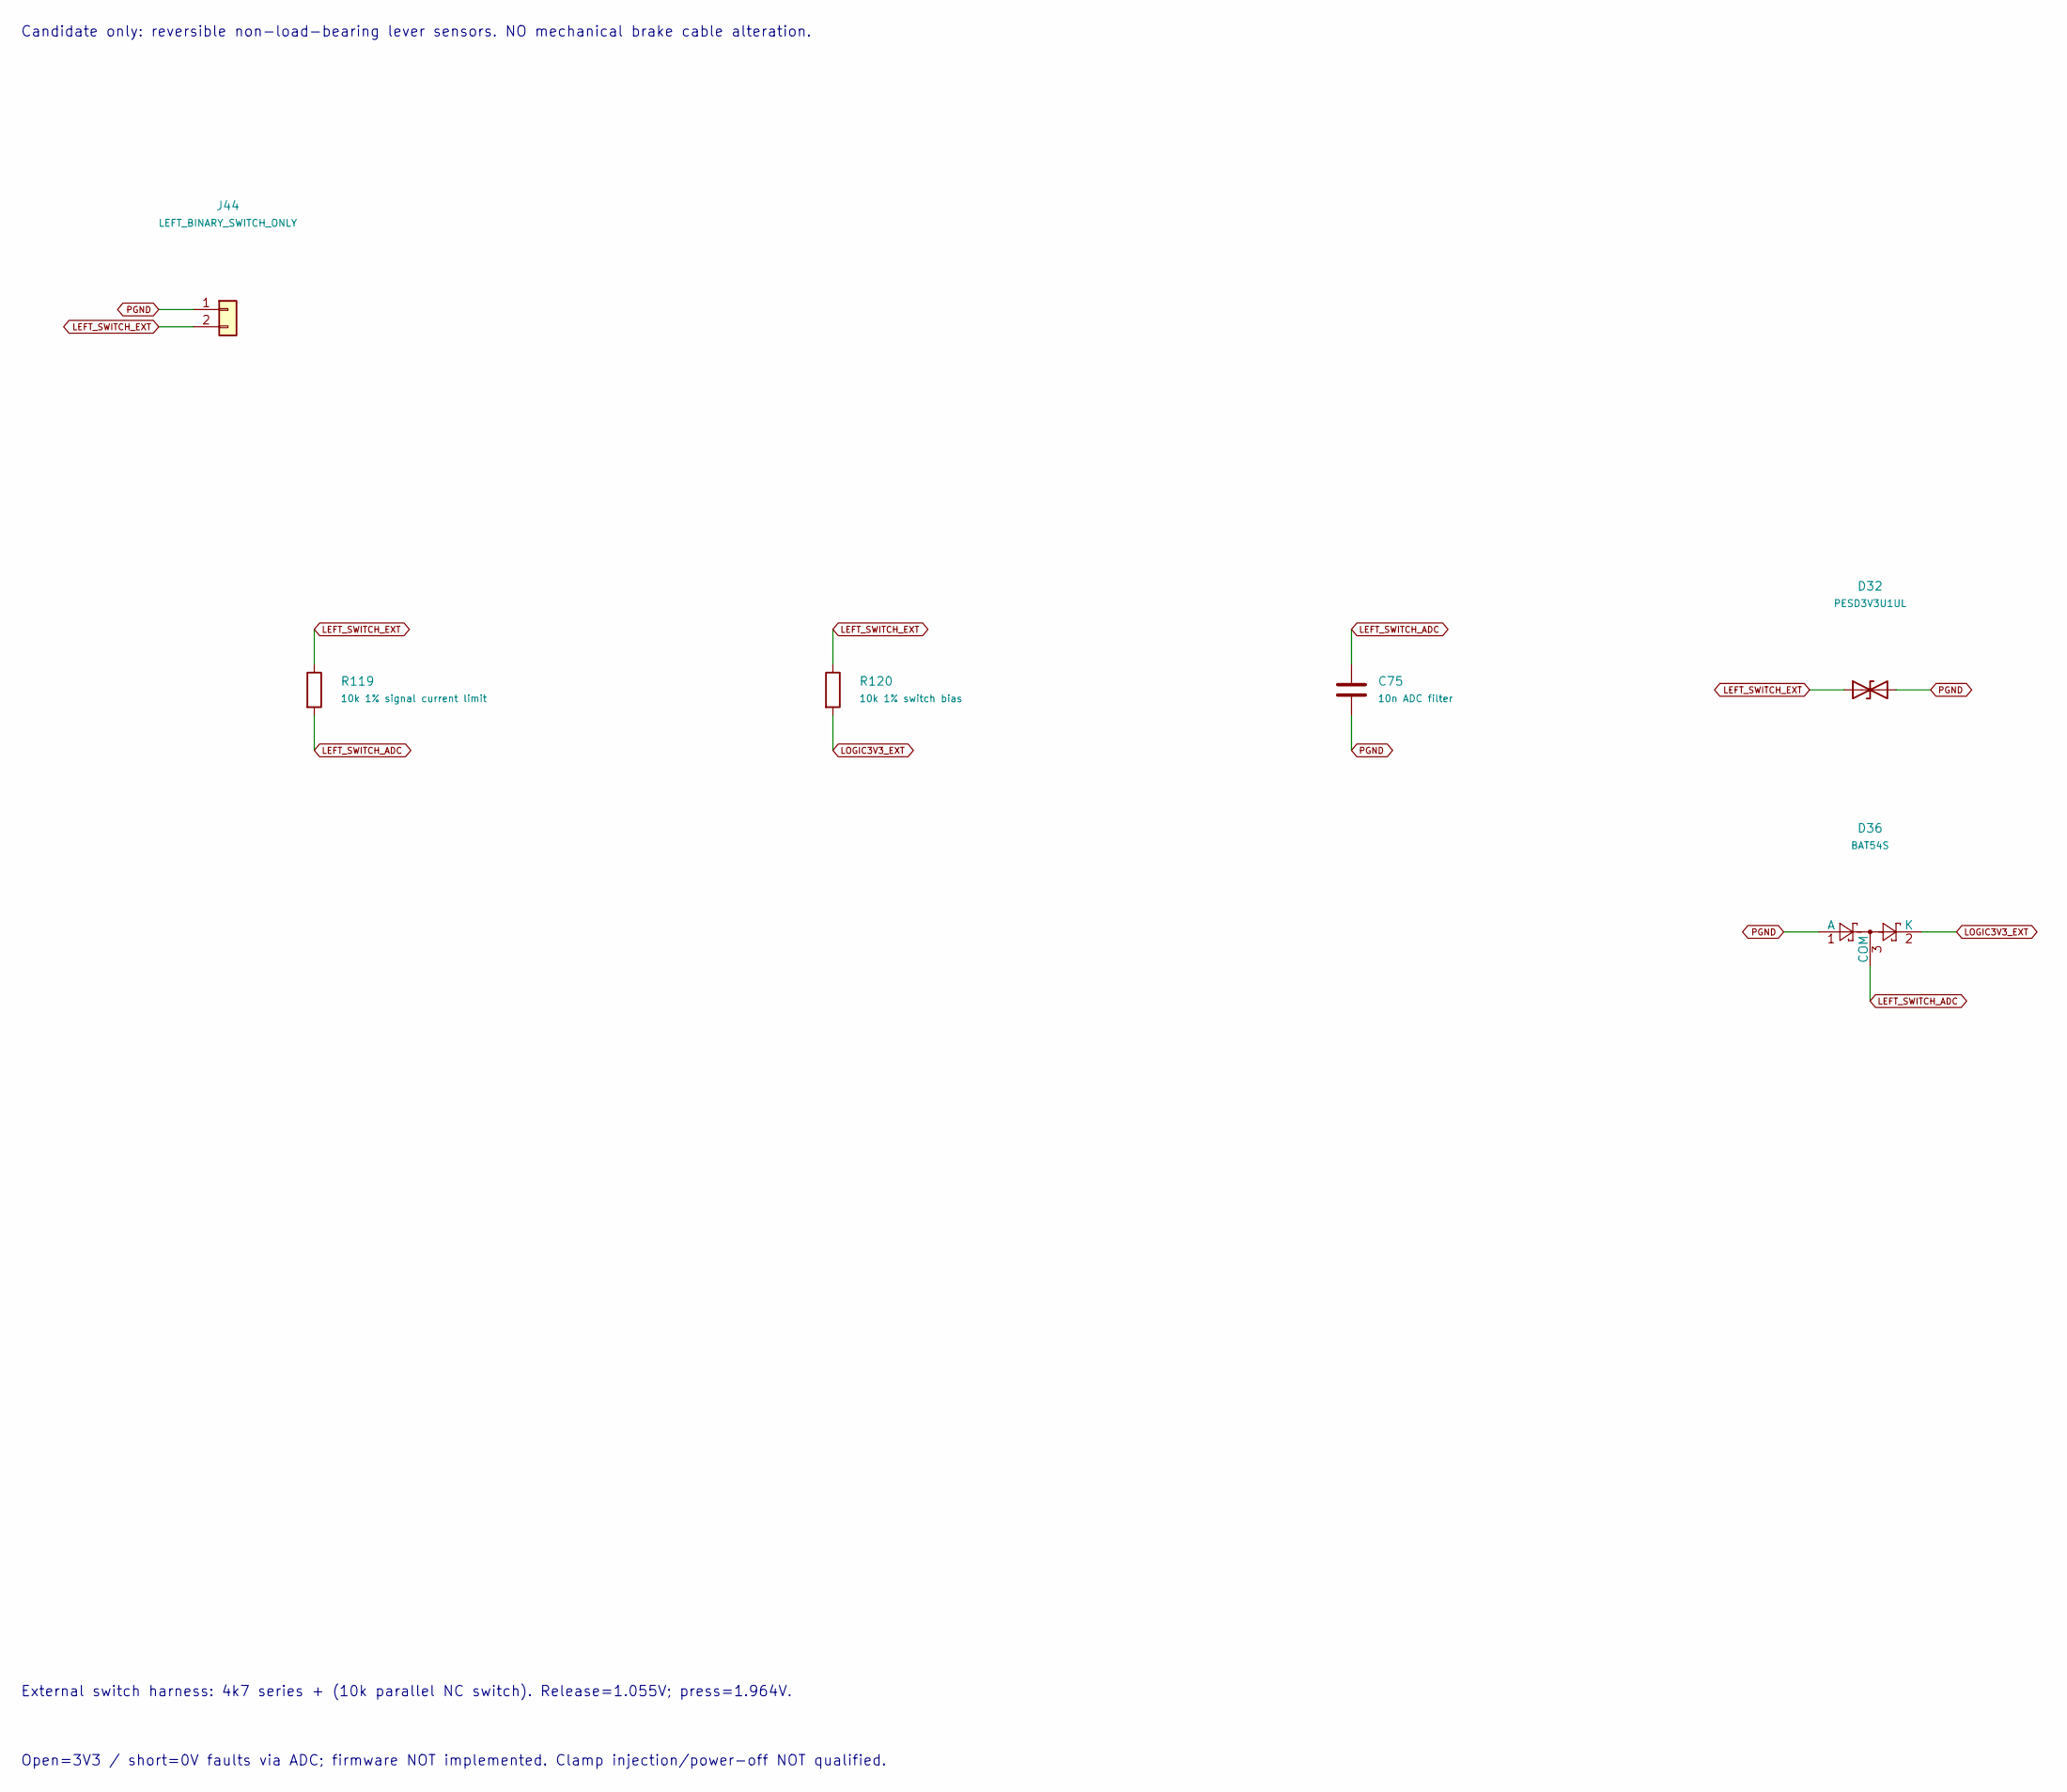
[picture p65: schematic brake-intent-left.kicad_sch, LEFT supervised binary brake interface]

Parts:
C75: 10n ADC filter; C_0805_2012Metric
D32: PESD3V3U1UL; D_SOD-882
D36: BAT54S; SOT-23
J44: LEFT_BINARY_SWITCH_ONLY; SW_SPST_TL3305A
R119: 10k 1% signal current limit; R_0805_2012Metric
R120: 10k 1% switch bias; R_0805_2012Metric

Connections:
LEFT_SWITCH_ADC: C75.1, D36.3 (COM), R119.2; also elsewhere on the board
LEFT_SWITCH_EXT: D32.1 (A1), J44.2, R119.1, R120.1; also elsewhere on the board
LOGIC3V3_EXT: D36.2 (K), R120.2; also elsewhere on the board
PGND: C75.2, D32.2 (A2), D36.1 (A), J44.1; also elsewhere on the board

Notes on the sheet:
Candidate only: reversible non-load-bearing lever sensors. NO mechanical brake cable alteration.
External switch harness: 4k7 series + (10k parallel NC switch). Release=1.055V; press=1.964V.
Open=3V3 / short=0V faults via ADC; firmware NOT implemented. Clamp injection/power-off NOT qualified.
