felixfelix-bot/cycle-without-chain/hardware/powerboard-reva/powerboard-reva.kicad_pcb

## KiCad design hardware/powerboard-reva/powerboard-reva.kicad_pcb (continued)

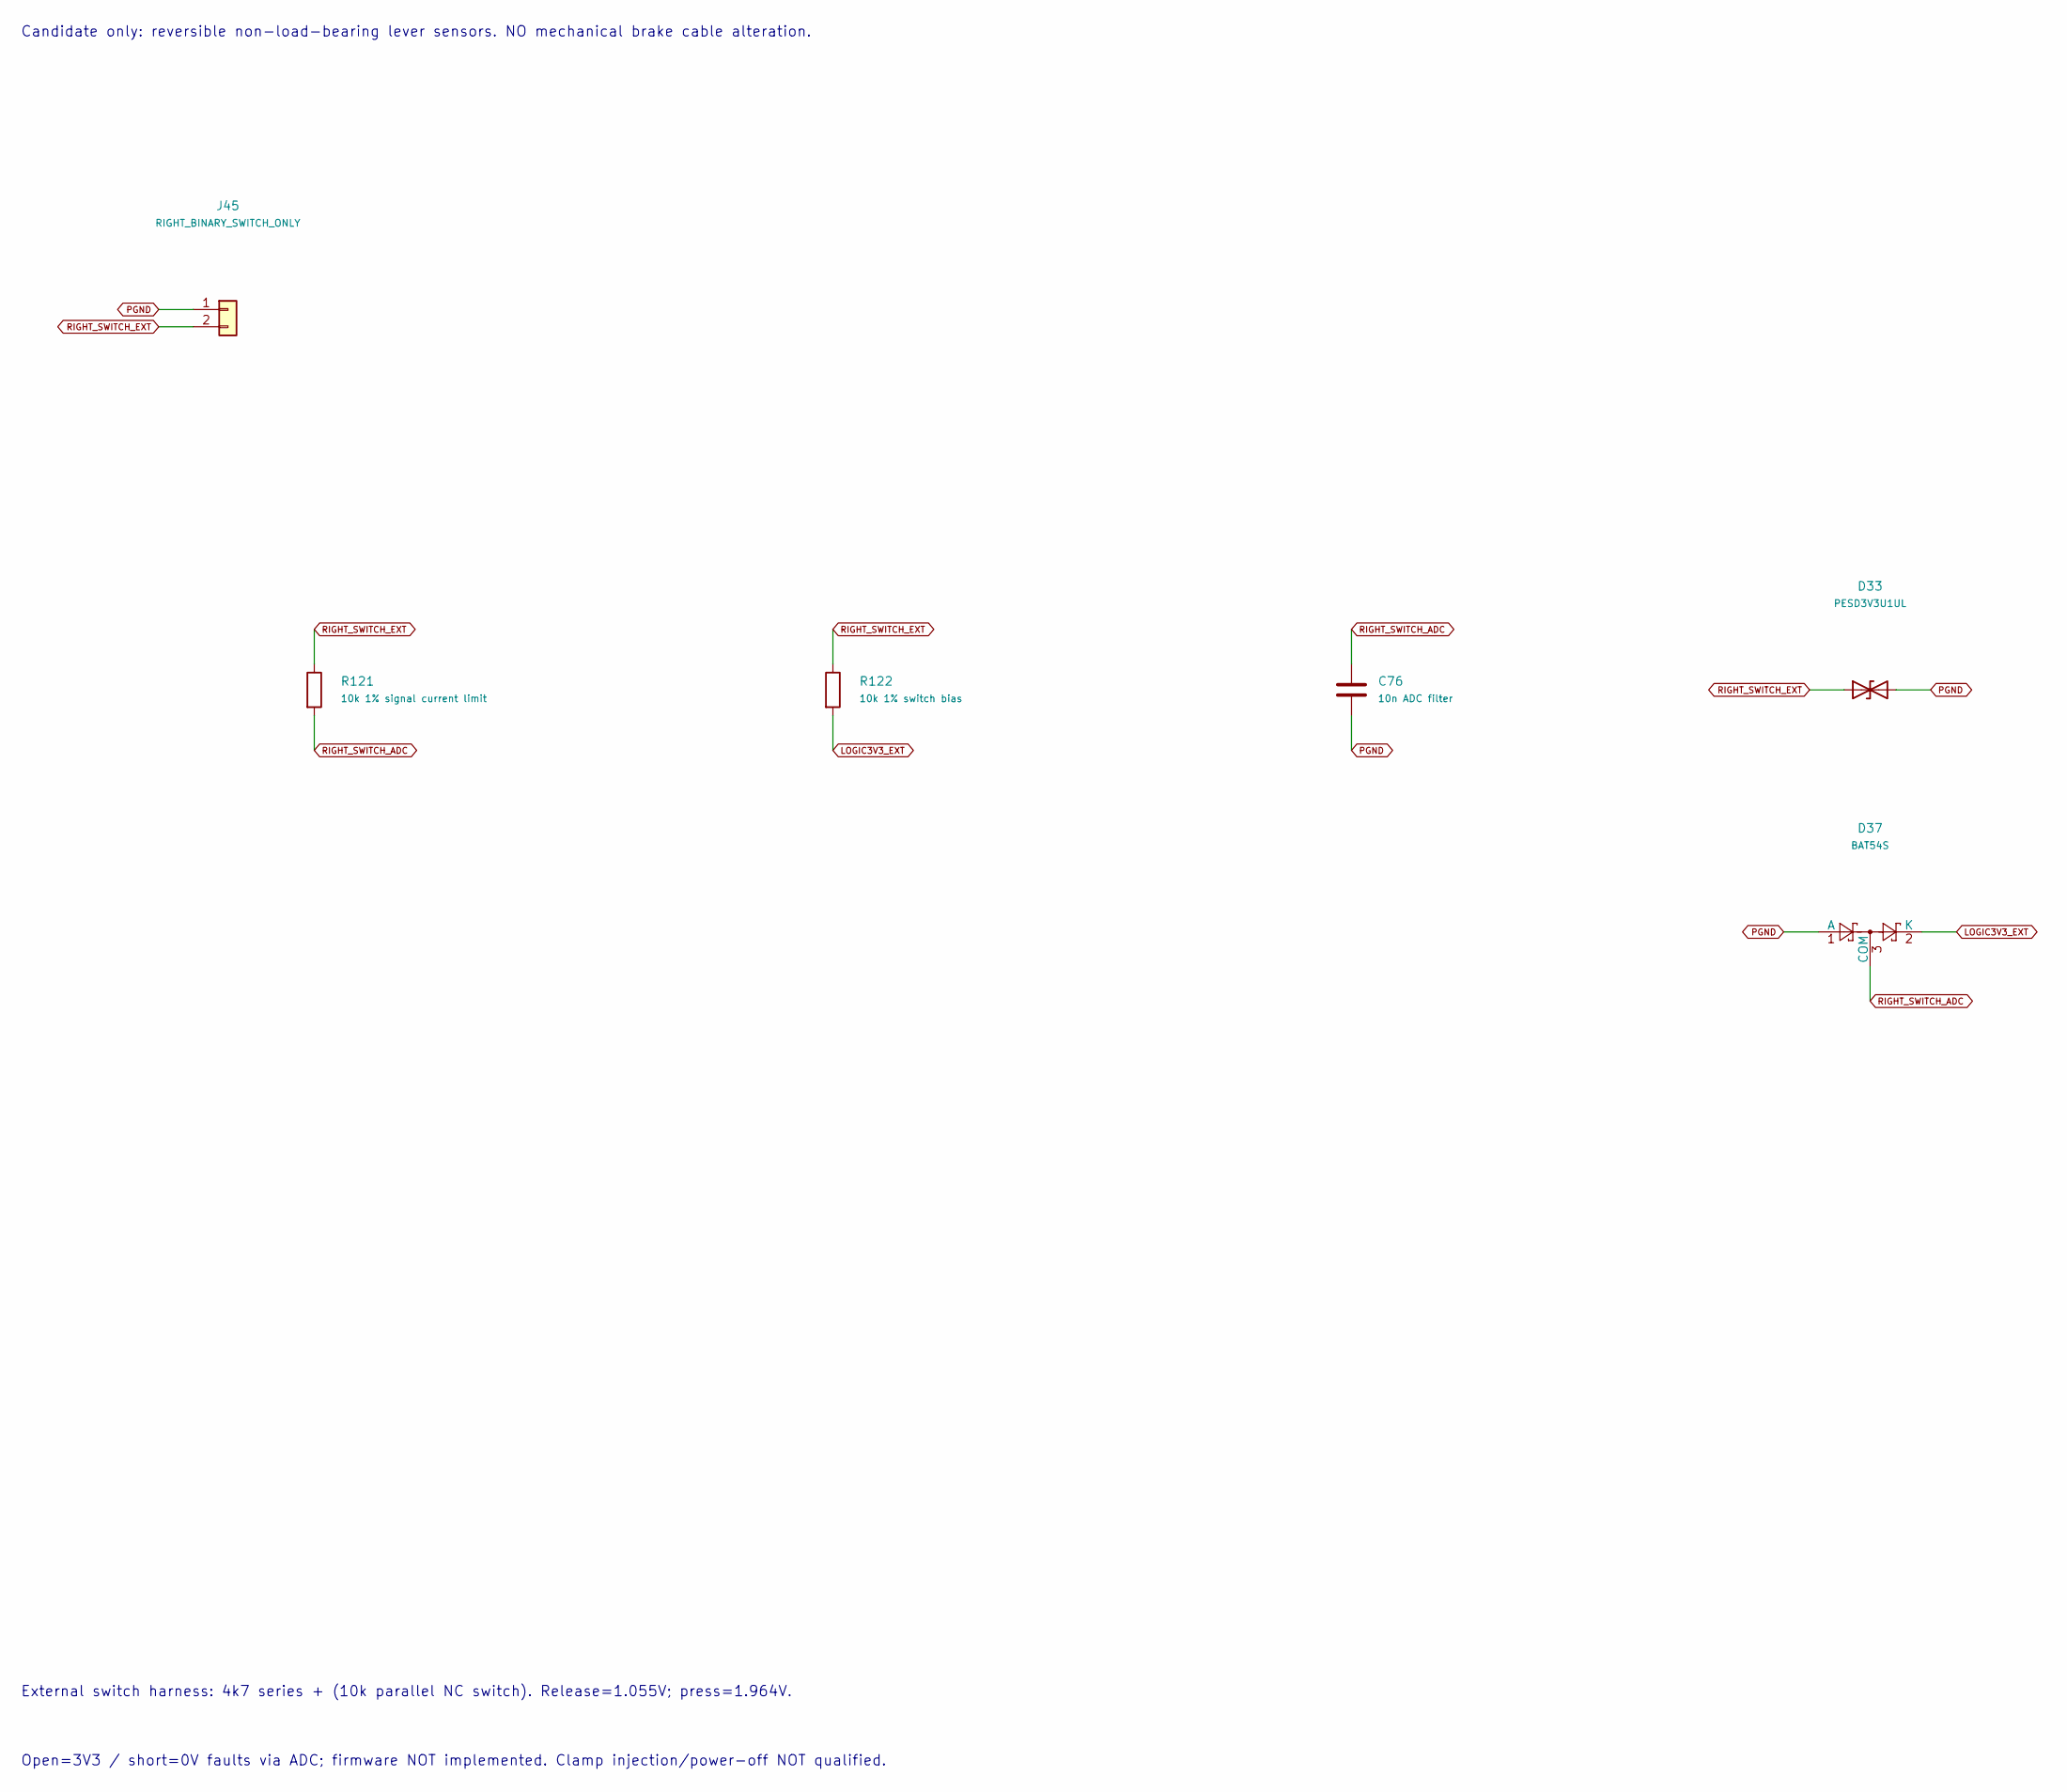
[picture p66: schematic brake-intent-right.kicad_sch, RIGHT supervised binary brake interface]

Parts:
C76: 10n ADC filter; C_0805_2012Metric
D33: PESD3V3U1UL; D_SOD-882
D37: BAT54S; SOT-23
J45: RIGHT_BINARY_SWITCH_ONLY; SW_SPST_TL3305A
R121: 10k 1% signal current limit; R_0805_2012Metric
R122: 10k 1% switch bias; R_0805_2012Metric

Connections:
LOGIC3V3_EXT: D37.2 (K), R122.2; also elsewhere on the board
PGND: C76.2, D33.2 (A2), D37.1 (A), J45.1; also elsewhere on the board
RIGHT_SWITCH_ADC: C76.1, D37.3 (COM), R121.2; also elsewhere on the board
RIGHT_SWITCH_EXT: D33.1 (A1), J45.2, R121.1, R122.1; also elsewhere on the board

Notes on the sheet:
Candidate only: reversible non-load-bearing lever sensors. NO mechanical brake cable alteration.
External switch harness: 4k7 series + (10k parallel NC switch). Release=1.055V; press=1.964V.
Open=3V3 / short=0V faults via ADC; firmware NOT implemented. Clamp injection/power-off NOT qualified.

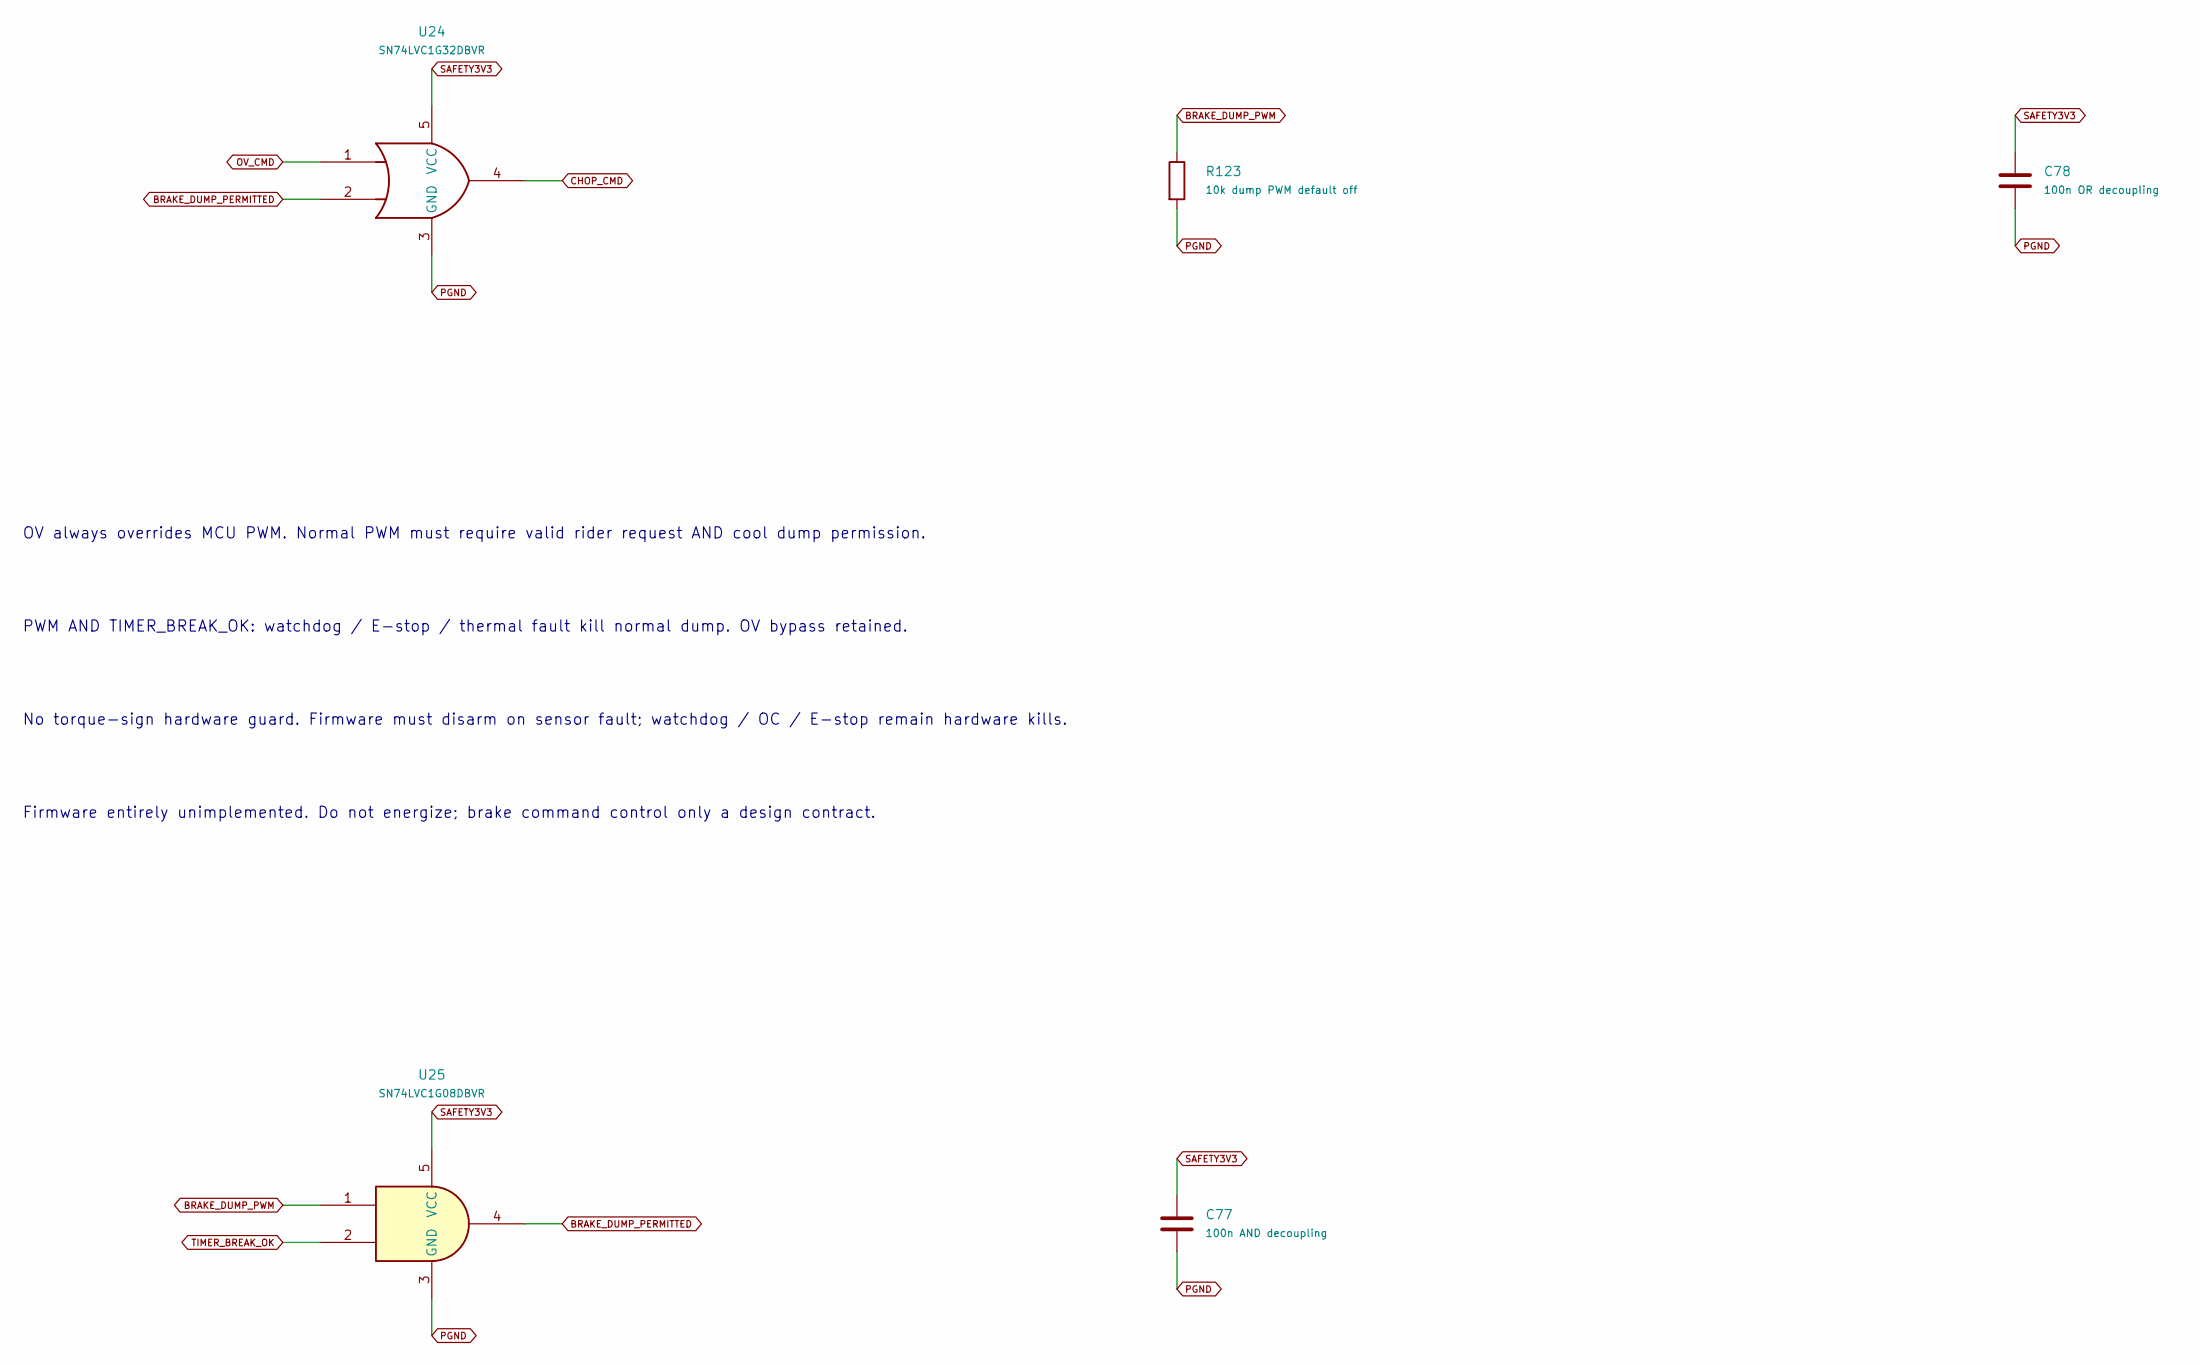
[picture p67: schematic brake-dump-command.kicad_sch, Rider dump PWM OR independent emergency overvoltage]

Parts:
C77: 100n AND decoupling; C_0805_2012Metric
C78: 100n OR decoupling; C_0805_2012Metric
R123: 10k dump PWM default off; R_0805_2012Metric
U24: SN74LVC1G32DBVR; SOT-23-5
U25: SN74LVC1G08DBVR; SOT-23-5

Connections:
BRAKE_DUMP_PERMITTED: U24.2, U25.4
BRAKE_DUMP_PWM: R123.1, U25.1; also elsewhere on the board
CHOP_CMD: U24.4; also elsewhere on the board
OV_CMD: U24.1; also elsewhere on the board
PGND: C77.2, C78.2, R123.2, U24.3 (GND), U25.3 (GND); also elsewhere on the board
SAFETY3V3: C77.1, C78.1, U24.5 (VCC), U25.5 (VCC); also elsewhere on the board
TIMER_BREAK_OK: U25.2; also elsewhere on the board

Notes on the sheet:
OV always overrides MCU PWM. Normal PWM must require valid rider request AND cool dump permission.
PWM AND TIMER_BREAK_OK: watchdog / E-stop / thermal fault kill normal dump. OV bypass retained.
No torque-sign hardware guard. Firmware must disarm on sensor fault; watchdog / OC / E-stop remain hardware kills.
Firmware entirely unimplemented. Do not energize; brake command control only a design contract.

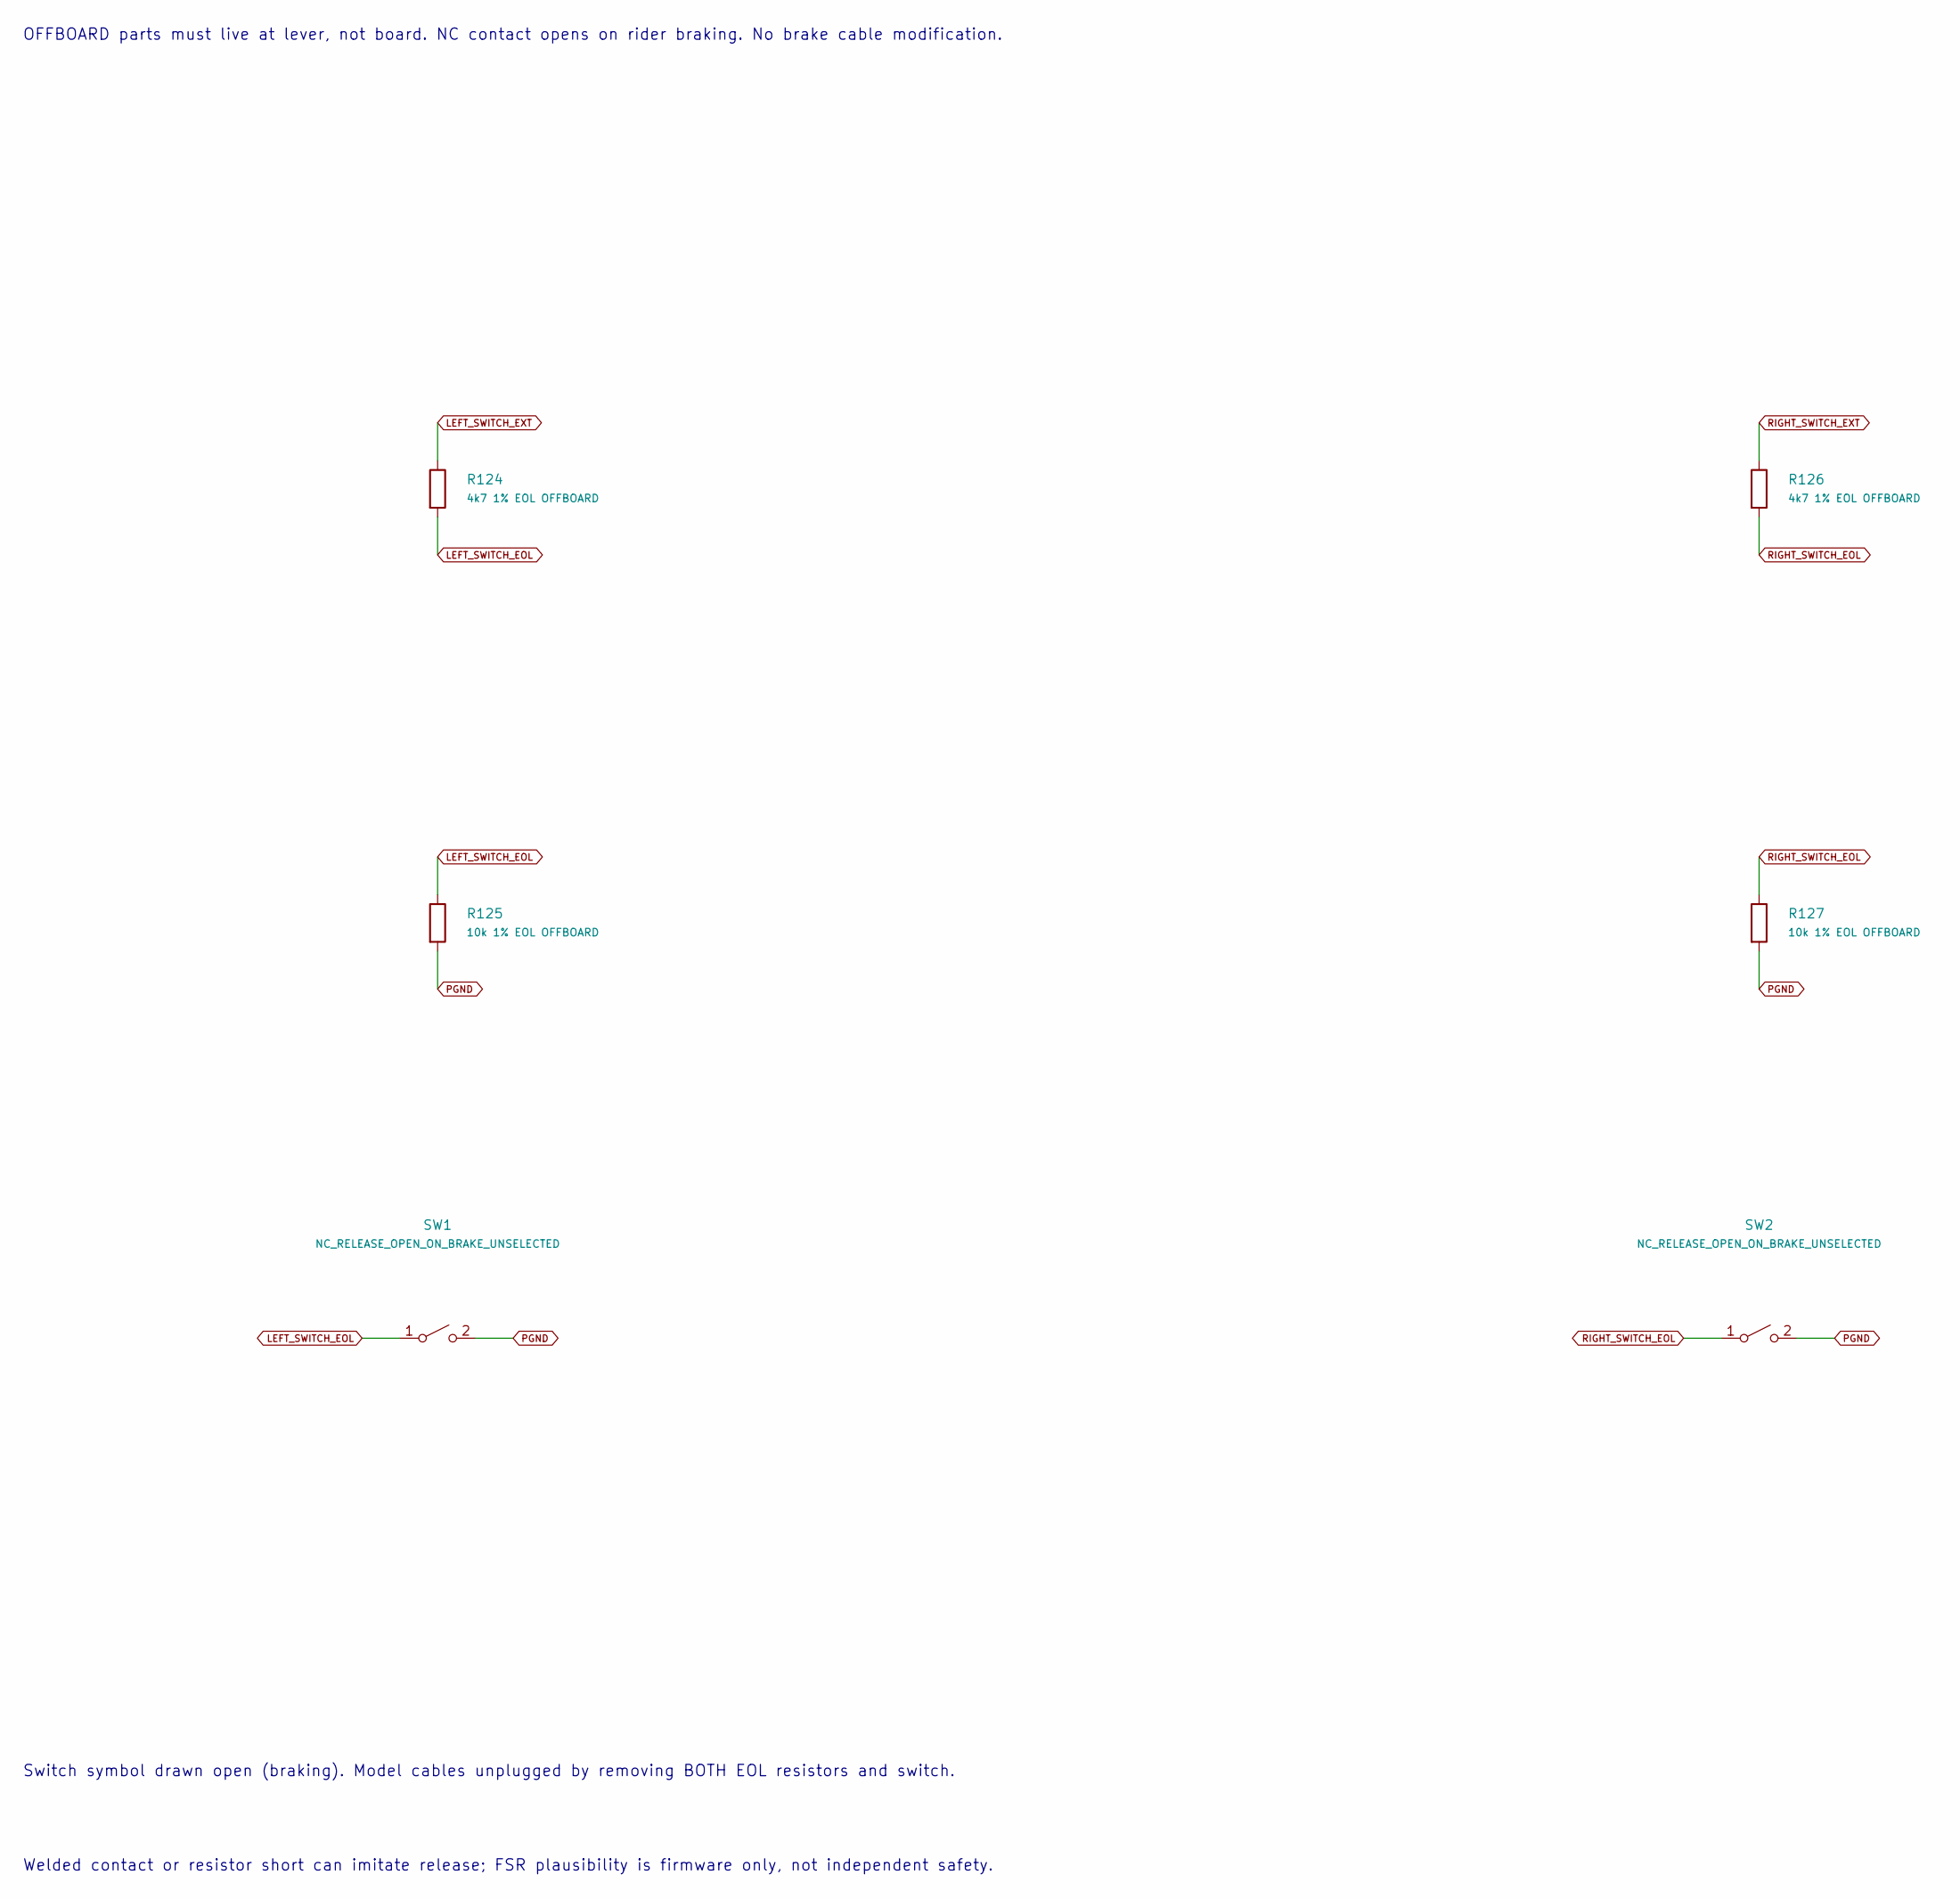
[picture p68: schematic brake-switch-harness.kicad_sch, OFFBOARD supervised switch end-of-line network - candidate]

Parts:
R124, R126: 4k7 1% EOL OFFBOARD; R_0805_2012Metric
R125, R127: 10k 1% EOL OFFBOARD; R_0805_2012Metric
SW1, SW2: NC_RELEASE_OPEN_ON_BRAKE_UNSELECTED; SW_SPST_TL3305A

Connections:
LEFT_SWITCH_EOL: R124.2, R125.1, SW1.1 (A)
LEFT_SWITCH_EXT: R124.1; also elsewhere on the board
PGND: R125.2, R127.2, SW1.2 (B), SW2.2 (B); also elsewhere on the board
RIGHT_SWITCH_EOL: R126.2, R127.1, SW2.1 (A)
RIGHT_SWITCH_EXT: R126.1; also elsewhere on the board

Notes on the sheet:
OFFBOARD parts must live at lever, not board. NC contact opens on rider braking. No brake cable modification.
Switch symbol drawn open (braking). Model cables unplugged by removing BOTH EOL resistors and switch.
Welded contact or resistor short can imitate release; FSR plausibility is firmware only, not independent safety.

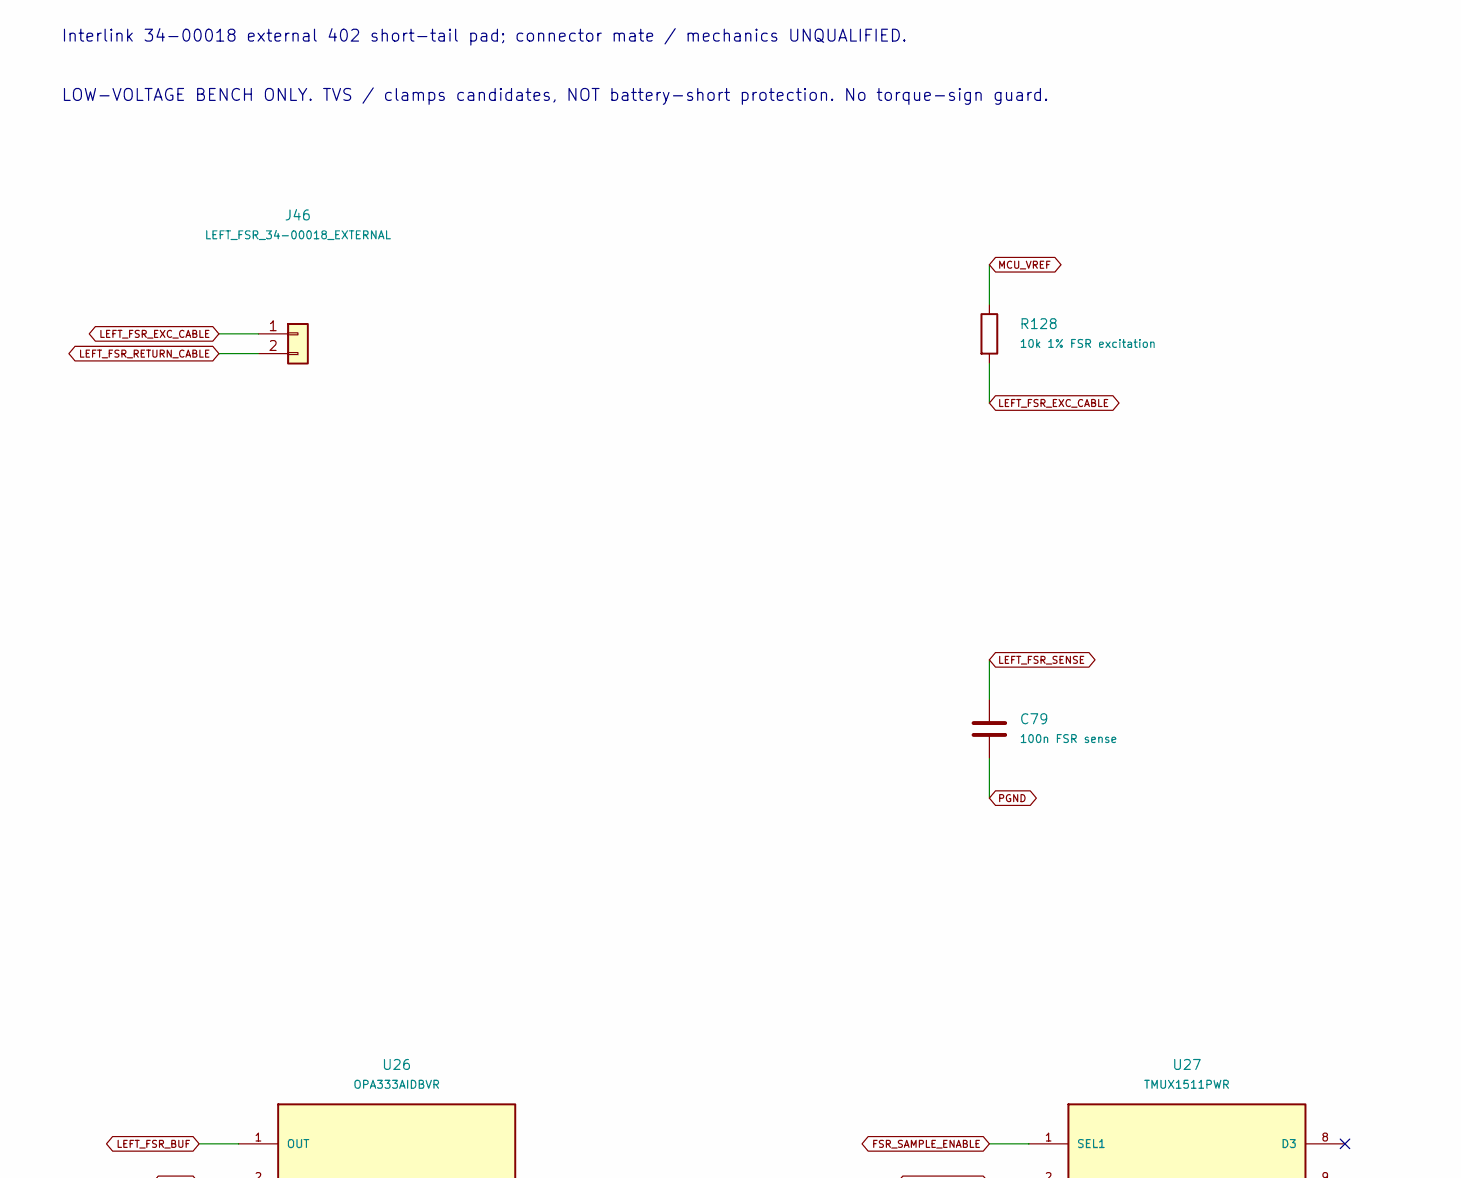
[picture p69: schematic fsr-left.kicad_sch, LEFT selected FSR low-voltage bench frontend, part in row 1, column 1]

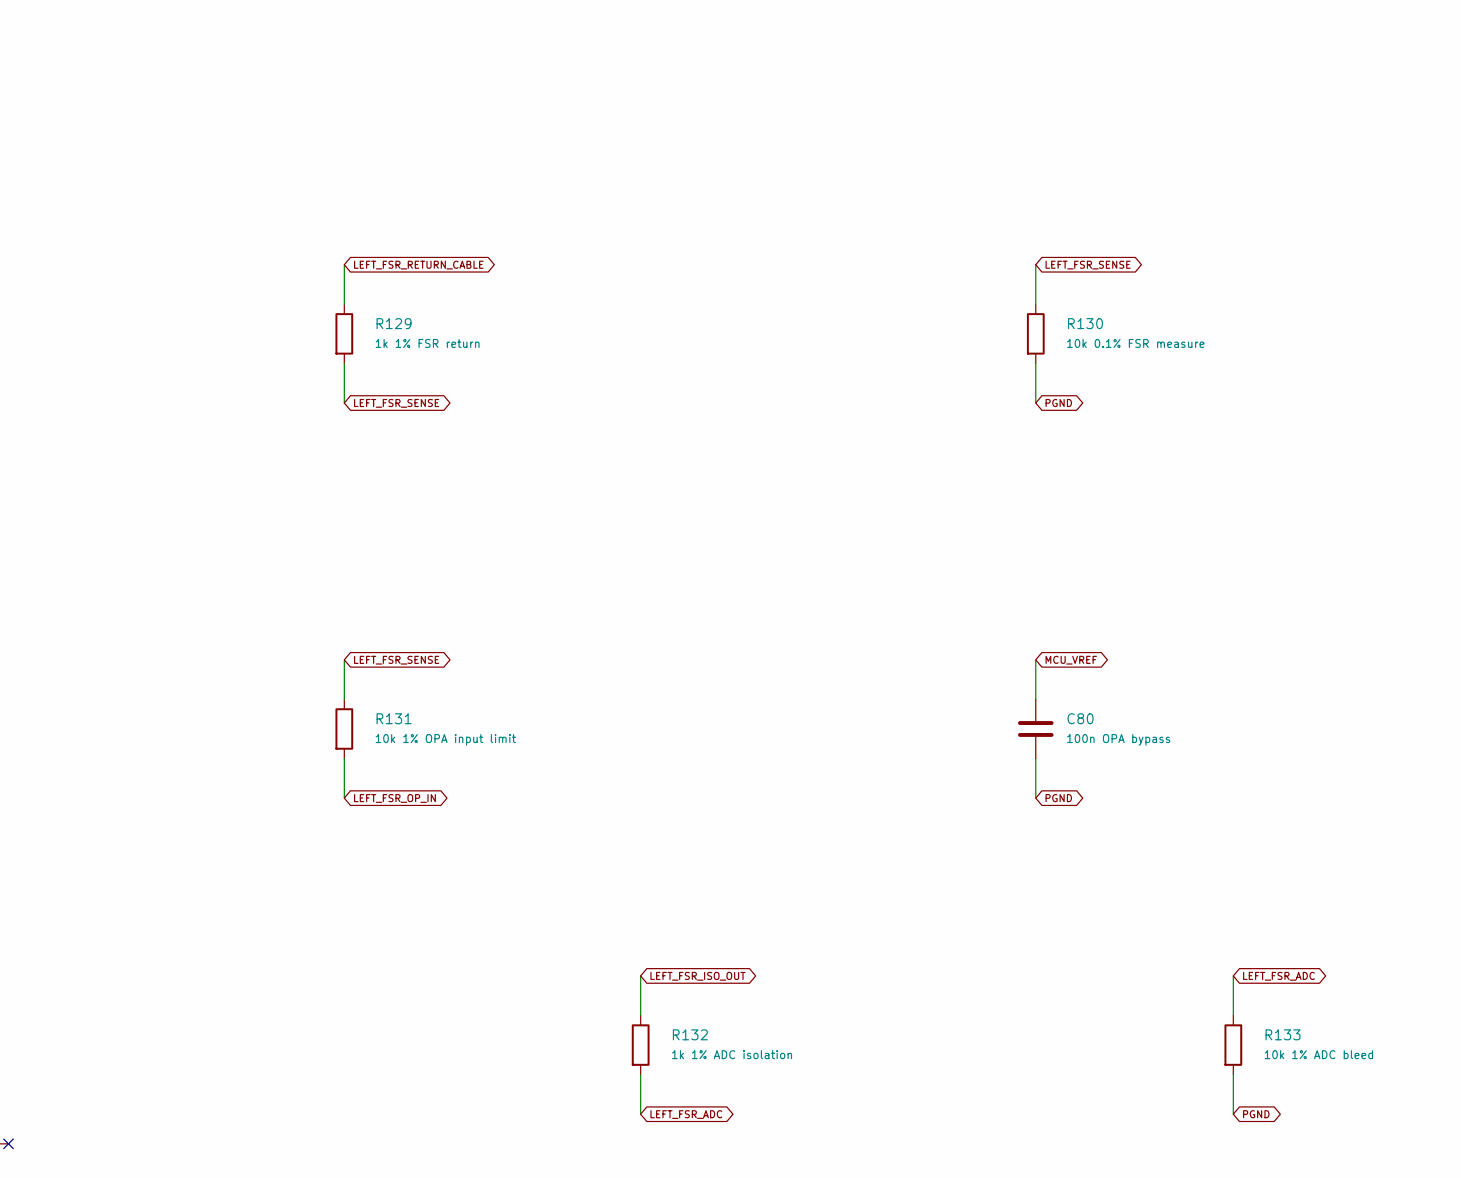
[picture p70: schematic fsr-left.kicad_sch, LEFT selected FSR low-voltage bench frontend, part in row 1, column 2]

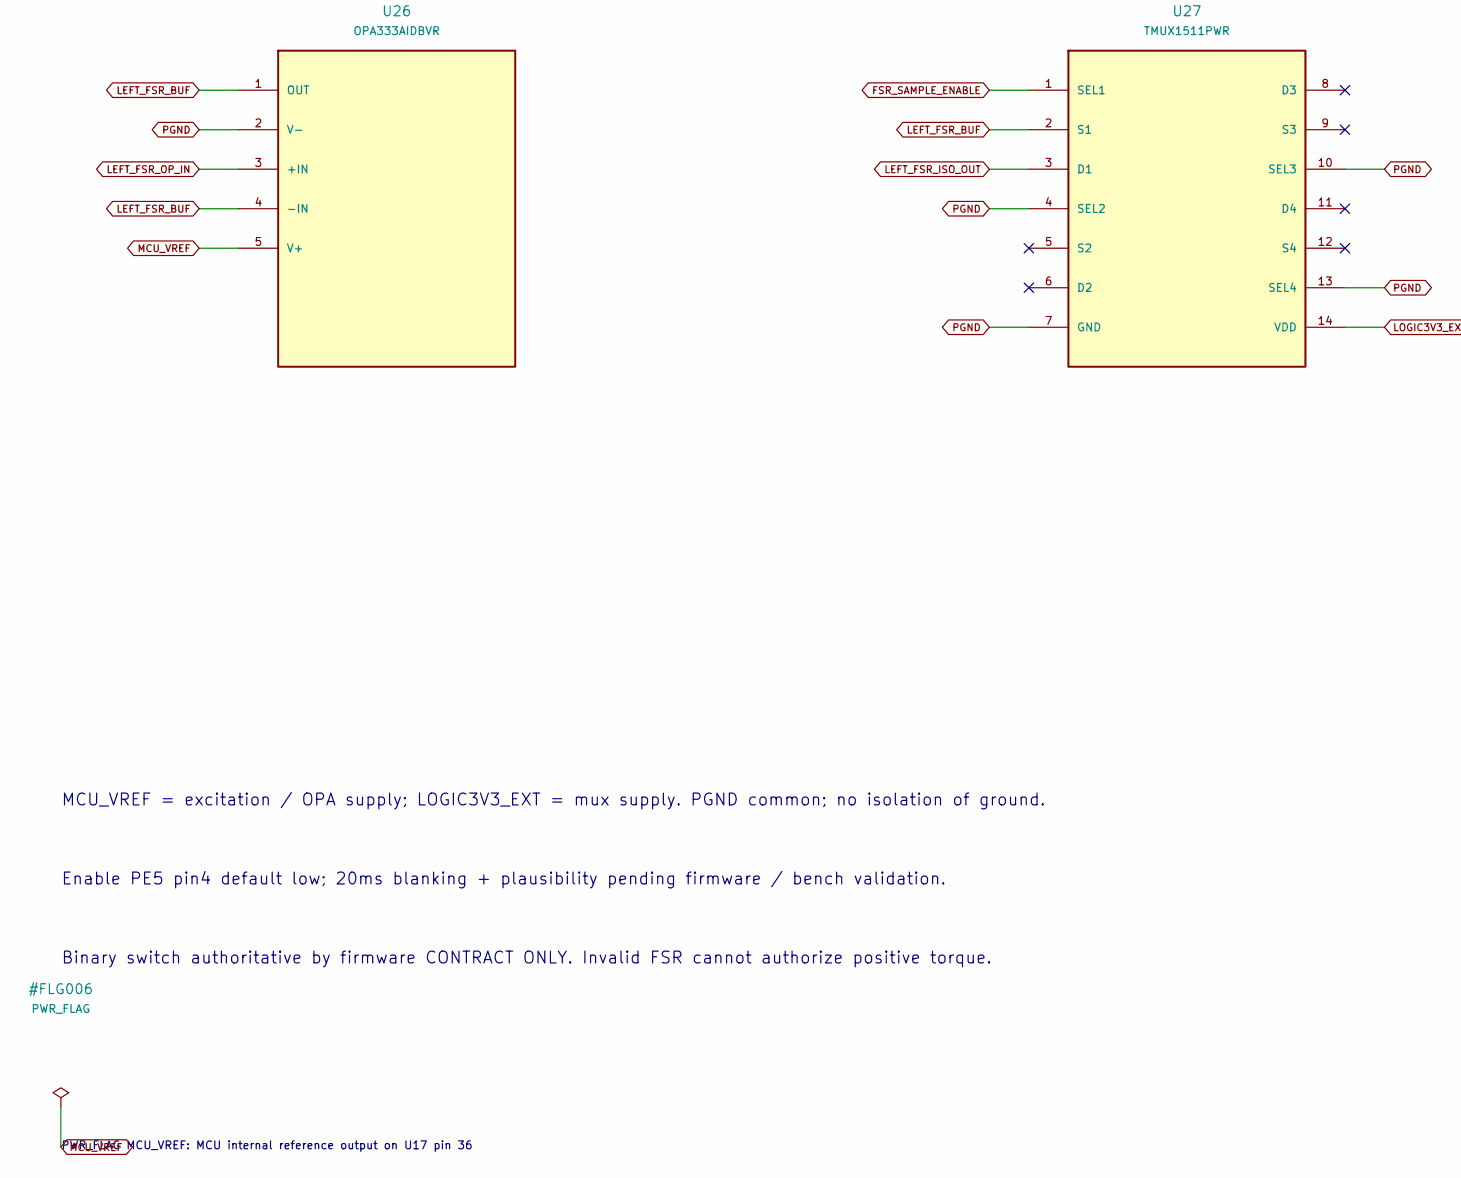
[picture p71: schematic fsr-left.kicad_sch, LEFT selected FSR low-voltage bench frontend, part in row 2, column 1]

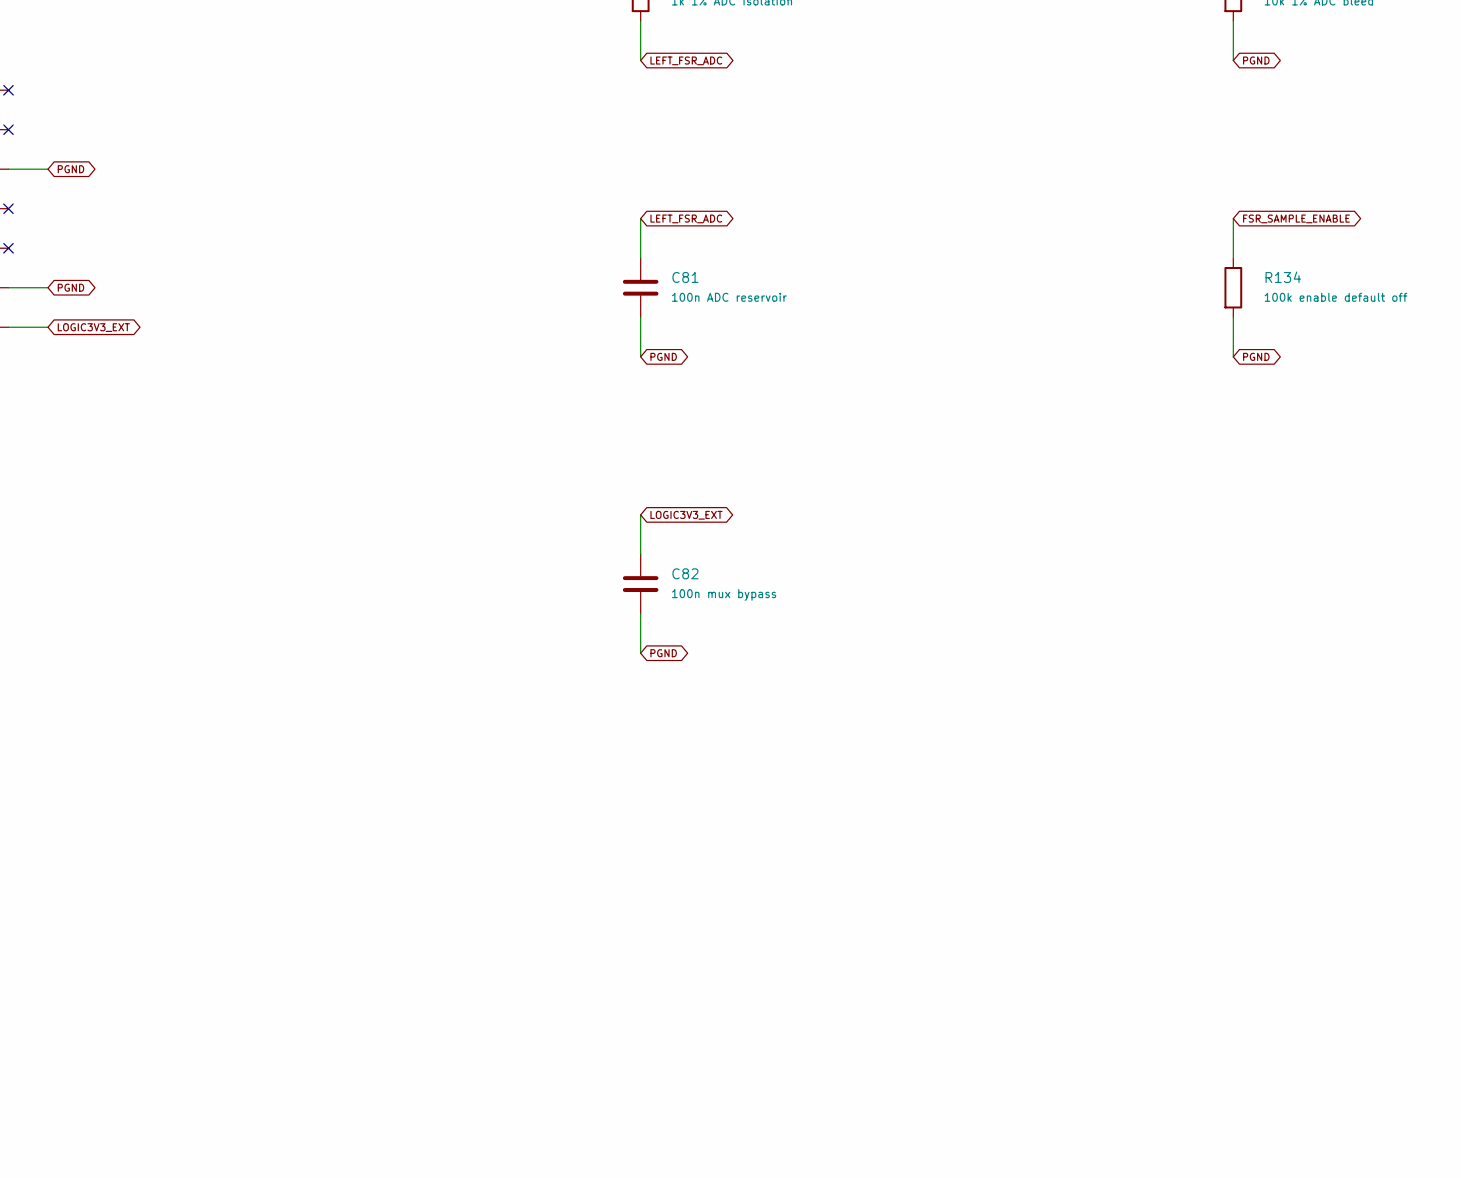
[picture p72: schematic fsr-left.kicad_sch, LEFT selected FSR low-voltage bench frontend, part in row 2, column 2]

Parts:
C79: 100n FSR sense; C_0805_2012Metric
C80: 100n OPA bypass; C_0805_2012Metric
C81: 100n ADC reservoir; C_0805_2012Metric
C82: 100n mux bypass; C_0805_2012Metric
J46: LEFT_FSR_34-00018_EXTERNAL; PinHeader_1x02_P2.54mm_Vertical
R128: 10k 1% FSR excitation; R_0805_2012Metric
R129: 1k 1% FSR return; R_0805_2012Metric
R130: 10k 0.1% FSR measure; R_0805_2012Metric
R131: 10k 1% OPA input limit; R_0805_2012Metric
R132: 1k 1% ADC isolation; R_0805_2012Metric
R133: 10k 1% ADC bleed; R_0805_2012Metric
R134: 100k enable default off; R_0805_2012Metric
U26: OPA333AIDBVR; SOT-23-5
U27: TMUX1511PWR; TSSOP-14_4.4x5mm_P0.65mm

Connections:
FSR_SAMPLE_ENABLE: R134.1, U27.1 (SEL1); also elsewhere on the board
LEFT_FSR_ADC: C81.1, R132.2, R133.1; also elsewhere on the board
LEFT_FSR_BUF: U26.1 (OUT), U26.4 (-IN), U27.2 (S1)
LEFT_FSR_EXC_CABLE: J46.1, R128.2; also elsewhere on the board
LEFT_FSR_ISO_OUT: R132.1, U27.3 (D1)
LEFT_FSR_OP_IN: R131.2, U26.3 (+IN)
LEFT_FSR_RETURN_CABLE: J46.2, R129.1; also elsewhere on the board
LEFT_FSR_SENSE: C79.1, R129.2, R130.1, R131.1; also elsewhere on the board
LOGIC3V3_EXT: C82.1, U27.14 (VDD); also elsewhere on the board
MCU_VREF: C80.1, R128.1, U26.5 (V+); also elsewhere on the board
PGND: C79.2, C80.2, C81.2, C82.2, R130.2, R133.2, R134.2, U26.2 (V-), U27.4 (SEL2), U27.7 (GND), U27.10 (SEL3), U27.13 (SEL4); also elsewhere on the board

Notes on the sheet:
Interlink 34-00018 external 402 short-tail pad; connector mate / mechanics UNQUALIFIED.
LOW-VOLTAGE BENCH ONLY. TVS / clamps candidates, NOT battery-short protection. No torque-sign guard.
MCU_VREF = excitation / OPA supply; LOGIC3V3_EXT = mux supply. PGND common; no isolation of ground.
Enable PE5 pin4 default low; 20ms blanking + plausibility pending firmware / bench validation.
Binary switch authoritative by firmware CONTRACT ONLY. Invalid FSR cannot authorize positive torque.
PWR_FLAG MCU_VREF: MCU internal reference output on U17 pin 36
