felixfelix-bot/cycle-without-chain/hardware/powerboard-reva/powerboard-reva.kicad_pcb

## KiCad design hardware/powerboard-reva/powerboard-reva.kicad_pcb (continued)

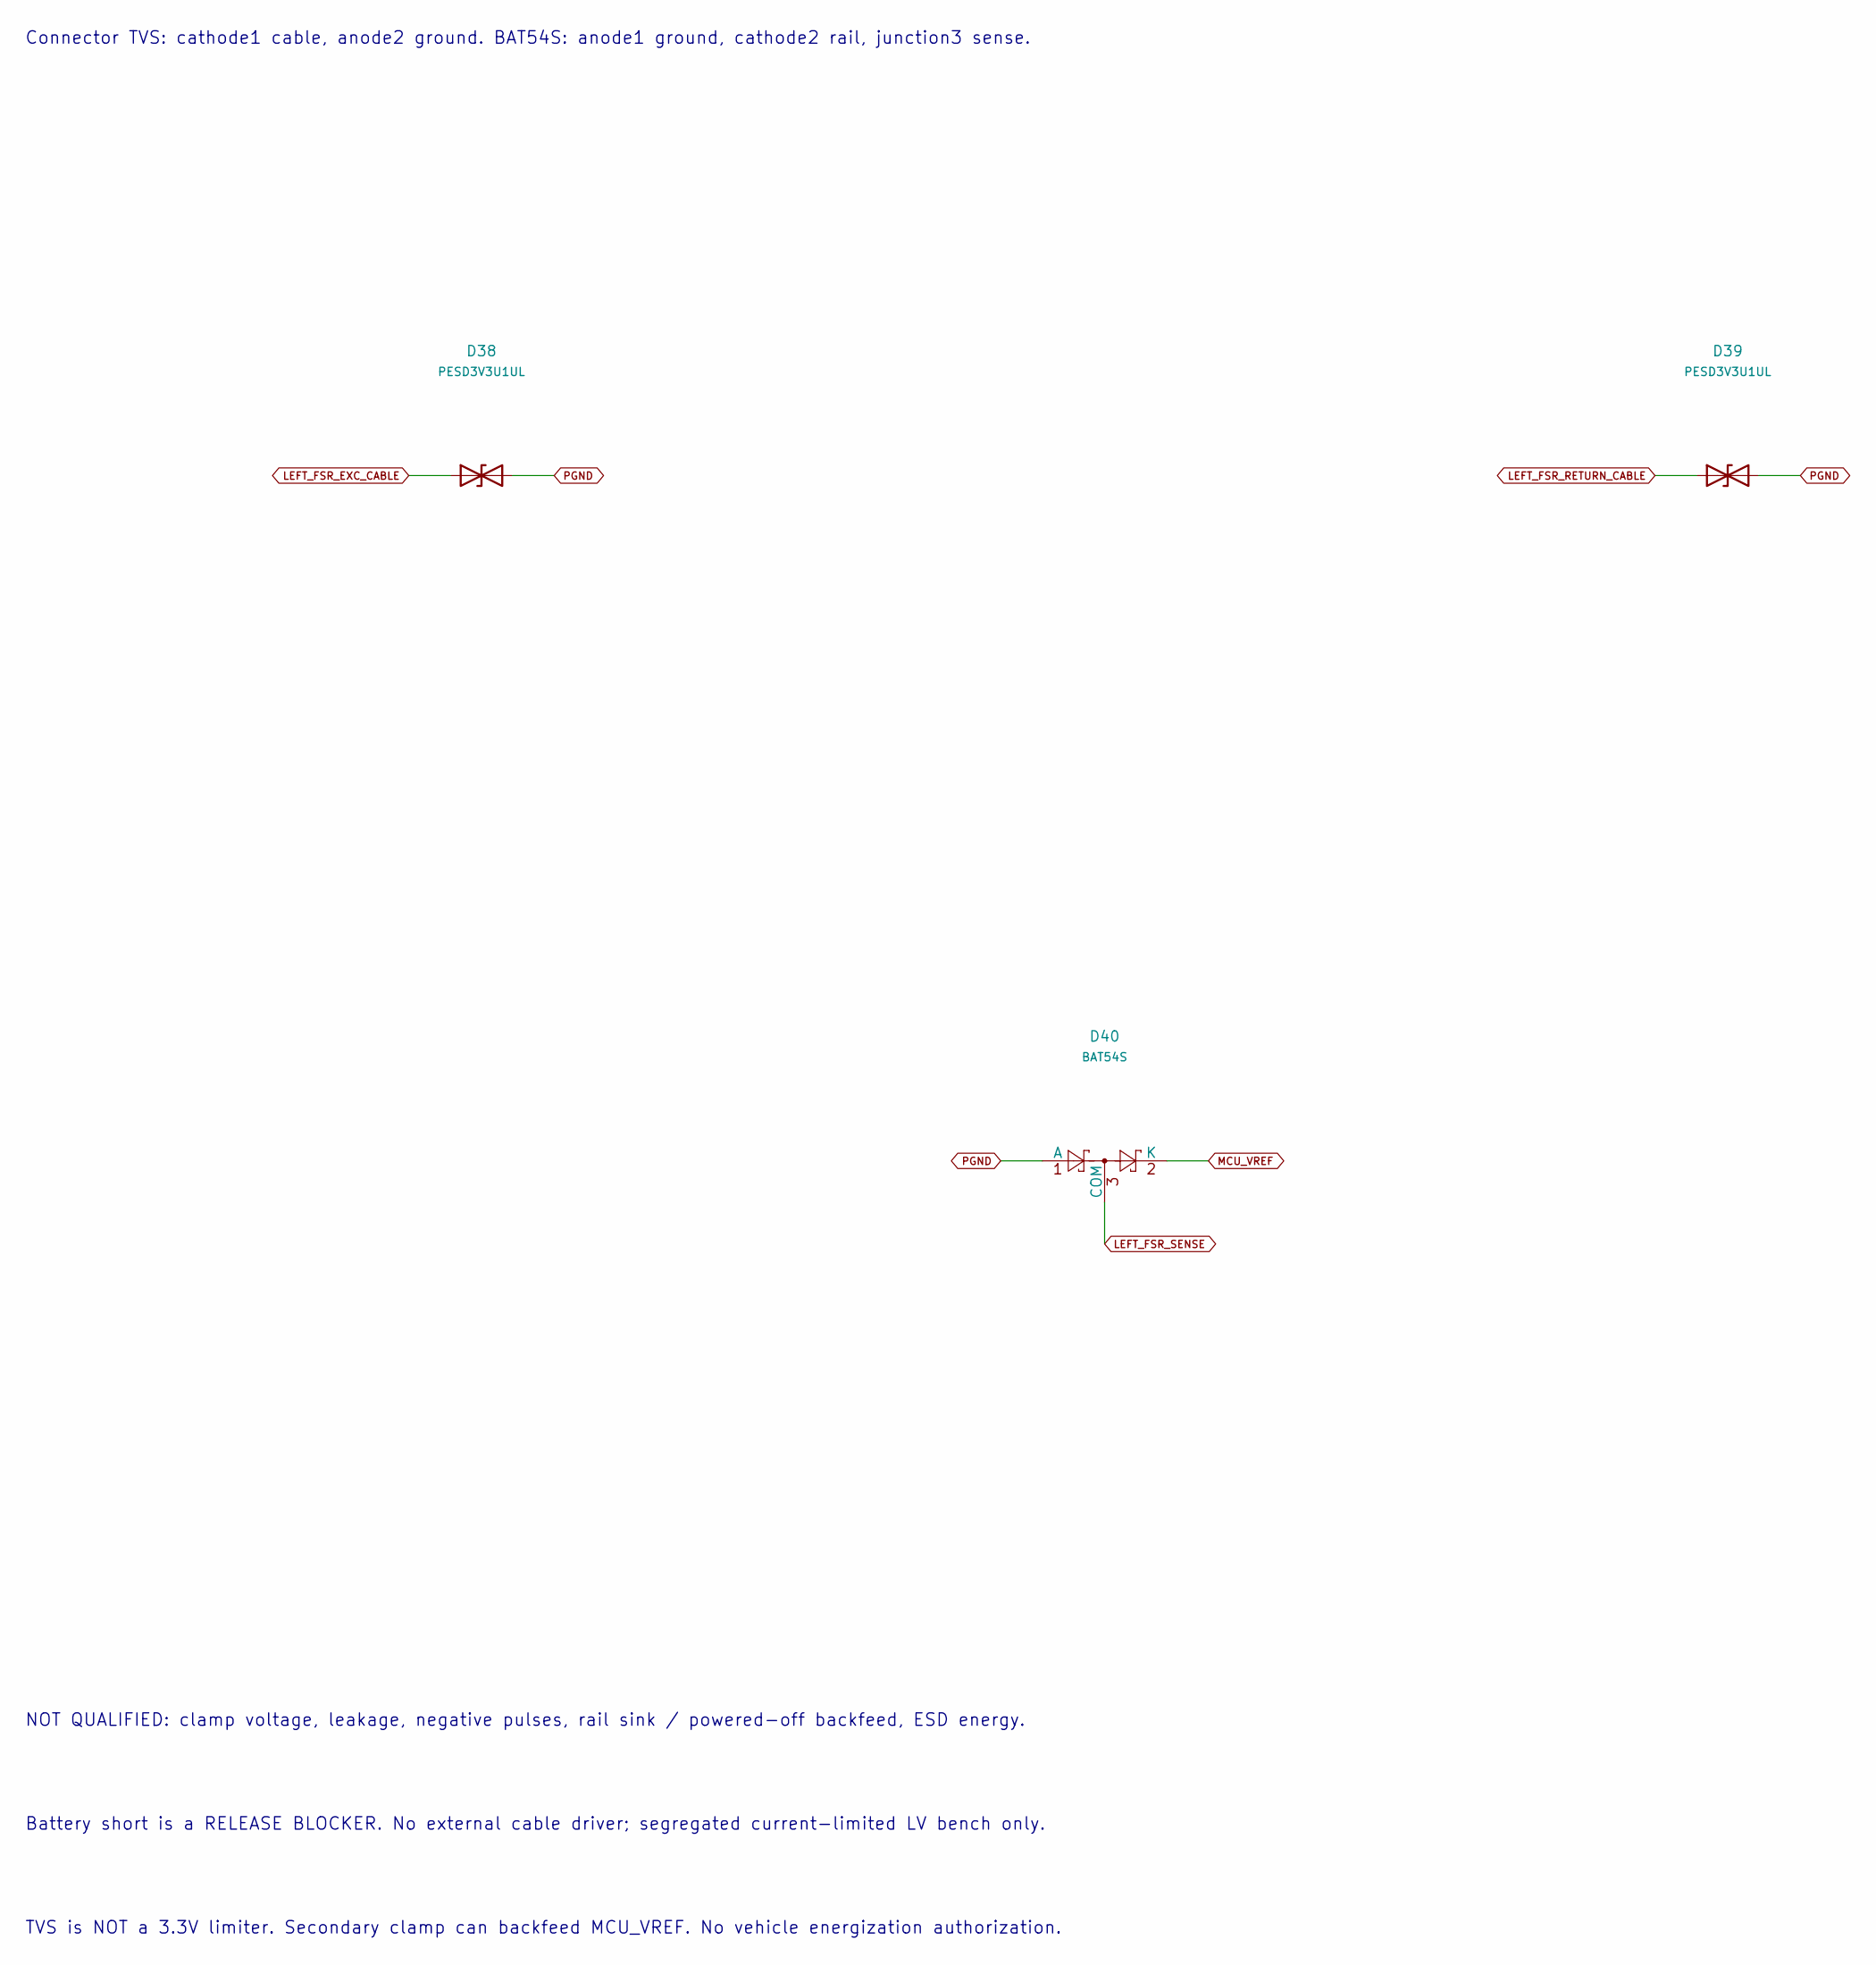
[picture p73: schematic fsr-protection-left.kicad_sch, LEFT FSR candidate ESD and secondary clamps - unqualified]

Parts:
D38, D39: PESD3V3U1UL; D_SOD-882
D40: BAT54S; SOT-23

Connections:
LEFT_FSR_EXC_CABLE: D38.1 (A1); also elsewhere on the board
LEFT_FSR_RETURN_CABLE: D39.1 (A1); also elsewhere on the board
LEFT_FSR_SENSE: D40.3 (COM); also elsewhere on the board
MCU_VREF: D40.2 (K); also elsewhere on the board
PGND: D38.2 (A2), D39.2 (A2), D40.1 (A); also elsewhere on the board

Notes on the sheet:
Connector TVS: cathode1 cable, anode2 ground. BAT54S: anode1 ground, cathode2 rail, junction3 sense.
NOT QUALIFIED: clamp voltage, leakage, negative pulses, rail sink / powered-off backfeed, ESD energy.
Battery short is a RELEASE BLOCKER. No external cable driver; segregated current-limited LV bench only.
TVS is NOT a 3.3V limiter. Secondary clamp can backfeed MCU_VREF. No vehicle energization authorization.

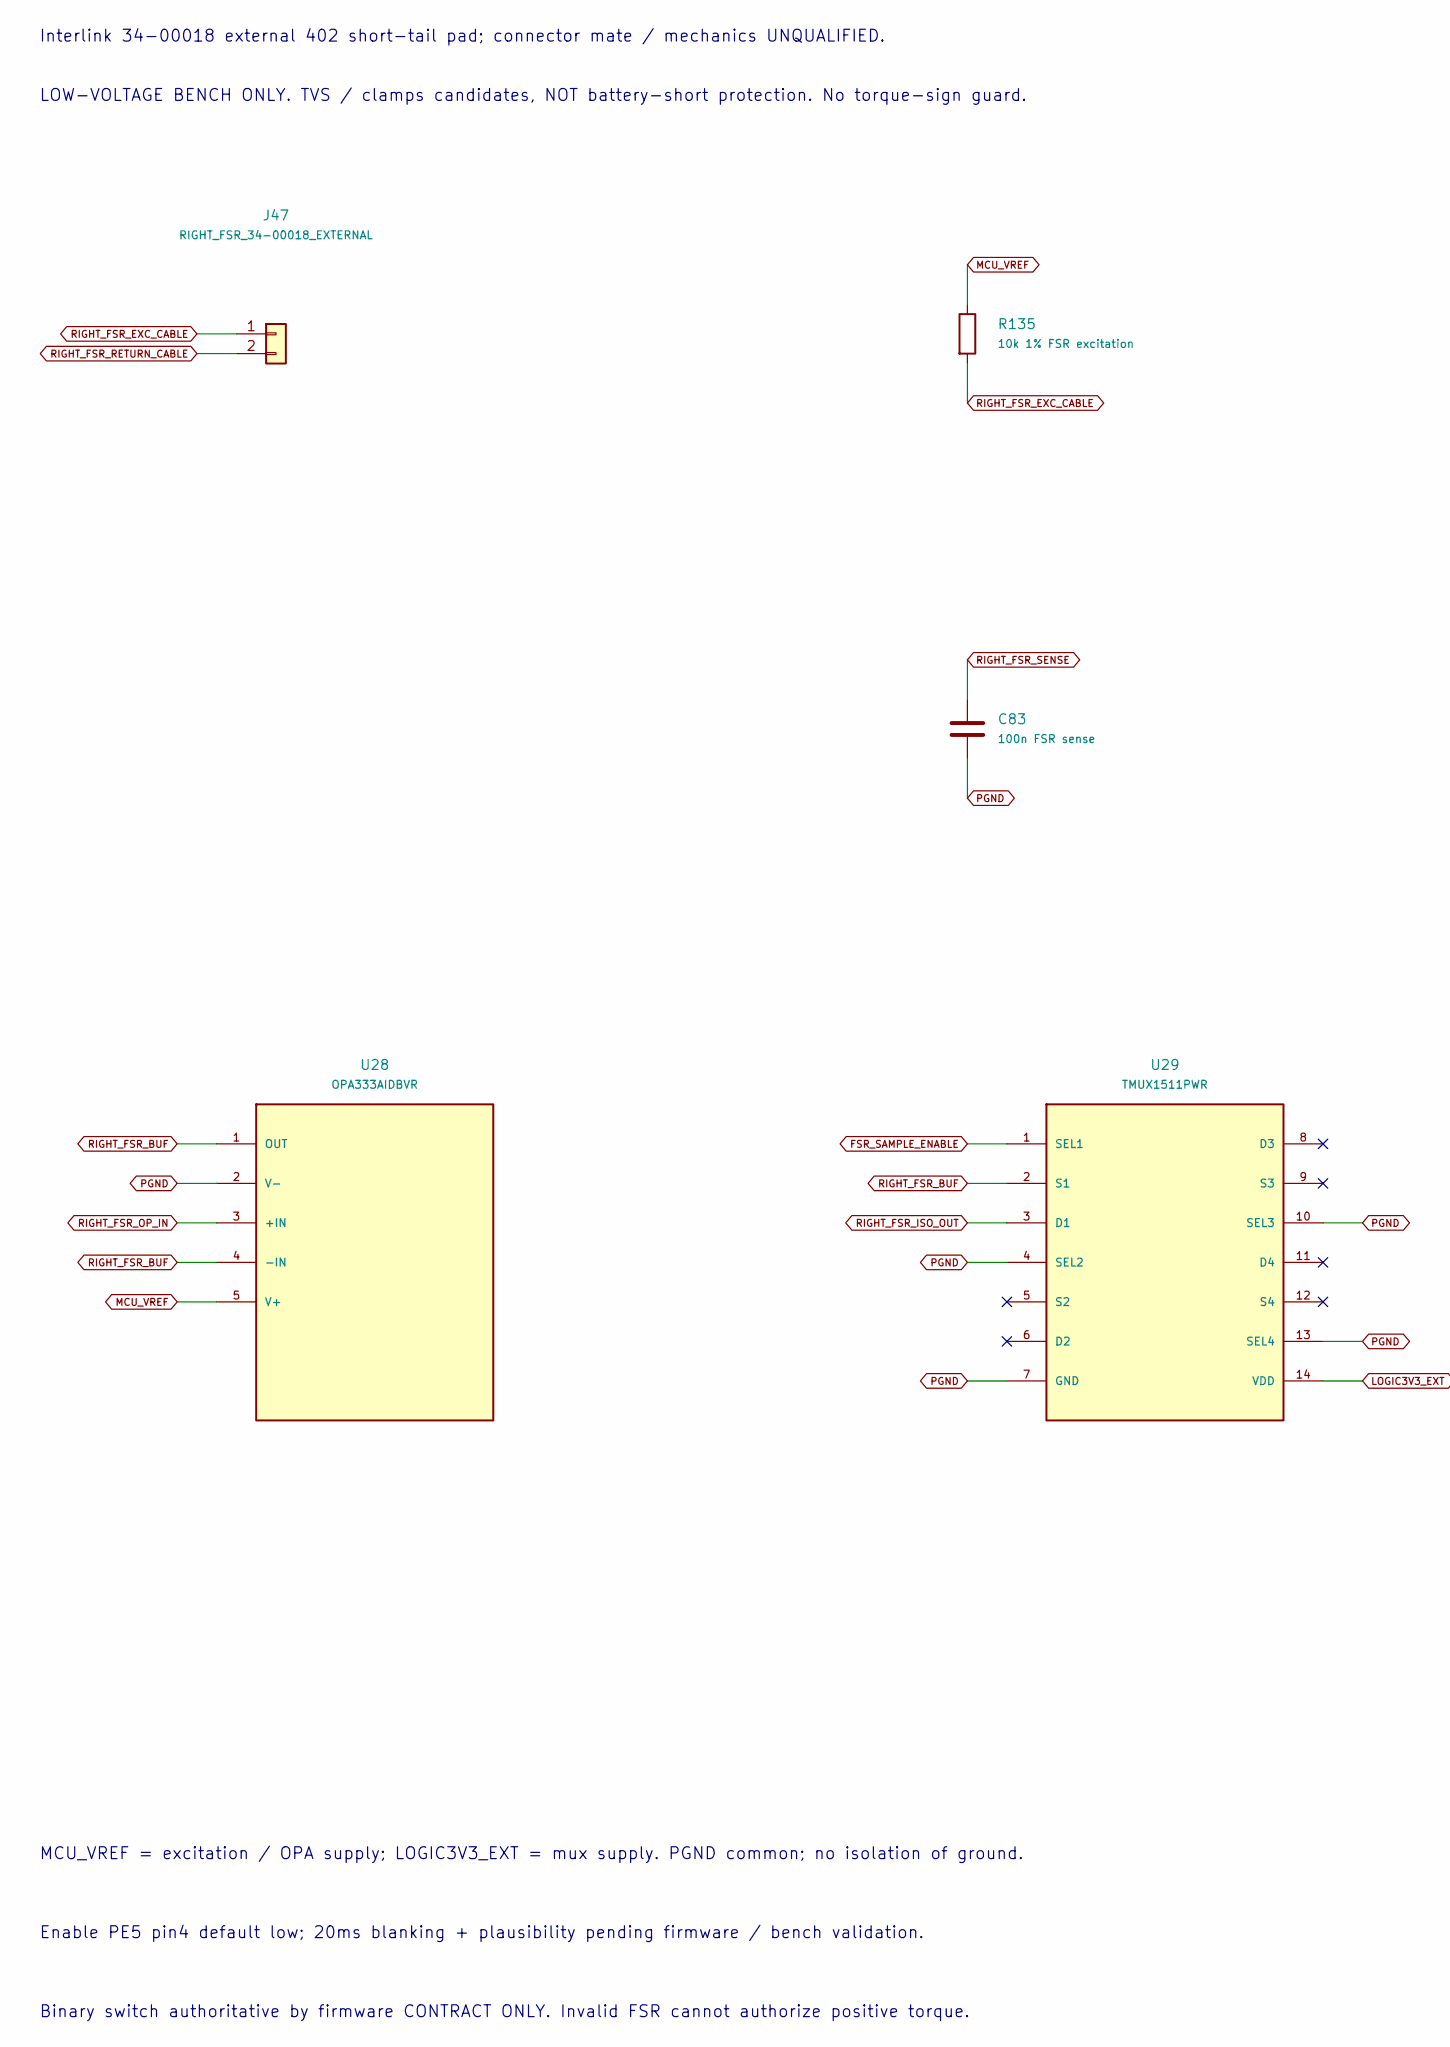
[picture p74: schematic fsr-right.kicad_sch, RIGHT selected FSR low-voltage bench frontend, part in row 1, column 1]

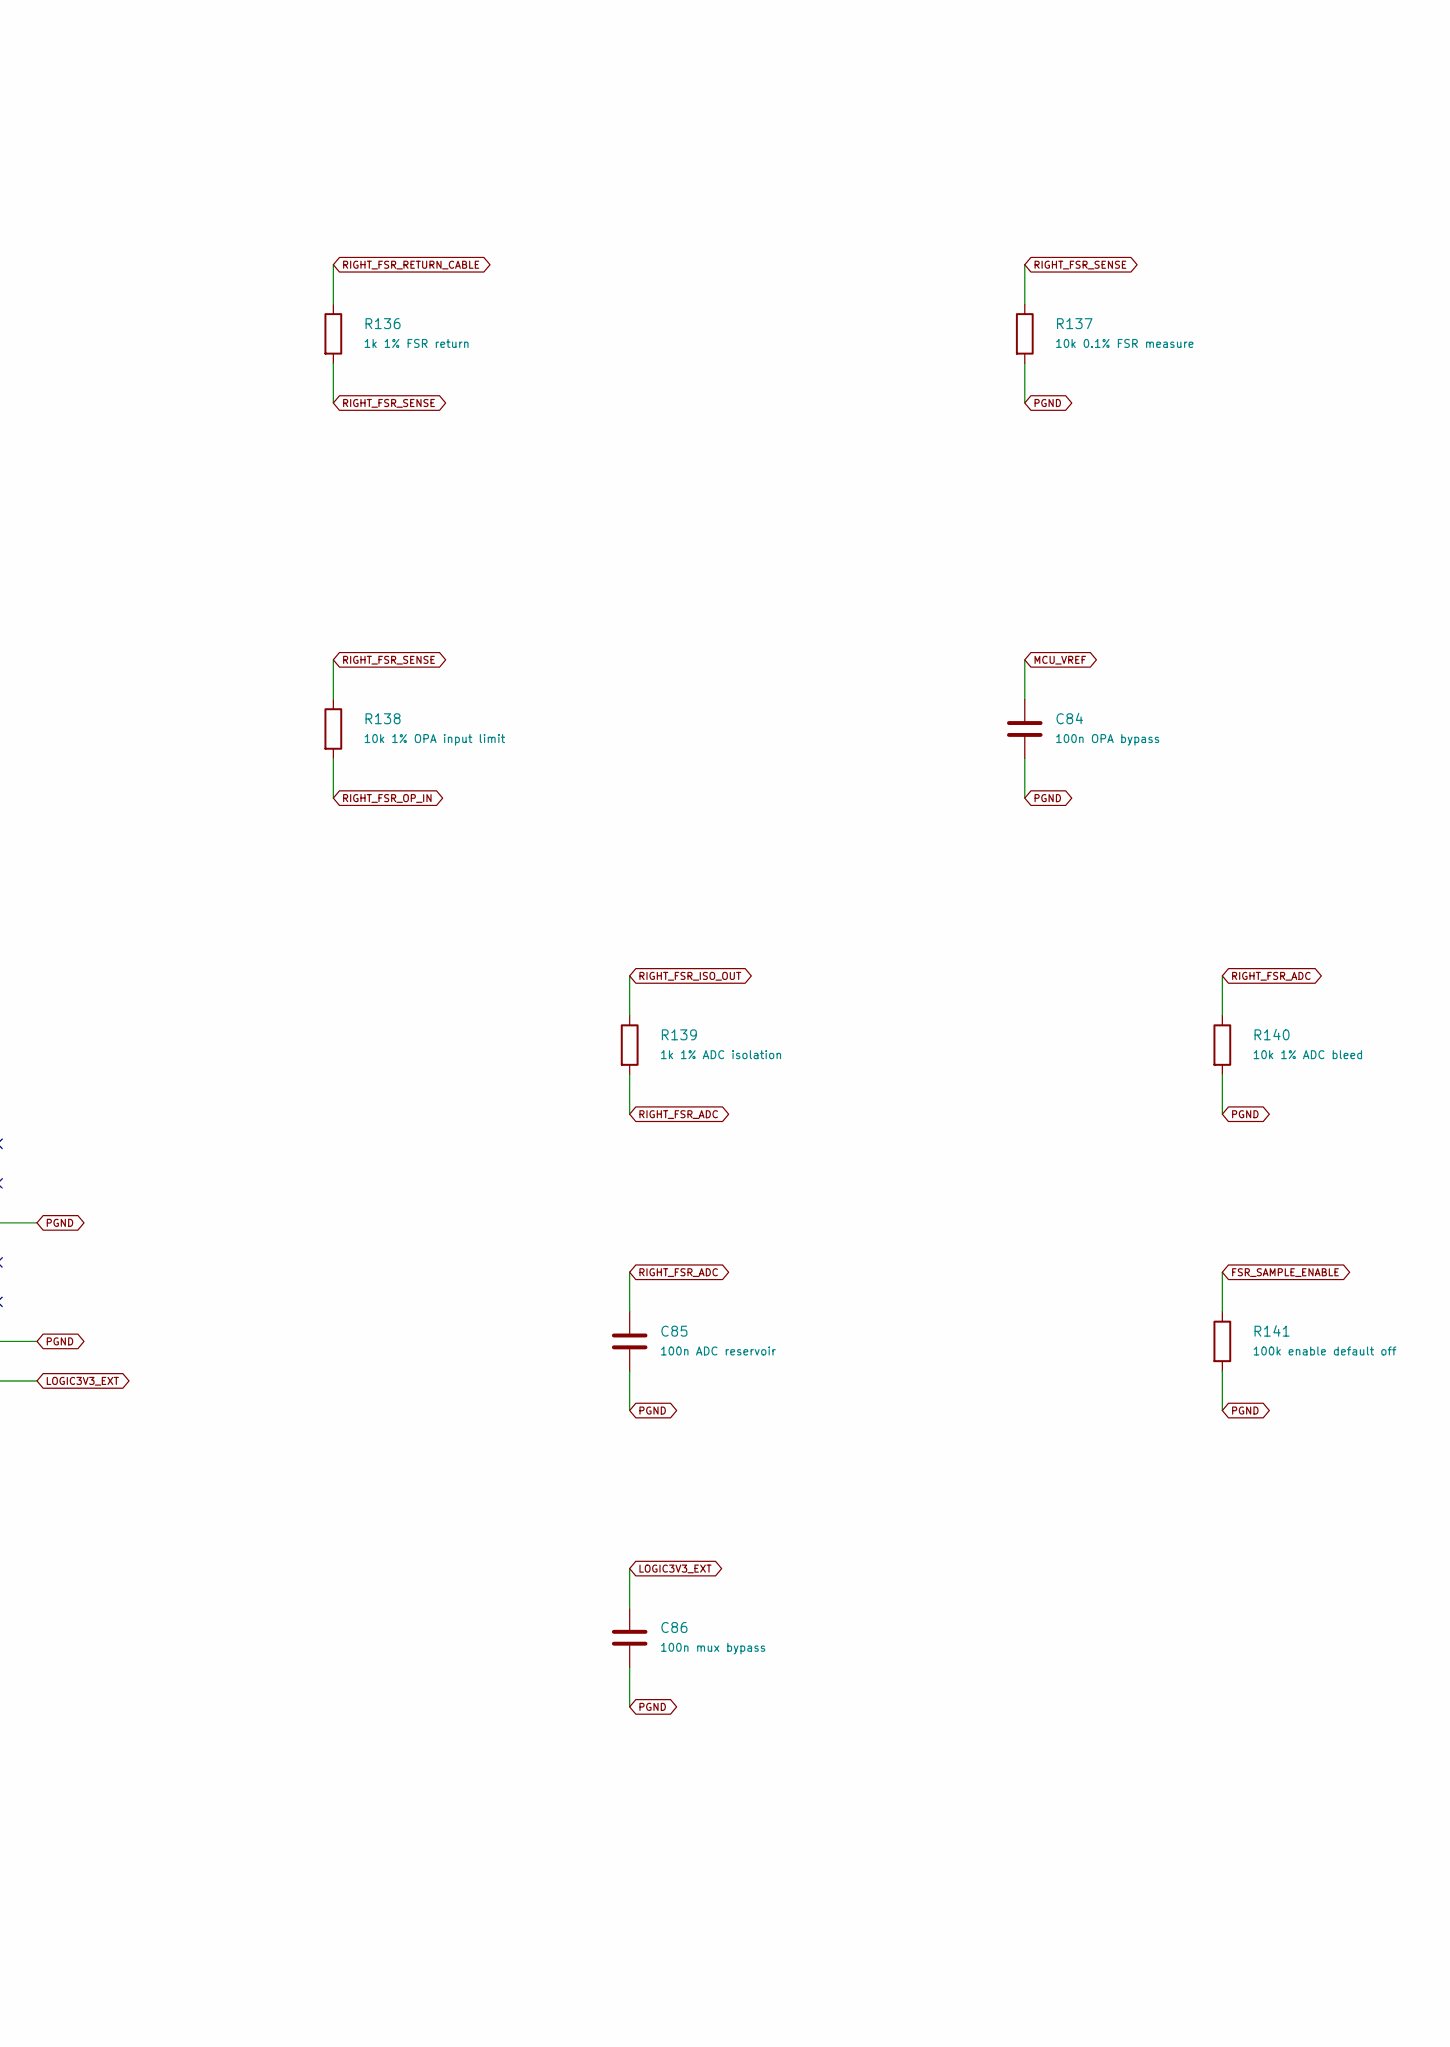
[picture p75: schematic fsr-right.kicad_sch, RIGHT selected FSR low-voltage bench frontend, part in row 1, column 2]

Parts:
C83: 100n FSR sense; C_0805_2012Metric
C84: 100n OPA bypass; C_0805_2012Metric
C85: 100n ADC reservoir; C_0805_2012Metric
C86: 100n mux bypass; C_0805_2012Metric
J47: RIGHT_FSR_34-00018_EXTERNAL; PinHeader_1x02_P2.54mm_Vertical
R135: 10k 1% FSR excitation; R_0805_2012Metric
R136: 1k 1% FSR return; R_0805_2012Metric
R137: 10k 0.1% FSR measure; R_0805_2012Metric
R138: 10k 1% OPA input limit; R_0805_2012Metric
R139: 1k 1% ADC isolation; R_0805_2012Metric
R140: 10k 1% ADC bleed; R_0805_2012Metric
R141: 100k enable default off; R_0805_2012Metric
U28: OPA333AIDBVR; SOT-23-5
U29: TMUX1511PWR; TSSOP-14_4.4x5mm_P0.65mm

Connections:
FSR_SAMPLE_ENABLE: R141.1, U29.1 (SEL1); also elsewhere on the board
LOGIC3V3_EXT: C86.1, U29.14 (VDD); also elsewhere on the board
MCU_VREF: C84.1, R135.1, U28.5 (V+); also elsewhere on the board
PGND: C83.2, C84.2, C85.2, C86.2, R137.2, R140.2, R141.2, U28.2 (V-), U29.4 (SEL2), U29.7 (GND), U29.10 (SEL3), U29.13 (SEL4); also elsewhere on the board
RIGHT_FSR_ADC: C85.1, R139.2, R140.1; also elsewhere on the board
RIGHT_FSR_BUF: U28.1 (OUT), U28.4 (-IN), U29.2 (S1)
RIGHT_FSR_EXC_CABLE: J47.1, R135.2; also elsewhere on the board
RIGHT_FSR_ISO_OUT: R139.1, U29.3 (D1)
RIGHT_FSR_OP_IN: R138.2, U28.3 (+IN)
RIGHT_FSR_RETURN_CABLE: J47.2, R136.1; also elsewhere on the board
RIGHT_FSR_SENSE: C83.1, R136.2, R137.1, R138.1; also elsewhere on the board

Notes on the sheet:
Interlink 34-00018 external 402 short-tail pad; connector mate / mechanics UNQUALIFIED.
LOW-VOLTAGE BENCH ONLY. TVS / clamps candidates, NOT battery-short protection. No torque-sign guard.
MCU_VREF = excitation / OPA supply; LOGIC3V3_EXT = mux supply. PGND common; no isolation of ground.
Enable PE5 pin4 default low; 20ms blanking + plausibility pending firmware / bench validation.
Binary switch authoritative by firmware CONTRACT ONLY. Invalid FSR cannot authorize positive torque.

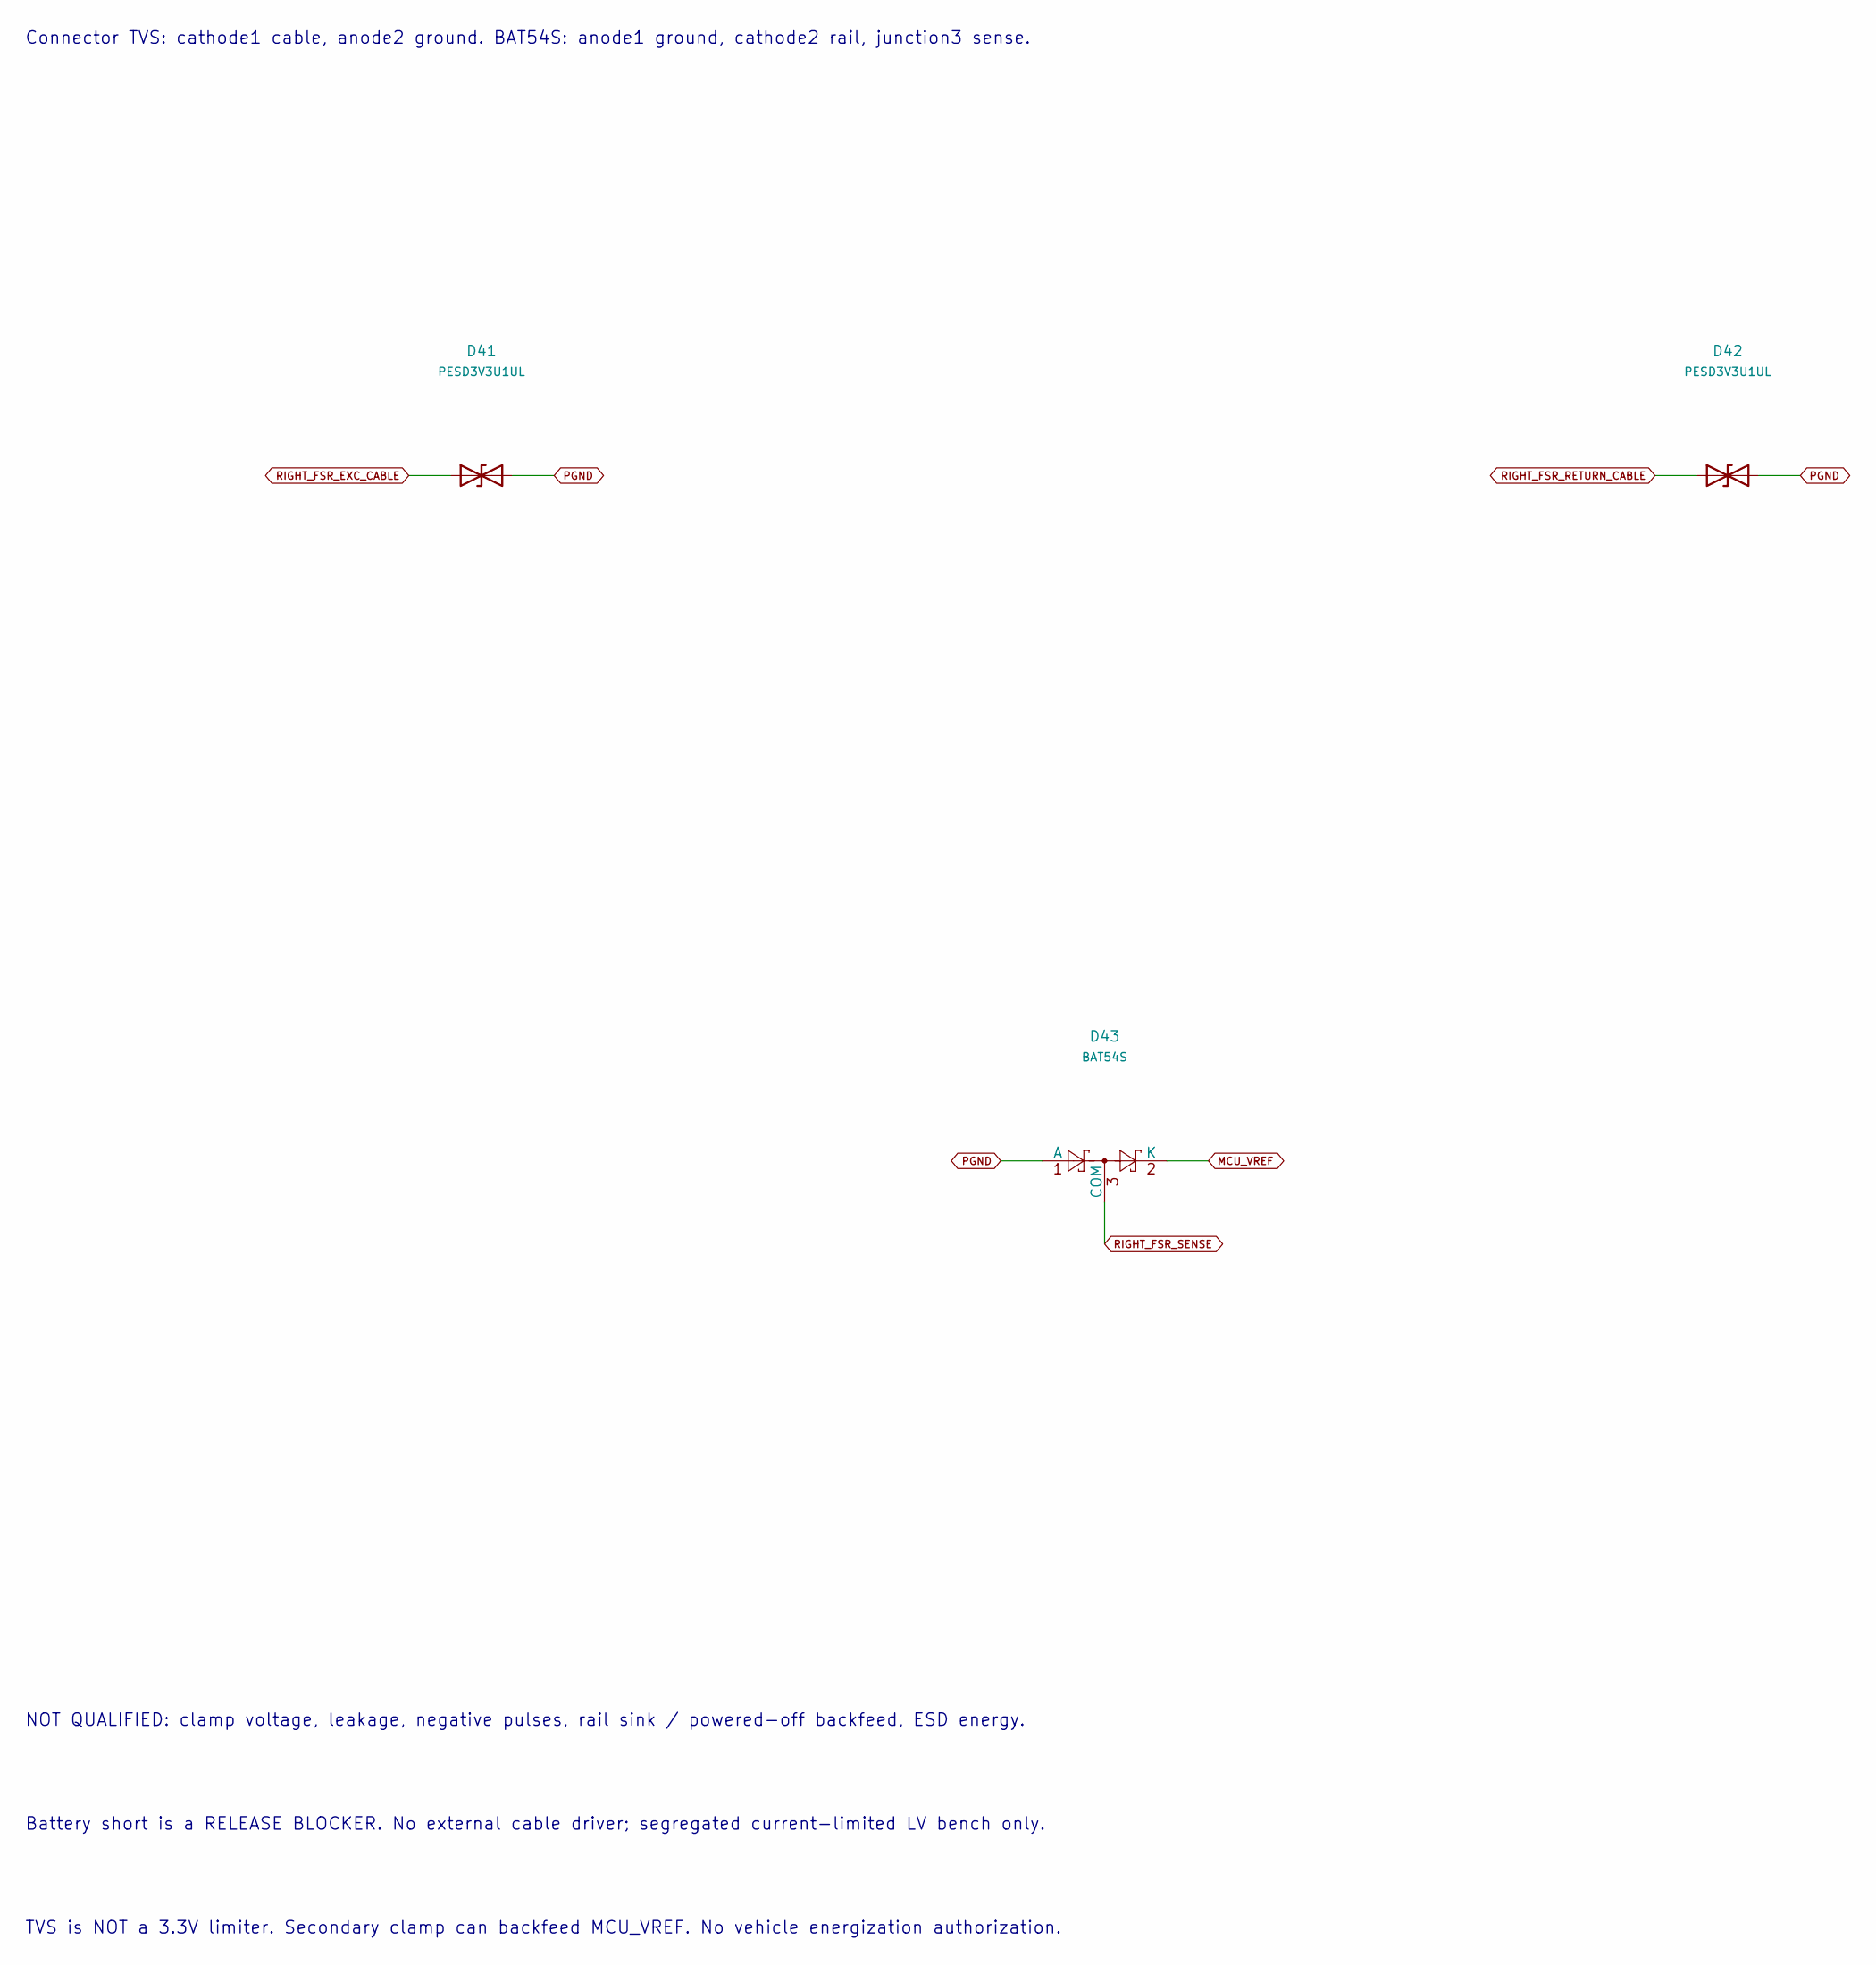
[picture p76: schematic fsr-protection-right.kicad_sch, RIGHT FSR candidate ESD and secondary clamps - unqualified]

Parts:
D41, D42: PESD3V3U1UL; D_SOD-882
D43: BAT54S; SOT-23

Connections:
MCU_VREF: D43.2 (K); also elsewhere on the board
PGND: D41.2 (A2), D42.2 (A2), D43.1 (A); also elsewhere on the board
RIGHT_FSR_EXC_CABLE: D41.1 (A1); also elsewhere on the board
RIGHT_FSR_RETURN_CABLE: D42.1 (A1); also elsewhere on the board
RIGHT_FSR_SENSE: D43.3 (COM); also elsewhere on the board

Notes on the sheet:
Connector TVS: cathode1 cable, anode2 ground. BAT54S: anode1 ground, cathode2 rail, junction3 sense.
NOT QUALIFIED: clamp voltage, leakage, negative pulses, rail sink / powered-off backfeed, ESD energy.
Battery short is a RELEASE BLOCKER. No external cable driver; segregated current-limited LV bench only.
TVS is NOT a 3.3V limiter. Secondary clamp can backfeed MCU_VREF. No vehicle energization authorization.
