felixfelix-bot/cycle-without-chain/hardware/powerboard-reva/powerboard-reva.kicad_pcb

## KiCad design hardware/powerboard-reva/powerboard-reva.kicad_pcb (continued)

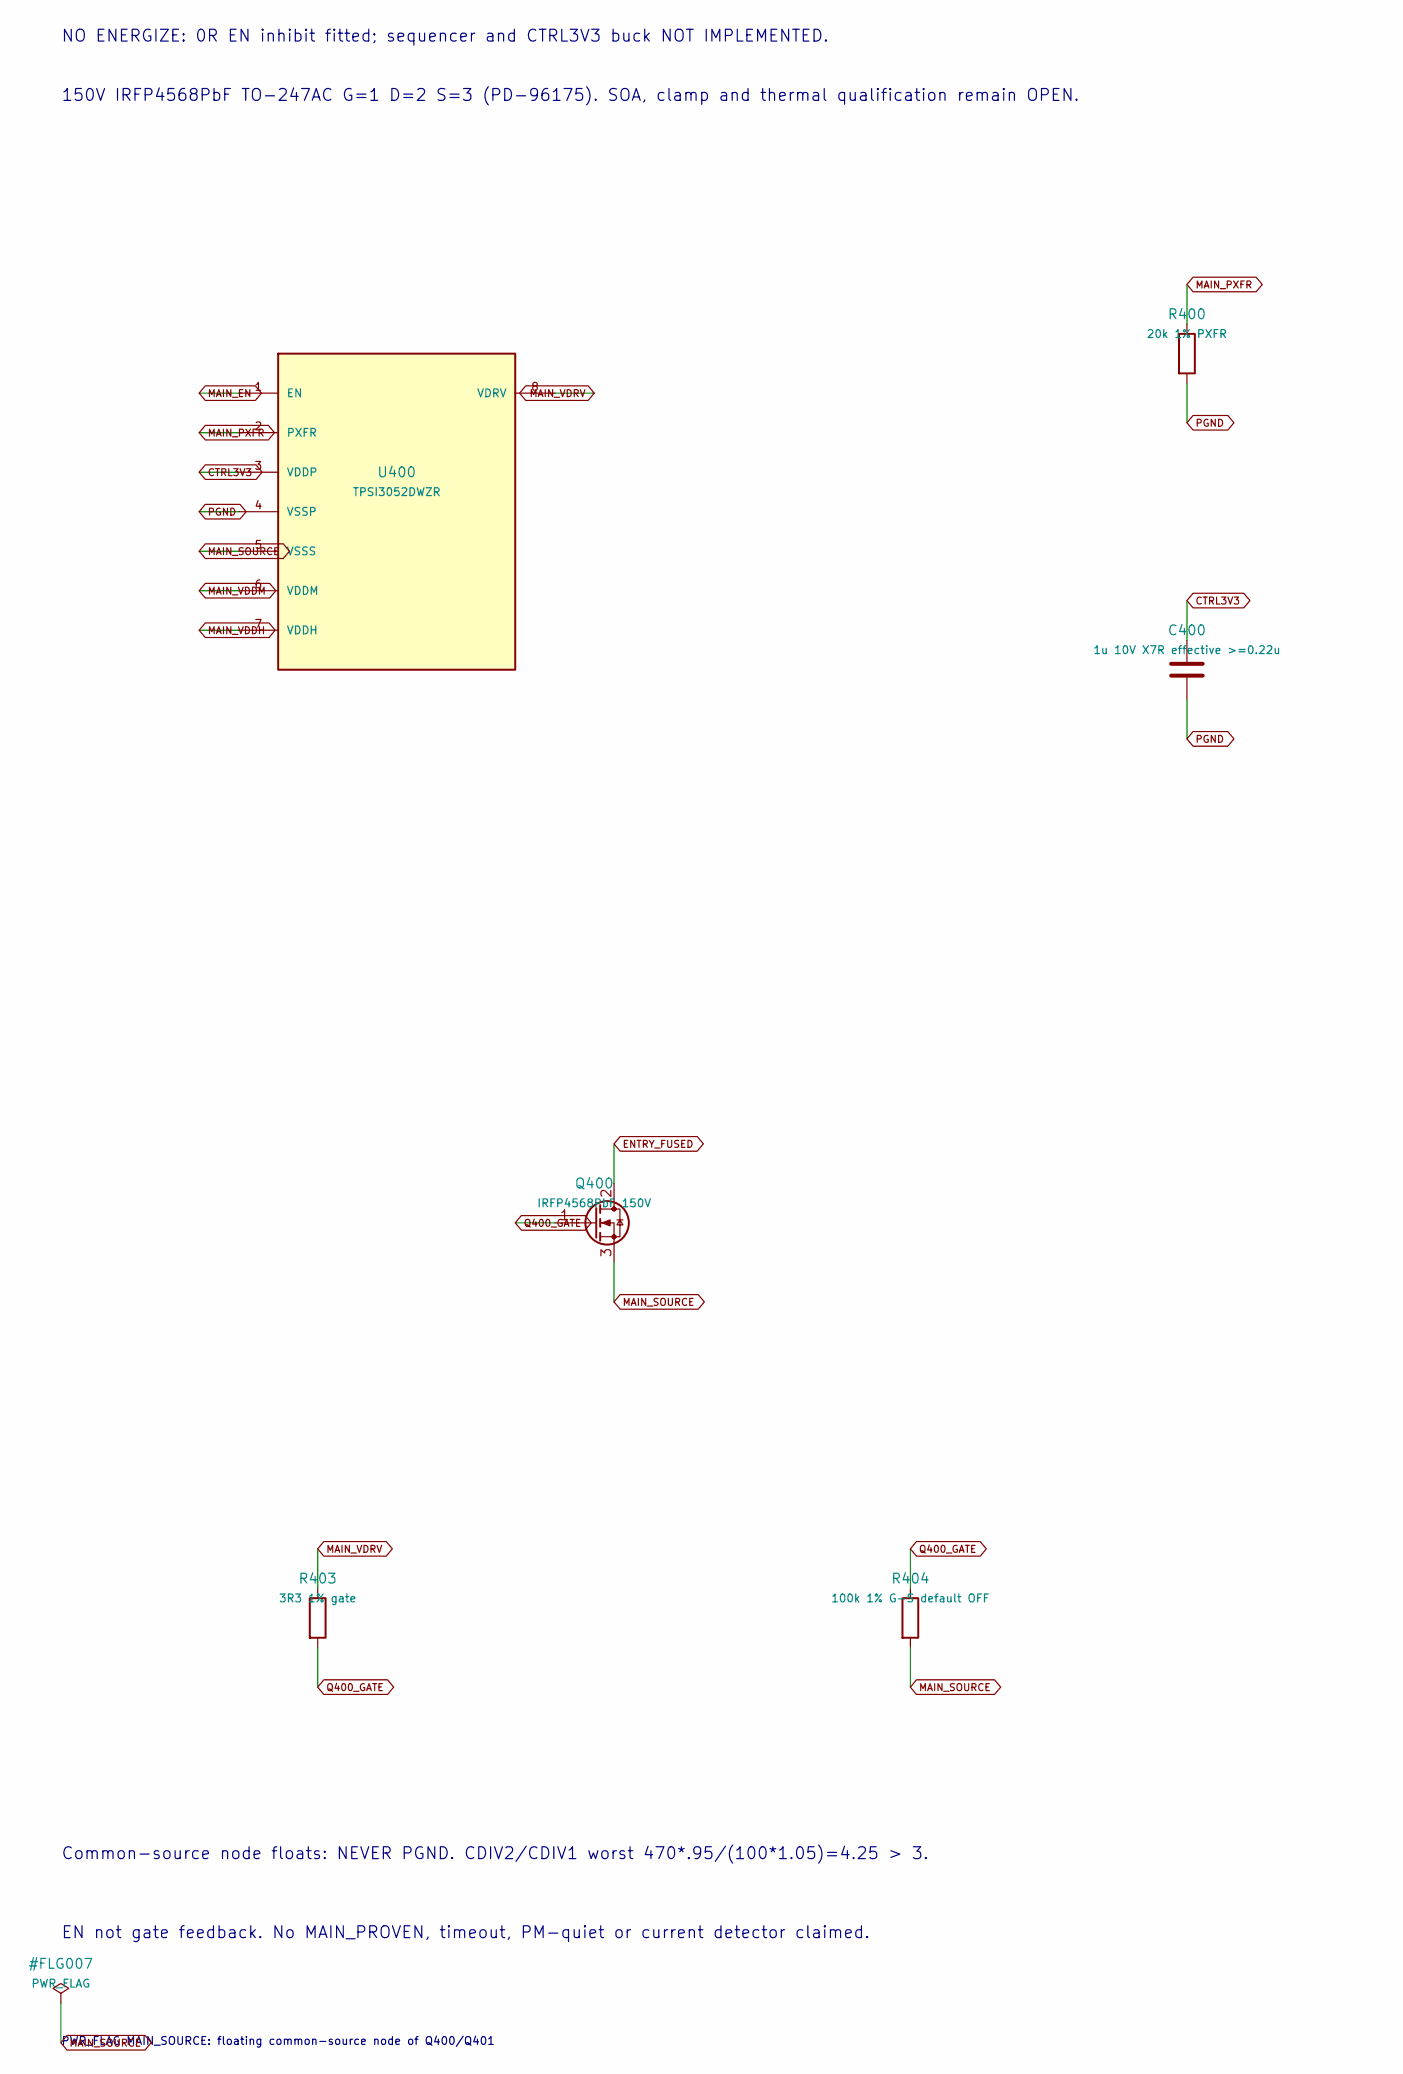
[picture p77: schematic entry-main.kicad_sch, MAIN back-to-back candidate - hardware inhibited, part in row 1, column 1]

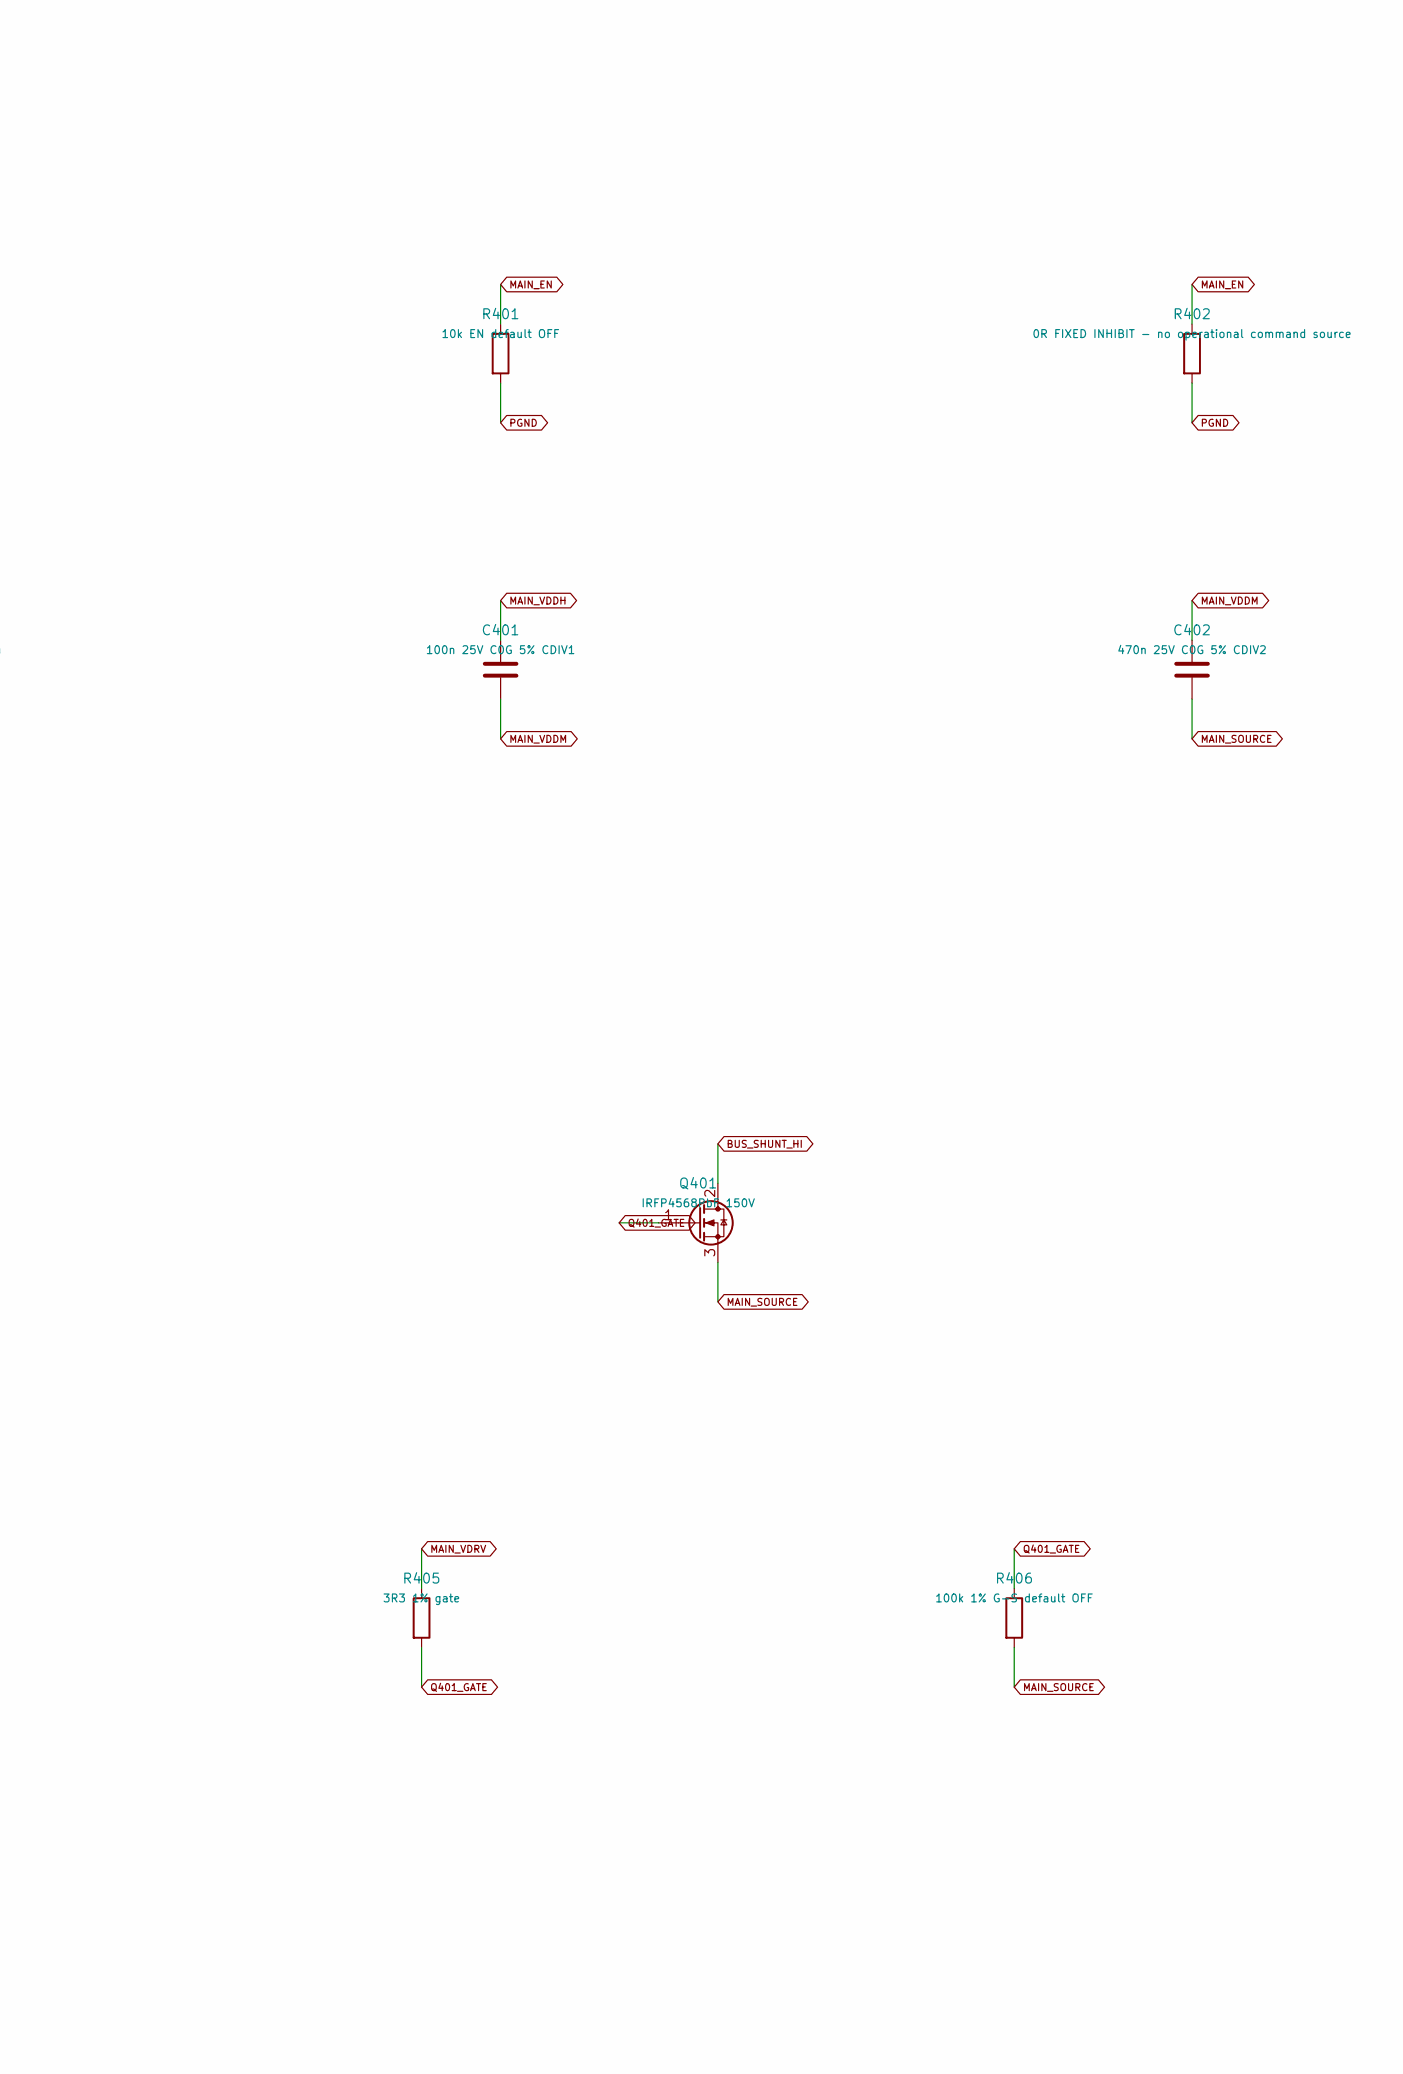
[picture p78: schematic entry-main.kicad_sch, MAIN back-to-back candidate - hardware inhibited, part in row 1, column 2]

Parts:
C400: 1u 10V X7R effective >=0.22u; C_0603_1608Metric
C401: 100n 25V C0G 5% CDIV1; C_0805_2012Metric
C402: 470n 25V C0G 5% CDIV2; C_0805_2012Metric
Q400, Q401: IRFP4568PbF 150V; TO-247-3_Vertical
R400: 20k 1% PXFR; R_0805_2012Metric
R401: 10k EN default OFF; R_0805_2012Metric
R402: 0R FIXED INHIBIT - no operational command source; R_0805_2012Metric
R403, R405: 3R3 1% gate; R_0805_2012Metric
R404, R406: 100k 1% G-S default OFF; R_0805_2012Metric
U400: TPSI3052DWZR; SOIC-8_5.3x5.3mm_P1.27mm

Connections:
BUS_SHUNT_HI: Q401.2 (D); also elsewhere on the board
CTRL3V3: C400.1, U400.3 (VDDP); also elsewhere on the board
ENTRY_FUSED: Q400.2 (D); also elsewhere on the board
MAIN_EN: R401.1, R402.1, U400.1 (EN)
MAIN_PXFR: R400.1, U400.2 (PXFR)
MAIN_SOURCE: C402.2, Q400.3 (S), Q401.3 (S), R404.2, R406.2, U400.5 (VSSS)
MAIN_VDDH: C401.1, U400.7 (VDDH)
MAIN_VDDM: C401.2, C402.1, U400.6 (VDDM)
MAIN_VDRV: R403.1, R405.1, U400.8 (VDRV)
PGND: C400.2, R400.2, R401.2, R402.2, U400.4 (VSSP); also elsewhere on the board
Q400_GATE: Q400.1 (G), R403.2, R404.1
Q401_GATE: Q401.1 (G), R405.2, R406.1

Notes on the sheet:
NO ENERGIZE: 0R EN inhibit fitted; sequencer and CTRL3V3 buck NOT IMPLEMENTED.
150V IRFP4568PbF TO-247AC G=1 D=2 S=3 (PD-96175). SOA, clamp and thermal qualification remain OPEN.
Common-source node floats: NEVER PGND. CDIV2/CDIV1 worst 470*.95/(100*1.05)=4.25 > 3.
EN not gate feedback. No MAIN_PROVEN, timeout, PM-quiet or current detector claimed.
PWR_FLAG MAIN_SOURCE: floating common-source node of Q400/Q401

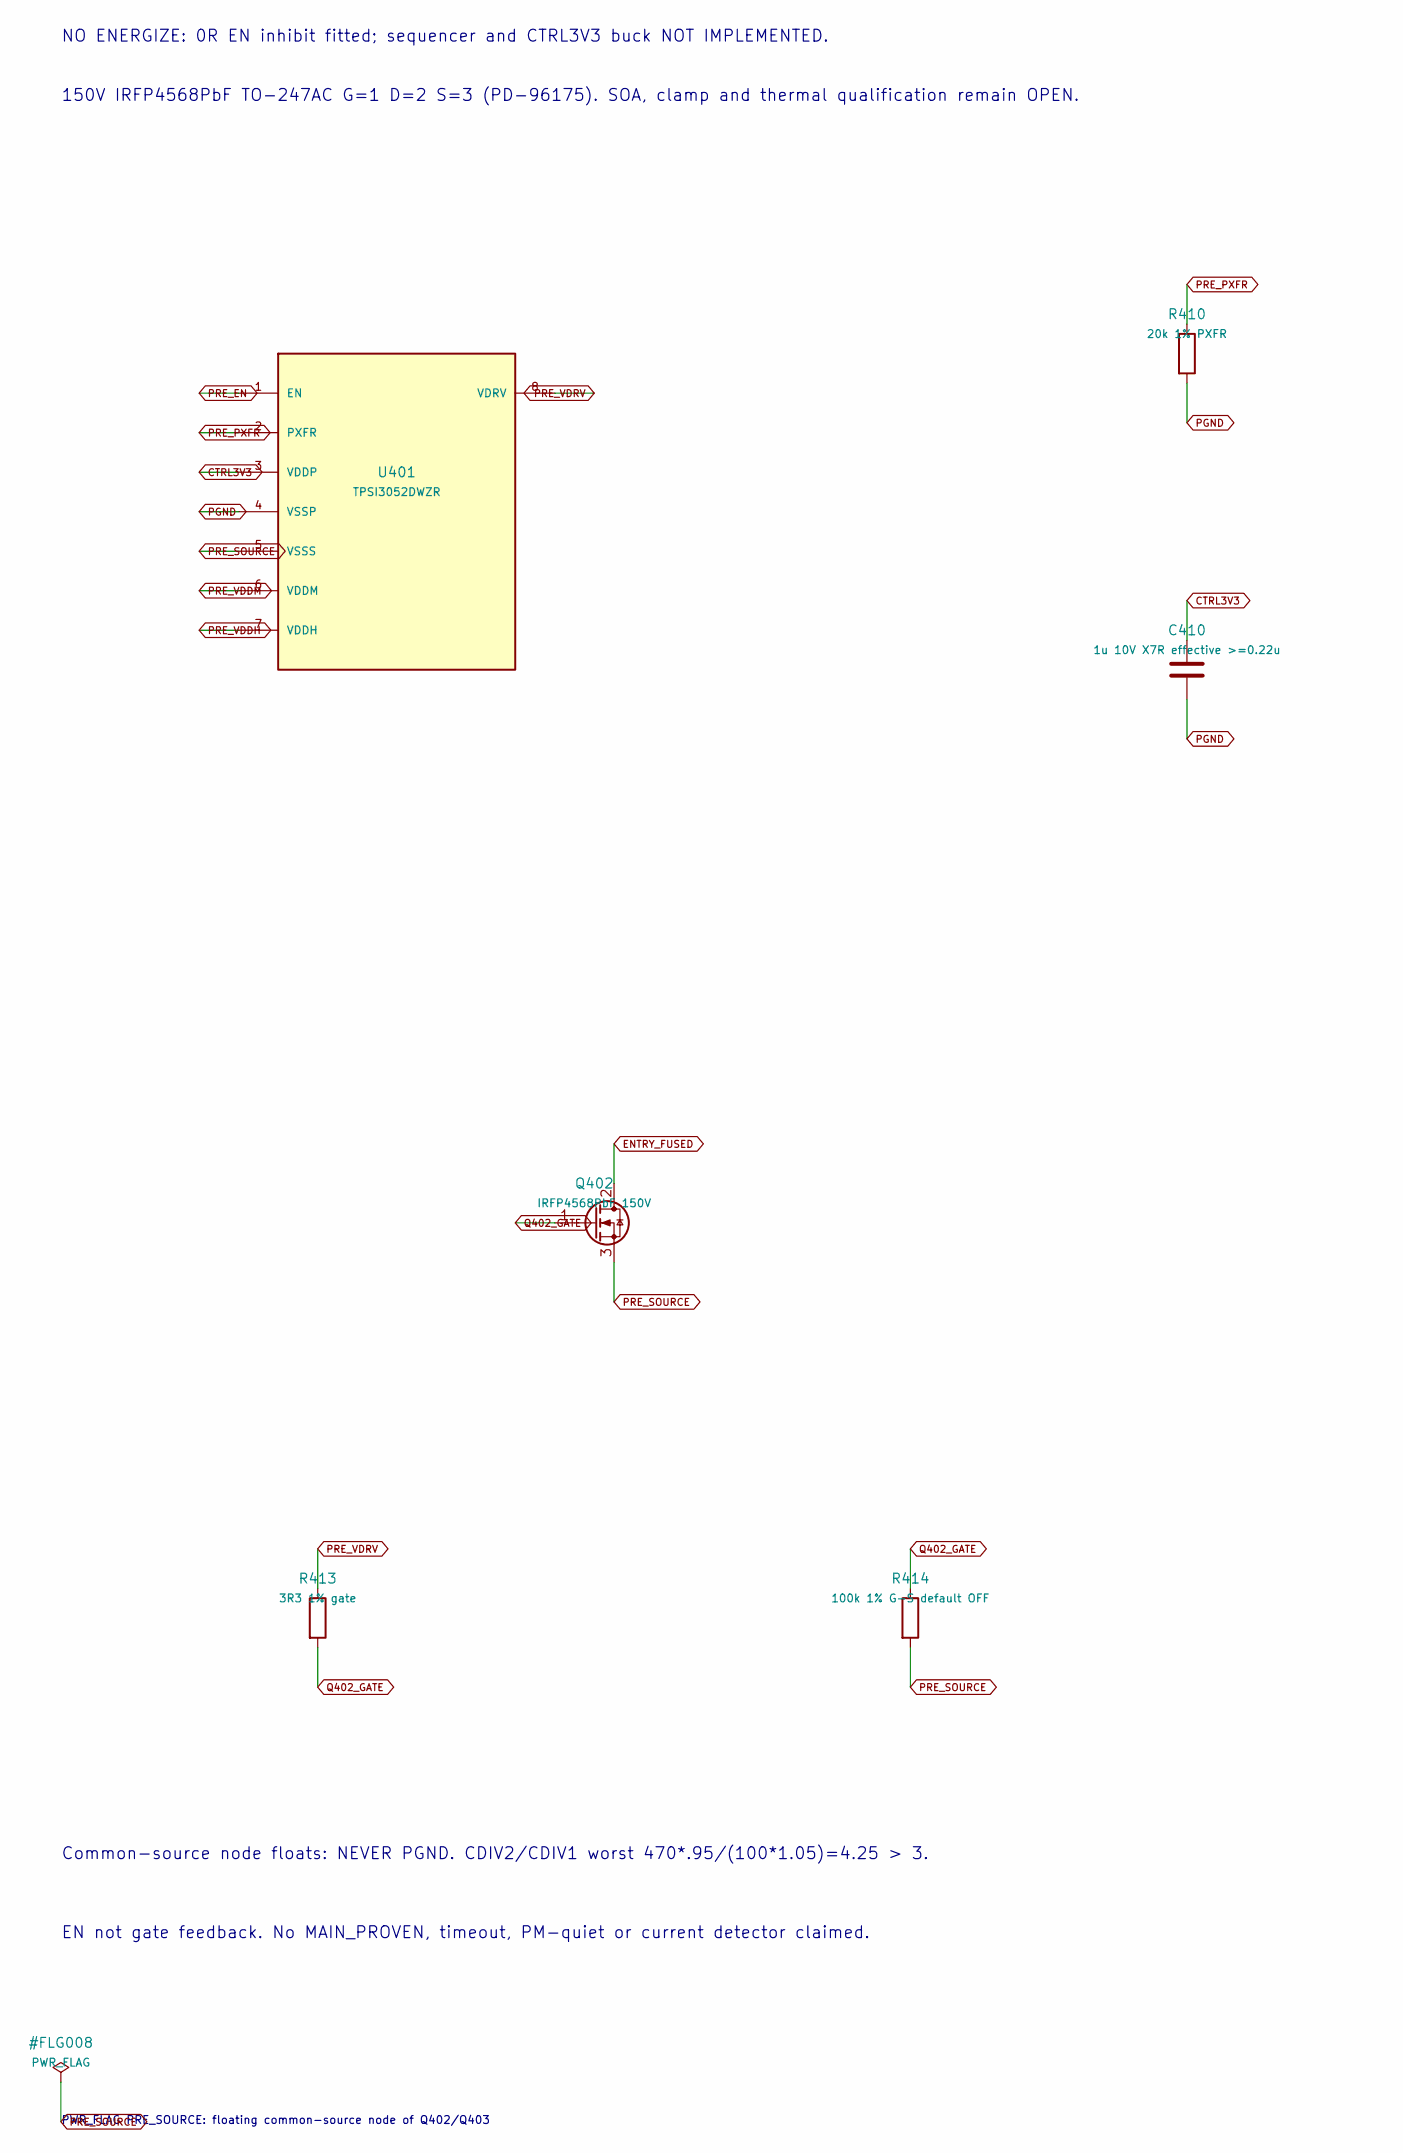
[picture p79: schematic entry-pre.kicad_sch, PRE back-to-back candidate - hardware inhibited, part in row 1, column 1]

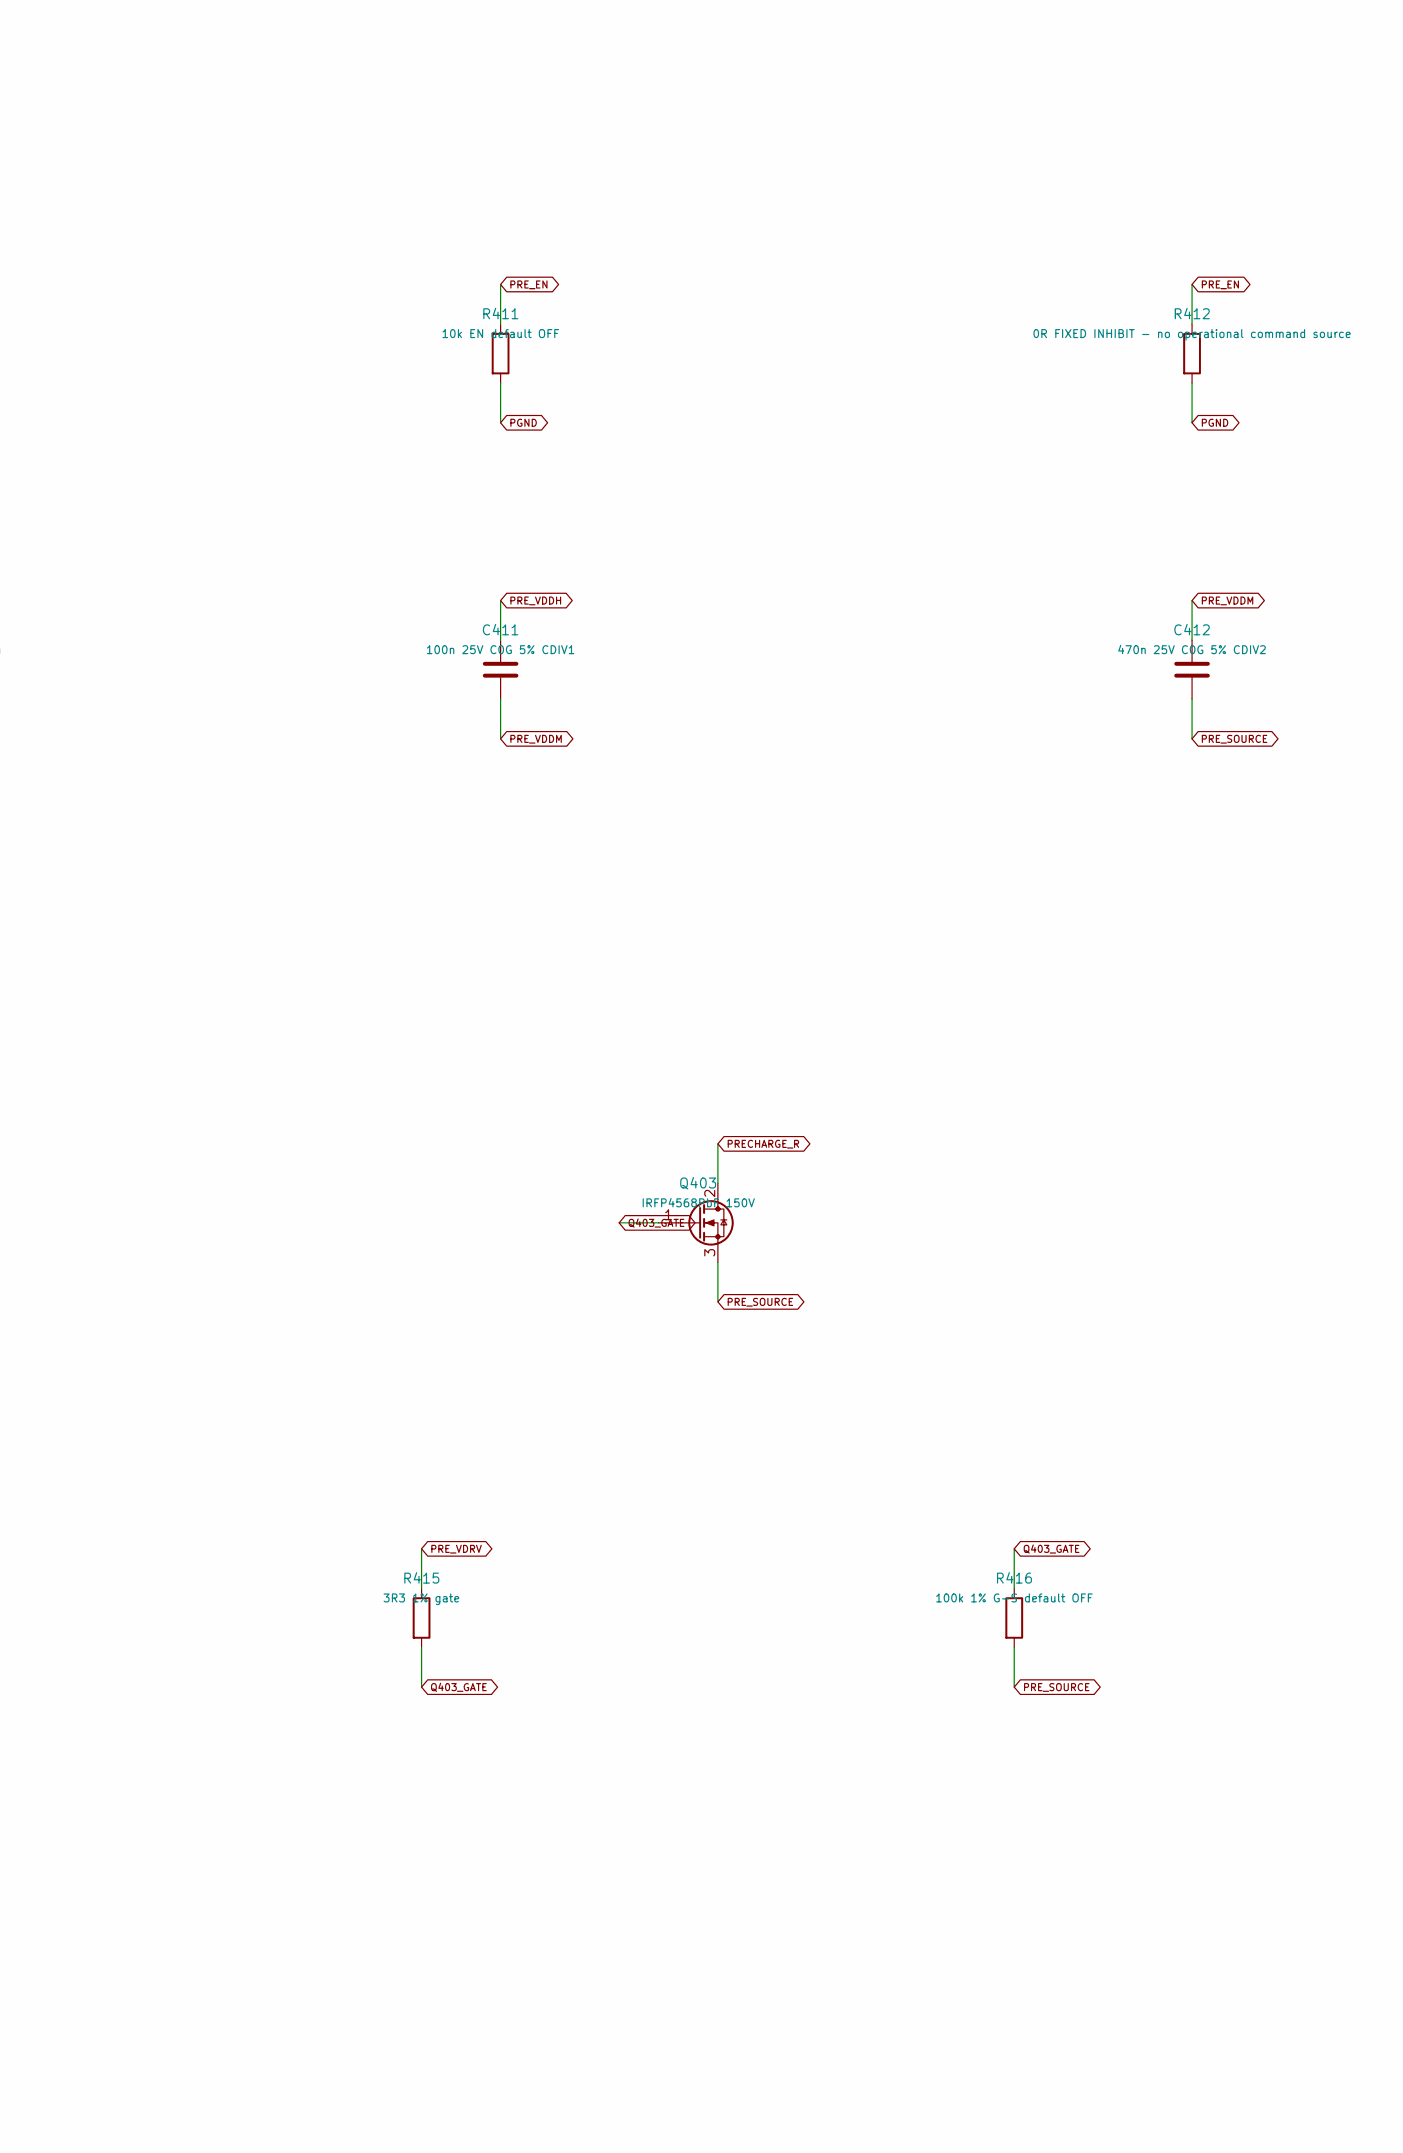
[picture p80: schematic entry-pre.kicad_sch, PRE back-to-back candidate - hardware inhibited, part in row 1, column 2]

Parts:
C410: 1u 10V X7R effective >=0.22u; C_0603_1608Metric
C411: 100n 25V C0G 5% CDIV1; C_0805_2012Metric
C412: 470n 25V C0G 5% CDIV2; C_0805_2012Metric
Q402, Q403: IRFP4568PbF 150V; TO-247-3_Vertical
R410: 20k 1% PXFR; R_0805_2012Metric
R411: 10k EN default OFF; R_0805_2012Metric
R412: 0R FIXED INHIBIT - no operational command source; R_0805_2012Metric
R413, R415: 3R3 1% gate; R_0805_2012Metric
R414, R416: 100k 1% G-S default OFF; R_0805_2012Metric
U401: TPSI3052DWZR; SOIC-8_5.3x5.3mm_P1.27mm

Connections:
CTRL3V3: C410.1, U401.3 (VDDP); also elsewhere on the board
ENTRY_FUSED: Q402.2 (D); also elsewhere on the board
PGND: C410.2, R410.2, R411.2, R412.2, U401.4 (VSSP); also elsewhere on the board
PRECHARGE_R: Q403.2 (D); also elsewhere on the board
PRE_EN: R411.1, R412.1, U401.1 (EN)
PRE_PXFR: R410.1, U401.2 (PXFR)
PRE_SOURCE: C412.2, Q402.3 (S), Q403.3 (S), R414.2, R416.2, U401.5 (VSSS)
PRE_VDDH: C411.1, U401.7 (VDDH)
PRE_VDDM: C411.2, C412.1, U401.6 (VDDM)
PRE_VDRV: R413.1, R415.1, U401.8 (VDRV)
Q402_GATE: Q402.1 (G), R413.2, R414.1
Q403_GATE: Q403.1 (G), R415.2, R416.1

Notes on the sheet:
NO ENERGIZE: 0R EN inhibit fitted; sequencer and CTRL3V3 buck NOT IMPLEMENTED.
150V IRFP4568PbF TO-247AC G=1 D=2 S=3 (PD-96175). SOA, clamp and thermal qualification remain OPEN.
Common-source node floats: NEVER PGND. CDIV2/CDIV1 worst 470*.95/(100*1.05)=4.25 > 3.
EN not gate feedback. No MAIN_PROVEN, timeout, PM-quiet or current detector claimed.
PWR_FLAG PRE_SOURCE: floating common-source node of Q402/Q403

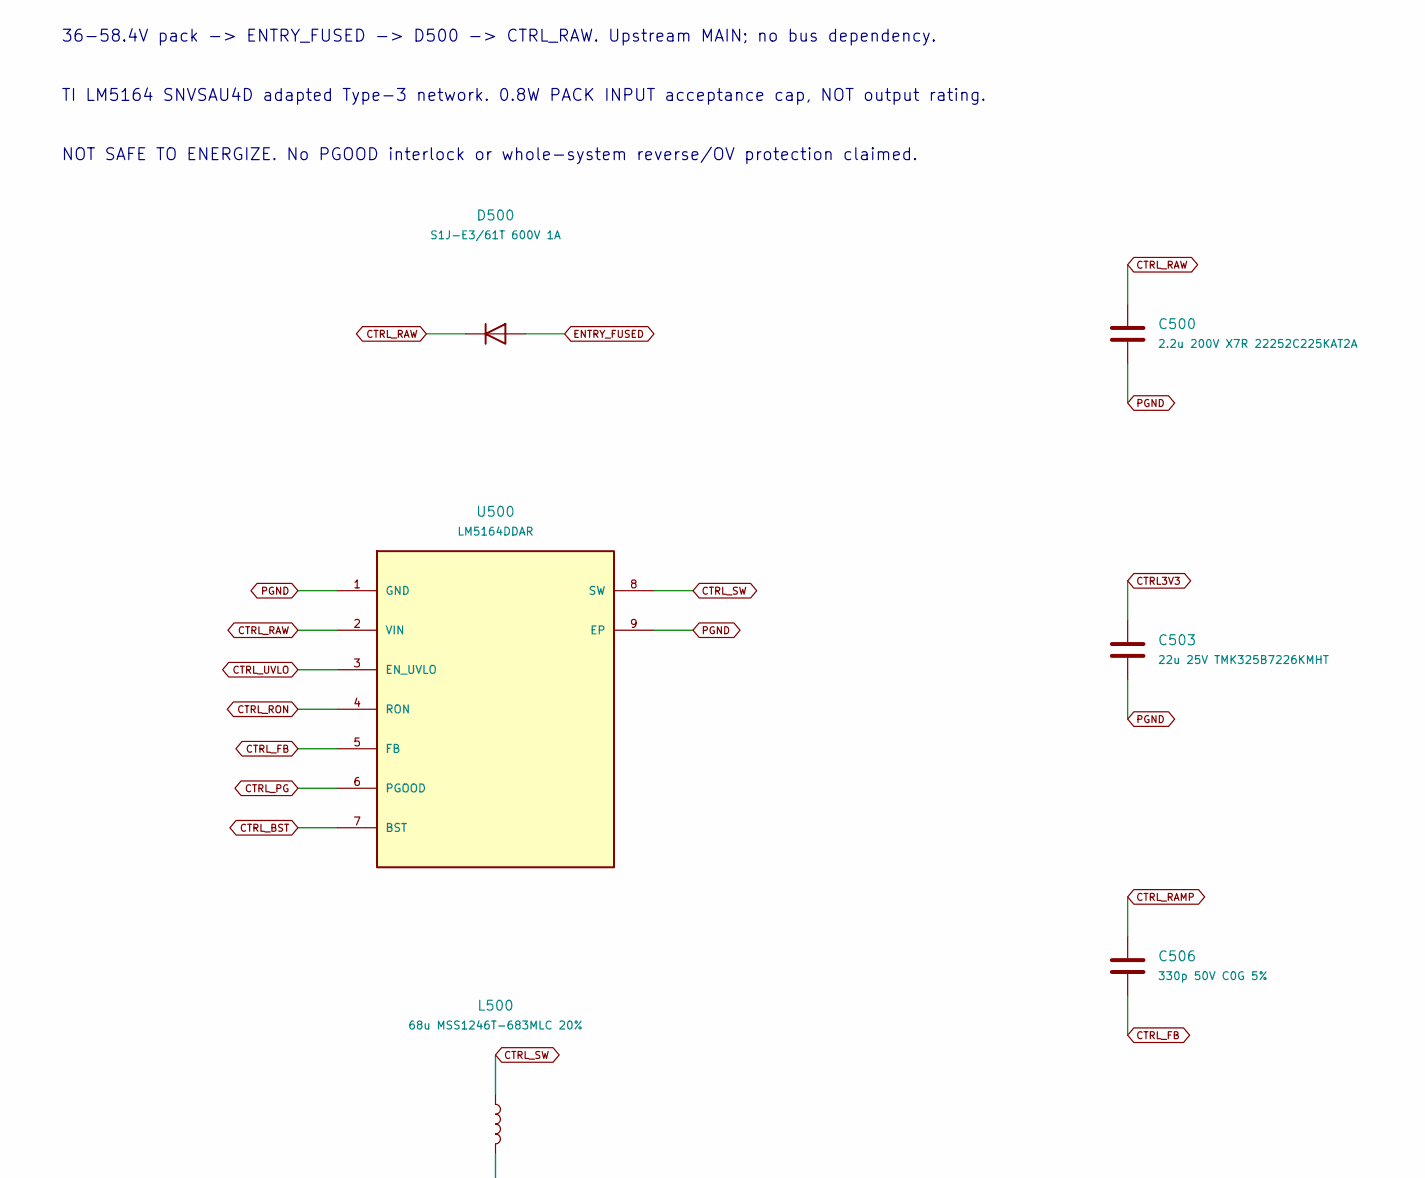
[picture p81: schematic ctrl-supply.kicad_sch, CTRL3V3 pack-side buck - unqualified, enables inhibited, part in row 1, column 1]

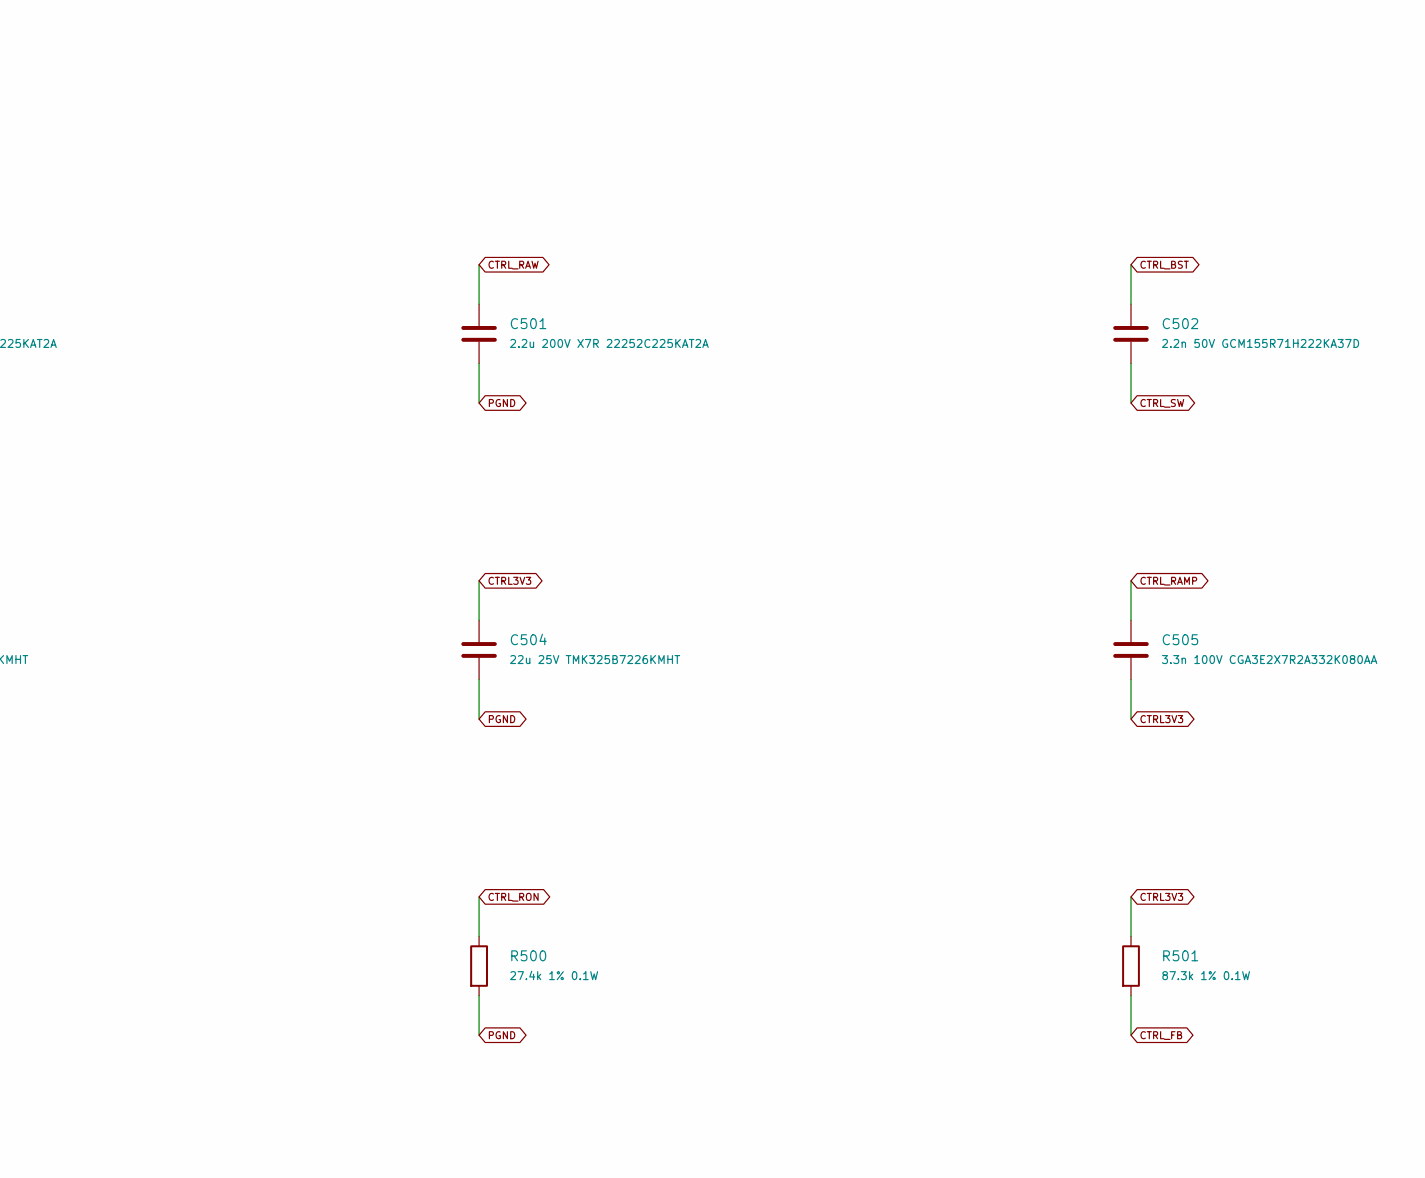
[picture p82: schematic ctrl-supply.kicad_sch, CTRL3V3 pack-side buck - unqualified, enables inhibited, part in row 1, column 2]

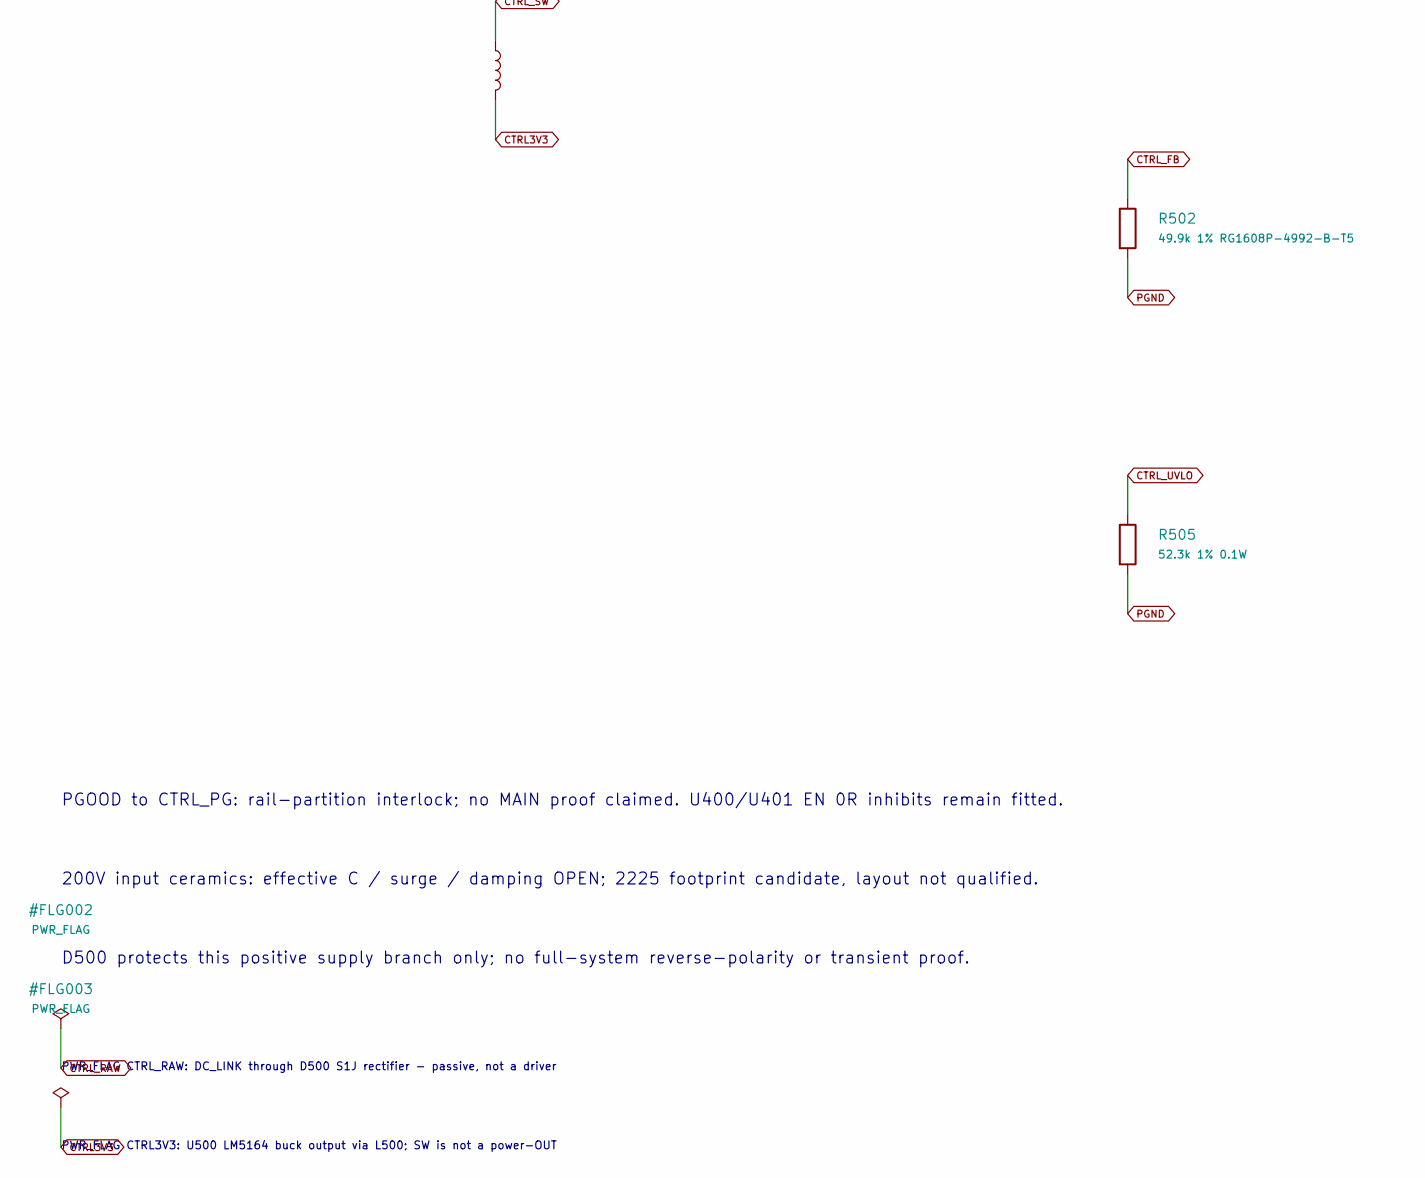
[picture p83: schematic ctrl-supply.kicad_sch, CTRL3V3 pack-side buck - unqualified, enables inhibited, part in row 2, column 1]

Parts:
C500, C501: 2.2u 200V X7R 22252C225KAT2A; C_2225_5664Metric
C502: 2.2n 50V GCM155R71H222KA37D; C_0402_1005Metric
C503, C504: 22u 25V TMK325B7226KMHT; C_1210_3225Metric
C505: 3.3n 100V CGA3E2X7R2A332K080AA; C_0603_1608Metric
C506: 330p 50V C0G 5%; C_0805_2012Metric
D500: S1J-E3/61T 600V 1A; D_SMA
L500: 68u MSS1246T-683MLC 20%; L_Coilcraft_MSS1246T-XXX
R500: 27.4k 1% 0.1W; R_0805_2012Metric
R501: 87.3k 1% 0.1W; R_0805_2012Metric
R502: 49.9k 1% RG1608P-4992-B-T5; R_0603_1608Metric
R503: 150k 1% 0.1W >=100V; R_0805_2012Metric
R504: 1M 1% 0.1W >=100V; R_0805_2012Metric
R505: 52.3k 1% 0.1W; R_0805_2012Metric
U500: LM5164DDAR; HSOP-8-1EP_3.9x4.9mm_P1.27mm_EP2.3x2.3mm

Connections:
CTRL3V3: C503.1, C504.1, C505.2, L500.2, R501.1; also elsewhere on the board
CTRL_BST: C502.1, U500.7 (BST)
CTRL_FB: C506.2, R501.2, R502.1, U500.5 (FB)
CTRL_PG: U500.6 (PGOOD); also elsewhere on the board
CTRL_RAMP: C505.1, C506.1, R503.2
CTRL_RAW: C500.1, C501.1, D500.1 (K), R504.1, U500.2 (VIN)
CTRL_RON: R500.1, U500.4 (RON)
CTRL_SW: C502.2, L500.1, R503.1, U500.8 (SW)
CTRL_UVLO: R504.2, R505.1, U500.3 (EN_UVLO)
ENTRY_FUSED: D500.2 (A); also elsewhere on the board
PGND: C500.2, C501.2, C503.2, C504.2, R500.2, R502.2, R505.2, U500.1 (GND), U500.9 (EP); also elsewhere on the board

Notes on the sheet:
36-58.4V pack -> ENTRY_FUSED -> D500 -> CTRL_RAW. Upstream MAIN; no bus dependency.
TI LM5164 SNVSAU4D adapted Type-3 network. 0.8W PACK INPUT acceptance cap, NOT output rating.
NOT SAFE TO ENERGIZE. No PGOOD interlock or whole-system reverse/OV protection claimed.
PGOOD to CTRL_PG: rail-partition interlock; no MAIN proof claimed. U400/U401 EN 0R inhibits remain fitted.
200V input ceramics: effective C / surge / damping OPEN; 2225 footprint candidate, layout not qualified.
D500 protects this positive supply branch only; no full-system reverse-polarity or transient proof.
PWR_FLAG CTRL_RAW: DC_LINK through D500 S1J rectifier - passive, not a driver
PWR_FLAG CTRL3V3: U500 LM5164 buck output via L500; SW is not a power-OUT
