felixfelix-bot/cycle-without-chain/hardware/powerboard-reva/powerboard-reva.kicad_pcb

## KiCad design hardware/powerboard-reva/powerboard-reva.kicad_pcb (continued)

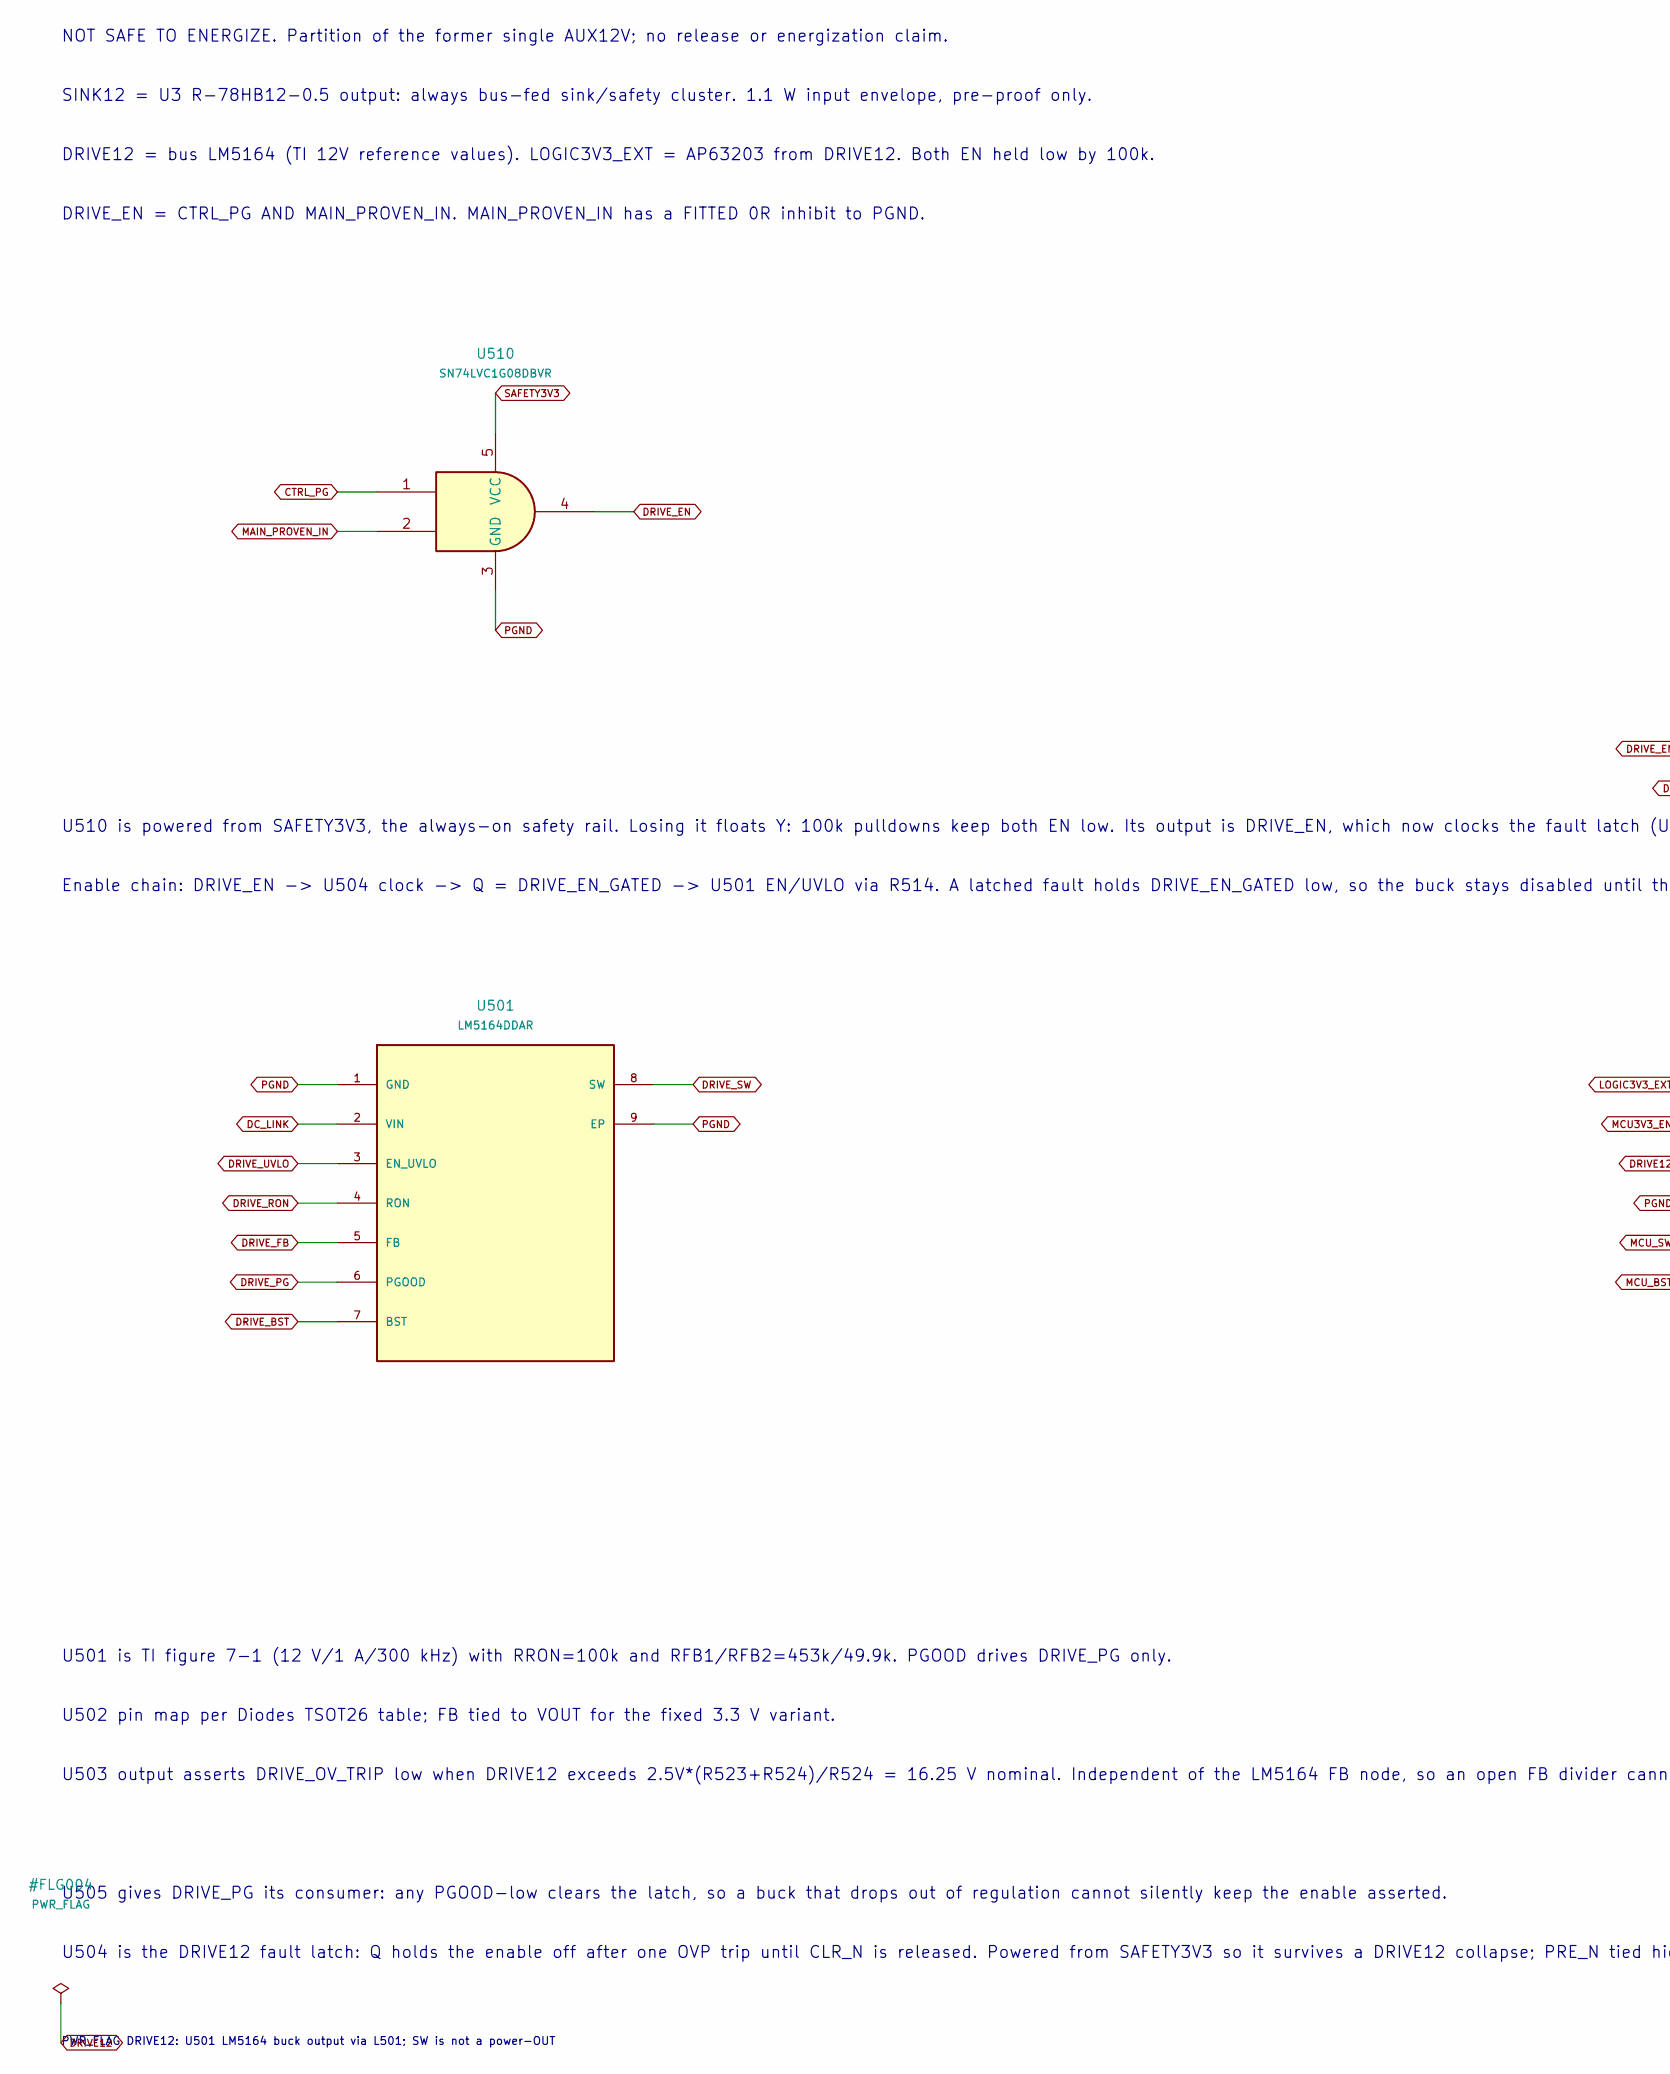
[picture p84: schematic rail-partition.kicad_sch, Rail partition: SINK12 always-on, DRIVE12/MCU3V3 delayed an…, part in row 1, column 1]

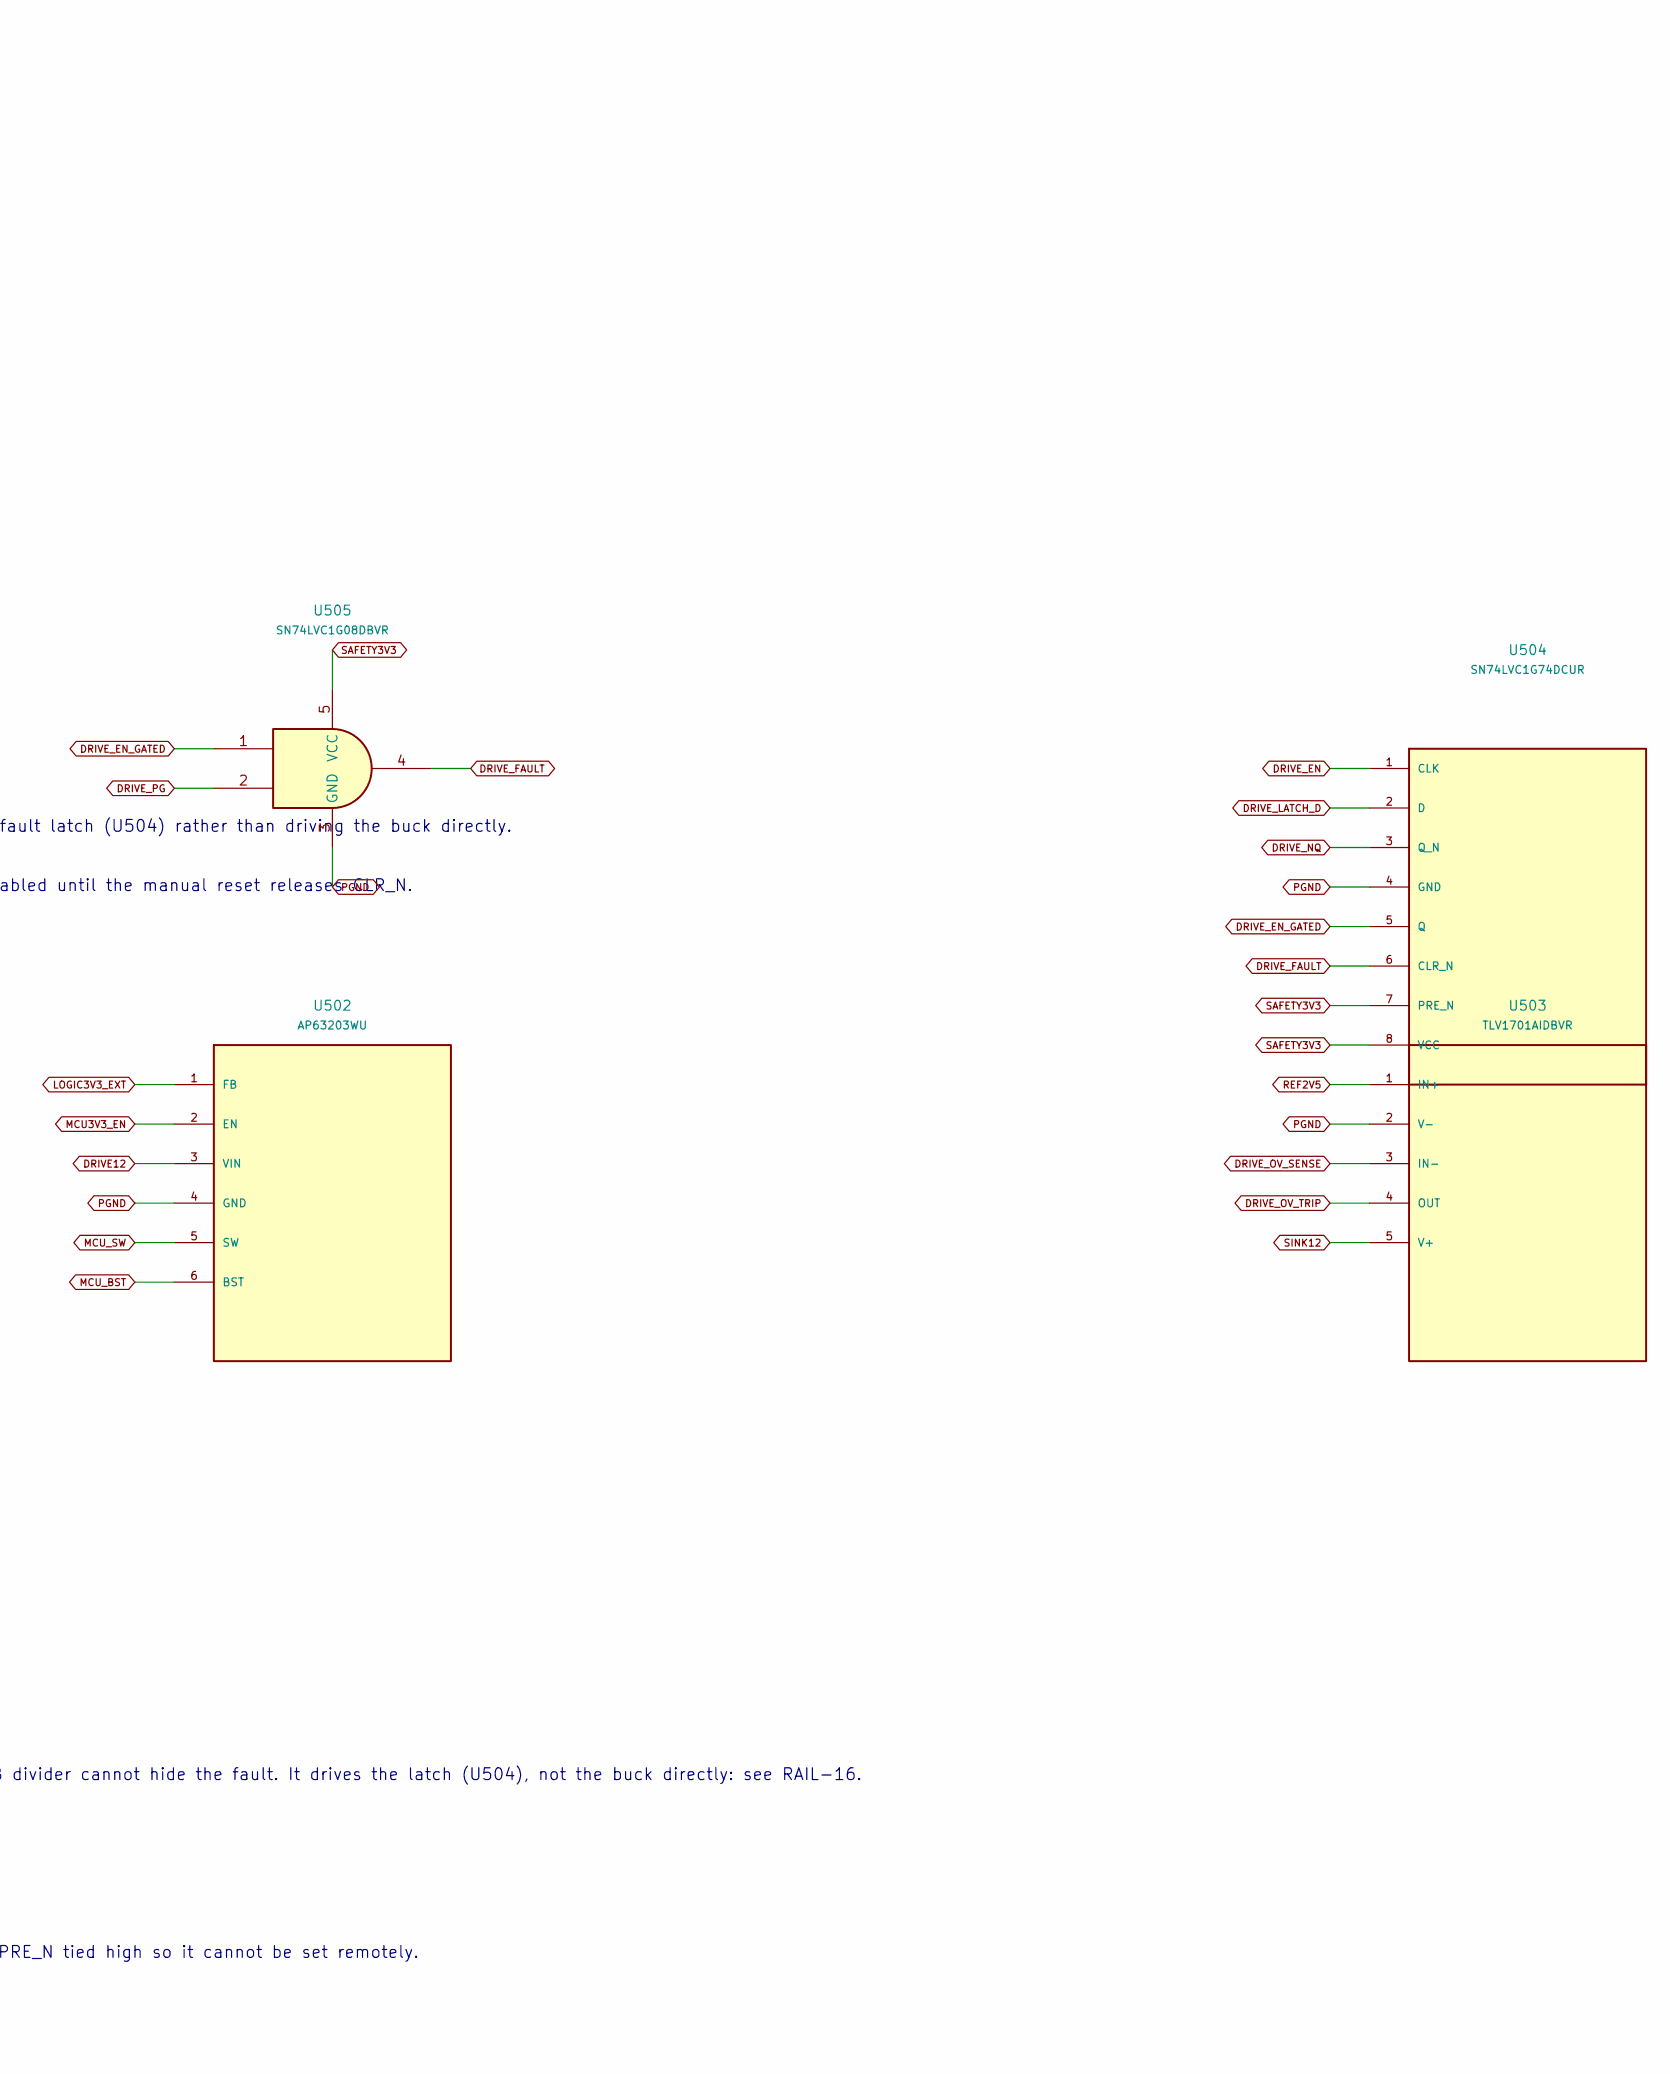
[picture p85: schematic rail-partition.kicad_sch, Rail partition: SINK12 always-on, DRIVE12/MCU3V3 delayed an…, part in row 1, column 2]

Parts:
U501: LM5164DDAR; HSOP-8-1EP_3.9x4.9mm_P1.27mm_EP2.3x2.3mm
U502: AP63203WU; TSOT-23-6
U503: TLV1701AIDBVR; SOT-23-5
U504: SN74LVC1G74DCUR; VSSOP-8_2.3x2mm_P0.5mm
U505, U510: SN74LVC1G08DBVR; SOT-23-5

Connections:
CTRL_PG: U510.1; also elsewhere on the board
DC_LINK: U501.2 (VIN); also elsewhere on the board
DRIVE12: U502.3 (VIN); also elsewhere on the board
DRIVE_BST: U501.7 (BST); also elsewhere on the board
DRIVE_EN: U504.1 (CLK), U510.4; also elsewhere on the board
DRIVE_EN_GATED: U504.5 (Q), U505.1; also elsewhere on the board
DRIVE_FAULT: U504.6 (CLR_N), U505.4; also elsewhere on the board
DRIVE_FB: U501.5 (FB); also elsewhere on the board
DRIVE_LATCH_D: U504.2 (D); also elsewhere on the board
DRIVE_NQ: U504.3 (Q_N); also elsewhere on the board
DRIVE_OV_SENSE: U503.3 (IN-); also elsewhere on the board
DRIVE_OV_TRIP: U503.4 (OUT); also elsewhere on the board
DRIVE_PG: U501.6 (PGOOD), U505.2; also elsewhere on the board
DRIVE_RON: U501.4 (RON); also elsewhere on the board
DRIVE_SW: U501.8 (SW); also elsewhere on the board
DRIVE_UVLO: U501.3 (EN_UVLO); also elsewhere on the board
LOGIC3V3_EXT: U502.1 (FB); also elsewhere on the board
MAIN_PROVEN_IN: U510.2; also elsewhere on the board
MCU3V3_EN: U502.2 (EN); also elsewhere on the board
MCU_BST: U502.6 (BST); also elsewhere on the board
MCU_SW: U502.5 (SW); also elsewhere on the board
PGND: U501.1 (GND), U501.9 (EP), U502.4 (GND), U503.2 (V-), U504.4 (GND), U505.3 (GND), U510.3 (GND); also elsewhere on the board
REF2V5: U503.1 (IN+); also elsewhere on the board
SAFETY3V3: U504.7 (PRE_N), U504.8 (VCC), U505.5 (VCC), U510.5 (VCC); also elsewhere on the board
SINK12: U503.5 (V+); also elsewhere on the board

Notes on the sheet:
NOT SAFE TO ENERGIZE. Partition of the former single AUX12V; no release or energization claim.
SINK12 = U3 R-78HB12-0.5 output: always bus-fed sink/safety cluster. 1.1 W input envelope, pre-proof only.
DRIVE12 = bus LM5164 (TI 12V reference values). LOGIC3V3_EXT = AP63203 from DRIVE12. Both EN held low by 100k.
DRIVE_EN = CTRL_PG AND MAIN_PROVEN_IN. MAIN_PROVEN_IN has a FITTED 0R inhibit to PGND.
U510 is powered from SAFETY3V3, the always-on safety rail. Losing it floats Y: 100k pulldowns keep both EN low. Its output is DRIVE_EN, which now clocks the fault latch (U504) rather than driving the buck directly.
Enable chain: DRIVE_EN -> U504 clock -> Q = DRIVE_EN_GATED -> U501 EN/UVLO via R514. A latched fault holds DRIVE_EN_GATED low, so the buck stays disabled until the manual reset releases CLR_N.
U501 is TI figure 7-1 (12 V/1 A/300 kHz) with RRON=100k and RFB1/RFB2=453k/49.9k. PGOOD drives DRIVE_PG only.
U503 output asserts DRIVE_OV_TRIP low when DRIVE12 exceeds 2.5V*(R523+R524)/R524 = 16.25 V nominal. Independent of the LM5164 FB node, so an open FB divider cannot hide the fault. It drives the latch (U504), not the buck directly: see RAIL-16.
U504 is the DRIVE12 fault latch: Q holds the enable off after one OVP trip until CLR_N is released. Powered from SAFETY3V3 so it survives a DRIVE12 collapse; PRE_N tied high so it cannot be set remotely.
U505 gives DRIVE_PG its consumer: any PGOOD-low clears the latch, so a buck that drops out of regulation cannot silently keep the enable asserted.
U502 pin map per Diodes TSOT26 table; FB tied to VOUT for the fixed 3.3 V variant.
PWR_FLAG DRIVE12: U501 LM5164 buck output via L501; SW is not a power-OUT

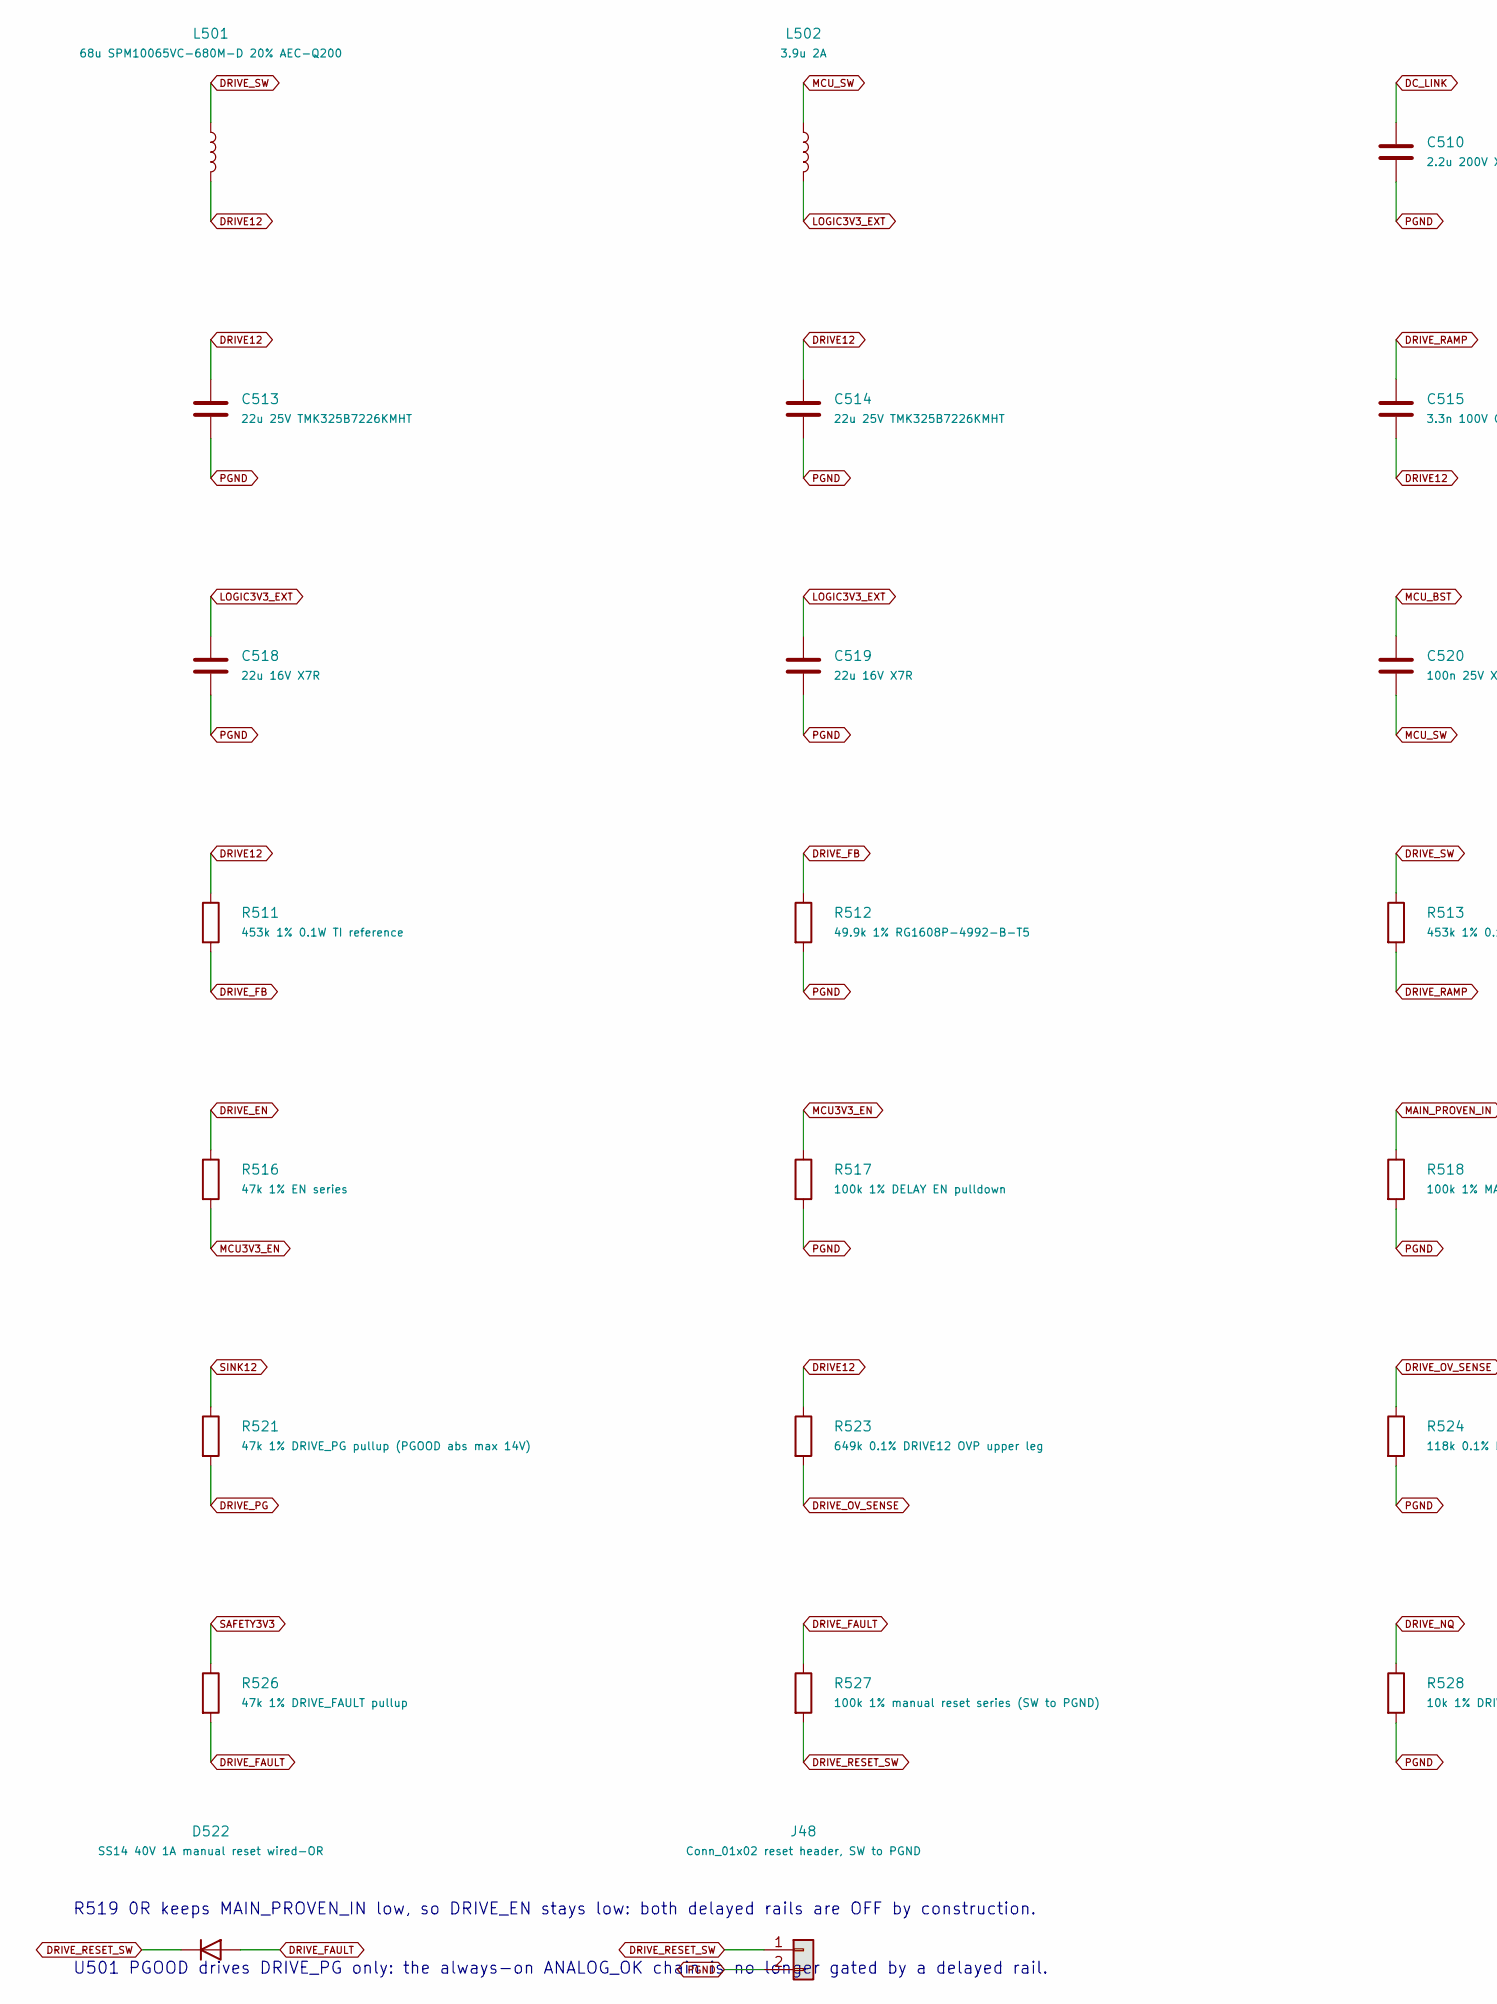
[picture p86: schematic rail-passives.kicad_sch, Rail partition passive networks - unqualified, part in row 1, column 1]

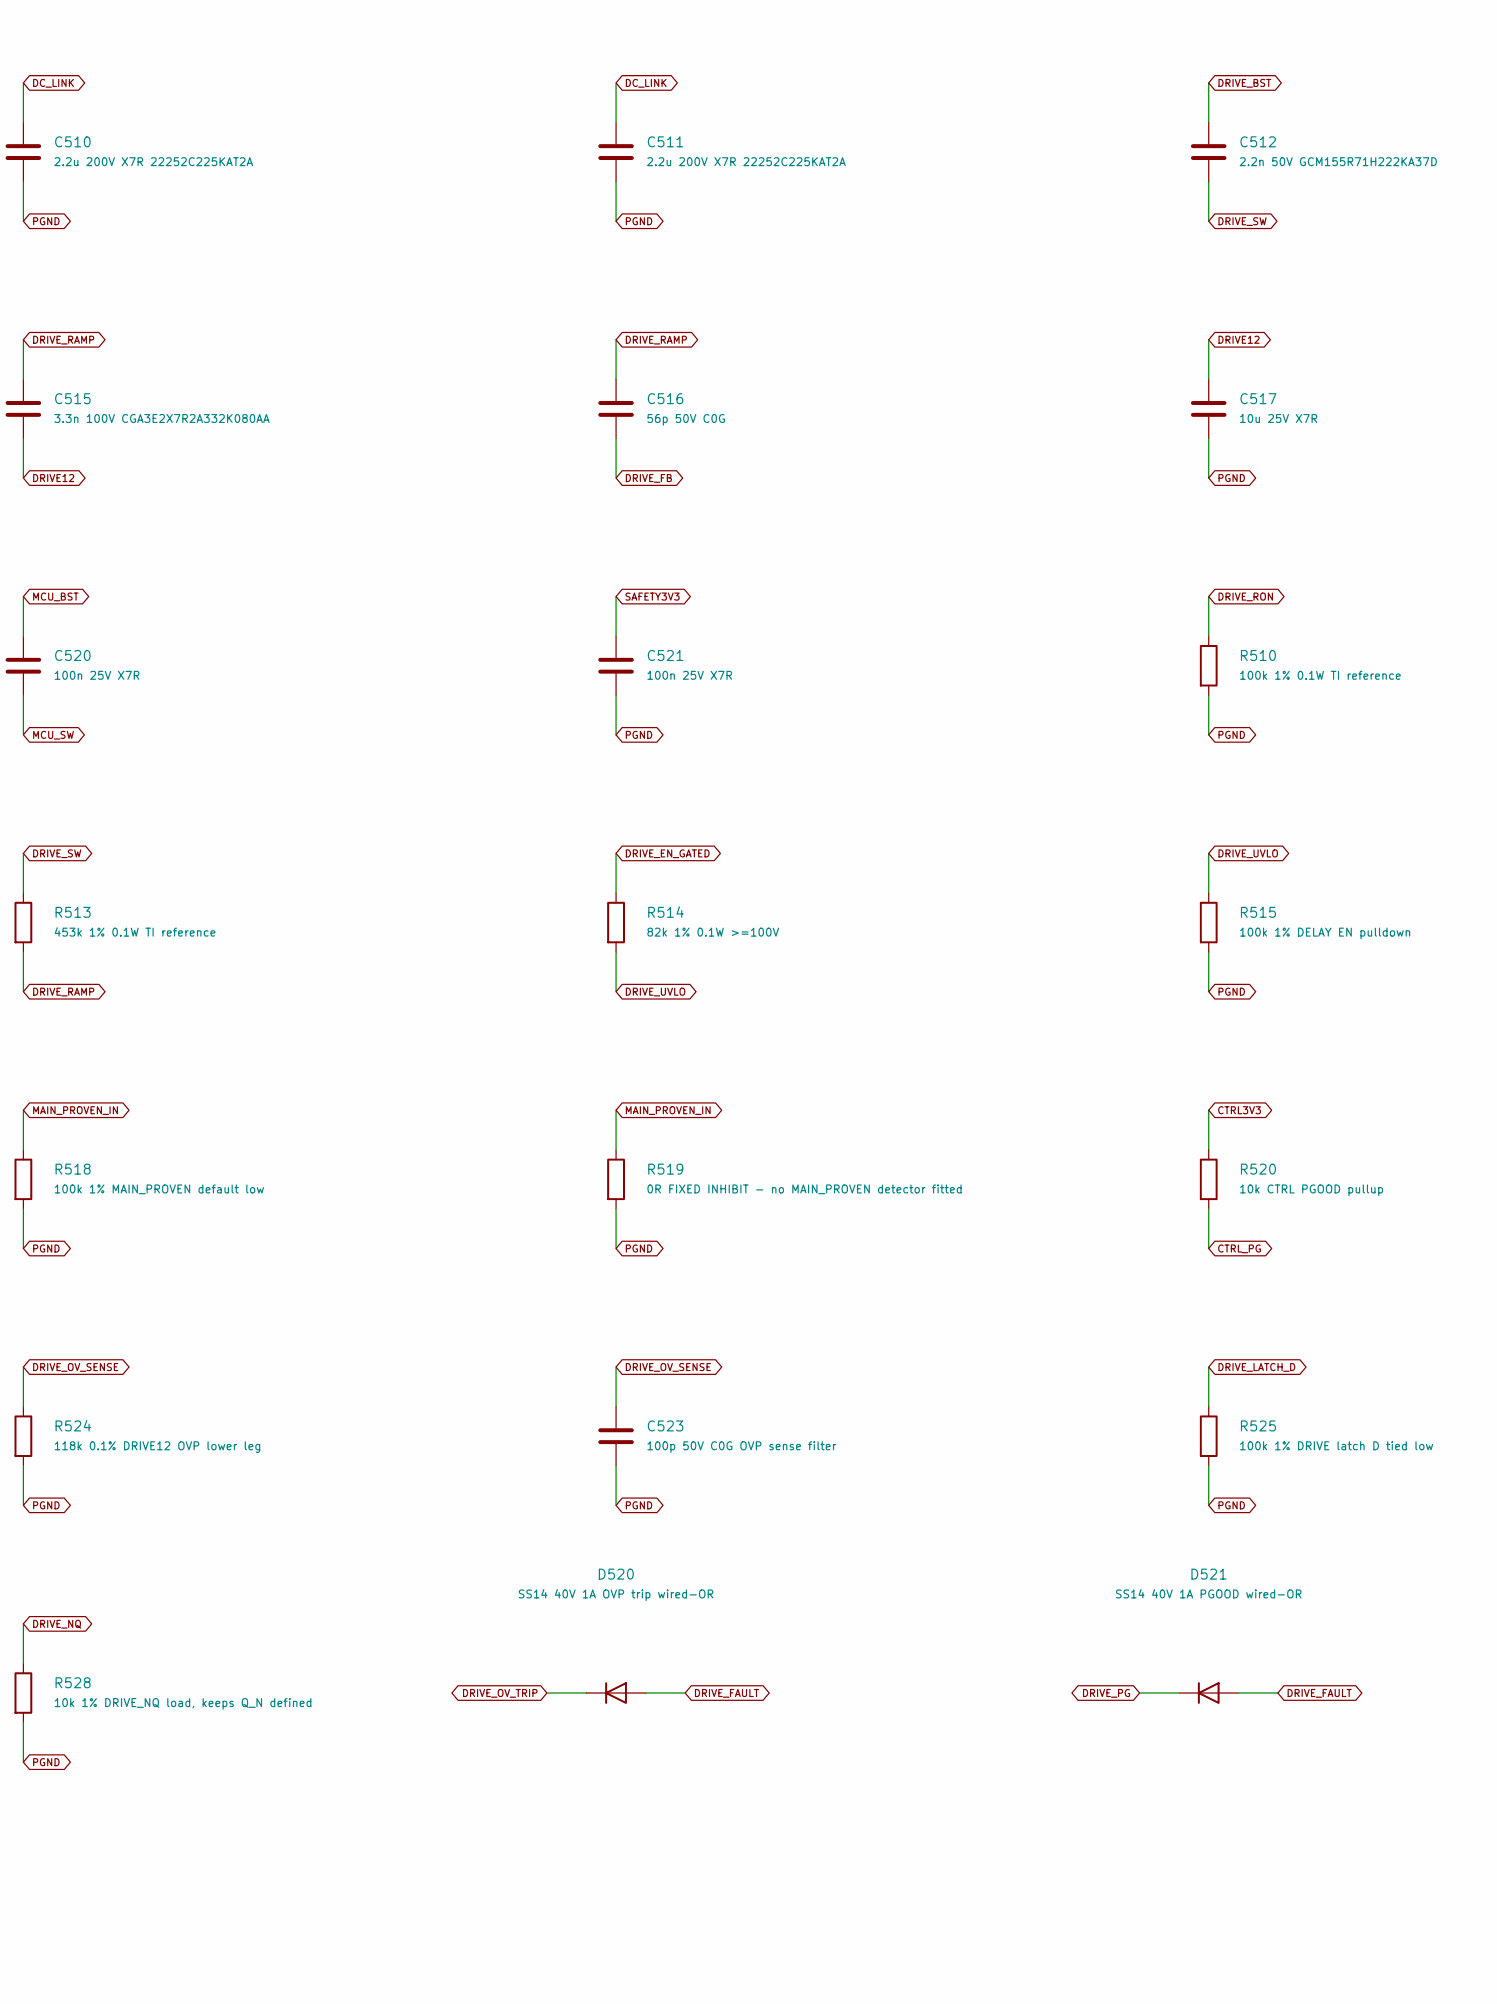
[picture p87: schematic rail-passives.kicad_sch, Rail partition passive networks - unqualified, part in row 1, column 2]

Parts:
C510, C511: 2.2u 200V X7R 22252C225KAT2A; C_2225_5664Metric
C512: 2.2n 50V GCM155R71H222KA37D; C_0402_1005Metric
C513, C514: 22u 25V TMK325B7226KMHT; C_1210_3225Metric
C515: 3.3n 100V CGA3E2X7R2A332K080AA; C_0603_1608Metric
C516: 56p 50V C0G; C_0805_2012Metric
C517: 10u 25V X7R; C_0805_2012Metric
C518, C519: 22u 16V X7R; C_1206_3216Metric
C520, C521: 100n 25V X7R; C_0805_2012Metric
C523: 100p 50V C0G OVP sense filter; C_0805_2012Metric
D520: SS14 40V 1A OVP trip wired-OR; D_SMA
D521: SS14 40V 1A PGOOD wired-OR; D_SMA
D522: SS14 40V 1A manual reset wired-OR; D_SMA
J48: Conn_01x02 reset header, SW to PGND; PinHeader_1x02_P2.54mm_Vertical
L501: 68u SPM10065VC-680M-D 20% AEC-Q200; L_TDK_SPM10065VC-D
L502: 3.9u 2A; L_Bourns_SRN6045TA
R510: 100k 1% 0.1W TI reference; R_0805_2012Metric
R511, R513: 453k 1% 0.1W TI reference; R_0805_2012Metric
R512: 49.9k 1% RG1608P-4992-B-T5; R_0603_1608Metric
R514: 82k 1% 0.1W >=100V; R_0805_2012Metric
R515, R517: 100k 1% DELAY EN pulldown; R_0805_2012Metric
R516: 47k 1% EN series; R_0805_2012Metric
R518: 100k 1% MAIN_PROVEN default low; R_0805_2012Metric
R519: 0R FIXED INHIBIT - no MAIN_PROVEN detector fitted; R_0805_2012Metric
R520: 10k CTRL PGOOD pullup; R_0805_2012Metric
R521: 47k 1% DRIVE_PG pullup (PGOOD abs max 14V); R_0805_2012Metric
R523: 649k 0.1% DRIVE12 OVP upper leg; R_0805_2012Metric
R524: 118k 0.1% DRIVE12 OVP lower leg; R_0805_2012Metric
R525: 100k 1% DRIVE latch D tied low; R_0805_2012Metric
R526: 47k 1% DRIVE_FAULT pullup; R_0805_2012Metric
R527: 100k 1% manual reset series (SW to PGND); R_0805_2012Metric
R528: 10k 1% DRIVE_NQ load, keeps Q_N defined; R_0805_2012Metric

Connections:
CTRL3V3: R520.1; also elsewhere on the board
CTRL_PG: R520.2; also elsewhere on the board
DC_LINK: C510.1, C511.1; also elsewhere on the board
DRIVE12: C513.1, C514.1, C515.2, C517.1, L501.2, R511.1, R523.1; also elsewhere on the board
DRIVE_BST: C512.1; also elsewhere on the board
DRIVE_EN: R516.1; also elsewhere on the board
DRIVE_EN_GATED: R514.1; also elsewhere on the board
DRIVE_FAULT: D520.2 (A), D521.2 (A), D522.2 (A), R526.2, R527.1; also elsewhere on the board
DRIVE_FB: C516.2, R511.2, R512.1; also elsewhere on the board
DRIVE_LATCH_D: R525.1; also elsewhere on the board
DRIVE_NQ: R528.1; also elsewhere on the board
DRIVE_OV_SENSE: C523.1, R523.2, R524.1; also elsewhere on the board
DRIVE_OV_TRIP: D520.1 (K); also elsewhere on the board
DRIVE_PG: D521.1 (K), R521.2; also elsewhere on the board
DRIVE_RAMP: C515.1, C516.1, R513.2
DRIVE_RESET_SW: D522.1 (K), J48.1, R527.2
DRIVE_RON: R510.1; also elsewhere on the board
DRIVE_SW: C512.2, L501.1, R513.1; also elsewhere on the board
DRIVE_UVLO: R514.2, R515.1; also elsewhere on the board
LOGIC3V3_EXT: C518.1, C519.1, L502.2; also elsewhere on the board
MAIN_PROVEN_IN: R518.1, R519.1; also elsewhere on the board
MCU3V3_EN: R516.2, R517.1; also elsewhere on the board
MCU_BST: C520.1; also elsewhere on the board
MCU_SW: C520.2, L502.1; also elsewhere on the board
PGND: C510.2, C511.2, C513.2, C514.2, C517.2, C518.2, C519.2, C521.2, C523.2, J48.2, R510.2, R512.2, R515.2, R517.2, R518.2, R519.2, R524.2, R525.2, R528.2; also elsewhere on the board
SAFETY3V3: C521.1, R526.1; also elsewhere on the board
SINK12: R521.1; also elsewhere on the board

Notes on the sheet:
R519 0R keeps MAIN_PROVEN_IN low, so DRIVE_EN stays low: both delayed rails are OFF by construction.
U501 PGOOD drives DRIVE_PG only: the always-on ANALOG_OK chain is no longer gated by a delayed rail.

Board: 4 copper layers, 397 parts (0 on the bottom side), 226 nets, no tracks yet.
