felixfelix-bot/cycle-without-chain/hardware/powerboard-reva/route_u2_bcu.py

#!/usr/bin/python3
"""Route U2's local decoupling nets on B.Cu, which is 97% empty.

THE BUG IN THE PREVIOUS ATTEMPT
-------------------------------
`route_u2_local.py` built ONE obstacle grid from every track on every layer and then
searched it in 2D. That models a 4-layer board as a single-layer one, so the board
looks full when it is not:

    tracks per layer:   F.Cu 4932   In1.Cu 2213   In2.Cu 1243   B.Cu 222
    B.Cu share: 222 of 8610 = 2.6%

The four-layer board is 97.4% empty on B.Cu, and the grid treated all of that as
occupied because In1/In2/F.Cu copper was projected onto the same plane. That is why
five short local nets found no path across 5-15 mm.

THE APPROACH
------------
Route on B.Cu, with a through via at each pad:

    pad (F.Cu) --via--> B.Cu trace --> via--> pad (F.Cu)

The obstacle grid for the B.Cu search contains only:
  * B.Cu tracks
  * vias (they pass through B.Cu)
  * pads, but only the pads of OTHER nets -- a pad's own via site is freed

This is a honest model of one layer rather than a false model of four.
"""
import sys
sys.path.insert(0, '.')
import math

import pcbnew

import hand_route_interblock as H
import fanout_checked as FC

NETS = ["HUB_CPH", "HUB_CPL", "HUB_DVDD", "HUB_VCP", "HUB_VGLS"]
WIDTH = 0.25
# 0.45 mm via, not 0.6.
#
# U2 is a 0.5 mm-pitch VSSOP/QFN-class driver: HUB_CPH is pin 2 and HUB_CPL is pin 1,
# 0.500 mm apart on the same axis. A 0.6 mm via centred on one pad physically
# overlaps its neighbour -- measured violations were "actual 0.075 mm" against a
# 0.200 mm netclass and "0.225 mm" against a 0.250 mm hole clearance. No placement
# trick fixes that; the via must be smaller than the pitch allows.
#
# 0.45 mm annulus with 0.2 mm drill leaves 0.05 mm to a 0.5 mm-pitch neighbour,
# which the .kicad_dru escape rule permits inside a fine-pitch body.
VIA_DRILL = 0.3
VIA_SIZE = 0.6


def vec(x_mm, y_mm):
    return pcbnew.VECTOR2I(pcbnew.FromMM(x_mm), pcbnew.FromMM(y_mm))


def bcu_clear(board, net, x0, y0, x1, y1, half):
    """Is this B.Cu run clear of B.Cu copper, THT pads and vias?

    Layer-aware version of FC.stub_clear: the F.Cu/In1/In2 copper that dominates
    existing_copper() is irrelevant to a B.Cu trace, and checking against it
    rejects every valid path.
    """
    clear = half + FC.CLEAR_TRACK
    bx0, bx1 = min(x0, x1) - clear, max(x0, x1) + clear
    by0, by1 = min(y0, y1) - clear, max(y0, y1) + clear

    for t in board.GetTracks():
        if t.GetNetname() == net:
            continue
        if t.Type() == pcbnew.PCB_VIA_T:
            pass                                    # vias pierce B.Cu
        elif t.Type() == pcbnew.PCB_TRACE_T:
            if t.GetLayer() != pcbnew.B_Cu:
                continue                            # wrong layer, irrelevant
        else:
            continue
        bb = t.GetBoundingBox()
        tx0 = pcbnew.ToMM(bb.GetX())
        ty0 = pcbnew.ToMM(bb.GetY())
        tx1 = tx0 + pcbnew.ToMM(bb.GetWidth())
        ty1 = ty0 + pcbnew.ToMM(bb.GetHeight())
        if not (tx1 <= bx0 or tx0 >= bx1 or ty1 <= by0 or ty0 >= by1):
            return False, "%s:%s" % (
                'via' if t.Type() == pcbnew.PCB_VIA_T else 'B.Cu track',
                t.GetNetname())

    for fp in board.GetFootprints():
        for pad in fp.Pads():
            if pad.GetNetname() == net:
                continue
            if pad.GetAttribute() != pcbnew.PAD_ATTRIB_PTH:
                continue                            # SMD is not on B.Cu
            bb = pad.GetBoundingBox()
            tx0 = pcbnew.ToMM(bb.GetX())
            ty0 = pcbnew.ToMM(bb.GetY())
            tx1 = tx0 + pcbnew.ToMM(bb.GetWidth())
            ty1 = ty0 + pcbnew.ToMM(bb.GetHeight())
            if not (tx1 <= bx0 or tx0 >= bx1 or ty1 <= by0 or ty0 >= by1):
                return False, "THT pad:%s" % pad.GetNetname()
    return True, None


def main():
    src = sys.argv[1] if len(sys.argv) > 1 else 'powerboard-reva-board.kicad_pcb'
    dst = sys.argv[2] if len(sys.argv) > 2 else 'routing/u2_bcu.kicad_pcb'
    board = pcbnew.LoadBoard(src)
    print("base: %s (%d copper items)" % (src, len(list(board.GetTracks()))))

    bb = board.GetBoardEdgesBoundingBox()
    W = pcbnew.ToMM(bb.GetWidth())
    Hh = pcbnew.ToMM(bb.GetHeight())
    half = WIDTH / 2.0

    grid = H.Grid(board, W, Hh)

    # B.Cu tracks only.
    n_bcu = 0
    for t in board.GetTracks():
        if t.Type() == pcbnew.PCB_TRACE_T and t.GetLayer() == pcbnew.B_Cu:
            grid.block_segment(pcbnew.ToMM(t.GetStart().x),
                               pcbnew.ToMM(t.GetStart().y),
                               pcbnew.ToMM(t.GetEnd().x),
                               pcbnew.ToMM(t.GetEnd().y),
                               pcbnew.ToMM(t.GetWidth()) + 2.0 * (half + FC.CLEAR_TRACK))
            n_bcu += 1
    # Vias pierce every layer.
    n_via = 0
    for t in board.GetTracks():
        if t.Type() == pcbnew.PCB_VIA_T:
            pos = t.GetPosition()
            cx, cy = grid.mm_to_cell(pcbnew.ToMM(pos.x), pcbnew.ToMM(pos.y))
            r = int(math.ceil((pcbnew.ToMM(t.GetWidth()) / 2.0 + half
                               + FC.CLEAR_TRACK) / H.GRID))
            for dy in range(-r, r + 1):
                for dx in range(-r, r + 1):
                    nx, ny = cx + dx, cy + dy
                    if 0 <= nx < grid.w and 0 <= ny < grid.h:
                        grid.blocked[grid.idx(nx, ny)] = 1
            n_via += 1
    # PADS: ONLY THROUGH-HOLE ONES BLOCK B.Cu.
    #
    # This was the bug that made the first B.Cu attempt fail exactly like the 2D one.
    # All 1415 pads were blocked on the B.Cu map, but 1341 of them are SMD and live
    # on F.Cu only -- an SMD pad is not copper on B.Cu and cannot obstruct a B.Cu
    # trace. Only the 74 through-hole pads drill through.
    #
    # Blocking SMD pads reproduced the "board is full" illusion on a layer that is
    # 97% empty, and produced five "no path" results across 5-15 mm.
    padinfo = []
    n_tht = n_smd = 0
    for fp in board.GetFootprints():
        for pad in fp.Pads():
            pos = pad.GetPosition()
            px, py = pcbnew.ToMM(pos.x), pcbnew.ToMM(pos.y)
            if pad.GetAttribute() == pcbnew.PAD_ATTRIB_PTH:
                grid.block_pad(pad, clearance=half + FC.CLEAR_TRACK)
                n_tht += 1
            else:
                n_smd += 1
            padinfo.append((pad.GetNetname(), fp.GetReference(), pad.GetNumber(),
                            px, py, pad.GetSize(),
                            pad.GetAttribute() == pcbnew.PAD_ATTRIB_PTH))
    print("B.Cu tracks blocked: %d   vias: %d" % (n_bcu, n_via))
    print("THT pads blocking B.Cu: %d   SMD pads ignored (F.Cu only): %d"
          % (n_tht, n_smd))
    static = bytearray(grid.blocked)

    done, failed = [], []
    for net in NETS:
        mine = [(r, n, x, y, s) for (nm, r, n, x, y, s, is_tht) in padinfo if nm == net]
        if len(mine) < 2:
            failed.append((net, "only %d pads" % len(mine)))
            continue

        # Rebuild from the CURRENT board each time, not from the snapshot taken
        # before the loop. The first nets routed here are themselves obstacles for
        # the later ones: with a static snapshot, HUB_CPL failed against
        # "via:HUB_CPH" and HUB_DVDD/HUB_VGLS against "B.Cu track:HUB_CPH" -- the
        # copper this same run had just added. Routing nets in sequence requires the
        # map to follow the board.
        g = H.Grid(board, W, Hh)
        for t in board.GetTracks():
            if t.Type() == pcbnew.PCB_TRACE_T and t.GetLayer() == pcbnew.B_Cu:
                g.block_segment(pcbnew.ToMM(t.GetStart().x),
                                pcbnew.ToMM(t.GetStart().y),
                                pcbnew.ToMM(t.GetEnd().x),
                                pcbnew.ToMM(t.GetEnd().y),
                                pcbnew.ToMM(t.GetWidth()) + 2.0 * (half + FC.CLEAR_TRACK))
            elif t.Type() == pcbnew.PCB_VIA_T:
                pos = t.GetPosition()
                cx, cy = g.mm_to_cell(pcbnew.ToMM(pos.x), pcbnew.ToMM(pos.y))
                r = int(math.ceil((pcbnew.ToMM(t.GetWidth()) / 2.0 + half
                                   + FC.CLEAR_TRACK) / H.GRID))
                for dy in range(-r, r + 1):
                    for dx in range(-r, r + 1):
                        nx, ny = cx + dx, cy + dy
                        if 0 <= nx < g.w and 0 <= ny < g.h:
                            g.blocked[g.idx(nx, ny)] = 1
        for fp in board.GetFootprints():
            for pad in fp.Pads():
                if pad.GetAttribute() == pcbnew.PAD_ATTRIB_PTH:
                    g.block_pad(pad, clearance=half + FC.CLEAR_TRACK)
        for (r, n, px, py, sz) in mine:
            cx, cy = g.mm_to_cell(px, py)
            rcx = int(math.ceil((pcbnew.ToMM(sz.x) / 2.0 + half + FC.CLEAR_ESCAPE)
                                / H.GRID))
            rcy = int(math.ceil((pcbnew.ToMM(sz.y) / 2.0 + half + FC.CLEAR_ESCAPE)
                                / H.GRID))
            for dy in range(-rcy, rcy + 1):
                for dx in range(-rcx, rcx + 1):
                    nx, ny = cx + dx, cy + dy
                    if 0 <= nx < g.w and 0 <= ny < g.h:
                        g.blocked[g.idx(nx, ny)] = 0

        a = g.mm_to_cell(mine[0][2], mine[0][3])
        c = g.mm_to_cell(mine[1][2], mine[1][3])
        path = g.astar(a, c)
        if not path:
            failed.append((net, "no path on B.Cu (%.1f mm span)" % math.hypot(
                mine[0][2] - mine[1][2], mine[0][3] - mine[1][3])))
            continue

        pts = [(cx * H.GRID, cy * H.GRID) for cx, cy in path]
        runs = [pts[0]]
        for i in range(1, len(pts) - 1):
            ax, ay = pts[i - 1]
            bx, by = pts[i]
            dx2, dy2 = pts[i + 1]
            if (bx - ax, by - ay) != (dx2 - bx, dy2 - by):
                runs.append(pts[i])
        runs.append(pts[-1])
        # Land exactly on the pad centres.
        runs[0] = (mine[0][2], mine[0][3])
        runs[-1] = (mine[1][2], mine[1][3])

        # VERIFY AGAINST B.Cu COPPER ONLY.
        #
        # FC.stub_clear() uses FC.existing_copper(), which returns every pad and
        # track on the board regardless of layer -- correct for the F.Cu fan-out it
        # was written for, wrong here. A B.Cu trace cannot collide with an F.Cu SMD
        # pad, so checking it against 1341 of them rejects every valid path:
        #
        #   HUB_CPL  blocked by pad:HUB_VGLS     (an SMD pad on F.Cu)
        #   HUB_DVDD blocked by track:DRV_MISO   (an F.Cu track)
        #
        # The grid was already built from B.Cu tracks + THT pads + vias, so the
        # honest verification is to re-use that same obstacle set, not a different
        # one. Path existence is what the grid proves; the check below re-confirms
        # it against the same objects so the two cannot disagree.
        ok_all, why_bad = True, None
        for i in range(len(runs) - 1):
            x0, y0 = runs[i]
            x1, y1 = runs[i + 1]
            ok, why = bcu_clear(board, net, x0, y0, x1, y1, half)
            if not ok:
                ok_all, why_bad = False, why
                break
        if not ok_all:
            failed.append((net, "verification blocked by %s" % why_bad))
            continue

        netobj = None
        for fp in board.GetFootprints():
            for pad in fp.Pads():
                if pad.GetNetname() == net:
                    netobj = pad.GetNet()
                    break
            if netobj is not None:
                break

        # A via at each pad so the trace reaches the surface pad.
        #
        # THE VIA MUST BE CHECKED ON EVERY LAYER IT PIERCES, NOT JUST B.Cu.
        # Placing it blind at the pad centre produced 6 clearance + 4 hole_clearance
        # violations: HUB_DVDD's via landed on F.Cu 0.10 mm from a HUB_INLC track and
        # 0.075 mm from another, because the B.Cu search had no reason to know F.Cu
        # copper was there. A through via is copper on F.Cu, In1, In2 and B.Cu.
        via_ok = True
        for (px, py) in ((mine[0][2], mine[0][3]), (mine[1][2], mine[1][3])):
            for t in board.GetTracks():
                if t.GetNetname() == net:
                    continue
                if t.Type() != pcbnew.PCB_TRACE_T:
                    continue
                bb = t.GetBoundingBox()
                tx0 = pcbnew.ToMM(bb.GetX()) - (VIA_SIZE / 2.0 + FC.CLEAR_TRACK)
                ty0 = pcbnew.ToMM(bb.GetY()) - (VIA_SIZE / 2.0 + FC.CLEAR_TRACK)
                tx1 = pcbnew.ToMM(bb.GetX()) + pcbnew.ToMM(bb.GetWidth()) + (VIA_SIZE / 2.0 + FC.CLEAR_TRACK)
                ty1 = pcbnew.ToMM(bb.GetY()) + pcbnew.ToMM(bb.GetHeight()) + (VIA_SIZE / 2.0 + FC.CLEAR_TRACK)
                if tx0 <= px <= tx1 and ty0 <= py <= ty1:
                    via_ok = False
                    break
            if not via_ok:
                break
        if not via_ok:
            # Nothing has been added yet: this check runs BEFORE the traces are
            # inserted, so a rejection costs nothing to undo.
            failed.append((net, "via placement blocked on F.Cu"))
            continue

        for i in range(len(runs) - 1):
            x0, y0 = runs[i]
            x1, y1 = runs[i + 1]
            t = pcbnew.PCB_TRACK(board)
            t.SetStart(vec(x0, y0))
            t.SetEnd(vec(x1, y1))
            t.SetWidth(pcbnew.FromMM(WIDTH))
            t.SetLayer(pcbnew.B_Cu)
            t.SetNet(netobj)
            board.Add(t)
        for (px, py) in ((mine[0][2], mine[0][3]), (mine[1][2], mine[1][3])):
            v = pcbnew.PCB_VIA(board)
            v.SetPosition(vec(px, py))
            v.SetDrill(pcbnew.FromMM(VIA_DRILL))
            v.SetWidth(pcbnew.FromMM(VIA_SIZE))
            v.SetViaType(pcbnew.VIATYPE_THROUGH)
            v.SetLayerPair(pcbnew.F_Cu, pcbnew.B_Cu)
            v.SetNet(netobj)
            board.Add(v)
        done.append((net, len(runs) - 1))

    print("\nrouted %d nets, failed %d" % (len(done), len(failed)))
    for net, n in done:
        print("   OK   %-10s %d segments on B.Cu + 2 vias" % (net, n))
    for net, why in failed:
        print("   FAIL %-10s %s" % (net, why))

    if done:
        pcbnew.SaveBoard(dst, board)
        print("\nwrote %s" % dst)
    return 0


if __name__ == '__main__':
    sys.exit(main())
