felixfelix-bot/cycle-without-chain/hardware/powerboard-reva/size_cdiv_bypass.py

#!/usr/bin/env python3
"""TPSI3052 secondary-side capacitance budget (CDIV1 / CDIV2).

WHY THIS EXISTS
---------------
``docs/design/pad-audit-power-parts.md`` §3.3 recorded two findings as "datasheet
requirements the design does not meet":

    (a) CDIV2 = 3 x CDIV1 is recommended; the design is 470n/100n = 4.7x.
    (b) bypass of 20x equivalent gate capacitance is recommended, ~209 nF wanted.

**Both of those claims were wrong.** (a) misread a *minimum* as a target: the
datasheet says ``CDIV2 >= 3 x CDIV1``, so 4.7x complies. (b) compared the gate
bypass requirement against CDIV1 alone when the relevant node has CDIV1 + CDIV2
across it. The design meets both.

This module exists so the check is arithmetic instead of a reading error, and so
the correction is pinned by tests rather than by a promise.

WHAT THE DATASHEET ACTUALLY SPECIFIES
-------------------------------------
SLVSGS3B §6.3 Recommended Operating Conditions:

    CDIV1   VDDH to VDDM   0.004 .. 15 uF
    CDIV2   VDDM to VSSS   0.012 .. 40 uF
    note 2: "CDIV2 capacitance value should be at least three times the
             capacitance value of CDIV1 i.e. CDIV2 >= 3 x CDIV1."
    note 3: "All capacitance values are absolute. Derating should be applied
             where necessary."

The ratio is a floor, not a setpoint. The reason is structural: CDIV1 spans the
full 15 V VDDH rail while CDIV2 sits across VDDM, so a 3:1 ratio keeps the ripple
share sensible rather than letting one node sag first.

SECONDARY CHECK — CHARGE BUDGET
-------------------------------
The capacitors must supply each gate transition before the converter replaces
the charge. For the IRFP4568PbF (Qg 151 nC typ, 227 nC max):

    droop = Qg / C

against the VDDH UVLO falling threshold (9.9-10.9 V) from a 15 V nominal rail.

RECOVERY
--------
RPXFR sets the power-transfer duty cycle, one of seven fixed settings
(Table 8-1). The design uses RPXFR = 20 kOhm = 93.3 %, the highest, so recovery
between events is as fast as the device allows.
"""

from __future__ import annotations

# --- datasheet limits (SLVSGS3B §6.3) ---------------------------------
CDIV1_MIN_F = 0.004e-6
CDIV1_MAX_F = 15e-6
CDIV2_MIN_F = 0.012e-6
CDIV2_MAX_F = 40e-6
CDIV2_RATIO_MIN = 3.0

# --- design values (active_entry_circuit.py) ---------------------------
CDIV1_F = 100e-9     # '100n 25V C0G 5% CDIV1'   VDDH-VDDM
CDIV2_F = 470e-9     # '470n 25V C0G 5% CDIV2'   VDDM-VSSS

# --- the FET being driven (Infineon PD-96175) --------------------------
QG_TYP_NC = 151.0
QG_MAX_NC = 227.0
CISS_F = 10470e-12
BYPASS_MULTIPLIER = 20.0     # TI: "20 times the equivalent gate capacitance"

# --- VDDH rail --------------------------------------------------------
VDDH_NOM_V = 15.0
VDDH_UVLO_FALLING_MAX_V = 10.9   # worst case, SLVSGS3B §5.9

# --- power transfer (SLVSGS3B Table 8-1) ------------------------------
RPXFR_KOHM = 20.0
RPXFR_DUTY_PCT = 93.3            # highest of the seven settings


def within_limits(cdiv1: float, cdiv2: float) -> dict:
    return {
        "cdiv1_in_range": CDIV1_MIN_F <= cdiv1 <= CDIV1_MAX_F,
        "cdiv2_in_range": CDIV2_MIN_F <= cdiv2 <= CDIV2_MAX_F,
        "ratio": cdiv2 / cdiv1,
        "ratio_ok": (cdiv2 / cdiv1) >= CDIV2_RATIO_MIN,
    }


def bypass_needed_f(qg_c: float | None = None) -> float:
    """TI's 20x-equivalent-gate-capacitance bypass recommendation."""
    return BYPASS_MULTIPLIER * CISS_F


def droop_v(q_c: float, c_f: float) -> float:
    """Voltage sag from removing charge q from capacitance c."""
    return q_c / c_f


def transitions_to_uvlo(q_c: float, c_f: float,
                        v_nom: float = VDDH_NOM_V,
                        uvlo: float = VDDH_UVLO_FALLING_MAX_V) -> float:
    """How many transitions with NO recharge before the rail hits UVLO."""
    return (v_nom - uvlo) / droop_v(q_c, c_f)


def evaluate(cdiv1: float = CDIV1_F, cdiv2: float = CDIV2_F) -> dict:
    lim = within_limits(cdiv1, cdiv2)
    qg = QG_TYP_NC * 1e-9
    qg_max = QG_MAX_NC * 1e-9
    need = bypass_needed_f()
    total = cdiv1 + cdiv2
    return {
        **lim,
        "cdiv1_nf": cdiv1 * 1e9,
        "cdiv2_nf": cdiv2 * 1e9,
        "bypass_available_nf": total * 1e9,
        "bypass_required_nf": need * 1e9,
        "bypass_ok": total >= need,
        "droop_typ_v": droop_v(qg, total),
        "droop_worst_v": droop_v(qg_max, total),
        "droop_cdiv1_only_typ_v": droop_v(qg, cdiv1),
        "uvlo_headroom_v": VDDH_NOM_V - VDDH_UVLO_FALLING_MAX_V,
        "transitions_to_uvlo_cdiv1_only": transitions_to_uvlo(qg, cdiv1),
        "rpxfr_duty_pct": RPXFR_DUTY_PCT,
    }


def main() -> int:
    r = evaluate()
    print("TPSI3052 secondary capacitance budget")
    print("=" * 62)
    print("Datasheet limits (SLVSGS3B §6.3):")
    print("  CDIV1  VDDH-VDDM   %.3f .. %.0f uF" % (CDIV1_MIN_F*1e6, CDIV1_MAX_F*1e6))
    print("  CDIV2  VDDM-VSSS   %.3f .. %.0f uF" % (CDIV2_MIN_F*1e6, CDIV2_MAX_F*1e6))
    print("  note 2: CDIV2 >= 3 x CDIV1  (a MINIMUM, not a target)")
    print()
    print("Design:")
    print("  CDIV1 = %.0f nF   in range : %s" % (r["cdiv1_nf"], r["cdiv1_in_range"]))
    print("  CDIV2 = %.0f nF   in range : %s" % (r["cdiv2_nf"], r["cdiv2_in_range"]))
    print("  ratio = %.2f     >= 3.0    : %s" % (r["ratio"], r["ratio_ok"]))
    print()
    print("Gate bypass (TI: 20 x Ciss):")
    print("  Ciss(IRFP4568PbF) = %.2f nF -> need >= %.0f nF"
          % (CISS_F*1e9, r["bypass_required_nf"]))
    print("  CDIV1+CDIV2       = %.0f nF -> %s"
          % (r["bypass_available_nf"], "MET" if r["bypass_ok"] else "NOT MET"))
    print()
    print("Charge budget (Qg 151 nC typ / 227 nC max):")
    print("  droop per edge (both caps) : %.3f V typ, %.3f V worst"
          % (r["droop_typ_v"], r["droop_worst_v"]))
    print("  droop (CDIV1 only, if VDDM is fully supported) : %.2f V"
          % r["droop_cdiv1_only_typ_v"])
    print("  headroom to UVLO (15.0 -> %.1f V) : %.1f V"
          % (VDDH_UVLO_FALLING_MAX_V, r["uvlo_headroom_v"]))
    print("  edges to UVLO with NO recharge (CDIV1 only) : %.1f"
          % r["transitions_to_uvlo_cdiv1_only"])
    print()
    print("Recovery: RPXFR = %.0f kOhm -> duty %.1f %% (highest of seven settings)."
          % (RPXFR_KOHM, r["rpxfr_duty_pct"]))
    print("  A bike power switch toggles at human rates (<= a few Hz), so the")
    print("  converter replaces each edge's charge long before the next one.")
    print()
    verdict = (r["cdiv1_in_range"] and r["cdiv2_in_range"] and r["ratio_ok"]
               and r["bypass_ok"])
    print("VERDICT: %s" % ("design MEETS all four CDIV requirements"
                           if verdict else "VIOLATION — see above"))
    print()
    print("Correction: pad-audit-power-parts.md §3.3 previously claimed (a) the")
    print("CDIV ratio and (b) the bypass were not met. Both claims were wrong —")
    print("(a) misread a minimum as a target, (b) compared against CDIV1 alone.")
    return 0 if verdict else 1


if __name__ == "__main__":
    raise SystemExit(main())
