felixfelix-bot/cycle-without-chain/hardware/powerboard-reva/protection_circuit.py

"""Placed protection circuit; called by hierarchical schematic generator."""
def populate(g):
    Sheet,parse,q,stock,passive,pins=g['Sheet'],g['parse'],g['q'],g['stock'],g['passive'],g['pins']
    def ic(name, pin_names, outputs=(), powerout=(), oc=()):
        text=f'(symbol "Powerboard:{name}" (pin_names (offset 1)) (in_bom yes) (on_board yes) (symbol "{name}_0_1" (rectangle (start -15.24 2.54) (end 15.24 {-5.08*len(pin_names)}) (stroke (width .254) (type default)) (fill (type background)))) (symbol "{name}_1_1"'
        for i,n in enumerate(pin_names,1):
            typ='open_collector' if i in oc else 'power_out' if i in powerout else 'output' if i in outputs else 'power_in' if n in ['VCC','VDD','GND','IN'] else 'input'
            text+=f' (pin {typ} line (at -20.32 {-5.08*(i-1)} 0) (length 5.08) (name {q(n)} (effects (font (size 1 1)))) (number "{i}" (effects (font (size 1 1)))))'
        a=parse(text+'))');g['custom_symbols'].append(a);return a
    def part(s,a,ref,mpn,x,y,nets,fp):s.part(a,ref,mpn,x,y,{str(i+1):n for i,n in enumerate(nets)},fp)
    def r(s,v,x,y,a,b):return passive(s,'R',v,x,y,a,b,'Resistor_SMD:R_0805_2012Metric')
    def c(s,v,x,y,a,b):return passive(s,'C',v,x,y,a,b,'Capacitor_SMD:C_1210_3225Metric' if 'GRM32' in v else 'Capacitor_SMD:C_0805_2012Metric')
    aux=Sheet('aux-supply','Bus-fed auxiliary and independent safety supply')
    aux.text('R-78HB12-0.5: 17-72V operating, 75V absolute. Entry transient protection still REQUIRED.',20.32,15.24)
    part(aux,ic('R78HB',['IN','GND','OUT'],powerout=(3,)),'U3','R-78HB12-0.5',63.5,50.8,['DC_LINK','PGND','SINK12'],'')
    part(aux,ic('TLV760',['OUT','IN','GND'],powerout=(1,)),'U4','TLV76033DBZR',177.8,50.8,['SAFETY3V3','SINK12','PGND'],'Package_TO_SOT_SMD:SOT-23')
    c(aux,'3.3u 100V GRM32ER72A335KA35L',63.5,109.22,'DC_LINK','PGND')
    c(aux,'10u 25V GRM21BR61E106KA73L',139.7,109.22,'SINK12','PGND')
    c(aux,'1u 25V GRM21BR71E105KA99L',215.9,109.22,'SAFETY3V3','PGND')
    r(aux,'1k 1% CRCW08051K00FKEA',292.1,109.22,'SINK12','PGND')
    part(aux,ic('LM4040',['K','A','NC']), 'U5','LM4040AIM3-2.5/NOPB',63.5,172.72,['REF2V5','PGND','PGND'],'Package_TO_SOT_SMD:SOT-23')
    r(aux,'4k7 1% CRCW08054K70FKEA',139.7,172.72,'SINK12','REF2V5')
    c(aux,'100n 25V GRM21BR71E104KA01L',215.9,172.72,'REF2V5','PGND')
    aux.text('Safety supply is NOT the MCU supply. LOGIC3V3_EXT remains a supervised, external MCU rail.',20.32,241.3)
    aux.text('Supply total/current/thermal budget provisional; no galvanic isolation or stored-energy ride-through.',20.32,251.46)
    aux.save();g['sheets'].append(aux)
    s=Sheet('protection-comparators','Autonomous OV chopper comparator and rail / brake monitors')
    s.text('Comparator powered from SINK12; open collectors pulled to SAFETY3V3. No MCU in OV path.',20.32,15.24)
    a=ic('LM339B',['OUT1','OUT2','VCC','IN2-','IN2+','IN1-','IN1+','IN3-','IN3+','IN4-','IN4+','GND','OUT4','OUT3'],oc=(1,2,13,14))
    part(s,a,'U6','LM339BIDR',63.5,43.18,['ANALOG_OK','OV_CMD','SINK12','REF2V5','OV_SENSE','REF2V5','AUX_SENSE','REF2V5','MCU_SENSE','REF2V5','FAULT_CHAIN','PGND','ANALOG_OK','ANALOG_OK'],'Package_SO:SOIC-14_3.9x8.7mm_P1.27mm')
    specs=[('112k 0.1% ERA-6AEB1123V','DC_LINK','OV_MID'),('113k 0.1% ERA-6AEB1133V','OV_MID','OV_SENSE'),('10k 0.1% ERA-6AEB103V','OV_SENSE','PGND'),('330k 0.1% ERA-6AEB334V','OV_CMD','OV_SENSE'),('1k 1% CRCW08051K00FKEA','SAFETY3V3','OV_CMD'),('30k 0.1% ERA-6AEB303V','SINK12','AUX_SENSE'),('10k 0.1% ERA-6AEB103V','AUX_SENSE','PGND'),('2k 0.1% ERA-6AEB202V','LOGIC3V3_EXT','MCU_SENSE'),('10k 0.1% ERA-6AEB103V','MCU_SENSE','PGND'),('10k 1% CRCW080510K0FKEA','FAULT_CHAIN','PGND'),('4k7 1% CRCW08054K70FKEA','SAFETY3V3','ANALOG_OK')]
    for i,(v,a,b) in enumerate(specs):r(s,v,177.8+(i%3)*76.2,50.8+(i//3)*45.72,a,b)
    c(s,'100p C0G GRM21A5C1H101JA01D',177.8,238.76,'OV_SENSE','PGND')
    c(s,'100n 25V GRM21BR71E104KA01L',292.1,238.76,'SINK12','PGND')
    s.text('FAULT_CHAIN must close to SAFETY3V3 through normally-closed E-stop + dump thermal switches (NOT rider levers). Open wire trips.',20.32,266.7)
    s.save();g['sheets'].append(s)
    s=Sheet('fault-latch','Release-before-rearm DFF memory')
    s.text('UNSAFE DRAFT: healthy release edge THEN press edge required. No automatic reset.',20.32,15.24)
    dff=ic('LVC1G74',['CLK','D','Q_N','GND','Q','CLR_N','PRE_N','VCC'],outputs=(3,5))
    part(s,dff,'U7','SN74LVC1G74DCUR',63.5,43.18,['RESET_INV','SAFETY3V3','RELEASE_N','PGND','RELEASE_SEEN','HEALTHY','SAFETY3V3','SAFETY3V3'],'Package_SO:VSSOP-8_2.3x2mm_P0.5mm')
    part(s,dff,'U8','SN74LVC1G74DCUR',177.8,43.18,['RESET_CLEAN','RELEASE_SEEN','FAULT_LATCH','PGND','PERMIT','HEALTHY','SAFETY3V3','SAFETY3V3'],'Package_SO:VSSOP-8_2.3x2mm_P0.5mm')
    part(s,ic('TPS3823',['RESET_N','GND','MR_N','WDI','VDD'],outputs=(1,)),'U9','TPS3823-33DBVR',292.1,43.18,['WD_RESET_N','PGND','SAFETY3V3','WDI','SAFETY3V3'],'Package_TO_SOT_SMD:SOT-23-5')
    for i,n in enumerate(['RESET_REQUEST','MCU_ARM']):r(s,'10k 1% CRCW080510K0FKEA',63.5+i*76.2,109.22,n,'PGND')
    r(s,'1k 1% CRCW08051K00FKEA',215.9,109.22,'WDI','PGND')
    r(s,'10k 1% CRCW080510K0FKEA',63.5,144.78,'RESET_REQUEST','RESET_RC')
    c(s,'10n 5% C0G GRM21A5C1H103JA01D',139.7,144.78,'RESET_RC','PGND')
    for i,n in enumerate(['GEN_nFAULT','HUB_nFAULT']):r(s,'10k 1% CRCW080510K0FKEA',215.9+i*76.2,144.78,'SAFETY3V3',n)
    for i,n in enumerate(['RELEASE_N','FAULT_LATCH']):r(s,'100k CRCW0805100KFKEA',63.5+i*76.2,180.34,n,'PGND')
    r(s,'1k 1% CRCW08051K00FKEA',215.9,180.34,'TIMER_BREAK_OK','GEN_ENABLE')
    r(s,'1k 1% CRCW08051K00FKEA',292.1,180.34,'TIMER_BREAK_OK','HUB_ENABLE')
    for i in range(3):c(s,'100n 25V GRM21BR71E104KA01L',63.5+i*76.2,236.22,'SAFETY3V3','PGND')
    s.text('TPS3823 non-A: falling WDI only; hold low during RESET. Stuck RESET stays disabled.',20.32,266.7)
    s.save();g['sheets'].append(s)
    s=Sheet('fault-interfaces','LVC Schmitt fault inputs without series diode offsets')
    buf=ic('LVC3G17',['1A','3Y','2A','GND','2Y','3A','1Y','VCC'],outputs=(2,5,7))
    part(s,buf,'U11','SN74LVC3G17DCUR',63.5,43.18,['ANALOG_OK','WD_OK','GEN_nFAULT','PGND','GEN_OK','WD_RESET_N','ANALOG_CLEAN','SAFETY3V3'],'Package_SO:VSSOP-8_2.3x2mm_P0.5mm')
    part(s,buf,'U12','SN74LVC3G17DCUR',177.8,43.18,['HUB_nFAULT','ARM_CLEAN','RESET_RC','PGND','RESET_CLEAN','MCU_ARM','HUB_OK','SAFETY3V3'],'Package_SO:VSSOP-8_2.3x2mm_P0.5mm')
    gate=ic('LVC1G11',['A','GND','B','Y','VCC','C'],outputs=(4,))
    part(s,gate,'U13','SN74LVC1G11DBVR',292.1,43.18,['ANALOG_CLEAN','PGND','GEN_OK','FAULTS_OK','SAFETY3V3','HUB_OK'],'Package_TO_SOT_SMD:SOT-23-6')
    part(s,gate,'U14','SN74LVC1G11DBVR',63.5,116.84,['FAULTS_OK','PGND','WD_OK','HEALTHY','SAFETY3V3','OC_OK'],'Package_TO_SOT_SMD:SOT-23-6')
    part(s,ic('LVC1G04',['NC','A','GND','Y','VCC'],outputs=(4,)),'U15','SN74LVC1G04DBVR',177.8,116.84,['PGND','RESET_CLEAN','PGND','RESET_INV','SAFETY3V3'],'Package_TO_SOT_SMD:SOT-23-5')
    part(s,gate,'U16','SN74LVC1G11DBVR',292.1,116.84,['HEALTHY','PGND','PERMIT','TIMER_BREAK_OK','SAFETY3V3','ARM_CLEAN'],'Package_TO_SOT_SMD:SOT-23-6')
    for i in range(6):c(s,'100n 25V GRM21BR71E104KA01L',63.5+(i%3)*76.2,190.5+(i//3)*40.64,'SAFETY3V3','PGND')
    s.text('Default OFF via async supervisor clear. Analog ramp/metastability NOT validated.',20.32,266.7)
    s.save();g['sheets'].append(s)
    s=Sheet('brake-chopper','Independent brake chopper power stage')
    s.text('Autonomous OV path ignores bridge ENABLE. External resistor is required across BRAKE_DUMP_RESISTOR connector pins.',20.32,15.24)
    part(s,ic('UCC27511',['VDD','OUTH','OUTL','GND','IN-','IN+'],outputs=(2,3)),'U10','UCC27511DBVR',63.5,50.8,['SINK12','CHOP_SOURCE','CHOP_SINK','PGND','PGND','CHOP_CMD'],'Package_TO_SOT_SMD:SOT-23-6')
    fet=g['FET'];s.part(fet,'Q13','CSD19532Q5B',215.9,76.2,{num:('CHOP_GATE' if name=='G' else 'DUMP_LOW' if name=='D' else 'PGND') for num,name,*_ in pins(fet)},'Package_TO_SOT_SMD:TDSON-8-1')
    r(s,'10R CRCW080510R0FKEA',139.7,132.08,'CHOP_SOURCE','CHOP_GATE')
    r(s,'2R2 CRCW08052R20FKEA',215.9,132.08,'CHOP_SINK','CHOP_GATE')
    r(s,'10k CRCW080510K0FKEA',292.1,132.08,'CHOP_GATE','PGND')
    c(s,'1u 25V GRM21BR71E105KA99L',63.5,187.96,'SINK12','PGND')
    c(s,'100n 25V GRM21BR71E104KA01L',139.7,187.96,'SINK12','PGND')
    g['counters']['J']+=1
    part(s,stock('Connector_Generic','Conn_01x02'),'J'+str(g['counters']['J']),'EXTERNAL_DUMP_RESISTOR',292.1,187.96,['DC_LINK','DUMP_LOW'],'')
    s.text('Candidate: 2 x TE HSC3004R7J in series (9.4 ohm). Chassis/heatsink + NC thermal cutoff required.',20.32,241.3)
    s.text('No resistor cable clamp / fuse / SOA qualification yet. Loss of AUX supply loses bus sink: NOT FAIL SAFE.',20.32,251.46)
    s.save();g['sheets'].append(s)
