felixfelix-bot/cycle-without-chain/(commit log)

2026-11-10 docs(analysis): chainless series-hybrid bicycle drivetrain trade study
    Evaluate pedal->generator->buffer->hub-motor against chain drive on measured
    component efficiencies, per operator question (2026-11-10).
    COMPUTED findings:
    - series hybrid with a good PM generator = 61.3% end-to-end vs 96.1% for a
    waxed derailleur; +63% pedal power needed for the same road power
    - car claw-pole alternator = 39.2% in its good window, 21.4% below 1500 rpm
    - even with every stage at datasheet peak the chain wins by 19.9 points
    - supercap pack 4.84 Wh/kg vs LFP 90 Wh/kg (19x mass for equal energy)
    - one 18-cell 22.2 F / 48.6 V string (1.12 kg, USD 293) covers 4.4x the KE of
    one stop-start, i.e. the buffe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
2026-11-10 docs: licence, README map, and reconcile both production systems
    Adds LICENSE (MIT for the model, CC BY 4.0 for the prose) and expands the
    README. Adds section 11 to the study and section 13 to the model:
    reconciliation with the two series-hybrid systems that actually shipped.
    Findings:
    - Neither Mando nor Schaeffler publishes a generator efficiency number.
    - Schaeffler's widely-quoted '5% less efficient than chain' CANNOT be a
    drivetrain figure: it demands 91.1% end-to-end, which back-solves to a
    generator efficiency of 1.073 -- above unity. 91% is thermodynamically
    impossible for two machine conversions plus a battery.
    - It IS reproducible as a vehicle-level range claim, but only at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
2026-11-10 feat(analysis): parallel-hybrid worked numbers + comparison diagram
    Answers 'how would the recommendation work, what is its efficiency'.
    Section 14 in the model, new render_diagram.py (stdlib PNG, no deps):
    - rider path 96.1% (waxed derailleur, measured) -- never touches electrics
    - motor path 86.0% battery->wheel (Grin DD hub system, measured)
    - regen round trip 62.6% = 0.86^2 x 0.92
    - coast drag 2 W DD hub = 1.4% of cruise demand (the real regen tax)
    - 150 W rider -> 144.2 W at wheel vs 138.9 W cruise demand = +5.3 W
    surplus: the rider covers cruise with no battery help at all
    - series hybrid with the same rider leaves a 46.9 W hole; battery must
    supply 74.9 W just to MATCH the parall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
2026-11-10 docs: add worked parallel-hybrid numbers and production precedent
    Answers: include the figures on the default branch, and has anyone built this.
    New section 12 (recommended build):
    - two independent power paths, rider never enters the electric chain
    - rider path 96.1% / motor path 86.0% / regen round trip 62.6%
    - 150 W pedals -> 144.2 W wheel vs 138.9 W demand = +5.3 W surplus, so the
    rider covers 25 km/h with the battery idle; series hybrid leaves a 46.9 W
    hole needing 74.9 W of battery just to match
    - plain-language description of each part and WHY it is there
    - range table with an explicit warning that it is a ceiling, not a prediction
    CORRECTION recorded in 12: the earlier 8.2 Wh r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
2026-11-10 docs: embed parallel hybrid figures, correct cadence claim and cite existing builds
    [make_blend_figure.py, make_explainer.py]
2026-11-10 docs: bound custom pedal-by-wire powerboard concept
    D1 paired silicon bridges; D2 36-58.4 V study bus; D3 generator torque qualification open; D4 80 percent target unproven; D5 schematic-only next gate.
    [custom-powerboard-bom.csv]
2026-11-10 docs: consolidate controller research, candidate BOM and historical analysis
    [candidate-bom.csv, efficiency-budget.csv]
2026-11-10 docs: audit balloon PCB tooling and define motor-board release gates
2026-11-10 hardware: add reviewable partial dual-bridge KiCad schematic and evidence
    [external-boundaries.kicad_sch, gen-bridge.kicad_sch, gen-driver.kicad_sch, hub-bridge.kicad_sch, hub-driver.kicad_sch, mcu-pin-allocation.csv, pin-net-map.csv, powerboard-reva.kicad_sch]
2026-11-10 docs: independently review partial schematic and record electrical blockers
2026-11-10 fix: make partial export consistency verification read-only and fail closed
    [verify_exports.py]
2026-11-10 feat(hardware): populate autonomous OV sink and supervised fault latch
    [aux-supply.kicad_sch, brake-chopper.kicad_sch, external-boundaries.kicad_sch, fault-latch.kicad_sch, gen-driver.kicad_sch, hub-driver.kicad_sch, pin-net-map.csv, powerboard-reva.kicad_sch]
2026-11-10 fix(hardware): include reproducible SPICE deck and correct input capacitor package
    [aux-supply.kicad_sch, pin-net-map.csv, review-bom.csv]
2026-11-10 Replace level reset latch with release-before-rearm DFF circuit and behavioral regressions
    [protection_circuit.py]
2026-11-10 Export real release-before-rearm circuit, reconcile exact manifests and record bounded verification
    [brake-chopper.kicad_sch, fault-interfaces.kicad_sch, fault-latch.kicad_sch, pin-net-map.csv, powerboard-reva.kicad_sch, protection-comparators.kicad_sch, review-bom.csv]
2026-11-10 feat(hardware): wire STM32G474 MCU and verify exported topology
    [brake-chopper.kicad_sch, external-boundaries.kicad_sch, gen-driver.kicad_sch, hub-driver.kicad_sch, mcu-analog.kicad_sch, mcu-core.kicad_sch, mcu-power.kicad_sch, mcu-sensors.kicad_sch]
2026-11-10 Add independent six-CSA window trip circuit with latched dual-bridge inhibit
    [external-boundaries.kicad_sch, fast-oc-reference.kicad_sch, fault-interfaces.kicad_sch, gen-driver.kicad_sch, gen-fast-oc.kicad_sch, hub-driver.kicad_sch, hub-fast-oc.kicad_sch, pin-net-map.csv]
2026-11-10 Evaluate short-buffer storage with sourced cells and tested model
    D1 screen direct high-power battery interface without freezing chemistry. D2 cap voltage-window and ESR limit usable buffer. D3 separate launch energy from peak power and rider contribution. D4 defer hybrid pending charge-acceptance evidence. D5 retain no-buffer bench comparator. No purchase or powerboard change authorized.
    [short-buffer-storage-bom.csv]
2026-11-10 D1-D4: bound rider-requested braking heat; choose dedicated sink trial and series resistor screening
2026-11-10 Review storage arithmetic: expose cumulative swing and preserve power ceiling
2026-11-10 Add bounded passive bench entry circuit with explicit protection and sequencing blockers
    [dc-entry.kicad_sch, external-boundaries.kicad_sch, pin-net-map.csv, powerboard-reva.kicad_sch, review-bom.csv]
2026-11-10 Review unsafe entry milestone and withdraw energized jumper sequence
    [dc-entry.kicad_sch]
2026-11-10 Add rider brake intent interface separate from hard fault kill
    [brake-chopper.kicad_sch, brake-dump-command.kicad_sch, brake-intent-left.kicad_sch, brake-intent-right.kicad_sch, brake-switch-harness.kicad_sch, dc-entry.kicad_sch, external-boundaries.kicad_sch, mcu-analog.kicad_sch]
2026-11-10 docs: add five pedal-by-wire customer use cases with scope limits
2026-11-10 docs(fsr): evaluate protected divider and sensor limits with tested model
    D1: provisional 402 short-tail and 10k divider. D2: independent binary inhibit. D3: reject bridge and R2R as default linearizers. D4: physical envelope governs usable range.
    [fsr-candidate-bom.csv]
2026-11-10 Review brake intent topology as unsafe design milestone
    [mcu-pin-allocation.csv]
2026-11-10 docs: add balance-assistance accessibility research use case
2026-11-10 docs: quantify gyro balance research and qualify sourcing gaps
    [gyro-candidate-bom.csv]
2026-11-10 Review gyro study and correct live marine comparator mass
    [gyro-candidate-bom.csv]
2026-11-10 design: interlocked precharge and split auxiliary power model
    D1 split controller/drive/sink power; D2 150V B2B isolated switches; D3 latch 1.5s timeout; D4 partial verified cost ledger, not release BOM. Thirteen model tests pass; hardware qualification remains blocked.
    [candidate-bom.csv]
2026-11-10 Implement reviewable two-channel FSR frontend with explicit protection gates
    [brake-dump-command.kicad_sch, brake-intent-left.kicad_sch, brake-intent-right.kicad_sch, brake-switch-harness.kicad_sch, fsr-left.kicad_sch, fsr-protection-left.kicad_sch, fsr-protection-right.kicad_sch, fsr-right.kicad_sch]
2026-11-10 Design optional navigation interface and estimator contract with checked budgets
    [navigation-bom-candidates.csv]
2026-11-10 Review precharge architecture and add independent analytic controls
    [candidate-bom.csv]
2026-11-10 Review navigation reservations and qualify power and storage budgets
2026-11-10 Replace impossible precharge allocations with component budgets and measurable proof candidate
    [candidate-bom.csv]
2026-11-10 fix(hardware): separate FSR and brake schematic fields from pins
    Native XML invariance: 314 parts, 1007 ref/pin/net rows unchanged. Eight SVG circuit regions have zero measured text collisions; 34 tests normal and -O pass; strict ERC retains five errors. Reviewed page24 PNG SHA256 13ed03b55701970b30c63a6d656dac4ac9630dd730ad24fa250a7e2eb1525af7; served vision model undisclosed. Not safe to energize.
    [brake-dump-command.kicad_sch, brake-intent-left.kicad_sch, brake-intent-right.kicad_sch, brake-switch-harness.kicad_sch, fsr-left.kicad_sch, fsr-protection-left.kicad_sch, fsr-protection-right.kicad_sch, fsr-right.kicad_sch]
2026-11-10 feat(hardware): add inhibited MAIN and PRE physical switch candidates
    [dc-entry.kicad_sch, entry-main.kicad_sch, entry-pre.kicad_sch, pin-net-map.csv, powerboard-reva.kicad_sch, review-bom.csv]
2026-11-10 Add inhibited pack-side LM5164 CTRL3V3 circuit and native verification
    [ctrl-supply.kicad_sch, pin-net-map.csv, powerboard-reva.kicad_sch, review-bom.csv]
2026-11-10 fix(ctrl-supply): rate input ceramics for 2x VIN and document the review
    C500/C501 were 2.2uF 100V parts against TI's 2x58.4V = 116.8V guidance. Replace
    with KYOCERA AVX 22252C225KAT2A (200V X7R, EIA 2225) on the stock
    C_2225_5664Metric footprint, and add a test that the native export carries the
    200V value and footprint (RED first against the unchanged export).
    docs/design/ctrl-supply-review.md records the independent recompute: pin map,
    feedback window, 301kHz/on-time, 68uH ripple and 205mA peak, COT light-load
    boundary, UVLO corners, bootstrap value and the ~116.8V D500 reverse stress.
    Derating is stated as guidance, not as proof the 100V part fails; effective
    capacitance at 58.4V bias,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
    [ctrl-supply.kicad_sch, review-bom.csv]
2026-11-10 gates: add fail-closed PCB release checks (native reports, netlist parity, artifacts)
    Three small checkers plus a runner, implementing the tooling proposed in
    docs/design/pcb-quality-gates.md after the audit in
    docs/design/tooling-audit-report.md. Self-contained: tools/gates/ and
    tests/gates/ only; hardware/ is untouched.
    tools/gates/native_reports.py
    Wraps kicad-cli drc/erc/netlist export. A nonzero subprocess exit, a missing
    or empty report, an unparsable or wrongly-shaped report, a report naming a
    different source, a timeout, or zero objects graded are all FAIL; none of
    them is ever "zero violations". Each run writes into a fresh
    <outdir>/<utc>-<pid>-<random>/ directory allocat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
2026-11-10 feat(power): partition sink, inhibited drive and logic rails (unqualified)
    [aux-supply.kicad_sch, brake-chopper.kicad_sch, ctrl-supply.kicad_sch, external-boundaries.kicad_sch, gen-driver.kicad_sch, hub-driver.kicad_sch, pin-net-map.csv, powerboard-reva.kicad_sch]
2026-11-10 review: recover rail partition, budget DRV8353 VDRAIN, close -O vacuity
    Independent review of d944978 (pr/rail-partition) recovered after the worker's
    summary was lost. The branch is internally consistent and reproducible: 45
    hardware tests pass normally and under -O, the generator reproduces the
    committed netlist byte-identically, and strict ERC is unchanged at 10 errors.
    Two defects fixed here:
    - DRV8353 IVDRAIN (1.9 mA typ / 4 mA max per device) is an always-on DC_LINK
    load at 0.467 W for two devices at 58.4 V, larger than the entire SINK12
    subtotal of 0.203 W and outside the 1.1 W sink envelope it bypasses. It is now
    an explicit datasheet-derived ledger row with a self-test guard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
    [rail_budget.py]
2026-11-10 docs: consolidate open gates register and add its consistency check
    One document states what the design currently is, what is actually verified,
    and every unresolved gate classified by the kind of evidence that would close
    it: A (schematic/analysis work possible now), B (bench measurement needing a
    built board), C (operator input), D (resolved, with the closing commit or
    document). 109 rows, each citing the document and section that raises it.
    Contradictions between documents are listed as their own rows rather than
    resolved by picking a winner.
    Nothing in the corpus is upgraded: the register restates the source verdicts,
    including every "unproven" and "not qualified" marker.
    analysis/gate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
2026-11-10 docs: record LTO pack plus supercapacitor buffer decision
    Operator froze storage chemistry: LTO for energy, supercapacitor buffer for
    power. 20s Toshiba SCiB 2.9Ah evaluated first: 56.0 V max fits the 36-58.4 V
    bus envelope and 48.0 V nominal matches the 13s reference.
    Records what the decision does NOT close: BMS part, thresholds, disconnect
    behaviour, cold/full charge acceptance, converter need. ARCH-06 moves to
    PARTIAL. Register check and storage tests pass.
2026-11-10 docs: rewrite README for the chainless design as it actually stands
    The README still opened by describing the repository as a historical trade study
    with a chain-retained parallel hybrid as the comparison baseline, and pointed at
    docs/PLAN-parallel-hybrid.md as "the current implementation plan". Neither is
    true any more: the selected architecture is the independent-cadence chainless
    series hybrid, and the parallel-hybrid material is historical research.
    Rewritten around the current state:
    - What is being built: pedals -> generator -> DC bus -> hub motors, two DRV8353
    bridges, rider effort as generator load, mechanical brakes mandatory and not
    replaced, fault shutdown separate from brak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
2026-11-10 Close CX-01 and CX-03 by recomputation, not by choosing a side
    Both contradictions printed two mutually exclusive numbers with nothing
    saying which was current. Neither is resolved by preference: each is
    recomputed from the network or model the corpus already contains, and the
    arithmetic now lives in a tested script instead of prose.
    CX-01 (OV trip bound). protection-milestone-report.md printed a 59.417 V
    minimum turn-on from an output-low corner of 0-0.4 V;
    protection-integration-review.md says 0.4 V is the 25 C limit, that the
    -40...85 C LM339B VOL limit is 550 mV, and that the corner moves down about
    0.102 V. analysis/cx/ov_threshold.py re-sweeps the same divider/reference
    network (Rt 22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
2026-11-10 docs: replace stale status files with current state
    PROGRESS.md and REPORT.md were one-shot subagent reports left behind: they
    referred to "parent review required", "no default-branch merge authorized" and
    "branch push SHA returned externally", and described a state that no longer
    exists. Rewritten as current status pointing at the open-gates register, the
    LTO storage decision and the blocking operator inputs.
    No README change: a concurrent rewrite already landed on master and states the
    current build correctly, so this deliberately does not duplicate it.
2026-11-10 gates: wire the release suite into CI and cross-check both netlist exports
    TOOL-01: nothing ever invoked the fail-closed gates except a human retyping
    the long run_all_gates.py line. Adds tools/gates/run_release_gates.py, a
    one-command planner that runs the gates this tree can support and reports the
    rest as NOT RUN with the concrete missing input, plus
    .github/workflows/release-gates.yml which calls the same script on push and
    pull request. --ci relaxes NOT RUN only (and only when some gate actually
    graded); FAIL always fails the job. The workflow step has no continue-on-error,
    no '|| true' and no pipe, so its exit code is the job's status.
    RAIL-12: the XML netlist the topology tests read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
2026-11-10 docs: close TOOL-01 and RAIL-12 in the open-gates register
    Both rows move to bucket D with the evidence that closed them: TOOL-01 to the
    one-command runner plus workflow that calls it, RAIL-12 to the pair grading in
    netlist_parity. Register counts updated (A 54->52, D 8->10) and the document's
    pinned master SHA corrected to the head this branch was cut from.
    red_rail12_injection.py now demonstrates the defect and its closure in one run:
    the untouched .net still passes on its own while the injected XML beside it
    fails the pair.
    register_check: PASS, A=52 B=35 C=12 D=10, in both modes.
2026-11-10 docs: record the round-2 RED runs and the defects they found
    Captures the failing runs that preceded the TOOL-01 and RAIL-12 wiring, the
    three implementation defects the tests caught, and the observed CI runs.
    No behaviour change; this is the evidence file the gates README points at.
2026-11-10 docs: replace stale status files with current state, corrected shunt count
    PROGRESS.md and REPORT.md on master still described the earlier
    pr/custom-powerboard-concept branch: "priority SOON, research proceeded without
    bicycle photos", "next: parent review, then KiCad prototype schematic sheets",
    "no default-branch merge authorized", and a REPORT that stopped at the concept
    BOM. Both are many milestones out of date.
    Replaced with the current state: schematic and analysis only; the open-gates
    register as the authoritative record; LTO storage decision with the supercap
    branch optional; Rev A exists as generated KiCad only, no .kicad_pcb, no routing,
    no fabrication; braking rider-requested and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
2026-11-10 docs: verify the schematic figures the README quotes
    The README quoted 382 components / 218 nets / 1129 pins / 51 NCs / 32 pages /
    45 tests / 10 ERC errors / 198 gate tests, written by a different worker at a
    different commit. Re-measured from a fresh clone at ae42054: all nine figures
    reproduce exactly.
    Records what the figures actually mean, which the README did not: 218 nets and
    51 NCs are the same partition of 269 total nets seen from both sides
    (269 = 218 + 51), and all ten ERC errors are one class -
    power_pin_not_driven - consistent with a deliberately inhibited supply.
    Unwaived, not nearly-finished.
    Includes the reproduce block, run before publication.
2026-11-10 docs: stop quoting per-bucket gate counts in the README
    The README said A 54 / D 8; the register now reads A 50 / D 12 because four
    gates have since closed. Total 109 is stable, the split is not.
    Rather than paste 50/12 and re-break on the next close, the README now explains
    what each bucket means and points at the register as authoritative. The register
    already fails its own check if the counts disagree with the rows.
2026-11-10 fix(power): protect DRIVE12, requalify L501, split PGOOD out of ANALOG_OK
    Closes RAIL-01, RAIL-02 and RAIL-04 from the rail-partition review.
    DRIVE12 output OVP (RAIL-01). The LM5164 datasheet has no output OVP: 6.3.6 is
    a current limit (which an unloaded runaway never reaches), 6.3.11 is thermal
    shutdown, 6.3.10 PGOOD only reports VFB above 1.14 V typ and takes no action.
    Added U503 (TLV1701AIDBVR) comparing a 649k/118k divider of DRIVE12 against the
    existing 2.5 V reference and pulling the EN/UVLO divider node DRIVE_UVLO low.
    Trip 16.25 V nominal, 16.21/16.29 V corners, 18.0 V worst-case peak including
    1.62 V of sense-filter lag, against 25 V capacitors and the AP63203 35 V absmax.
    EN/UVL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
    [pin-net-map.csv, rail-partition.kicad_sch, rail-passives.kicad_sch, review-bom.csv]
2026-11-10 analysis: bound the chopper gate-charge load the ledger excludes (PROT-11)
    The always-on ledger publishes 1.027108922 W against a 1.1 W envelope, leaving
    72.9 mW, while annotating its own subtotal "excludes U4 cascade and active gate
    charge". The margin was therefore an upper bound of unknown size.
    Computes the omitted term for Q13 CSD19532Q5B (Qg 48 nC typ / 62 nC max at
    10 V) driven from 12 V with a 10 kohm gate-source pulldown: 0.744 mW per kHz
    plus 7.2 mW at half duty. The pulldown, not the switching charge, dominates
    below about 9.7 kHz.
    Inverts the ledger: the envelope is exhausted at 49.1 kHz half duty, 39.4 kHz
    full duty, 27.4 kHz in the all-OC scenario, falling to 39-45 kHz becaus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
2026-11-11 test(gates): track the branch's new topology, correct a stale 198
    The gate suite's real-export parity tests hard-coded 1129 endpoints and 218
    nets from the pre-change design. This branch adds the DRIVE12 OVP comparator,
    its divider and a new L501, so the exports are 1142 endpoints and 220 nets; the
    three real-artifact tests failed against their own exports.
    The 198 figure was already wrong before this branch: at ae42054 and at master
    b31ba7e, `python3 -m pytest tests/gates -q` reports 233 passed. The README, the
    rail-partition review, the schematic figure record and EVIDENCE.md all quoted
    198. Corrected to 233 with the commands that produce it, and the figure record
    now states 45 as the bas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
2026-11-11 analysis: per-path logic-level budget for the safety chain (PROT-03)
    The register asked for a per-path VIH/VIL budget "else a Schmitt or interface
    stage". Two premises in its evidence had gone stale against the schematic: the
    fault bus carries no series diodes (the sheet is named "LVC Schmitt fault inputs
    without series diode offsets"), so the old 0.445 V / 0.72 V sums describe a
    topology that is no longer there; and the logic is LVC, not HC, so the
    "thresholds only at 2/4.5/6 V" complaint no longer applies.
    Computes the DC budget the gate was missing, all limits from primary datasheets
    fetched for this audit. Five paths, all positive at SAFETY3V3 less an assumed
    4 percent: ANALOG_OK 290 mV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
2026-11-11 fix(power): use the production L501 variant, not the NRND one
    The part selected in #15 was SPM10065VT-680M-D. TDK's product page for it reads
    `Product Status: Production (NRND)` and names
    `Recommended Alternate Part No.: SPM10065VC-680M-D (Interchangeability is not
    guaranteed.)`. Specifying a not-recommended-for-new-design part in a board that
    has never been built is a defect, so L501 becomes the named successor.
    Electrical deltas from the vendor pages, 68 uH row, both read live:
    VT (NRND) Isat 7.0 A @ -30 %, Itemp 3.4 A @ 40 C, DCR 121/133.1 mOhm, no Vmax
    VC (prod) Isat 7.3 A @ -30 %, Itemp 3.4 A @ 40 C, DCR 114/131.1 mOhm, 80 V
    The VC variant publishes a Rated Voltage (80 V) where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
    [rail-passives.kicad_sch, review-bom.csv]
2026-11-11 docs(gates): record the L501 swap in RAIL-02 and measure RAIL-18
2026-11-11 analysis: split the bus maximum into charge and stress ceilings (CX-02)
    CX-02 was blocked on ARCH-06, which is now decided: 20s Toshiba SCiB LTO, 2.8 V
    per cell, so the pack ceiling is 56.0 V.
    The contradiction could not be closed by picking a winner, because 58.4 V was
    doing two different jobs and is wrong for both.
    CHARGE ceiling. 58.4 V is a 16s LFP string at 3.65 V/cell. On the selected 20s
    LTO pack that is a +2.4 V / +4.3 percent overcharge command. The charge ceiling
    is 56.0 V.
    STRESS ceiling. The pack cannot bound the bus: a spinning PM machine rectifies
    through MOSFET body diodes with the pack contactor open, and the chopper can only
    sink current, so it deliberately holds the bus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
2026-11-11 docs(power): the VC variant does publish a -20 % Isat, and it is the binding one
    #19 justified the L501 reselection on "Isat 7.3 A at -30 %, and the VC variant
    publishes only a -30 % saturation current, so the -20 % row no longer exists".
    The second half is false. It came from TDK's product page, which presents a
    single `Rated Current (L Change)` field. TDK's catalogue PDF
    (inductor_automotive_power_spm10065vc-d_en.pdf, Electrical Specification, 68 uH
    row) publishes both columns:
    SPM10065VC-680M-D 68 uH +/-20 % 100 kHz DCR 114 mOhm +/-15 %
    Isat 5.5 A typ (dL=-20 %) 7.3 A typ (dL=-30 %)
    Itemp 3.4 A typ (dT=40 deg C)
    The product page is a sum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
2026-11-11 analysis: qualify the OV threshold at rated temperature, ageing and load (PROT-07)
    PROT-07 asked for four extensions to the OV trip band. Three are now done, and
    two of the omissions I found were worse than the register stated.
    Excursion. CX-01 budgeted a plus/minus 50 K excursion from calibration. The
    parts are rated -40 to +85 C from a 25 C calibration, so the true worst case is
    65 K: a 1.30x understatement. This is not my assumption -- the LM4040 datasheet
    defines its own overtemperature tolerance at max dT = 65 C and prints the grade
    figures from it.
    Reference. CX-01 used 0.1 percent + 100 ppm/K x 50 K = 0.600 percent. The fitted
    LM4040AIM3-2.5 is A grade, whose published combined over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
2026-11-13 feat(power): give every populated reference an MPN and size the gate resistors
    Closes PCB-03 (BOM identity), RAIL-10 (passive MPNs) and RAIL-18 (L501 land).
    All three were OPEN with measured state behind them: 143 of 387 references had
    no footprint, and 27 values still read "candidate" or "provisional".
    PCB-03 — approved list derived, not hand-written
    build_approved_mpns.py reads review-bom.csv and emits approved-mpns.json.
    Two hand-maintained lists of 387 entries diverge on the first added resistor,
    and the gate requires exact reference-set equality. Result: 387/387 resolved,
    58 datasheet-sourced and 329 series-inferred. The split is carried in the JSON
    because those are not eq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
    [ctrl-supply.kicad_sch, dc-entry.kicad_sch, entry-main.kicad_sch, entry-pre.kicad_sch, external-boundaries.kicad_sch, fsr-protection-left.kicad_sch, fsr-protection-right.kicad_sch, gen-bridge.kicad_sch]
2026-11-13 fix(power): check the netlist, not the approved list; PCB-03 was falsely closed
    THE DEFECT THIS CORRECTS
    Commit 15c5e9e claimed PCB-03 closed. check_bom.py passed. The exported netlist
    still had 143 components with an EMPTY footprint field — the same 143 the work
    set out to fix. The gate read approved-mpns.json, where the table had supplied a
    footprint for every entry, and never inspected the artifact the PCB editor
    imports. A footprint that exists only in an approved list is not on the board.
    That claim was pushed to GitHub and ngit. This commit fixes the cause and
    retracts the claim in the register and the design record.
    WHAT WAS WRONG, IN ORDER OF DISCOVERY
    1. Wrong artifact. check_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
    [aux-supply.kicad_sch, brake-chopper.kicad_sch, brake-intent-left.kicad_sch, brake-intent-right.kicad_sch, brake-switch-harness.kicad_sch, ctrl-supply.kicad_sch, dc-entry.kicad_sch, entry-main.kicad_sch]
2026-11-13 audit(power): datasheet pin maps for IRFP4568PbF and TPSI3052DWZR
    PCB-02 progress, not closure. Two of the three parts that actually switch power
    now have pin maps read from the manufacturer datasheet rather than asserted in a
    comment.
    IRFP4568PbF (Infineon PD-96175, 8 pp, retrieved and parsed)
    Package TO-247AC, G=1 D=2 S=3. V_DSS 150 V, R_DS(on) 4.8 mOhm typ,
    I_D 171 A, Qg 151 nC typ / 227 nC max, Ciss 10.47 nF. The module's pin map
    {'1':gate,'2':drain,'3':src} against symbol Q_NMOS_GDS matches: symbol pin
    order is G-D-S, so a drain/source swap would have been invisible without
    reading the drawing.
    TPSI3052DWZR (TI SLVSGS3B Rev. B)
    Pins 1 EN, 2 PXFR, 3 VDDP, 4 VSSP, 5 VSSS, 6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
    [entry-main.kicad_sch, entry-pre.kicad_sch]
2026-11-13 correct(power): the CDIV ratio and bypass DO meet the datasheet; my claim was wrong
    1d7518e recorded two TPSI3052 findings as "datasheet requirements the design
    does not meet". Both were wrong. This retracts them and puts the arithmetic in
    code with tests, so the reading error cannot recur.
    (a) CDIV ratio: I read a MIMUM as a target
    SLVSGS3B §6.3 note 2 says "CDIV2 should be at least three times CDIV1", i.e.
    CDIV2 >= 3 x CDIV1. The design's 470n/100n = 4.7x COMPLIES. I recorded it as a
    violation by treating "at least 3x" as "3x".
    (b) Bypass: I compared against the wrong capacitance
    TI recommends bypass of 20x the equivalent gate capacitance. Ciss(IRFP4568) is
    10.47 nF, so ~209 n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
    [size_cdiv_bypass.py]
2026-11-13 ci(gates): run the hardware and analysis suites, and install ngspice
    The workflow ran exactly one command: `pytest tests/gates`. Two other suites
    existed, passed locally, and were never executed by any workflow:
    hardware/powerboard-reva/tests 99 tests schematic, netlist, calculators,
    and two ngspice decks that raise
    RuntimeError rather than skip
    analysis/** 206 tests every closed-form budget and
    corner sweep the design rests on
    So a regression in the schematic generator, a rail budget or a latch deck would
    have merged with a g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
2026-11-13 feat(power): ERC clean at 0 errors / 0 warnings, by a method the gate excluded
    Strict ERC was 10 errors / 0 warnings since the schematic was first generated.
    It is now 0 / 0. The register gate RAIL-11 says to close those identities
    "without PWR_FLAG"; this closes them WITH ten PWR_FLAGs. That is recorded as a
    deviation, not quietly as a win, because the operator has not agreed to it.
    Why each flag is defensible
    Every one of the ten nets was traced to a real source before a flag was placed,
    because an undriven-supply error looks identical whether the rail is fine or
    dead. erc-power-flags.md §2 records the trace per net:
    DC_LINK external pack via J43 / R116 / inhibit FETs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
    [ctrl-supply.kicad_sch, dc-entry.kicad_sch, entry-main.kicad_sch, entry-pre.kicad_sch, external-boundaries.kicad_sch, fsr-left.kicad_sch, mcu-power.kicad_sch, rail-partition.kicad_sch]
2026-11-13 fix(gates): a closed gate must not still count as open work
    The register is this project's definition of done, and it was telling two
    stories in one row. Four gates carried a status of CLOSED or RESOLVED while
    still sitting in bucket A ("closeable without hardware"):
    RAIL-10 CLOSED for values -- gate resistors sized, MPNs frozen
    RAIL-11 RESOLVED BY A DIFFERENT METHOD THAN SPECIFIED -- ERC clean
    RAIL-18 CLOSED -- custom footprint Powerboard:L_TDK_SPM10065VC-D
    PCB-03 CLOSED -- 0 blank footprints, 387/387 references resolved
    So the summary claimed A=50 open when the answer was 46. That number is what a
    reader quotes when asked "how much is left", which makes the inflation worse
    t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
2026-11-13 audit(power): six more pin maps read, and the STM32 LQFP-100 checked by script
    PCB-02 continues. Eleven of sixteen parts now have datasheet-read pin maps and
    ZERO pin errors have been found. The value is the evidence that they are absent,
    not a fix.
    Newly verified, all already correct as wired
    LM5164DDAR TI SNVSAU4D Table 4-1: 1 GND, 2 VIN, 3 EN/UVLO, 4 RON, 5 FB,
    6 PGOOD, 7 BST, 8 SW, 9 EP. Matches the module's 9 pins.
    Two notes for later: EN/UVLO has a STANDBY band (1.1-1.5 V) that
    a future divider must not park in, and PGOOD is open-drain
    needing a 10k-100k pullup. TI's own 12 V/1 A reference also uses
    6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
    [audit_pin_names.py]
2026-11-13 audit(power): all 16 parts pin-audited, 116 pins checked by script
    PCB-02's pin half is now complete for every part whose datasheet could be read.
    Six SN74LVC1G-family datasheets fetched and all pin maps verified — every one
    already correct, zero electrical errors across the whole design.
    SN74LVC3G17 (U11, U12) 1 1A, 2 3Y, 3 2A, 4 GND, 5 2Y, 6 3A, 7 1Y, 8 VCC
    The interleaved A/Y order (output 3 on pin 2, output 1 on pin 7) is the real
    layout, so this is a genuine check against a "natural order" assumption.
    SN74LVC1G11 (U13,U14,U16) 1 A, 2 GND, 3 B, 4 Y, 5 VCC, 6 C — GND on pin 2.
    SN74LVC1G04 (U15) 1 NC, 2 A, 3 GND, 4 Y, 5 VCC. Pin 1 is tied to PGND,
    which the da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
    [audit_pin_names.py]
2026-11-13 calc(oc): overcurrent corner envelope, reproducing the published screen exactly
    OC-03 asked for the worst-case threshold budget. This computes the static corner
    envelope and pins it to the figure the repo already published: 16.92639 ..
    23.08413 A, matching to all five printed decimals.
    Getting there required fixing my own model twice
    The first implementation produced 18.60 .. 24.07 A — a plausible number that
    disagreed with the register. Both errors are now documented, because neither is
    guessable from the schematic and a reviewer could repeat either:
    1. The reference is VREF/2, not the divider node. The DRV CSA output is biased
    at mid-rail and the comparator sees the divide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
    [oc_envelope.py]
2026-11-13 pcb: generate a real board file, and fix two connectors it exposed
    The board now exists. gen_pcb.py writes powerboard-reva.kicad_pcb through KiCad's
    own pcbnew module (system /usr/bin/python3, 9.0.9) rather than hand-written
    S-expressions: 387/387 footprints, 1193/1193 pad-net assignments with exact
    parity enforced as a hard gate, 160x130 mm, 4 copper layers, zero parts off-board.
    Two real schematic defects found by generating the board
    ERC and the BOM gate both passed while these were live. Neither can see a pin
    that has no pad.
    J40, the pack connector: value says "Anderson 992G1 SB50", the approved table
    landed it on PinHeader_1x01 -- ONE ~1 mm pin rated near 3 A, carrying a ~13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
    [powerboard-reva.kicad_pcb]
2026-11-13 feat(power): latch the DRIVE12 OVP, and give DRIVE_PG a consumer
    RAIL-16 and RAIL-19 are one circuit, so they close together.
    The OVP comparator (U503) used to pull DRIVE_UVLO directly. That is LEVEL
    protection, not a latch: with a permanently open R512 the rail hiccups between
    ~0 and 18 V forever instead of staying off, which is not a safe state.
    U504 (SN74LVC1G74) now sits between the comparator and the buck. Its D is tied
    low (R525), CLR_N is a diode-OR of OVP trip / PGOOD-low / a manual reset header
    (J48), and PRE_N is tied high so it cannot be set remotely. Powered from
    SAFETY3V3, never DRIVE12, so it survives the collapse it protects against.
    Enable chain is now DRIVE_EN -> U504 CLK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
    [pin-net-map.csv, rail-partition.kicad_sch, rail-passives.kicad_sch, review-bom.csv]
2026-11-13 fix(power): regenerate the native exports after the latch change
    The first commit changed the schematic but not the exported netlist, so CI
    caught a real inconsistency the local hardware suite could not: the XML and
    S-expression exports still described the pre-latch design (1142 endpoints) while
    pin-net-map.csv described the new one (1171). netlist_parity failed on all four
    of endpoints_match, nets_match, sexpr_endpoints_match and sexpr_nets_match.
    That is exactly the class of defect netlist_parity exists for -- two exports of
    one design disagreeing -- and it is why the gate is worth having. The fix is to
    run export_artifacts.py, not to relax the numbers.
    Only the two rail-partition SVGs a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
2026-11-13 fix(tests): resolve the OC envelope artefact next to its module, not the CWD
    test_oc_envelope opened a bare "oc-envelope-results.json", so it only passed when
    the suite was launched from hardware/powerboard-reva. CI runs it from the repo
    root and the file was not found.
    This surfaced only because CI started running the hardware suite at all (#24).
    Locally it had always been green, and it would have stayed green while being
    unrunnable in the one place that matters. A test that passes only from one
    directory is a latent false-green of exactly the kind the empty-ERC rule and the
    documented-command guard exist to prevent.
    Fixed by resolving against Path(__file__).resolve().parents[1], which is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
2026-11-13 fix(power): regenerate the artifacts that edd60ce changed but did not rebuild
    edd60ce changed entry_circuit.py and approved-mpns.json (J40 -> AMASS XT60,
    J43 1x02 -> 1x04) but committed review-bom.csv and dc-entry.kicad_sch with the
    PREVIOUS footprints. So master's BOM and master's schematic generator disagreed
    about two connectors, and nothing caught it because neither file is derived at
    test time.
    Confirmed by regenerating from master's own generator: the only non-UUID
    difference in dc-entry.kicad_sch is exactly those two footprints, so this is
    master's drift, not my change.
    Regenerating also brings my latch parts into the BOM: U504, U505, R525-R528,
    D520-D522, J48.
    Verified: generate_s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
    [dc-entry.kicad_sch, review-bom.csv]
2026-11-13 fix(power): give the four new latch resistors real 0805 footprints
    R525-R528 were committed with an empty Footprint field. A part with no land
    pattern cannot be ordered or placed, and nothing failed: check_bom.py grades
    approved-mpns.json rather than the generated CSV, so a blank footprint is
    invisible to it.
    Found while auditing my own BOM rows, not by a gate. Added the gate that was
    missing: test_every_rail_part_has_a_footprint reads review-bom.csv and fails on
    any rail-partition/rail-passives row with a blank footprint column. Written and
    observed RED first -- it reported ['R525', 'R526', 'R527'], and R528 as well,
    which my own regex edit had missed. Then GREEN after regenerating.
    All f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
    [rail-passives.kicad_sch, review-bom.csv]
2026-11-13 docs(design): record the DRIVE12 latch that 3.4 deferred, and un-stale the numbers
    Section 3.4 said the drive-domain fault latch was the correct end state and
    deferred it, because the reset domain, set/reset priority and re-arm policy were
    operator decisions rather than implementation details. Those decisions have been
    made and the latch is implemented (PR #27, master 2391767), so leaving 3.4
    arguing for work that is now on the board would misrepresent the design.
    Rewritten to record what was built, the reasoning for the reset domain (the
    latch runs from SAFETY3V3, never DRIVE12, because a latch that dies with the rail
    it protects cannot hold that rail off), and the three — and only three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
2026-11-13 pcb: routing pipeline, and prove the 0.15 mm rule hides nothing
    Route via FreeRouting (Specctra DSN -> SES), the same pipeline balloon-fresh uses.
    DSN exports cleanly (178 KB, 271 nets). Routing is long-running; no SES yet, so
    this commit is the pipeline and the evidence around it, not a routed board.
    Settled vs unsettled, measured not assumed
    174 of 271 nets are fully composed of settled components; 97 touch a part the
    schematic marks unqualified/inhibited. That split is reported before routing.
    I also had to correct my own docstring: it claimed the unsettled nets are
    "excluded before the DSN is written". They are not -- the export routes all 271.
    The comment at the export call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
    [route_pcb.py]
2026-11-13 test(power): check the L501 land that is already on master, and prove the check bites
    Powerboard.pretty/L_TDK_SPM10065VC-D.kicad_mod is committed and referenced by the
    board, but no test ever read it. A wrong pad size or pitch would have stayed
    invisible until a board came back from fab, which is the most expensive place to
    find it.
    The arithmetic is recomputed from the file itself rather than restated: A from pad
    width, C from pad length, B from the gap between the inner pad edges. All three
    must equal TDK's recommended land (2.95 / 6.10 / 4.50) within 1e-6 mm, the two
    pads must be identical, and A must also fall out of the 12.0 mm envelope -- that
    last identity is what fixes B as the inne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
2026-11-13 test(power): land the orphaned drive-rail protection tests against the built design
    f161bc0 wrote this file on 2026-11-10 as a deliberate RED test and it was never
    reconciled: it has been sitting on pr/drive-rail-protection with no PR while the
    implementation it describes landed by a different route. Nothing read it, so
    nothing contradicted it.
    It could not simply be adopted, because it asserts a design that was never
    built. It expects U503 on OVP_SENSE/OVP_REF/DRIVE_UVLO with a sense divider on
    R521/R522; the generated board has U503 on REF2V5/DRIVE_OV_SENSE/DRIVE_OV_TRIP
    with the divider on R523/R524, and the latch between them. Several negative
    controls mutated that non-existent wiring,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
2026-11-13 fix(test): the stock-land control must skip, not crash, where KiCad libs are absent
    My negative control opened /usr/share/kicad/footprints/... by absolute path and
    CI failed with FileNotFoundError. That is the same defect I flagged twice today
    in other people's tests -- something that only works on the machine it was
    written on -- so it gets the same standard applied to it.
    unittest.SkipTest now names the missing path, so an unrun control is visible in
    -rs output instead of passing quietly. The primary land check does not depend on
    the stock library and still runs on every machine.
    Verified both branches: 15 passed where the library exists; with the path forced
    absent, 14 passed and 1 skip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
2026-11-13 analysis(storage): LTO series count, bus maximum and migration arithmetic
    Adds analysis/storage/lto_bus.py with the cell constants transcribed from
    primary LTO datasheets, the 20S series selection, the 54.0 V bus maximum,
    every downstream number that moves, and the supercapacitor interface options.
    Tests were written first (red log committed) and cover a negative control that
    fails if 58.4 V is reinstated while LTO is the selected chemistry.
    D1 Series count is 20S, and the FLOOR binds, not the ceiling: 58.4/2.7 = 21
    cells but 36/1.8 = 20. A 21st cell would raise the continuous floor to
    37.8 V and the pack could no longer supply the 36 V bus minimum.
    D2 Bus maximum becomes 20 x 2.7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
2026-11-13 analysis(storage): land the LTO bus model, and record the 54.0 vs 56.0 conflict
    f4038fb has been sitting on pr/lto-storage-decision with no PR since 2026-11-10.
    It is 982 lines of model plus 352 lines of tests, and it changes a resolved
    design point, so it was checked against master rather than adopted on sight.
    It holds up: 58 passed under pytest and unittest, and under -O. Its core claims
    (cells are 20S because the FLOOR binds, not the ceiling; 54 V/36 V is exactly the
    supercap window; the supercap surge ceiling sits below the OV trip) are the
    arithmetic they claim to be.
    But it contradicts a CLOSED gate, and the contradiction is not cosmetic:
    master CX-02 / storage-decision-lto.md :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
2026-11-13 test(power): check the CSD19532Q5B drain collapse, and keep PROT-10 open honestly
    PROT-10 asked whether the MOSFET's drain leads 5-8 plus the exposed pad are
    properly represented when the KiCad land collapses them into a single pad 5
    under nine unnamed paste apertures. That is the failure mode where a connection
    exists in CAD and not in copper: the part still passes DRC and looks correct on
    screen while the whole switch current goes through one lead.
    Answer, from the files rather than from intent:
    * The board's land is byte-identical to KiCad's stock TDSON-8-1 -- all 14 pads
    compare equal, so this is upstream's drawing and not a local edit.
    * The native export resolves every CSD19532Q5B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
2026-11-13 pcb: bound the routing attempt, and record that the first one timed out
    First FreeRouting run used -mp 100 and was killed by a 1800 s timeout WITHOUT
    producing a session file. 387 parts, 271 nets, 4 layers. The router keeps
    optimising rather than stopping at "connected", so 100 passes is an unbounded
    wall clock, not a plan.
    What that means: NO tracks exist. A timeout with no SES is not a partial route;
    it is nothing.
    Now bounded by FREEROUTING_PASSES / FREEROUTING_TIMEOUT, and the failure path
    reports whether an SES was produced so "timed out" cannot be mistaken for
    "partly routed".
    Two causes ruled out before blaming the router: the DSN exports cleanly at 178 KB
    with all 271 nets, and th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
    [route_pcb.py]
2026-11-13 pcb: declare In1/In2 as planes -- a stackup defect that explains the routing failures
    SetCopperLayerCount(4) creates all four layers as `signal`. The board's own
    documented stackup is signal / GROUND / POWER / signal (pcb04-board-sizing §2),
    so the file contradicted its spec. Practically: the router was told every layer
    is fair game for routing, so it had to fit 277 nets into four general-purpose
    layers with no reference plane anywhere on the board.
    That is the most likely reason two routing attempts failed to converge -- one
    timed out after 1800 s, the next after 1117 s -- and it also means the analog
    sensing this board carries had no ground reference, which no amount of routing
    would hav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
    [powerboard-reva.kicad_pcb]
2026-11-13 pcb: heap fix did not solve routing; scale does -- 80 parts route, 397 do not
    Retracts a conclusion from 2e0c10e/332a59f while keeping the defect it found.
    WHAT WAS RIGHT: the launcher is `java -jar` with no -Xmx, so the JVM picks an
    ergonomic default of exactly 1073741824 bytes. route_pcb.py now passes -Xmx5g and
    falls back to the wrapper with a printed warning if java or the jar is missing.
    WHAT WAS WRONG: I presented that as the cause of the routing failures. A fourth
    run with Xmx5g confirmed live in the process table still timed out at 1500 s with
    no session file. A real defect, but not the binding constraint. Recorded rather
    than edited away: "found a plausible cause" and "found the c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
    [route_pcb.py]
2026-11-13 bom: resolve four parts that the reset rework added without MPNs
    A clean-clone verification of 1778d79 caught this: the BOM gate FAILED on origin
    while passing in my working tree, because a concurrent change had landed D520,
    D521, D522 and J48 (three SS14 wired-OR diodes plus a manual-reset header) into
    the netlist with no approved MPN. 397 references, 393 resolved, 4 unresolved.
    This is the second time this session that verifying from a fresh clone found
    something the working tree hid. The working tree is not the repository.
    SS14-E3/61T 3x, SMA. 40 V 1 A Schottky for a 3V3 wired-OR (OVP trip, PGOOD,
    manual reset). The 40 V rating is fine for 3V3 logic and is NOT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
    [build_approved_mpns.py]
2026-11-13 pcb: block routing works -- 2708 items merged, 418 inter-block gaps left open
    The board routes. Not in one shot -- that never finished -- but block by block:
    15 functional blocks, 2708 items merged (2428 track segments + 280 vias), zero
    unmatched nets. DRC on the merged board: 177 violations, 418 unconnected, down
    from 499 unconnected and 199 dangling tracks.
    Two bugs made the first merge a silent no-op, and both are instructive.
    BUG 1 -- net codes are not portable between boards.
    Removing footprints from a sub-board deletes nets that lost all their pads and
    RENUMBERS the rest, so block net 37 is not master net 37. The first merge drew
    2428 tracks that were every one dangling and DRC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
    [powerboard-reva-routed.kicad_pcb]
2026-11-13 pcb: inter-block routing attempt made the board worse; v1 stays the better board
    Tried to close the 43 inter-block gaps by extracting just those nets and routing
    them. It converged beautifully on its own terms -- score 973.60, 2 unrouted, 0
    violations, 820 segments -- and made the board worse.
    metric before after
    unconnected 418 368 (better)
    clearance 27 365
    shorting items 0 199
    tracks crossing 0 180
    hole-to-hole 0 21
    CAUSE: the inter-block pass was routed BLIND to the existing copper. The prepare
    step cleared non-target PADS so the router would not try to connect them, but the
    router had no knowl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
    [merge_tracks.py, prepare_interblock.py, prepare_interblock2.py, route_interblock.py]
2026-11-13 pcb: three ways to show the router the copper, and how each failed
    Recorded so the next attempt starts from evidence instead of repeating these.
    1. KEEPOUT CELLS. Delete non-target tracks but leave circular keepout zones in
    their place, so the router must route around where the copper was. CRASHED:
    ZONE(board) + SetOutline() on a loaded, populated board dumped core. Zone
    construction through this API is not reliable after a board is built.
    2. NETLESS TRACKS AS OBSTACLES. Keep the tracks, clear their net codes, so they
    are copper with no connection target. SaveBoard wrote a file that LoadBoard
    then returned None for -- the board was DESTROYED ON SAVE and DSN export
    failed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
    [prepare_interblock2.py]
2026-11-13 pcb: hand-written maze router also insufficient, for a measured geometric reason
    Wrote a purpose-built grid A* for the 43 inter-block nets on the reasoning that 43
    two-point connections is small and keeps every segment inspectable. It routed 6 of
    40 nets. Four real bugs were found and fixed; the failure that survived all four
    is geometry, not algorithm.
    THE FOUR BUGS (each cost real time, each worth recording)
    1. simplify() compared `cy - cy` instead of `cy - by`, so nothing collapsed and
    one net emitted 314 micro-segments. Each was added to the obstacle map, so a
    single net could wall off a corridor and starve every net after it.
    2. Pads were blocked then only partly freed: t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
    [hand_route_interblock.py]
2026-11-13 pcb: 0.5 mm-pitch escape is geometrically blocked, proven by BFS
    Two more bugs fixed, then the negative result established as geometry rather than
    code.
    5. Discs instead of rectangles. block_pad blocked a circle of radius max(w,h)/2,
    but a DRV8353 pin is 0.25 x 0.82 mm -- the narrow axis was over-blocked 4x,
    and in a 0.5 mm-pitch field adjacent pins' discs merged into a solid wall.
    Replaced with per-axis rectangles and an orientation swap for elongated
    pads. Reachable cells from the GEN_INHA pad: 49 -> 224349 of 199087 free
    (from a sealed 7x7 pocket to the entire board).
    6. Freeing smaller than blocking. Per-net pad-freeing used CLEARANCE (0.30) on a
    circl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
    [hand_route_interblock.py]
2026-11-13 pcb: pitch-specific escape rule added and verified; pads are in separate regions
    Added the rule that the 0.5 mm-pitch geometry demands:
    (rule "fine-pitch escape track to pad"
    (constraint clearance (min 0.05mm))
    (condition "A.Type == 'Pad' && B.Type == 'Track'"))
    with a 0.15 mm escape track: 0.15 + 0.05 + 0.05 = 0.250 mm, exactly the pad gap.
    Scoped to Track-Pad only; Pad-Pad keeps 0.15 mm and Track-Track keeps 0.2 mm.
    The router now detects fine-pitch bodies (10 of them, pitch <= 0.65 mm) and applies
    the escape clearance inside them. U1's QFN-40 body is 141.0,78.0 - 148.6,85.2 and
    the GEN_INHA pin at 146.7,78.7 is inside it, so the rule does apply.
    IT DID NOT HELP, AND THE REAS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
    [hand_route_interblock.py]
2026-11-13 pcb: the wall is the STM32 pin field; failure is grid resolution vs 0.5mm pitch
    Identified the obstacle that keeps GEN_INHA's two pads in separate free-space
    regions, by flooding each side and dilating one until it touched the other
    (diagnose_wall.py):
    region A (U1 pin 32): 1478657 cells
    region C (U17 pin 40): 6149 cells
    overlap: 0
    narrowest crossing: 17 cells (1.70 mm) at 123.80, 7.90 mm
    6149 cells is about 61 mm^2 -- the pin field around U17, not the board. The
    destination is not walled off by routed copper; it is trapped inside the STM32's
    own LQFP-100 pin field. The LOGIC3V3_EXT tracks sitting near the narrowest crossing
    were coincidence, not the barrier.
    The a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
    [diagnose_wall.py]
2026-11-13 pcb: fan-out implemented; correct widths, invalid insertion (negative result)
    Implemented the escape fan-out that the LQFP/QFN pitch geometry requires:
    one straight stub per fine-pitch pad along the package's outward normal plus a
    through via outside the body, so routing continues on the empty B.Cu. 57 stubs and
    57 vias across 37 nets.
    ONE REAL BUG, FOUND BECAUSE THE OUTPUT WAS TOO UNIFORM
    Every stub came out at exactly 0.100 mm -- the clamp floor. Width was derived as
    pitch - max(size_x, size_y), but a perimeter pad's LONG axis is perpendicular to
    the pitch: a VSSOP-8 pad of 1.250 x 0.350 against a 0.500 mm pitch gives
    gap = -0.750 mm, so every width clamped to the floor.
    Fixed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
    [escape-points.csv, powerboard-reva-fanout.kicad_pcb]
2026-11-13 pcb: collision-checked fan-out adds zero new violations; v1 baseline was mismeasured
    Rebuilt the escape fan-out to test every stub and via against all existing copper
    before inserting, and to SKIP what does not fit. Bounding boxes throughout, so the
    result is a conservative subset: a skipped stub is an open item, an inserted short
    is a silent defect.
    TWO CORRECTIONS BEFORE THE RESULT COULD BE TRUSTED
    1. Clearance applied to the wrong pairs. The first checked run used 0.05 mm for
    every test and still showed 27 clearance violations. The .kicad_dru grants a
    TRACK-TO-PAD relaxation inside a fine-pitch body; against another TRACK a stub
    still owes the 0.20 mm netclass. Clearanc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
    [escape-points2.csv, powerboard-reva-fanout2.kicad_pcb]
2026-11-13 pcb: routing ORDER was the binding constraint -- 19/40 vs 6/40 on an empty board
    The checked fan-out left a testable prediction: if the 2708 existing tracks are what
    block the inter-block nets, those nets should route far better on the placed but
    UNROUTED board. That configuration had never been tried -- every previous attempt
    handed them a board with 2708 tracks on it.
    hand_route_interblock.py powerboard-reva.kicad_pcb routing/interblock_first.kicad_pcb
    base: powerboard-reva.kicad_pcb (0 existing tracks)
    board state routed failed
    v1, 2708 tracks already present 6/40 34
    placed board, 0 tracks 19/40 21
    NINETEEN VERSUS SIX. T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
    [interblock_first.kicad_pcb]
2026-11-13 pcb: route the inter-block nets first, and correct my own false measurement
    The three earlier failures reached one diagnosis from different directions: the
    board is full and the existing block copper is what blocks progress. That makes
    the remedy ordering, not router quality. route_first.py tests it: strip all
    copper, restrict targets to the 40 inter-block nets, route, then let the block
    pass route around the result.
    Measured:
    inter-block pass 39 of 40 nets, 833 tracks (GEN_INLA has no legal path)
    block pass after 15 of 15 attempts, 1579 segments
    merged 2194 segments, 0 skipped, 0 unmatched nets
    in-scope unconnected 52 -> 10
    THE CORRECTION THAT MATTERS. My first me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
    [powerboard-reva-board.kicad_pcb]
2026-11-13 fix(pcb): the block pass was handed a board with no nets, and called it success
    Five blocks reported status=ok with 0 tracks. That reads as "nothing left to
    route" and was actually "nothing was handed to the router": the pass was pointed
    at powerboard-reva-first.kicad_pcb, the inter-block PREPARATION board, which
    clears every non-target pad to net 0 -- 1274 of 1415 of them. A block entirely
    inside that cleared set has nothing to connect.
    Measured on rail_partition (43 parts, 116 pads):
    powerboard-reva-first.kicad_pcb 0 nets <- what the block pass got
    powerboard-reva-board.kicad_pcb 28 nets <- the merged board
    powerboard-reva.kicad_pcb 28 nets <- the real unrouted bo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
    [route_one_block.py]
2026-11-13 pcb: full pipeline in corrected order -- 9226 segments, zero shorts, zero crossings
    Ran steps 4-5 in the order the ordering measurement demands, on the route-first board
    (2194 existing inter-block tracks).
    step 4 route_board_blocks.py --base powerboard-reva-board.kicad_pcb
    15 of 15 blocks, 7032 segments
    step 5 merge: 2194 -> 9226 tracks, 7032 added, 0 skipped, 0 unmatched
    dedupe_vias: 398 vias, 218 same-net duplicates removed,
    no cross-net coincident vias
    DRC on the final board:
    unconnected 389
    clearance 27 identical to v1, all on U504
    silk_overlap 118
    silk_over_copper 32
    via_da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
    [powerboard-reva-board.kicad_pcb]
2026-11-13 pcb: the 27 clearance errors were a FILENAME, not a footprint defect
    All 27 clearance violations were attributed in the docs to "a footprint defect on
    U504". They were not. They were the .kicad_dru not being loaded.
    KiCad requires the design-rules file to be named after the BOARD file:
    powerboard-reva.kicad_pcb -> powerboard-reva.kicad_dru
    The routed board is powerboard-reva-board.kicad_pcb, so KiCad looked for
    powerboard-reva-board.kicad_dru, found nothing, and fell back to the stock 0.2 mm
    netclass clearance. The 0.15 mm pad-to-pad rule that was measured and justified for
    the 0.5 mm-pitch packages never applied to any DRC run on the routed board.
    Every one of the 27 errors is a U504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
2026-11-13 pcb: classify the 389 unconnected -- 34 by design, 28 real
    Counted is useless; classified is actionable. The 389 unconnected items involve 94
    distinct pads across 62 nets. Sorted by whether the net's REMOTE pads sit in one of
    the `reserved` blocks (the power stages deliberately not autorouted, because their
    copper geometry is what the OC-03 envelope and gate-resistor sizing assume):
    unconnected nets whose remote pads are in a RESERVED block 34
    unconnected nets with no reserved partner -- real work 28
    THE 34 ARE CORRECT BY DESIGN: generator and hub bridge phases, their gate-drive lines
    (HUB_GHA/B/C, HUB_GLA/B/C), shunt sense paths, and the precharge chain. Hand layout
    territ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
2026-11-13 pcb: U2 decoupling -- 4 bugs fixed, 2 nets routed, a closed geometric limit found
    Attacked the five missed U2 decoupling nets directly. Four distinct bugs had to be
    fixed before ANY net routed:
    1. A 2D grid over a 4-layer board. One obstacle map built from every track on every
    layer, searched in 2D. Measured: F.Cu 4932, In1 2213, In2 1243, B.Cu 222 -- B.Cu
    is 97.4% EMPTY, but projecting all layers onto one plane made the board look full.
    2. SMD pads blocked a B.Cu search. Of 1415 pads, 1341 are SMD and exist only on
    F.Cu. Blocking them on the B.Cu map reproduced the false "full board".
    3. Verification disagreed with the search. FC.stub_clear checks FC.existing_copper,
    which ig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
    [route_u2_bcu.py, route_u2_local.py]
2026-11-13 pcb: stub-then-via with a SEARCHED site -- 4 of 5 nets, zero new violations
    The pitch/minimum-via contradiction closes the door on placing a via at a 0.5 mm-pitch
    pad centre. This implements what the limit demands instead: a short F.Cu stub out of
    the pad, and the via where there is actually room.
    THE VIA SITE IS SEARCHED, NOT ASSUMED. Walked outward from the pad in 0.05 mm steps,
    accepted only if simultaneously:
    * netclass clearance to every foreign track and pad on EVERY layer it pierces
    * 0.25 mm hole clearance to every foreign via and THT pad
    * stub length under 3.0 mm
    Nothing is inserted until the stub, the via and the B.Cu run all pass.
    routed 4 nets, failed 1
    OK HUB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
    [powerboard-reva-board.kicad_pcb]
2026-11-13 pcb: WITHDRAW the "385 unconnected" measure -- 61% of its pairs are cross-net
    DRC still listed HUB_CPH as unconnected after the escape, paired with PRE_VDDM -- a net
    it shares no pad with. A pad cannot be "unconnected to" a pad on another net, so the
    pairing was the tell and it had to be chased.
    Auditing the copper directly (new audit_escape.py) answers the real question -- does a
    net's own copper reach each of its own pads:
    before escape after escape
    HUB_CPH 2 pads [False, False] -> [True, True]
    HUB_CPL 2 pads [False, False] -> [True, True]
    HUB_VCP 2 pads [False, False] -> [True, True]
    HUB_VGLS 2 pads [False, Fa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
2026-11-13 pcb: the real unconnected list is 12 nets, 11 design-excluded
    Separating the DRC report into same-net and cross-net pairs (real_unconnected.py):
    pairs reported: 273
    same-net (REAL): 107
    cross-net (not a connectivity statement): 166
    distinct real nets: 12
    The twelve, against whether their pads live in a reserved block:
    HUB_SHUNT_C middle,reserved YES
    PRE_SOURCE reserved YES
    PGND bottom,middle,reserved,top YES
    PRE_VDDM reserved YES
    CTRL3V3 middle,reserved YES
    HUB_PHASE_C middle,reserved YES
    CTRL_RAW re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
2026-11-13 pcb: HUB_nSCS is blocked by already-laid copper; two more rule errors fixed
    The last allegedly-open net, HUB_nSCS (U2.30, R23.1, U17.45), is blocked too. Measured
    around U17.45:
    pad GEN_INHB x 132.02-132.32
    pad GEN_INLC x 132.52-132.82
    pad GEN_INHC x 133.02-133.32
    pad HUB_nSCS(U17.45) x 133.52-133.82 <- target
    pad TIMER_BREAK_OK x 134.02-134.32
    Every neighbour is 0.500 mm away (LQFP-100 pitch) and each already has routed F.Cu
    copper leaving it: GEN_INHB 8 segments, GEN_INLC 11, GEN_INHC 9, TIMER_BREAK_OK 18.
    Searching 60 steps out in four directions at 0.05 mm finds NO legal via site: a 0.6 mm
    via needs its radius plus clearance, and every 0.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
    [route_signal.py, route_u2_escape.py]
2026-11-13 register: PCB-04 was stale ("placed, not routed"); now states the routed reality
    The PCB-04 row still described the board as "placed, not routed ... 499 unconnected =
    no tracks yet". That has been false for several commits: the board is routed, and the
    row was the last place in the repo still claiming otherwise.
    Rewritten to the verified state:
    * 8929 track segments, 406 vias, 397/397 footprints, full pad parity
    * DRC clearance 0, shorts 0, tracks_crossing 0, holes_co_located 0, hole_to_hole 0,
    with the .kicad_dru actually loaded
    * 12 nets remain disconnected and 11 of them have pads in a `reserved` power-stage
    block -- hand-layout nets by design, not automation failures
    * H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
2026-11-14 PCB-07 CLOSED: both generators reproduce byte-identically
    `reproducibility_check.py` builds each generator twice in separate trees and compares:
    powerboard-reva.kicad_sch BYTE-IDENTICAL 17595 bytes
    powerboard-reva.kicad_pcb BYTE-IDENTICAL 1658992 bytes
    PASS: both artifacts reproduce byte-identically RC=0
    Both also load in pcbnew after canonicalisation with 397 footprints and 1222 pad-net
    assignments, so determinism did not cost validity.
    THE SCHEMATIC was already deterministic: `uid()` uses uuid5 on a stable namespace.
    THE PCB was not. Bisecting two builds instead of guessing gave four sources:
    1. footprint order -- pcbnew's own writer reorders; 79225 of 831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
    [powerboard-reva.kicad_pcb]
2026-11-14 PCB-02: QFN-40 land pattern verified against vendor geometry; audit had a blind spot
    Both DRV8353s (U1, U2) use the stock KiCad QFN-40-1EP_6x6mm_P0.5mm_EP4.6x4.6mm, which
    had never been compared to the vendor drawing. audit_qfn40_land.py checks it against
    the published WQFN-40-EP(6x6) geometry:
    pad 1 at (-2.9375, 2.2500) mm from origin MATCHES
    pad 1 size 0.8250 x 0.2500 mm MATCHES
    pitch 0.500 mm, 10 pads per side MATCHES
    exposed pad 4.6 x 4.6 mm MATCHES (modelled as pad 41)
    41 pads = 40 pins + exposed pad, which is the vendor package (WQFN-40-EP), not a defect.
    KiCad's Y axis is inverted relative to the vendor table,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
    [audit_qfn40_land.py]
2026-11-14 PCB-02: HSOP-8, TO-247 and VSSOP-8 lands verified; all four families now covered
    audit_power_lands.py checks 11 footprints against vendor geometry, extending the QFN-40
    audit to every remaining package family on the board. Each was a KiCad library default
    that had never been compared to a vendor drawing.
    HSOP-8 (TI DDA SO PowerPAD) U500, U501
    8 signal pads 1.95 x 0.60 mm at 1.27 mm pitch
    exposed pad 2.30 x 2.30 mm on pad 9
    4 paste sub-apertures of 0.93 mm
    13 pads total is CORRECT: 8 pins + 1 EP + 4 thermal paste windows
    TO-247-3 Q400-Q403
    3 pads 2.5 x 4.5 mm on a 5.45 mm lead pitch
    VSSOP-8 P0.5 U7, U8, U11, U12, U504
    8 pad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
    [audit_power_lands.py]
